mekiciepcas/ESC-Ai/inceleme/media/image2.png

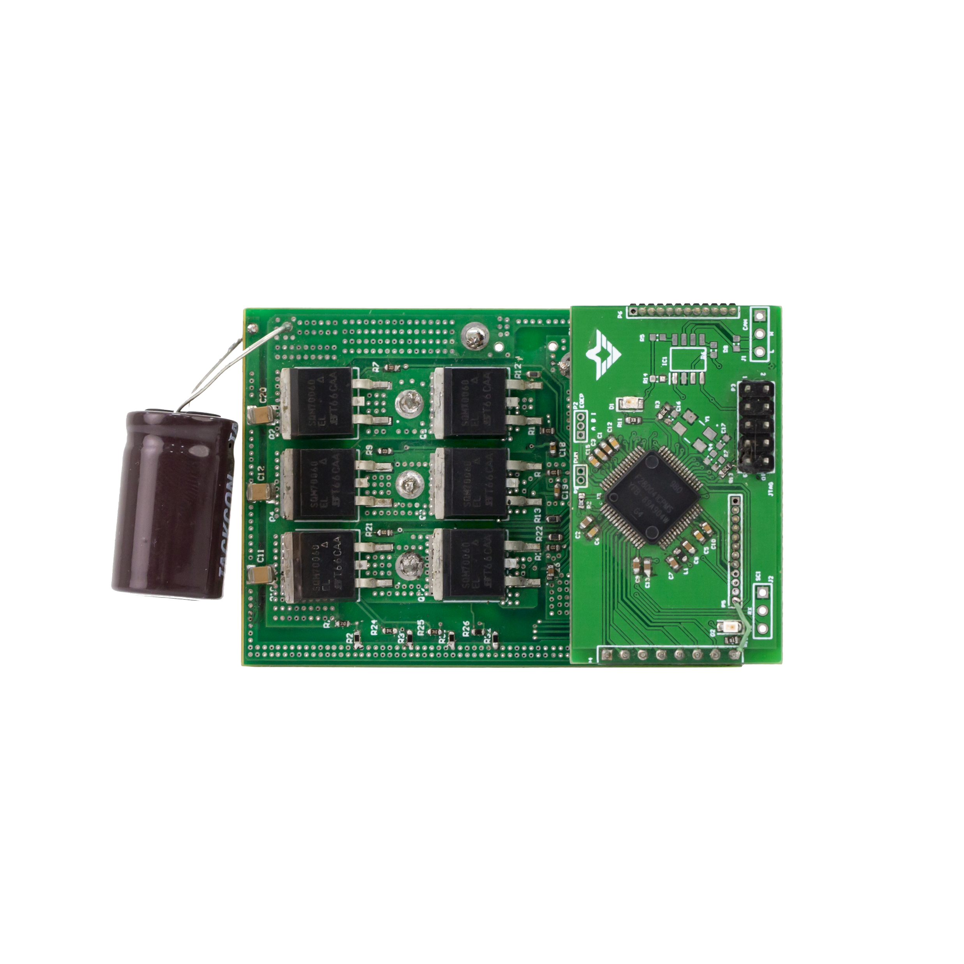
inceleme/media/image2.png
