mekiciepcas/ESC-Ai/inceleme/media/image3.png

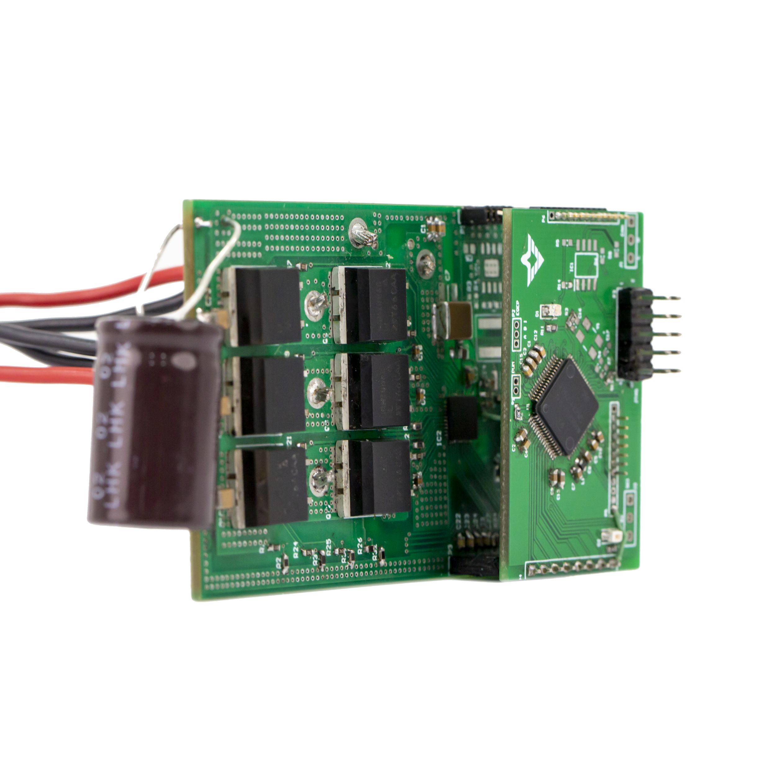
inceleme/media/image3.png
