mekiciepcas/ESC-Ai/ESC_V2/pcb_b1/control/README.md

# Kontrol PCB — kısmi PoC yönlendirmesi

100 × 80 mm, 4 katman; 38 elektriksel bileşen, 192 pad. 22 iz segmenti, 120 açık bağlantı, mevcut kurallarla DRC 0 ihlal. C1801–C1804 dijital bypass çiftleri MCU pinlerine bağlı. VBAT, analog besleme ve ortak güç/GND dağıtımı tamamlanmadı. Üretim veya enerji verme onayı değildir.

Kaynak: ESC_3kW_CONTROL_B1_PLACEMENT.kicad_pcb. Kanıt: supply_routes_20260915.json ve drc_placement.json. Değişiklik öncesi snapshot korunur. route/refine betikleri tarihsel tek seferlik değişikliklerdir; mevcut PCB üzerine yeniden uygulanmaz. Aday kılıflar placement_report.json içinde açıkça işaretlidir.
