mekiciepcas/ESC-Ai/ESC_V2/planning/AUTONOMOUS_HANDOFF.md

# ESC autonomous handoff

Date: 2026-09-21 19:23+03:00  
Branch: `uav-rebaseline`  
Run-start HEAD: `80ab0b874f15defab96d15028aef4c9873473758`  
TR-105 traceability commit: `4975e4d549dd8fd15743f60455499fd0e71f0547`  
AUTO-STATE-99 commit: `6fc20e9e351b12a80c0fb0fed7f9c94713b5cbe0`  
Run status: `TR105_POST_TR104_CI_RUNTIME_EVIDENCE_RETAINED_NO_GATE_ADVANCE`

## Repository continuity verification
Mandatory authorities were read from the actual branch: `UAV_PRODUCT_PLAN.md`, `UAV_TRACEABILITY.md`, `uav_backlog.json`, `mission_requirements.json`, `REQUIREMENTS_MASTER.json`, `REQUIREMENTS_PROGRESS.json`, prior handoff and autonomy state. Run-start HEAD was dashboard bot commit `80ab0b874f15defab96d15028aef4c9873473758`, whose parent was the previous autonomous reconciliation commit. S1R.2 blockers and controlled counters were re-verified before acting.

## Controlling metrics
Requirements structure **12/12 = 100%**; G1 SYSTEM FREEZE/value closure **15/48 = 31.3%**; backlog DONE **1/25 = 4.0%**; major gates **0/8 = 0%**. No counter advanced.

## Tasks attempted / completed
Verified mandatory planning state; confirmed S1R.2 remains blocked by controlled installed-axis/structural mass plus degraded-mode evidence; inspected the pending post-TR-104 CI evidence; verified GitHub Actions check `fail-closed-regression` id `106394597582` on TR-104 code commit `ba5dbad0b71a5669453cd548d5cf304659db66a4` completed `success` in workflow run `35618291811` at 2026-09-21 15:20 UTC; recorded that bounded runtime evidence as TR-105; advanced autonomy state to AUTO-STATE-99. No engineering value, physical claim, safety decision, G1 row, backlog state, architecture selection or release state was promoted.

## Files changed
`ESC_V2/planning/UAV_TRACEABILITY.md`, `ESC_V2/planning/autonomy_state.json`, and this handoff. No A2/B1 electrical source, KiCad schematic, PCB, Gerber, manufacturing or release package was modified. `U1-SCH-R001` remains unallocated.

## Engineering decision / calculations / evidence added
TR-105 closes only the pending runtime-evidence item from TR-104: the hardened blank-template fail-closed regression guard demonstrably executed successfully in GitHub Actions. No product calculation, requirement value or architecture decision changed.

## Assumptions and evidence level
No engineering assumption introduced. Evidence level: **REPOSITORY CI RUNTIME EVIDENCE ONLY; NO PHYSICAL MEASUREMENT; NO SAFETY DECISION; NO GATE ADVANCE**.

## Unresolved blockers
Controlled installed-axis mass; controlled Quad/Hexa structural delta; explicit degraded-mode/single-axis-loss decision; exact installed pack overhead mass/geometry; condition-matched P50B OCV/Rdc; installed pack current-path resistance; usable-energy/cutoff; traction-pack auxiliary hardware/demand/conversion efficiencies/simultaneity; exact gate-drive configuration; exact motor/prop/winding; phase-current/eRPM/PWM/loss/transient proof; G1/G2.

## Regression / risk discovered
No new engineering regression discovered. The branch remains subject to dashboard-refresh bot interposition after planning writes; final HEAD must therefore be re-read before run close. TR-105 must not be interpreted as populated-evidence validation or physical qualification.

## Exact next tasks
1. Populate TR-084 only from controlled installed-axis and configuration-controlled Quad/Hexa structure weighing, then run TR-085.
2. Populate TR-092 only from an explicit controlled user/system-safety decision or approved requirement, then run TR-093.
3. Populate TR-088/TR-089, TR-081/TR-082 and TR-079/TR-080 only from required real evidence.
4. If those inputs remain unavailable, audit independent S1R.3B verification/evidence contracts for a concrete fail-open, provenance or schema-drift defect; no filler edits.

Dependency chain: `PB-08 -> TR-084/TR-085 physical mass + TR-091..TR-093 controlled degraded-mode decision -> Quad/Hexa/MTOW -> exact propulsion + pack -> total simultaneous pack current -> phase current/eRPM/PWM -> gate-drive/power-stage requalification -> G1 -> G2 -> U1-SCH-R001`.

## Next-run briefing
Start from AUTO-STATE-99 and re-read actual branch HEAD because dashboard automation may advance it. TR-105 records successful post-TR-104 fail-closed runtime evidence only. Do not populate TR-084/TR-092 from guesses. Keep 83.33 A propulsion-only, P50B 12S4P reference-only, A2/B1 electrical sources immutable, and all physical qualification claims false. Snapshot: **Requirements 100% / G1 31.3% / backlog DONE 4.0% / major gates 0% / component-bearing U1 0%**.
