mekiciepcas/ESC-Ai/ESC_V2/planning/UAV_TRACEABILITY.md

# UAV ESC tasarım izlenebilirlik matrisi

Tarih: 21.09.2026

> TR-001..TR-046 canonical content is preserved byte-for-byte in commit history through blob `558a79e824d957844766031e357996bc8e0cee01`. TR-047..TR-070 remain preserved in canonical blob `2456bb4b0915ffd5104f99a594e94f594a4bb4a4`; TR-071..TR-090 remain preserved in canonical blob `fae32f3ba0832c550ce9469e41703dc15e68a6ea`; TR-091..TR-103 remain preserved in canonical blob `f3841aaa5de84b9d82ef5d6629993cffa5c44658`. This compact continuation does not supersede or delete that engineering history.

## Additive continuation

| ID | Fonksiyon / karar | UAV rebaseline kararı | Sonraki kanıt |
|---|---|---|---|
| TR-104 | PB-08 rejection-error payload integrity closure | **REPOSITORY VERIFICATION OUTPUT-INTEGRITY REPAIR / NO GATE ADVANCE.** The TR-100 harness required a non-empty JSON `errors` list but did not require its members to contain usable diagnostic text; `[null]` or `[""]` could therefore satisfy the structural check. The harness now requires every rejection error to be a non-empty string after whitespace trimming. This strengthens fail-closed diagnostic evidence only and does not validate populated evidence, physical hardware, safety acceptance, G1 closure or release readiness. | `test_pb08_fail_closed_templates.py`; retain a subsequent successful `PB-08 Fail-Closed Regression Guard` Actions execution as bounded runtime evidence. |
| TR-105 | Post-TR-104 fail-closed runtime evidence | **REPOSITORY CI RUNTIME EVIDENCE / NO GATE ADVANCE.** GitHub Actions check `fail-closed-regression` on TR-104 code commit `ba5dbad0b71a5669453cd548d5cf304659db66a4` completed successfully on 2026-09-21 15:20 UTC (check id `106394597582`, workflow run `35618291811`). This closes only the pending runtime-evidence item for TR-104. It does not validate populated PB-08 evidence, physical hardware, degraded-mode safety, G1 closure, flight qualification or production readiness. | Preserve the successful check-run reference; continue with controlled TR-084 physical mass and TR-092 degraded-mode evidence when available, otherwise audit independent verification contracts only for concrete defects. |

## Canonical PB-08 current state

PB-08 remains active authority. Requirements structure is 12/12 = 100%; G1 value closure remains 15/48 = 31.3%; backlog DONE remains 1/25 = 4.0%; major gates remain 0/8. S1R.2 remains blocked by controlled custom-axis/structural mass and degraded-mode evidence. `P_aux,pack`, total continuous/peak traction-pack current, exact pack, exact motor/prop, phase current and PWM remain OPEN. The 83.33 A value remains propulsion-only continuous pack-current lower bound. P50B 12S4P remains reference-only. B1 remains a requalification candidate only; A2/B1 electrical source is immutable. No component-bearing U1 schematic is allocated and `U1-SCH-R001` remains unused.

## History-preservation note

Historical PB-01..PB-07 calculations and TR-001..TR-103 are not deleted or reinterpreted by this compact continuation. The canonical blobs above remain continuity anchors; commit history remains authoritative for earlier rows.
