mekiciepcas/ESC-Ai/ESC_V2/planning/RUN_2026-09-21_0922_TRACEABILITY.md

# Autonomous run trace — 2026-09-21 09:22+03:00

Run-start HEAD: `58a0e367f8fdd500e0f1c428946a825cb248bae9`.

## TR-094 — Canonical traceability synchronization after TR-093
**REPOSITORY CONSISTENCY REPAIR / NO GATE ADVANCE.** Verified the mandatory PB-08 planning authorities and prior handoff against the actual branch. Canonical `UAV_TRACEABILITY.md` ended at TR-090 while the controlled 08:23 run trace and AUTO-STATE-87 contained TR-091..TR-093. Folded TR-091..TR-093 into canonical continuity and anchored the prior TR-071..TR-090 canonical blob `fae32f3ba0832c550ce9469e41703dc15e68a6ea` so history remains recoverable and authoritative.

## Impact
No product value, safety decision, physical result, G1 row, gate, backlog state, A2/B1 electrical source, KiCad/PCB/Gerber/release artifact or U1 allocation changed. S1R.2 remains blocked by real installed-axis/structure mass evidence and an explicit controlled degraded-mode/system-safety decision. Requirements structure remains 12/12 = 100%; G1 value closure 15/48 = 31.3%; backlog DONE 1/25 = 4.0%; major gates 0/8.
