mekiciepcas/ESC-Ai/ESC_V2/planning/RUN_2026-09-21_0721_TRACEABILITY.md

# Autonomous run trace — 2026-09-21 07:21 +03:00

Branch: `uav-rebaseline`
Run-start HEAD: `b407cc177ba5d1f5e5d0e7437f08b38b8eb908ca`

## TR-090 — canonical traceability synchronization after TR-089

Repository continuity audit confirmed the prior handoff and AUTO-STATE-85 contain TR-088/TR-089, while canonical `UAV_TRACEABILITY.md` stopped at TR-087. This run restores those two already-controlled records into the canonical matrix and records the repair as TR-090.

No engineering value, requirement status, physical-test result, backlog task, G1 row, rotor decision, pack-current value, or qualification state is changed by this repair. The 83.33 A value remains propulsion-only lower-bound arithmetic. S1R.2 remains blocked by controlled installed-axis/structural mass and degraded-mode evidence.

Controlled metrics remain: requirements structure 12/12 = 100%; G1 value closure 15/48 = 31.3%; backlog DONE 1/25 = 4.0%; major gates 0/8 = 0%.

No A2/B1 electrical source, KiCad schematic, PCB, Gerber, manufacturing/release package or main branch was modified. `U1-SCH-R001` remains unallocated.
