mekiciepcas/ESC-Ai/ESC_V2/planning/RUN_2026-09-21_0619_TRACEABILITY.md

# Autonomous run trace — 2026-09-21 06:19+03:00

Branch: `uav-rebaseline`  
Run-start HEAD: `eda6b332b74ca198f03d65357291312558fec6f3`

## TR-088 — PB-08 traction-pack auxiliary-demand result schema
**VERIFICATION ARTIFACT / NO PACK-CURRENT FREEZE.** Added `PB08_TRACTION_PACK_AUXILIARY_DEMAND_RESULT.template.json` to convert the TR-087 closure contract into a machine-readable evidence record. It requires configuration identity, exact load hardware/configuration, traction-pack applicability, load-side demand, conversion path, path efficiency, simultaneity/duty, condition basis, evidence reference and reported pack-referred arithmetic. All evidence/result fields remain null or false until controlled data exists. The frozen 3000 W propulsion term is retained only as the existing propulsion-only lower-bound parent.

Next evidence: populate a copy only from controlled exact U1/vehicle load evidence. Unknown demand/efficiency/simultaneity remains OPEN/null; source current capability is not load demand.

## TR-089 — PB-08 auxiliary-demand fail-closed verifier
**FAIL-CLOSED VERIFICATION TOOL / NO PHYSICAL RESULT / NO G1 ADVANCE.** Added `verify_pb08_auxiliary_demand.py`. The checker rejects missing configuration identity, incomplete load enumeration, missing exact hardware/evidence/path data, OPEN/invalid efficiency or simultaneity/duty, missing load-side demand, inconsistent per-row pack power/current, incomplete review attestations, unknown loads assigned zero, inconsistent totals, or any attempt to set pack-current freeze/physical qualification/G1 advancement true. It independently recomputes each accepted load as `P_pack=(P_load/eta)*simultaneity*duty`, `I_pack=P_pack/V_loaded`, and recomputes auxiliary and propulsion+auxiliary totals.

The unpopulated template is expected to FAIL. A PASS means record completeness/arithmetic only; it cannot prove physical demand, freeze total pack current, or advance G1.

## Gate/counter disposition
No controlled counter advanced. S1R.2 remains blocked by controlled installed-axis/structure mass and degraded-mode evidence. Requirements structure remains 12/12 = 100%; G1 value closure 15/48 = 31.3%; backlog DONE 1/25 = 4.0%; major gates 0/8.
