mekiciepcas/ESC-Ai/ESC_V2/planning/RUN_2026-09-21_0223_TRACEABILITY.md

# RUN 2026-09-21 02:23+03:00 TRACEABILITY

## TR-083 — canonical traceability continuity repair after TR-082

Run-start branch tree: `155ddbf3b70ed24ea4e689d30262a0ca6c5240ae`.

Repository continuity audit found a real documentation inconsistency: `RUN_2026-09-21_0021_TRACEABILITY.md` and `RUN_2026-09-21_0122_TRACEABILITY.md` plus AUTO-STATE-80 documented TR-081 and TR-082, but canonical `UAV_TRACEABILITY.md` stopped at TR-080.

Action: restored TR-081 and TR-082 into canonical additive traceability and added this repair as TR-083. The restored rows preserve their original evidence semantics: TR-081 is an empty physical-evidence schema and TR-082 is fail-closed verification software. Neither is a physical measurement, pack qualification, 36 V loaded-floor proof, flight qualification or product-value freeze.

No G0/G1 row, backlog task or major gate closes from this consistency repair. Controlled counters remain requirements structure 12/12 = 100%; G1 value closure 15/48 = 31.3%; backlog DONE 1/25 = 4.0%; major gates 0/8 = 0%.

S1R.2 remains the highest-priority task and remains blocked by controlled custom-axis/structural mass plus degraded-mode evidence. No engineering value was inferred to bypass that blocker. No A2/B1 electrical source, KiCad schematic, PCB, Gerber, manufacturing or release artifact was modified.
