mekiciepcas/ESC-Ai/ESC_V2/planning/RUN_2026-09-21_0122_TRACEABILITY.md

# RUN 2026-09-21 01:22+03:00 TRACEABILITY

## TR-082 — PB-08 P50B OCV/Rdc evidence verifier

Task: independent S1R.3B evidence hardening while S1R.2 remains blocked.

Artifact added: `verify_pb08_p50b_ocv_rdc.py`.

The verifier is fail-closed. It requires exact cell/sample/lot/SOH identity, instrumentation and calibration references, raw-data reference, SOC preparation/rest/temperature stabilization and pulse timing, reviewer attestations, condition-matched per-point SOC/temperature/SOH/OCV/current/pulse-voltage/Rdc, repeats and uncertainty evidence. It independently recomputes `Rdc = (Vpre - Vpulse)/Ipulse` and rejects inconsistent arithmetic. It does not interpolate missing data and emits `physical_qualification=false` and `pack_loaded_floor_compliance=null`.

No physical measurement, cell-envelope point, pack qualification, flight qualification, G1 closure, component selection or production release is claimed. The empty TR-081 template is expected to fail until controlled evidence is populated.

Repository run-start HEAD verified: `ff77ded82429d8bf70464e4f6d4fae7b303ef62d`.

Controlled counters remain: requirements structure 12/12 = 100%; G1 value closure 15/48 = 31.3%; backlog DONE 1/25 = 4.0%; major gates 0/8 = 0%.
