mekiciepcas/ESC-Ai/ESC_V2/planning/RUN_2026-09-21_0021_TRACEABILITY.md

# Autonomous traceability — 2026-09-21 00:21+03:00

Run-start branch HEAD: `e8746a47c680ed758e219445d6a1797368ece8ae`.

## Continuity
Required PB-08 planning authorities and prior handoff were re-read from `uav-rebaseline`. S1R.2 remains highest-priority but blocked by missing controlled installed-axis/structural mass and degraded-mode evidence. No product value was inferred to bypass that blocker.

## TR-081 — PB-08 P50B condition-matched OCV/Rdc physical evidence schema
**VERIFICATION ARTIFACT / NO PHYSICAL RESULT / NO PACK FREEZE.** Added `PB08_P50B_OCV_RDC_MEASUREMENT_RESULT.template.json` to operationalize TR-077. The empty schema records exact cell article/lot/SOH identity, calibrated instrumentation and raw-data reference, SOC preparation/rest/temperature stabilization, pulse duration and sample time, and per-point condition-matched OCV/current/pulse-voltage/Rdc/recovery/repeat/uncertainty fields. All physical-result fields remain null and `physical_measurement` is false.

For each real populated point, Rdc is to be independently derived from `(V_pre - V_pulse) / I_pulse`; only condition-matched SOC/temperature/SOH data may enter the envelope. The reference-only 12S4P transform remains `R_cell,pack = Rdc_cell * 12/4`. The template deliberately leaves simultaneous pack current, installed non-cell resistance and loaded-voltage compliance null.

## Effect on gates
No G0/G1 row, backlog task or major gate closes from a schema alone. Requirements structure remains 12/12 = 100%; G1 value closure remains 15/48 = 31.3%; backlog DONE remains 1/25 = 4.0%; major gates remain 0/8.

## Next evidence
Populate only from controlled P50B primary evidence or real cell testing satisfying TR-077. Do not combine OCV and Rdc from mismatched conditions and do not promote the reference 12S4P topology into an exact pack selection without the remaining pack hardware/current/mass/sag evidence.
