mekiciepcas/ESC-Ai/ESC_V2/planning/RUN_2026-09-20_1520_TRACEABILITY.md

# Autonomous run trace — 2026-09-20 15:20+03:00

Trace ID: TR-072

Verified branch start HEAD `5d5f631678d12d9fcba0926cbf9478eee51c1799`. Repository audit found AUTO-STATE-69, the prior handoff, and `RUN_2026-09-20_1423_TRACEABILITY.md` all recorded TR-071, while canonical `UAV_TRACEABILITY.md` stopped at TR-070. Restored TR-071 and recorded this repair as TR-072. No engineering value, requirement, component selection, gate, physical-test result, or qualification status was promoted.

Controlled metrics remain: requirements structure 12/12 = 100%; G1 value closure 15/48 = 31.3%; backlog DONE 1/25 = 4.0%; major gates 0/8.

S1R.2 remains blocked by missing controlled custom-axis/structural mass and degraded-mode evidence. A2/B1 electrical sources and PCB/Gerber/manufacturing packages were not modified. `U1-SCH-R001` remains unallocated.
