mekiciepcas/ESC-Ai/ESC_V2/planning/RUN_2026-09-20_1123_TRACEABILITY.md

# Autonomous run traceability — 2026-09-20 11:23+03:00

## TR-068 — canonical traceability continuity repair verification

Status: **COMPLETED / REPOSITORY CONSISTENCY REPAIR**

The run began from branch tree `571fab837608bfe386fa60f7cfae39dfae7399eb` and re-read the mandatory PB-08 planning authorities and prior handoff. A consistency regression was confirmed: `UAV_TRACEABILITY.md` ended at TR-065 even though the prior run history and handoff asserted TR-066/TR-067 continuity.

Actions:
- restored TR-066 as the canonical record of the earlier traceability continuity audit;
- restored TR-067 as the canonical record for `PB08_PACK_CONTINUOUS_CURRENT_CLOSURE_CONTRACT.md`;
- updated the canonical current-state note so the 83.33 A propulsion-only lower bound explicitly points to the TR-067 closure contract;
- did not change any engineering requirement value, gate counter, A2/B1 electrical source, KiCad design, PCB, Gerber, manufacturing package, or U1 allocation.

Engineering consequence: future autonomous runs can deterministically discover the latest committed PB-08 pack-current method from the canonical trace matrix instead of relying on handoff-only history. This is traceability risk reduction, not product-value closure.

Metrics verified unchanged from repository authority: requirements structure 12/12 = 100%; G1 value closure 15/48 = 31.3%; backlog DONE 1/25 = 4.0%; major gates 0/8 = 0%.

Primary blockers remain controlled custom installed-axis/structural mass and degraded-mode evidence for S1R.2; independent pack-current closure remains blocked by evidence-backed `P_aux,pack` and explicit `M_cont`.
