mekiciepcas/ESC-Ai/ESC_V2/planning/RUN_2026-09-20_0919_TRACEABILITY.md

# RUN 2026-09-20 09:19+03:00 — traceability consistency reconciliation

## TR-066 — canonical continuation reconciliation

**Task:** Verify the mandatory PB-08 planning state against the actual `uav-rebaseline` repository before selecting new engineering work.

**Finding:** `RUN_2026-09-20_0522_TRACEABILITY.md` (TR-062), `RUN_2026-09-20_0619_TRACEABILITY.md` (TR-063), and `RUN_2026-09-20_0819_TRACEABILITY.md` (TR-065) existed as committed run evidence, and TR-064 was already present in `UAV_TRACEABILITY.md`, but the canonical additive continuation omitted TR-062, TR-063 and TR-065. This was a traceability-index regression, not an engineering-value regression.

**Correction:** Reconciled `UAV_TRACEABILITY.md` so the canonical continuation is contiguous through TR-065 and the PB-08 current-state summary reflects the already-committed eRPM, P50B cell-level mass/energy, geometry, and 83.33 A propulsion-only current-bound evidence.

**Engineering impact:** None of the reconciled records freezes rotor architecture, exact motor/propeller, exact battery pack, phase current, PWM, protection, thermal performance or physical qualification. G1 counters remain unchanged at 15/48 PASS. No A2/B1 electrical source, KiCad schematic, PCB, Gerber, manufacturing package or component-bearing U1 schematic was modified.

**Preservation:** TR-001..TR-046 history and all PB-01..PB-07/A2/B1 evidence remain unchanged. `U1-SCH-R001` remains unallocated.
