mekiciepcas/ESC-Ai/ESC_V2/planning/RUN_2026-09-19_1724_TRACEABILITY.md

# Run traceability — 2026-09-19 17:24+03:00

This additive record preserves configuration-control work performed while product-specific G0/G1 values remain OPEN.

- **TR-055 / U1 allocation readiness guard:** `U1_SCHEMATIC_ALLOCATION_READINESS.json` defines explicit prerequisites for allocating the first component-bearing U1 revision. Current status is `BLOCKED`: AR-001 (G1 SYSTEM freeze) and AR-002 (page-level G2 architecture) remain OPEN; AR-003..005 are PASS based on existing revision/G3 policy infrastructure.
- **TR-056 / Dry-run revision preparation helper:** `prepare_u1_schematic_revision.py` reads the revision register, reports the next unused revision and defaults to dry-run. `--allocate` refuses unless the readiness record is exactly `READY`, refuses an existing target, and copies from the frozen U1 scaffold into a revision-specific directory rather than modifying B1/R000.

No `U1-SCH-R001` allocation was made, no `.kicad_sch` file was changed, and no product electrical value, component selection, physical-test result or qualification claim was introduced.
