mekiciepcas/ESC-Ai/ESC_V2/planning/RUN_2026-09-19_1619_TRACEABILITY.md

# Run traceability — 2026-09-19 16:19+03

This additive record preserves new evidence without risking destructive overwrite of the large canonical matrix.

- **TR-043 / G0 product-input closure:** `G0_INPUT_CLOSURE_PACKET.json` defines the minimal missing vehicle inputs. Product values remain null; no competitor/B1 values are promoted.
- **TR-044 / CAN physical/timing verification:** `CAN_BUS_VERIFICATION_CONTRACT.json` defines CANV-01..10 and keeps protocol, bitrate, topology, harness, grounding, transient/EMC and acceptance limits null until frozen.
- **TR-045 / KiCad CLI reproducibility:** `.github/workflows/kicad-u1-verify.yml` uses the official `ppa:kicad/kicad-10.0-releases` path. GitHub Actions run `35446125432` at head `6fe8638508df7533eb9cb27ac200e77d0915b00b` completed successfully with KiCad CLI `10.0.6`: repository scaffold checker PASS, non-empty KiCad netlist export PASS, and ERC PASS with 0 violations / 0 errors / 0 warnings. Machine-readable evidence: `KICAD_CI_VERIFICATION.json`.
- **TR-046 / KiCad scaffold evidence scope:** the observed U1-scaffold ERC PASS applies only to the component-free architecture scaffold. It does not close G1/G2, does not qualify a component-bearing schematic, and shall not be interpreted as G3 or production readiness.
- **TR-047 / Legacy B1 KiCad reproducibility baseline:** B1 top-level schematic was parsed by KiCad 10.0.6 and exported to a non-empty netlist. The initial 198 warnings were all footprint-link issues caused by the repository `fp-lib-table` exposing only the custom `ESC_B1` library in headless CI. A CI-only effective table added 155 installed standard KiCad footprint libraries plus `ESC_B1`, without modifying repository B1 source. Re-run `35446577458` then produced **0 enabled ERC violations / 0 errors / 0 warnings**. Exact evidence and caveats are in `B1_KICAD_BASELINE_AUDIT.json`.
- **TR-048 / B1 ERC evidence scope:** B1's zero enabled ERC messages are migration evidence only. KiCad reported ignored checks including single-use global labels, four-way junctions, SPICE model issues and footprint-filter mismatches. The result does not requalify B1 voltage/current ratings, footprints, thermal behavior or physical fault response for U1.
- **TR-049 / Requirement-independent B1 support-part evidence:** `B1_SUPPORT_PART_EVIDENCE_AUDIT.md` source-backs exact identity/lifecycle/package class for legacy `TPS62160DGKR` and `TLV75533PDBVR`. Both remain `REVALIDATE`; published 1 A / 500 mA capability figures are explicitly not used as U1 load requirements.

Canonical `UAV_TRACEABILITY.md` TR-001..TR-042 remains authoritative for prior decisions. This run-local record is additive evidence until the next safe canonical matrix consolidation.
