mekiciepcas/ESC-Ai/ESC_V2/planning/CHECKPOINT.md

SON UYGULAMA 16.09 CHG-11: beş PoC konektörü şema/PCB/local footprint içinde tamamlandı; üretici delikleri 1.10mm. Sistem BOM 38; kontrol 3 (Y1901, D1901, J2702). 742 kontrol/ERC0, 32 arayüz neti, PCB DRC0/120 açık. Konektörler unkeyed PoC içindir; final harness değil. Kaynak apply_headers_20260916.py ve verification/headers_20260916.json. Sonraki paket Y1901/D1901 ve eşleşen J2701/J2702.

SON UYGULAMA CHG-10: 14 ilave BOM seçimi gerçek şemaya işlendi (7 ADC 1nF, 6 referans/sıcaklık 10nF, C1805 4.7uF). C1805 PCB MPN eşitlendi; diğer 13 bileşen güç PCB olmadığı için yalnız şemada. Güncel eksik sistem 43, kontrol 8. 742 kontrol/ERC0, 32 arayüz neti, DRC0/120 açık. Nominal değerler ve bütün netler korundu. Kanıt verification/bom_batch2_20260915.json. Sonraki işler: kontrol konektörleri, osilatör/LED; güç pasifleri/regülatör ve shunt kılıfları. C1805 etkin kapasite, analog yerleşme ve koruma dinamikleri fiziksel doğrulama bekliyor.

SON UYGULAMA: CHG-09; C1807 ve C2101/2/3 MPN bilgileri build_b1.py, üretilmiş şemalar ve PCB içinde tamamlandı. 742 kontrol, ERC 0, PCB DRC 0, netler aynı. Güncel eksik BOM: sistem 57, kontrol 9. Önceki 61/13 sayıları tarihsel. Kullanıcı eşiğe rağmen belge değil fiili uygulama istedi; bu dar paket gerçekleştirildi. Sırada kalan kontrol BOM (C1805, Y1901, D1901, konektörler) var.

# Güncel devam kaydı — 15.09.2026 / PLAN-07

Kullanıcı takvim beklemeden kapasite ve doğrulama kapılarıyla kontrollü ilerlemeyi istedi. POC-01 ve ESC-03 aktif. Kontrol PCB: 38 elektriksel footprint, 192 pad-net korunmuş, 22 iz segmenti, 120 açık bağlantı, DRC 0 ihlal. C1801–C1804 dijital bypass çiftleri bağlı; supply_routes_20260915.json doğrulama ve hash kanıtıdır. Şema bu tur değişmedi.

ÖNCELİKLİ PAKET: Kullanıcının son kararı BOM tamamlamak. control_bom_triage.json: kontrol kartında 13 / sistemde 61 açık kalem, bu tur kapanan 0. Önce kontrol BOM üretici kodu, stok, kılıf/pin ve elektriksel uygunluk; sonra aşağıdaki routing. Haftalık kalan %10 olduğundan kapsamlı yeterlilik ve şema değişikliği başlatılmadı.

SONRAKİ PCB PAKETİ: C1806 VBAT ve C1807/8/9 analog besleme pin yakınlığı/yerel bağlantıları; ardından GND dönüş düzlemi ve besleme dağıtımı. Sonra reset/SWD/saat ve düşük gerilim PoC firmware. Aday MPN, güç kaynağı ve tüm yollar kesinleşmeden üretim/enerji verme yok. Güç PCB ve fiziksel doğrulama açık.

Mevcut KiCad yeterli; yeni kurulum yok. Paket kapanışında haftalık %10 ve beş saatlik %33 kalan okundu. Kullanım eşiğine ulaşıldığı için yeni ağır paket başlatılmadı; sonraki tur taze kontrol et. Tarihler bekleme koşulu değildir; kaynak ve teknik kabul kapıları geçerlidir. HTML statik kontrol edilir; tarayıcı görsel doğrulaması erişim politikası nedeniyle tamamlanmış sayılmaz.

Önceki kayıt (tarihsel sayılar içerir):

# ESC devam kaydı — 14.09.2026

SON KULLANICI YETKİSİ: gerekli geliştirme/test yazılımlarını resmî kaynaklarından indir/kur; ardından devam et. GELISTIRME_ARACLARI.md envanteri eklendi. Kullanım kontrolünde ana beş saatlik %1, haftalık %21 kaldı; mevcut politika gereği ağır işlem başlatılmadı. Yeni araç kurulmuş gibi raporlama. Önceden alınan Freerouting JAR/Java ZIP hazır ama çalıştırma doğrulaması açık. Önce güncel kullanım hakkını kontrol et; sonra araç hazırlığı ve PCB işlerine devam et. Bu limit beklemesi proje teknik engeli değildir.

EN SON PCB İLERLEMESİ / PLAN-05: pcb_b1/control/ESC_3kW_CONTROL_B1_PLACEMENT.kicad_pcb gerçek ilk kontrol kartı yerleşimi. 100×80mm, 4 katman, 38 elektriksel footprint + 4 montaj deliği, 52 net; 192 pad yeniden açılarak eşleştirildi. 0 iz, 128 açık bağlantı, 6 silk_overlap kalıyor. Bakır kenar/courtyard çakışmaları bu tur giderildi. Aday paket listesi için placement_report.json kaynak sayısını oku; BOM eksikleri kapanmadı. İlk yerleşim ESC-13-P0 tamam; ESC-13 nihai kabul hâlâ açık. Güç kartı yok. Dashboard içinde gerçek PCB görseli ve dosya bağlantısı var.

PCB SONRAKİ İŞ: aday konektör/osilatör/LED ve C1805 kılıflarını MPN ile kesinleştir; bypass yerlerini gerçek MCU besleme pinlerine yaklaştır, kalan silk ihlallerini incele, daha sonra MCU fanout ve yerel bypass/GND bağlantılarından başla. Güç kartı routing, termal/giriş tasarımı kapanmadan üretim vaadi verme. build_placement.py mevcut dosyayı korur; refine_placement.py ve ilk seed son manuel yazı düzenlemelerinin tamamını içermez. Mevcut PCB asıl yerleşim kaydıdır.

Yetki: sprint tasarım uygulaması ve bu göreve bağlı otomatik devam. Kullanıcı fiziksel testleri yapar. Satın alma/dış mesaj/üretim siparişi yok. Kullanıcı 14 Eylül'de agent ekiplerini açıkça yetkilendirdi; EKIP_CALISMA_DUZENI.md içindeki dosya sahipliği uygulanır.

GÜNCEL DR-002 ENTEGRASYON: Şema uygulama ve elektriksel inceleme çıktıları birleştirildi. R1301.1 VBUS→GND, TI LM5164 RON bağlantısına göre düzeltildi. 734 bağlı pinde yalnız bu fark; 742 ana kontrol, ERC 0 ve 32 kartlar arası net kontrolü geçti. Bobin, MOSFET gövde diyodu ve C101–103 polaritesi iyileştirildi. Kanıt: verification/team_schematic/comparison.json ve verification/b1_evidence_manifest.json. Önceki 741 sayısı tarihsel.

HTML dashboard/index.html hazır. planning/publish_progress.py şema değiştiyse --verify-schematic ile, değişmediyse tek başına çalıştırılır; roadmap ve HTML güncellenir. dashboard/validation.json: 29 görev ve bağlantı/JSON statik kontrolü. Yerel tarayıcı önizlemesi erişim politikası nedeniyle yapılmadı; görsel browser QA iddia etme. Kodun mevcut dosyasını koru, ilk jeneratör göçlerini yeniden çalıştırma.

team_review.json ve change_log.json güncel; ELEC-01 bağlantı düzeltmesi kapalı dijital kapsam. ELEC-02 ön şarj yük yönetimi ve ELEC-03 diyot fault/reset VOL+VF marjı açık. ESC-07 RON 100k frekans/ripple hesabı ve fiziksel test açık. Şema/ürün profesyonelleştirme tümü tamam değil; ana görevler ESC-03 ve ESC-05 devam ediyor.

Güncel kaynak: hardware_b1; A2 arşiv. backlog.json asıl durum; render_roadmap.py görünümü üretir. Tek seferlik build_backlog.py / update_sprint1.py yeniden çalıştırılmaz. prepare_b1.py mevcut jeneratörleri A2'den tekrar türetir; üzerinde sonraki değişiklik varsa körlemesine çalıştırma.

ESC-01 tasarım zarfı DONE: 9 model kontrolü / 128 nokta. ESC-05 IN_PROGRESS: özel sembollerin geometri/polarite incelemesi açık. ESC-03 IN_PROGRESS: ilk ön şarj modeli eklendi; görev tamam değil.

Bu tur precharge_model.py ve precharge_checks.json: 22 ohm / geçici 1410 uF için 15 yük/gerilim senaryosu, 3 kontrol. 39 V'ta %95'e erişmek için sabit yardımcı yük 88.6 mA altında olmalı. 100 mA varsayımında hedefe erişilemiyor. Gerçek buck yükü sabit akım değildir. Bu sonuç 22 ohm seçimini onaylamaz; yardımcı beslemenin ön şarj sırasındaki davranışı çözülmeli.

SONRAKİ SOMUT İŞ: ESC-03 için LM5164 yardımcı beslemesinin ön şarj sırasında etkinliğini mevcut şemadan incele; yükü kapatma/ayrı besleme veya farklı ön şarj mimarisini gerekçeli seç. Üretici kaynaklarıyla direnç darbe, timeout ve yeniden deneme gereksinimleri; ardından sigorta DC kesme/I²t ve ayırıcı seçimleri. Batarya kısa devre akımı belirsizliğini uydurma. ESC-03 tüm şema/koruma kriterleri kapanmadan DONE olmaz.

Araçlar: KiCad 10 CLI ve pcbnew Python `C:/Program Files/KiCad/10.0/bin/`; normal Python alternatif runtime mevcut. Web manufacturer verileri gerektiğinde güncel kaynaktan okunur. PCB ürün routing henüz yok; rule_test/coupon.kicad_pcb yalnız negatif test kuponu.

Otomasyon aktif: esc-sprintlerini-kald-yerden-s-rd-r; altı saatlik aralık. Her başlangıçta limit oku; %10 ve altında ağır işi ertele. CAL-01 hedefleri TAMAMLAMA_TAKVIMI.md içinde. 21 Eylül hedef/kapasite incelemesi yapılmadıysa sonraki turda yap.

Her tur sonunda bu kaydı gerçek son duruma göre güncelle; değişen dosyaları, test kanıtlarını, takvim etkisini ve sonraki tek işi yaz. Yalnız dış bağımlılıklar kaldığında otomasyonu duraklat.
