mekiciepcas/ESC-Ai/ESC_V2/hardware/inceleme.html

# ESC 3 kW — A1 şema incelemesi

13 Eylül 2026 • KiCad 10 • 18 sayfa • 229 bileşen • 134 net

İnceleme taslağıdır. ERC: 0 ihlal. Üretim, PCB ve fiziksel güç testi tamamlanmadı. Boş MPN/footprint alanları seçilmemiş parçaları belirtir.

## Bağlantılı şema sayfaları

Sayfa başlığına tıklayarak büyütün. Aynı isimli global netler sayfalar arasında elektriksel olarak bağlıdır. Semboller pin numaralarını taşıyan işlevsel gösterimlerdir.

01 DC link

Tam boyutta aç 01_DC_link şeması

02 phase A

Tam boyutta aç 02_phase_A şeması

02 phase B

Tam boyutta aç 02_phase_B şeması

02 phase C

Tam boyutta aç 02_phase_C şeması

03 gate driver

Tam boyutta aç 03_gate_driver şeması

04 voltage sensing

Tam boyutta aç 04_voltage_sensing şeması

04 voltage sensing 2

Tam boyutta aç 04_voltage_sensing_2 şeması

05 current and temperature

Tam boyutta aç 05_current_and_temperature şeması

06 aux 12V

Tam boyutta aç 06_aux_12V şeması

07 aux 5V 3V3

Tam boyutta aç 07_aux_5V_3V3 şeması

08 MCU

Tam boyutta aç 08_MCU şeması

08 MCU 2

Tam boyutta aç 08_MCU_2 şeması

09 comms

Tam boyutta aç 09_comms şeması

10 hardware trip

Tam boyutta aç 10_hardware_trip şeması

10 hardware trip 2

Tam boyutta aç 10_hardware_trip_2 şeması

11 PWM interlock

Tam boyutta aç 11_PWM_interlock şeması

12 board interface

Tam boyutta aç 12_board_interface şeması

## Ön malzeme listesi

Sipariş listesi değildir; pasiflerin tam kodları, bazı kılıflar ve yüksek akım bağlantıları henüz açık.

Adet | Değer | MPN | Referanslar | Durum
1 | DC LINK INPUT | Seçilecek | J1 | İncelenecek
1 | MOTOR U V W | Seçilecek | J2 | İncelenecek
1 | EXTERNAL BRAKE MODULE | Seçilecek | J3 | İncelenecek
3 | 470u 100V bulk | Seçilecek | C1, C2, C3 | İncelenecek
3 | 2.2u 100V X7R | Seçilecek | C4, C5, C6 | İncelenecek
1 | 100k 0.25W | Seçilecek | R1 | İncelenecek
12 | CSD19536KTT | CSD19536KTT | Q1, Q2, Q3, Q4, Q5, Q6, Q7, Q8, Q9, Q10, Q11, Q12 | Kod seçildi / doğrulanacak
12 | 4.7R gate | Seçilecek | R2, R4, R6, R8, R12, R14, R16, R18, R22, R24, R26, R28 | İncelenecek
12 | 47k G-S | Seçilecek | R3, R5, R7, R9, R13, R15, R17, R19, R23, R25, R27, R29 | İncelenecek
3 | 0.5mR Kelvin | Seçilecek | RS1, RS2, RS3 | İncelenecek
6 | 0R NET-TIE ONLY | Seçilecek | R10, R11, R20, R21, R30, R31 | İncelenecek
3 | 100n 100V | Seçilecek | C7, C8, C9 | İncelenecek
1 | DRV8353FSRTAR | DRV8353FSRTAR | U1 | İncelenecek
1 | 47n 100V | Seçilecek | C10 | İncelenecek
2 | 1u 25V | Seçilecek | C11, C12 | İncelenecek
2 | 1u 10V | Seçilecek | C13, C36 | İncelenecek
1 | 100n 25V | Seçilecek | C14 | İncelenecek
2 | 10u 25V | Seçilecek | C15, C34 | İncelenecek
1 | 100n 10V | Seçilecek | C16 | İncelenecek
2 | 4.7k pull-up | Seçilecek | R32, R33 | İncelenecek
1 | 10k pull-up | Seçilecek | R34 | İncelenecek
1 | 10k pull-down | Seçilecek | R35 | İncelenecek
6 | 47k pull-down | Seçilecek | R36, R37, R38, R39, R40, R41 | İncelenecek
8 | 49.9k 0.1% | Seçilecek | R42, R43, R46, R47, R50, R51, R54, R55 | İncelenecek
4 | 3.32k 0.1% | Seçilecek | R44, R48, R52, R56 | İncelenecek
4 | 1k ADC series | Seçilecek | R45, R49, R53, R57 | İncelenecek
7 | 1n C0G | Seçilecek | C17, C18, C19, C20, C21, C22, C23 | İncelenecek
4 | BAT54H upper | BAT54H | D1, D3, D5, D7 | İncelenecek
4 | BAT54H lower | BAT54H | D2, D4, D6, D8 | İncelenecek
3 | 100R ADC | Seçilecek | R58, R59, R60 | İncelenecek
5 | 10k 0.1% | Seçilecek | R61, R63, R92, R93, R96 | İncelenecek
2 | NTC 10k B3435 | Seçilecek | R62, R64 | İncelenecek
3 | 10n | Seçilecek | C24, C25, C26 | İncelenecek
1 | MOTOR TEMP | Seçilecek | J4 | İncelenecek
1 | 10k provision | Seçilecek | R65 | İncelenecek
4 | 1k | Seçilecek | R66, R86, R88, R90 | İncelenecek
1 | LM5164DDAT | LM5164DDAT | U2 | Kod seçildi / doğrulanacak
1 | 68uH >=1.5A | Seçilecek | L1 | İncelenecek
1 | 2.2u 160V | Seçilecek | C27 | İncelenecek
1 | 100n 160V | Seçilecek | C28 | İncelenecek
2 | 22u 25V | Seçilecek | C29, C30 | İncelenecek
1 | 2.2n C0G | Seçilecek | C31 | İncelenecek
2 | 100k | Seçilecek | R67, R75 | İncelenecek
1 | 453k | Seçilecek | R68 | İncelenecek
1 | 49.9k | Seçilecek | R69 | İncelenecek
1 | 453k ripple | Seçilecek | R70 | İncelenecek
1 | 3.3n | Seçilecek | C32 | İncelenecek
1 | 56p C0G | Seçilecek | C33 | İncelenecek
1 | 1M UVLO | Seçilecek | R71 | İncelenecek
1 | 100k UVLO | Seçilecek | R72 | İncelenecek
5 | 10k | Seçilecek | R73, R76, R78, R80, R81 | İncelenecek
1 | FAN 12V | Seçilecek | J5 | İncelenecek
1 | TPS62160DGKR | TPS62160DGKR | U3 | Kod seçildi / doğrulanacak
1 | 2.2uH >=1.5A | Seçilecek | L2 | İncelenecek
1 | 22u 10V | Seçilecek | C35 | İncelenecek
1 | 523k | Seçilecek | R74 | İncelenecek
1 | TLV75533PDBVR | TLV75533PDBVR | U4 | Kod seçildi / doğrulanacak
2 | 4.7u 10V | Seçilecek | C37, C38 | İncelenecek
1 | 0R analog link | Seçilecek | R77 | İncelenecek
1 | 100n | Seçilecek | C39 | İncelenecek
1 | STM32G474RET3 | STM32G474RET3 | U5 | Kod seçildi / doğrulanacak
4 | 100n at VDD | Seçilecek | C40, C41, C42, C43 | İncelenecek
1 | 4.7u | Seçilecek | C44 | İncelenecek
1 | 100n at VBAT | Seçilecek | C45 | İncelenecek
1 | 1u VDDA | Seçilecek | C46 | İncelenecek
1 | 100n VDDA | Seçilecek | C47 | İncelenecek
1 | 100n VREF | Seçilecek | C48 | İncelenecek
1 | 100n reset | Seçilecek | C49 | İncelenecek
1 | 10k BOOT0 | Seçilecek | R79 | İncelenecek
1 | SWD | Seçilecek | J6 | İncelenecek
1 | 8MHz 3V3 CMOS oscillator | Seçilecek | Y1 | İncelenecek
1 | 100n oscillator | Seçilecek | C50 | İncelenecek
1 | 1k LED | Seçilecek | R82 | İncelenecek
1 | LED GREEN | Seçilecek | D9 | İncelenecek
1 | SN65HVD230DR | SN65HVD230DR | U6 | Kod seçildi / doğrulanacak
1 | 10k slope | Seçilecek | R83 | İncelenecek
1 | 100n CAN | Seçilecek | C51 | İncelenecek
1 | 120R DNP | Seçilecek | R84 | İncelenecek
1 | CAN | Seçilecek | J7 | İncelenecek
1 | UART 3V3 | Seçilecek | J8 | İncelenecek
1 | RC PWM 3V3 | Seçilecek | J9 | İncelenecek
1 | HALL 5V | Seçilecek | J10 | İncelenecek
3 | 4.7k 3V3 pull-up | Seçilecek | R85, R87, R89 | İncelenecek
3 | 1n | Seçilecek | C52, C53, C54 | İncelenecek
2 | TLV1704PWR | TLV1704PWR | U7, U8 | Kod seçildi / doğrulanacak
2 | 100n comparator | Seçilecek | C55, C56 | İncelenecek
2 | 26.1k 0.1% | Seçilecek | R91, R94 | İncelenecek
3 | 10n reference | Seçilecek | C57, C58, C59 | İncelenecek
1 | 7.50k 0.1% | Seçilecek | R95 | İncelenecek
1 | 2.2k fault pull-up | Seçilecek | R97 | İncelenecek
1 | BAT54H fault OR | BAT54H | D10 | İncelenecek
1 | BAT54H reset OR | BAT54H | D11 | İncelenecek
2 | BAT54H PG OR | BAT54H | D12, D13 | İncelenecek
1 | SN74LVC1G74DCUR | SN74LVC1G74DCUR | U9 | Kod seçildi / doğrulanacak
1 | 0R driver wake | Seçilecek | R98 | İncelenecek
1 | 100n latch | Seçilecek | C60 | İncelenecek
1 | EMERGENCY STOP | Seçilecek | J11 | İncelenecek
6 | SN74LVC1G08DBVR | SN74LVC1G08DBVR | U10, U11, U12, U13, U14, U15 | Kod seçildi / doğrulanacak
6 | 47k reset default | Seçilecek | R99, R100, R101, R102, R103, R104 | İncelenecek
6 | 100n logic | Seçilecek | C61, C62, C63, C64, C65, C66 | İncelenecek
1 | POWER CARD 2x20 | Seçilecek | J12 | İncelenecek
1 | CONTROL CARD 2x20 | Seçilecek | J13 | İncelenecek

## Üretim öncesi açık işler

1. Şönt, MOSFET sürücü ve güç bağlantısı kılıflarını kesinleştirme; eksiksiz üretici kodları.
2. Giriş sigortası, ön şarj, ters kutup ve fren enerjisi için dış modülün tasarımı.
3. MCU pin-mux / ADC zamanlaması ve donanım koruma gecikmesi hesabı.
4. Kapı sürme, termal, EMI/ESD, batarya ve motor numune testleri.
5. İki fiziksel PCB için net ayrımı, yerleşim, DRC ve üretim dosyaları.

Tasarım notları ve dosya listesi
