mekiciepcas/ESC-Ai/ESC_V2/hardware_a2/inceleme.html

ESC V2 / 13 Eylül 2026 / A2

# 3 kW ESC — mühendislik inceleme paketi

13S batarya • 46.8 V nominal • 54.6 V tam dolu • Hall destekli motor kontrolü

29şema sayfası

235bileşen

739başarılı kontrol

0ERC ihlali

İnceleme revizyonu. PCB, tam üretim BOM’u, çalışan firmware ve 3 kW fiziksel doğrulama tamamlanmadı. ERC geçişi güç performansı veya güvenlik onayı değildir.

## A2 ile değişenler

- İşlevsel sayfalar, Türkçe hesap/yerleşim/test notları ve sayfa bazında bileşen numaralandırması.
- Kablolu faz güç yolları ve dört ADC bölücüsü; on iki test noktası.
- Kartlar arası eksik +5 V bağlantısının pin39 üzerinden tamamlanması.
- Gerçek dört uçlu şönt seçimi, yapay Kelvin 0R parçalarının kaldırılması.
- TI mekanik çiziminden yerel DRV8353F RTA0040B footprint’i.

## Şema sayfaları

Başlıklara tıklayın; çizimleri tam boyutta açabilirsiniz. Sayfa başlıkları KiCad hiyerarşisiyle aynıdır.

01_DC_LINK — DC bara / enerji deposu

Tam boyut SVG · KiCad sayfası

DC bara / enerji deposu

- HEDEF: 39–54.6 V çalışma; 3 kW mil gücü. 44 V altında güç azaltılır.
- Giriş, sigorta + ön şarj + kutup doğrulama düzeneğinden gelir. Doğrudan batarya bağlantısı için yayımlanmadı.
- 3 x 470 uF = 1410 uF. 54.6 V üzerinde depolanan enerji yaklaşık 2.10 J.
- 100 kohm boşaltma: tau=141 s; 54.6 V → 5 V yaklaşık 337 s. Gerilim ölçülmeden servis yapılmaz.
- Her yarım köprüye 2.2 uF yerel seramik; DC bias ve RMS ripple kontrol edilecek.
- AÇIK R01: giriş modülü. AÇIK R02: geri sürülme / fren enerjisi. PWM kapatmak DC barayı kelepçelemez.

02_PHASE_A — Faz A / paralel MOSFET yarım köprüsü

Tam boyut SVG · KiCad sayfası

Faz A / paralel MOSFET yarım köprüsü

- 100 V CSD19536KTT; her anahtarda iki paralel MOSFET. Üç faz toplam 12 MOSFET.
- Kalın hatlar güç yolunu gösterir. Her MOSFET kendi 4.7 ohm kapı direncine sahiptir.
- 4.7 ohm başlangıç değeridir. VGS, VDS taşması ve açma/kapama kaybıyla ayarlanır.
- Kelvin sense uçları sadece sürücü ölçüm girişlerine gider. Güç akımı sense izi üzerinden geçirilmez.
- 0.5 mohm: 80 A sürekli varsayımında I²R=3.2 W üst sınır hesabı. Gerçek şönt RMS akımı PWM ile değişir.
- PCB: paralel kollar simetrik; ortak kaynak endüktansı azaltılır. Tab pin2=Drain. Soğutucu izolasyonu ayrıca tasarlanır.
- AÇIK R03: şönt pad yönü/termal. AÇIK R04: double-pulse ve kısa devre koruma süresi.

02_PHASE_B — Faz B / paralel MOSFET yarım köprüsü

Tam boyut SVG · KiCad sayfası

Faz B / paralel MOSFET yarım köprüsü

- 100 V CSD19536KTT; her anahtarda iki paralel MOSFET. Üç faz toplam 12 MOSFET.
- Kalın hatlar güç yolunu gösterir. Her MOSFET kendi 4.7 ohm kapı direncine sahiptir.
- 4.7 ohm başlangıç değeridir. VGS, VDS taşması ve açma/kapama kaybıyla ayarlanır.
- Kelvin sense uçları sadece sürücü ölçüm girişlerine gider. Güç akımı sense izi üzerinden geçirilmez.
- 0.5 mohm: 80 A sürekli varsayımında I²R=3.2 W üst sınır hesabı. Gerçek şönt RMS akımı PWM ile değişir.
- PCB: paralel kollar simetrik; ortak kaynak endüktansı azaltılır. Tab pin2=Drain. Soğutucu izolasyonu ayrıca tasarlanır.
- AÇIK R03: şönt pad yönü/termal. AÇIK R04: double-pulse ve kısa devre koruma süresi.

02_PHASE_C — Faz C / paralel MOSFET yarım köprüsü

Tam boyut SVG · KiCad sayfası

Faz C / paralel MOSFET yarım köprüsü

- 100 V CSD19536KTT; her anahtarda iki paralel MOSFET. Üç faz toplam 12 MOSFET.
- Kalın hatlar güç yolunu gösterir. Her MOSFET kendi 4.7 ohm kapı direncine sahiptir.
- 4.7 ohm başlangıç değeridir. VGS, VDS taşması ve açma/kapama kaybıyla ayarlanır.
- Kelvin sense uçları sadece sürücü ölçüm girişlerine gider. Güç akımı sense izi üzerinden geçirilmez.
- 0.5 mohm: 80 A sürekli varsayımında I²R=3.2 W üst sınır hesabı. Gerçek şönt RMS akımı PWM ile değişir.
- PCB: paralel kollar simetrik; ortak kaynak endüktansı azaltılır. Tab pin2=Drain. Soğutucu izolasyonu ayrıca tasarlanır.
- AÇIK R03: şönt pad yönü/termal. AÇIK R04: double-pulse ve kısa devre koruma süresi.

03_DRIVER — Üç faz kapı sürücü / SPI / besleme

Tam boyut SVG · KiCad sayfası

Üç faz kapı sürücü / SPI / besleme

- TI DRV8353FSRTAR; F-SPI varyantı. H donanım varyantı aynı firmware ile kullanılmaz.
- VM=12 V yardımcı besleme. VDRAIN=VBUS. VREF=3V3A; CSA sıfırı nominal VREF/2.
- CPH–CPL: 47 nF. VCP kondansatörü toprağa değil VBUS hattına döner.
- GHA/GLA, GHB/GLB, GHC/GLC faz sayfalarına; SPA/SNA uçları Kelvin sense hatlarına.
- SPI: önce kimlik/durum ve yapılandırma geri okuması. 6-PWM, gain10, OCP ve deglitch değerleri kayıt altına alınır.
- Yerel RTA0040B footprint: 6x6 mm, 0.5 mm pitch, EP=4.15 mm. TI çiziminden oluşturuldu; stencil/via süreci montajcıyla doğrulanacak.

04_DRIVER_DEFAULTS — Sürücü / reset anı lojik seviyeleri

Tam boyut SVG · KiCad sayfası

Sürücü / reset anı lojik seviyeleri

- ENABLE ve altı PWM girişi donanım pull-down ile varsayılan kapalıdır.
- nFAULT ve SDO open-drain/open-collector çıkışları 3.3 V seviyesine çekilir.
- CS yüksek: SPI pasif. Boşta kalan MCU pinine güvenilmez.
- RUN_REQUEST sürücüyü uyandırır. Anahtarlama izni ayrı LATCH_STATE sinyalidir.

05_SENSE_BUS — Gerilim ölçümü / DC bara

Tam boyut SVG · KiCad sayfası

Gerilim ölçümü / DC bara

- Rüst=2 x 49.9 kohm; Ralt=3.32 kohm; oran=0.032196.
- 54.6 V → 1.758 V. 80 V kontrol noktası → 2.576 V. ADC referansı 3.3 V.
- 1 kohm + 1 nF ADC filtresi. Kaynak empedansı yaklaşık 4.21 kohm; fc yaklaşık 37.8 kHz.
- BAT54H: pin1 katot, pin2 anot. Kelepçe kaçağı ve 3V3A geri beslemesi hata bütçesine dahildir.
- ADC acquisition süresi ve PWM ile örnekleme anı firmware sözleşmesinde belirlenir.
- Bu bölücü 80 V sürekli sistem izni vermez; güç katının geçici rejim marjı ayrıca doğrulanır.

05_SENSE_A — Gerilim ölçümü / faz A

Tam boyut SVG · KiCad sayfası

Gerilim ölçümü / faz A

- Rüst=2 x 49.9 kohm; Ralt=3.32 kohm; oran=0.032196.
- 54.6 V → 1.758 V. 80 V kontrol noktası → 2.576 V. ADC referansı 3.3 V.
- 1 kohm + 1 nF ADC filtresi. Kaynak empedansı yaklaşık 4.21 kohm; fc yaklaşık 37.8 kHz.
- BAT54H: pin1 katot, pin2 anot. Kelepçe kaçağı ve 3V3A geri beslemesi hata bütçesine dahildir.
- ADC acquisition süresi ve PWM ile örnekleme anı firmware sözleşmesinde belirlenir.
- Bu bölücü 80 V sürekli sistem izni vermez; güç katının geçici rejim marjı ayrıca doğrulanır.

05_SENSE_B — Gerilim ölçümü / faz B

Tam boyut SVG · KiCad sayfası

Gerilim ölçümü / faz B

- Rüst=2 x 49.9 kohm; Ralt=3.32 kohm; oran=0.032196.
- 54.6 V → 1.758 V. 80 V kontrol noktası → 2.576 V. ADC referansı 3.3 V.
- 1 kohm + 1 nF ADC filtresi. Kaynak empedansı yaklaşık 4.21 kohm; fc yaklaşık 37.8 kHz.
- BAT54H: pin1 katot, pin2 anot. Kelepçe kaçağı ve 3V3A geri beslemesi hata bütçesine dahildir.
- ADC acquisition süresi ve PWM ile örnekleme anı firmware sözleşmesinde belirlenir.
- Bu bölücü 80 V sürekli sistem izni vermez; güç katının geçici rejim marjı ayrıca doğrulanır.

05_SENSE_C — Gerilim ölçümü / faz C

Tam boyut SVG · KiCad sayfası

Gerilim ölçümü / faz C

- Rüst=2 x 49.9 kohm; Ralt=3.32 kohm; oran=0.032196.
- 54.6 V → 1.758 V. 80 V kontrol noktası → 2.576 V. ADC referansı 3.3 V.
- 1 kohm + 1 nF ADC filtresi. Kaynak empedansı yaklaşık 4.21 kohm; fc yaklaşık 37.8 kHz.
- BAT54H: pin1 katot, pin2 anot. Kelepçe kaçağı ve 3V3A geri beslemesi hata bütçesine dahildir.
- ADC acquisition süresi ve PWM ile örnekleme anı firmware sözleşmesinde belirlenir.
- Bu bölücü 80 V sürekli sistem izni vermez; güç katının geçici rejim marjı ayrıca doğrulanır.

06_CURRENT — Faz akımı / ADC filtreleri

Tam boyut SVG · KiCad sayfası

Faz akımı / ADC filtreleri

- SOA/SOB/SOC → 100 ohm / 1 nF → ADC. Filtre köşe frekansı yaklaşık 1.59 MHz.
- 0.5 mohm ve CSA gain10: nominal 5 mV/A. Sıfır nominal 1.65 V.
- Yazılım ilk aşama limiti düşük akımdan yükseltilir; hedef anlık faz limiti 120 A.
- ADC: üç şönt düşük taraf ölçümü. Geçerli pencere, minimum darbe ve yeniden kurma algoritması gerektirir.
- Üç ADC kanalının eş zamanlı ölçüldüğü varsayılmaz. ADC1/ADC2 planı ayrıca derlenerek doğrulanacak.

07_TEMPERATURE — Sıcaklık / motor sensörü

Tam boyut SVG · KiCad sayfası

Sıcaklık / motor sensörü

- FET/PCB: TDK NTCG203NH103JT1, 10k %5; B25/85=3650K %3. Eski B3435 varsayımı kaldırıldı; üretici R-T tablosu kullanılır.
- FET sensörü sıcak noktaya yakın fakat elektriksel izolasyon korunarak yerleştirilir.
- Motor girişi direnç tipi sensör varsayar. Hall kablosu ile karıştırılmaz.
- Açık ve kısa sensör arızası algılanır. Motorun gerçek termistör tipi henüz ölçülmedi.

08_AUX_12V — DC bara → 12 V yardımcı güç

Tam boyut SVG · KiCad sayfası

DC bara → 12 V yardımcı güç

- LM5164DDAT: 100 V giriş sınıfı; A1 DDAR paketleme alternatifi yerine DDAT seçildi.
- 68 uH ve Type-3 ripple ağı TI referans topolojisini izler. FB=453k/49.9k; hedef yaklaşık 12.09 V.
- RON=100k. 453k / 3.3n / 56p ripple ağı sıradan RC filtre ile değiştirilmez.
- Fan için 0.2 A başlangıç bütçesi. Kontrol beslemeleri dahil worst-case yük/doyma doğrulanacak.
- EN bölücüsü yardımcı kaynağı başlatır; motor düşük gerilim korumasının yerine geçmez.
- VIN kapasitörü–IC GND sıcak döngüsü kısa. SW bakırı analog ölçüm altında bulunmaz.

08_AUX_12V_2 — DC bara → 12 V yardımcı güç / devam 2

Tam boyut SVG · KiCad sayfası

DC bara → 12 V yardımcı güç / devam 2

- LM5164DDAT: 100 V giriş sınıfı; A1 DDAR paketleme alternatifi yerine DDAT seçildi.
- 68 uH ve Type-3 ripple ağı TI referans topolojisini izler. FB=453k/49.9k; hedef yaklaşık 12.09 V.
- RON=100k. 453k / 3.3n / 56p ripple ağı sıradan RC filtre ile değiştirilmez.
- Fan için 0.2 A başlangıç bütçesi. Kontrol beslemeleri dahil worst-case yük/doyma doğrulanacak.
- EN bölücüsü yardımcı kaynağı başlatır; motor düşük gerilim korumasının yerine geçmez.
- VIN kapasitörü–IC GND sıcak döngüsü kısa. SW bakırı analog ölçüm altında bulunmaz.

09_AUX_LOGIC — 12 V → 5 V → 3.3 V / analog besleme

Tam boyut SVG · KiCad sayfası

12 V → 5 V → 3.3 V / analog besleme

- TPS62160: 5 V Hall ve lojik ara besleme. FB=523k/100k; nominal 4.984 V.
- TLV75533: 5 V → 3.3 V. 200 mA yükte yaklaşık 0.34 W kayıp; SOT23 termal kontrol gerekli.
- 3V3A, 3V3 üzerinden kontrollü tek noktadan beslenir; analog ve güç dönüş yolları yerleşimde ayrılır.
- 5 V hattı A2 kart arayüzünde pin39 üzerinden kontrol kartına taşınır. A1 arayüz eksiği kapatıldı.

09_AUX_LOGIC_2 — 12 V → 5 V → 3.3 V / analog besleme / devam 2

Tam boyut SVG · KiCad sayfası

12 V → 5 V → 3.3 V / analog besleme / devam 2

- TPS62160: 5 V Hall ve lojik ara besleme. FB=523k/100k; nominal 4.984 V.
- TLV75533: 5 V → 3.3 V. 200 mA yükte yaklaşık 0.34 W kayıp; SOT23 termal kontrol gerekli.
- 3V3A, 3V3 üzerinden kontrollü tek noktadan beslenir; analog ve güç dönüş yolları yerleşimde ayrılır.
- 5 V hattı A2 kart arayüzünde pin39 üzerinden kontrol kartına taşınır. A1 arayüz eksiği kapatıldı.

10_MCU — STM32G474 / kontrol çekirdeği

Tam boyut SVG · KiCad sayfası

STM32G474 / kontrol çekirdeği

- TIM1: PA8/9/10 high; PB13/14/15 complementary low. PB12 donanım break girişi.
- Hall: PC6/7/8 (TIM3). RC: PA15 (TIM2). Bir zamanlayıcının periyodu diğer girişle paylaşılmaz.
- SPI1: PB3/4/5. CAN: PA11/12. UART: PC10/11. SWD: PA13/14.
- PG10 pin7 NRST olarak kalır. Option-byte değiştirilmeden reset davranışı korunur.
- PB8 BOOT0 pull-down. HSE bypass 8 MHz başlangıç seçimi. Saat ağacı CubeMX/derleme ile doğrulanacak.
- RET3 stok kaydı yalnız 4 adet gösterdi; seri üretim tedarik kapısı açık.

11_MCU_SUPPORT — MCU / bypass / reset / programlama

Tam boyut SVG · KiCad sayfası

MCU / bypass / reset / programlama

- Her VDD için 100 nF fiziksel olarak pine yakın; bulk ve analog referans ayrı yerleşir.
- SWD VTref ölçüm referansıdır. İki farklı kaynaktan 3.3 V basılmaz.
- NRST: 10k / 100n. Brown-out ve bağımsız watchdog firmware başlangıcında etkinleştirilir.
- RUN_REQUEST ve ARM_CLK reset boyunca düşük tutulur. İlk açılışta otomatik motor çalıştırma yok.

11_MCU_SUPPORT_2 — MCU / bypass / reset / programlama / devam 2

Tam boyut SVG · KiCad sayfası

MCU / bypass / reset / programlama / devam 2

- Her VDD için 100 nF fiziksel olarak pine yakın; bulk ve analog referans ayrı yerleşir.
- SWD VTref ölçüm referansıdır. İki farklı kaynaktan 3.3 V basılmaz.
- NRST: 10k / 100n. Brown-out ve bağımsız watchdog firmware başlangıcında etkinleştirilir.
- RUN_REQUEST ve ARM_CLK reset boyunca düşük tutulur. İlk açılışta otomatik motor çalıştırma yok.

12_CAN_UART — CAN / servis / RC arayüzleri

Tam boyut SVG · KiCad sayfası

CAN / servis / RC arayüzleri

- SN65HVD230 ile Classic CAN. CAN-FD haberleşmesi bu transceiver seçimiyle yayımlanmıyor.
- 120 ohm terminasyon DNP; yalnız hat sonunda takılır.
- UART ve RC seviyesi 3.3 V. 5 V push-pull girişi doğrudan uygulanmaz.
- AÇIK R05: konektör tarafı ESD/TVS ve kablo testleri; haberleşme kaybı tork sıfırlar.

13_HALL — Motor / Hall sensör arayüzü

Tam boyut SVG · KiCad sayfası

Motor / Hall sensör arayüzü

- Motor Hall beslemesi 5 V; çıkışlar open-collector kabul edildi.
- Pull-up 3.3 V üzerindedir. Push-pull 5 V Hall için seviye dönüştürücü gerekir.
- 1k / 1n EMI filtresi ilk değerdir; maksimum elektriksel hızda kenar gecikmesi ölçülür.
- Hall 000/111 ve geçersiz sıra: hata. Gerçek faz/Hall sırası düşük enerjili ölçümle bulunur.

14_TRIP_COMPARATORS — Donanım / akım penceresi ve bara aşırı gerilim

Tam boyut SVG · KiCad sayfası

Donanım / akım penceresi ve bara aşırı gerilim

- 6 karşılaştırıcı: üç faz için alt/üst akım penceresi. Ortak çıkış HARD_FAULT_N.
- OC_LOW≈0.914 V; OC_HIGH≈2.386 V. 5mV/A için yaklaşık ±147 A nominal eşik.
- Yedinci karşılaştırıcı VBUS aşırı gerilimi algılar: yaklaşık 58.57 V nominal.
- TLV1704 ve CSA gecikmesi kısa devreyi tek başına garanti etmez. DRV VDS koruması birlikte ayarlanır.
- Kullanılmayan komparatör girişleri tanımlı; çıkışı NC. Eşik toleransları hesap dosyasında.

15_TRIP_REFERENCES — Donanım / rasyometrik eşik referansları

Tam boyut SVG · KiCad sayfası

Donanım / rasyometrik eşik referansları

- Akım referansları 26.1k / 10k ve ters bölücüdür. VREF ile aynı 3V3A kaynağını kullanır.
- Bara OV referansı 7.5k / 10k. Dirençler %0.1 başlangıç şartı.
- 10 nF referans filtreleri açılışta yerleşme süresi oluşturur; ölçüm stabil olmadan ARM gönderilmez.
- Komparatör offset, CSA gain/offset ve şönt toleransı nihai eşiğe eklenir.

16_FAULT_LATCH — Donanım / arıza hafızası ve yeniden kurma

Tam boyut SVG · KiCad sayfası

Donanım / arıza hafızası ve yeniden kurma

- nFAULT, reset ve güç-good hatları diyot OR ile HARD_FAULT_N hattını aşağı çeker.
- HARD_FAULT_N hem TIM1 BKIN hem asenkron CLR girişine gider.
- Arıza LATCH_STATE değerini sıfırlar. Arıza kalkınca kendiliğinden yeniden başlamaz.
- Başlatma: PWM düşük → RUN_REQUEST → SPI/CSA kontrol → fault sağlıklı → ARM yükselen kenar.
- DRV_ENABLE, latch ile kesilmez: CSA sıfır çıkışından kaynaklanan açılış kilidi önlenir.
- Acil durdurma kontağı kısa devre ederek keser; kablo kopması algılanmaz. Sertifikalı güvenlik fonksiyonu değildir.

17_PWM_INHIBIT — Altı PWM / donanımsal izin kapıları

Tam boyut SVG · KiCad sayfası

Altı PWM / donanımsal izin kapıları

- Her AND kapısının A girişi LATCH_STATE; B girişi MCU PWM; çıkış DRV PWM.
- İzin düşükken altı sürücü girişi düşük. DRV 6-PWM modu zorunludur.
- Dead-time TIM1 ve sürücü yapılandırmasında hesaplanır; başlangıç değeri ölçülmeden kesinleşmez.
- Arıza → kapı kesme toplam gecikmesi osiloskopla ölçülür; yazılım kesmesi beklenmez.

17_PWM_INHIBIT_2 — Altı PWM / donanımsal izin kapıları / devam 2

Tam boyut SVG · KiCad sayfası

Altı PWM / donanımsal izin kapıları / devam 2

- Her AND kapısının A girişi LATCH_STATE; B girişi MCU PWM; çıkış DRV PWM.
- İzin düşükken altı sürücü girişi düşük. DRV 6-PWM modu zorunludur.
- Dead-time TIM1 ve sürücü yapılandırmasında hesaplanır; başlangıç değeri ölçülmeden kesinleşmez.
- Arıza → kapı kesme toplam gecikmesi osiloskopla ölçülür; yazılım kesmesi beklenmez.

18_BOARD_INTERFACE — Güç / kontrol kartı arayüzü

Tam boyut SVG · KiCad sayfası

Güç / kontrol kartı arayüzü

- İki konnektör eşleşmiş kablonun sistem modelidir; aynı net isimleri elektriksel olarak ortaktır.
- A2 düzeltme: pin39 +5V; pin40 GND. Pin1 ve bakış yönü fiziksel montaj çiziminde sabitlenecek.
- Güç kartı: köprü, driver, şönt, fault latch, AND kapıları. Kontrol kartı: MCU ve iletişim.
- Yerleşim öncesi iki PCB için netlist ayrılır. Bu birleşik sistem dosyası doğrudan iki PCB üretmez.

19_TEST_POINTS — Devreye alma / test erişimi

Tam boyut SVG · KiCad sayfası

Devreye alma / test erişimi

- Önce yardımcı kaynaklar, ardından fault zinciri, sonra düşük gerilim motor deneyi.
- TP VBUS ölçümünde prob gerilim sınıfı ve referansı kontrol edilir.
- İlk motor deneyi batarya yerine akım sınırlı kaynakla; akım limiti kademeli artırılır.
- Ölçüm kaydı: kart revizyonu, firmware hash, motor seri no, batarya/PSU, sıcaklık, dalga şekilleri.

## Üretime geçiş işleri

Kapandı bilgisi yalnız belirtilen kapsam için geçerlidir. Açık konular bitmiş gibi gösterilmez.

R01 · Batarya giriş modülü: sigorta, ön şarj, ayırma, ters kutup OPEN_DESIGN

Sorumlu rol: Güç elektroniği · Öncelik: P0

Batarya kısa devre akımına uygun DC kesme kapasitesi, kablo/sigorta I²t koordinasyonu ve gerçek yardımcı yükle ön şarj süresi hesaplanmış; şema ve numune testi tamamlanmış olmalı.

R02 · Geri sürülme, BMS açılması ve fren enerjisi OPEN_REQUIREMENT_AND_TEST

Sorumlu rol: Sistem / güç elektroniği · Öncelik: P0

Motor ve yük ataleti ölçülmüş; dump yükü veya enerji kabul yolu boyutlandırılmış; dolu batarya ve BMS açılması senaryosunda VBUS sınırı korunmuş olmalı. Sadece OV trip yeterli değildir.

R03 · Eksiksiz BOM ve footprint PARTIALLY_CLOSED

Sorumlu rol: Donanım / tedarik · Öncelik: P0

bom_open_items.json boşalmış; güç pasiflerinde DC bias, ESR/ripple, sıcaklık ve pulse sınırları incelenmiş; tüm kılıflar pad numarası ve mekanik çizimle karşılaştırılmış olmalı.

R04 · MOSFET anahtarlama ve kısa devre dayanımı OPEN_LAB

Sorumlu rol: Güç elektroniği / test · Öncelik: P0

DRV VDS eşiği/deglitch, dead-time, kapı direnci ve toplam fault gecikmesi ölçülmüş; en kötü akım/gerilim/sıcaklıkta SOA ve VDS/VGS marjı belgelenmiş olmalı.

R05 · CAN, Hall, RC ve servis arayüz korumaları OPEN_DESIGN_AND_TEST

Sorumlu rol: EMC / donanım · Öncelik: P1

TVS clamp gerilimi transceiver absolute maximum ile koordineli seçilmiş; connector ESD, kablo kopması ve ortak-mod testleri tamamlanmış olmalı. 24V TVS, SN65HVD230'u otomatik olarak korumaz.

R06 · FOC, ADC tetikleme ve arıza durum makinesi OPEN_IMPLEMENTATION

Sorumlu rol: Gömülü yazılım · Öncelik: P0

mcu_pin_contract.json ile CubeMX/derleme uyuşmuş; injected ADC pencere hesabı, Hall/FOC ve kilitli hata akışı test edilmiş; başlatma ve haberleşme kaybında istemsiz tork oluşmamış olmalı.

R07 · İki kart, mekanik zarf ve termal tasarım OPEN_LAYOUT

Sorumlu rol: PCB / mekanik · Öncelik: P1

Kart ayrımı, pin1 yönü, güç terminalleri, bakır yığını, soğutucu izolasyonu, creepage/clearance ve DRC tamamlanmış; 1.5kW ardından 3kW termal test raporu oluşmuş olmalı.

R08 · Kritik parçaların seri üretim bulunabilirliği OPEN_SERIES_SUPPLY

Sorumlu rol: Tedarik · Öncelik: P1

MCU, driver, MOSFET, şönt ve kaynak parçaları için gerçek sipariş adedi/ülke üzerinden yetkili kanal teyidi ve alternatif yeterlilik planı mevcut olmalı. Web stok görüntüsü rezervasyon değildir.

R09 · Motor ve batarya numune tanımlama OPEN_SAMPLE

Sorumlu rol: Motor / test · Öncelik: P1

HPM3000B gerçek sargı/hall varyantı; Rs, Ld/Lq, kutup çifti, Ke, Hall sırası ve sıcaklık sensörü ölçülmüş; 13S8P paket/BMS/kablo termal ve akım limiti doğrulanmış olmalı.

C01 · Kartlar arası eksik Hall 5V beslemesi CLOSED_SCHEMATIC

Sorumlu rol: Donanım · Öncelik: P0

Her iki 40 pinli konnektörde pin39=+5V; netlist karşılaştırması.

C02 · A1 yapay Kelvin net-tie parçalarının kaldırılması CLOSED_SCHEMATIC

Sorumlu rol: Donanım · Öncelik: P1

Üç fiziksel dört uçlu şönt; altı yapay 0R kaldırıldı, sense netleri ayrı.

C03 · Revizyon, sayfa numaraları, tasarım açıklamaları, test erişimi CLOSED_DOCUMENTATION

Sorumlu rol: Donanım · Öncelik: P1

A2 29 sayfa, sayfa bazlı refdes, 12 test noktası ve kabul notları.

## Ön BOM / satın alma serbest bırakması değil

61 bileşende MPN veya footprint alanı açık. Aynı parçanın farklı referansları ayrı bileşen sayılır.

Adet | Değer | Üretici kodu | Referanslar | Footprint
1 | DC LINK INPUT | Seçilecek | J101 | Seçilecek
1 | MOTOR U V W | Seçilecek | J102 | Seçilecek
1 | EXTERNAL BRAKE MODULE | Seçilecek | J103 | Seçilecek
3 | 470u 100V bulk | Seçilecek | C101, C102, C103 | Seçilecek
3 | 2.2u 100V X7R | Seçilecek | C104, C105, C106 | Seçilecek
1 | 100k 0.25W | RC1206FR-07100KL | R101 | Resistor_SMD:R_1206_3216Metric
12 | CSD19536KTT | CSD19536KTT | Q201, Q202, Q203, Q204, Q301, Q302, Q303, Q304, Q401, Q402, Q403, Q404 | Package_TO_SOT_SMD:TO-263-3_TabPin2
12 | 4.7R gate | RC0805FR-074R7L | R201, R203, R205, R207, R301, R303, R305, R307, R401, R403, R405, R407 | Resistor_SMD:R_0805_2012Metric
12 | 47k G-S | RC0805FR-0747KL | R202, R204, R206, R208, R302, R304, R306, R308, R402, R404, R406, R408 | Resistor_SMD:R_0805_2012Metric
3 | 0.5mR 1% Kelvin | CSS4J-4026R-L500F | RS201, RS301, RS401 | Seçilecek
3 | 100n 100V | C2012X7R2A104K125AA | C201, C301, C401 | Capacitor_SMD:C_0805_2012Metric
1 | DRV8353FSRTAR | DRV8353FSRTAR | U501 | ESC_A2:TI_RTA0040B_6x6_P0.5_EP4.15
1 | 47n 100V | Seçilecek | C501 | Seçilecek
2 | 1u 25V | Seçilecek | C502, C503 | Capacitor_SMD:C_0805_2012Metric
2 | 1u 10V | Seçilecek | C504, C1503 | Capacitor_SMD:C_0805_2012Metric
1 | 100n 25V | C2012X7R2A104K125AA | C505 | Capacitor_SMD:C_0805_2012Metric
2 | 10u 25V | Seçilecek | C506, C1501 | Seçilecek
1 | 100n 10V | C2012X7R2A104K125AA | C507 | Capacitor_SMD:C_0805_2012Metric
2 | 4.7k pull-up | RC0805FR-074K7L | R601, R602 | Resistor_SMD:R_0805_2012Metric
1 | 10k pull-up | RC0805FR-0710KL | R603 | Resistor_SMD:R_0805_2012Metric
1 | 10k pull-down | RC0805FR-0710KL | R604 | Resistor_SMD:R_0805_2012Metric
6 | 47k pull-down | RC0805FR-0747KL | R605, R606, R607, R608, R609, R610 | Resistor_SMD:R_0805_2012Metric
8 | 49.9k 0.1% | RT0805BRD0749K9L | R701, R702, R801, R802, R901, R902, R1001, R1002 | Resistor_SMD:R_0805_2012Metric
4 | 3.32k 0.1% | RT0805BRD073K32L | R703, R803, R903, R1003 | Resistor_SMD:R_0805_2012Metric
4 | 1k ADC series | RC0805FR-071KL | R704, R804, R904, R1004 | Resistor_SMD:R_0805_2012Metric
7 | 1n C0G | Seçilecek | C701, C801, C901, C1001, C1101, C1102, C1103 | Capacitor_SMD:C_0805_2012Metric
4 | BAT54H upper | BAT54H,115 | D701, D801, D901, D1001 | Diode_SMD:D_SOD-123F
4 | BAT54H lower | BAT54H,115 | D702, D802, D902, D1002 | Diode_SMD:D_SOD-123F
3 | 100R ADC | RC0805FR-07100RL | R1101, R1102, R1103 | Resistor_SMD:R_0805_2012Metric
5 | 10k 0.1% | RT0805BRD0710KL | R1201, R1203, R2302, R2303, R2306 | Resistor_SMD:R_0805_2012Metric
2 | NTC 10k B25/85=3650K | NTCG203NH103JT1 | R1202, R1204 | Resistor_SMD:R_0805_2012Metric
3 | 10n | Seçilecek | C1201, C1202, C1203 | Capacitor_SMD:C_0805_2012Metric
1 | MOTOR TEMP | Seçilecek | J1201 | Seçilecek
1 | 10k provision | RC0805FR-0710KL | R1205 | Resistor_SMD:R_0805_2012Metric
4 | 1k | RC0805FR-071KL | R1206, R2102, R2104, R2106 | Resistor_SMD:R_0805_2012Metric
1 | LM5164DDAT | LM5164DDAT | U1301 | Package_SO:HSOP-8-1EP_3.9x4.9mm_P1.27mm_EP2.41x3.1mm_ThermalVias
1 | 68uH >=1.5A | Seçilecek | L1301 | Seçilecek
1 | 2.2u 160V | Seçilecek | C1301 | Seçilecek
1 | 100n 160V | Seçilecek | C1302 | Seçilecek
2 | 22u 25V | Seçilecek | C1303, C1304 | Seçilecek
1 | 2.2n C0G | Seçilecek | C1305 | Capacitor_SMD:C_0805_2012Metric
2 | 100k | RC0805FR-07100KL | R1301, R1502 | Resistor_SMD:R_0805_2012Metric
1 | 453k | RC0805FR-07453KL | R1302 | Resistor_SMD:R_0805_2012Metric
1 | 49.9k | RC0805FR-0749K9L | R1303 | Resistor_SMD:R_0805_2012Metric
1 | 453k ripple | RC0805FR-07453KL | R1304 | Resistor_SMD:R_0805_2012Metric
1 | 3.3n | Seçilecek | C1306 | Capacitor_SMD:C_0805_2012Metric
1 | 56p C0G | Seçilecek | C1401 | Capacitor_SMD:C_0805_2012Metric
1 | 1M UVLO | RC0805FR-071ML | R1401 | Resistor_SMD:R_0805_2012Metric
1 | 100k UVLO | RC0805FR-07100KL | R1402 | Resistor_SMD:R_0805_2012Metric
5 | 10k | RC0805FR-0710KL | R1403, R1503, R1801, R1901, R1902 | Resistor_SMD:R_0805_2012Metric
1 | FAN 12V | Seçilecek | J1401 | Seçilecek
1 | TPS62160DGKR | TPS62160DGKR | U1501 | Package_SO:VSSOP-8_3x3mm_P0.65mm
1 | 2.2uH >=1.5A | Seçilecek | L1501 | Seçilecek
1 | 22u 10V | Seçilecek | C1502 | Seçilecek
1 | 523k | RC0805FR-07523KL | R1501 | Resistor_SMD:R_0805_2012Metric
1 | TLV75533PDBVR | TLV75533PDBVR | U1502 | Package_TO_SOT_SMD:SOT-23-5
2 | 4.7u 10V | Seçilecek | C1504, C1505 | Seçilecek
1 | 0R analog link | RC0805JR-070RL | R1504 | Resistor_SMD:R_0805_2012Metric
1 | 100n | C2012X7R2A104K125AA | C1601 | Capacitor_SMD:C_0805_2012Metric
1 | STM32G474RET3 | STM32G474RET3 | U1701 | Package_QFP:LQFP-64_10x10mm_P0.5mm
4 | 100n at VDD | C2012X7R2A104K125AA | C1801, C1802, C1803, C1804 | Capacitor_SMD:C_0805_2012Metric
1 | 4.7u | Seçilecek | C1805 | Seçilecek
1 | 100n at VBAT | C2012X7R2A104K125AA | C1806 | Capacitor_SMD:C_0805_2012Metric
1 | 1u VDDA | Seçilecek | C1807 | Capacitor_SMD:C_0805_2012Metric
1 | 100n VDDA | C2012X7R2A104K125AA | C1808 | Capacitor_SMD:C_0805_2012Metric
1 | 100n VREF | C2012X7R2A104K125AA | C1809 | Capacitor_SMD:C_0805_2012Metric
1 | 100n reset | C2012X7R2A104K125AA | C1810 | Capacitor_SMD:C_0805_2012Metric
1 | 10k BOOT0 | RC0805FR-0710KL | R1802 | Resistor_SMD:R_0805_2012Metric
1 | SWD | Seçilecek | J1901 | Seçilecek
1 | 8MHz 3V3 CMOS oscillator | Seçilecek | Y1901 | Seçilecek
1 | 100n oscillator | C2012X7R2A104K125AA | C1901 | Capacitor_SMD:C_0805_2012Metric
1 | 1k LED | RC0805FR-071KL | R1903 | Resistor_SMD:R_0805_2012Metric
1 | LED GREEN | Seçilecek | D1901 | Seçilecek
1 | SN65HVD230DR | SN65HVD230DR | U2001 | Package_SO:SOIC-8_3.9x4.9mm_P1.27mm
1 | 10k slope | RC0805FR-0710KL | R2001 | Resistor_SMD:R_0805_2012Metric
1 | 100n CAN | C2012X7R2A104K125AA | C2001 | Capacitor_SMD:C_0805_2012Metric
1 | 120R DNP | RC0805FR-07120RL | R2002 | Resistor_SMD:R_0805_2012Metric
1 | CAN | Seçilecek | J2001 | Seçilecek
1 | UART 3V3 | Seçilecek | J2002 | Seçilecek
1 | RC PWM 3V3 | Seçilecek | J2003 | Seçilecek
1 | HALL 5V | Seçilecek | J2101 | Seçilecek
3 | 4.7k 3V3 pull-up | RC0805FR-074K7L | R2101, R2103, R2105 | Resistor_SMD:R_0805_2012Metric
3 | 1n | Seçilecek | C2101, C2102, C2103 | Capacitor_SMD:C_0805_2012Metric
2 | TLV1704PWR | TLV1704PWR | U2201, U2202 | Package_SO:TSSOP-14_4.4x5mm_P0.65mm
2 | 100n comparator | C2012X7R2A104K125AA | C2201, C2202 | Capacitor_SMD:C_0805_2012Metric
2 | 26.1k 0.1% | RT0805BRD0726K1L | R2301, R2304 | Resistor_SMD:R_0805_2012Metric
3 | 10n reference | Seçilecek | C2301, C2302, C2303 | Capacitor_SMD:C_0805_2012Metric
1 | 7.50k 0.1% | RT0805BRD077K50L | R2305 | Resistor_SMD:R_0805_2012Metric
1 | 2.2k fault pull-up | RC0805FR-072K2L | R2401 | Resistor_SMD:R_0805_2012Metric
1 | BAT54H fault OR | BAT54H,115 | D2401 | Diode_SMD:D_SOD-123F
1 | BAT54H reset OR | BAT54H,115 | D2402 | Diode_SMD:D_SOD-123F
2 | BAT54H PG OR | BAT54H,115 | D2403, D2404 | Diode_SMD:D_SOD-123F
1 | SN74LVC1G74DCUR | SN74LVC1G74DCUR | U2401 | Package_SO:VSSOP-8_2.3x2mm_P0.5mm
1 | 0R driver wake | RC0805JR-070RL | R2402 | Resistor_SMD:R_0805_2012Metric
1 | 100n latch | C2012X7R2A104K125AA | C2401 | Capacitor_SMD:C_0805_2012Metric
1 | EMERGENCY STOP | Seçilecek | J2401 | Seçilecek
6 | SN74LVC1G08DBVR | SN74LVC1G08DBVR | U2501, U2502, U2503, U2601, U2602, U2603 | Package_TO_SOT_SMD:SOT-23-5
6 | 47k reset default | RC0805FR-0747KL | R2501, R2502, R2503, R2601, R2602, R2603 | Resistor_SMD:R_0805_2012Metric
6 | 100n logic | C2012X7R2A104K125AA | C2501, C2502, C2503, C2601, C2602, C2603 | Capacitor_SMD:C_0805_2012Metric
1 | POWER CARD 2x20 | Seçilecek | J2701 | Seçilecek
1 | CONTROL CARD 2x20 | Seçilecek | J2702 | Seçilecek
1 | VBUS | PCB TEST PAD | TP2801 | TestPoint:TestPoint_Pad_D1.5mm
1 | GND | PCB TEST PAD | TP2802 | TestPoint:TestPoint_Pad_D1.5mm
1 | +12V | PCB TEST PAD | TP2803 | TestPoint:TestPoint_Pad_D1.5mm
1 | +5V | PCB TEST PAD | TP2804 | TestPoint:TestPoint_Pad_D1.5mm
1 | +3V3 | PCB TEST PAD | TP2805 | TestPoint:TestPoint_Pad_D1.5mm
1 | +3V3A | PCB TEST PAD | TP2806 | TestPoint:TestPoint_Pad_D1.5mm
1 | HARD_FAULT_N | PCB TEST PAD | TP2807 | TestPoint:TestPoint_Pad_D1.5mm
1 | LATCH_STATE | PCB TEST PAD | TP2808 | TestPoint:TestPoint_Pad_D1.5mm
1 | DRV_FAULT_N | PCB TEST PAD | TP2809 | TestPoint:TestPoint_Pad_D1.5mm
1 | I_A_RAW | PCB TEST PAD | TP2810 | TestPoint:TestPoint_Pad_D1.5mm
1 | I_B_RAW | PCB TEST PAD | TP2811 | TestPoint:TestPoint_Pad_D1.5mm
1 | I_C_RAW | PCB TEST PAD | TP2812 | TestPoint:TestPoint_Pad_D1.5mm

Tarihli stok kanıtları · Hesaplar · Bağlantı kontrolleri
