mekiciepcas/ESC-Ai/ESC_V2/planning/RUN_2026-09-21_0823_TRACEABILITY.md

# Autonomous run trace — 2026-09-21 08:23+03:00

Run-start HEAD: `a5a0e3d7550b19413f5be134e624dfd0bd9e222f`.

## TR-091 — PB-08 degraded-mode decision evidence contract
**EVIDENCE CONTRACT / NO SAFETY DECISION / NO ARCHITECTURE FREEZE.** Added `PB08_DEGRADED_MODE_DECISION_CONTRACT.md`. It defines four explicit decision classes and requires controlled authority, normative requirement, failure boundary, response, unsafe-response exclusions, acceptance criteria, evidence and architecture-independence. No class is selected and no requirement is inferred from Quad/Hexa.

## TR-092 — PB-08 degraded-mode decision result schema
**VERIFICATION ARTIFACT / UNPOPULATED.** Added `PB08_DEGRADED_MODE_DECISION_RESULT.template.json`. All decision/authority/acceptance evidence remains null/open; gate and architecture advancement fields are false.

## TR-093 — PB-08 degraded-mode decision fail-closed verifier
**FAIL-CLOSED VERIFICATION TOOL / NO PHYSICAL OR SAFETY QUALIFICATION.** Added `verify_pb08_degraded_mode_decision.py`. It rejects absent authority, decision class, normative requirement, one-axis-loss boundary, required/prohibited responses, evidence, architecture-independence, review, and class-specific acceptance criteria. PASS means record completeness only and explicitly leaves architecture/G0/G1 advancement false.

## Impact
This reduces the process ambiguity around the non-mass S1R.2 blocker but does not close it. TR-084/TR-085 physical mass evidence and an externally controlled degraded-mode/system-safety decision are still required. No A2/B1 electrical source, KiCad/PCB/Gerber/release artifact, product value, G1 row or backlog status changed.
