mekiciepcas/ESC-Ai/ESC_V2/pcb_b1/control/placement.png

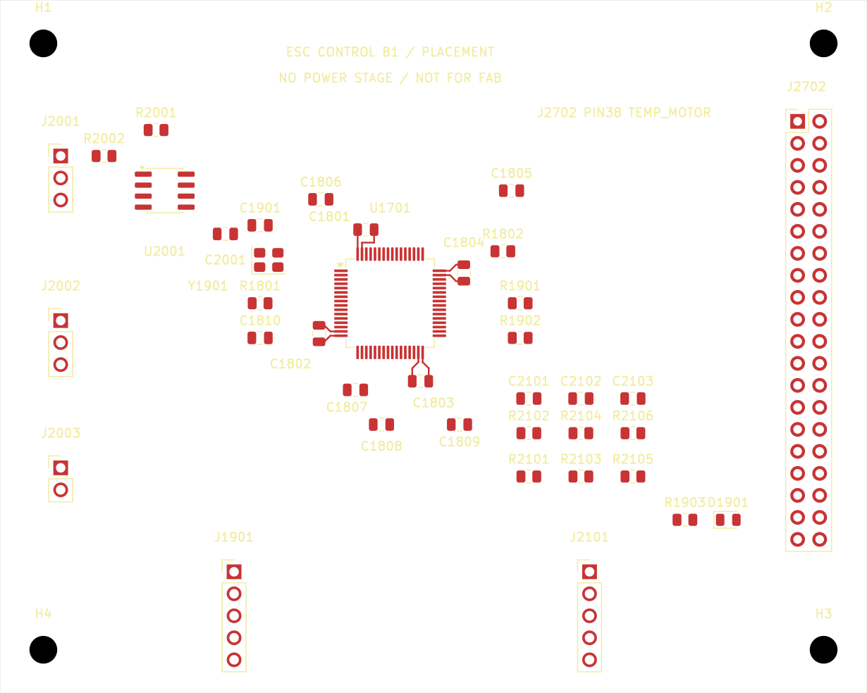
ESC_V2/pcb_b1/control/placement.png
