mekiciepcas/ESC-Ai/ESC_V2/verification/team_schematic/bulk.png

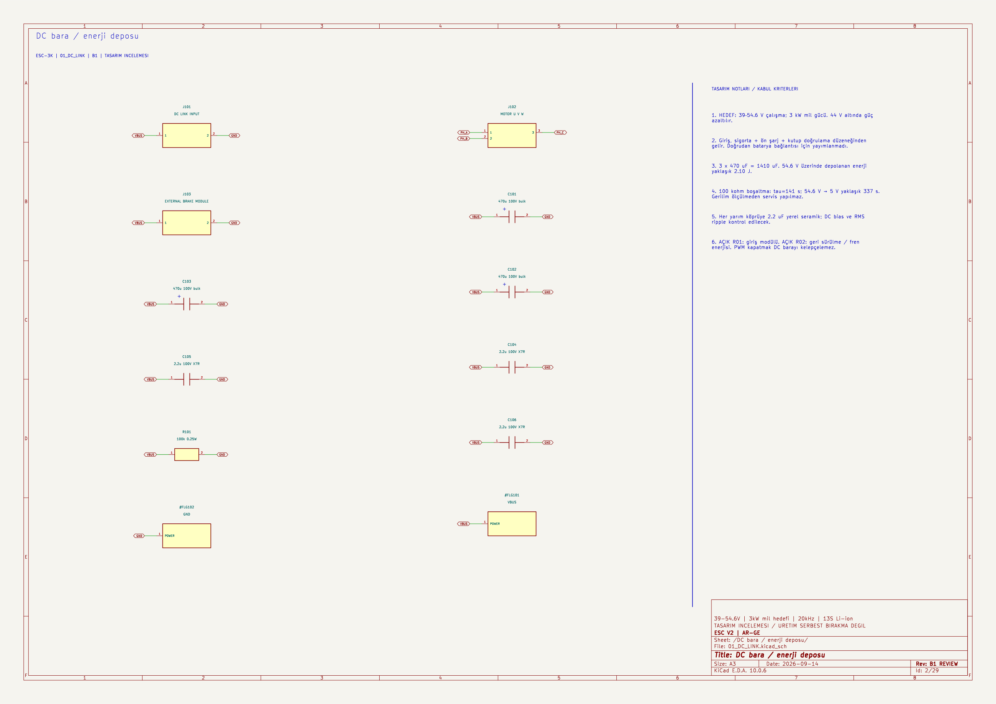
ESC_V2/verification/team_schematic/bulk.png
