mekiciepcas/ESC-Ai/ESC_V2/verification/team_schematic/inductor.png

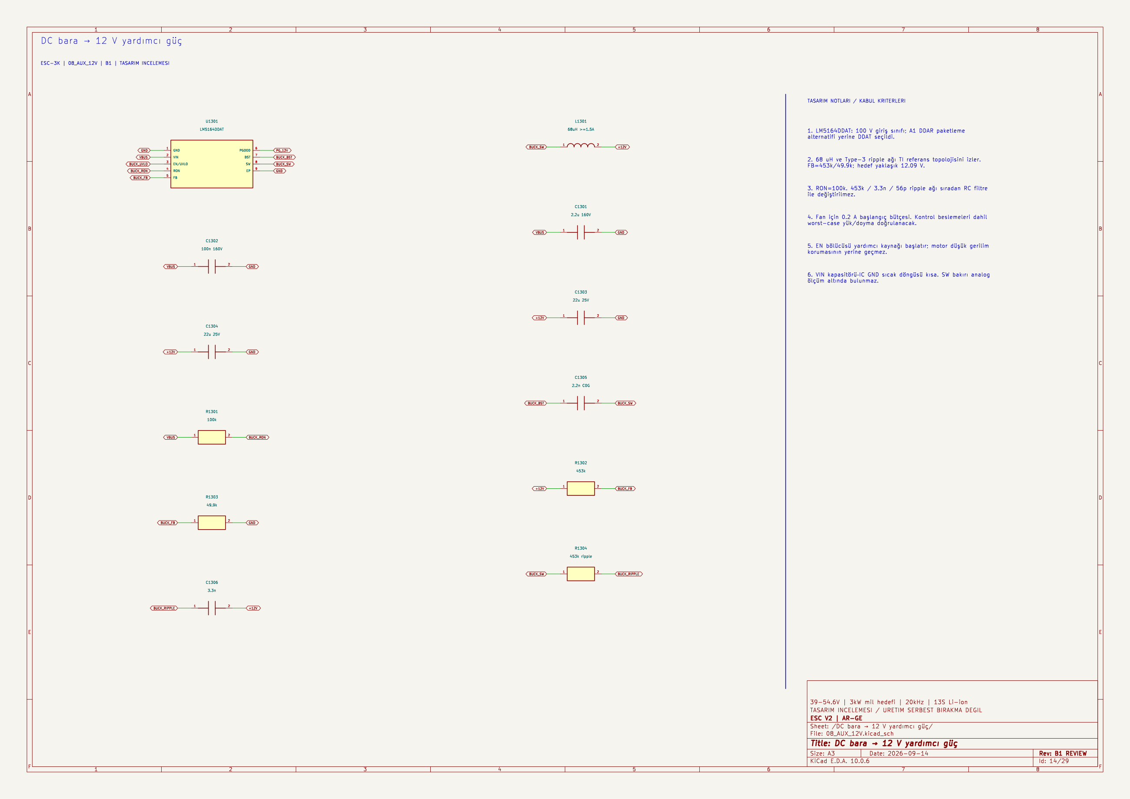
ESC_V2/verification/team_schematic/inductor.png
