mekiciepcas/ESC-Ai/ESC_V2/verification/team_schematic/phase.png

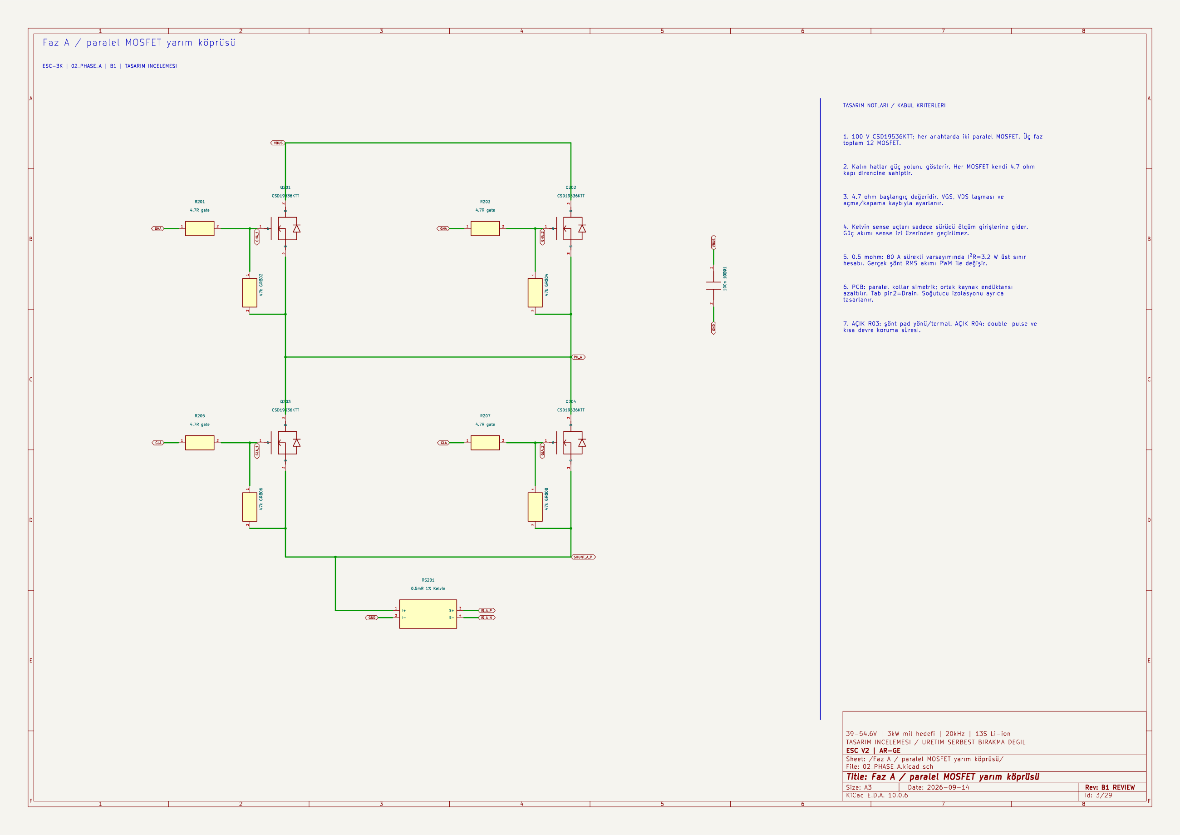
ESC_V2/verification/team_schematic/phase.png
