mekiciepcas/ESC-Ai/inceleme/contact-0.jpg

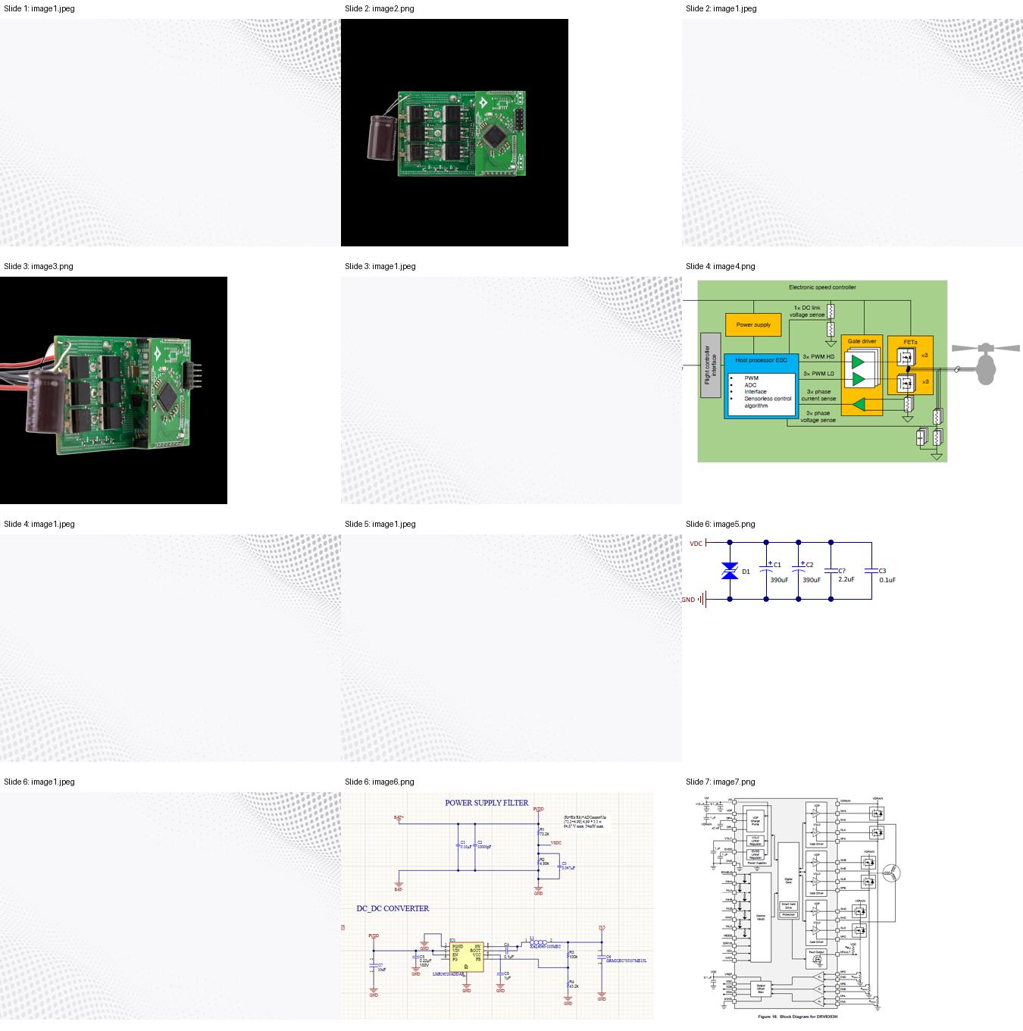
inceleme/contact-0.jpg
