mekiciepcas/ESC-Ai/inceleme/contact-1.jpg

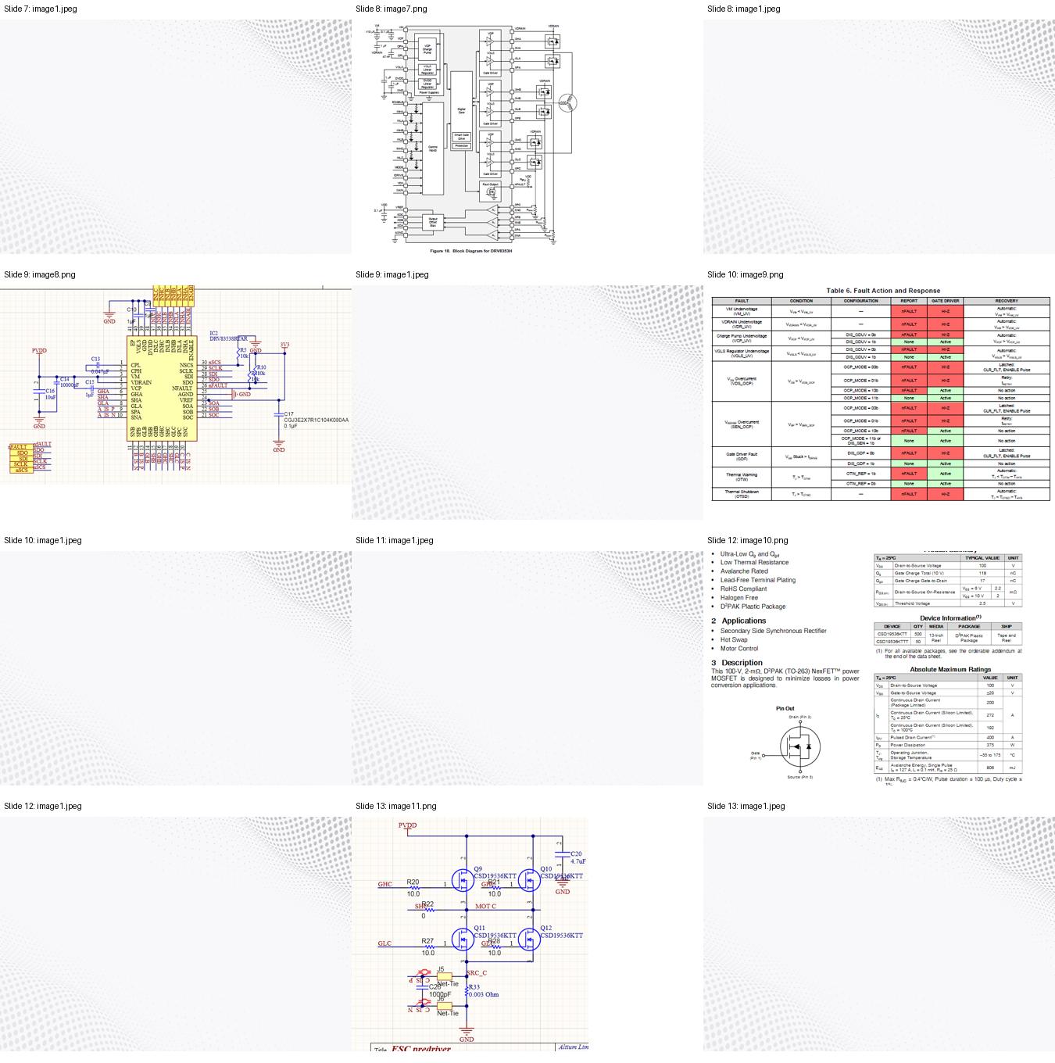
inceleme/contact-1.jpg
