mekiciepcas/ESC-Ai/inceleme/contact-2.jpg

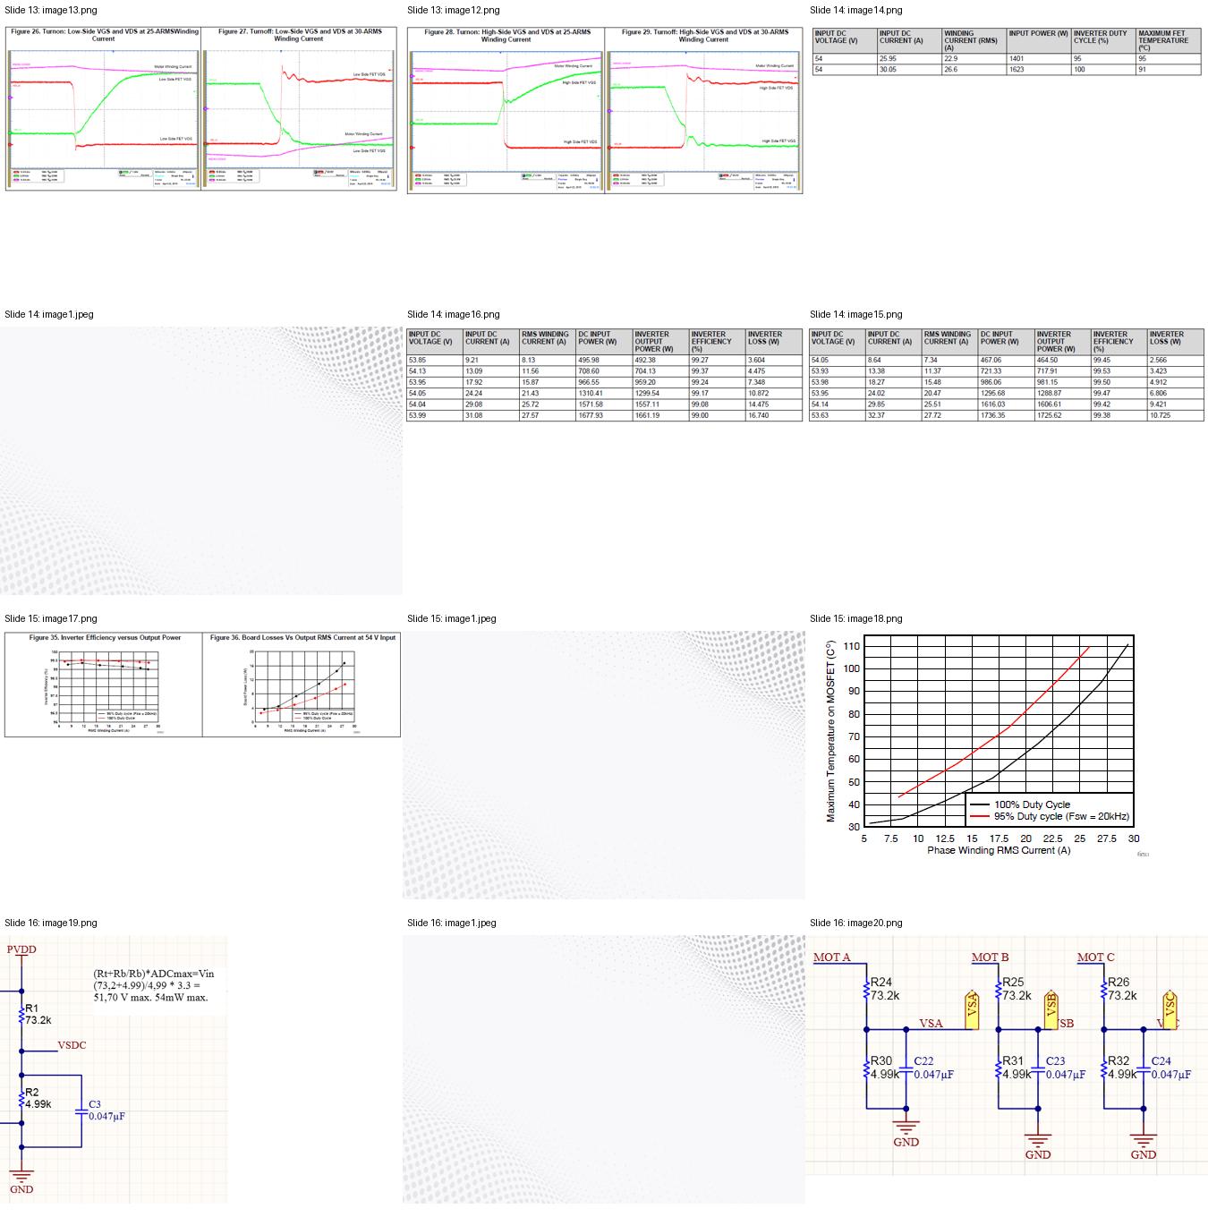
inceleme/contact-2.jpg
