mekiciepcas/ESC-Ai/inceleme/contact-3.jpg

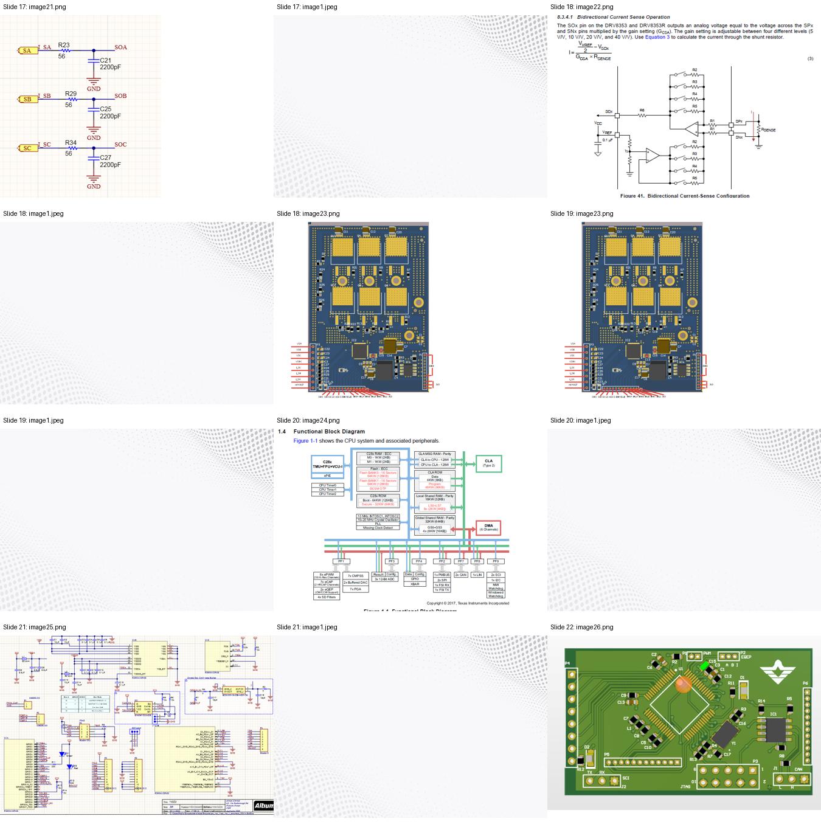
inceleme/contact-3.jpg
