mekiciepcas/ESC-Ai/inceleme/contact-4.jpg

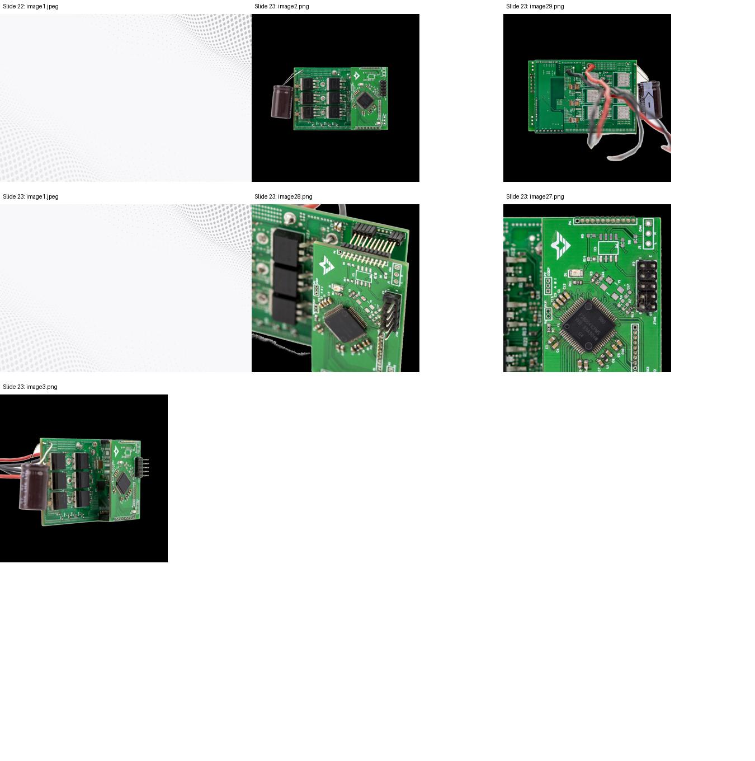
inceleme/contact-4.jpg
