mekiciepcas/ESC-Ai/inceleme/mcu2022.png

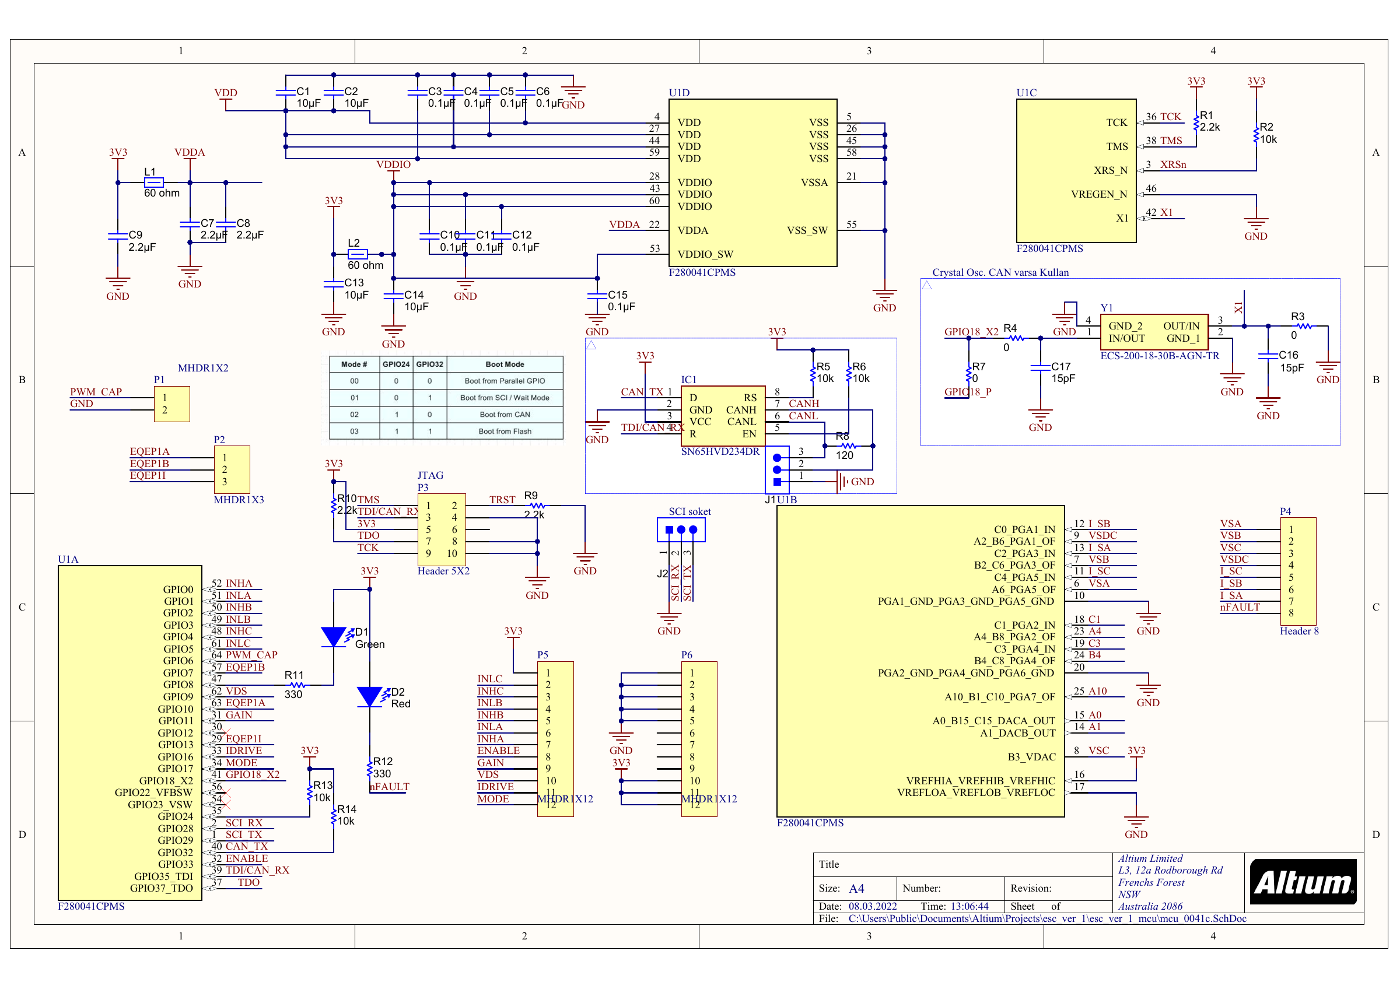
inceleme/mcu2022.png
