mekiciepcas/ESC-Ai/inceleme/mcu2026.png

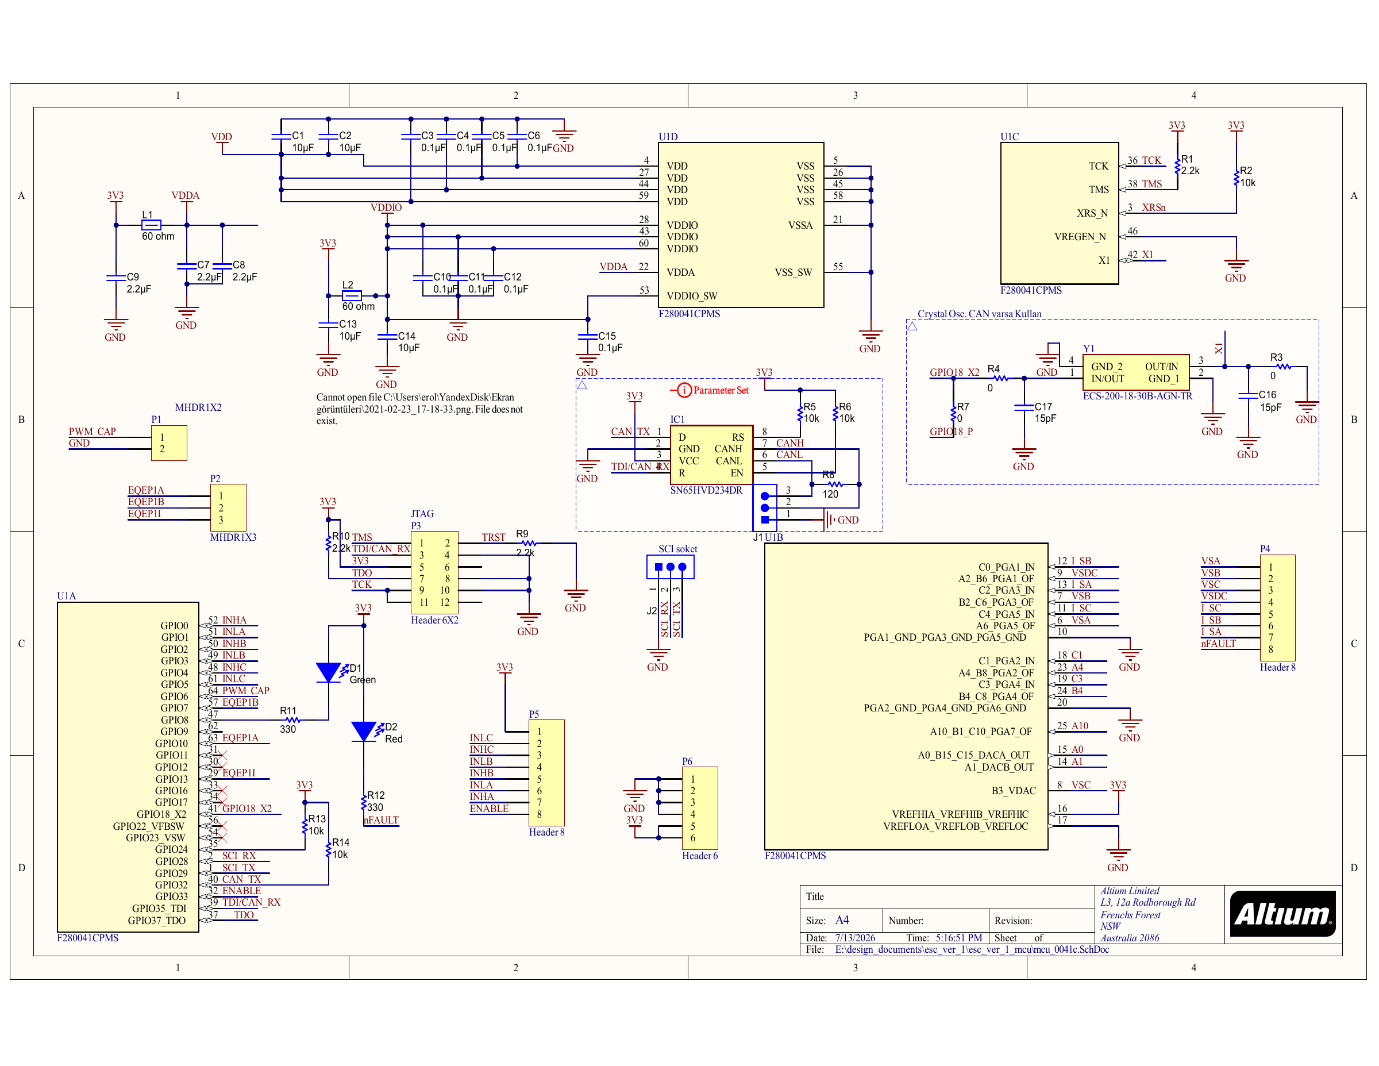
inceleme/mcu2026.png
