mekiciepcas/ESC-Ai/inceleme/media/image1.jpeg

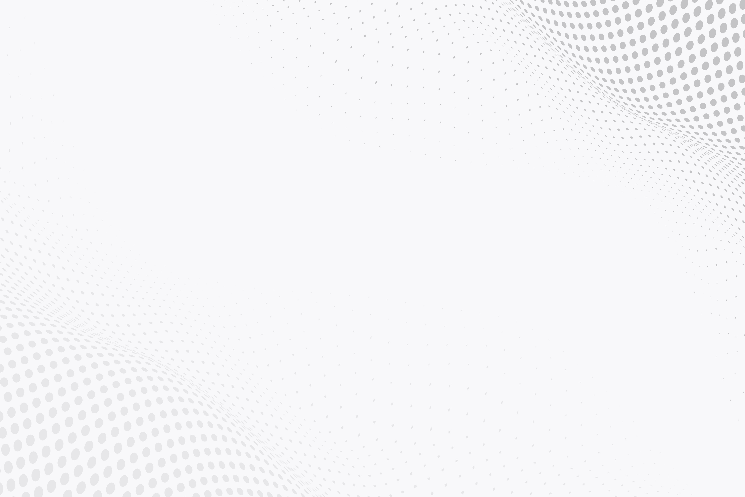
inceleme/media/image1.jpeg
