mekiciepcas/ESC-Ai/inceleme/media/image4.png

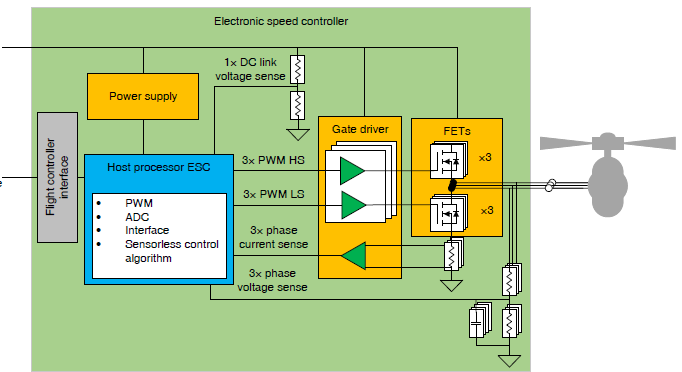
inceleme/media/image4.png
