mekiciepcas/ESC-Ai/inceleme/media/image6.png

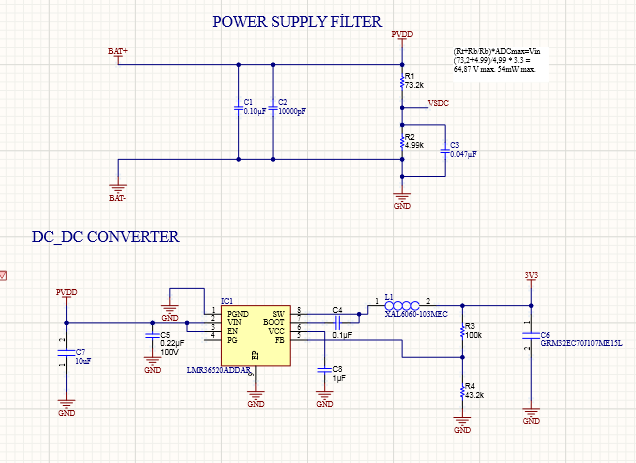
inceleme/media/image6.png
