mekiciepcas/ESC-Ai/inceleme/media/image7.png

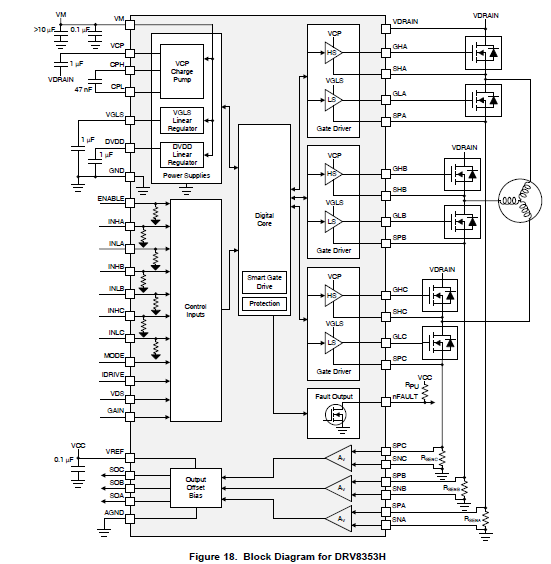
inceleme/media/image7.png
