mekiciepcas/ESC-Ai/inceleme/media/image8.png

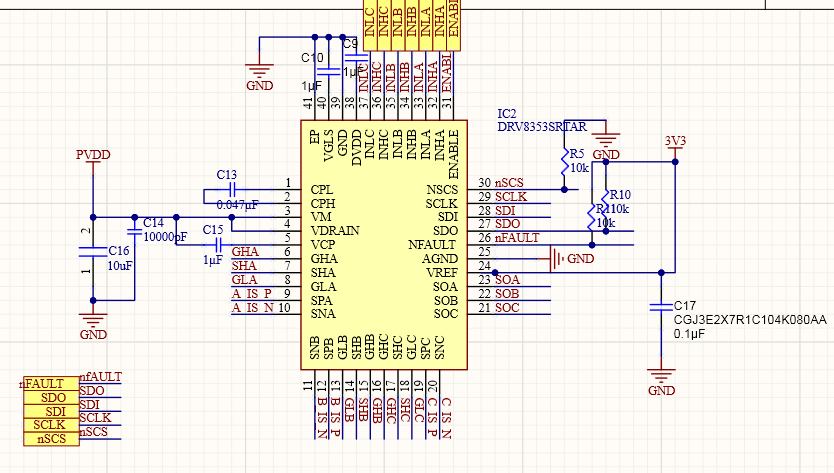
inceleme/media/image8.png
