mekiciepcas/ESC-Ai/inceleme/media/image9.png

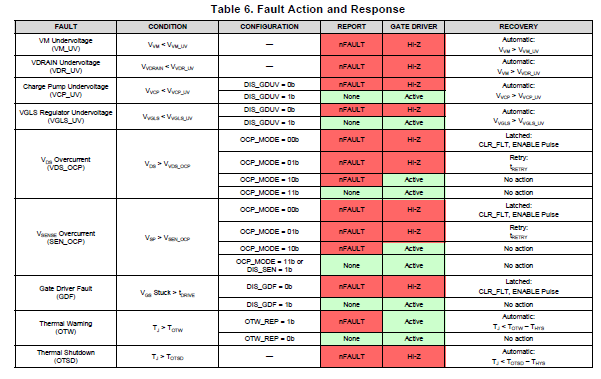
inceleme/media/image9.png
