mekiciepcas/ESC-Ai/inceleme/media/image10.png

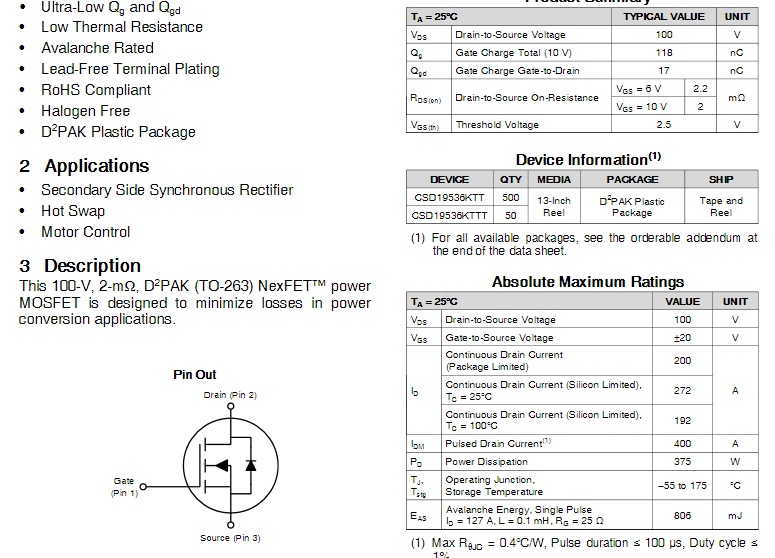
inceleme/media/image10.png
