mekiciepcas/ESC-Ai/inceleme/media/image11.png

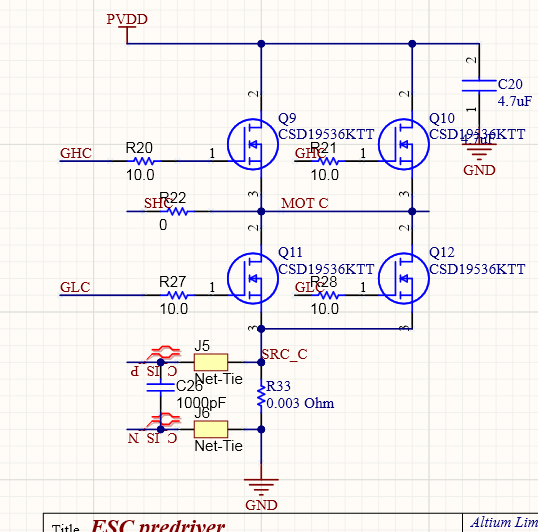
inceleme/media/image11.png
