mekiciepcas/ESC-Ai/inceleme/media/image12.png

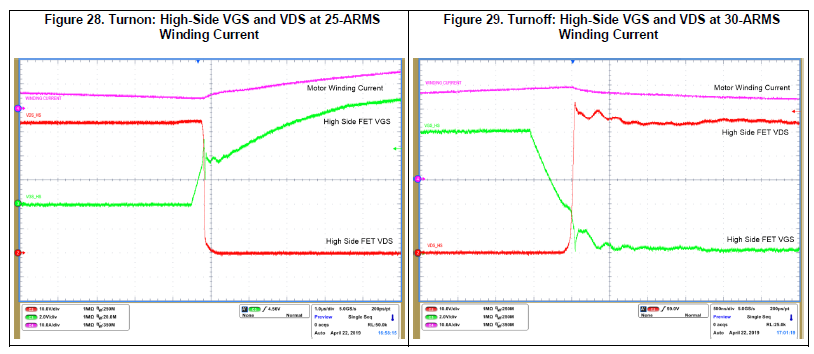
inceleme/media/image12.png
