mekiciepcas/ESC-Ai/inceleme/media/image13.png

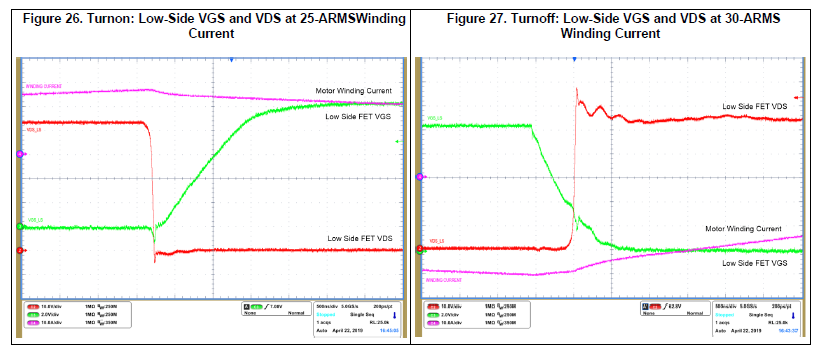
inceleme/media/image13.png
