mekiciepcas/ESC-Ai/inceleme/media/image15.png

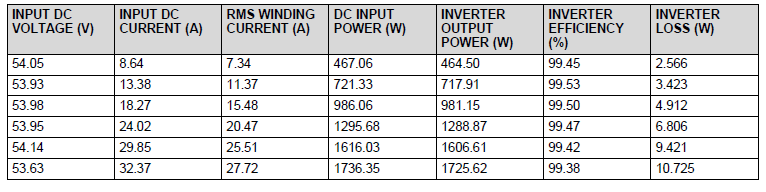
inceleme/media/image15.png
