mekiciepcas/ESC-Ai/inceleme/media/image17.png

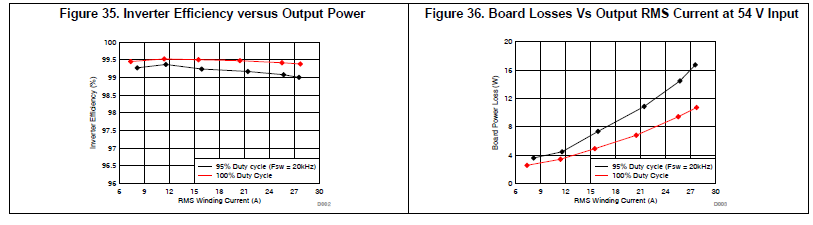
inceleme/media/image17.png
