mekiciepcas/ESC-Ai/inceleme/media/image18.png

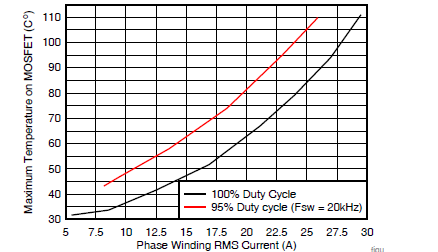
inceleme/media/image18.png
