mekiciepcas/ESC-Ai/inceleme/media/image19.png

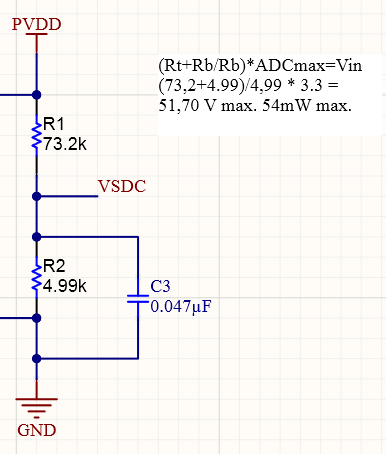
inceleme/media/image19.png
