mekiciepcas/ESC-Ai/inceleme/media/image20.png

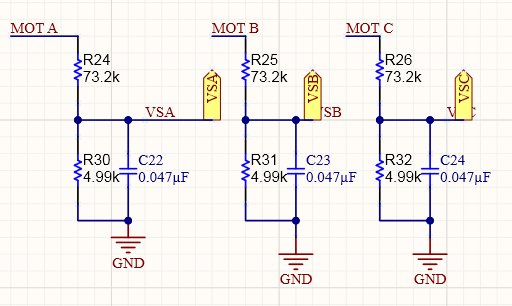
inceleme/media/image20.png
