mekiciepcas/ESC-Ai/inceleme/media/image21.png

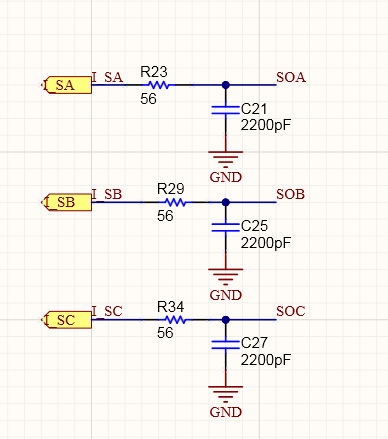
inceleme/media/image21.png
