mekiciepcas/ESC-Ai/inceleme/media/image22.png

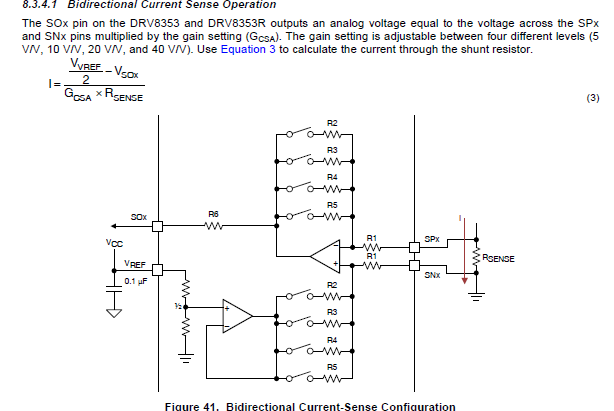
inceleme/media/image22.png
