mekiciepcas/ESC-Ai/inceleme/media/image23.png

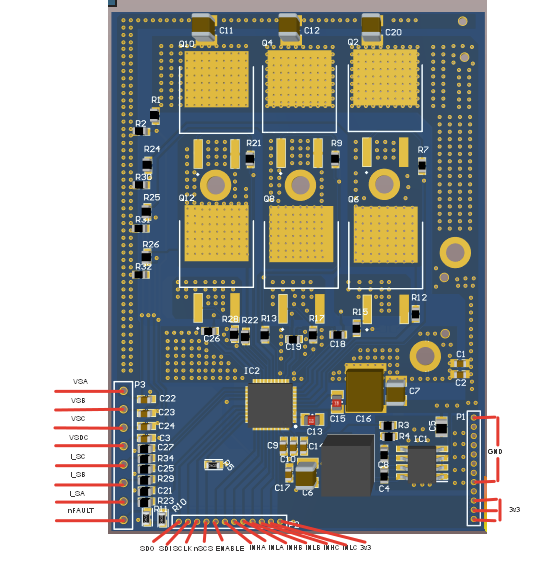
inceleme/media/image23.png
