mekiciepcas/ESC-Ai/inceleme/media/image24.png

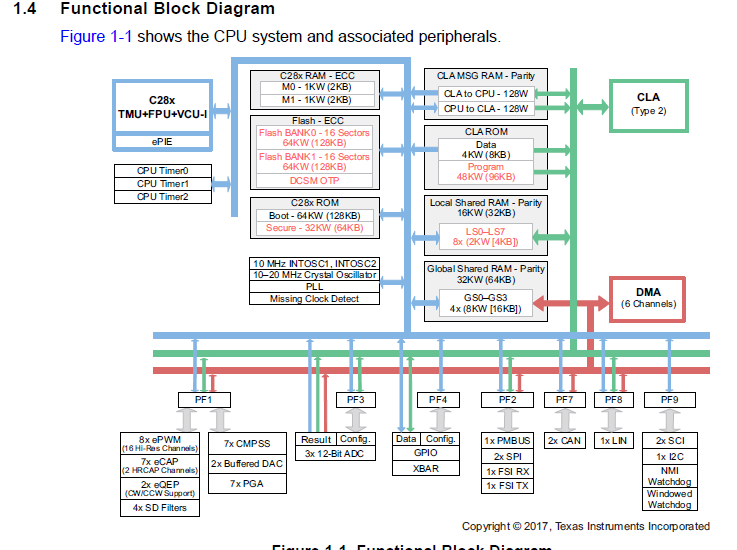
inceleme/media/image24.png
