mekiciepcas/ESC-Ai/inceleme/media/image25.png

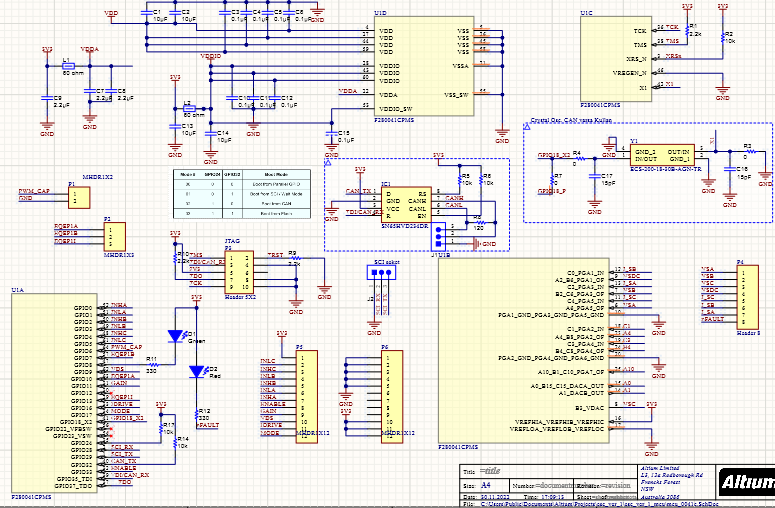
inceleme/media/image25.png
