mekiciepcas/ESC-Ai/inceleme/media/image26.png

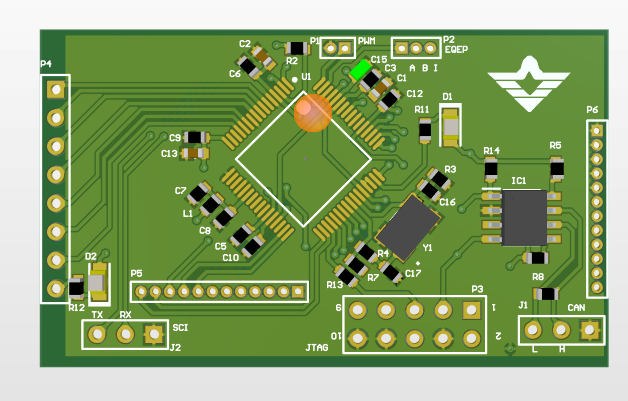
inceleme/media/image26.png
