mekiciepcas/ESC-Ai/inceleme/media/image29.png

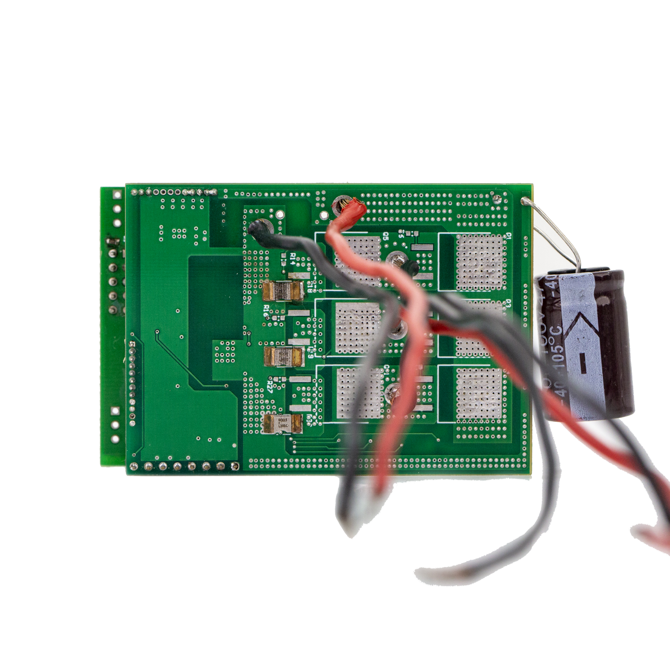
inceleme/media/image29.png
