mekiciepcas/ESC-Ai/ESC_V2/verification/a2_contact_sheet.png

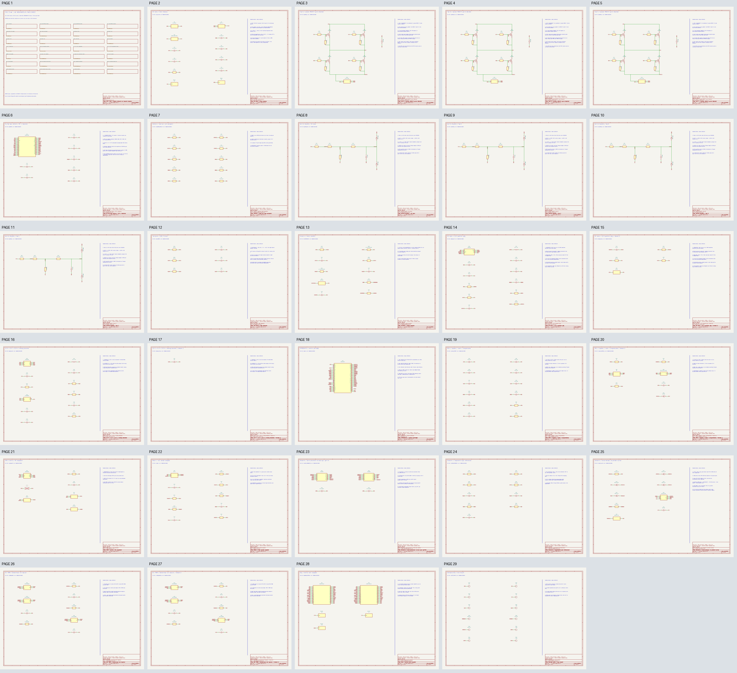
ESC_V2/verification/a2_contact_sheet.png
