mekiciepcas/ESC-Ai/ESC_V2/verification/a2_pdf-01.png

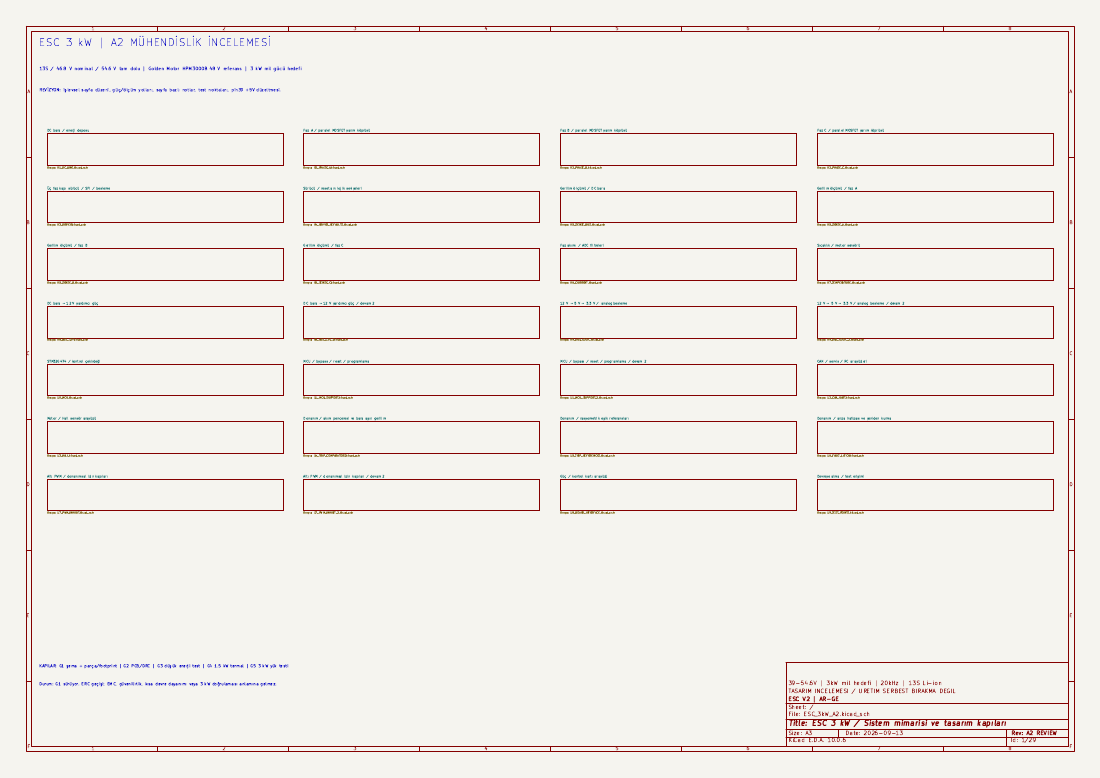
ESC_V2/verification/a2_pdf-01.png
