mekiciepcas/ESC-Ai/ESC_V2/verification/a2_pdf-03.png

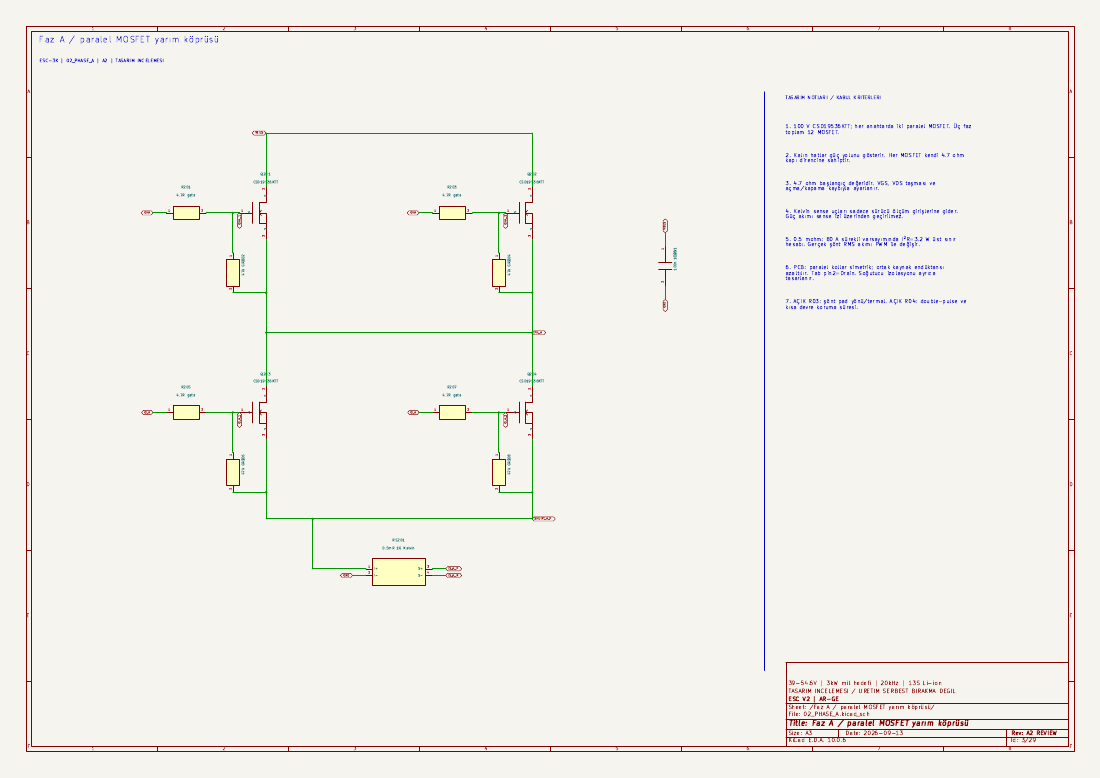
ESC_V2/verification/a2_pdf-03.png
