mekiciepcas/ESC-Ai/ESC_V2/verification/a2_preview_0.png

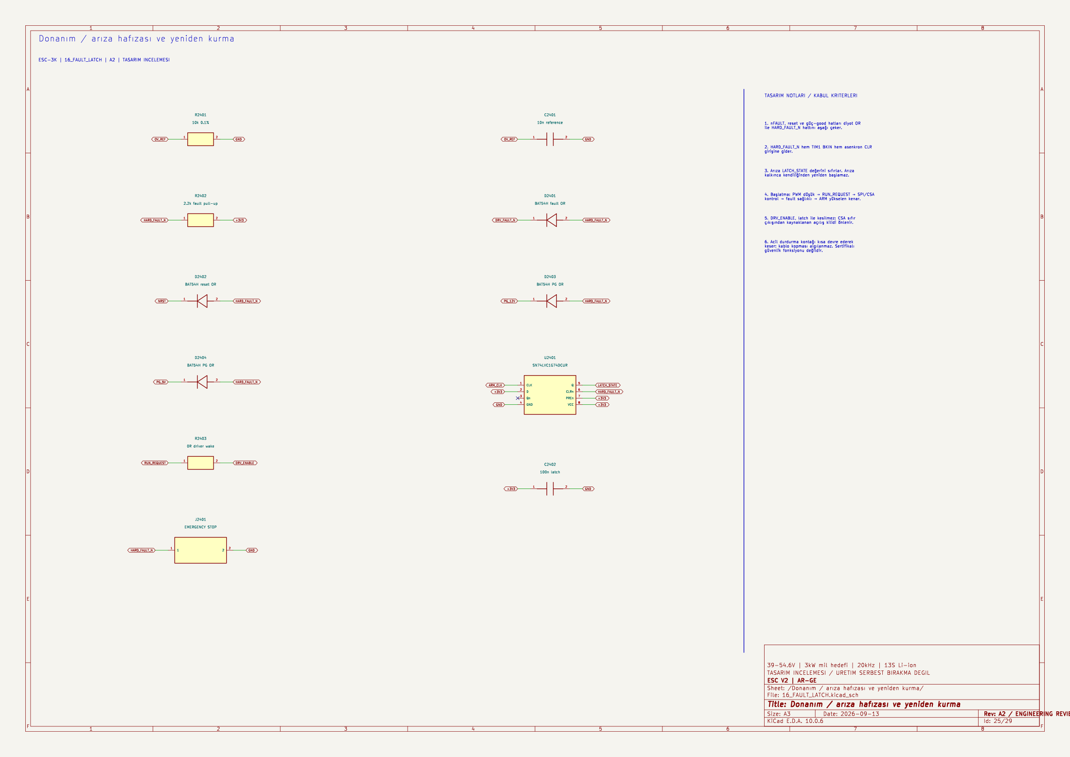
ESC_V2/verification/a2_preview_0.png
