mekiciepcas/ESC-Ai/ESC_V2/verification/a2_preview_1.png

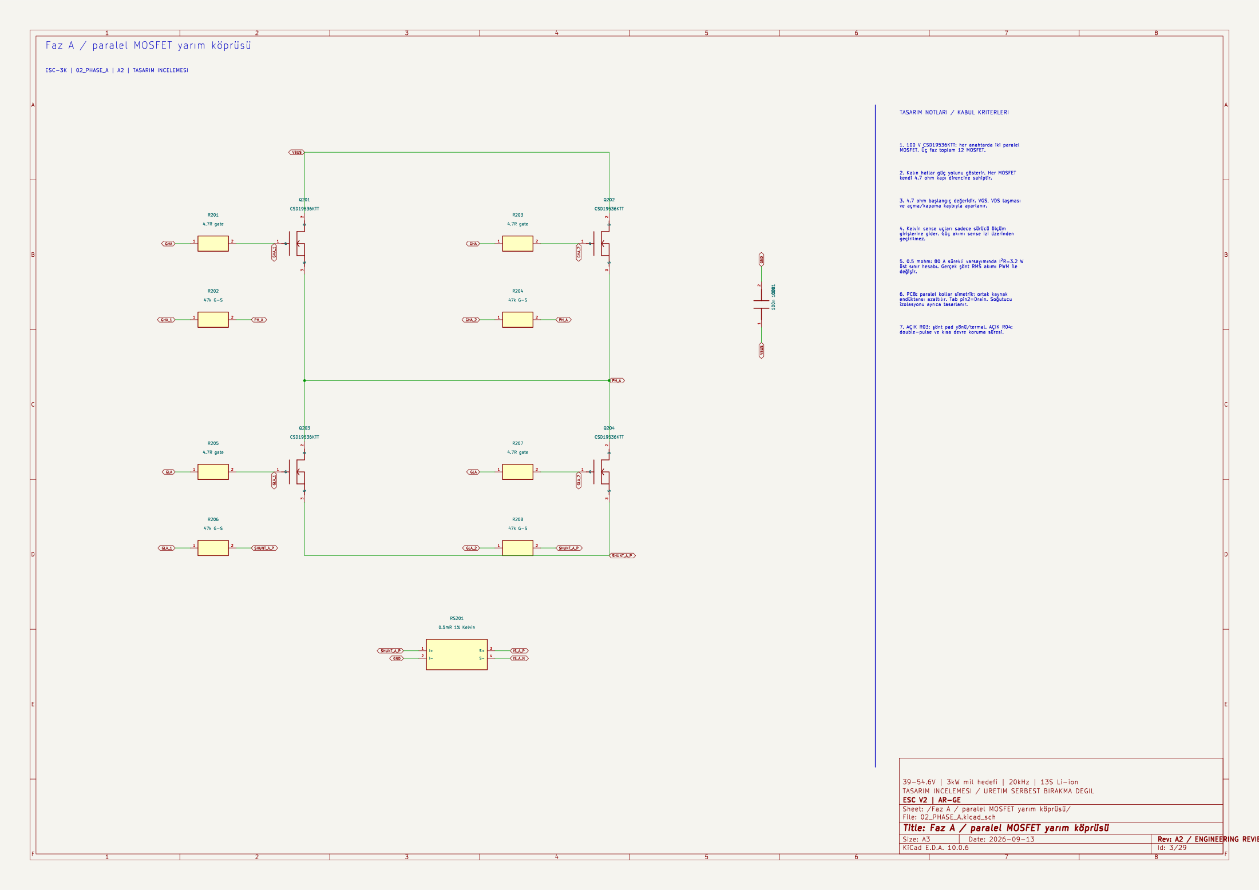
ESC_V2/verification/a2_preview_1.png
