mekiciepcas/ESC-Ai/ESC_V2/verification/a2_preview_4.png

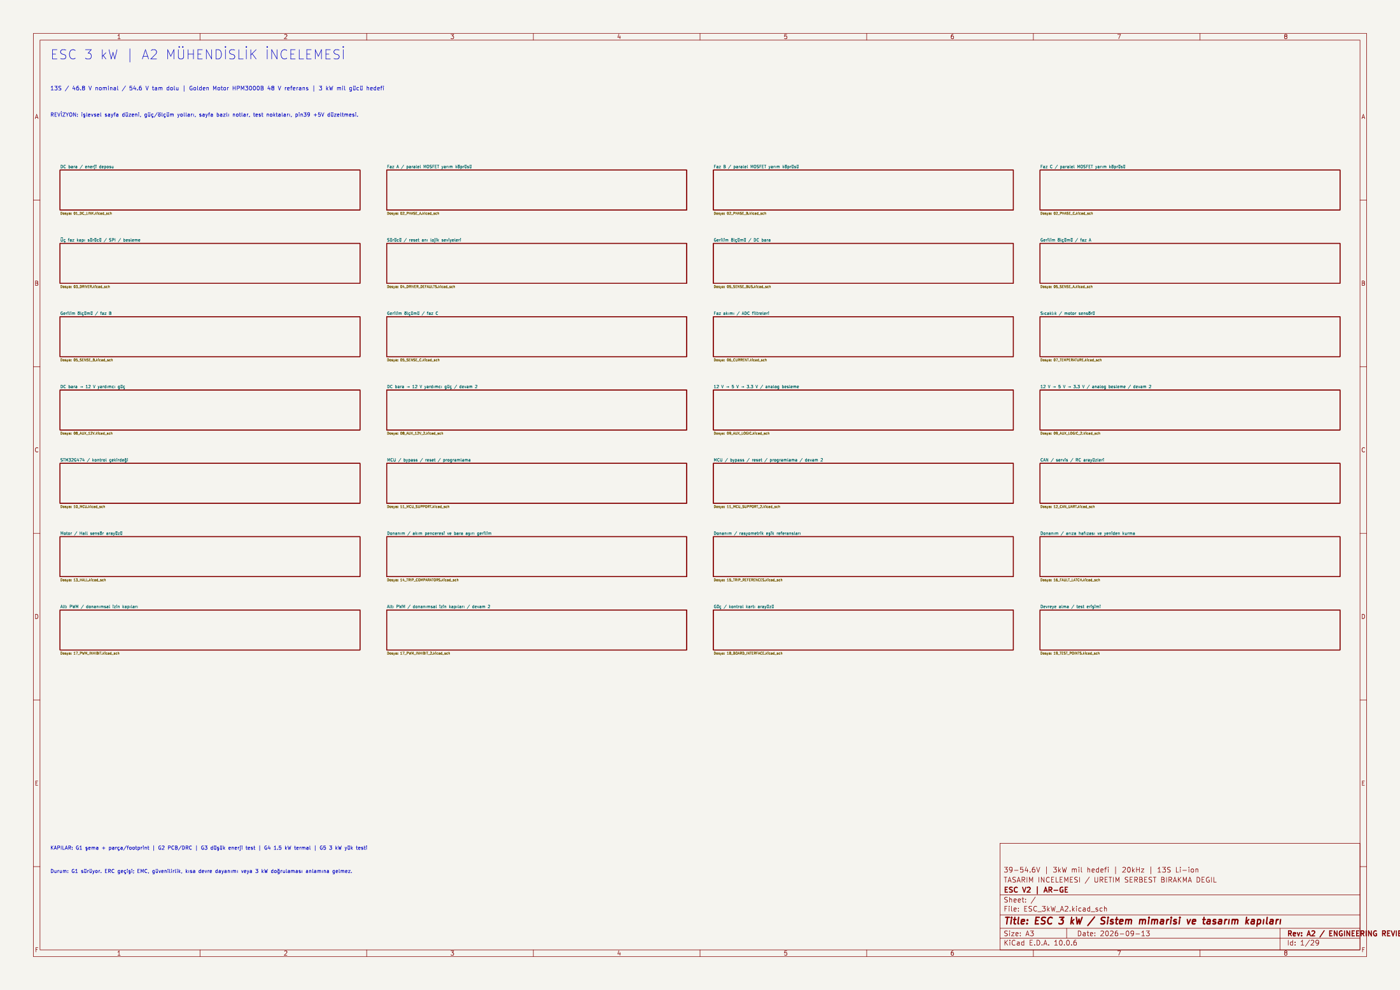
ESC_V2/verification/a2_preview_4.png
