mekiciepcas/ESC-Ai/ESC_V2/verification/mcu_preview.png

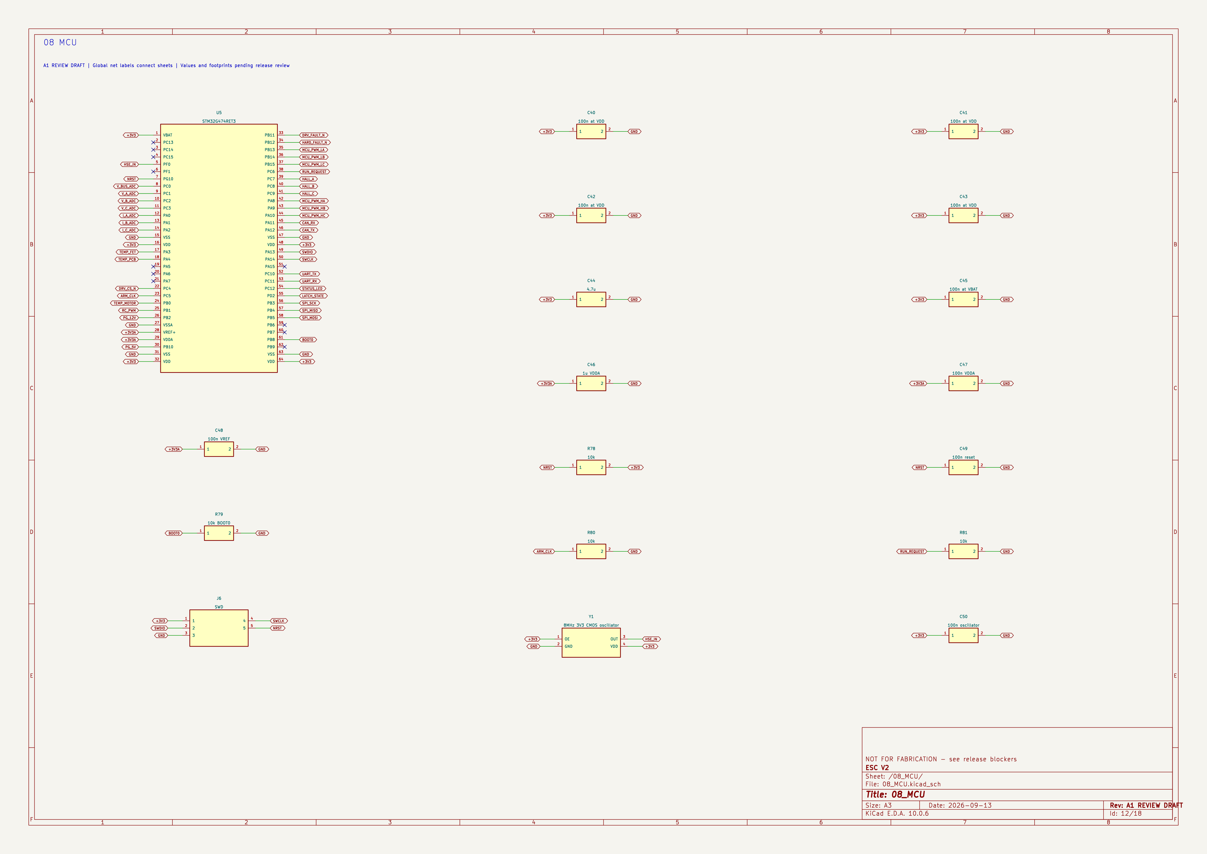
ESC_V2/verification/mcu_preview.png
