mekiciepcas/ESC-Ai/ESC_V2/verification/shunt_drawing-2.png

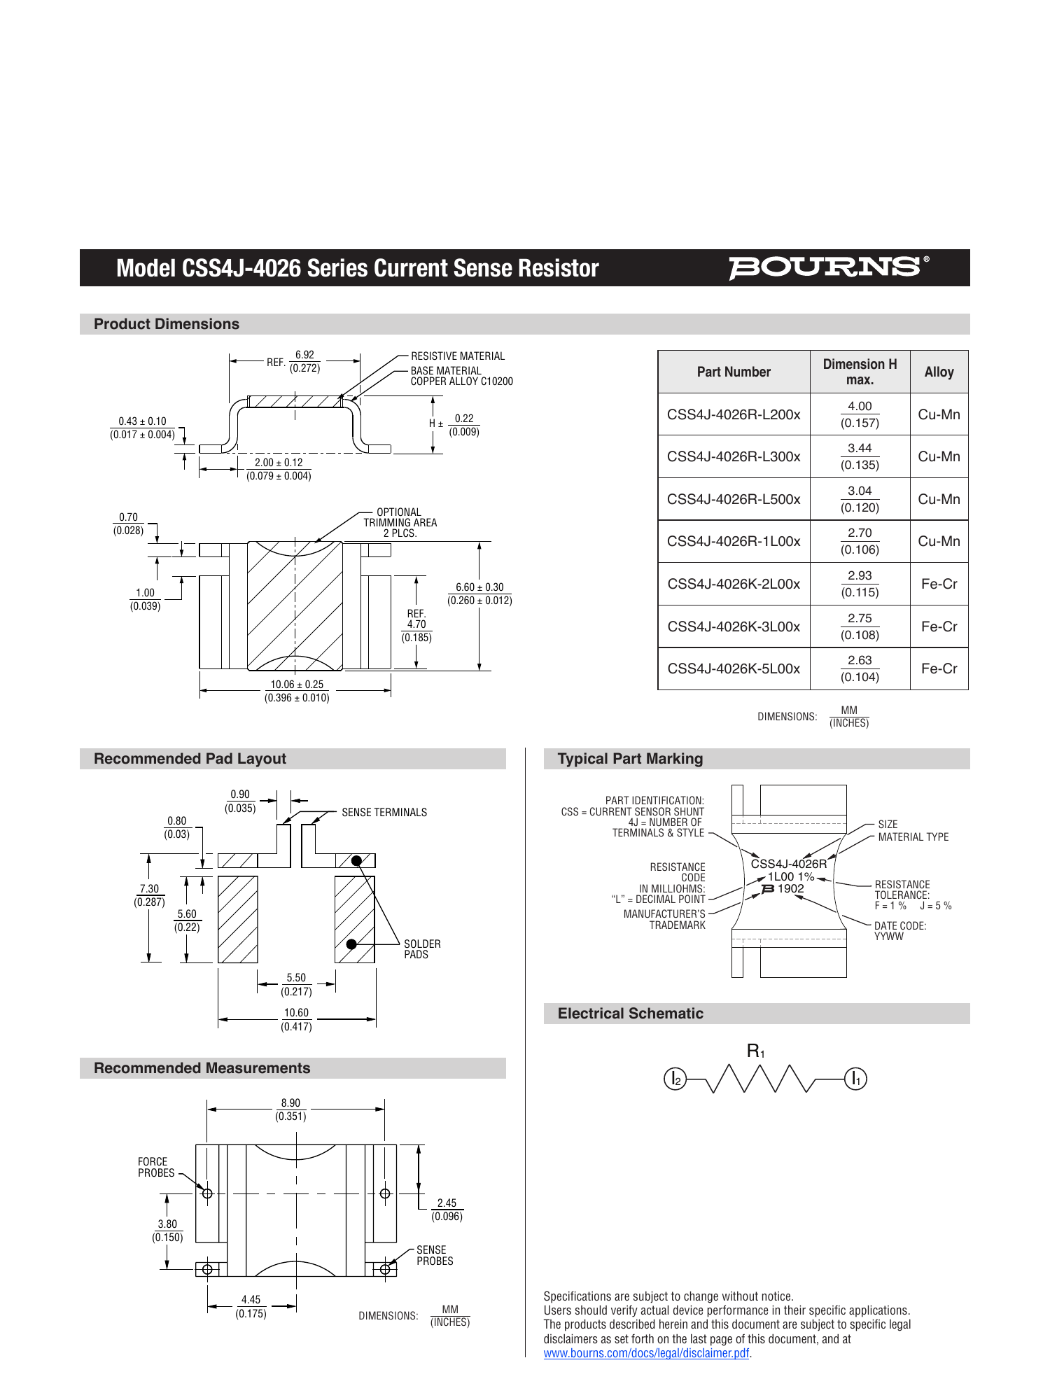
ESC_V2/verification/shunt_drawing-2.png
