mekiciepcas/ESC-Ai/ESC_V2/ESC_3kW_A2_semalar.pdf

1 | 2 | 3 | 4 | 5 | 6 | 7 | 8

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
Size: A3 | Rev: A2 REVIEW | F Date: 2026-09-13
KiCad E.D.A. 10.0.6 | Id: 1/29

# Title: ESC 3 kW / Sistem mimarisi ve tasarım kapıları

## File: ESC_3kW_A2.kicad_sch

## Sheet: /

## ESC V2 | AR-GE

## TASARIM INCELEMESI / URETIM SERBEST BIRAKMA DEGIL

## 39-54.6V | 3kW mil hedefi | 20kHz | 13S Li-ion

STM32G474 / kontrol çekirdeği Dosya: 10_MCU.kicad_sch | CAN / servis / RC arayüzleri Dosya: 12_CAN_UART.kicad_sch Donanım / arıza hafızası ve yeniden kurma

Dosya: 16_FAULT_LATCH.kicad_sch

DC bara / enerji deposu

Dosya: 01_DC_LINK.kicad_sch Üç faz kapı sürücü / SPI / besleme

Dosya: 03_DRIVER.kicad_sch | Faz B / paralel MOSFET yarım köprüsü
Dosya: 02_PHASE_B.kicad_sch | Faz C / paralel MOSFET yarım köprüsü

Dosya: 02_PHASE_C.kicad_sch Gerilim ölçümü / DC bara

Dosya: 05_SENSE_BUS.kicad_sch | Gerilim ölçümü / faz A

Dosya: 05_SENSE_A.kicad_sch Faz A / paralel MOSFET yarım köprüsü

Dosya: 02_PHASE_A.kicad_sch Sürücü / reset anı lojik seviyeleri Dosya: 04_DRIVER_DEFAULTS.kicad_sch Gerilim ölçümü / faz C

Dosya: 05_SENSE_C.kicad_sch DC bara → 12 V yardımcı güç / devam 2

Dosya: 08_AUX_12V_2.kicad_sch MCU / bypass / reset / programlama

Dosya: 11_MCU_SUPPORT.kicad_sch Gerilim ölçümü / faz B

Dosya: 05_SENSE_B.kicad_sch DC bara → 12 V yardımcı güç

Dosya: 08_AUX_12V.kicad_sch | Devreye alma / test erişimi Dosya: 19_TEST_POINTS.kicad_sch Motor / Hall sensör arayüzü

Dosya: 13_HALL.kicad_sch Altı PWM / donanımsal izin kapıları Dosya: 17_PWM_INHIBIT.kicad_sch

Faz akımı / ADC filtreleri Dosya: 06_CURRENT.kicad_sch 12 V → 5 V → 3.3 V / analog besleme

Dosya: 09_AUX_LOGIC.kicad_sch MCU / bypass / reset / programlama / devam 2

Dosya: 11_MCU_SUPPORT_2.kicad_sch Donanım / akım penceresi ve bara aşırı gerilim

Dosya: 14_TRIP_COMPARATORS.kicad_sch | Donanım / rasyometrik eşik referansları Dosya: 15_TRIP_REFERENCES.kicad_sch Altı PWM / donanımsal izin kapıları / devam 2
Dosya: 17_PWM_INHIBIT_2.kicad_sch | Güç / kontrol kartı arayüzü

Dosya: 18_BOARD_INTERFACE.kicad_sch

Sıcaklık / motor sensörü

Dosya: 07_TEMPERATURE.kicad_sch 12 V → 5 V → 3.3 V / analog besleme / devam 2

Dosya: 09_AUX_LOGIC_2.kicad_sch

13S / 46.8 V nominal / 54.6 V tam dolu | Golden Motor HPM3000B 48 V referans | 3 kW mil gücü hedefi REVİZYON: işlevsel sayfa düzeni, güç/ölçüm yolları, sayfa bazlı notlar, test noktaları, pin39 +5V düzeltmesi.
Durum: G1 sürüyor. ERC geçişi; EMC, güvenilirlik, kısa devre dayanımı veya 3 kW doğrulaması anlamına gelmez. KAPILAR: G1 şema + parça/footprint | G2 PCB/DRC | G3 düşük enerji test | G4 1.5 kW termal | G5 3 kW yük testi

# ESC 3 kW | A2 MÜHENDİSLİK İNCELEMESİ

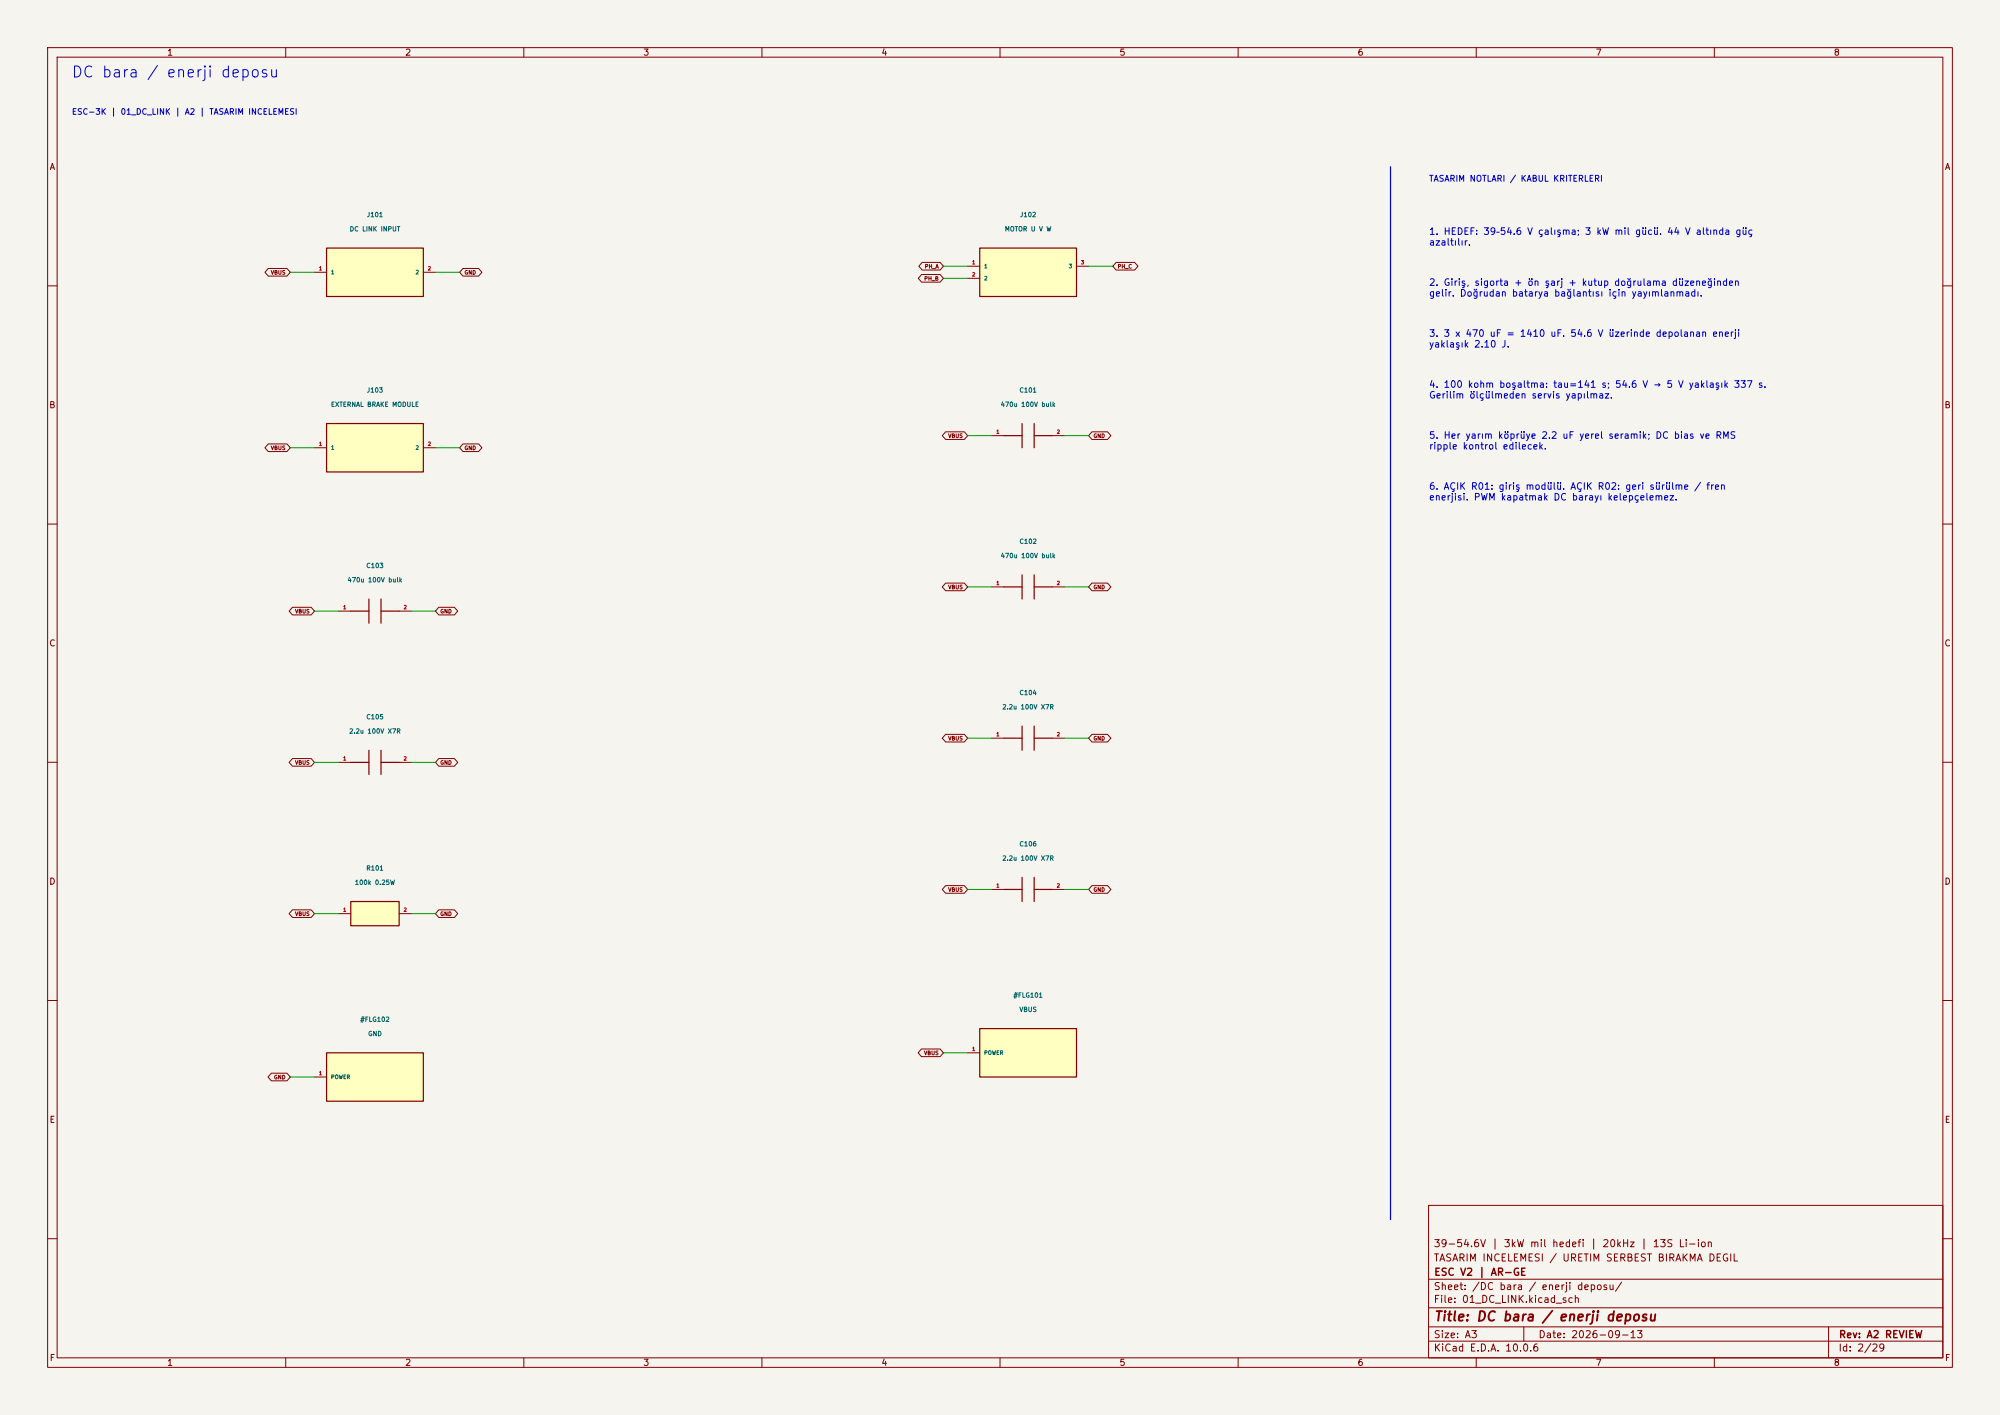
[picture p53: page 2]

ripple kontrol edilecek. DC bara / enerji deposu
2 J101 DC LINK INPUT 1

yaklaşık 2.10 J. 1. HEDEF: 39–54.6 V çalışma; 3 kW mil gücü. 44 V altında güç azaltılır. 4. 100 kohm boşaltma: tau=141 s; 54.6 V → 5 V yaklaşık 337 s. Gerilim ölçülmeden servis yapılmaz. 5. Her yarım köprüye 2.2 uF yerel seramik; DC bias ve RMS

gelir. Doğrudan batarya bağlantısı için yayımlanmadı. 6. AÇIK R01: giriş modülü. AÇIK R02: geri sürülme / fren

enerjisi. PWM kapatmak DC barayı kelepçelemez. 3. 3 x 470 uF = 1410 uF. 54.6 V üzerinde depolanan enerji

39-54.6V | 3kW mil hedefi | 20kHz | 13S Li-ion
TASARIM INCELEMESI / URETIM SERBEST BIRAKMA DEGIL
ESC V2 | AR-GE
Sheet: /DC bara / enerji deposu/
File: 01_DC_LINK.kicad_sch
Title: DC bara / enerji deposu

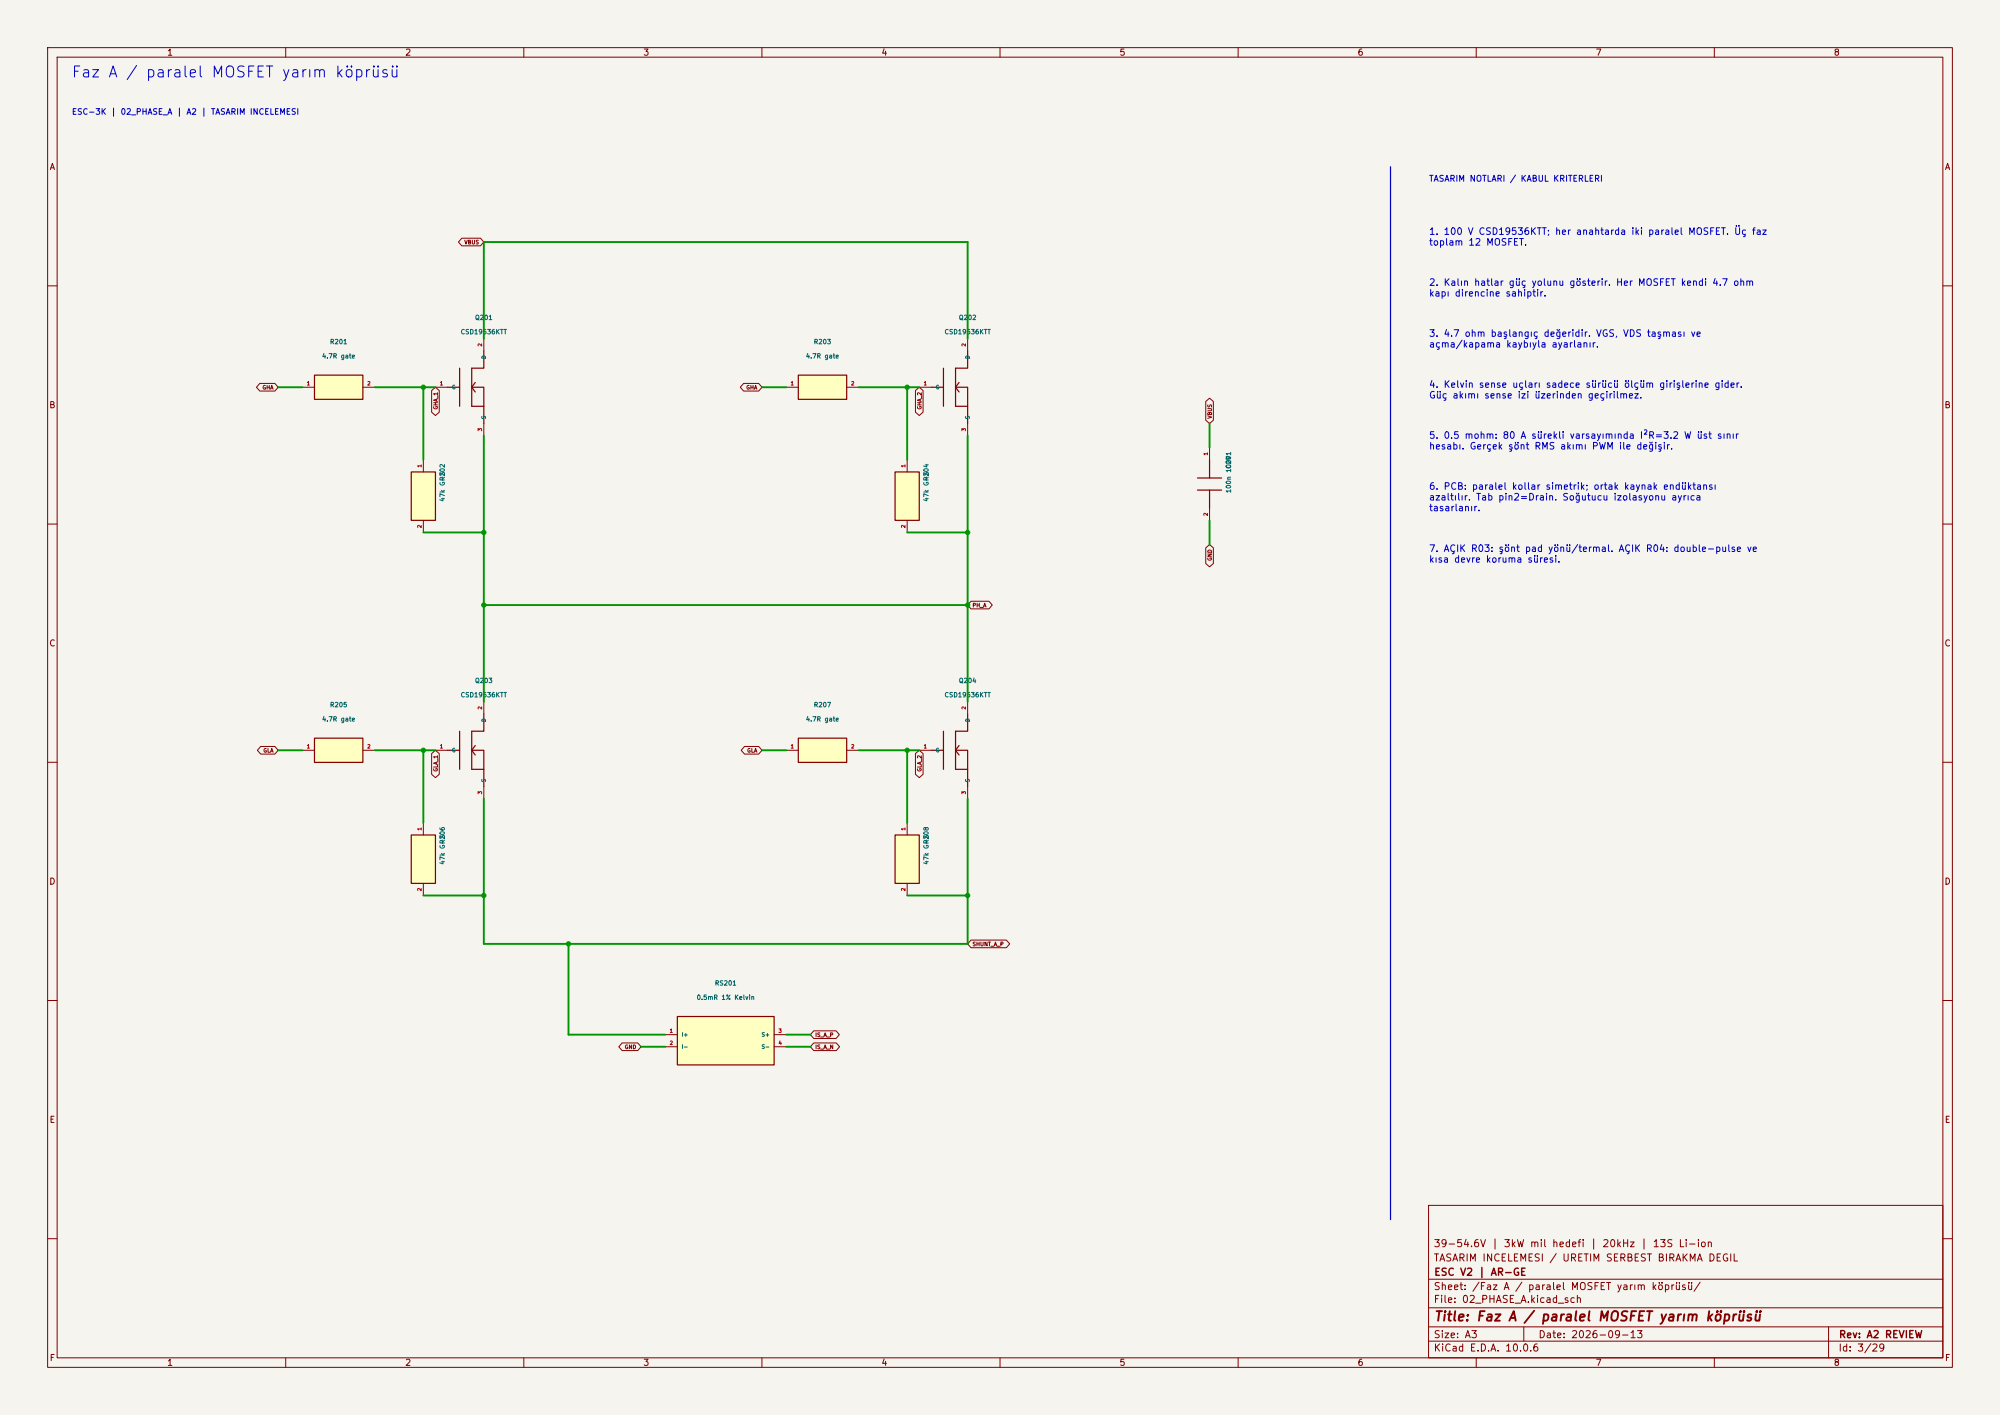
[picture p54: page 3]

toplam 12 MOSFET. Faz A / paralel MOSFET yarım köprüsü

TASARIM NOTLARI / KABUL KRITERLERI 1. 100 V CSD19536KTT; her anahtarda iki paralel MOSFET. Üç faz

kapı direncine sahiptir. 6. PCB: paralel kollar simetrik; ortak kaynak endüktansı azaltılır. Tab pin2=Drain. Soğutucu izolasyonu ayrıca

kısa devre koruma süresi. 4. Kelvin sense uçları sadece sürücü ölçüm girişlerine gider.
Güç akımı sense izi üzerinden geçirilmez.

39-54.6V | 3kW mil hedefi | 20kHz | 13S Li-ion
TASARIM INCELEMESI / URETIM SERBEST BIRAKMA DEGIL
ESC V2 | AR-GE
Sheet: /Faz A / paralel MOSFET yarım köprüsü/
File: 02_PHASE_A.kicad_sch
Title: Faz A / paralel MOSFET yarım köprüsü

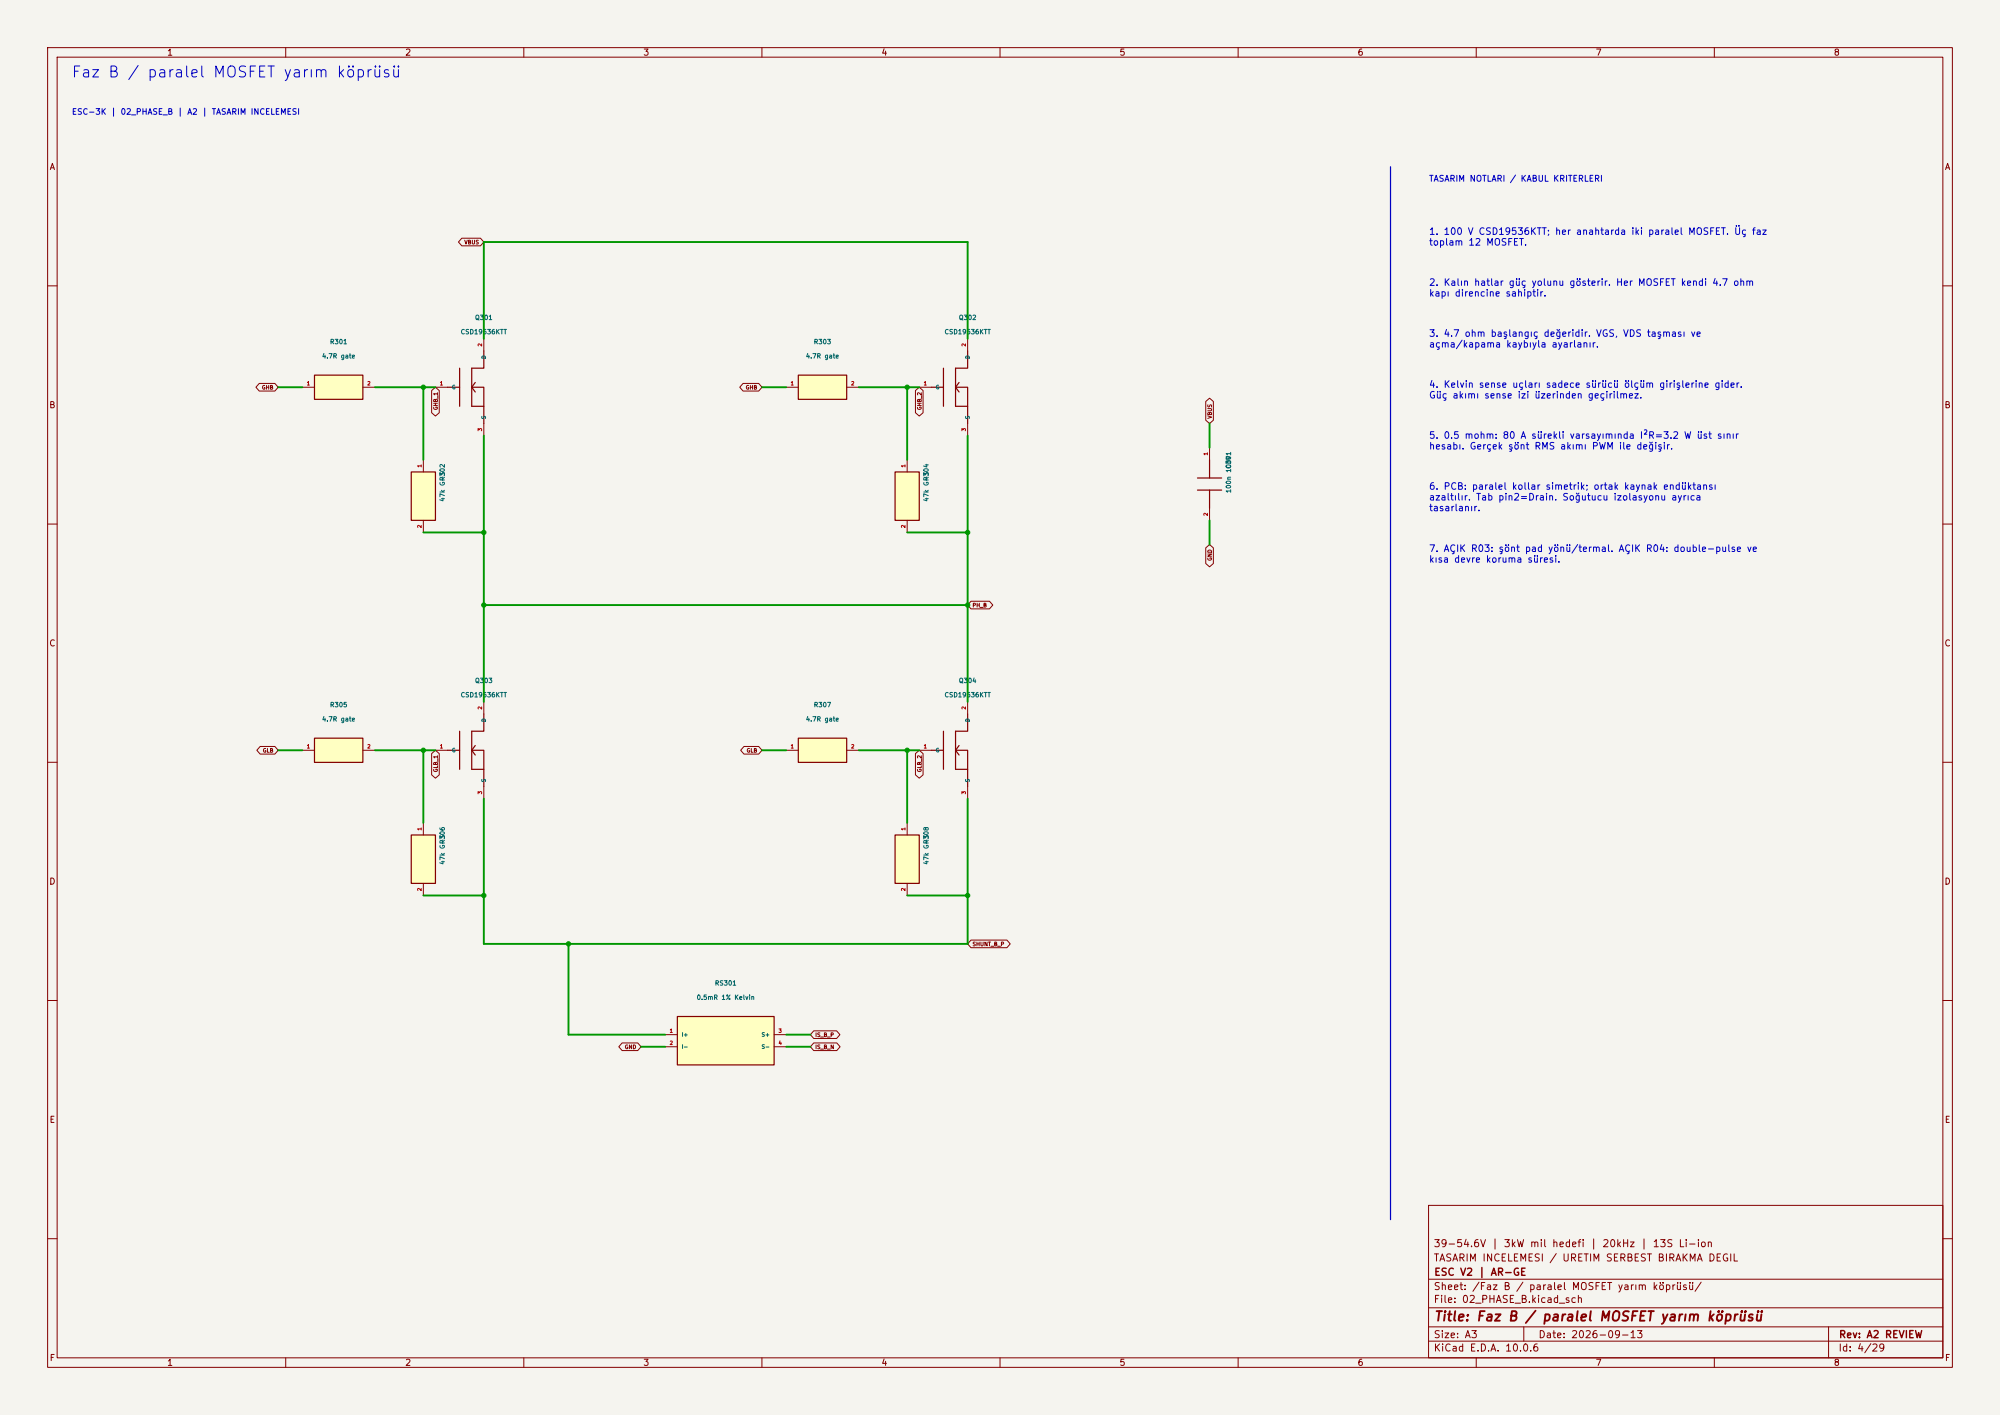
[picture p55: page 4]

toplam 12 MOSFET. Faz B / paralel MOSFET yarım köprüsü

TASARIM NOTLARI / KABUL KRITERLERI 1. 100 V CSD19536KTT; her anahtarda iki paralel MOSFET. Üç faz

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

39-54.6V | 3kW mil hedefi | 20kHz | 13S Li-ion
TASARIM INCELEMESI / URETIM SERBEST BIRAKMA DEGIL
ESC V2 | AR-GE
Sheet: /Faz B / paralel MOSFET yarım köprüsü/
File: 02_PHASE_B.kicad_sch
Title: Faz B / paralel MOSFET yarım köprüsü

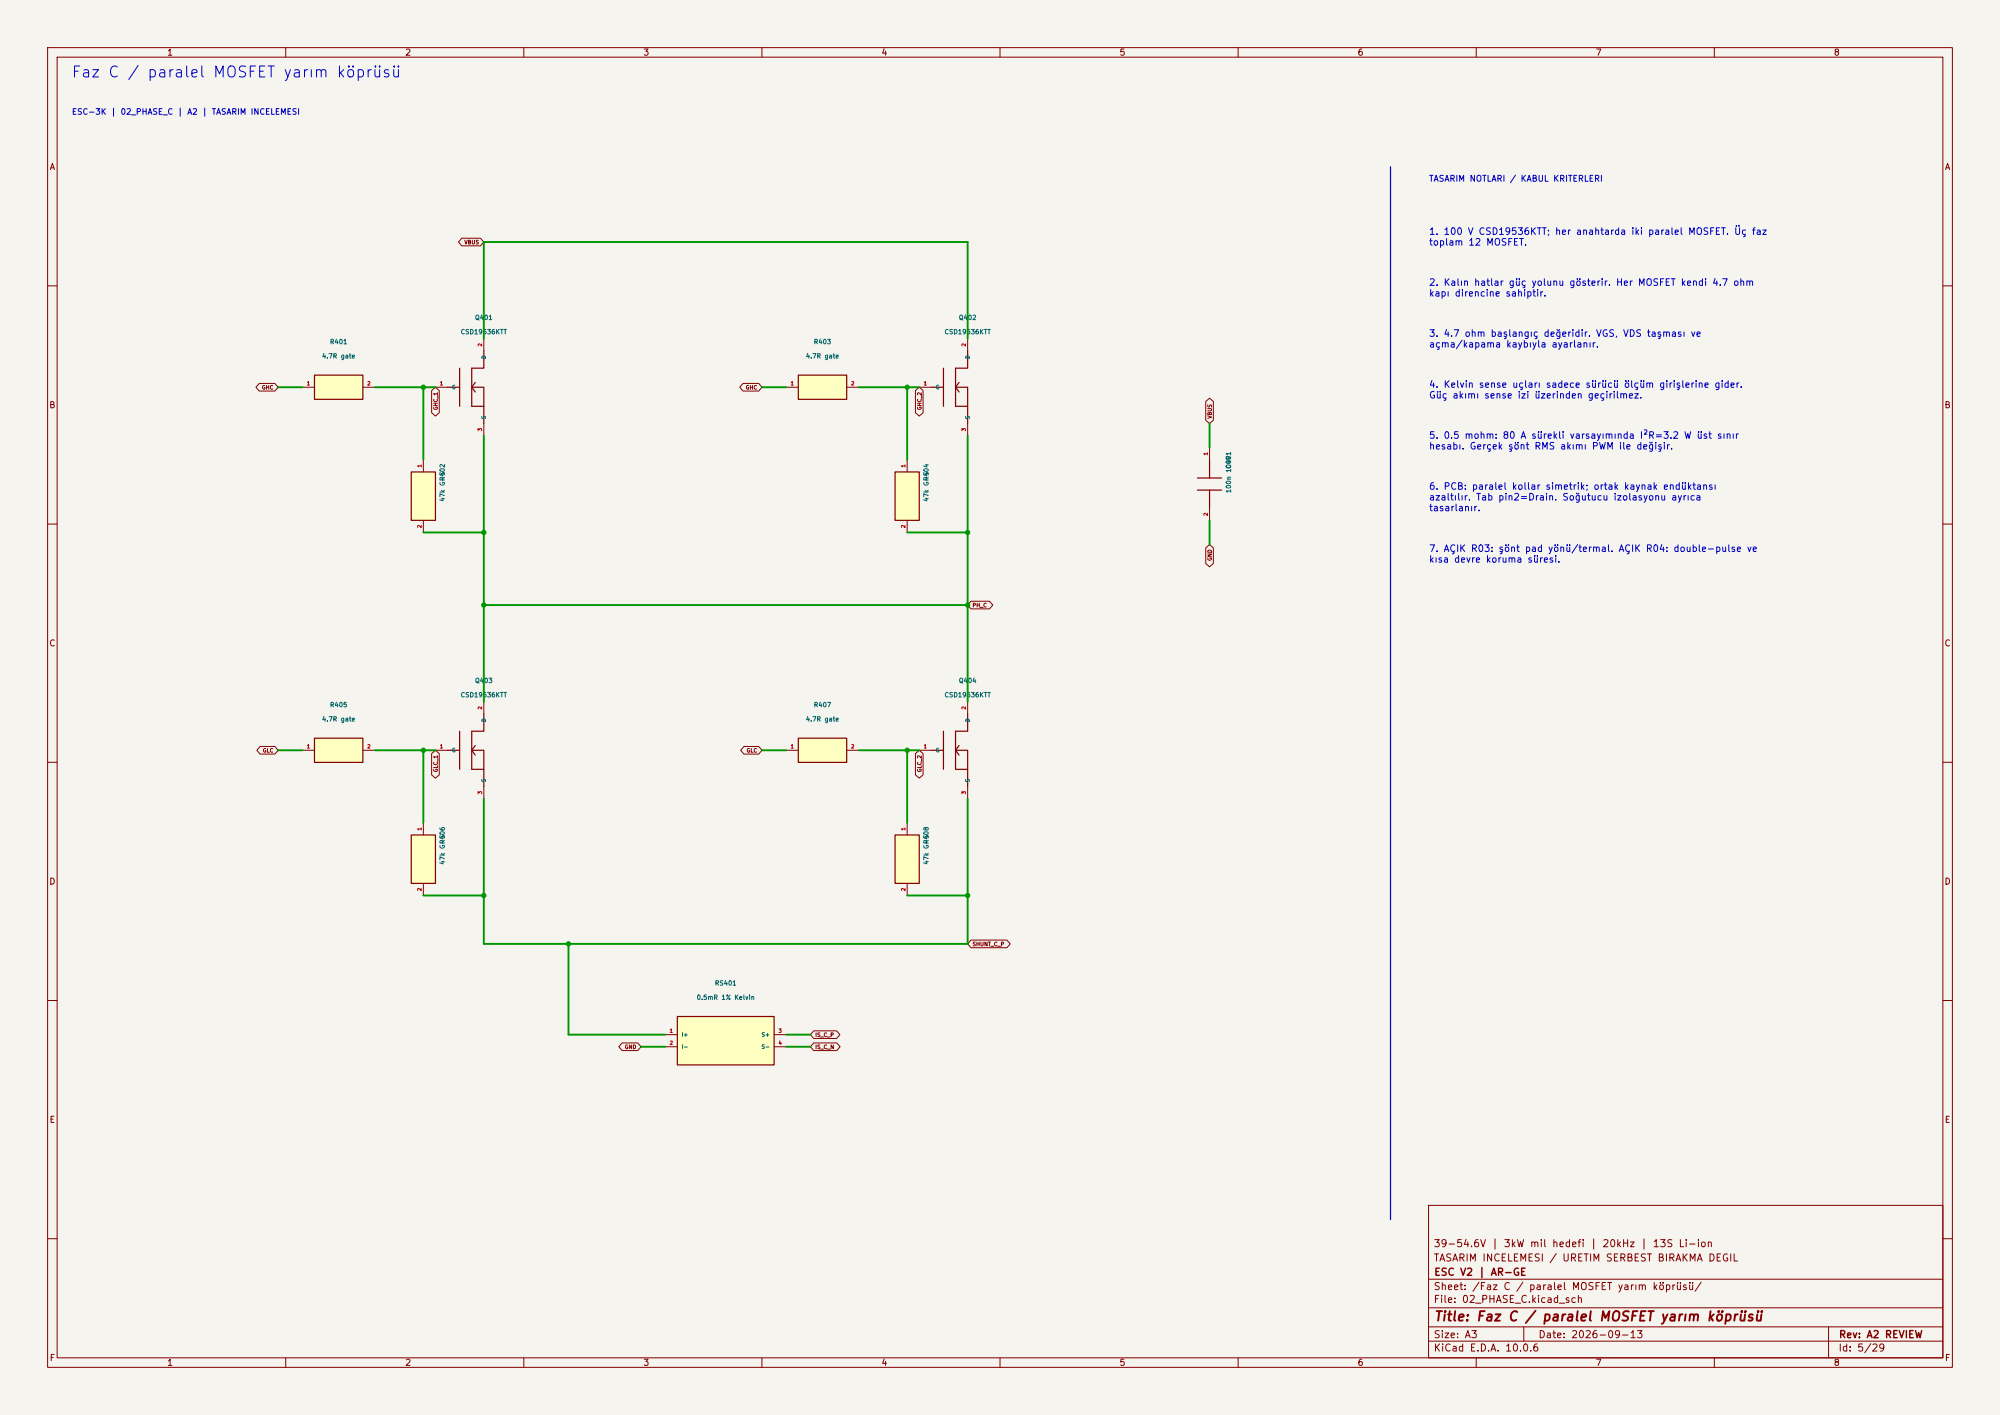
[picture p56: page 5]

toplam 12 MOSFET. Faz C / paralel MOSFET yarım köprüsü

TASARIM NOTLARI / KABUL KRITERLERI 1. 100 V CSD19536KTT; her anahtarda iki paralel MOSFET. Üç faz

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

39-54.6V | 3kW mil hedefi | 20kHz | 13S Li-ion
TASARIM INCELEMESI / URETIM SERBEST BIRAKMA DEGIL
ESC V2 | AR-GE
Sheet: /Faz C / paralel MOSFET yarım köprüsü/
File: 02_PHASE_C.kicad_sch
Title: Faz C / paralel MOSFET yarım köprüsü

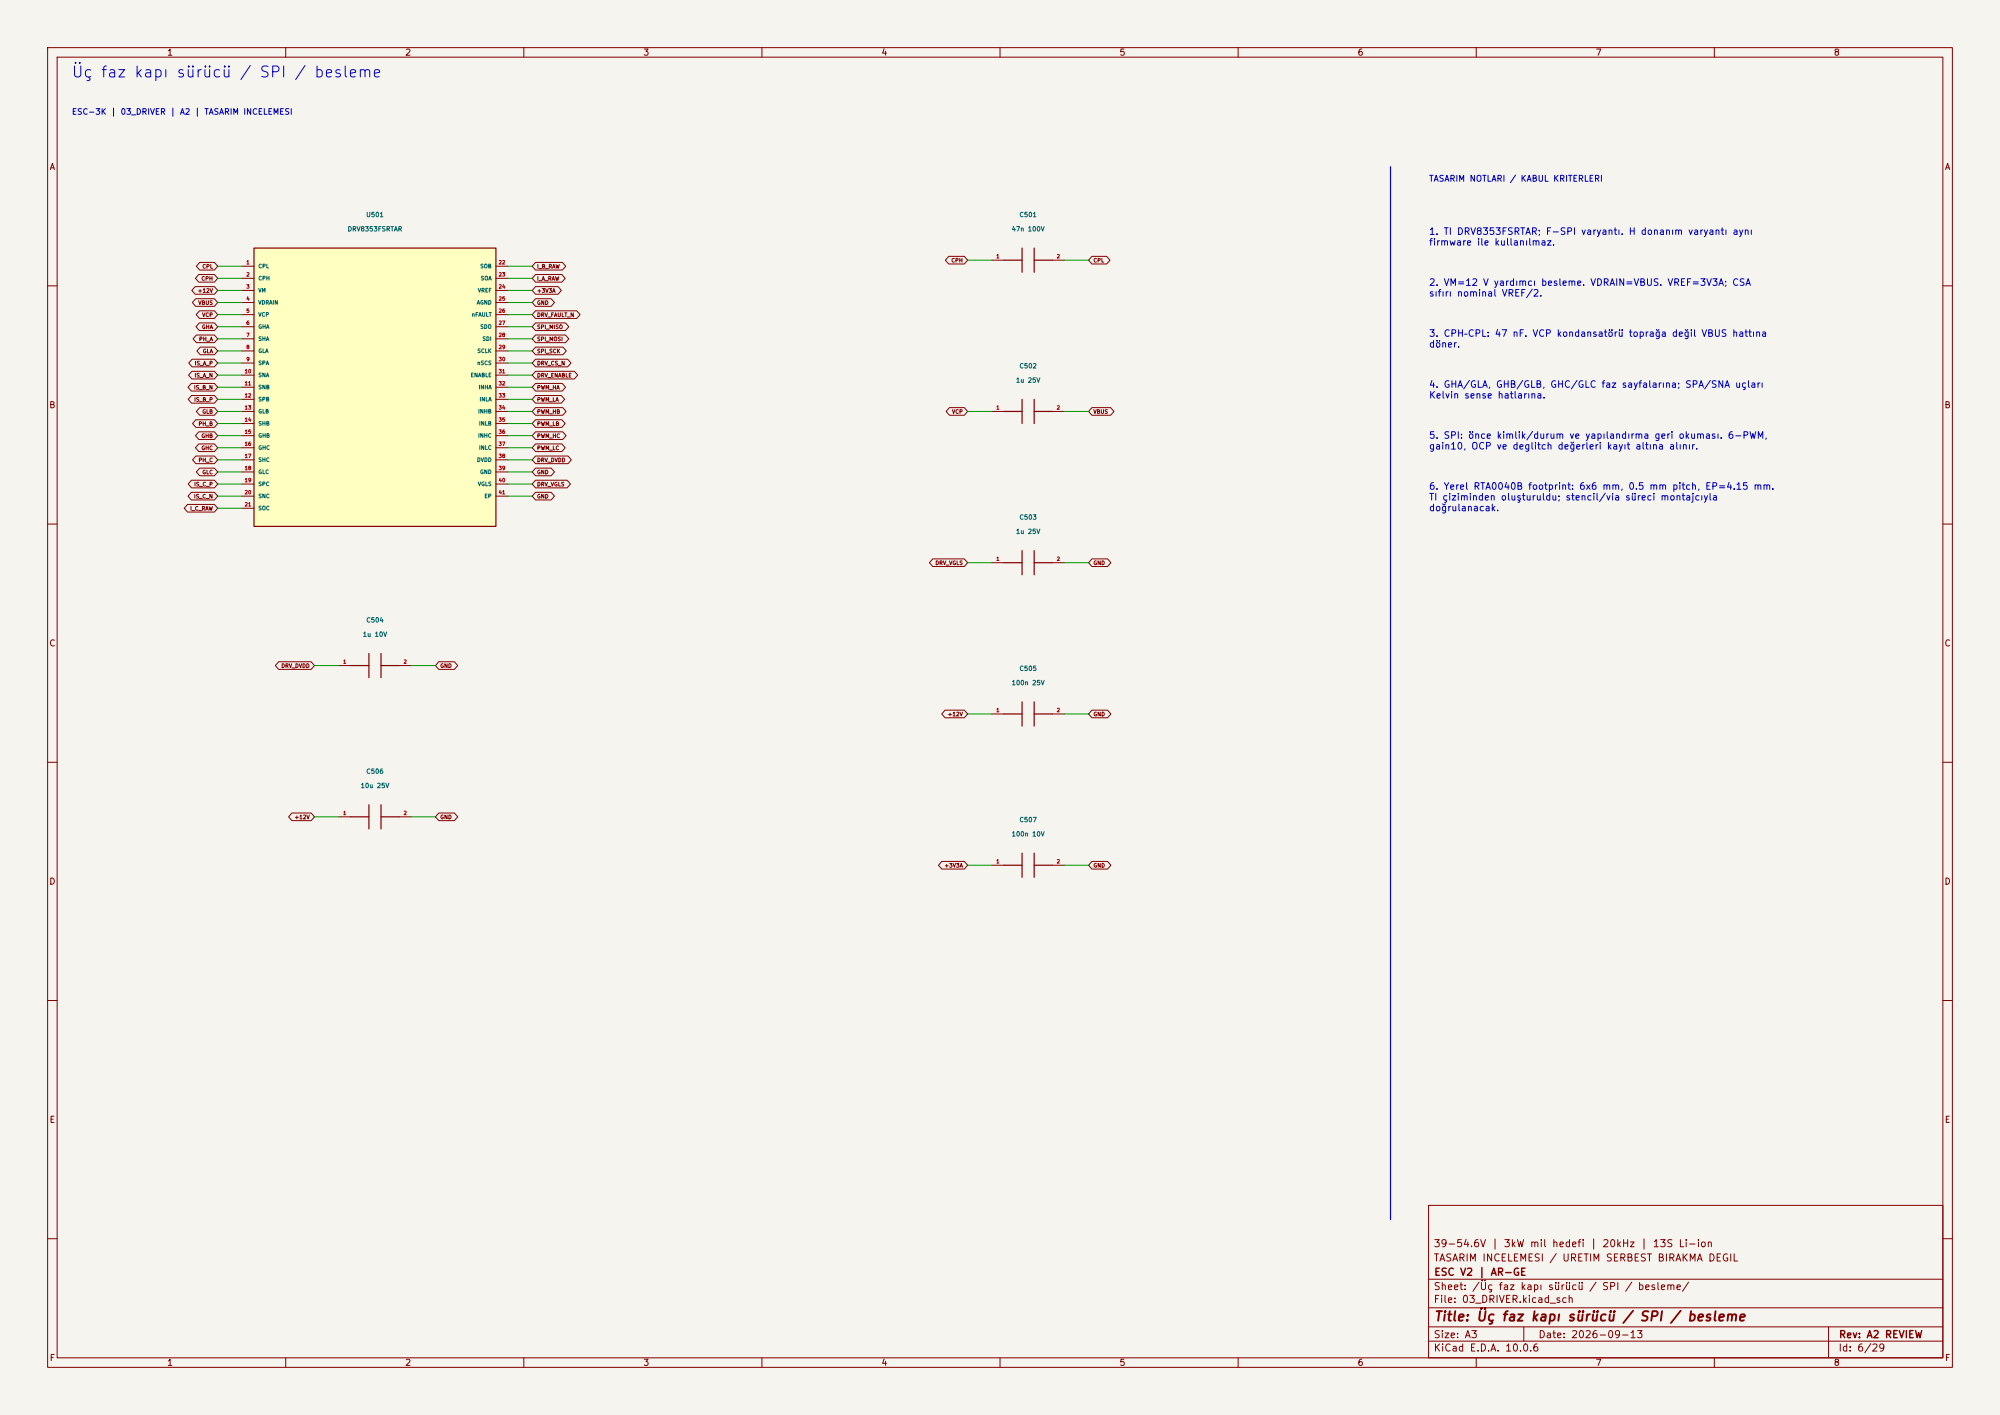
[picture p57: page 6]

TASARIM NOTLARI / KABUL KRITERLERI 1. TI DRV8353FSRTAR; F-SPI varyantı. H donanım varyantı aynı firmware ile kullanılmaz. Üç faz kapı sürücü / SPI / besleme

sıfırı nominal VREF/2. 3. CPH–CPL: 47 nF. VCP kondansatörü toprağa değil VBUS hattına

döner. 4. GHA/GLA, GHB/GLB, GHC/GLC faz sayfalarına; SPA/SNA uçları Kelvin sense hatlarına. 5. SPI: önce kimlik/durum ve yapılandırma geri okuması. 6-PWM,

gain10, OCP ve deglitch değerleri kayıt altına alınır. 6. Yerel RTA0040B footprint: 6x6 mm, 0.5 mm pitch, EP=4.15 mm. TI çiziminden oluşturuldu; stencil/via süreci montajcıyla

39-54.6V | 3kW mil hedefi | 20kHz | 13S Li-ion
TASARIM INCELEMESI / URETIM SERBEST BIRAKMA DEGIL
ESC V2 | AR-GE
Sheet: /Üç faz kapı sürücü / SPI / besleme/
File: 03_DRIVER.kicad_sch
Title: Üç faz kapı sürücü / SPI / besleme

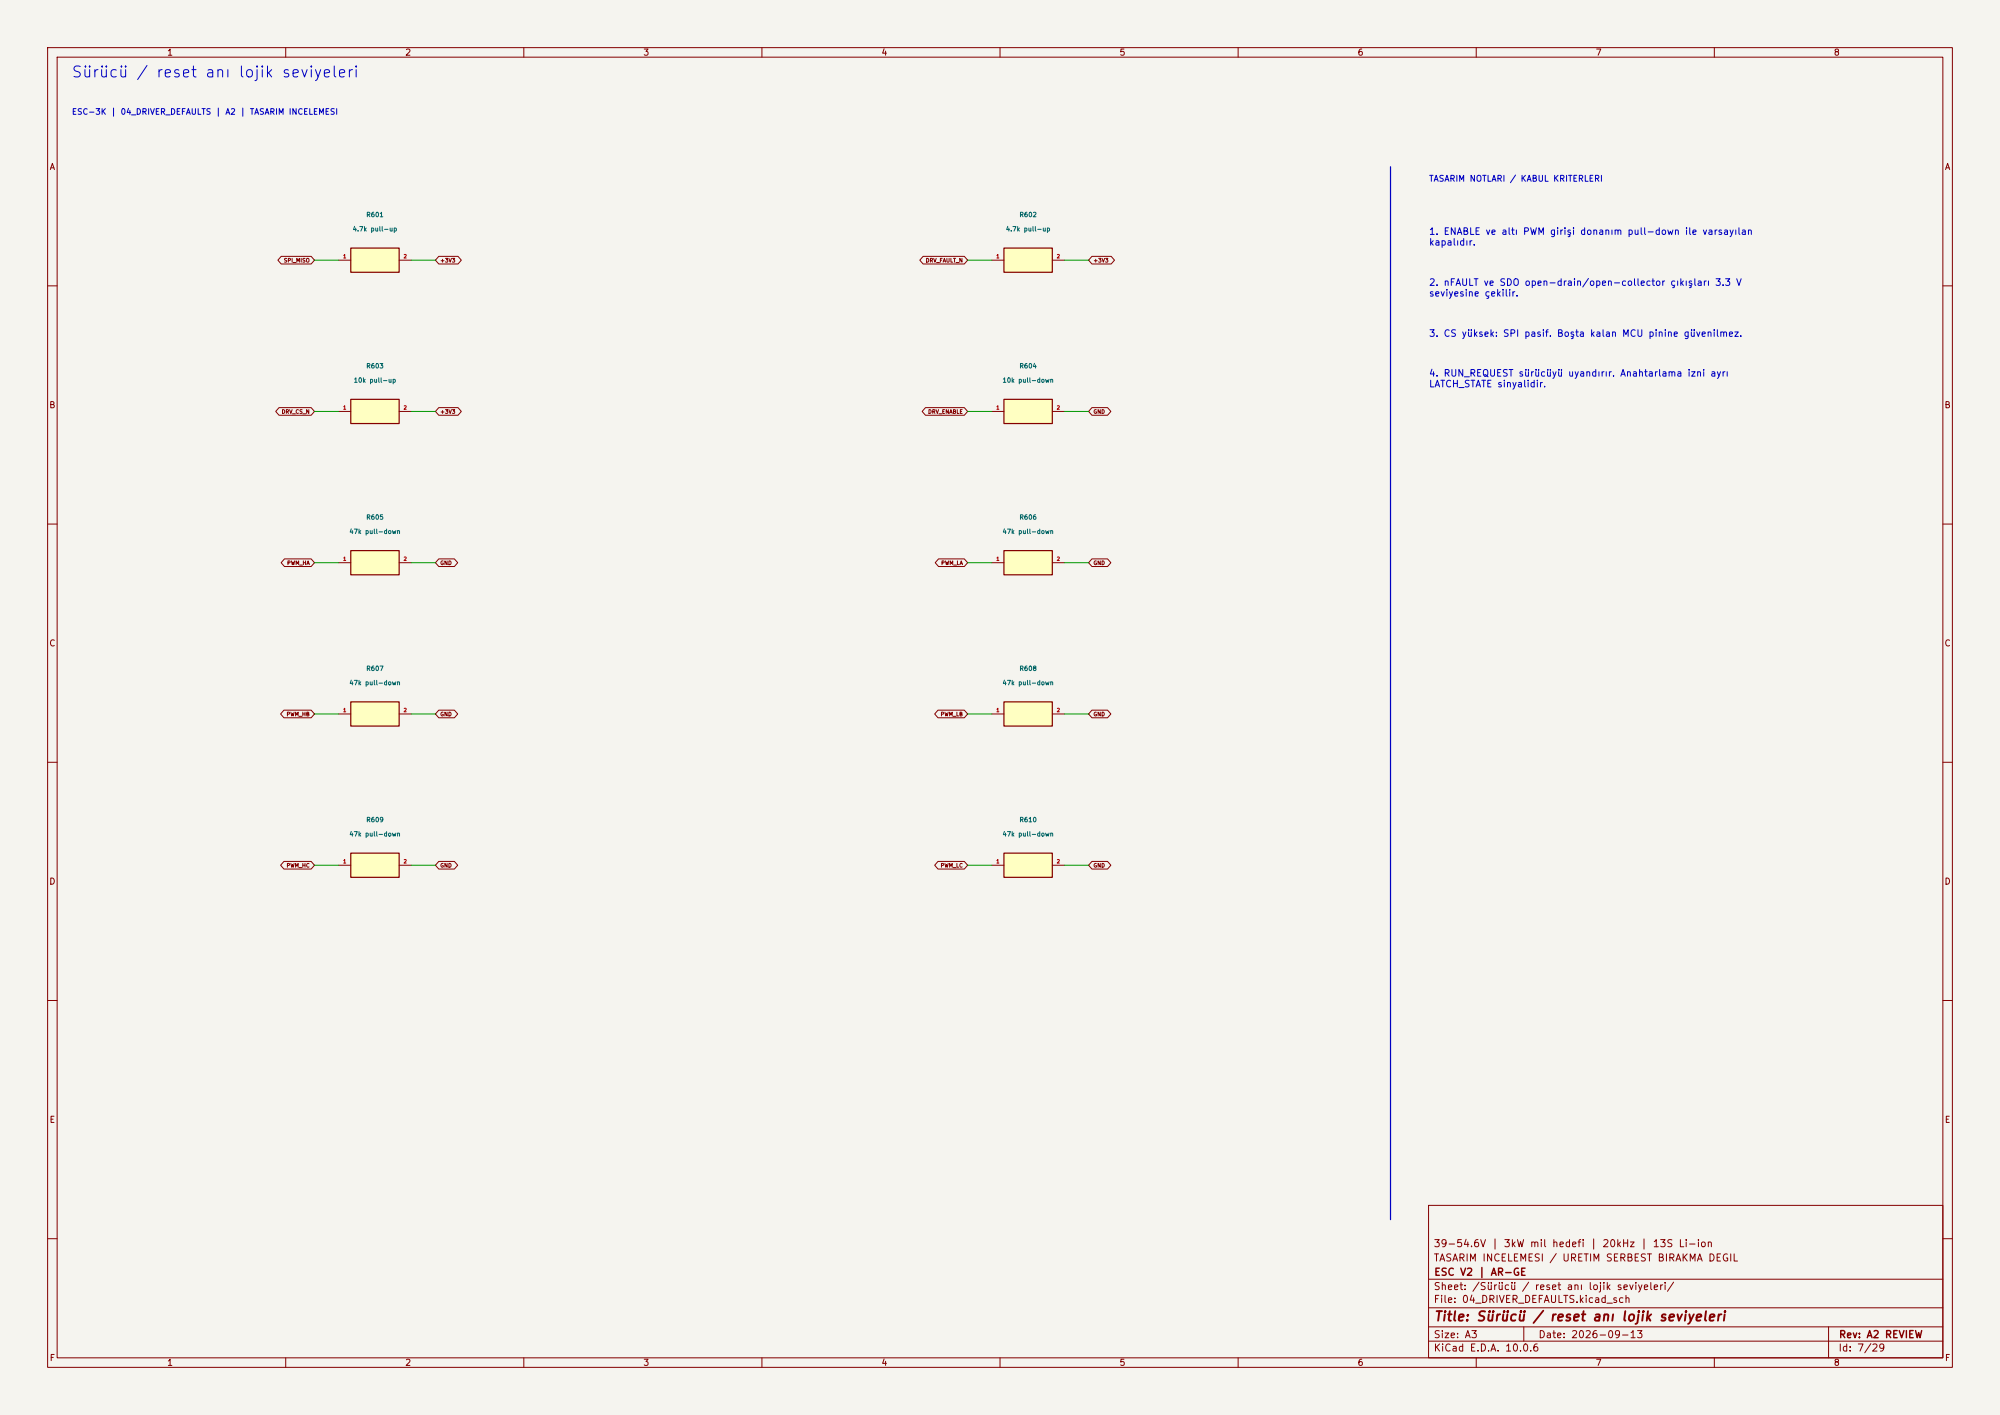
[picture p58: page 7]

DRV_FAULT_N ESC-3K | 04_DRIVER_DEFAULTS | A2 | TASARIM INCELEMESI Sürücü / reset anı lojik seviyeleri

TASARIM NOTLARI / KABUL KRITERLERI 2. nFAULT ve SDO open-drain/open-collector çıkışları 3.3 V

4. RUN_REQUEST sürücüyü uyandırır. Anahtarlama izni ayrı LATCH_STATE sinyalidir. 1. ENABLE ve altı PWM girişi donanım pull-down ile varsayılan
kapalıdır. 3. CS yüksek: SPI pasif. Boşta kalan MCU pinine güvenilmez.

39-54.6V | 3kW mil hedefi | 20kHz | 13S Li-ion
TASARIM INCELEMESI / URETIM SERBEST BIRAKMA DEGIL
ESC V2 | AR-GE
Sheet: /Sürücü / reset anı lojik seviyeleri/
File: 04_DRIVER_DEFAULTS.kicad_sch
Title: Sürücü / reset anı lojik seviyeleri

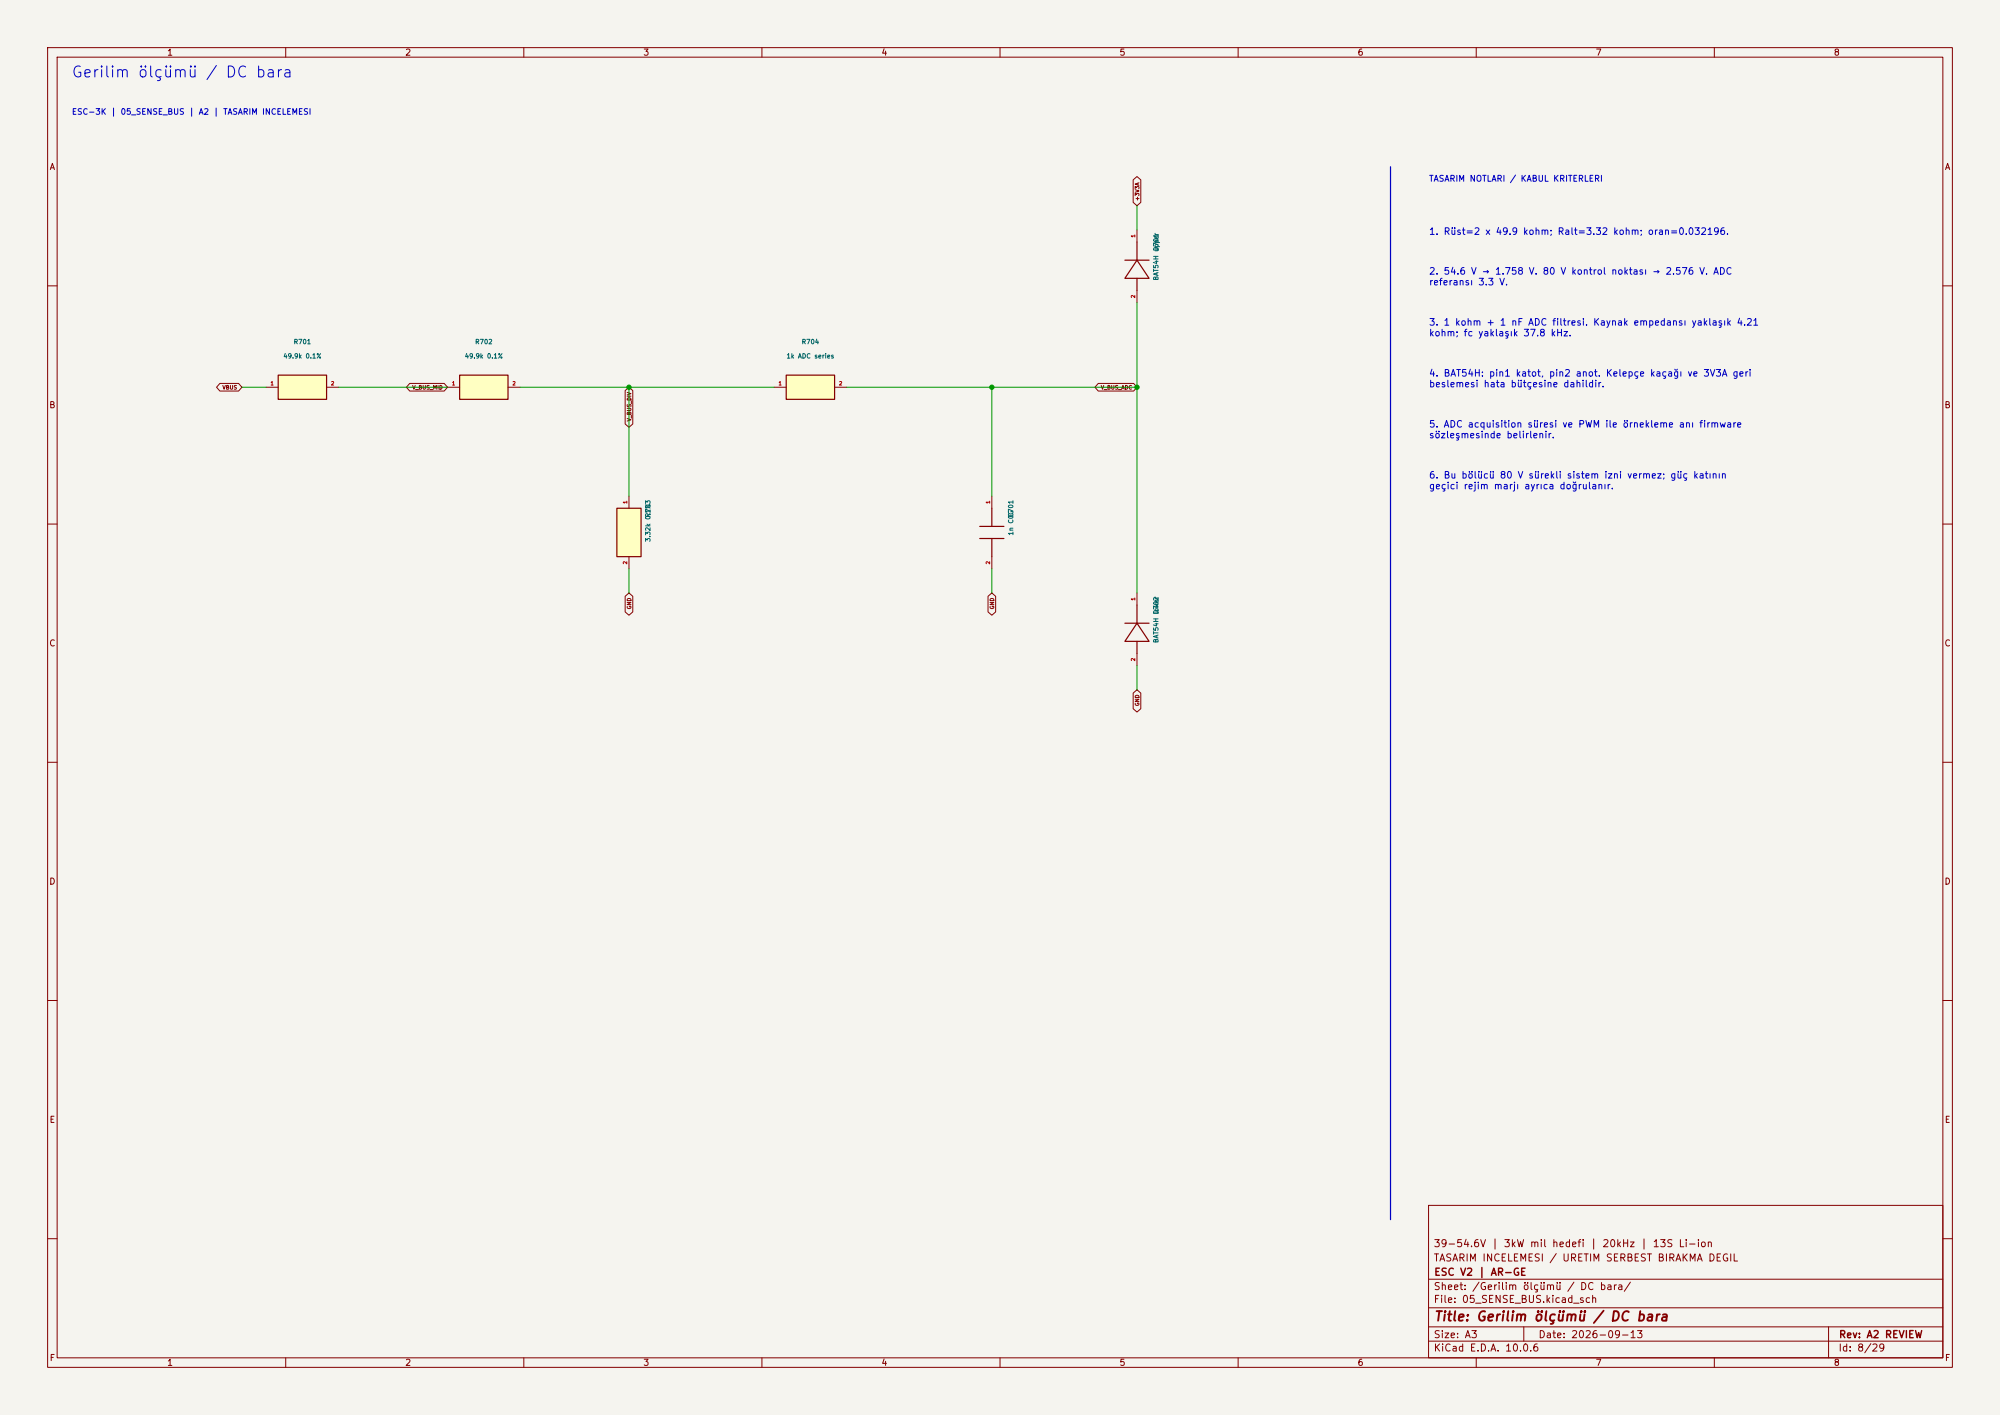
[picture p59: page 8]

sözleşmesinde belirlenir. 4. BAT54H: pin1 katot, pin2 anot. Kelepçe kaçağı ve 3V3A geri beslemesi hata bütçesine dahildir. Gerilim ölçümü / DC bara

geçici rejim marjı ayrıca doğrulanır. 1. Rüst=2 x 49.9 kohm; Ralt=3.32 kohm; oran=0.032196. 3. 1 kohm + 1 nF ADC filtresi. Kaynak empedansı yaklaşık 4.21

kohm; fc yaklaşık 37.8 kHz. 2. 54.6 V → 1.758 V. 80 V kontrol noktası → 2.576 V. ADC

39-54.6V | 3kW mil hedefi | 20kHz | 13S Li-ion
TASARIM INCELEMESI / URETIM SERBEST BIRAKMA DEGIL
ESC V2 | AR-GE
Sheet: /Gerilim ölçümü / DC bara/
File: 05_SENSE_BUS.kicad_sch
Title: Gerilim ölçümü / DC bara

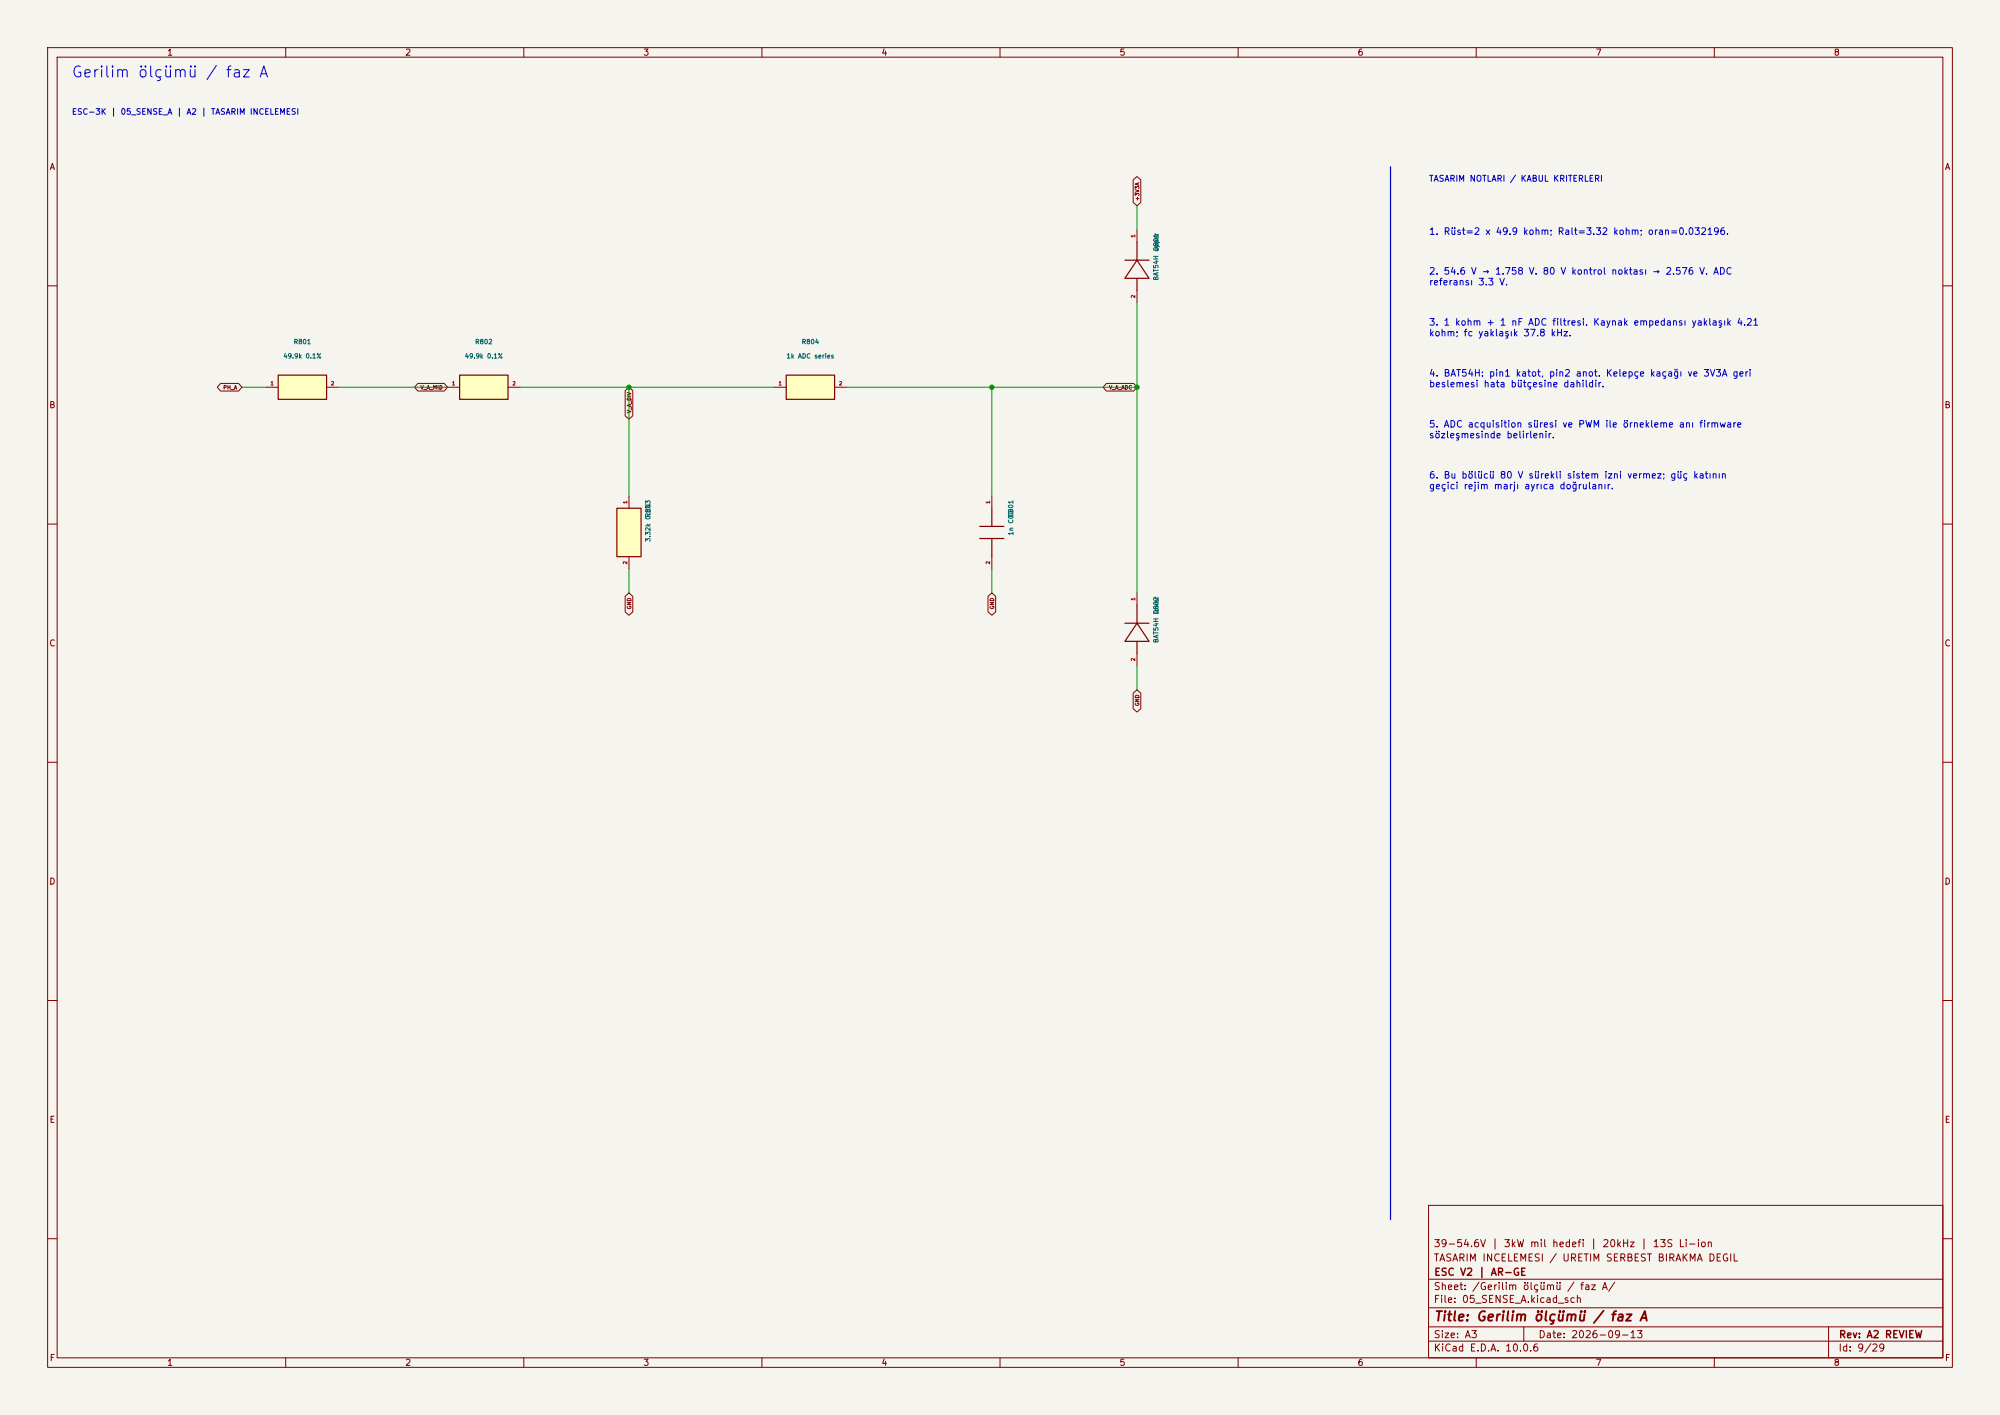
[picture p60: page 9]

sözleşmesinde belirlenir. 4. BAT54H: pin1 katot, pin2 anot. Kelepçe kaçağı ve 3V3A geri beslemesi hata bütçesine dahildir. Gerilim ölçümü / faz A

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

39-54.6V | 3kW mil hedefi | 20kHz | 13S Li-ion
TASARIM INCELEMESI / URETIM SERBEST BIRAKMA DEGIL
ESC V2 | AR-GE
Sheet: /Gerilim ölçümü / faz A/
File: 05_SENSE_A.kicad_sch
Title: Gerilim ölçümü / faz A

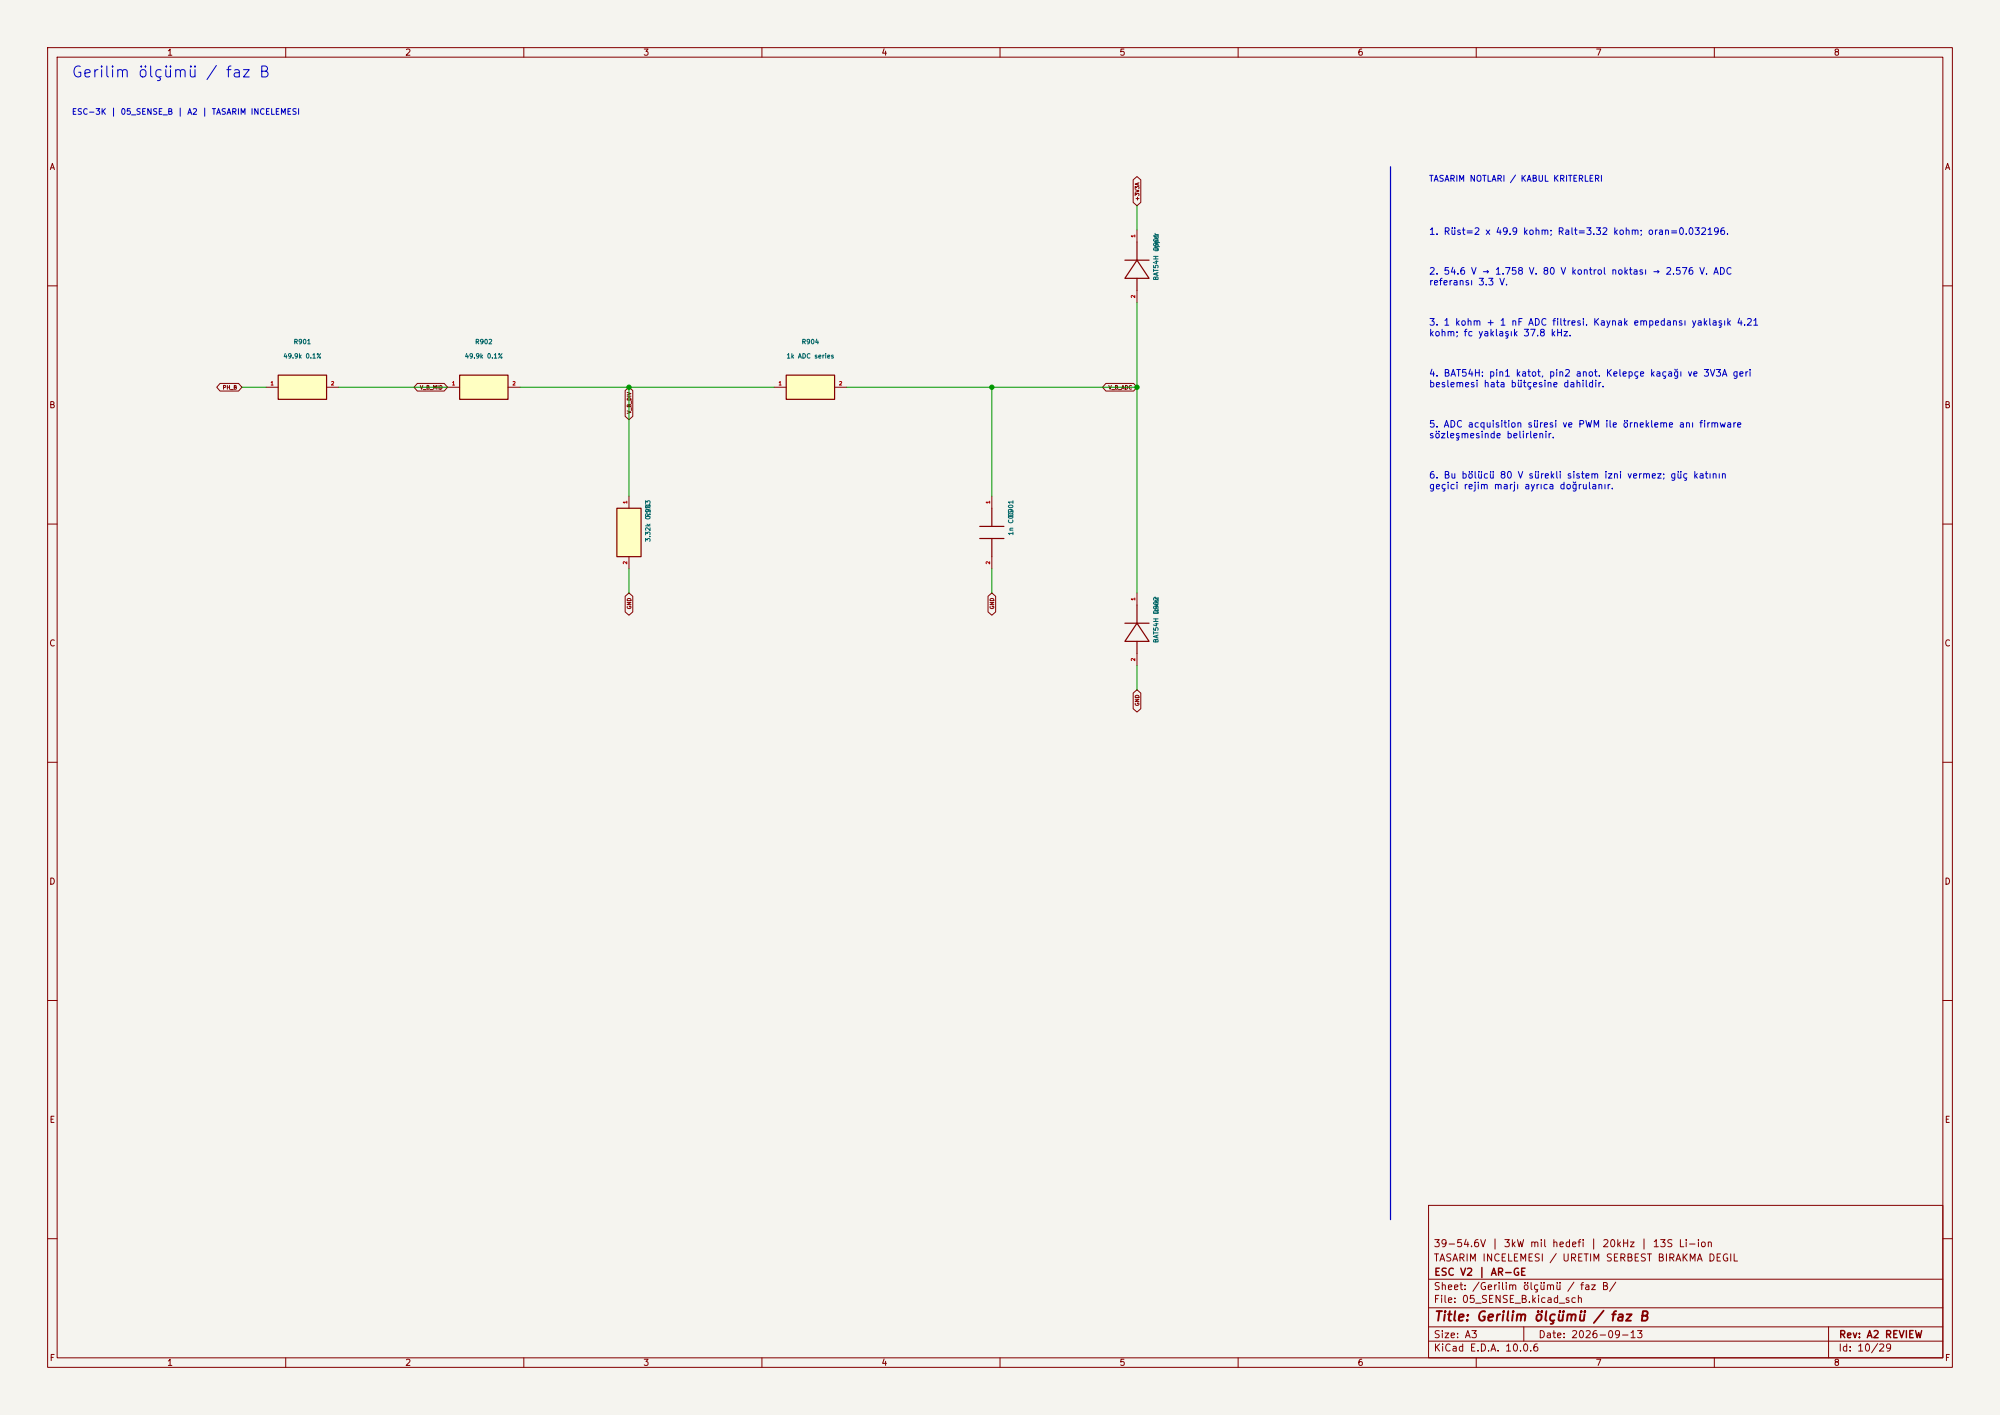
[picture p61: page 10]

sözleşmesinde belirlenir. 4. BAT54H: pin1 katot, pin2 anot. Kelepçe kaçağı ve 3V3A geri beslemesi hata bütçesine dahildir. Gerilim ölçümü / faz B

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

39-54.6V | 3kW mil hedefi | 20kHz | 13S Li-ion
TASARIM INCELEMESI / URETIM SERBEST BIRAKMA DEGIL
ESC V2 | AR-GE
Sheet: /Gerilim ölçümü / faz B/
File: 05_SENSE_B.kicad_sch
Title: Gerilim ölçümü / faz B

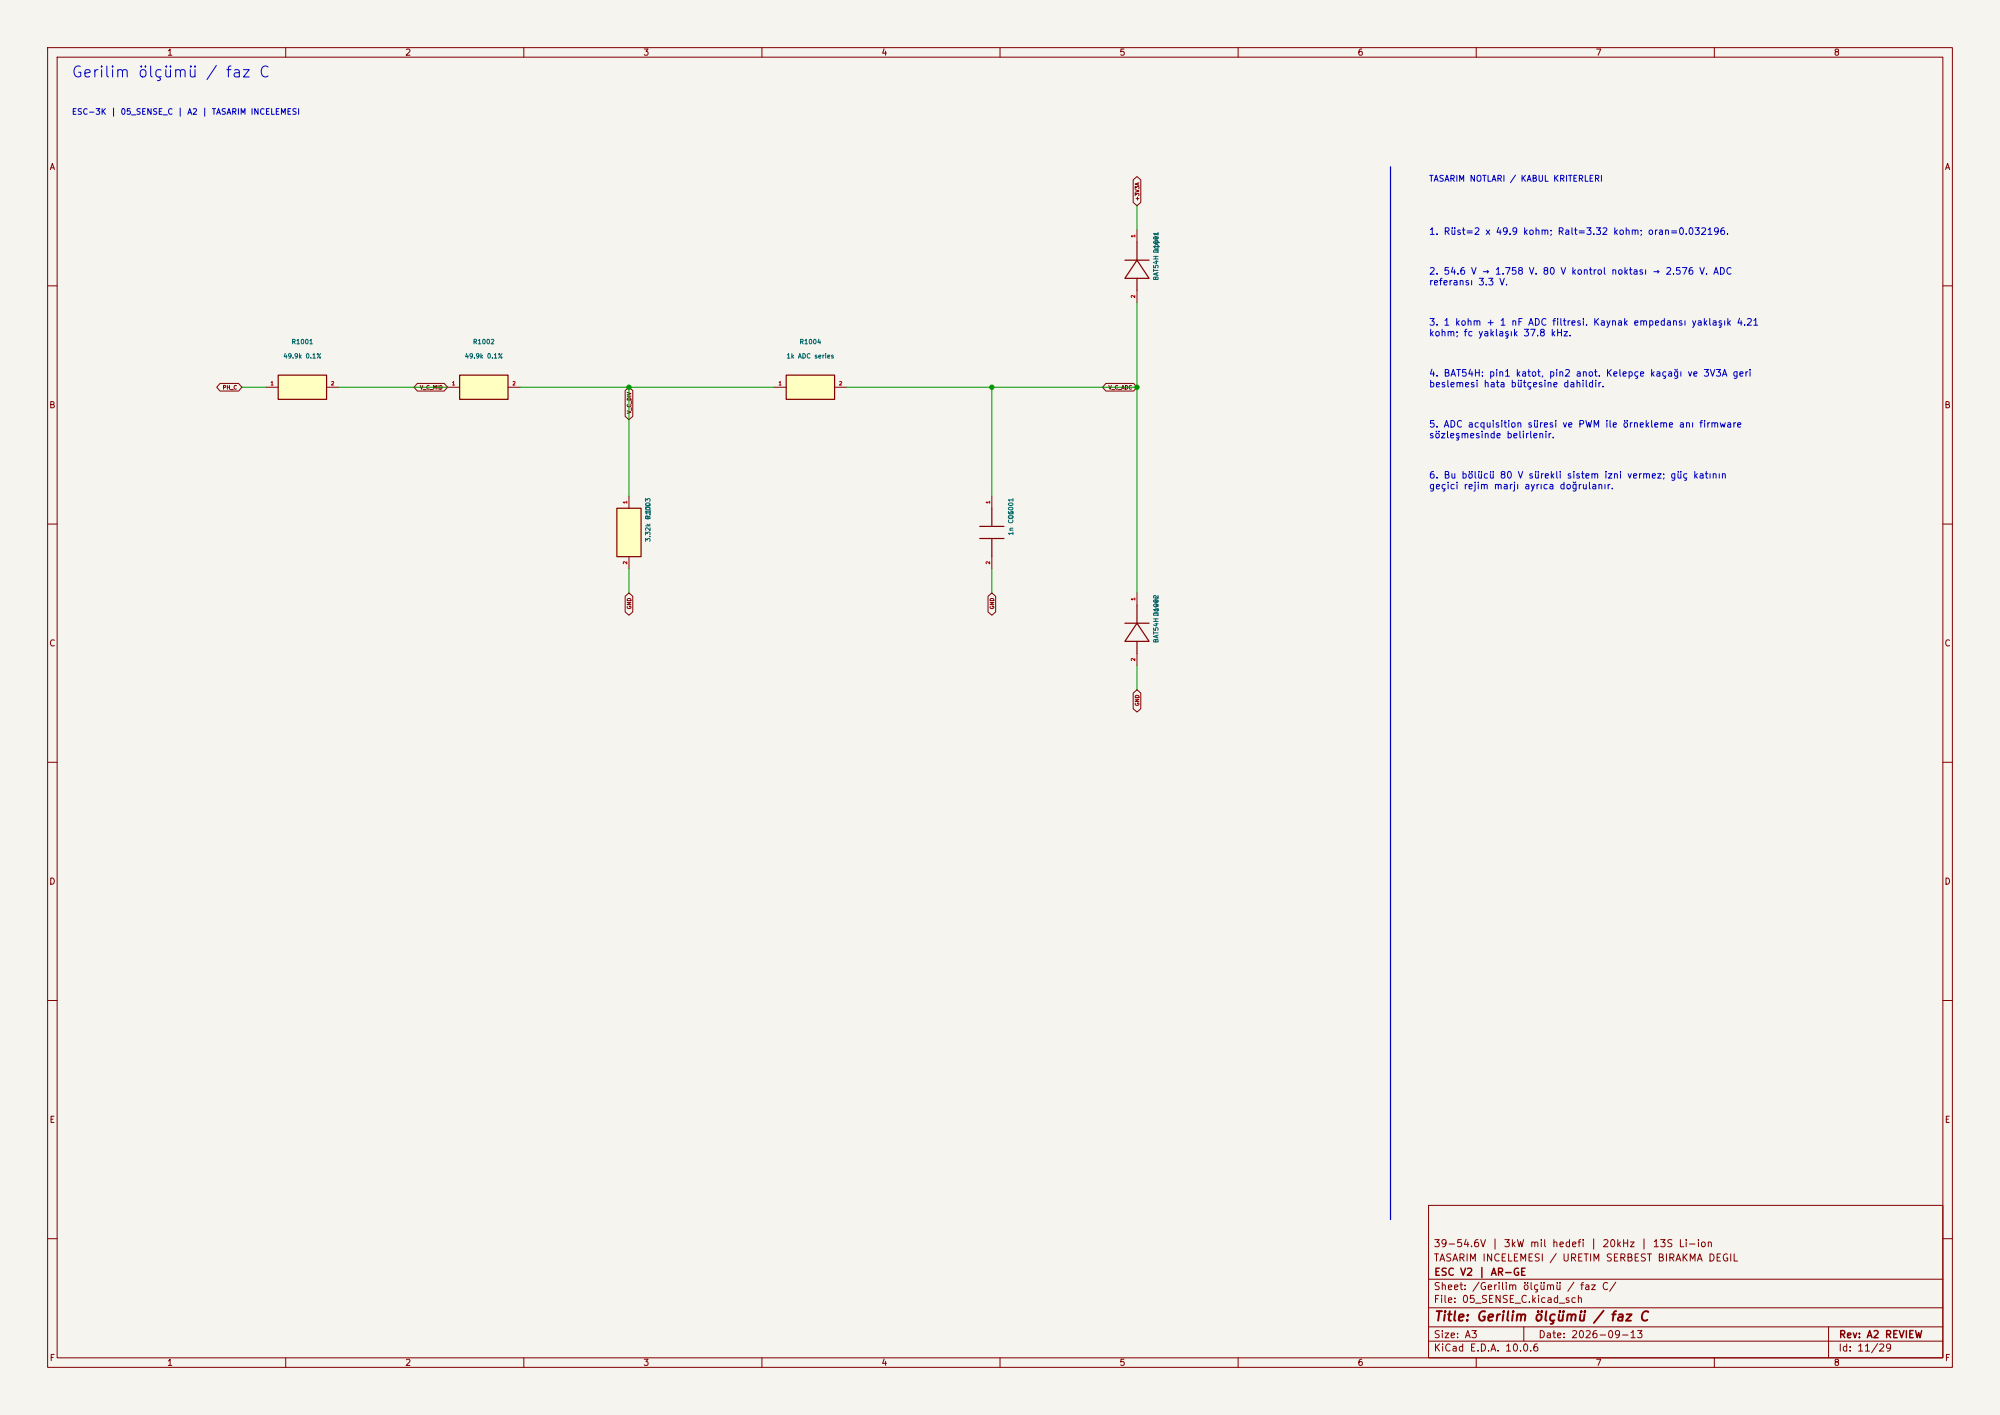
[picture p62: page 11]

sözleşmesinde belirlenir. 4. BAT54H: pin1 katot, pin2 anot. Kelepçe kaçağı ve 3V3A geri beslemesi hata bütçesine dahildir. Gerilim ölçümü / faz C

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

39-54.6V | 3kW mil hedefi | 20kHz | 13S Li-ion
TASARIM INCELEMESI / URETIM SERBEST BIRAKMA DEGIL
ESC V2 | AR-GE
Sheet: /Gerilim ölçümü / faz C/
File: 05_SENSE_C.kicad_sch
Title: Gerilim ölçümü / faz C

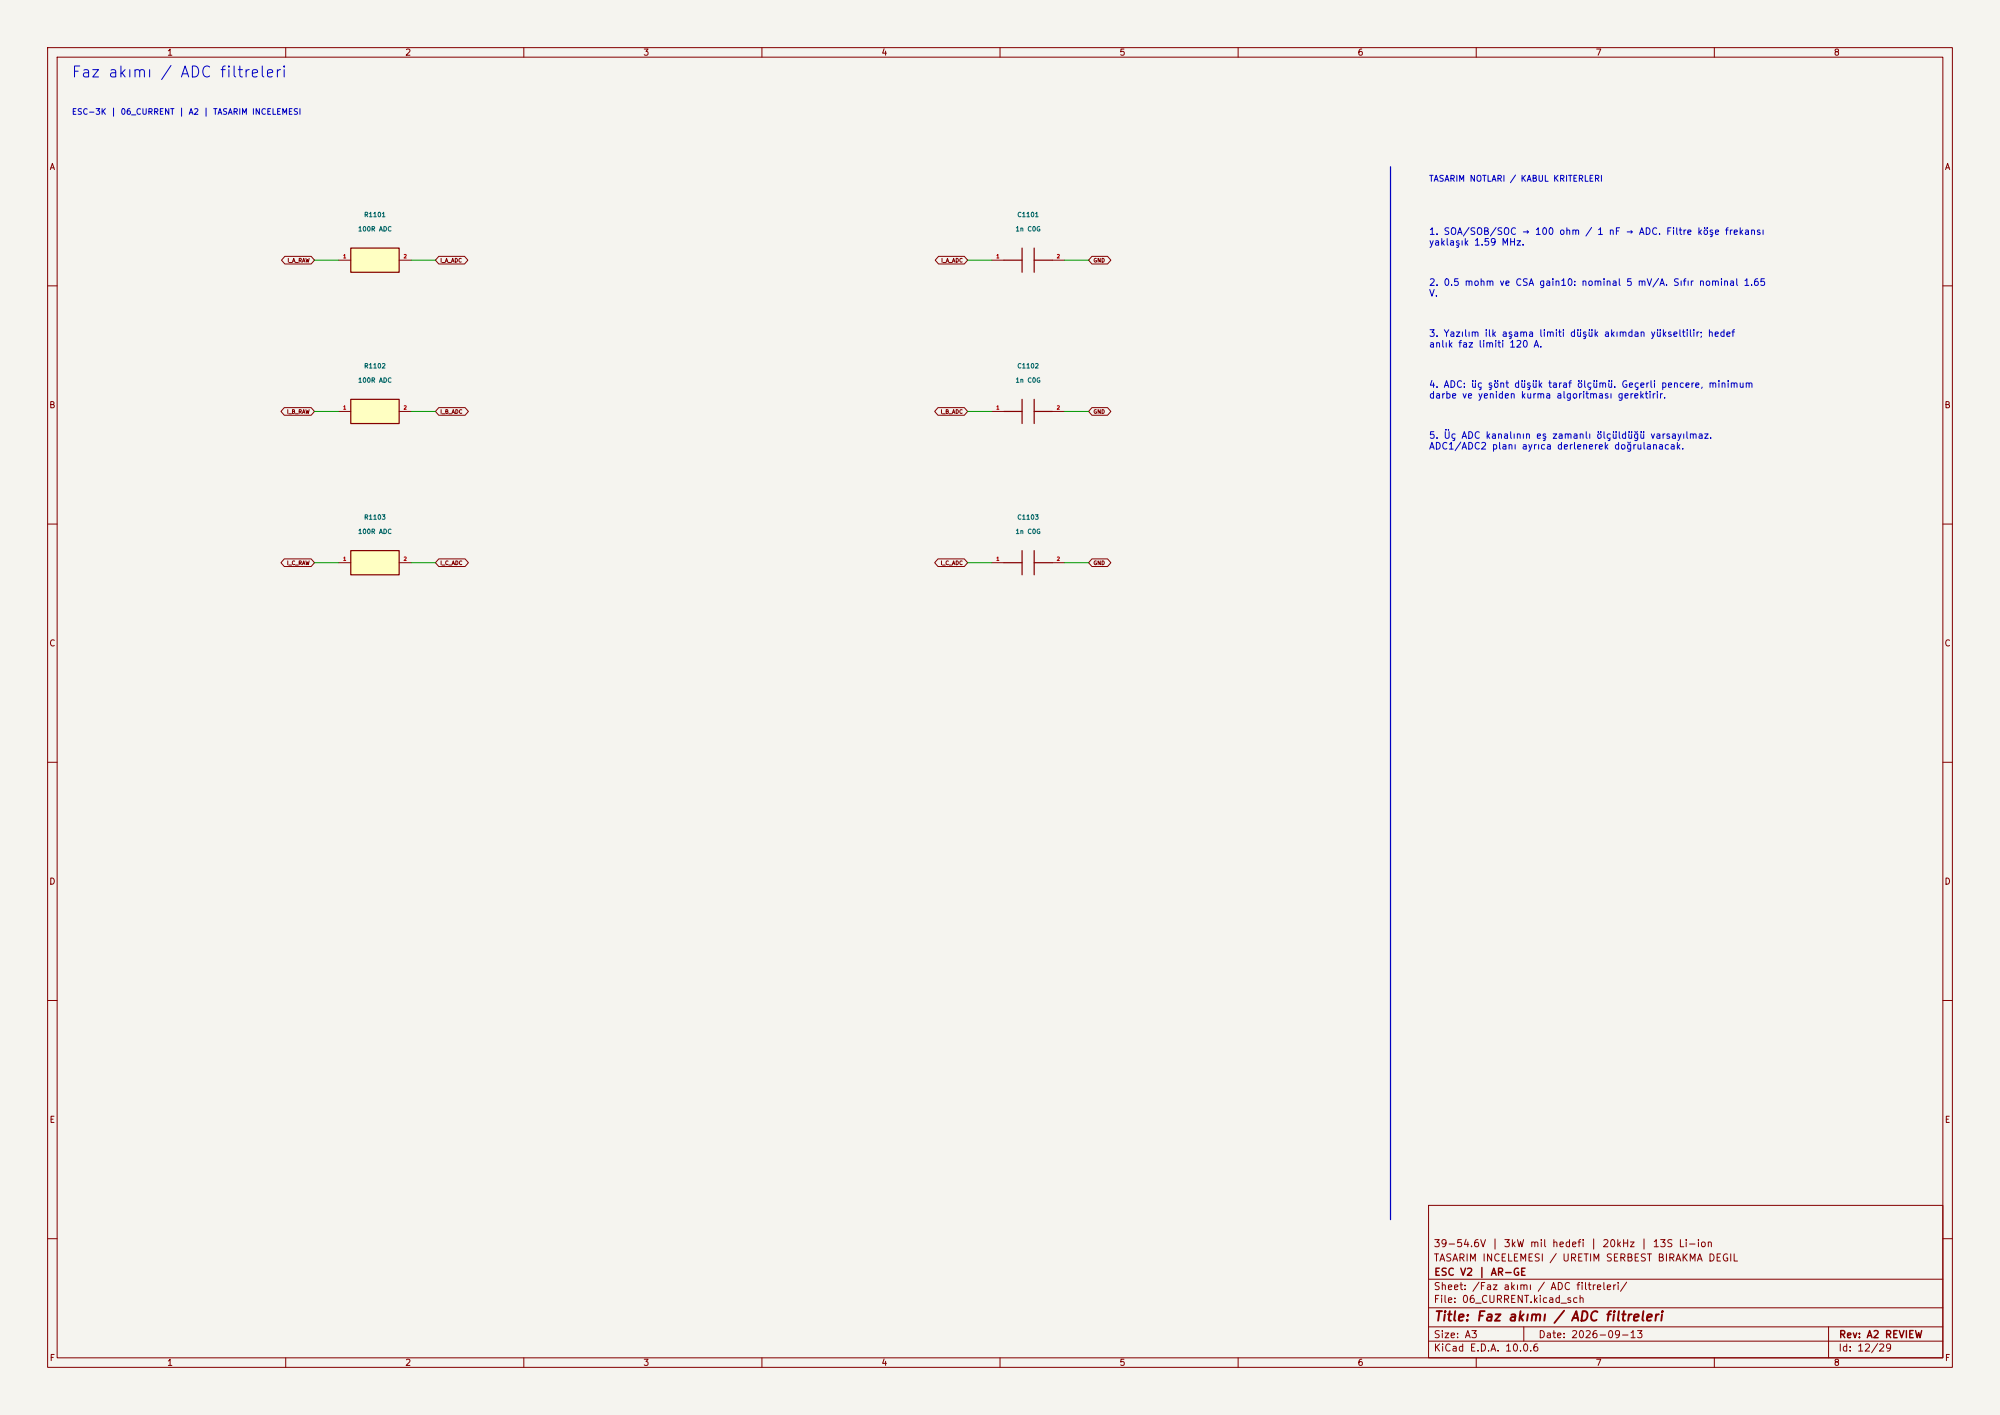
[picture p63: page 12]

Faz akımı / ADC filtreleri

ADC1/ADC2 planı ayrıca derlenerek doğrulanacak. 2. 0.5 mohm ve CSA gain10: nominal 5 mV/A. Sıfır nominal 1.65

darbe ve yeniden kurma algoritması gerektirir.

39-54.6V | 3kW mil hedefi | 20kHz | 13S Li-ion
TASARIM INCELEMESI / URETIM SERBEST BIRAKMA DEGIL
ESC V2 | AR-GE
Sheet: /Faz akımı / ADC filtreleri/
File: 06_CURRENT.kicad_sch
Title: Faz akımı / ADC filtreleri

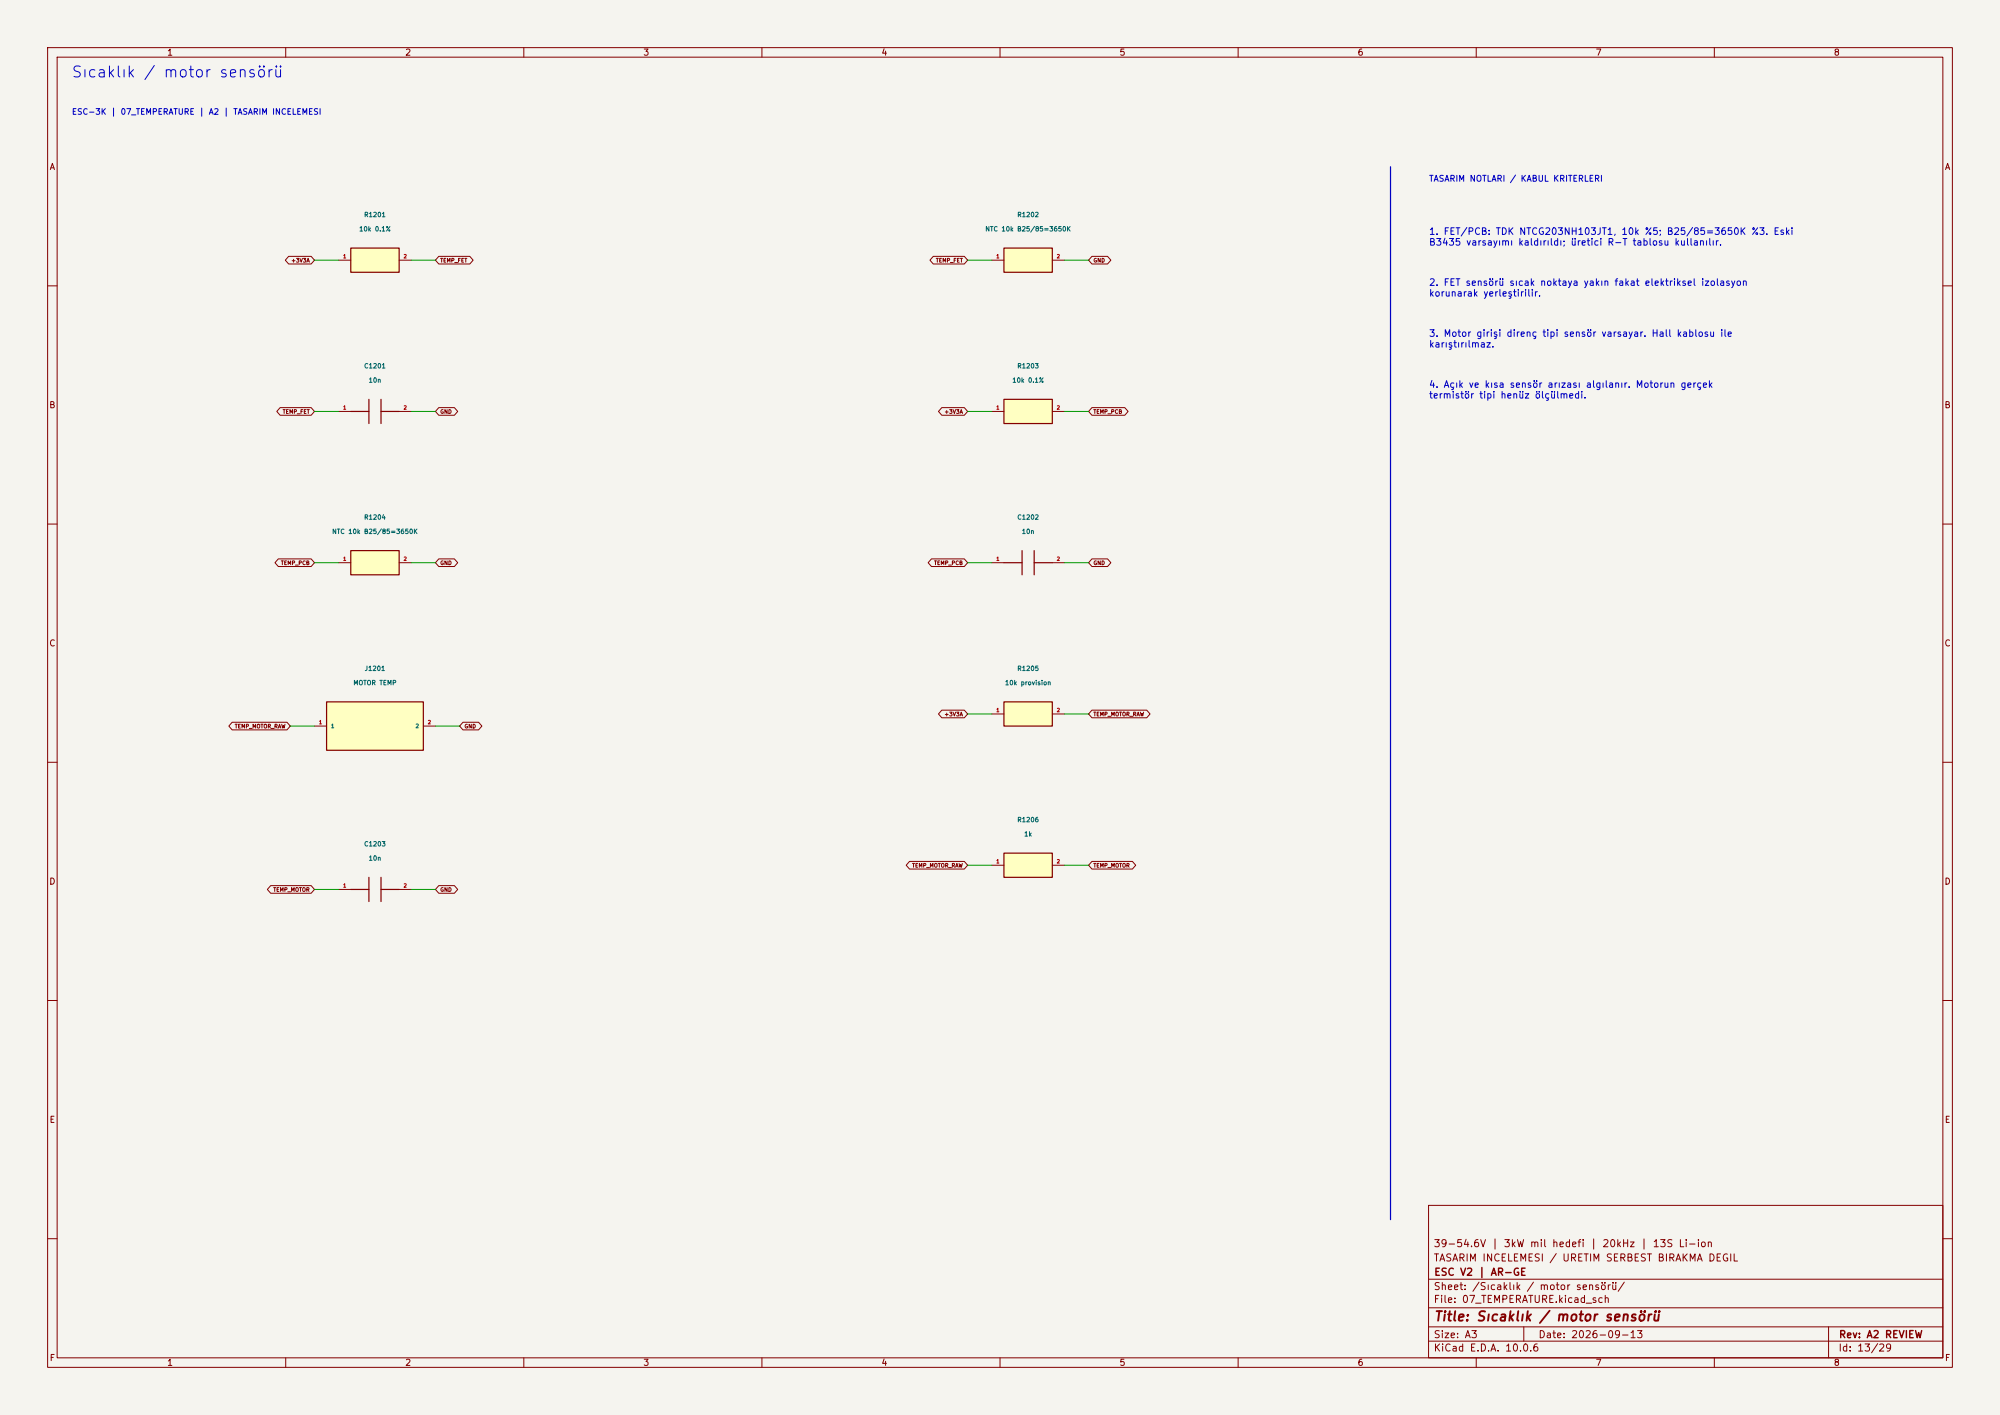
[picture p64: page 13]

TEMP_FET ESC-3K | 07_TEMPERATURE | A2 | TASARIM INCELEMESI Sıcaklık / motor sensörü

TASARIM NOTLARI / KABUL KRITERLERI 2. FET sensörü sıcak noktaya yakın fakat elektriksel izolasyon

termistör tipi henüz ölçülmedi. 1. FET/PCB: TDK NTCG203NH103JT1, 10k %5; B25/85=3650K %3. Eski B3435 varsayımı kaldırıldı; üretici R-T tablosu kullanılır. 3. Motor girişi direnç tipi sensör varsayar. Hall kablosu ile

4. Açık ve kısa sensör arızası algılanır. Motorun gerçek

39-54.6V | 3kW mil hedefi | 20kHz | 13S Li-ion
TASARIM INCELEMESI / URETIM SERBEST BIRAKMA DEGIL
ESC V2 | AR-GE
Sheet: /Sıcaklık / motor sensörü/
File: 07_TEMPERATURE.kicad_sch
Title: Sıcaklık / motor sensörü

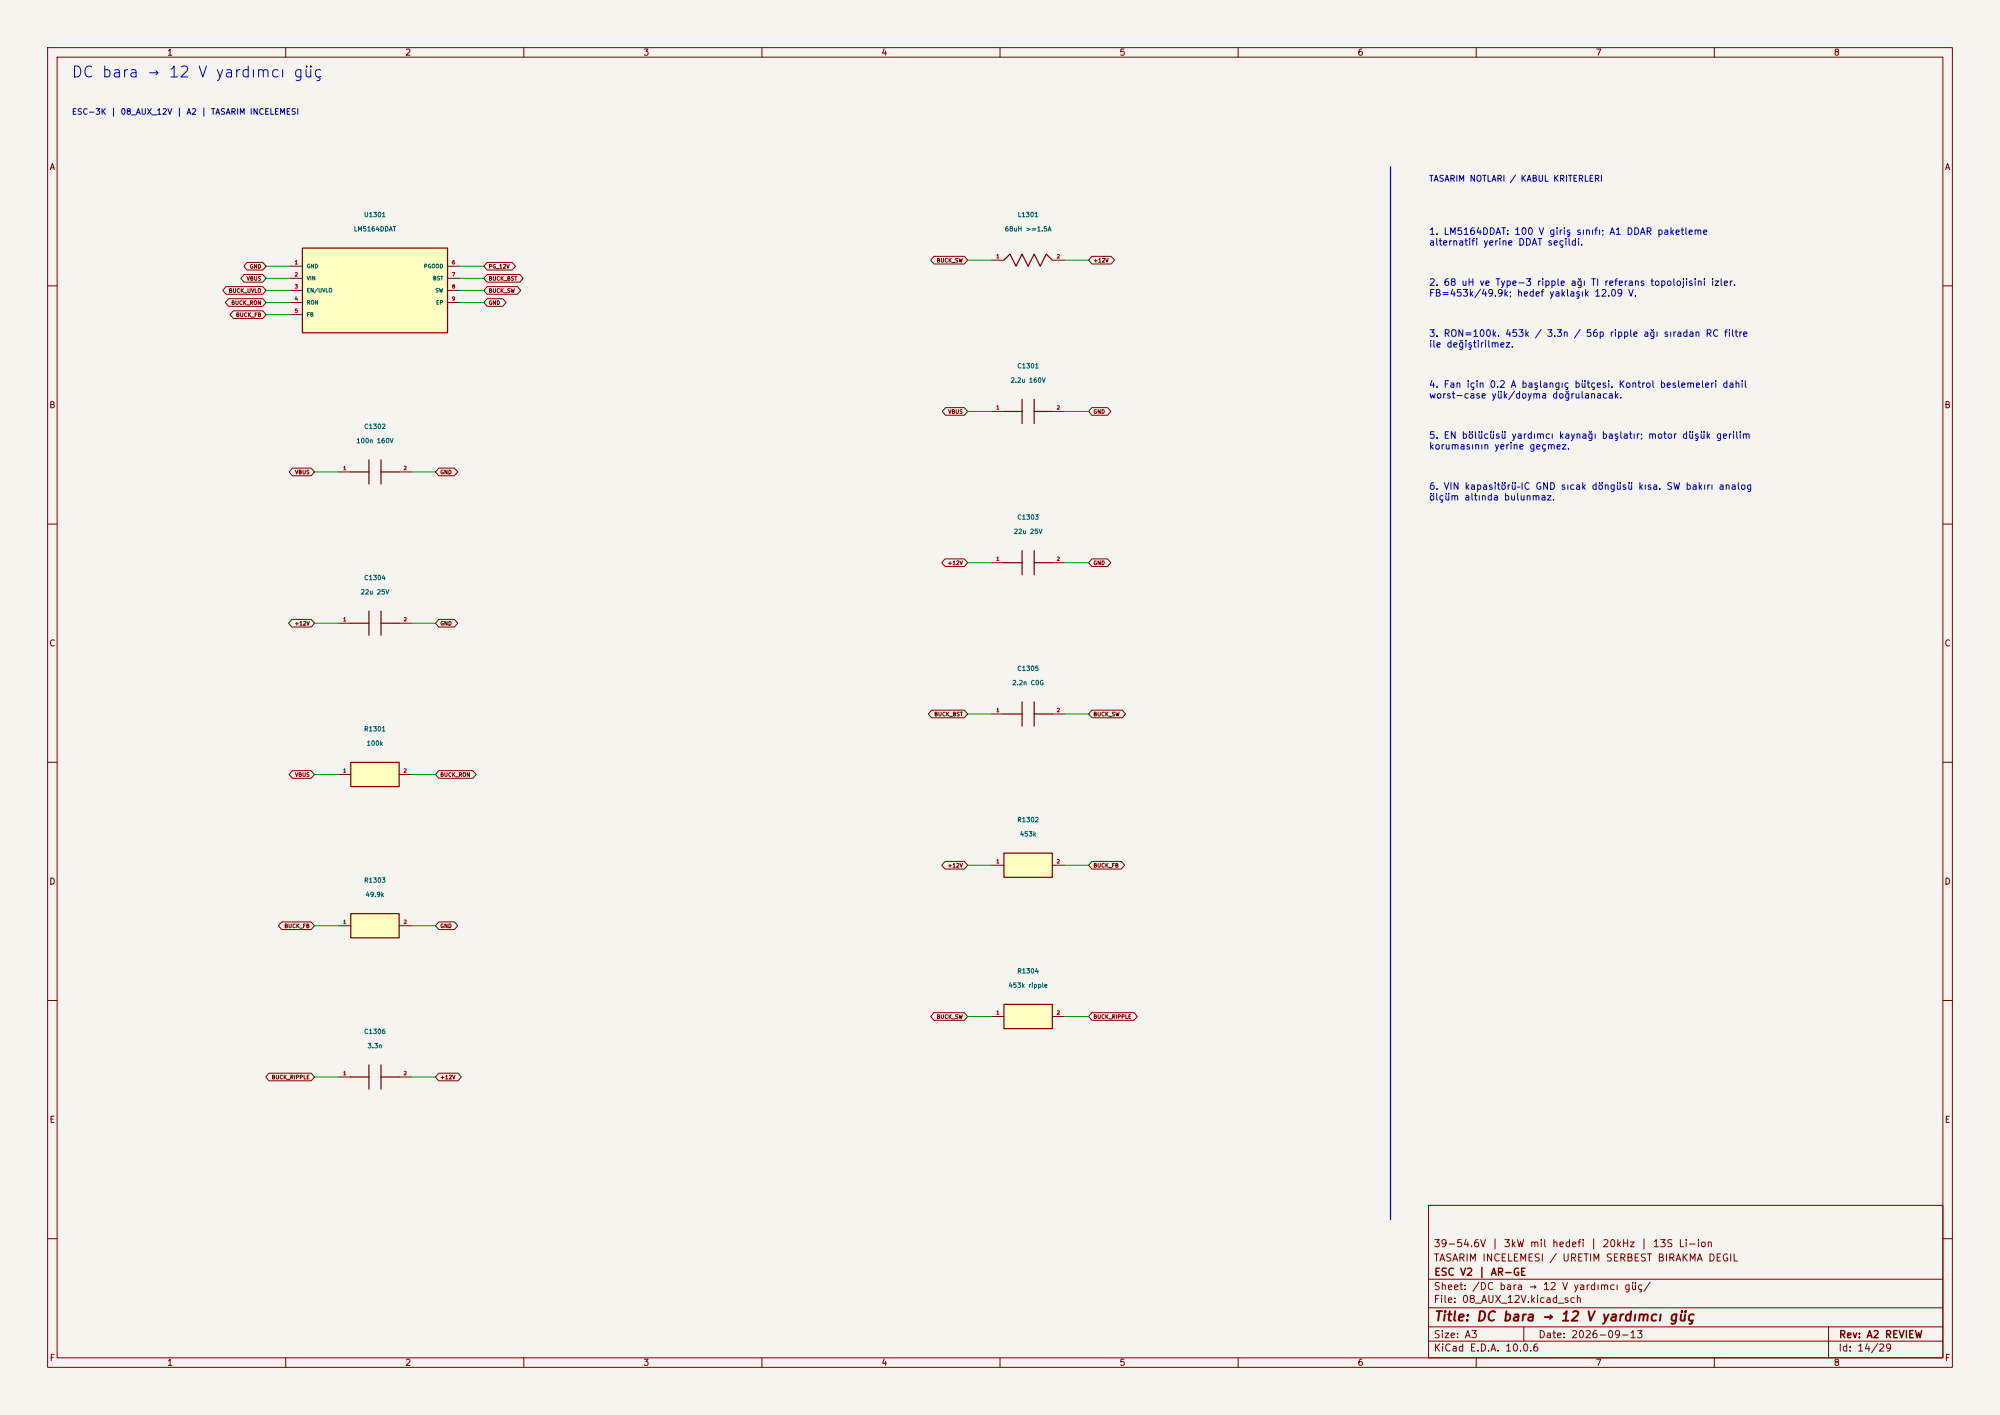
[picture p65: page 14]

DC bara → 12 V yardımcı güç

ölçüm altında bulunmaz. 1. LM5164DDAT: 100 V giriş sınıfı; A1 DDAR paketleme alternatifi yerine DDAT seçildi. TASARIM NOTLARI / KABUL KRITERLERI 3. RON=100k. 453k / 3.3n / 56p ripple ağı sıradan RC filtre

ile değiştirilmez. 2. 68 uH ve Type-3 ripple ağı TI referans topolojisini izler. FB=453k/49.9k; hedef yaklaşık 12.09 V. 5. EN bölücüsü yardımcı kaynağı başlatır; motor düşük gerilim

korumasının yerine geçmez. 4. Fan için 0.2 A başlangıç bütçesi. Kontrol beslemeleri dahil worst-case yük/doyma doğrulanacak.

6. VIN kapasitörü–IC GND sıcak döngüsü kısa. SW bakırı analog

39-54.6V | 3kW mil hedefi | 20kHz | 13S Li-ion
TASARIM INCELEMESI / URETIM SERBEST BIRAKMA DEGIL
ESC V2 | AR-GE
Sheet: /DC bara → 12 V yardımcı güç/
File: 08_AUX_12V.kicad_sch
Title: DC bara → 12 V yardımcı güç

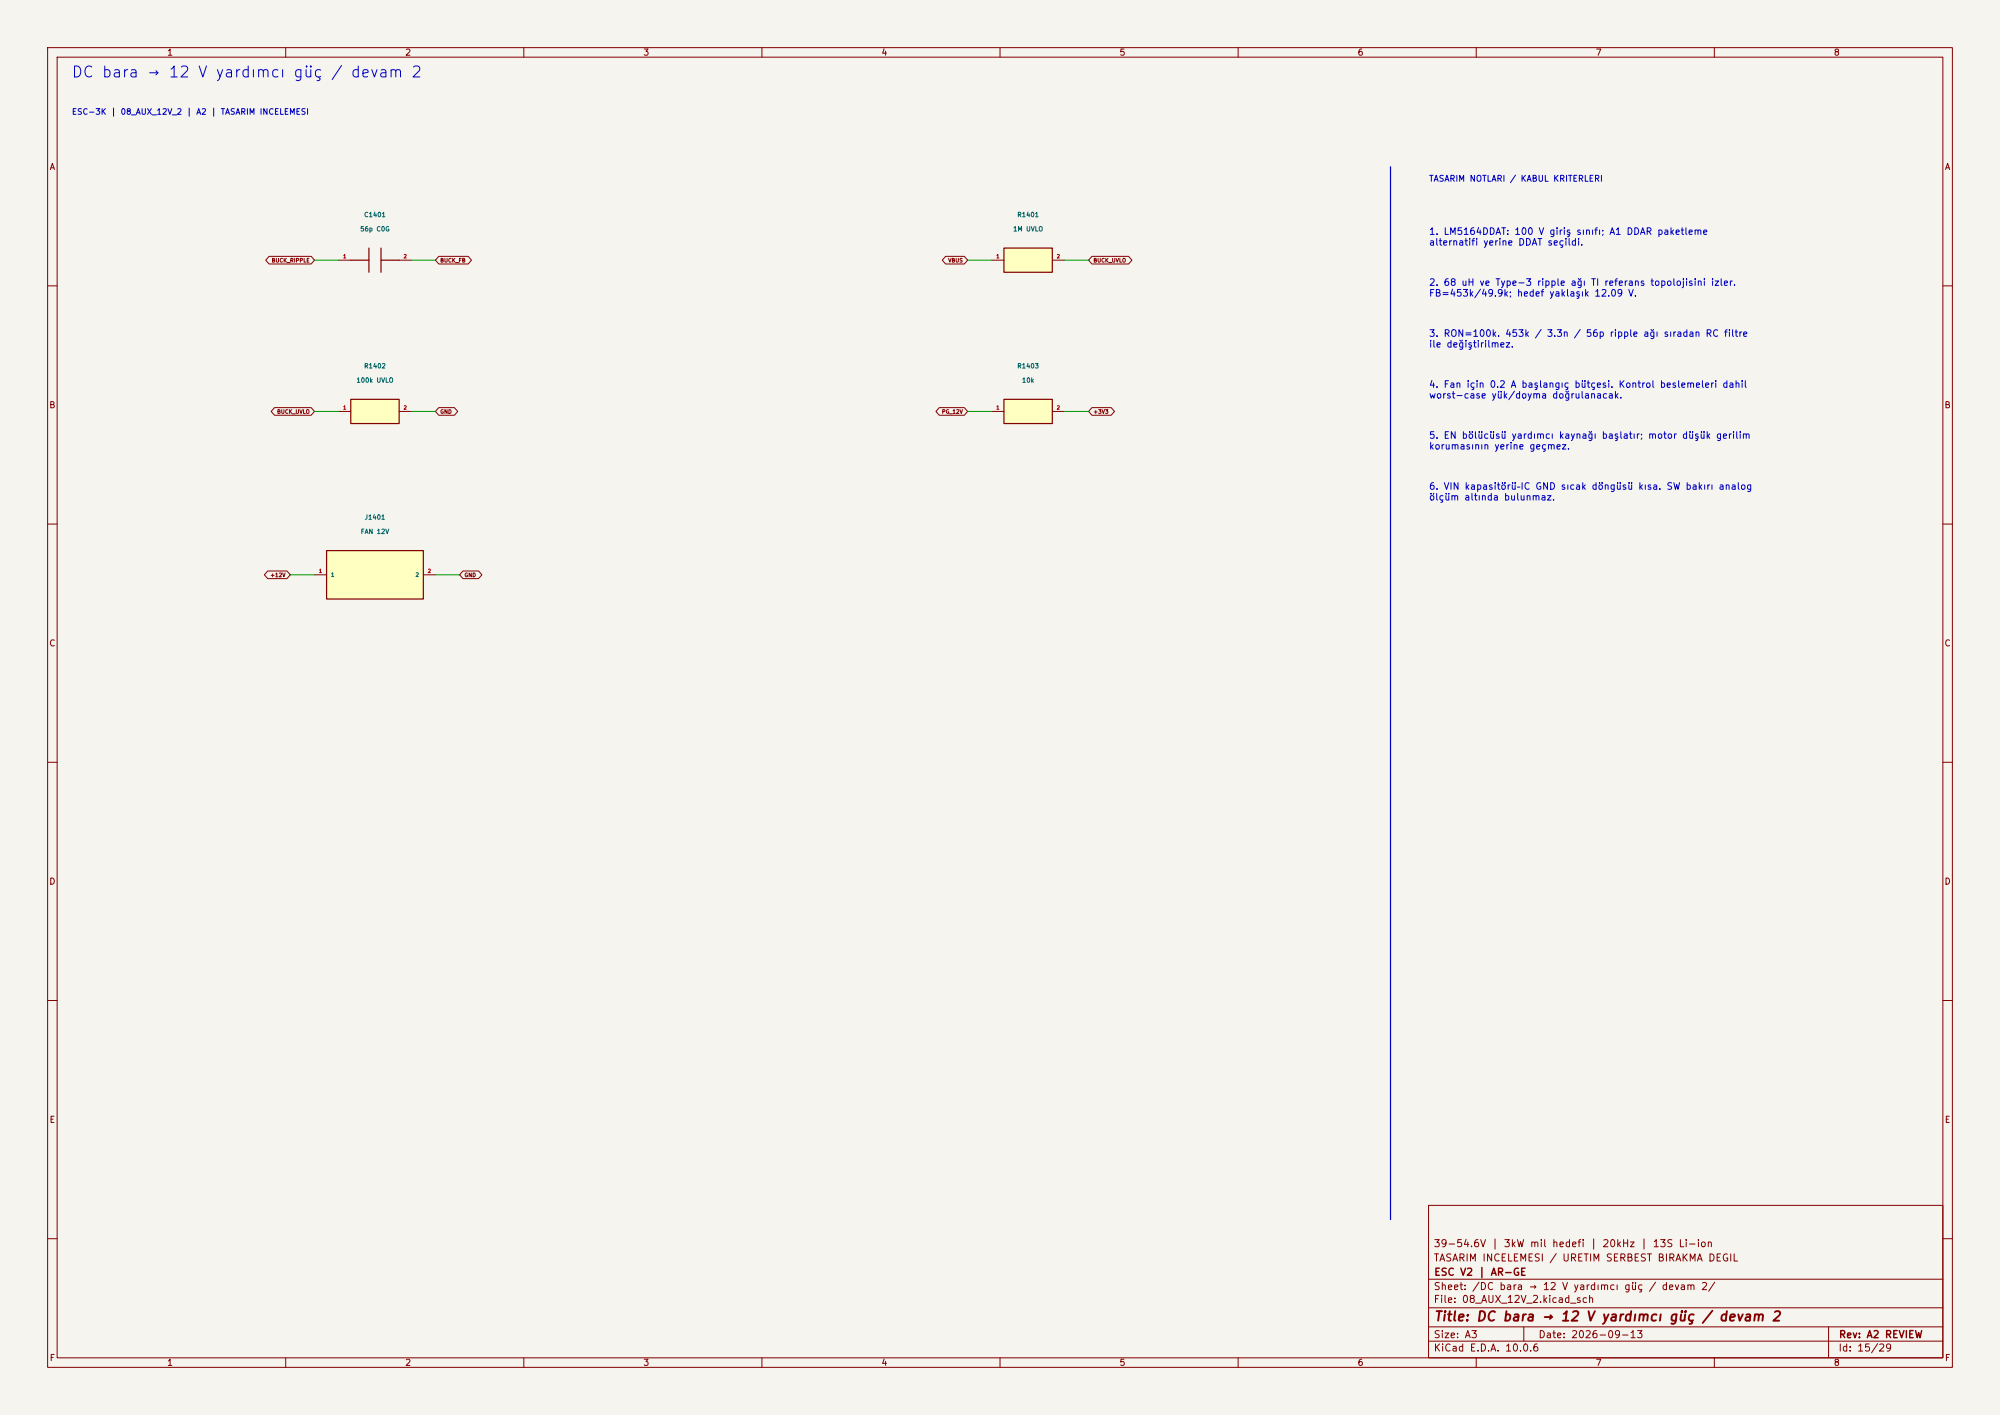
[picture p66: page 15]

DC bara → 12 V yardımcı güç / devam 2

TASARIM NOTLARI / KABUL KRITERLERI 1. LM5164DDAT: 100 V giriş sınıfı; A1 DDAR paketleme alternatifi yerine DDAT seçildi.

4. Fan için 0.2 A başlangıç bütçesi. Kontrol beslemeleri dahil worst-case yük/doyma doğrulanacak. 5. EN bölücüsü yardımcı kaynağı başlatır; motor düşük gerilim

korumasının yerine geçmez. 6. VIN kapasitörü–IC GND sıcak döngüsü kısa. SW bakırı analog

39-54.6V | 3kW mil hedefi | 20kHz | 13S Li-ion
TASARIM INCELEMESI / URETIM SERBEST BIRAKMA DEGIL
ESC V2 | AR-GE
Sheet: /DC bara → 12 V yardımcı güç / devam 2/
File: 08_AUX_12V_2.kicad_sch
Title: DC bara → 12 V yardımcı güç / devam 2

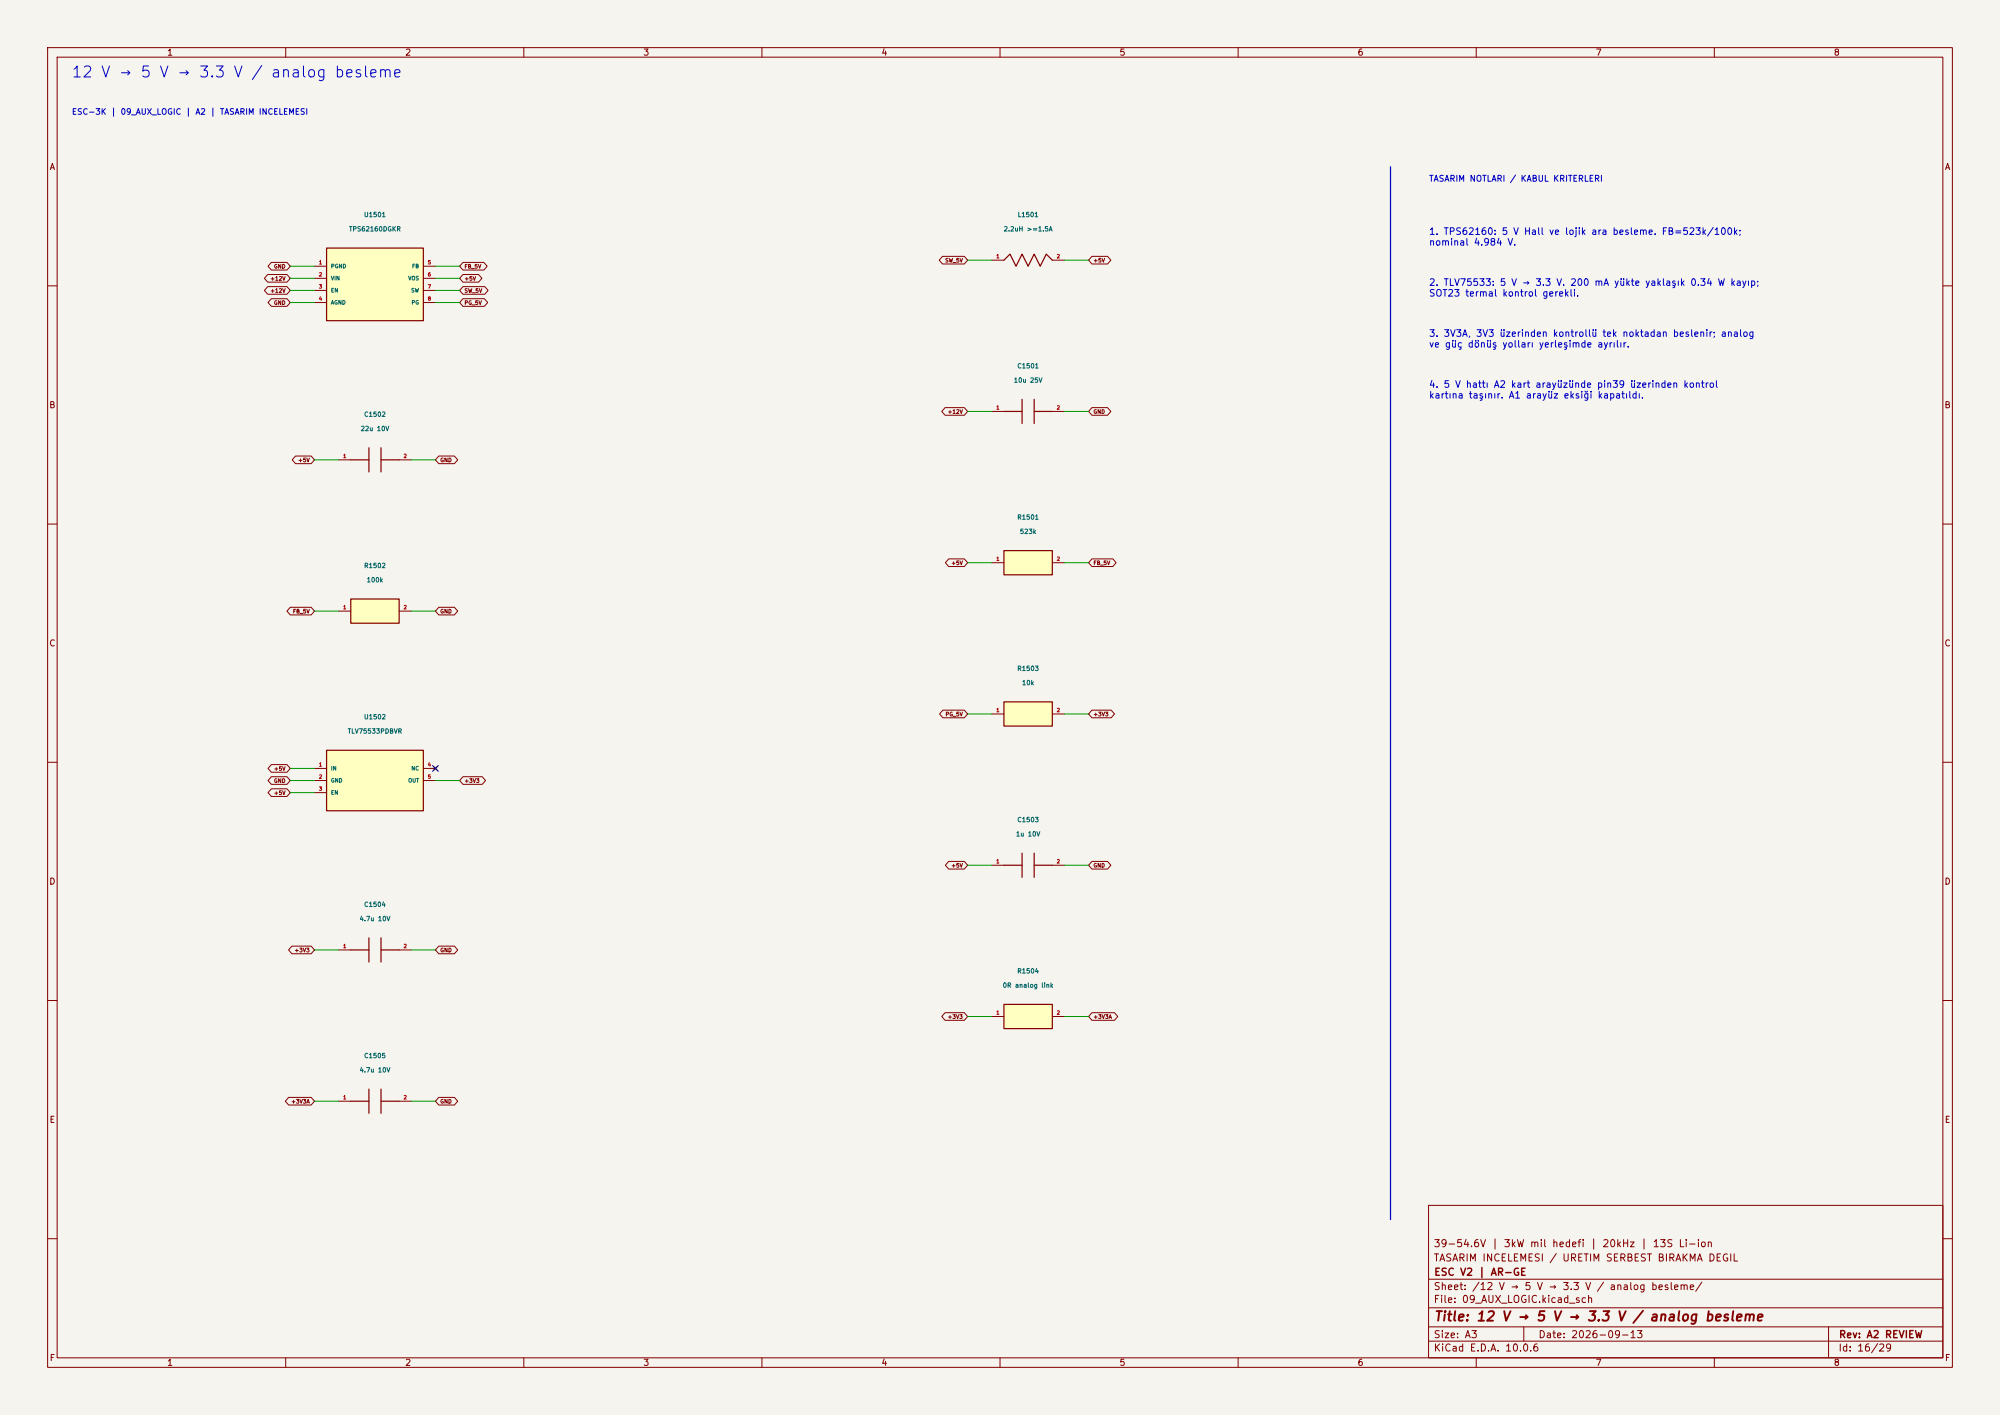
[picture p67: page 16]

4. 5 V hattı A2 kart arayüzünde pin39 üzerinden kontrol kartına taşınır. A1 arayüz eksiği kapatıldı. TASARIM NOTLARI / KABUL KRITERLERI ESC-3K | 09_AUX_LOGIC | A2 | TASARIM INCELEMESI

1. TPS62160: 5 V Hall ve lojik ara besleme. FB=523k/100k; nominal 4.984 V. 2. TLV75533: 5 V → 3.3 V. 200 mA yükte yaklaşık 0.34 W kayıp; SOT23 termal kontrol gerekli. 3. 3V3A, 3V3 üzerinden kontrollü tek noktadan beslenir; analog

ve güç dönüş yolları yerleşimde ayrılır.

39-54.6V | 3kW mil hedefi | 20kHz | 13S Li-ion
TASARIM INCELEMESI / URETIM SERBEST BIRAKMA DEGIL
ESC V2 | AR-GE
Sheet: /12 V → 5 V → 3.3 V / analog besleme/
File: 09_AUX_LOGIC.kicad_sch
Title: 12 V → 5 V → 3.3 V / analog besleme

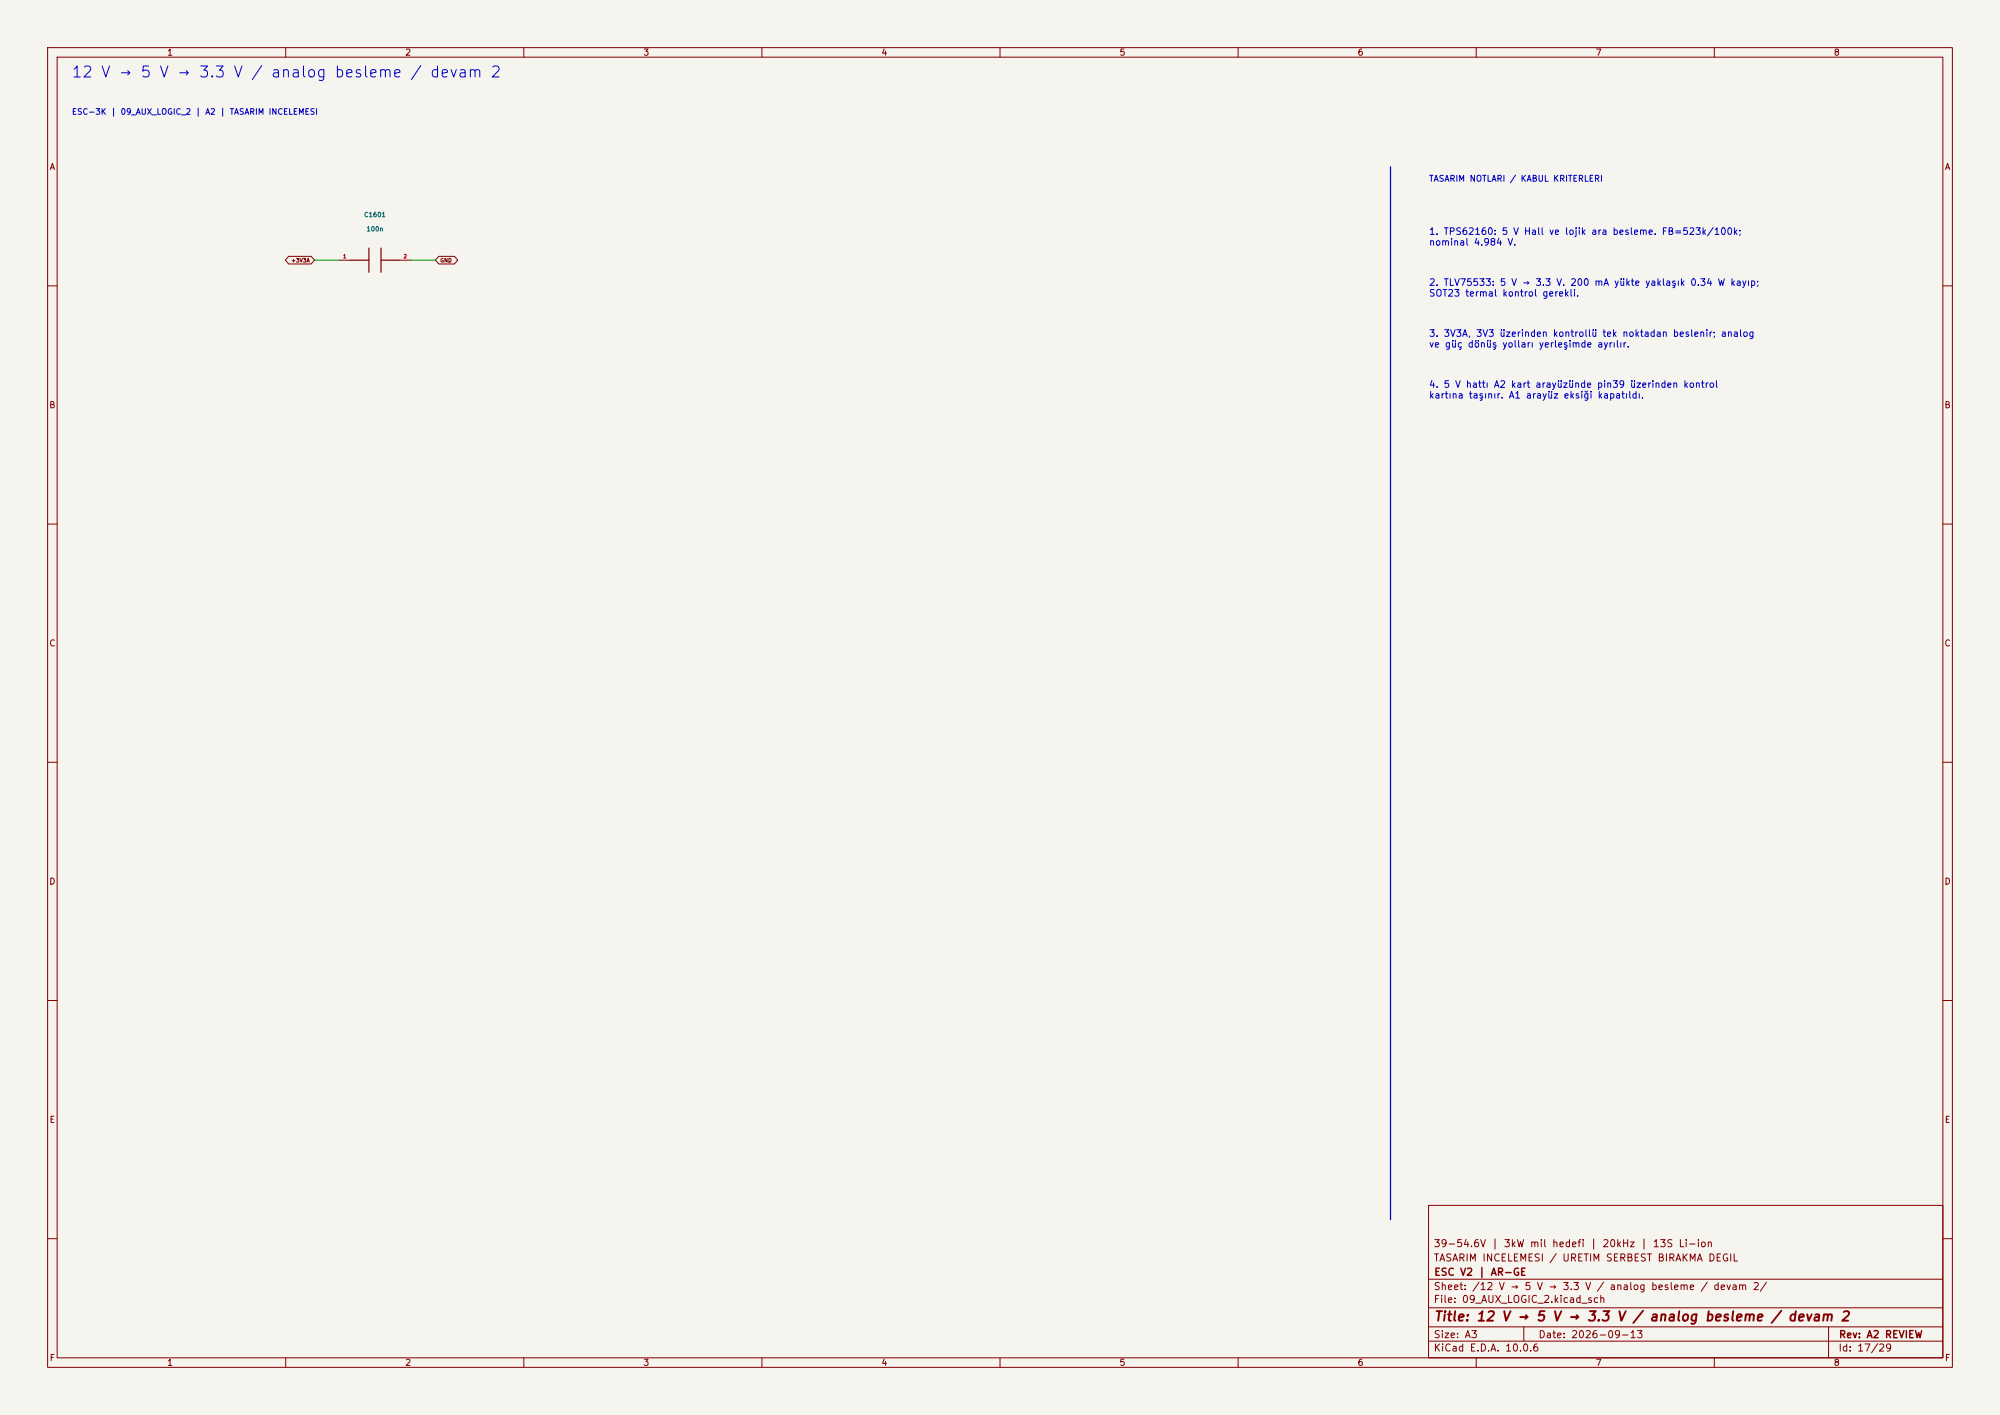
[picture p68: page 17]

ve güç dönüş yolları yerleşimde ayrılır.

4. 5 V hattı A2 kart arayüzünde pin39 üzerinden kontrol kartına taşınır. A1 arayüz eksiği kapatıldı.

39-54.6V | 3kW mil hedefi | 20kHz | 13S Li-ion
TASARIM INCELEMESI / URETIM SERBEST BIRAKMA DEGIL
ESC V2 | AR-GE
Sheet: /12 V → 5 V → 3.3 V / analog besleme / devam 2/
File: 09_AUX_LOGIC_2.kicad_sch
Title: 12 V → 5 V → 3.3 V / analog besleme / devam 2

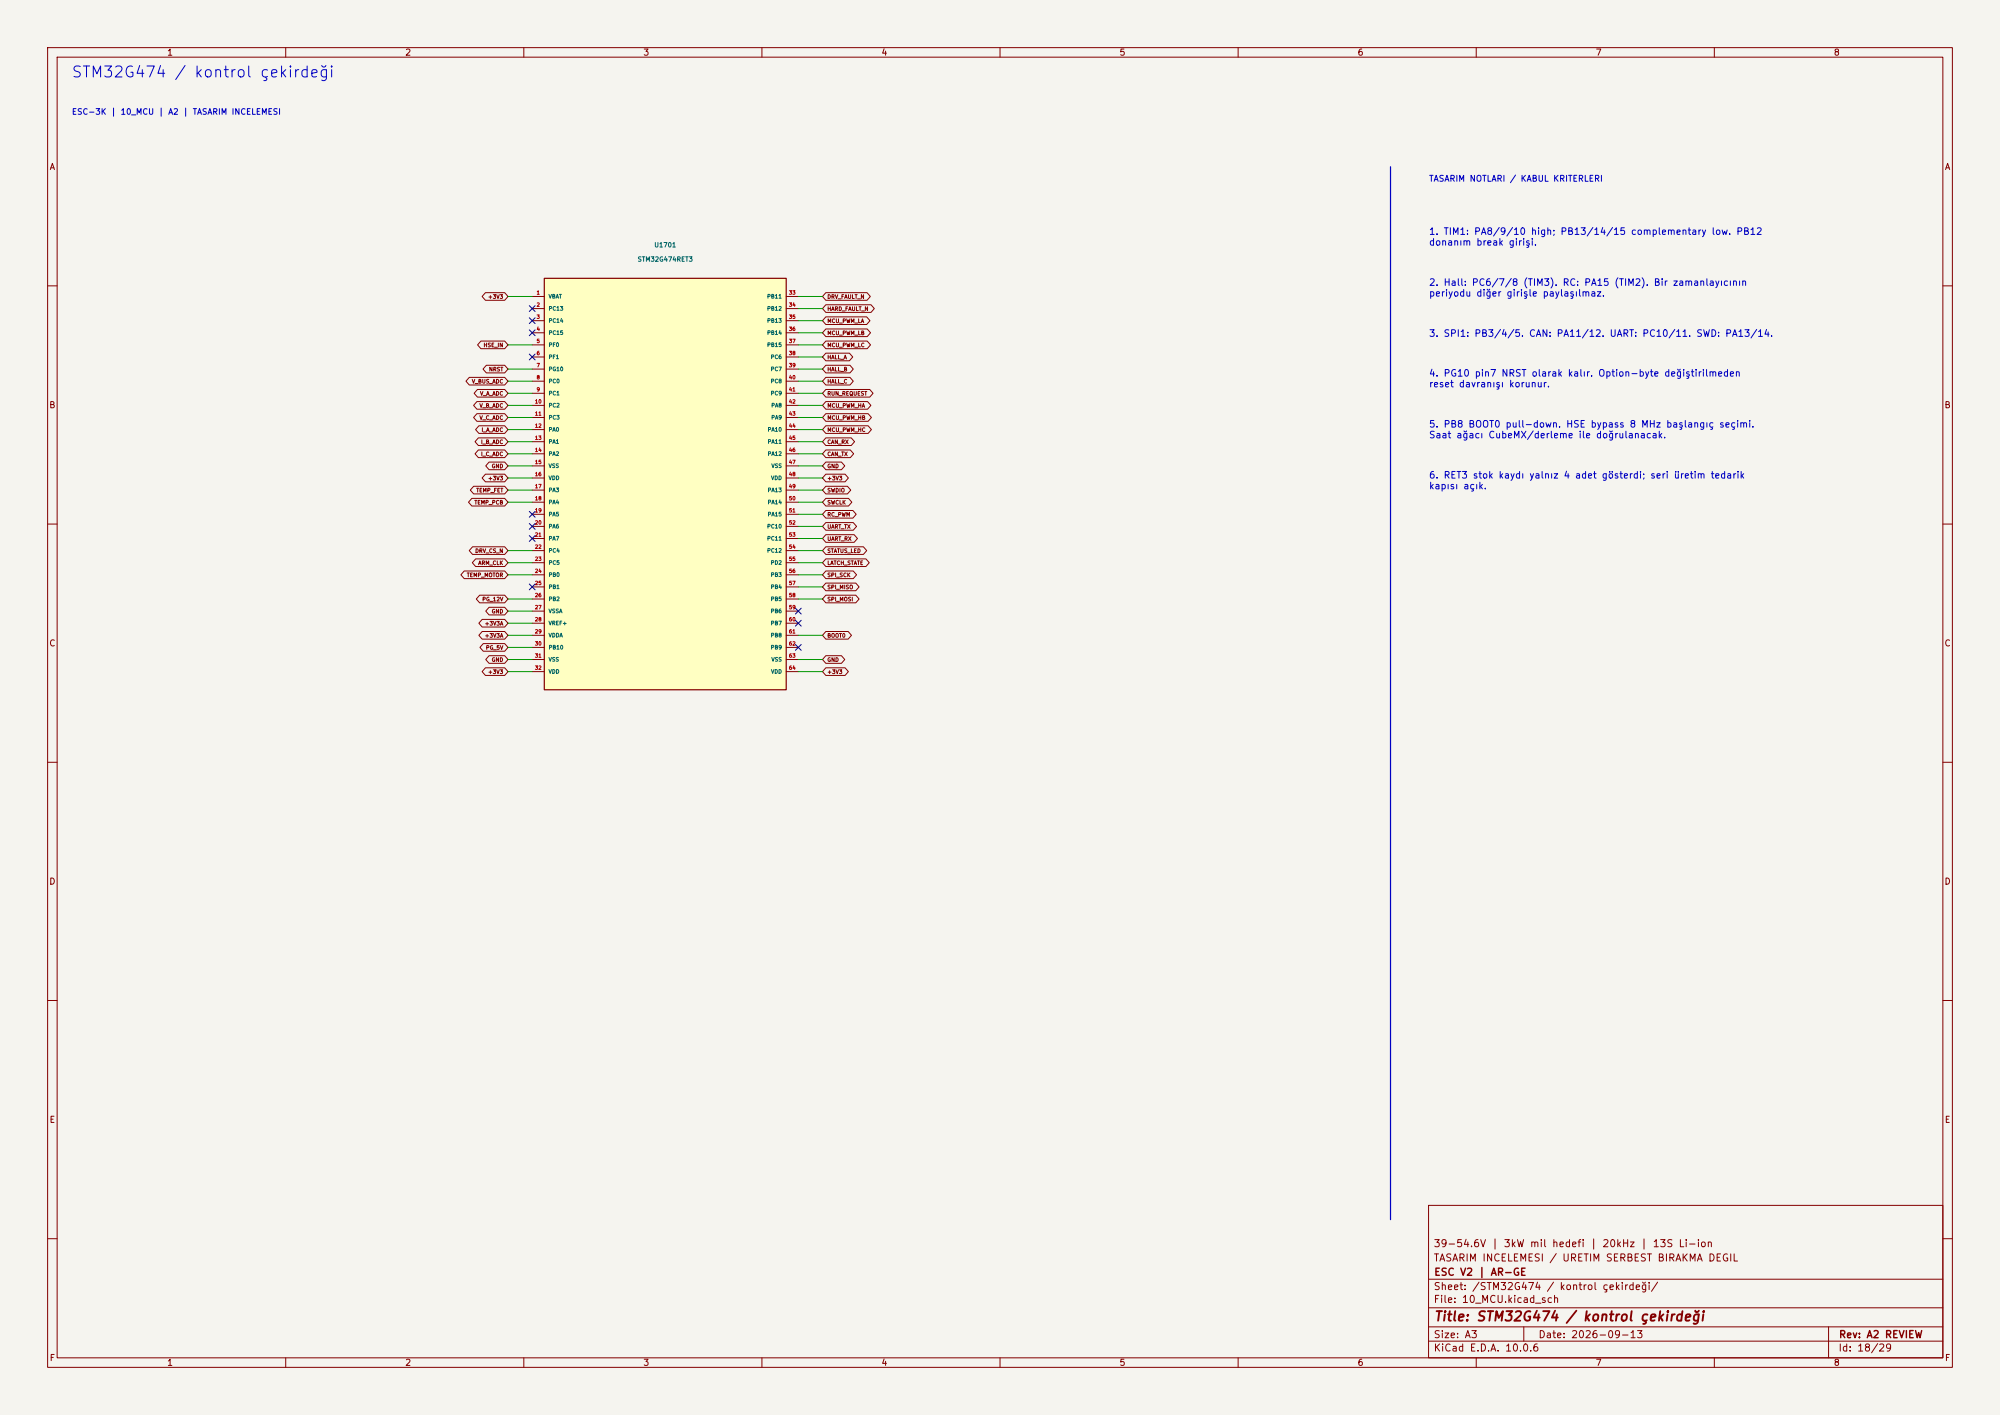
[picture p69: page 18]

reset davranışı korunur. TASARIM NOTLARI / KABUL KRITERLERI 6. RET3 stok kaydı yalnız 4 adet gösterdi; seri üretim tedarik

kapısı açık. 5. PB8 BOOT0 pull-down. HSE bypass 8 MHz başlangıç seçimi. Saat ağacı CubeMX/derleme ile doğrulanacak. 2. Hall: PC6/7/8 (TIM3). RC: PA15 (TIM2). Bir zamanlayıcının
periyodu diğer girişle paylaşılmaz.

39-54.6V | 3kW mil hedefi | 20kHz | 13S Li-ion
TASARIM INCELEMESI / URETIM SERBEST BIRAKMA DEGIL
ESC V2 | AR-GE
Sheet: /STM32G474 / kontrol çekirdeği/
File: 10_MCU.kicad_sch
Title: STM32G474 / kontrol çekirdeği

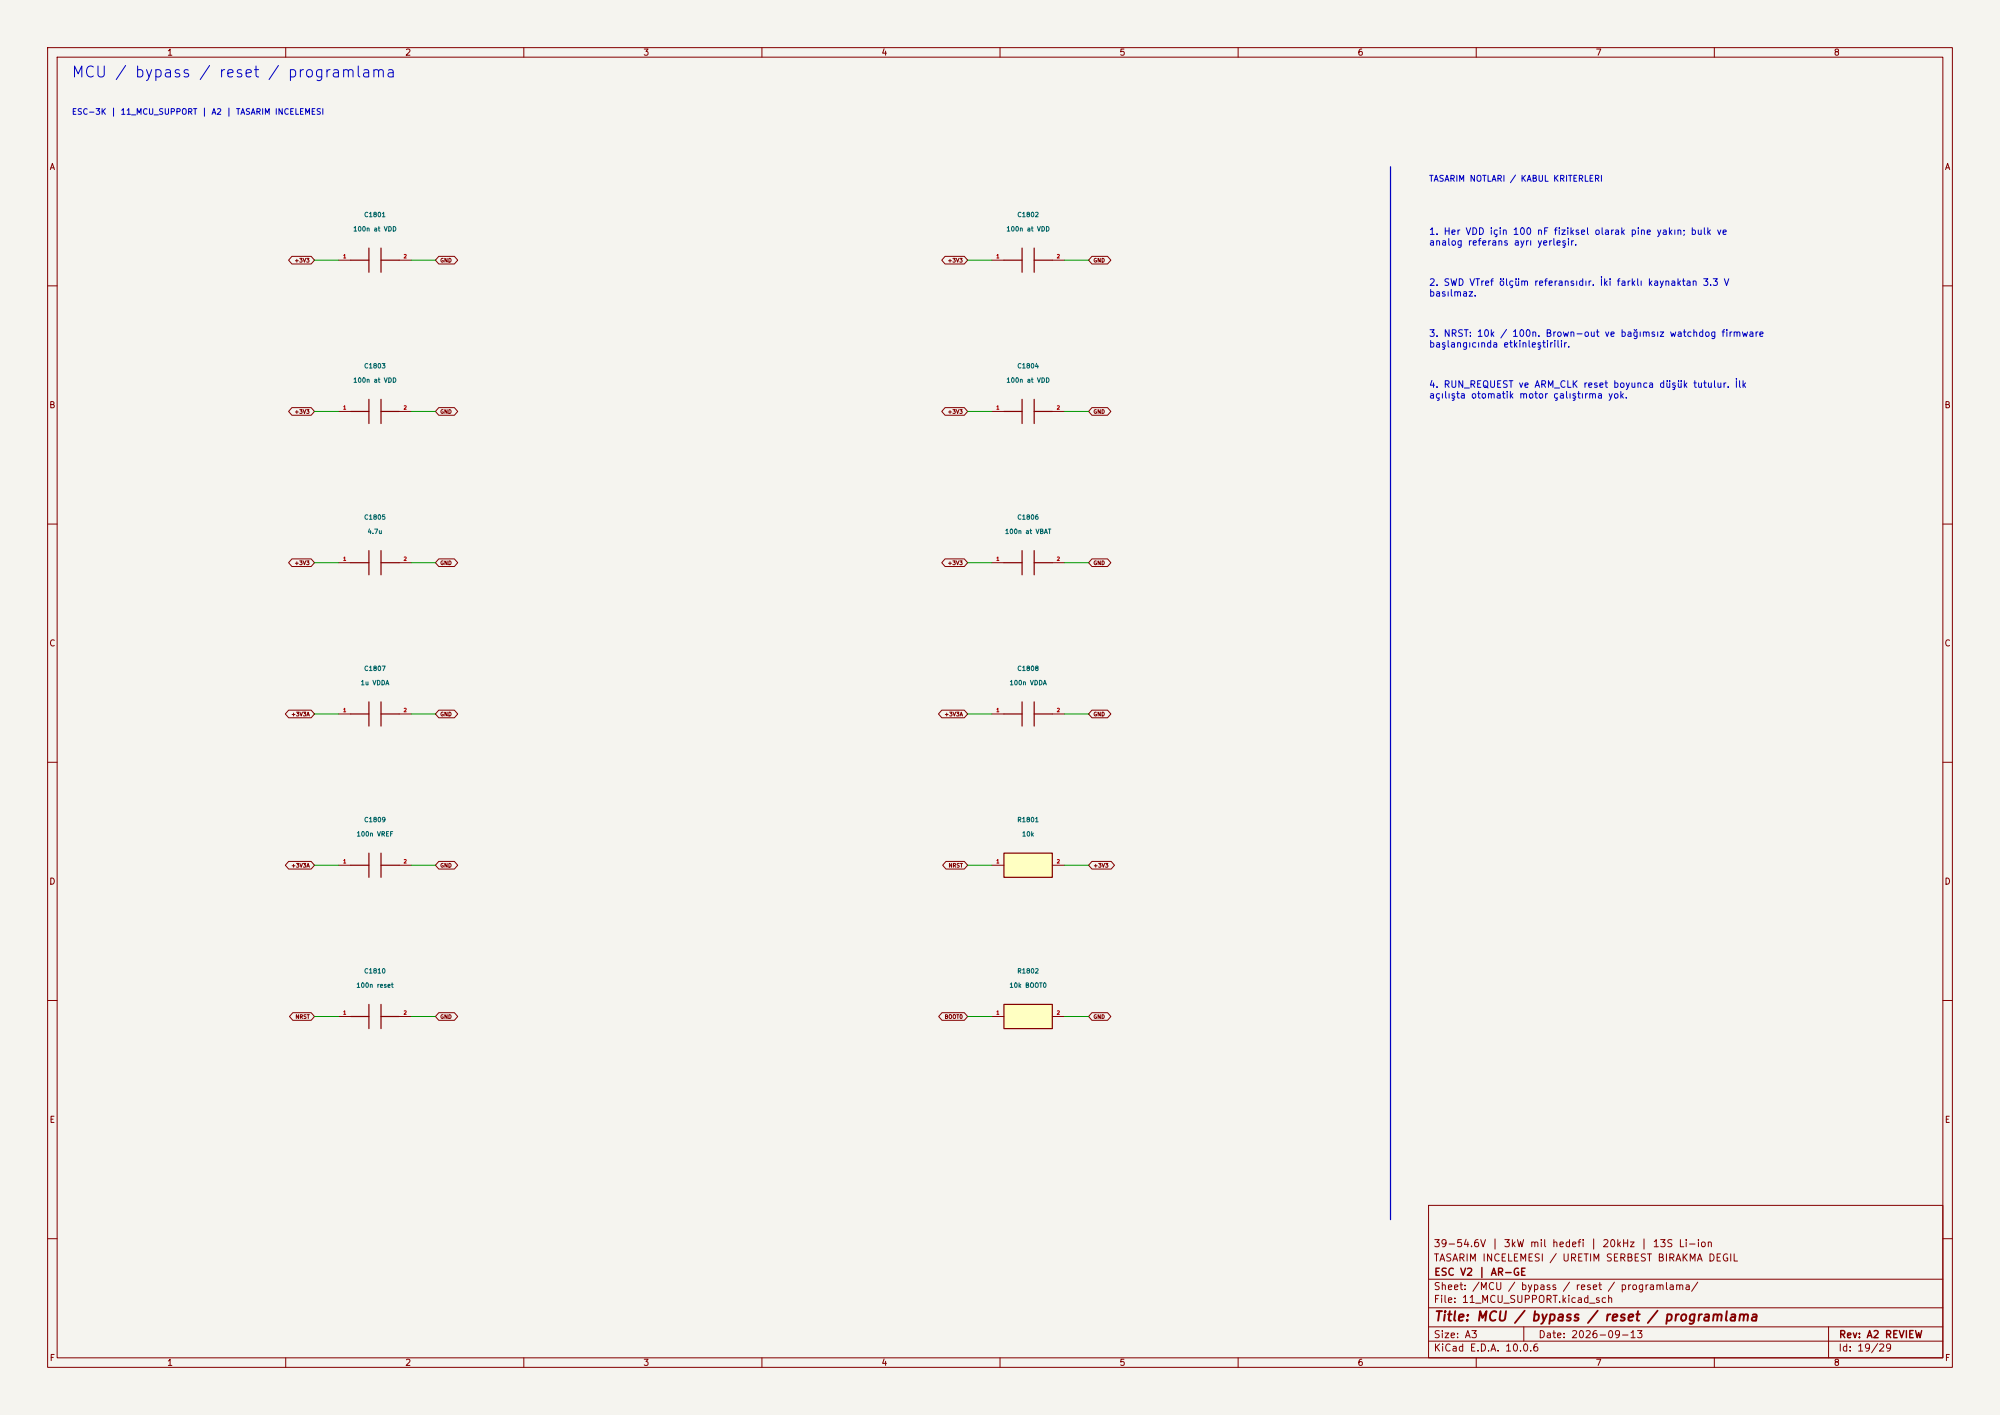
[picture p70: page 19]

GND MCU / bypass / reset / programlama

2. SWD VTref ölçüm referansıdır. İki farklı kaynaktan 3.3 V basılmaz. 1. Her VDD için 100 nF fiziksel olarak pine yakın; bulk ve analog referans ayrı yerleşir.

4. RUN_REQUEST ve ARM_CLK reset boyunca düşük tutulur. İlk

39-54.6V | 3kW mil hedefi | 20kHz | 13S Li-ion
TASARIM INCELEMESI / URETIM SERBEST BIRAKMA DEGIL
ESC V2 | AR-GE
Sheet: /MCU / bypass / reset / programlama/
File: 11_MCU_SUPPORT.kicad_sch
Title: MCU / bypass / reset / programlama

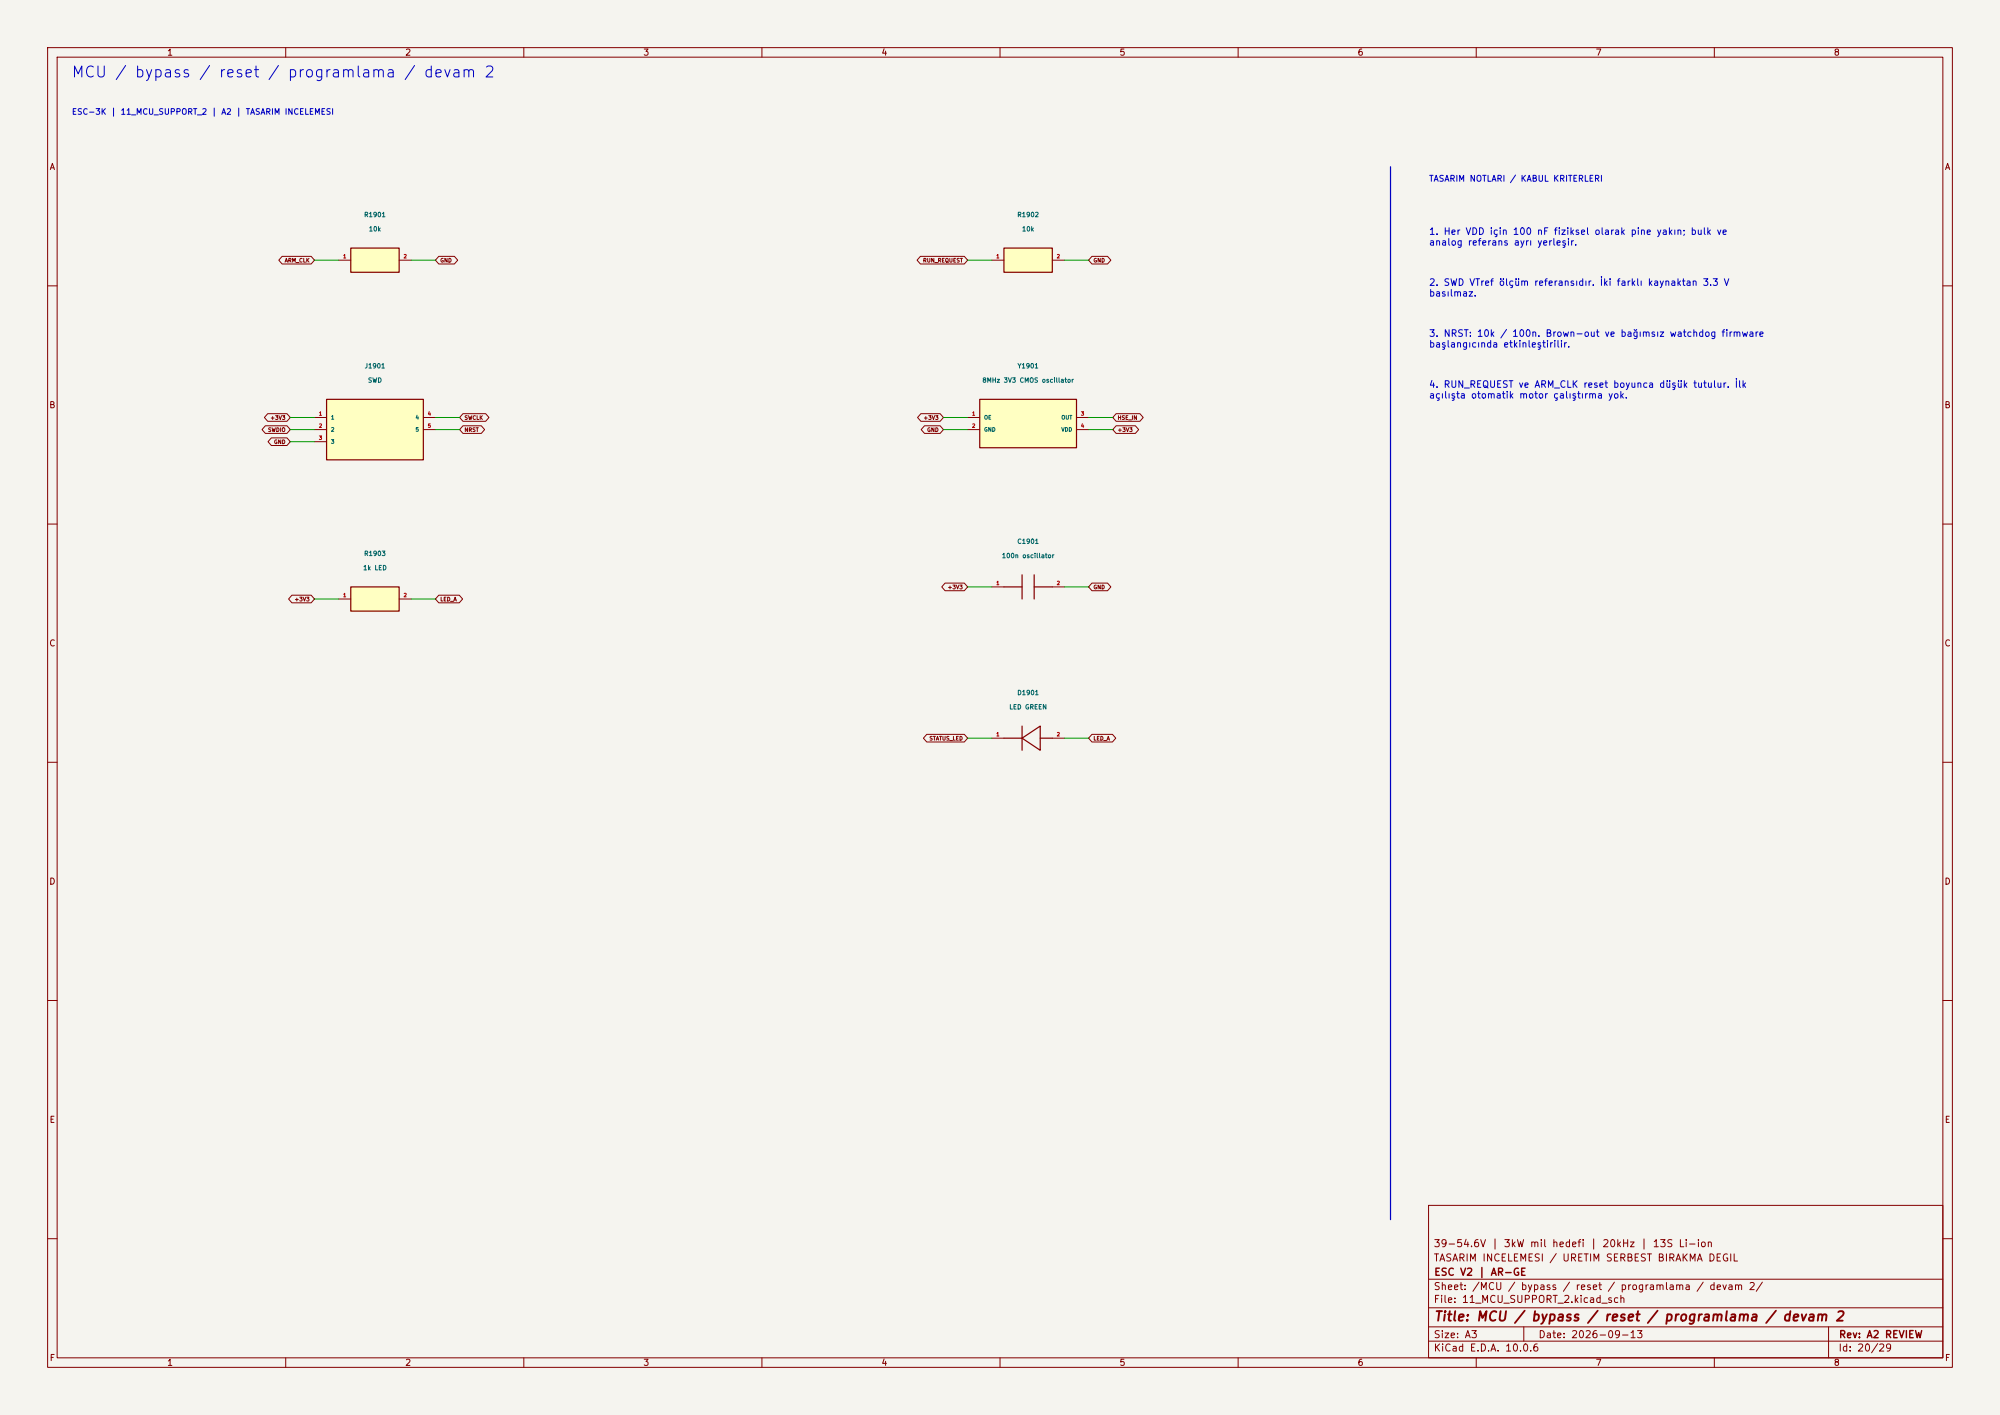
[picture p71: page 20]

SWCLK ESC-3K | 11_MCU_SUPPORT_2 | A2 | TASARIM INCELEMESI MCU / bypass / reset / programlama / devam 2

açılışta otomatik motor çalıştırma yok. 3. NRST: 10k / 100n. Brown-out ve bağımsız watchdog firmware başlangıcında etkinleştirilir. TASARIM NOTLARI / KABUL KRITERLERI

2. SWD VTref ölçüm referansıdır. İki farklı kaynaktan 3.3 V basılmaz. 1. Her VDD için 100 nF fiziksel olarak pine yakın; bulk ve analog referans ayrı yerleşir.

4. RUN_REQUEST ve ARM_CLK reset boyunca düşük tutulur. İlk

39-54.6V | 3kW mil hedefi | 20kHz | 13S Li-ion
TASARIM INCELEMESI / URETIM SERBEST BIRAKMA DEGIL
ESC V2 | AR-GE
Sheet: /MCU / bypass / reset / programlama / devam 2/
File: 11_MCU_SUPPORT_2.kicad_sch
Title: MCU / bypass / reset / programlama / devam 2

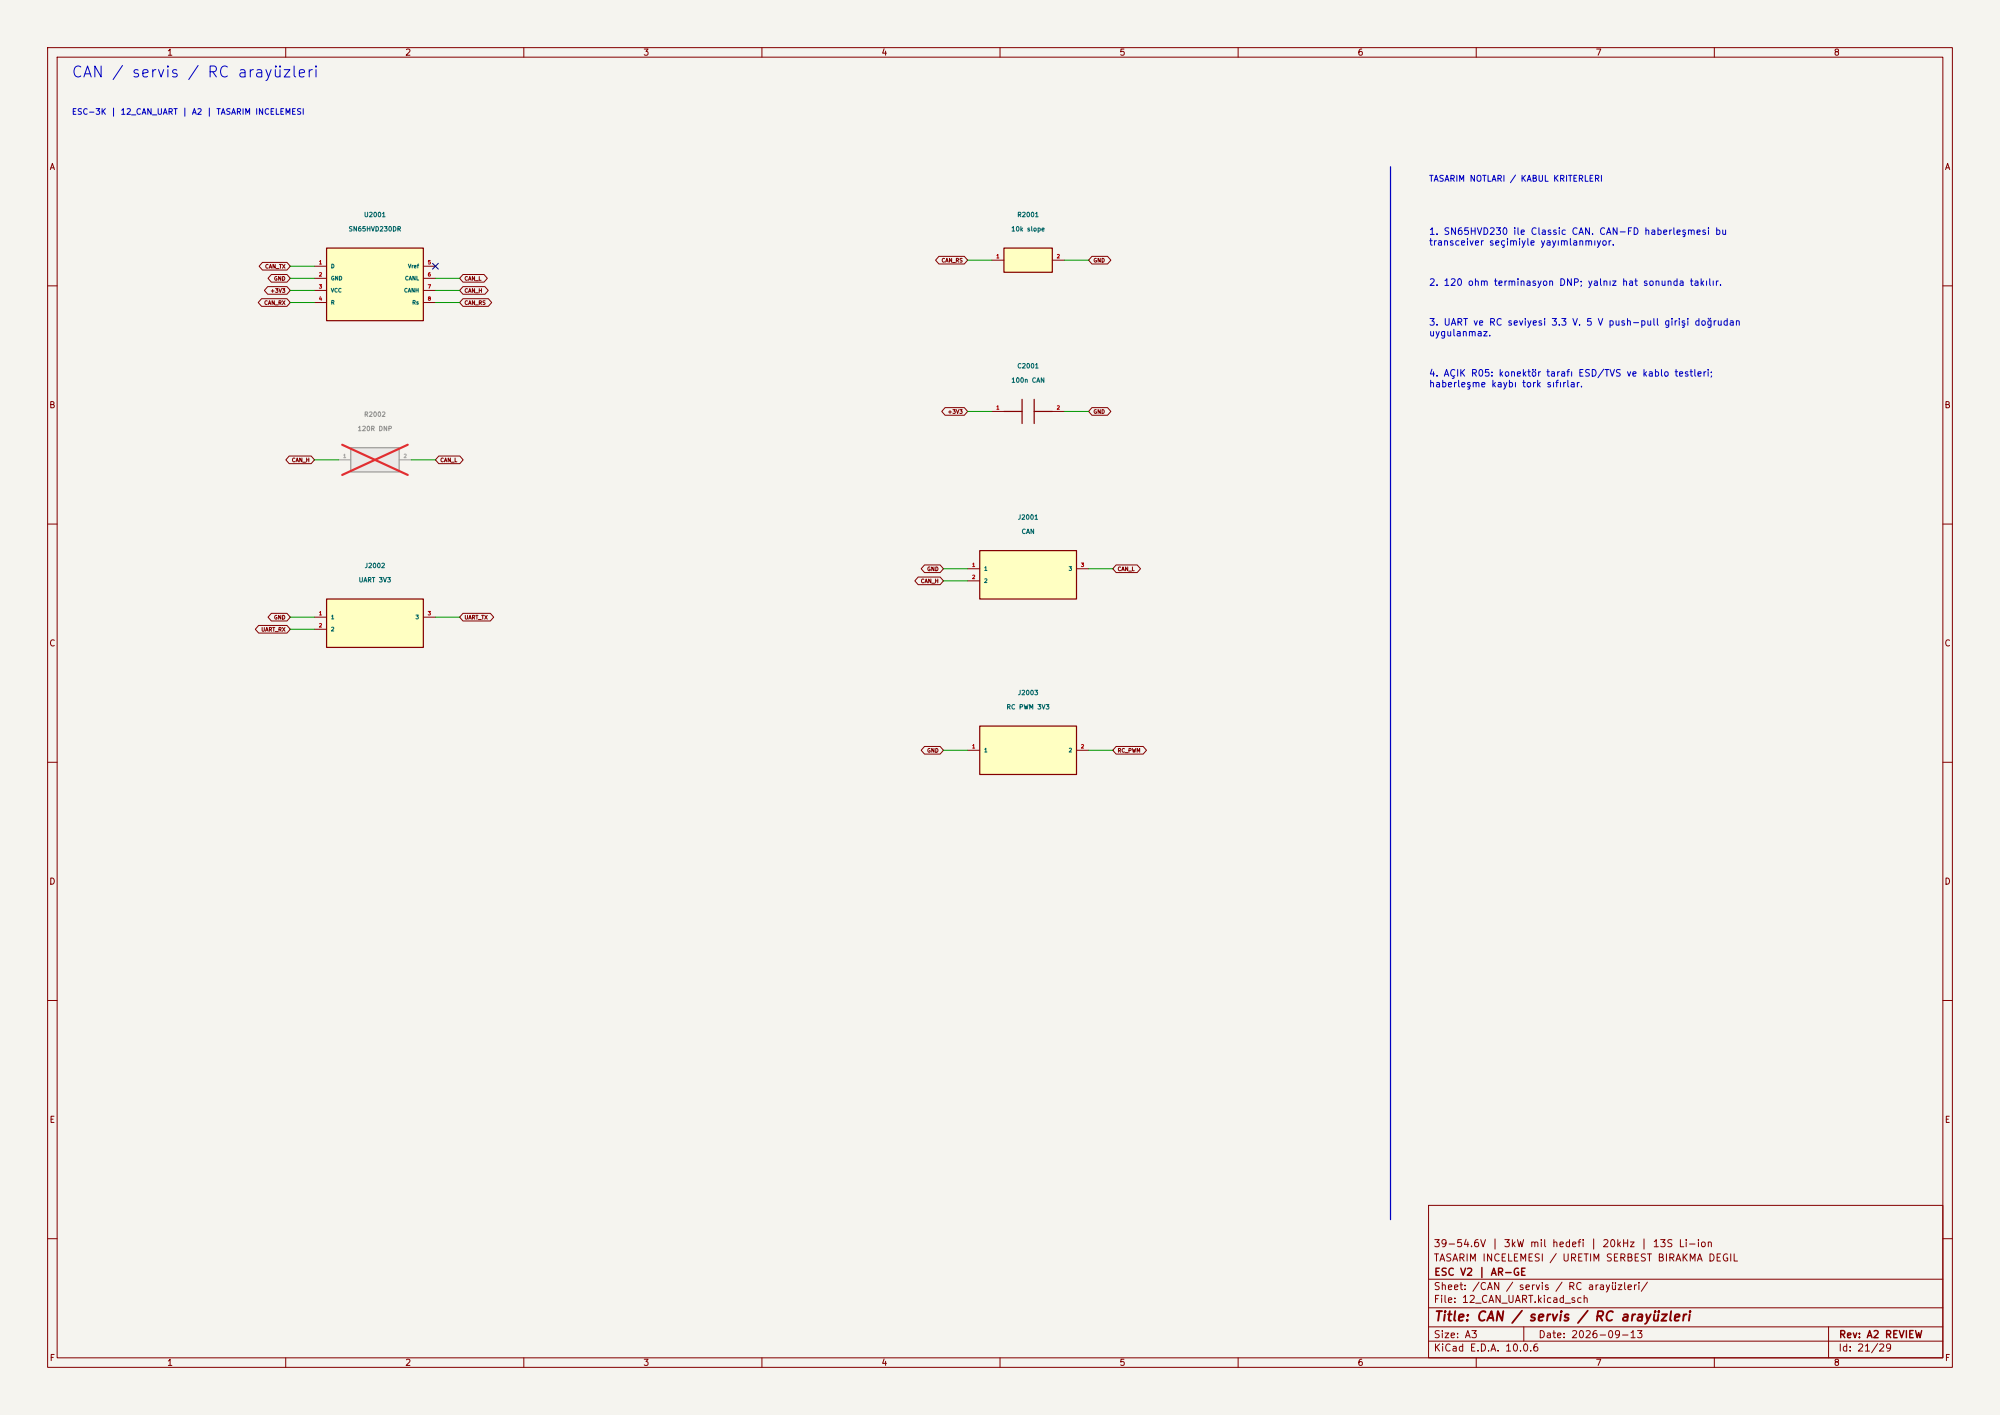
[picture p72: page 21]

haberleşme kaybı tork sıfırlar. TASARIM NOTLARI / KABUL KRITERLERI 1. SN65HVD230 ile Classic CAN. CAN-FD haberleşmesi bu

4. AÇIK R05: konektör tarafı ESD/TVS ve kablo testleri;

39-54.6V | 3kW mil hedefi | 20kHz | 13S Li-ion
TASARIM INCELEMESI / URETIM SERBEST BIRAKMA DEGIL
ESC V2 | AR-GE
Sheet: /CAN / servis / RC arayüzleri/
File: 12_CAN_UART.kicad_sch
Title: CAN / servis / RC arayüzleri

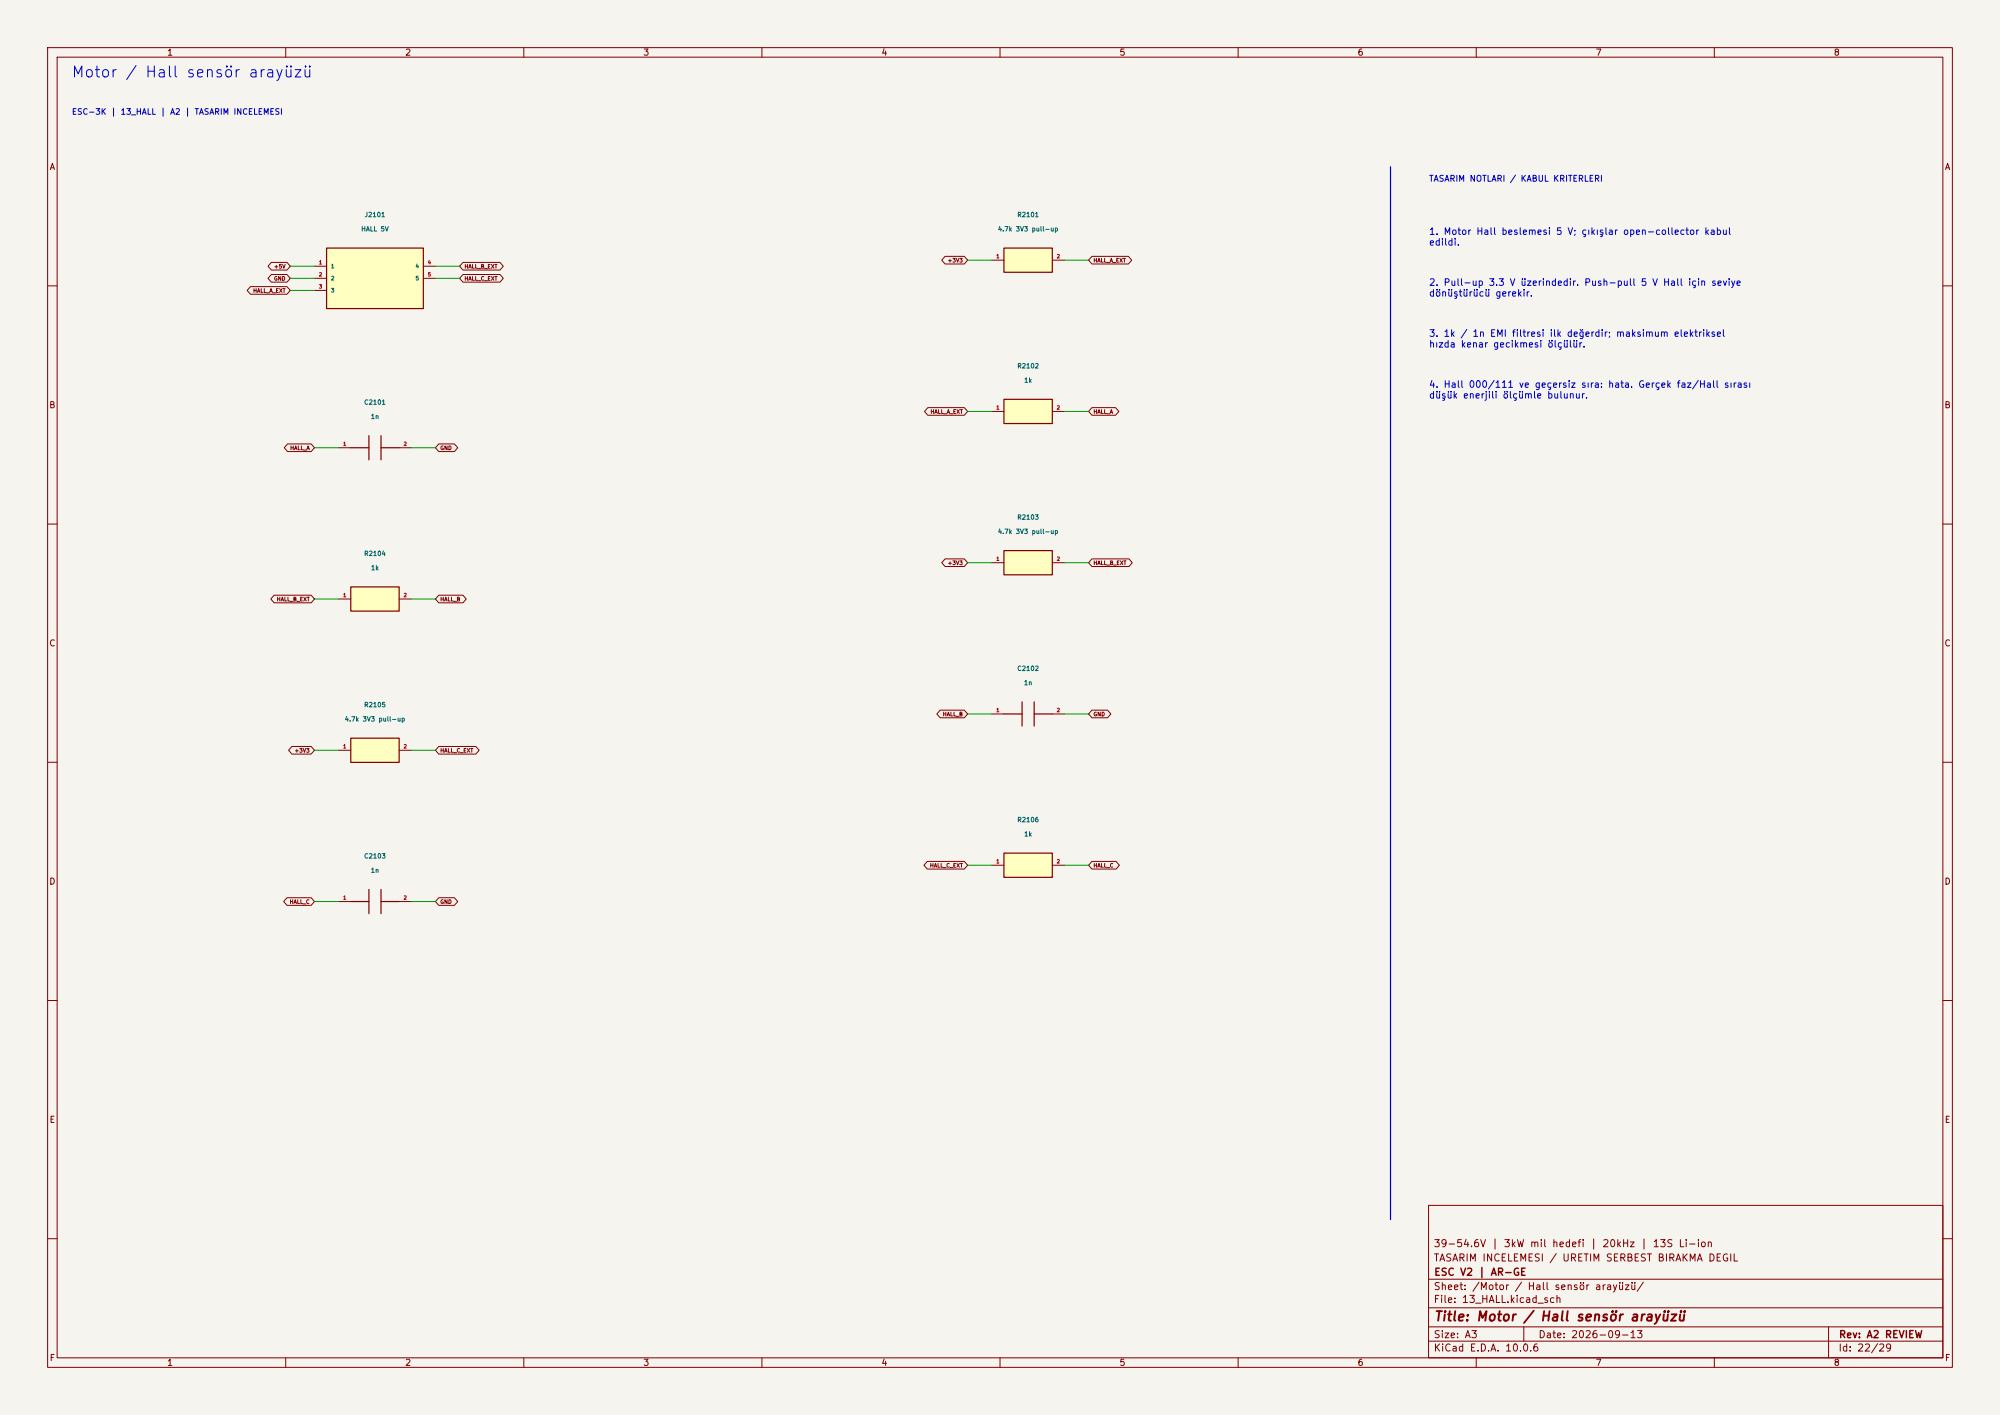
[picture p73: page 22]

ESC-3K | 13_HALL | A2 | TASARIM INCELEMESI Motor / Hall sensör arayüzü

4. Hall 000/111 ve geçersiz sıra: hata. Gerçek faz/Hall sırası düşük enerjili ölçümle bulunur. TASARIM NOTLARI / KABUL KRITERLERI 1. Motor Hall beslemesi 5 V; çıkışlar open-collector kabul edildi.

2. Pull-up 3.3 V üzerindedir. Push-pull 5 V Hall için seviye
dönüştürücü gerekir. 3. 1k / 1n EMI filtresi ilk değerdir; maksimum elektriksel hızda kenar gecikmesi ölçülür.

39-54.6V | 3kW mil hedefi | 20kHz | 13S Li-ion
TASARIM INCELEMESI / URETIM SERBEST BIRAKMA DEGIL
ESC V2 | AR-GE
Sheet: /Motor / Hall sensör arayüzü/
File: 13_HALL.kicad_sch
Title: Motor / Hall sensör arayüzü

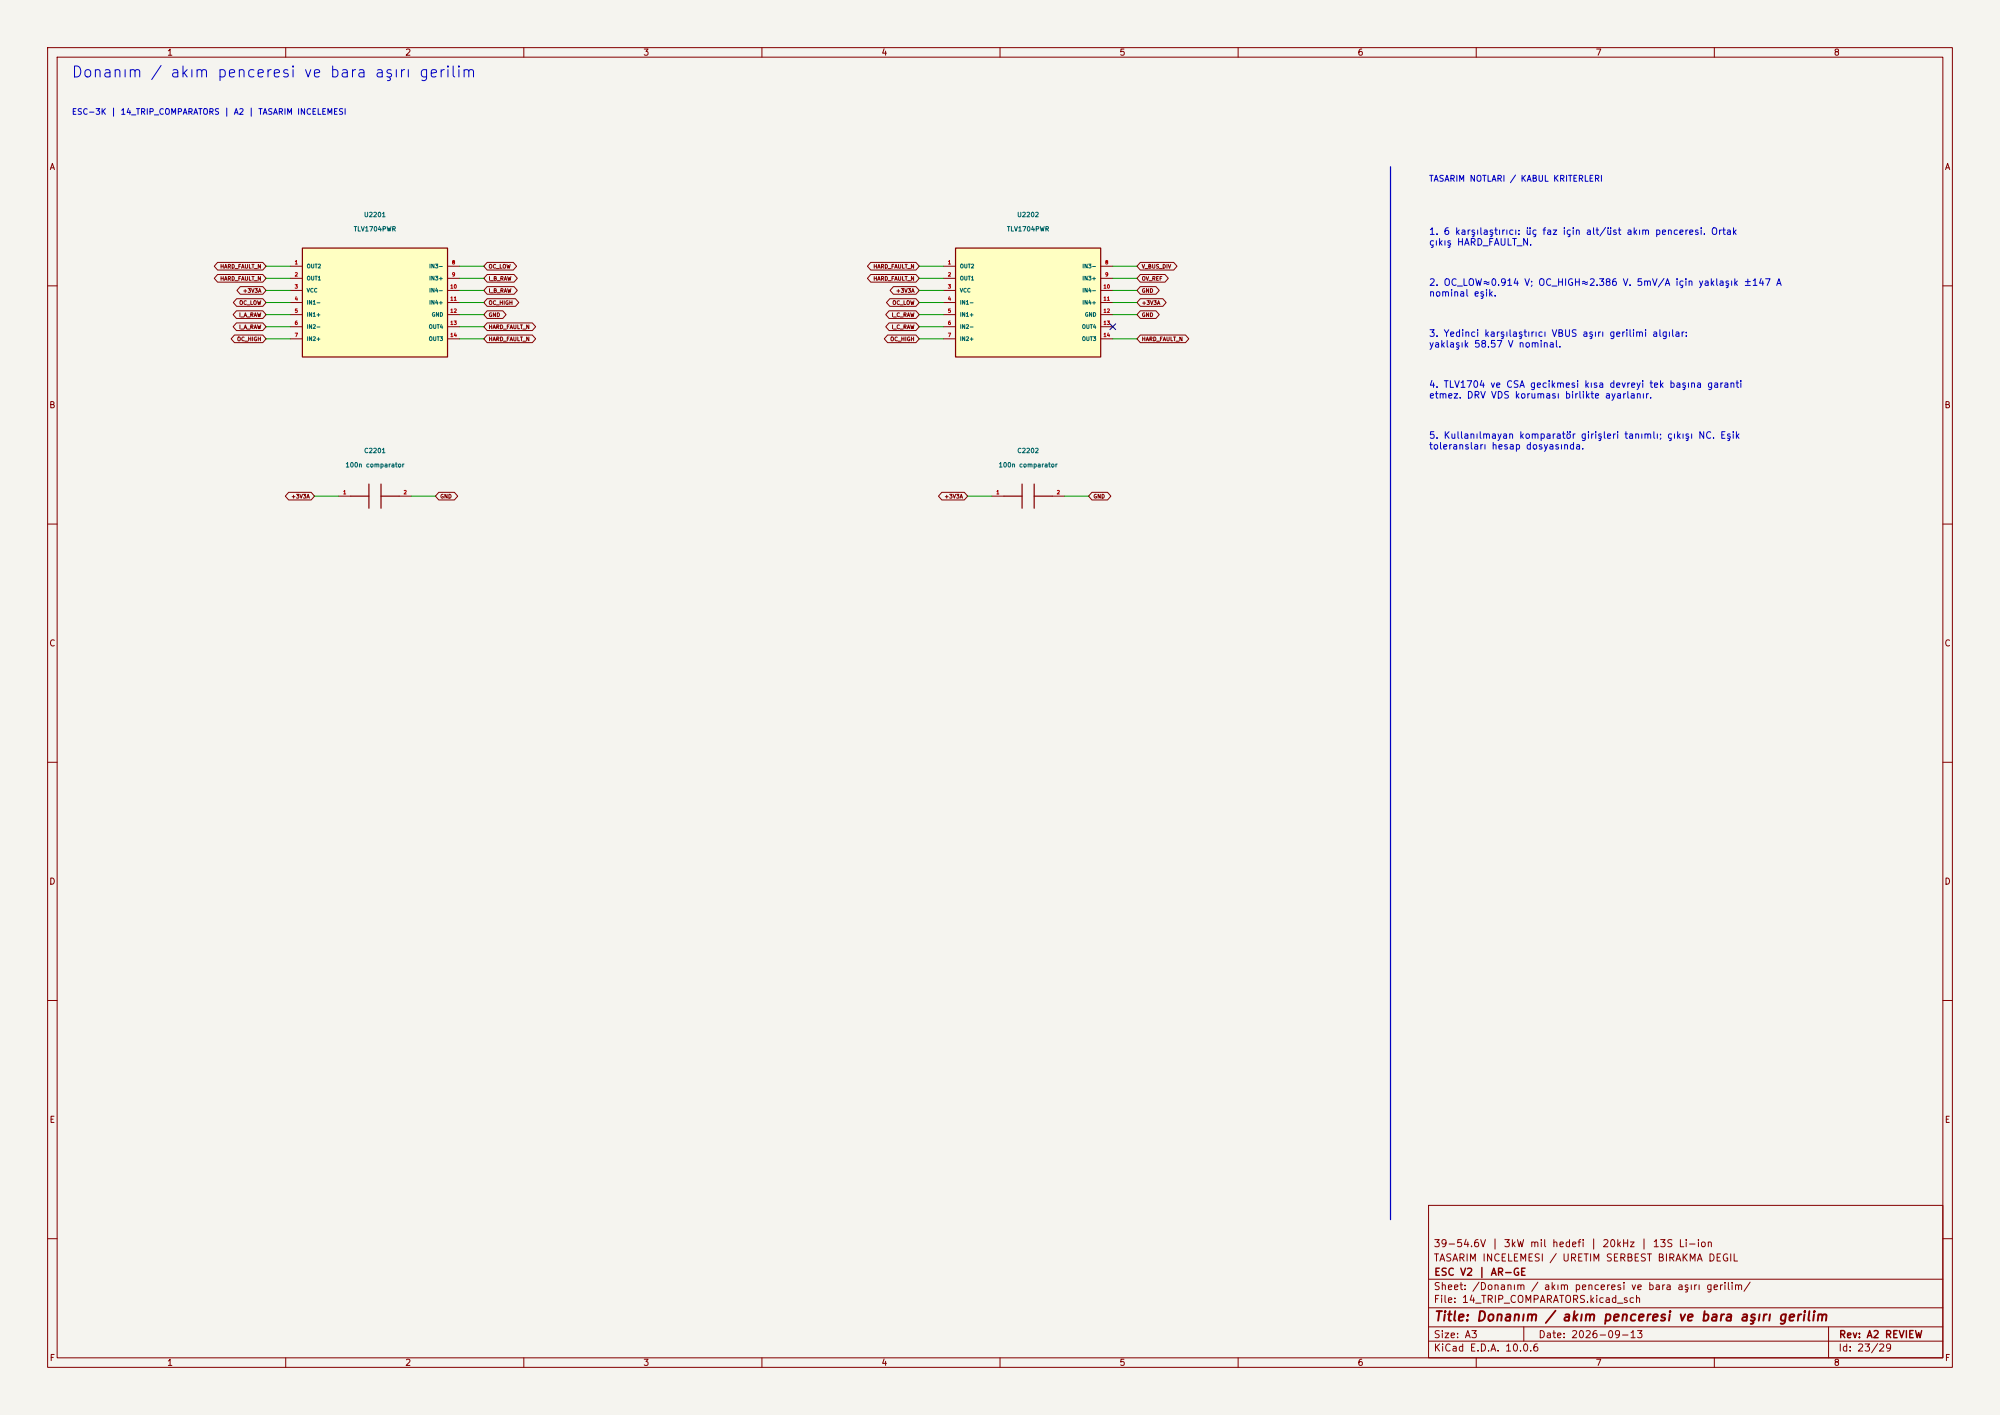
[picture p74: page 23]

Donanım / akım penceresi ve bara aşırı gerilim

yaklaşık 58.57 V nominal. 5. Kullanılmayan komparatör girişleri tanımlı; çıkışı NC. Eşik

39-54.6V | 3kW mil hedefi | 20kHz | 13S Li-ion
TASARIM INCELEMESI / URETIM SERBEST BIRAKMA DEGIL
ESC V2 | AR-GE
Sheet: /Donanım / akım penceresi ve bara aşırı gerilim/
File: 14_TRIP_COMPARATORS.kicad_sch
Title: Donanım / akım penceresi ve bara aşırı gerilim

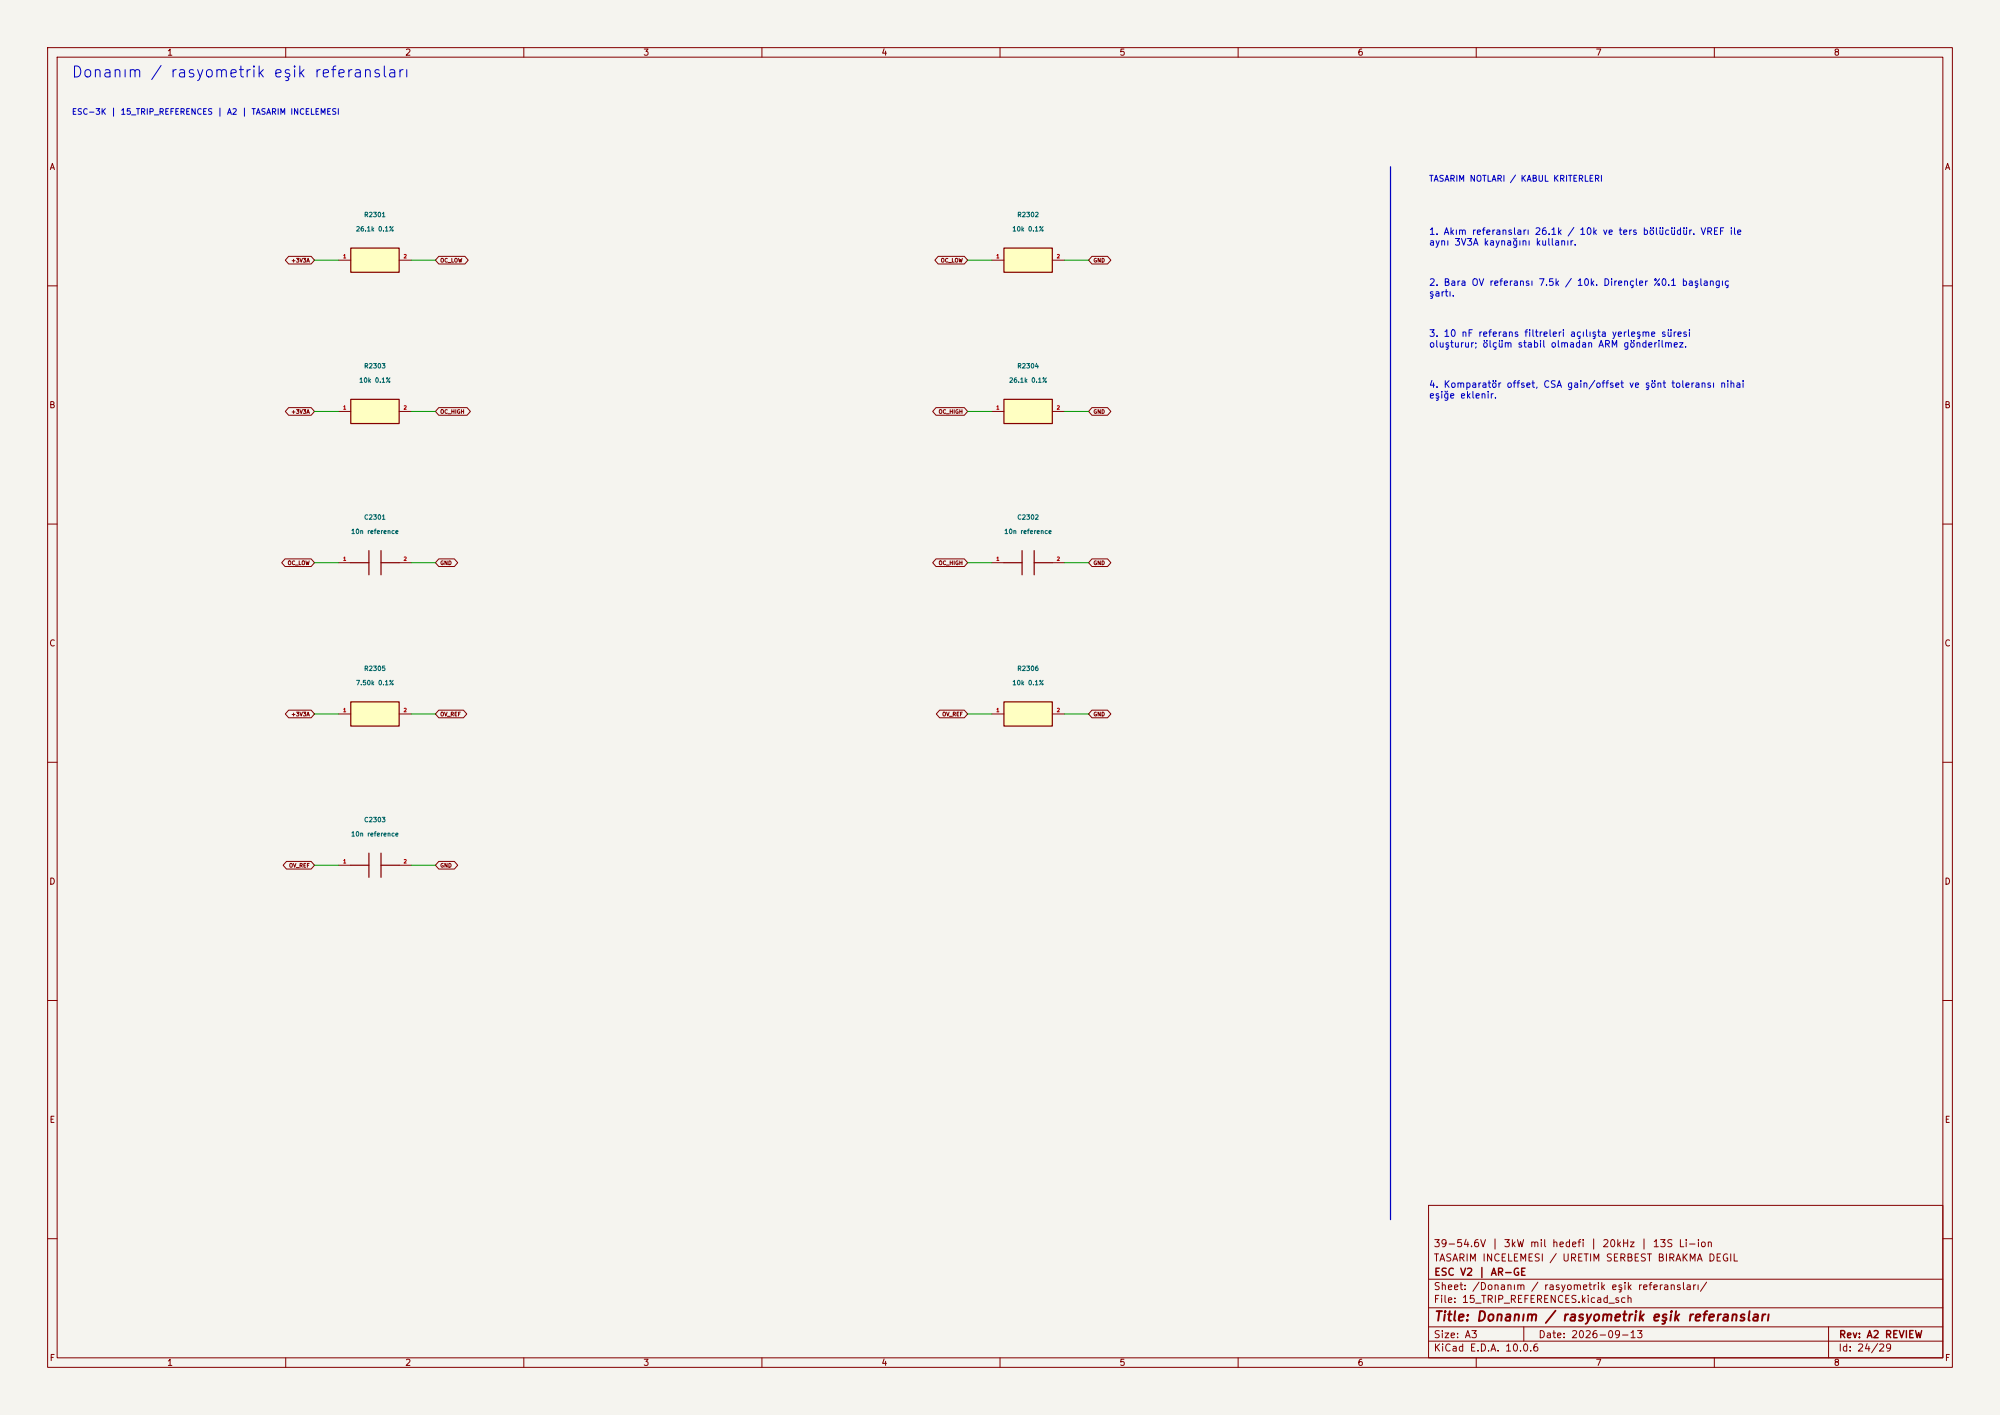
[picture p75: page 24]

4. Komparatör offset, CSA gain/offset ve şönt toleransı nihai eşiğe eklenir. TASARIM NOTLARI / KABUL KRITERLERI 1. Akım referansları 26.1k / 10k ve ters bölücüdür. VREF ile aynı 3V3A kaynağını kullanır.

şartı. 3. 10 nF referans filtreleri açılışta yerleşme süresi oluşturur; ölçüm stabil olmadan ARM gönderilmez.

39-54.6V | 3kW mil hedefi | 20kHz | 13S Li-ion
TASARIM INCELEMESI / URETIM SERBEST BIRAKMA DEGIL
ESC V2 | AR-GE
Sheet: /Donanım / rasyometrik eşik referansları/
File: 15_TRIP_REFERENCES.kicad_sch
Title: Donanım / rasyometrik eşik referansları

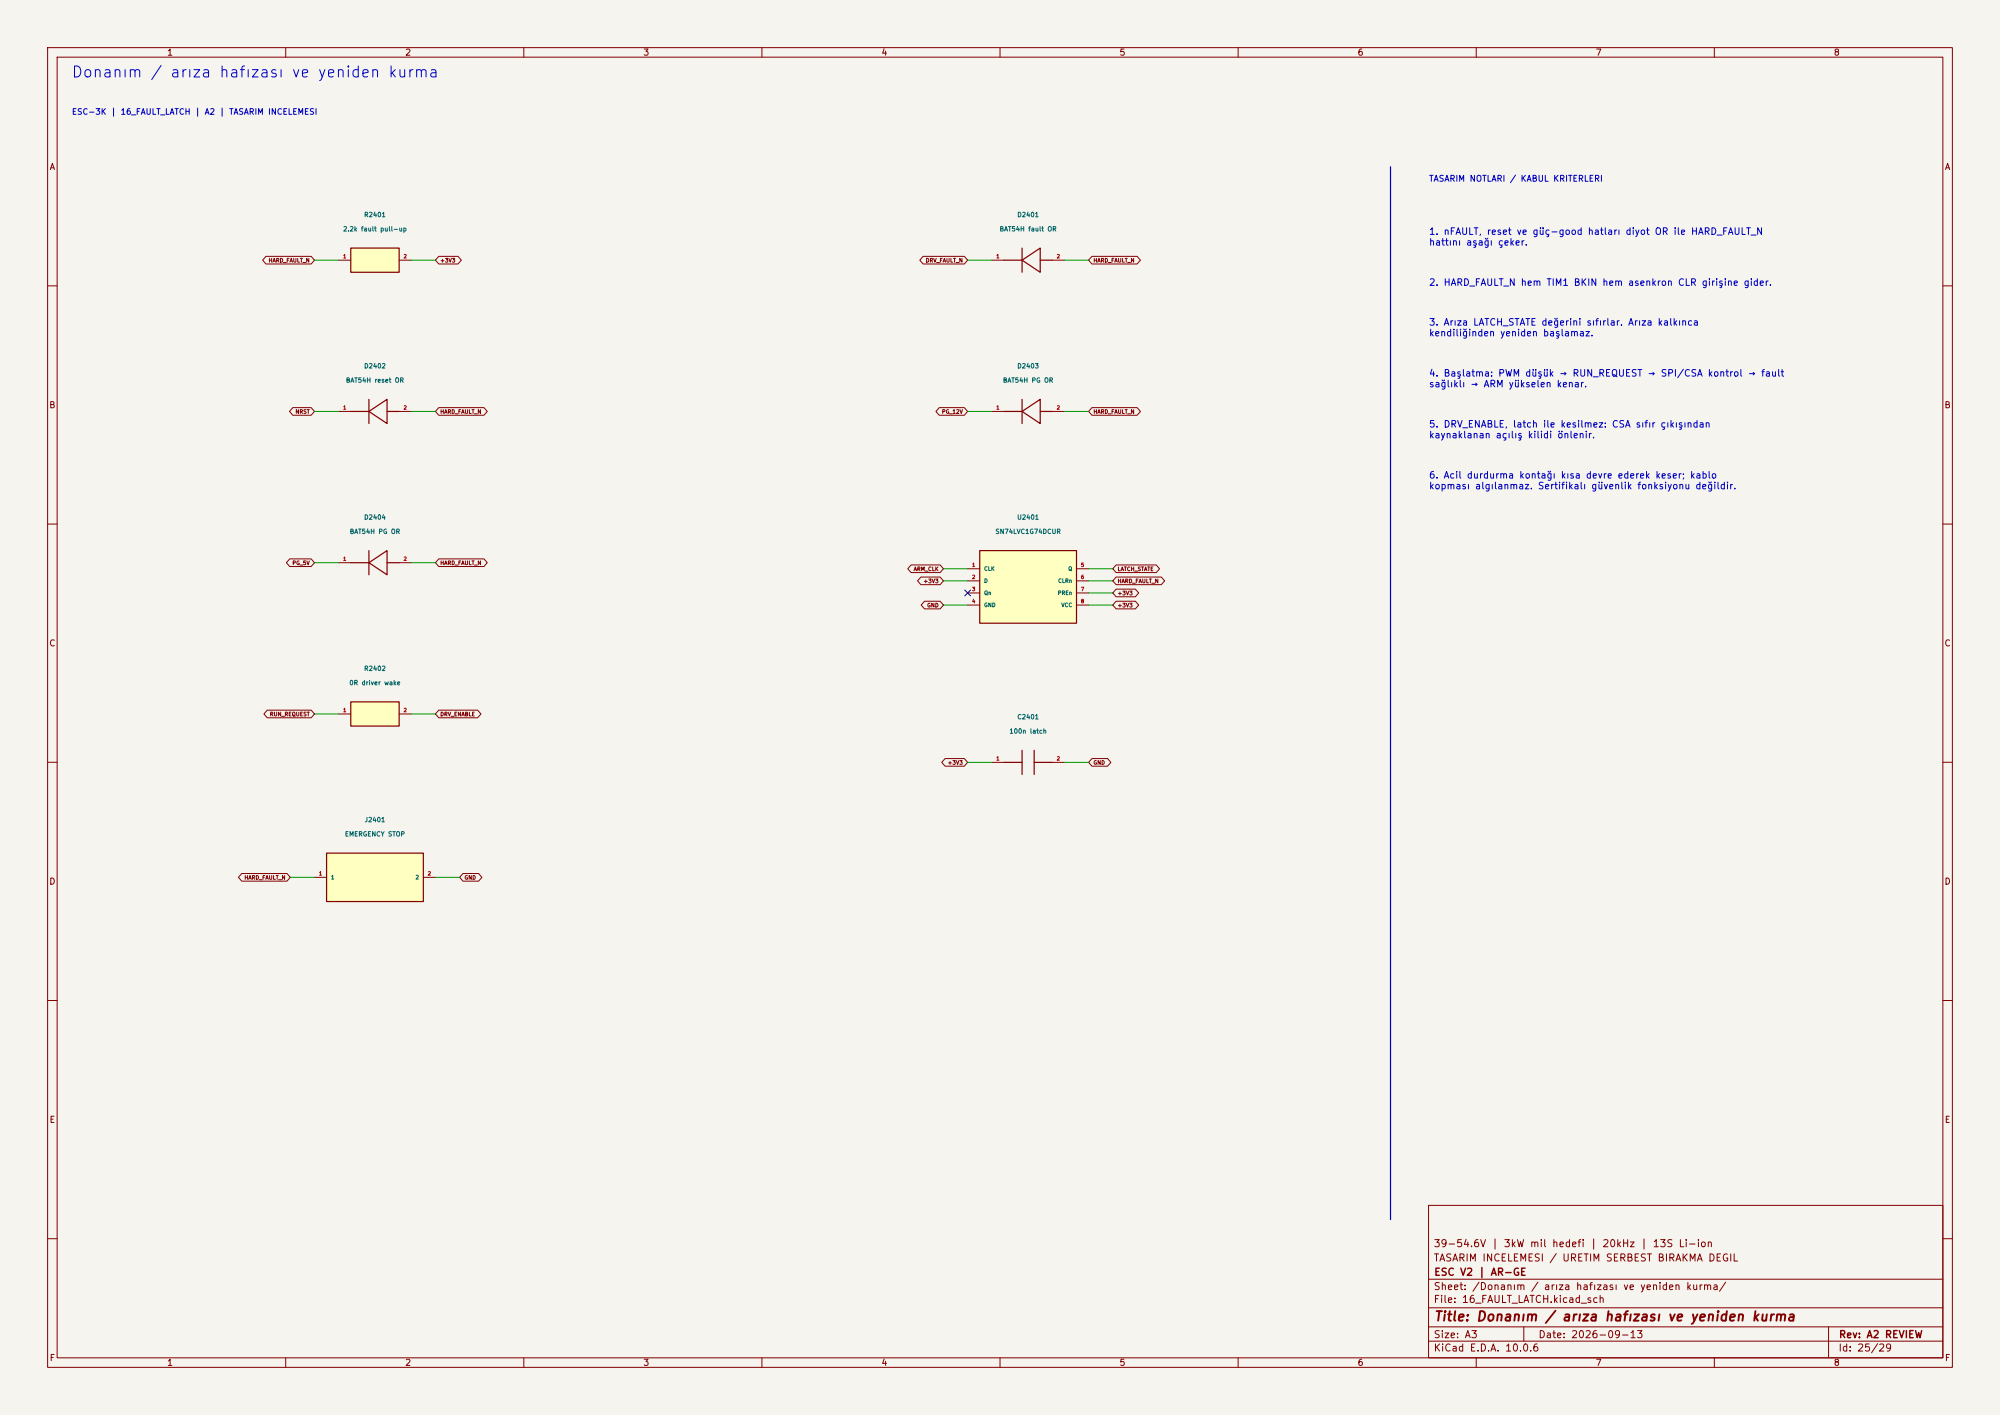
[picture p76: page 25]

kaynaklanan açılış kilidi önlenir. 1. nFAULT, reset ve güç-good hatları diyot OR ile HARD_FAULT_N
hattını aşağı çeker.

kendiliğinden yeniden başlamaz. 6. Acil durdurma kontağı kısa devre ederek keser; kablo

kopması algılanmaz. Sertifikalı güvenlik fonksiyonu değildir. 5. DRV_ENABLE, latch ile kesilmez: CSA sıfır çıkışından

39-54.6V | 3kW mil hedefi | 20kHz | 13S Li-ion
TASARIM INCELEMESI / URETIM SERBEST BIRAKMA DEGIL
ESC V2 | AR-GE
Sheet: /Donanım / arıza hafızası ve yeniden kurma/
File: 16_FAULT_LATCH.kicad_sch
Title: Donanım / arıza hafızası ve yeniden kurma

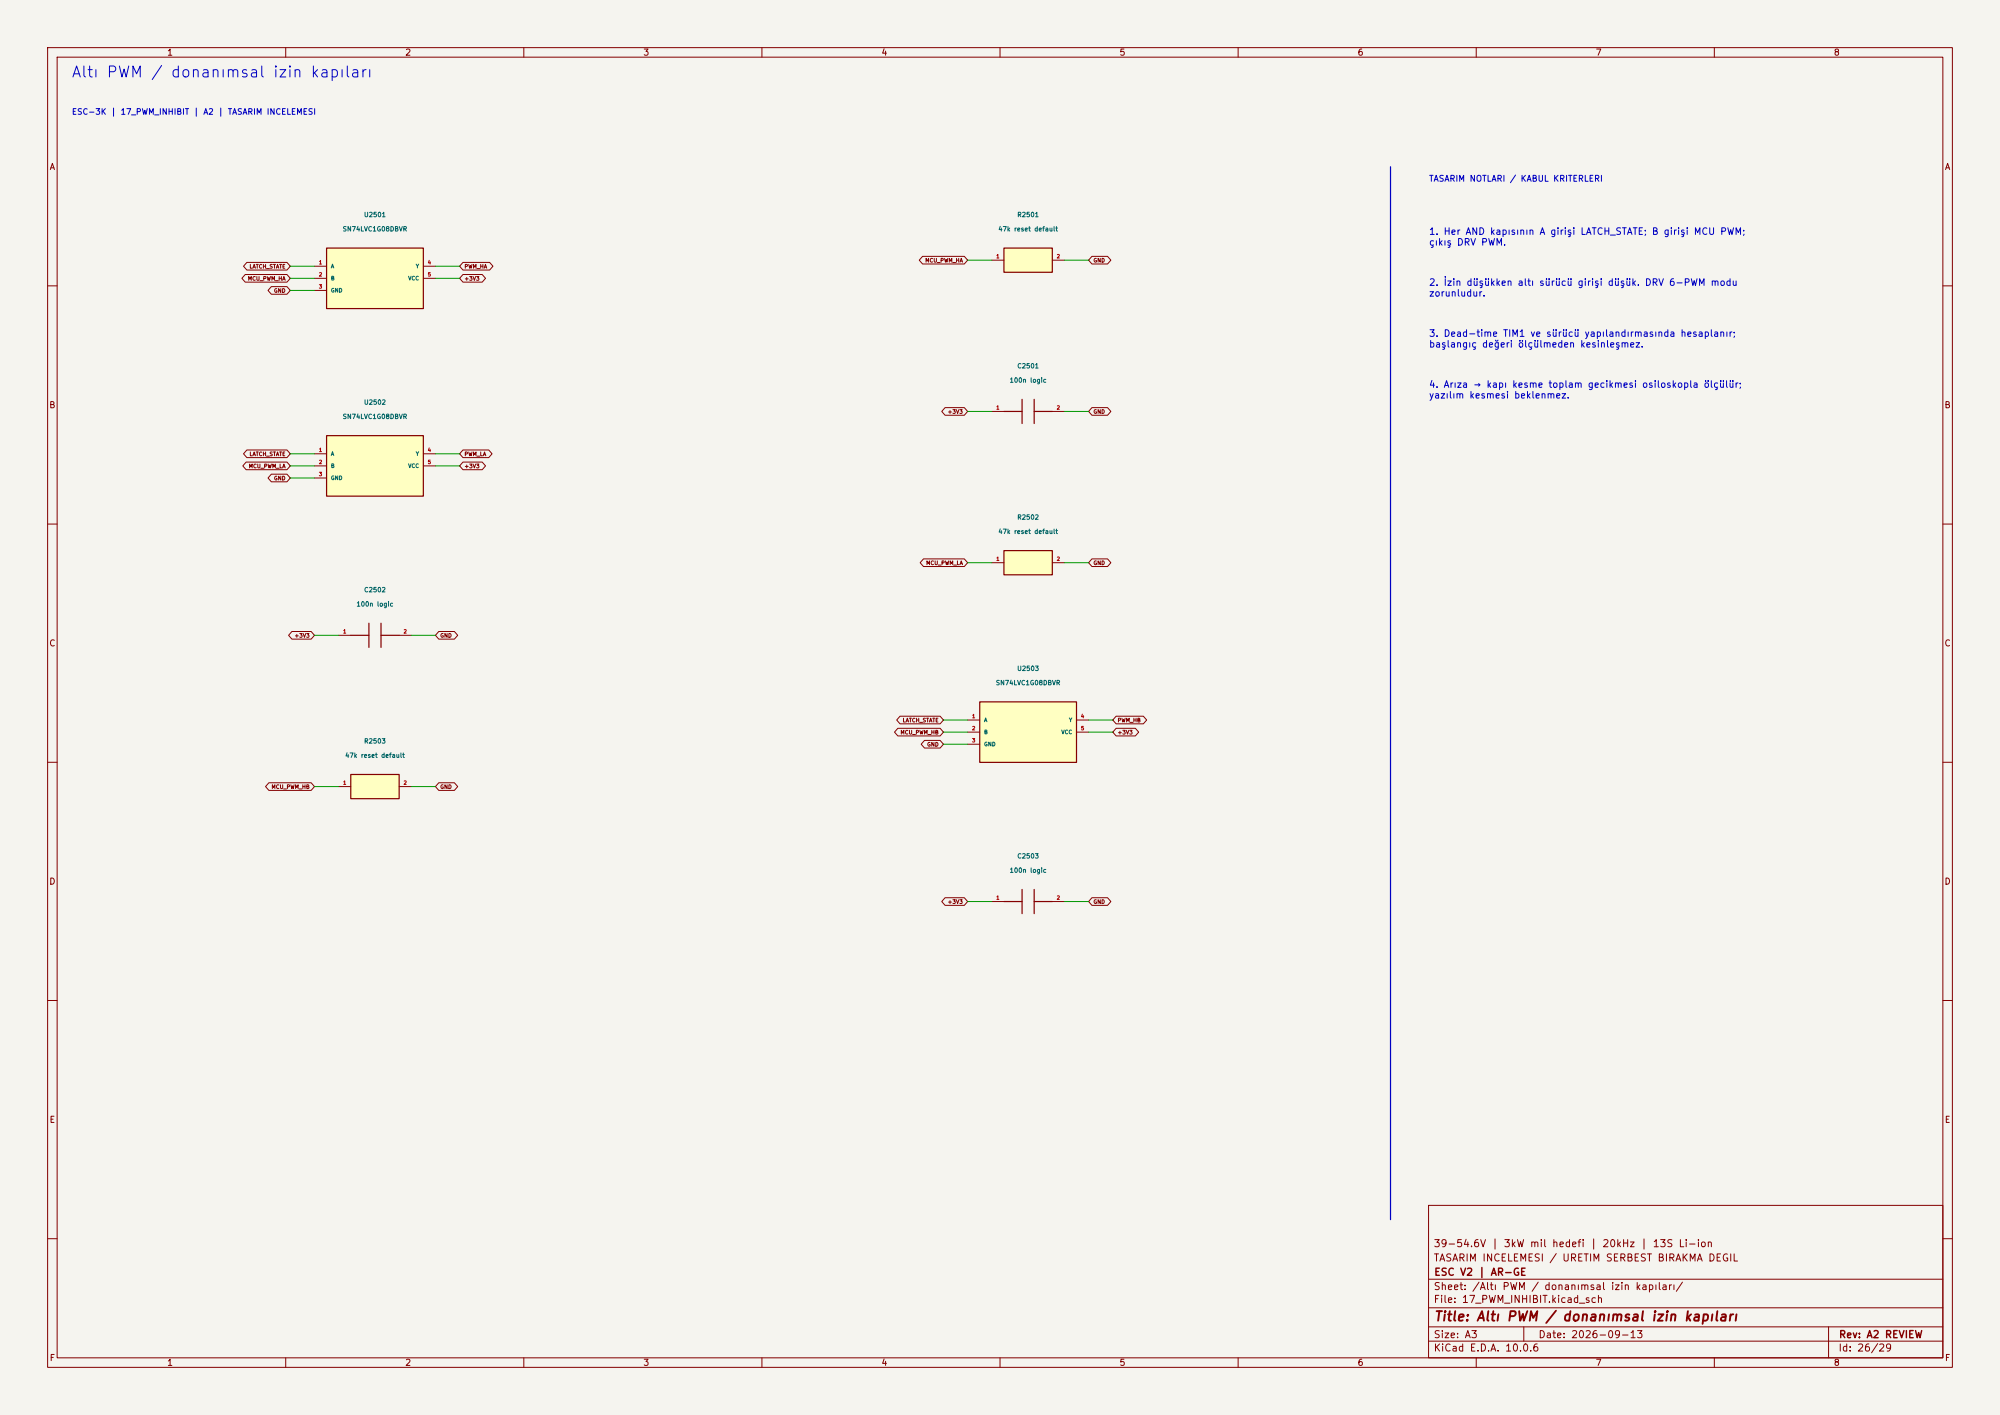
[picture p77: page 26]

başlangıç değeri ölçülmeden kesinleşmez. TASARIM NOTLARI / KABUL KRITERLERI ESC-3K | 17_PWM_INHIBIT | A2 | TASARIM INCELEMESI

zorunludur. 1. Her AND kapısının A girişi LATCH_STATE; B girişi MCU PWM;
çıkış DRV PWM. 4. Arıza → kapı kesme toplam gecikmesi osiloskopla ölçülür;

yazılım kesmesi beklenmez. 3. Dead-time TIM1 ve sürücü yapılandırmasında hesaplanır;

39-54.6V | 3kW mil hedefi | 20kHz | 13S Li-ion
TASARIM INCELEMESI / URETIM SERBEST BIRAKMA DEGIL
ESC V2 | AR-GE
Sheet: /Altı PWM / donanımsal izin kapıları/
File: 17_PWM_INHIBIT.kicad_sch
Title: Altı PWM / donanımsal izin kapıları

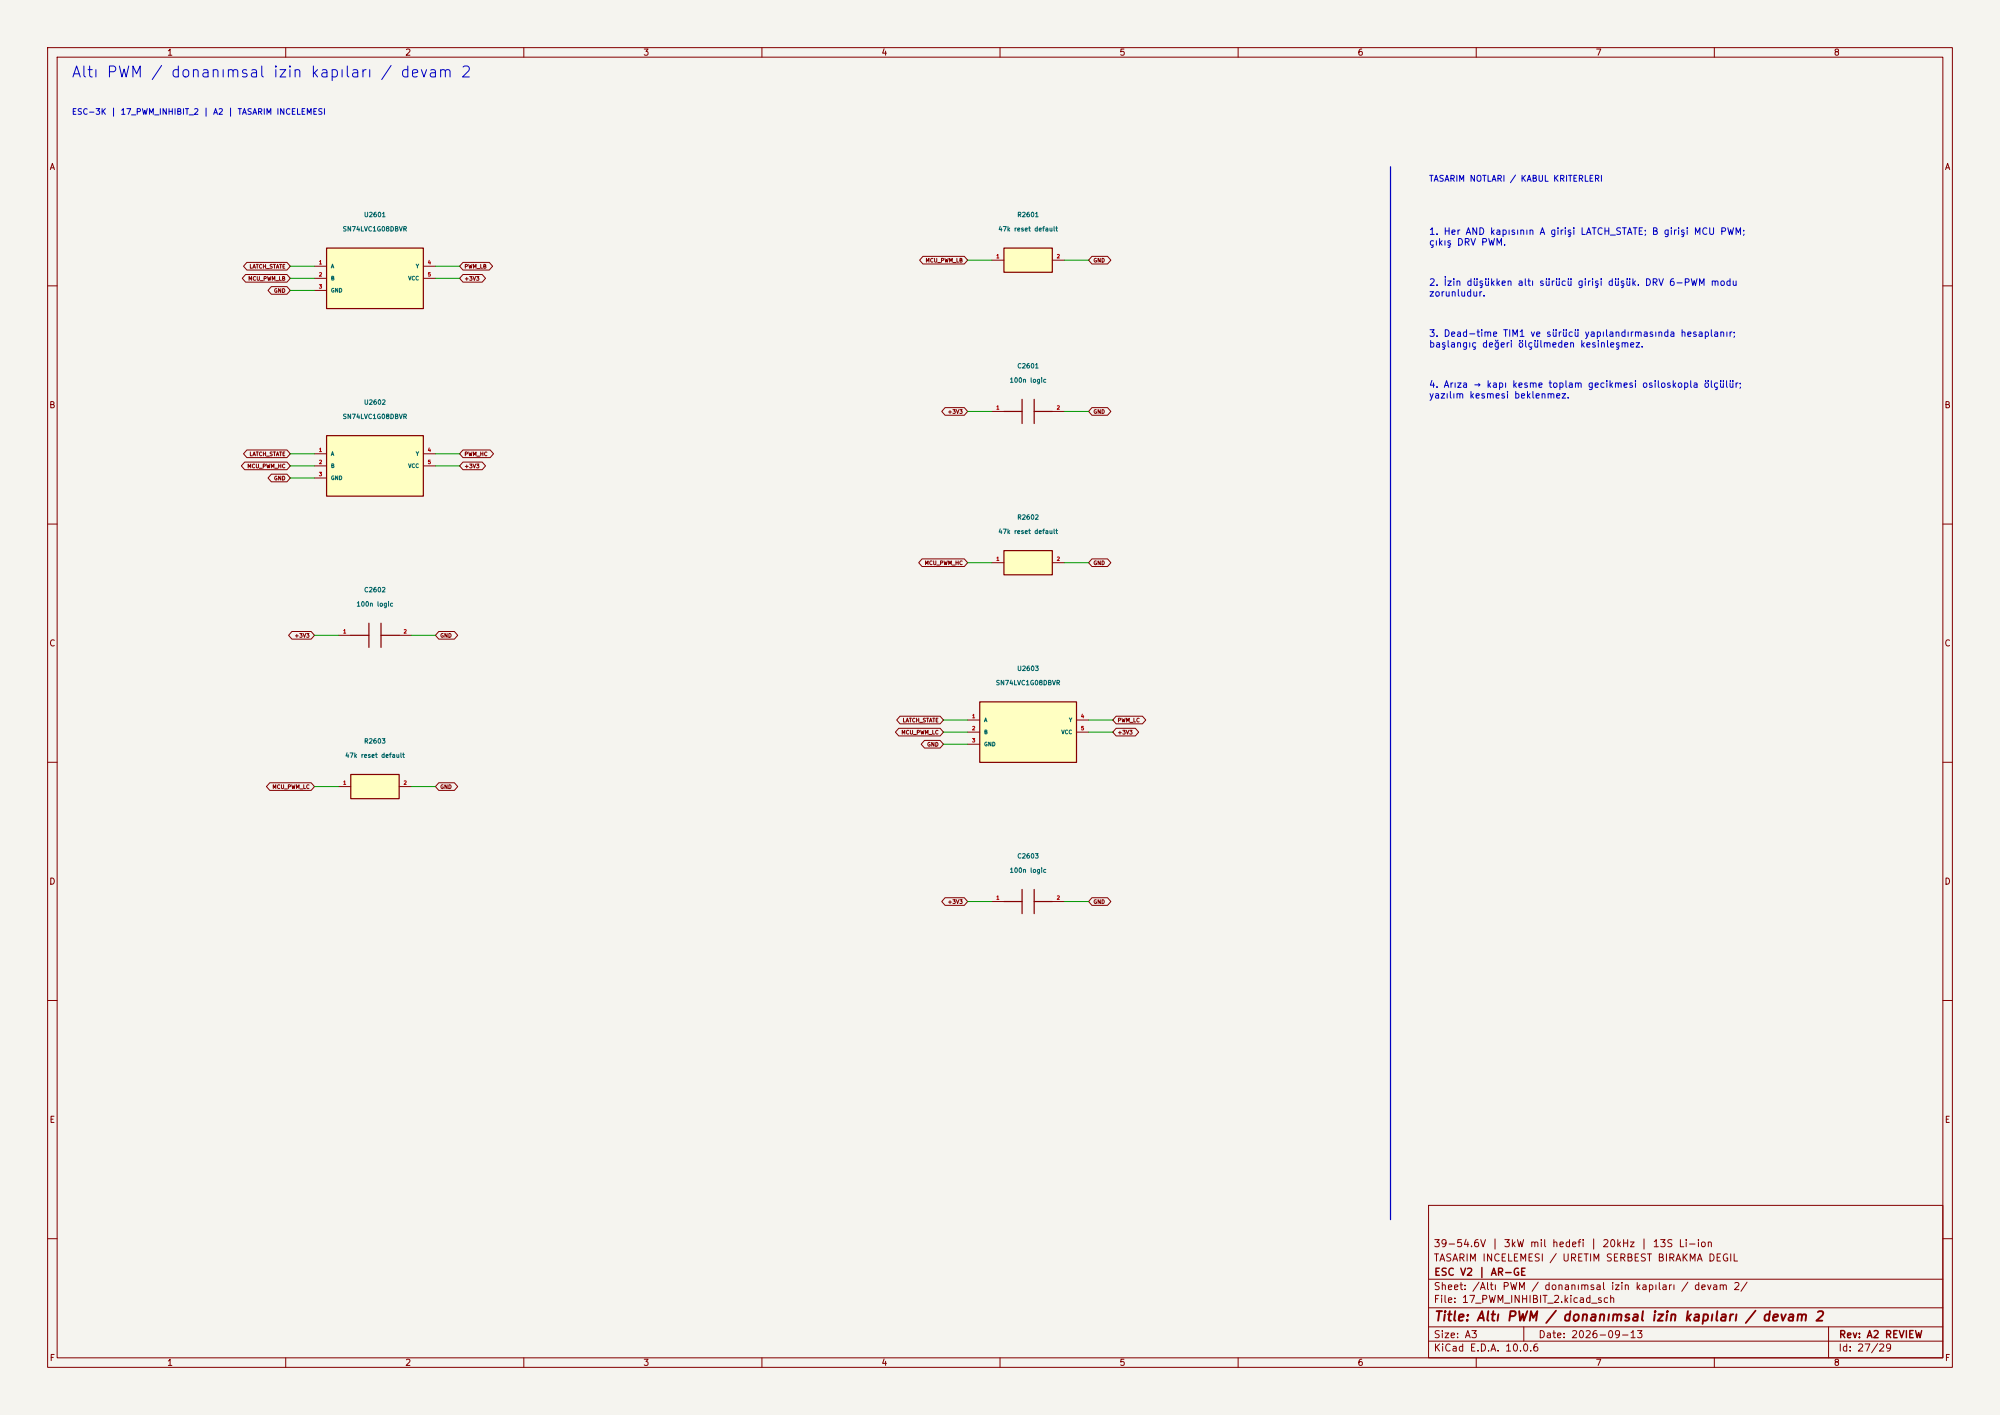
[picture p78: page 27]

GND Altı PWM / donanımsal izin kapıları / devam 2

başlangıç değeri ölçülmeden kesinleşmez. TASARIM NOTLARI / KABUL KRITERLERI ESC-3K | 17_PWM_INHIBIT_2 | A2 | TASARIM INCELEMESI

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

2. İzin düşükken altı sürücü girişi düşük. DRV 6-PWM modu

yazılım kesmesi beklenmez. 3. Dead-time TIM1 ve sürücü yapılandırmasında hesaplanır;

39-54.6V | 3kW mil hedefi | 20kHz | 13S Li-ion
TASARIM INCELEMESI / URETIM SERBEST BIRAKMA DEGIL
ESC V2 | AR-GE
Sheet: /Altı PWM / donanımsal izin kapıları / devam 2/
File: 17_PWM_INHIBIT_2.kicad_sch
Title: Altı PWM / donanımsal izin kapıları / devam 2

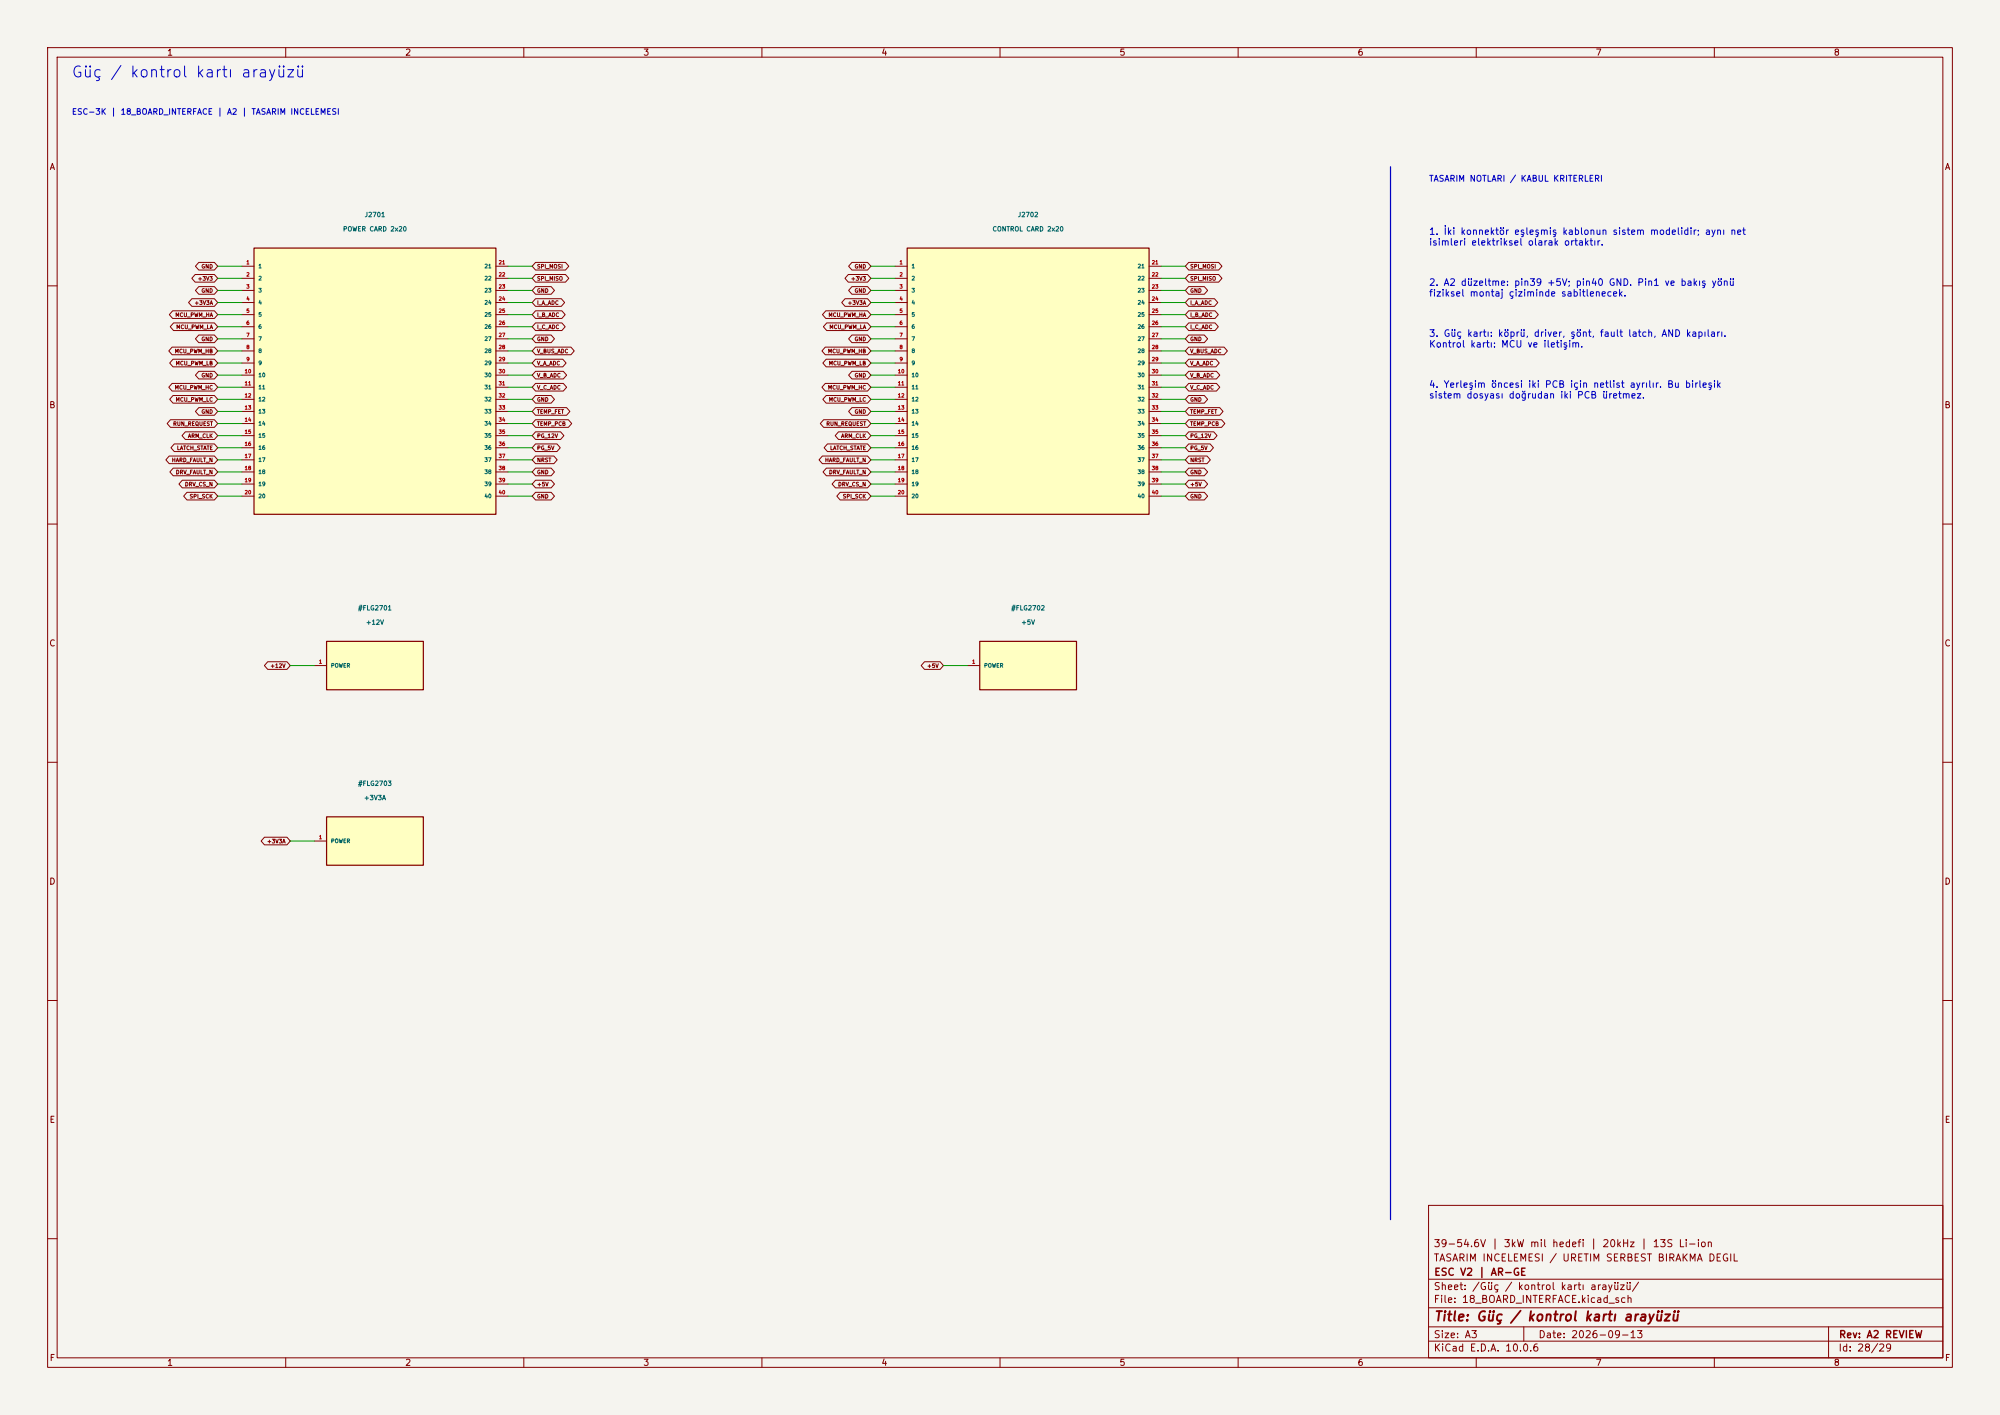
[picture p79: page 28]

fiziksel montaj çiziminde sabitlenecek. 1. İki konnektör eşleşmiş kablonun sistem modelidir; aynı net
isimleri elektriksel olarak ortaktır.

sistem dosyası doğrudan iki PCB üretmez. 3. Güç kartı: köprü, driver, şönt, fault latch, AND kapıları. Kontrol kartı: MCU ve iletişim. 2. A2 düzeltme: pin39 +5V; pin40 GND. Pin1 ve bakış yönü

39-54.6V | 3kW mil hedefi | 20kHz | 13S Li-ion
TASARIM INCELEMESI / URETIM SERBEST BIRAKMA DEGIL
ESC V2 | AR-GE
Sheet: /Güç / kontrol kartı arayüzü/
File: 18_BOARD_INTERFACE.kicad_sch
Title: Güç / kontrol kartı arayüzü

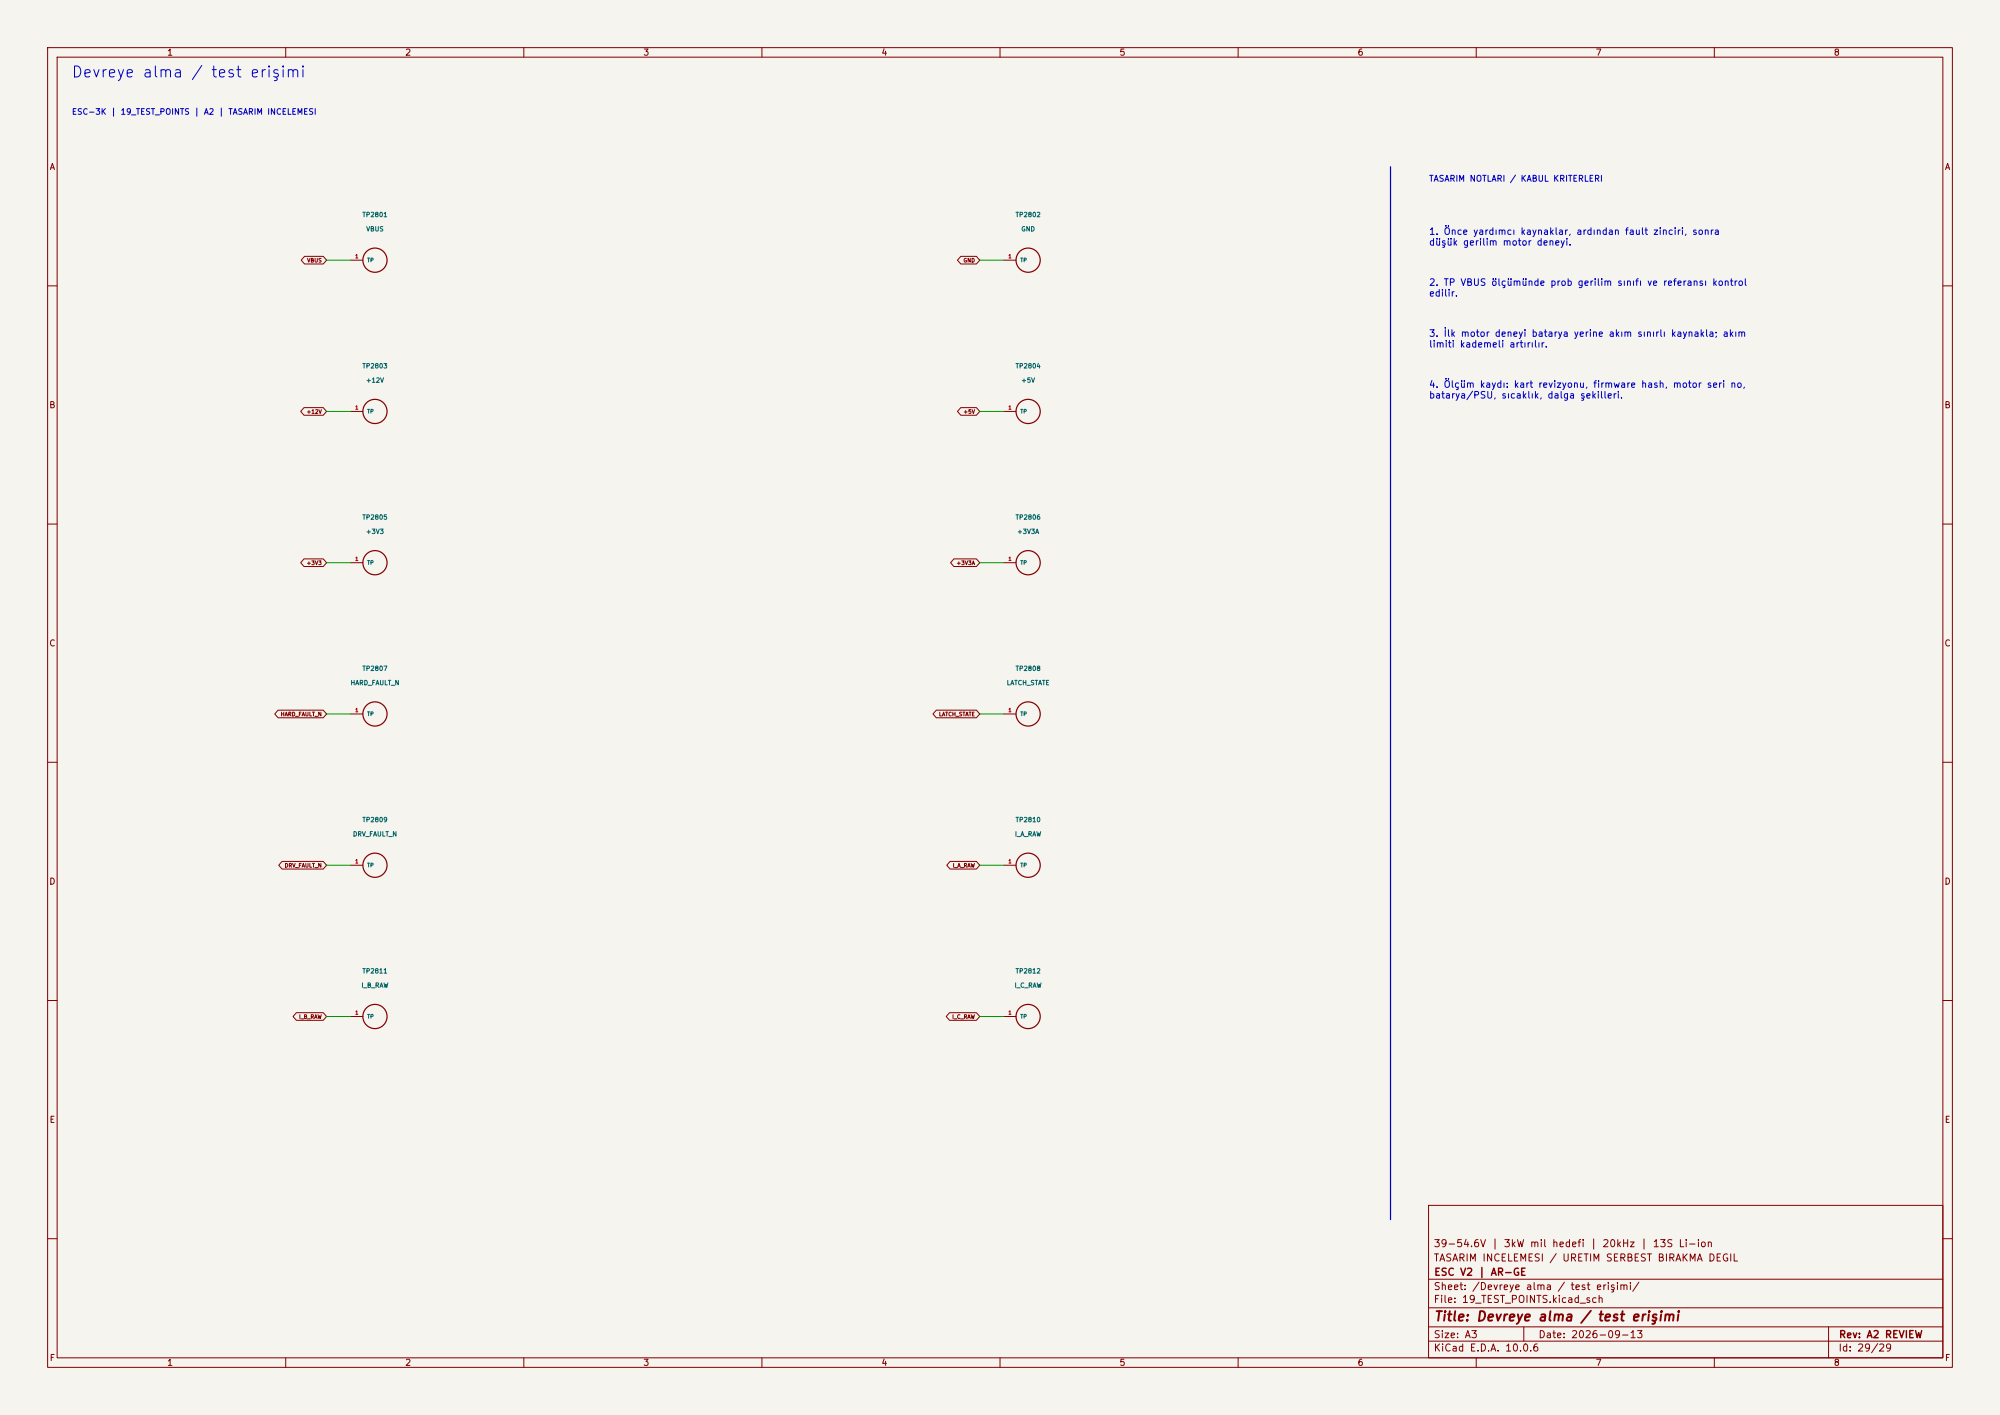
[picture p80: page 29]

Devreye alma / test erişimi

1. Önce yardımcı kaynaklar, ardından fault zinciri, sonra
düşük gerilim motor deneyi.

limiti kademeli artırılır. 2. TP VBUS ölçümünde prob gerilim sınıfı ve referansı kontrol edilir.

39-54.6V | 3kW mil hedefi | 20kHz | 13S Li-ion
TASARIM INCELEMESI / URETIM SERBEST BIRAKMA DEGIL
ESC V2 | AR-GE
Sheet: /Devreye alma / test erişimi/
File: 19_TEST_POINTS.kicad_sch
Title: Devreye alma / test erişimi
