mekiciepcas/ESC-Ai/(list of files, drawings)

Other design files:
ESC_V2/planning/SCHEMATIC_REVISION_MANIFEST.template.json
ESC_V2/planning/SCHEMATIC_REVISION_REGISTER.json
