mekiciepcas/ESC-Ai/ESC_V2/pcb_b1/control/ESC_3kW_CONTROL_B1_PLACEMENT.kicad_pcb

## KiCad design ESC_V2/pcb_b1/control/ESC_3kW_CONTROL_B1_PLACEMENT.kicad_pcb (2026-09-18)

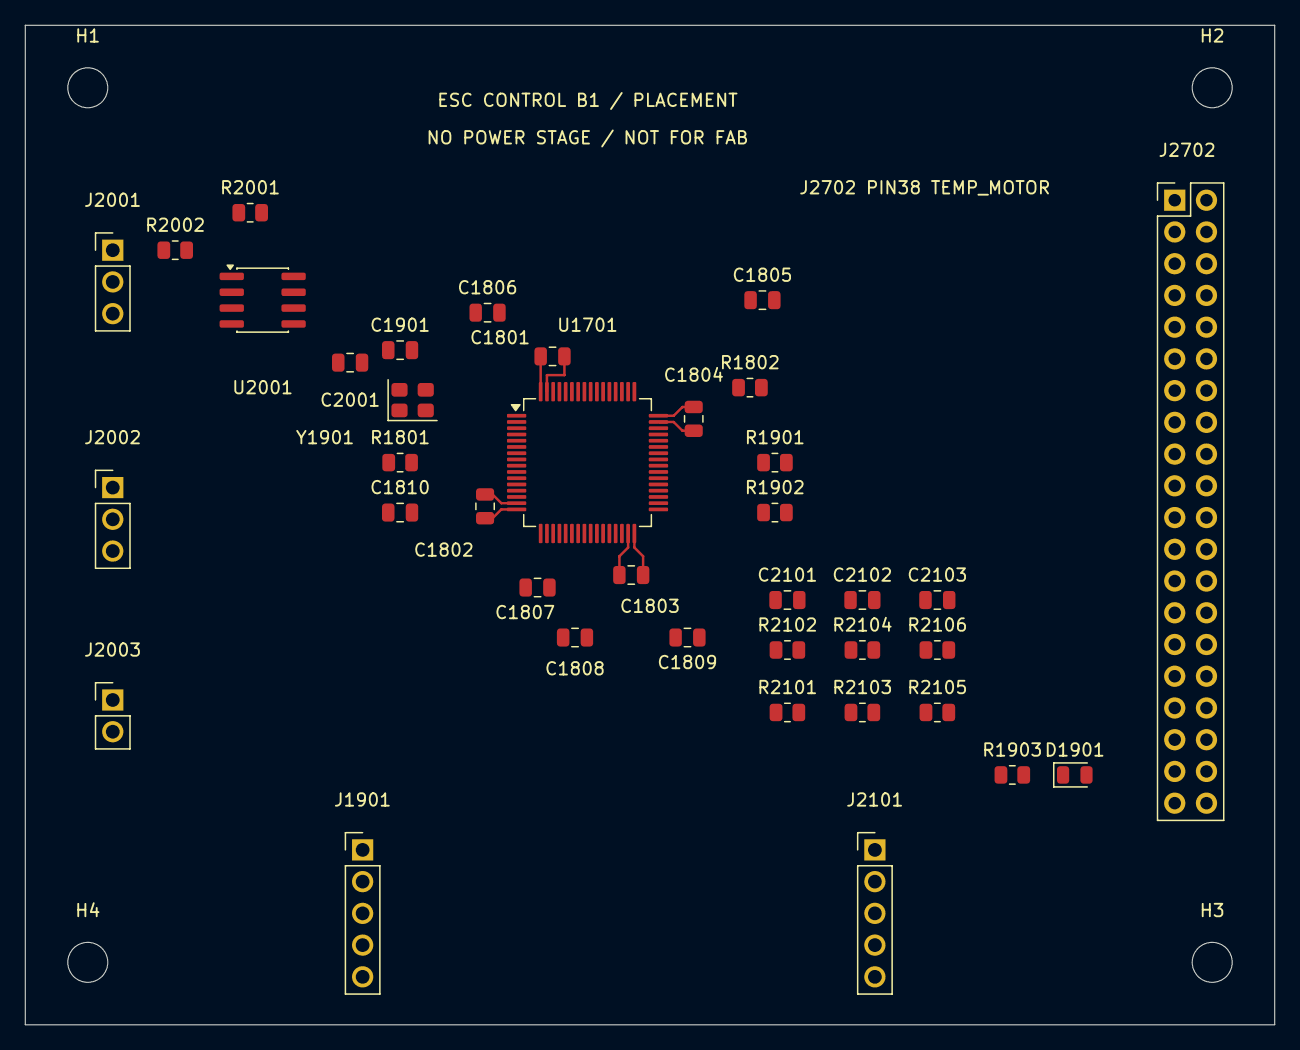
[picture p81: board ESC_3kW_CONTROL_B1_PLACEMENT.kicad_pcb from above]

Board: 4 copper layers, 100.0 x 80.0 mm, 42 parts (0 on the bottom side), 52 nets.

Parts:
C1801, C1802, C1803, C1804: 100n at VDD; C_0805_2012Metric
C1805: 4.7u; C_0805_2012Metric
C1806: 100n at VBAT; C_0805_2012Metric
C1807: 1u VDDA; C_0805_2012Metric
C1808: 100n VDDA; C_0805_2012Metric
C1809: 100n VREF; C_0805_2012Metric
C1810: 100n reset; C_0805_2012Metric
C1901: 100n oscillator; C_0805_2012Metric
C2001: 100n CAN; C_0805_2012Metric
C2101, C2102, C2103: 1n; C_0805_2012Metric
D1901: LED GREEN; LED_0805_2012Metric
H1, H2, H3, H4: MountingHole_3.2mm_M3
J1901: SWD; WE_61300511121_1x05_P2.54_Drill1.10
J2001: CAN; WE_61300311121_1x03_P2.54_Drill1.10
J2002: UART 3V3; WE_61300311121_1x03_P2.54_Drill1.10
J2003: RC PWM 3V3; WE_61300211121_1x02_P2.54_Drill1.10
J2101: HALL 5V; WE_61300511121_1x05_P2.54_Drill1.10
J2702: CONTROL CARD 2x20; PinHeader_2x20_P2.54mm_Vertical
R1801, R1901, R1902: 10k; R_0805_2012Metric
R1802: 10k BOOT0; R_0805_2012Metric
R1903: 1k LED; R_0805_2012Metric
R2001: 10k slope; R_0805_2012Metric
R2002: 120R DNP; R_0805_2012Metric
R2101, R2103, R2105: 4.7k 3V3 pull-up; R_0805_2012Metric
R2102, R2104, R2106: 1k; R_0805_2012Metric
U1701: STM32G474RET3; LQFP-64_10x10mm_P0.5mm
U2001: SN65HVD230DR; SOIC-8_3.9x4.9mm_P1.27mm
Y1901: 8MHz 3V3 CMOS oscillator; Oscillator_SMD_Abracon_ASE-4Pin_3.2x2.5mm

Connections:
+3V3: C1801.1, C1802.1, C1803.1, C1804.1, C1805.1, C1806.1, C1901.1, C2001.1, J1901.1, J2702.2, R1801.2, R1903.1, R2101.1, R2103.1, R2105.1, U1701.1, U1701.16, U1701.32, U1701.48, U1701.64, U2001.3, Y1901.1, Y1901.4
+3V3A: C1807.1, C1808.1, C1809.1, J2702.4, U1701.28, U1701.29
+5V: J2101.1, J2702.39
ARM_CLK: J2702.15, R1901.1, U1701.23
BOOT0: R1802.1, U1701.61
CAN_H: J2001.2, R2002.1, U2001.7
CAN_L: J2001.3, R2002.2, U2001.6
CAN_RS: R2001.1, U2001.8
CAN_RX: U1701.45, U2001.4
CAN_TX: U1701.46, U2001.1
DRV_CS_N: J2702.19, U1701.22
DRV_FAULT_N: J2702.18, U1701.33
GND: C1801.2, C1802.2, C1803.2, C1804.2, C1805.2, C1806.2, C1807.2, C1808.2, C1809.2, C1810.2, C1901.2, C2001.2, C2101.2, C2102.2, C2103.2, J1901.3, J2001.1, J2002.1, J2003.1, J2101.2, J2702.1, J2702.3, J2702.7, J2702.10, J2702.13, J2702.23, J2702.27, J2702.32, J2702.40, R1802.2, R1901.2, R1902.2, R2001.2, U1701.15, U1701.27, U1701.31, U1701.47, U1701.63, U2001.2, Y1901.2
HALL_A: C2101.1, R2102.2, U1701.38
HALL_A_EXT: J2101.3, R2101.2, R2102.1
HALL_B: C2102.1, R2104.2, U1701.39
HALL_B_EXT: J2101.4, R2103.2, R2104.1
HALL_C: C2103.1, R2106.2, U1701.40
HALL_C_EXT: J2101.5, R2105.2, R2106.1
HARD_FAULT_N: J2702.17, U1701.34
HSE_IN: U1701.5, Y1901.3
I_A_ADC: J2702.24, U1701.12
I_B_ADC: J2702.25, U1701.13
I_C_ADC: J2702.26, U1701.14
LATCH_STATE: J2702.16, U1701.55
LED_A: D1901.2, R1903.2
MCU_PWM_HA: J2702.5, U1701.42
MCU_PWM_HB: J2702.8, U1701.43
MCU_PWM_HC: J2702.11, U1701.44
MCU_PWM_LA: J2702.6, U1701.35
MCU_PWM_LB: J2702.9, U1701.36
MCU_PWM_LC: J2702.12, U1701.37
NRST: C1810.1, J1901.5, J2702.37, R1801.1, U1701.7
PG_5V: J2702.36, U1701.30
PG_12V: J2702.35, U1701.26
RC_PWM: J2003.2, U1701.51
RUN_REQUEST: J2702.14, R1902.1, U1701.41
SPI_MISO: J2702.22, U1701.57
SPI_MOSI: J2702.21, U1701.58
SPI_SCK: J2702.20, U1701.56
STATUS_LED: D1901.1, U1701.54
SWCLK: J1901.4, U1701.50
SWDIO: J1901.2, U1701.49
TEMP_FET: J2702.33, U1701.17
TEMP_MOTOR: J2702.38, U1701.24
TEMP_PCB: J2702.34, U1701.18
UART_RX: J2002.2, U1701.53
UART_TX: J2002.3, U1701.52
V_A_ADC: J2702.29, U1701.9
V_BUS_ADC: J2702.28, U1701.8
V_B_ADC: J2702.30, U1701.10
V_C_ADC: J2702.31, U1701.11
