mekiciepcas/ESC-Ai/ESC_V2/hardware/01_DC_link.kicad_sch

## KiCad design ESC_V2/hardware/01_DC_link.kicad_sch (2026-09-18)

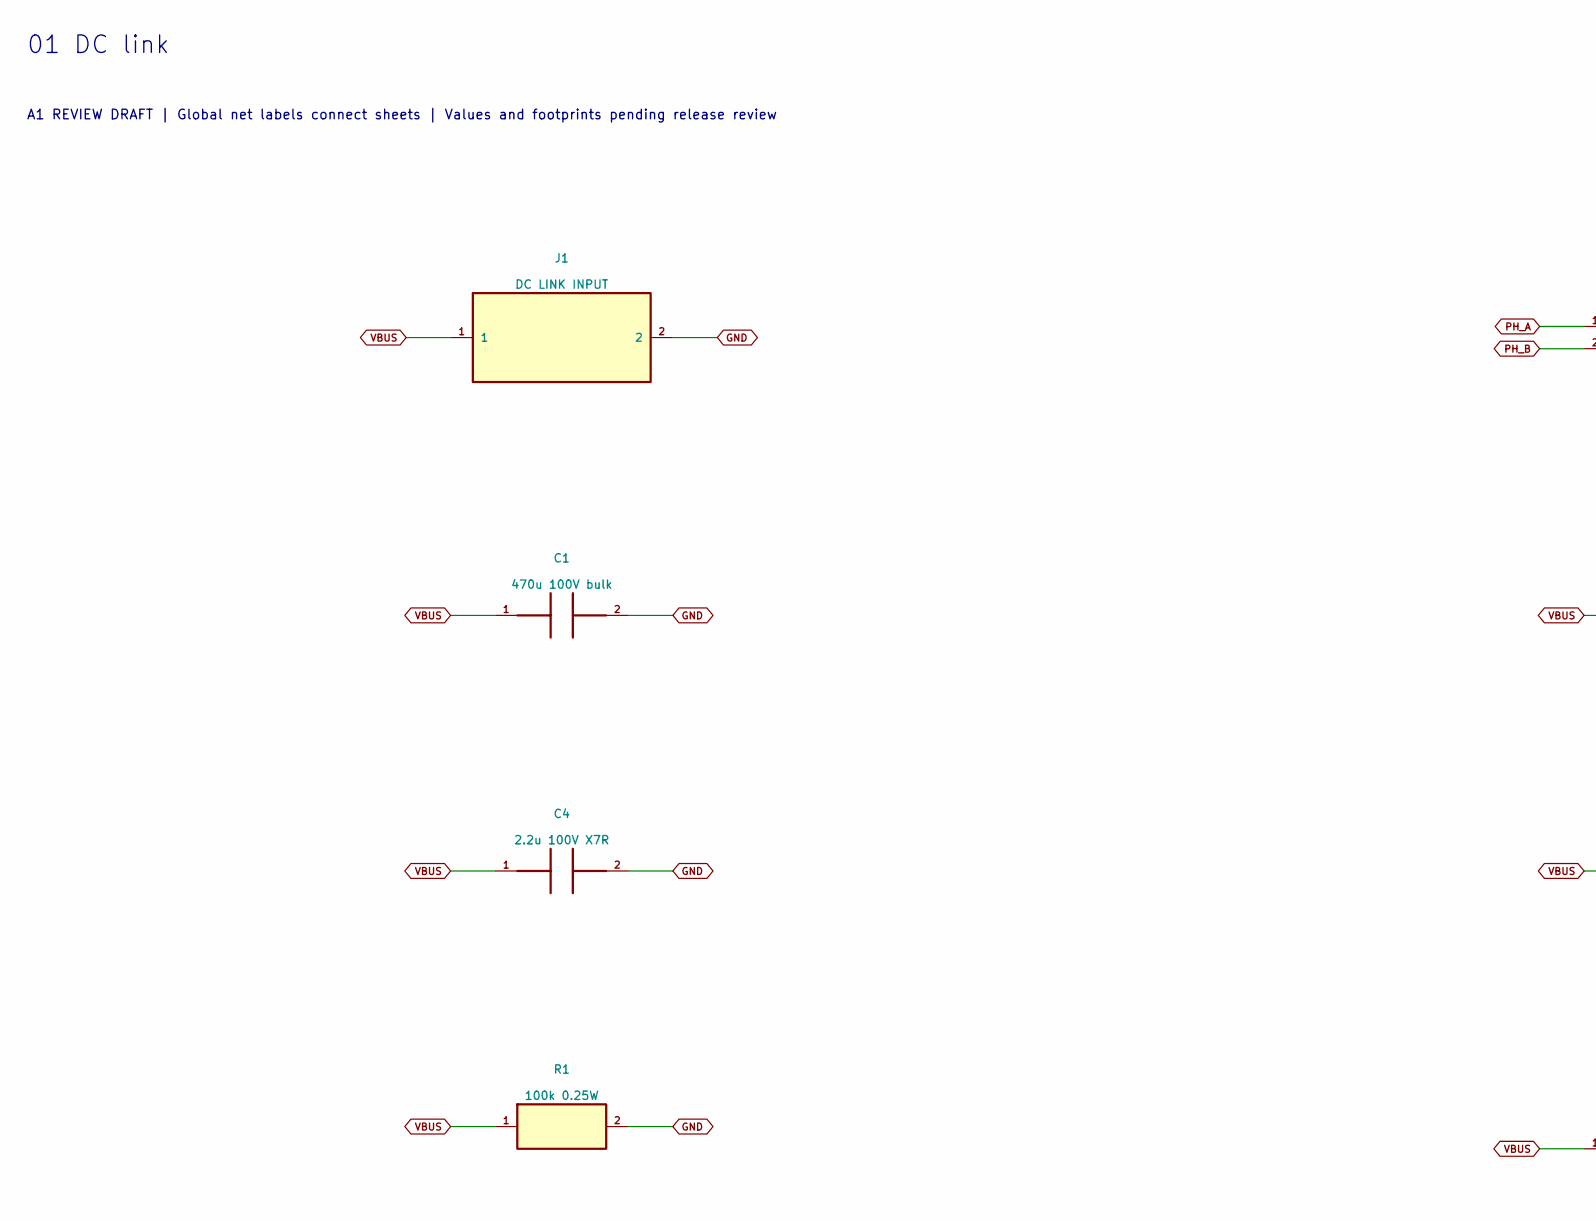
[picture p82: schematic 01_DC_link.kicad_sch, part in row 1, column 1]

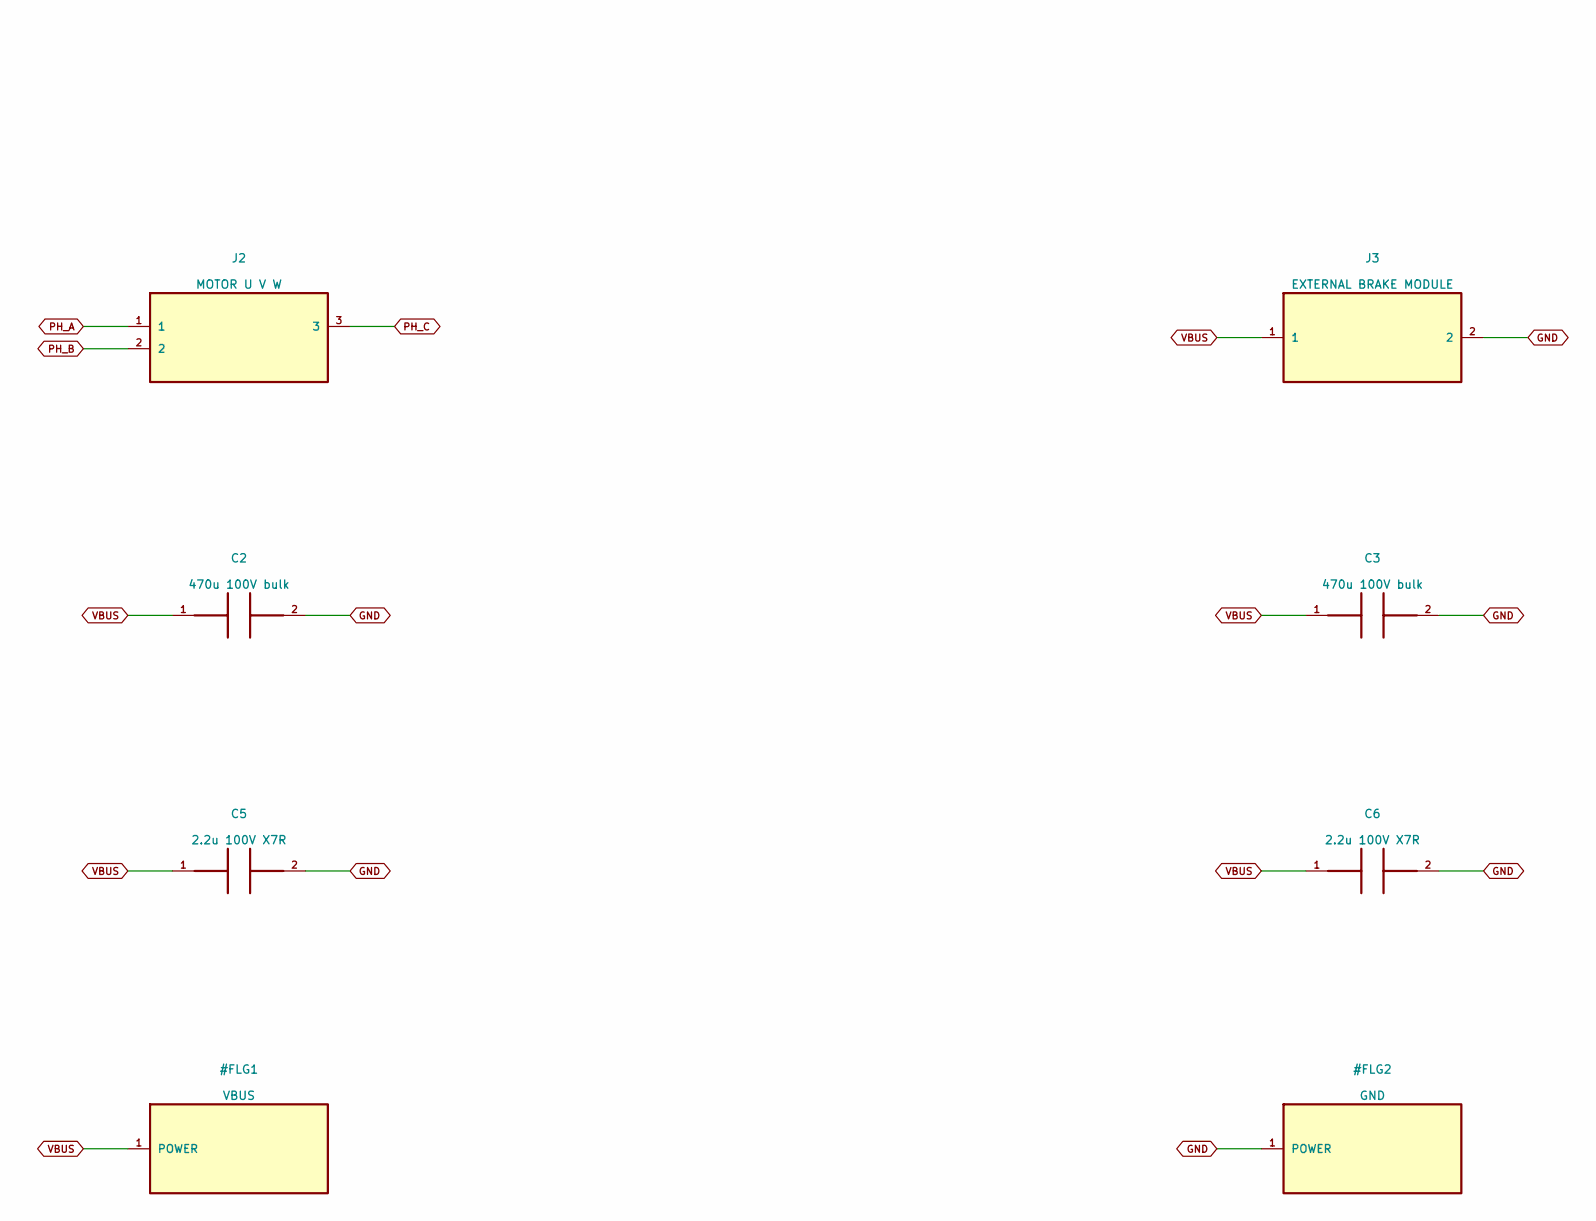
[picture p83: schematic 01_DC_link.kicad_sch, part in row 1, column 2]

Parts:
C1, C2, C3: 470u 100V bulk
C4, C5, C6: 2.2u 100V X7R
J1: DC LINK INPUT
J2: MOTOR U V W
J3: EXTERNAL BRAKE MODULE
R1: 100k 0.25W; R_0805_2012Metric

Connections:
GND: C1.2, C2.2, C3.2, C4.2, C5.2, C6.2, J1.2, J3.2, R1.2
PH_A: J2.1
PH_B: J2.2
PH_C: J2.3
VBUS: C1.1, C2.1, C3.1, C4.1, C5.1, C6.1, J1.1, J3.1, R1.1

Notes on the sheet:
01 DC link
A1 REVIEW DRAFT | Global net labels connect sheets | Values and footprints pending release review
