mekiciepcas/ESC-Ai/ESC_V2/hardware/02_phase_A.kicad_sch

## KiCad design ESC_V2/hardware/02_phase_A.kicad_sch (2026-09-18)

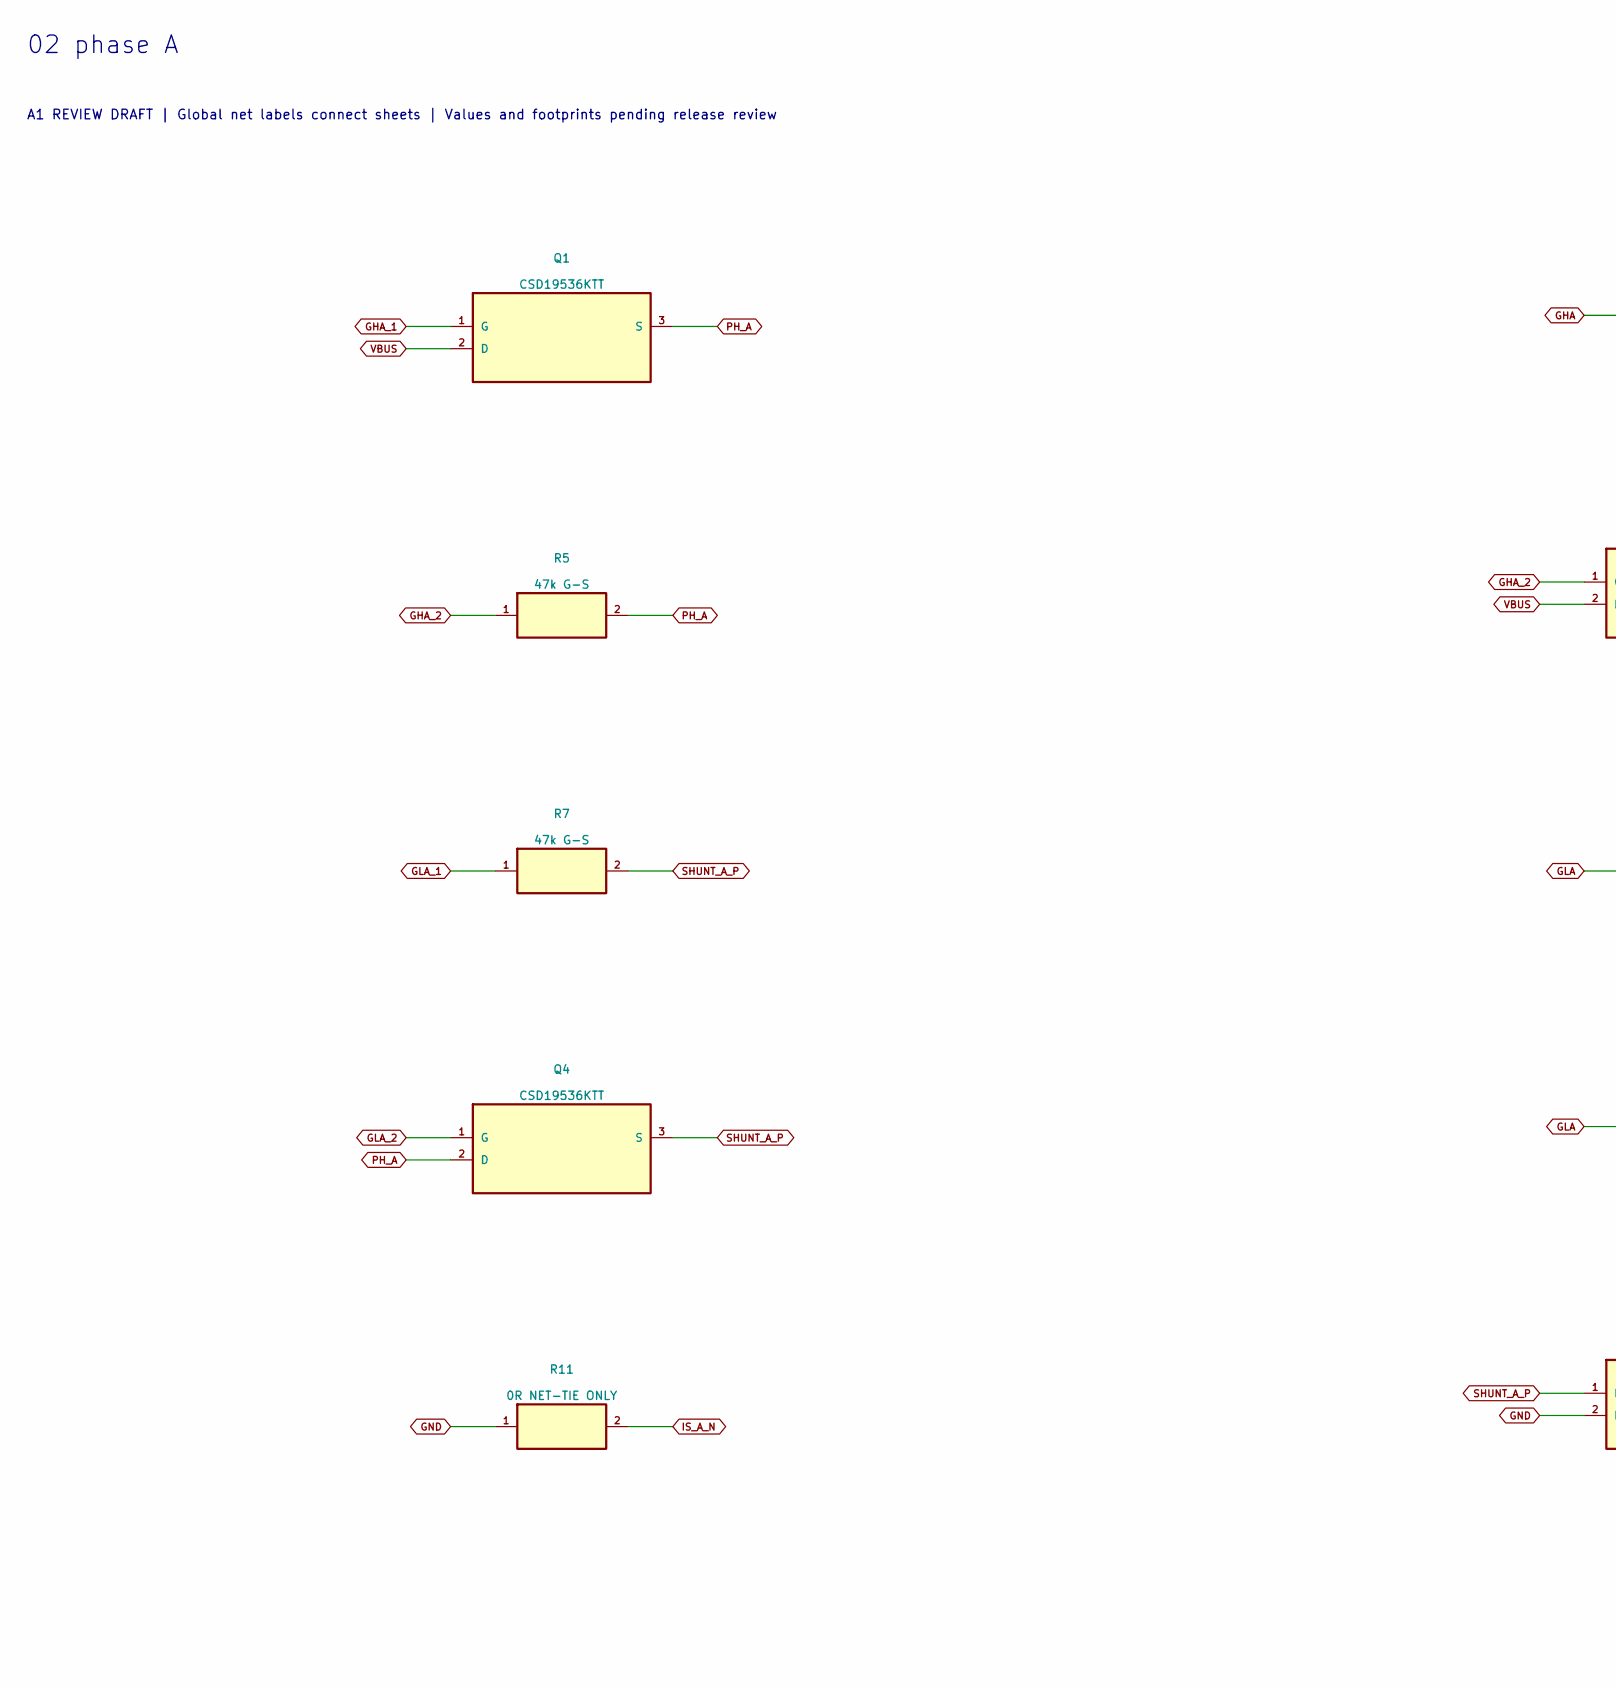
[picture p84: schematic 02_phase_A.kicad_sch, part in row 1, column 1]

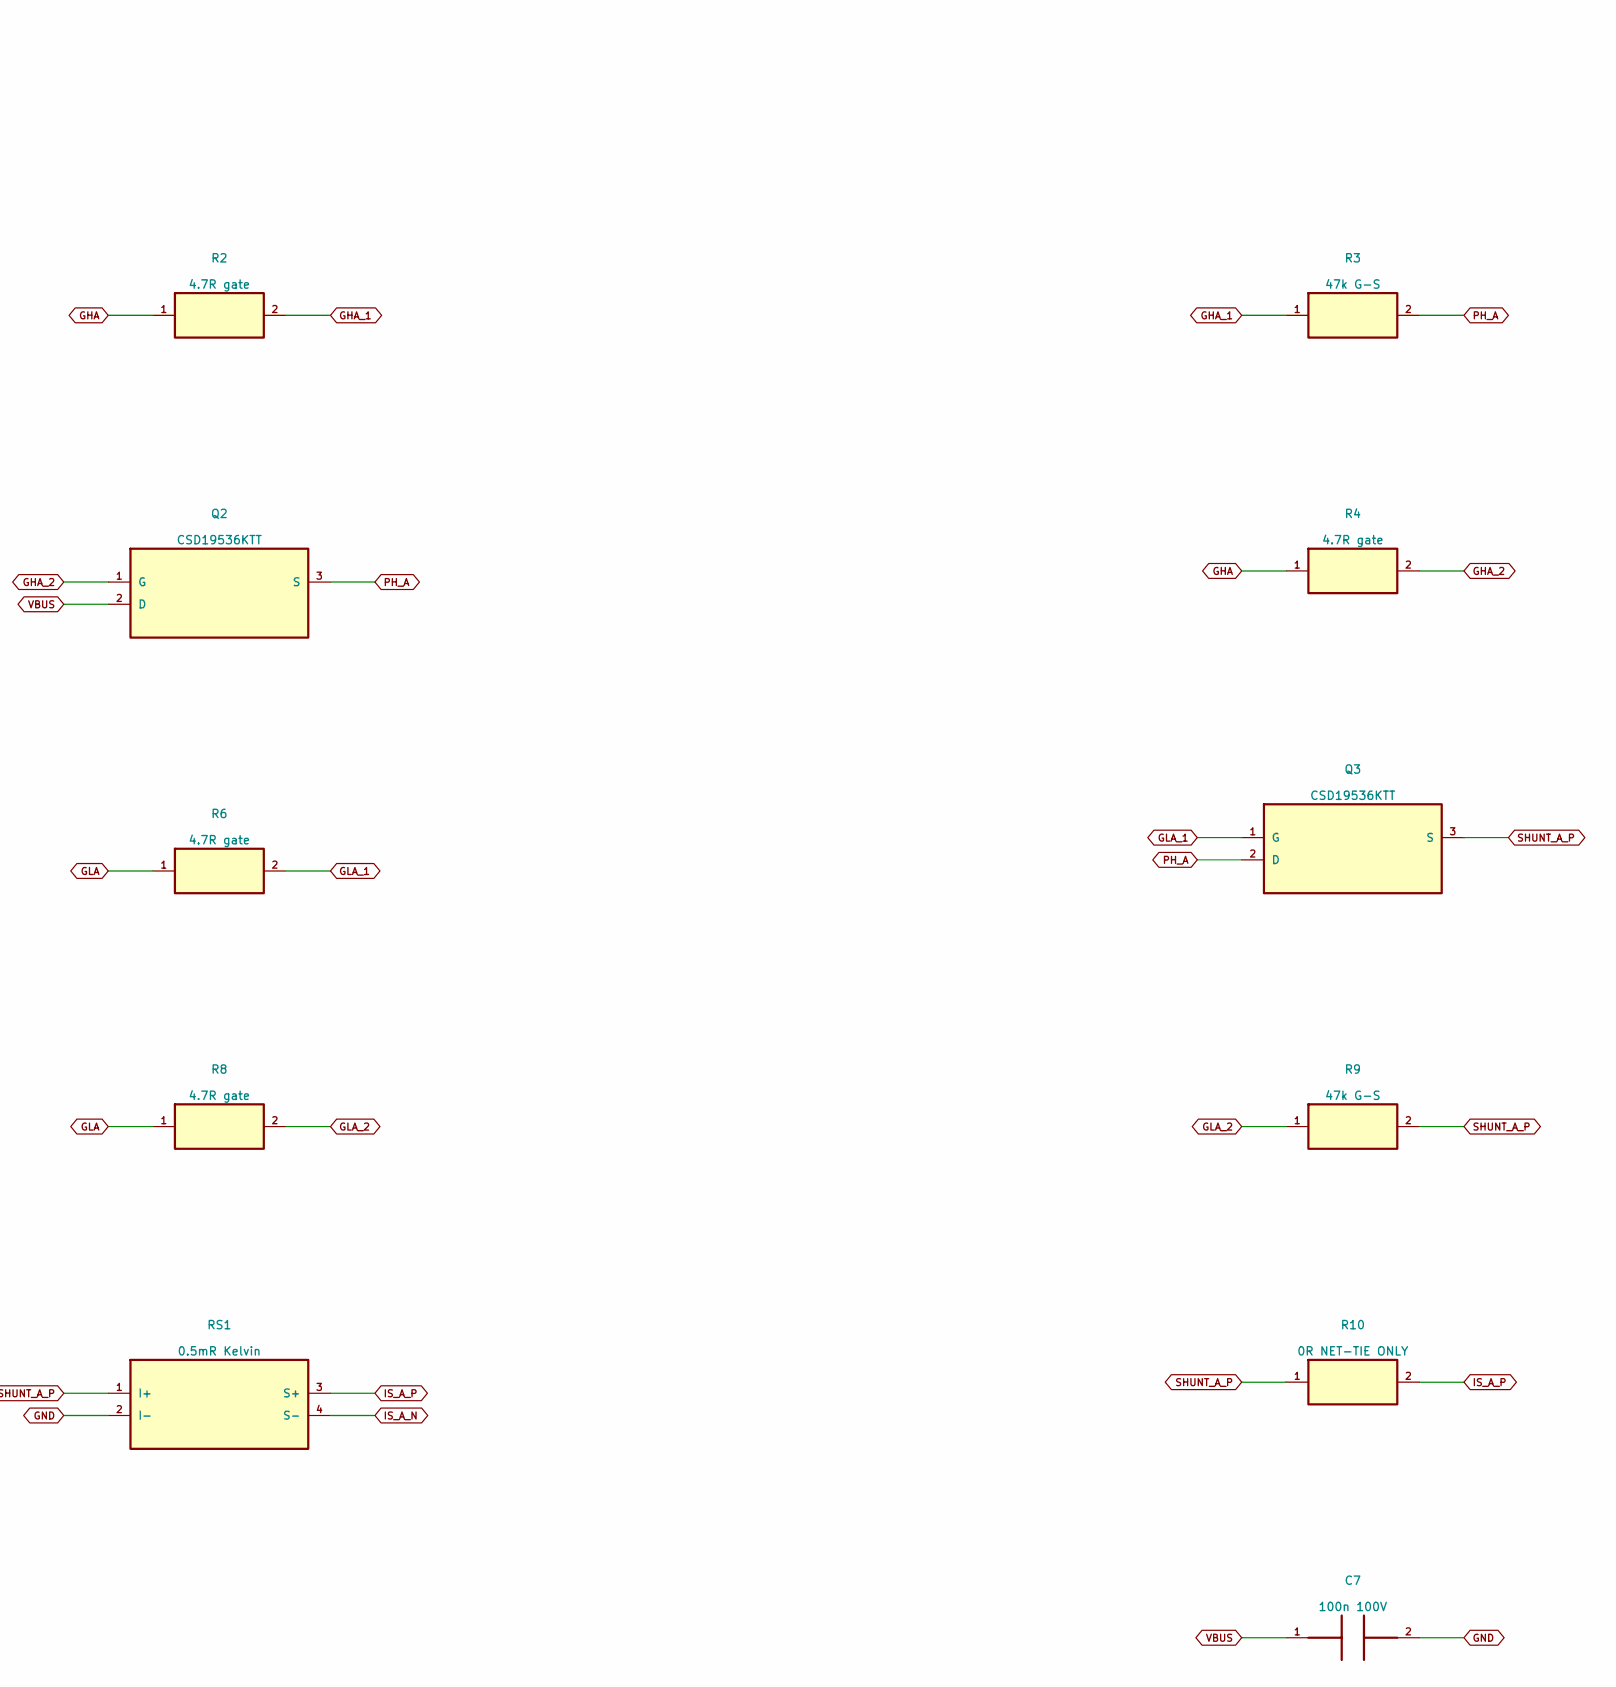
[picture p85: schematic 02_phase_A.kicad_sch, part in row 1, column 2]

Parts:
C7: 100n 100V
Q1, Q2, Q3, Q4: CSD19536KTT; TO-263-3_TabPin2; MPN CSD19536KTT
R2, R4, R6, R8: 4.7R gate; R_0805_2012Metric
R3, R5, R7, R9: 47k G-S; R_0805_2012Metric
R10, R11: 0R NET-TIE ONLY
RS1: 0.5mR Kelvin

Connections:
GHA: R2.1, R4.1
GHA_1: Q1.1 (G), R2.2, R3.1
GHA_2: Q2.1 (G), R4.2, R5.1
GLA: R6.1, R8.1
GLA_1: Q3.1 (G), R6.2, R7.1
GLA_2: Q4.1 (G), R8.2, R9.1
GND: C7.2, R11.1, RS1.2 (I-)
IS_A_N: R11.2, RS1.4 (S-)
IS_A_P: R10.2, RS1.3 (S+)
PH_A: Q1.3 (S), Q2.3 (S), Q3.2 (D), Q4.2 (D), R3.2, R5.2
SHUNT_A_P: Q3.3 (S), Q4.3 (S), R7.2, R9.2, R10.1, RS1.1 (I+)
VBUS: C7.1, Q1.2 (D), Q2.2 (D)

Notes on the sheet:
02 phase A
A1 REVIEW DRAFT | Global net labels connect sheets | Values and footprints pending release review
