mekiciepcas/ESC-Ai/ESC_V2/hardware/02_phase_B.kicad_sch

## KiCad design ESC_V2/hardware/02_phase_B.kicad_sch (2026-09-18)

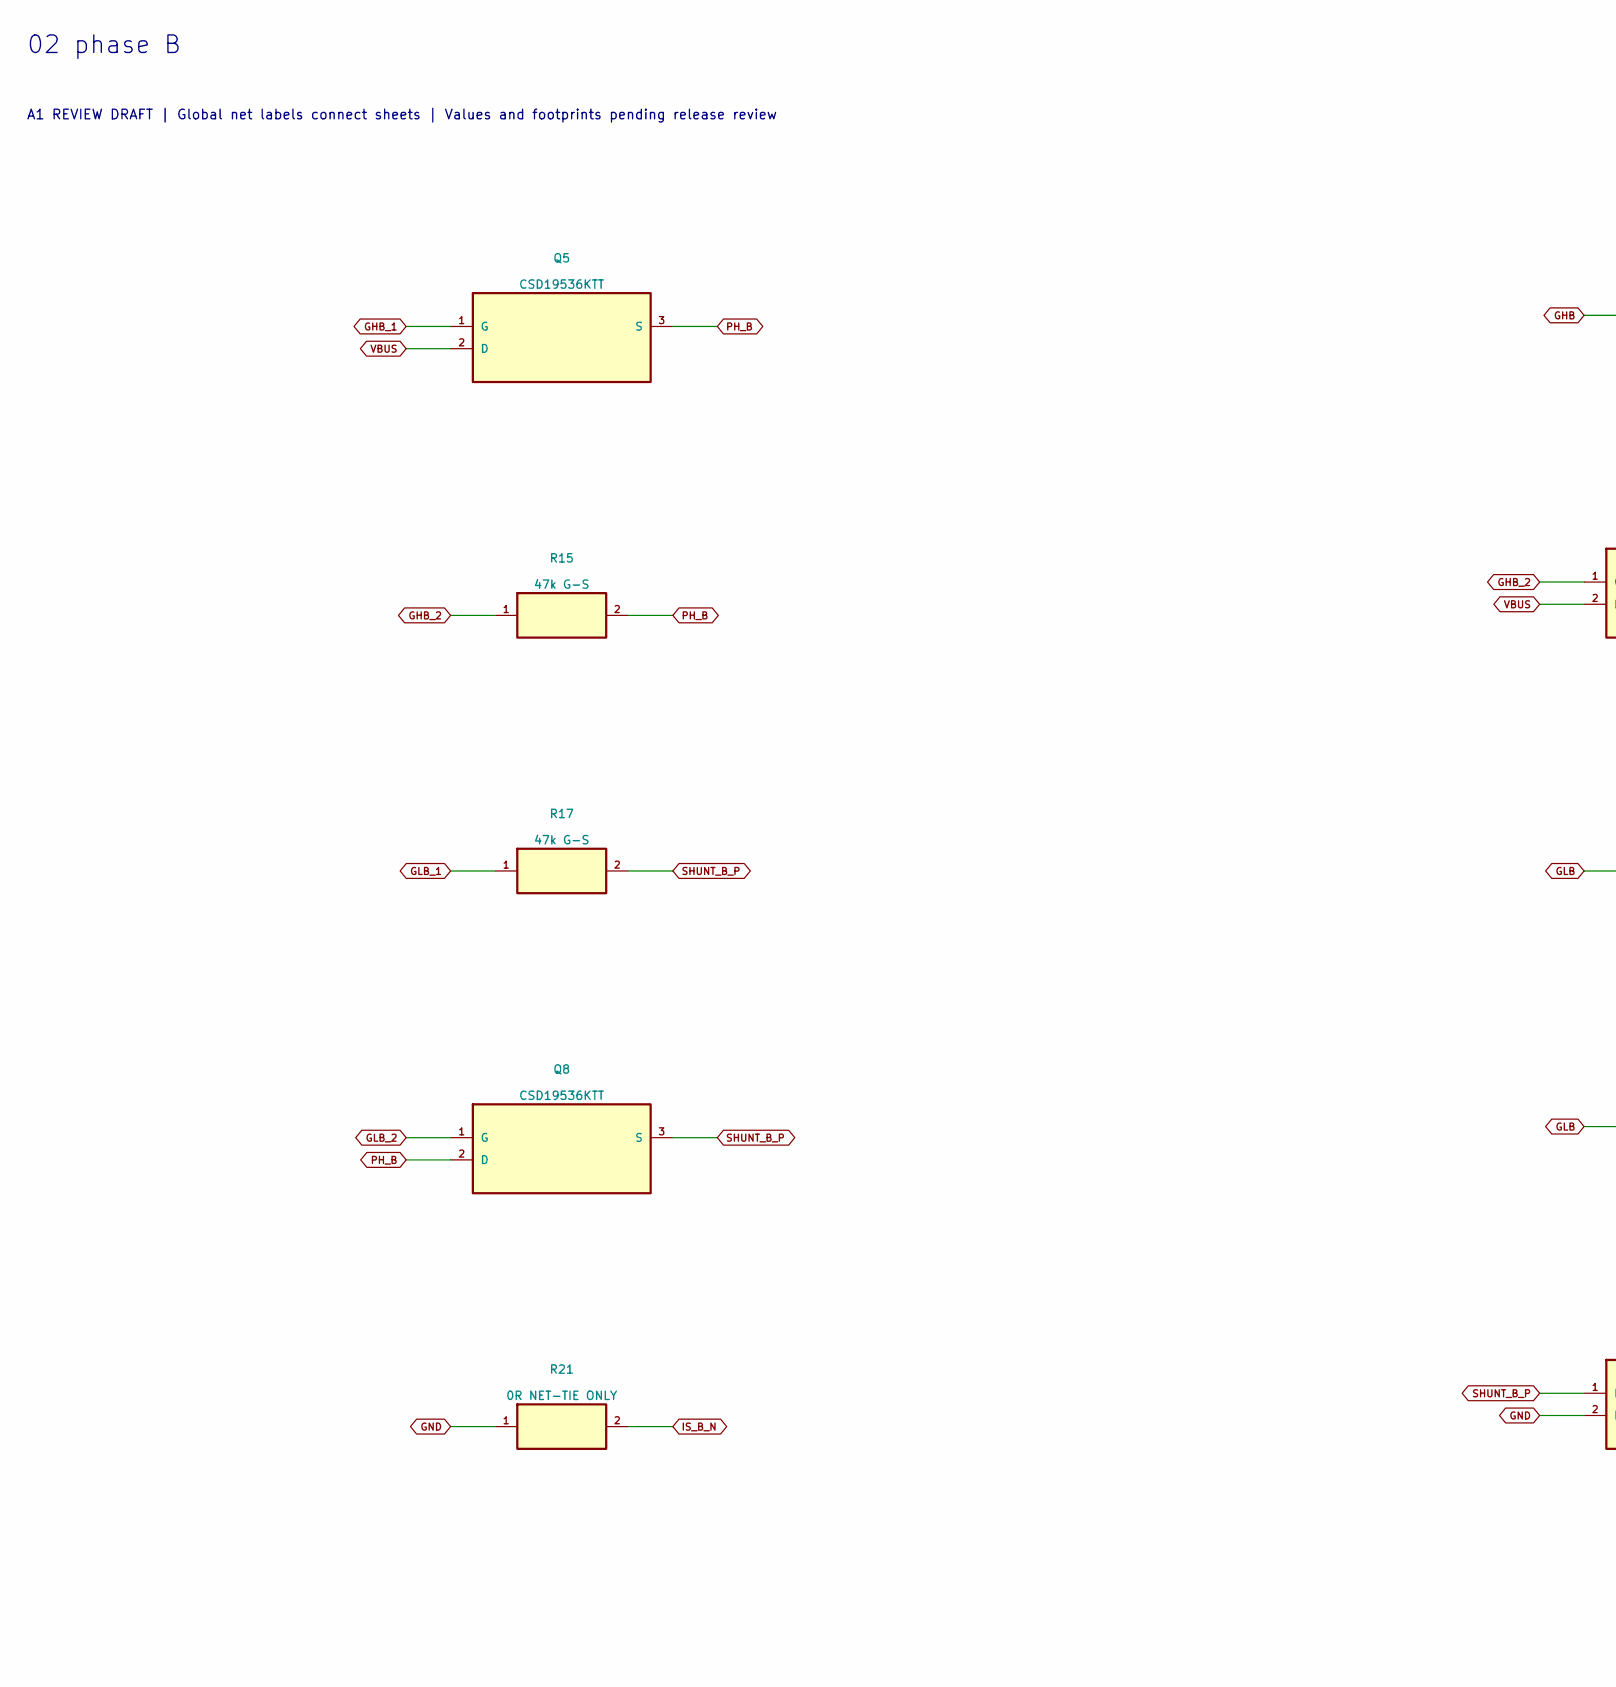
[picture p86: schematic 02_phase_B.kicad_sch, part in row 1, column 1]

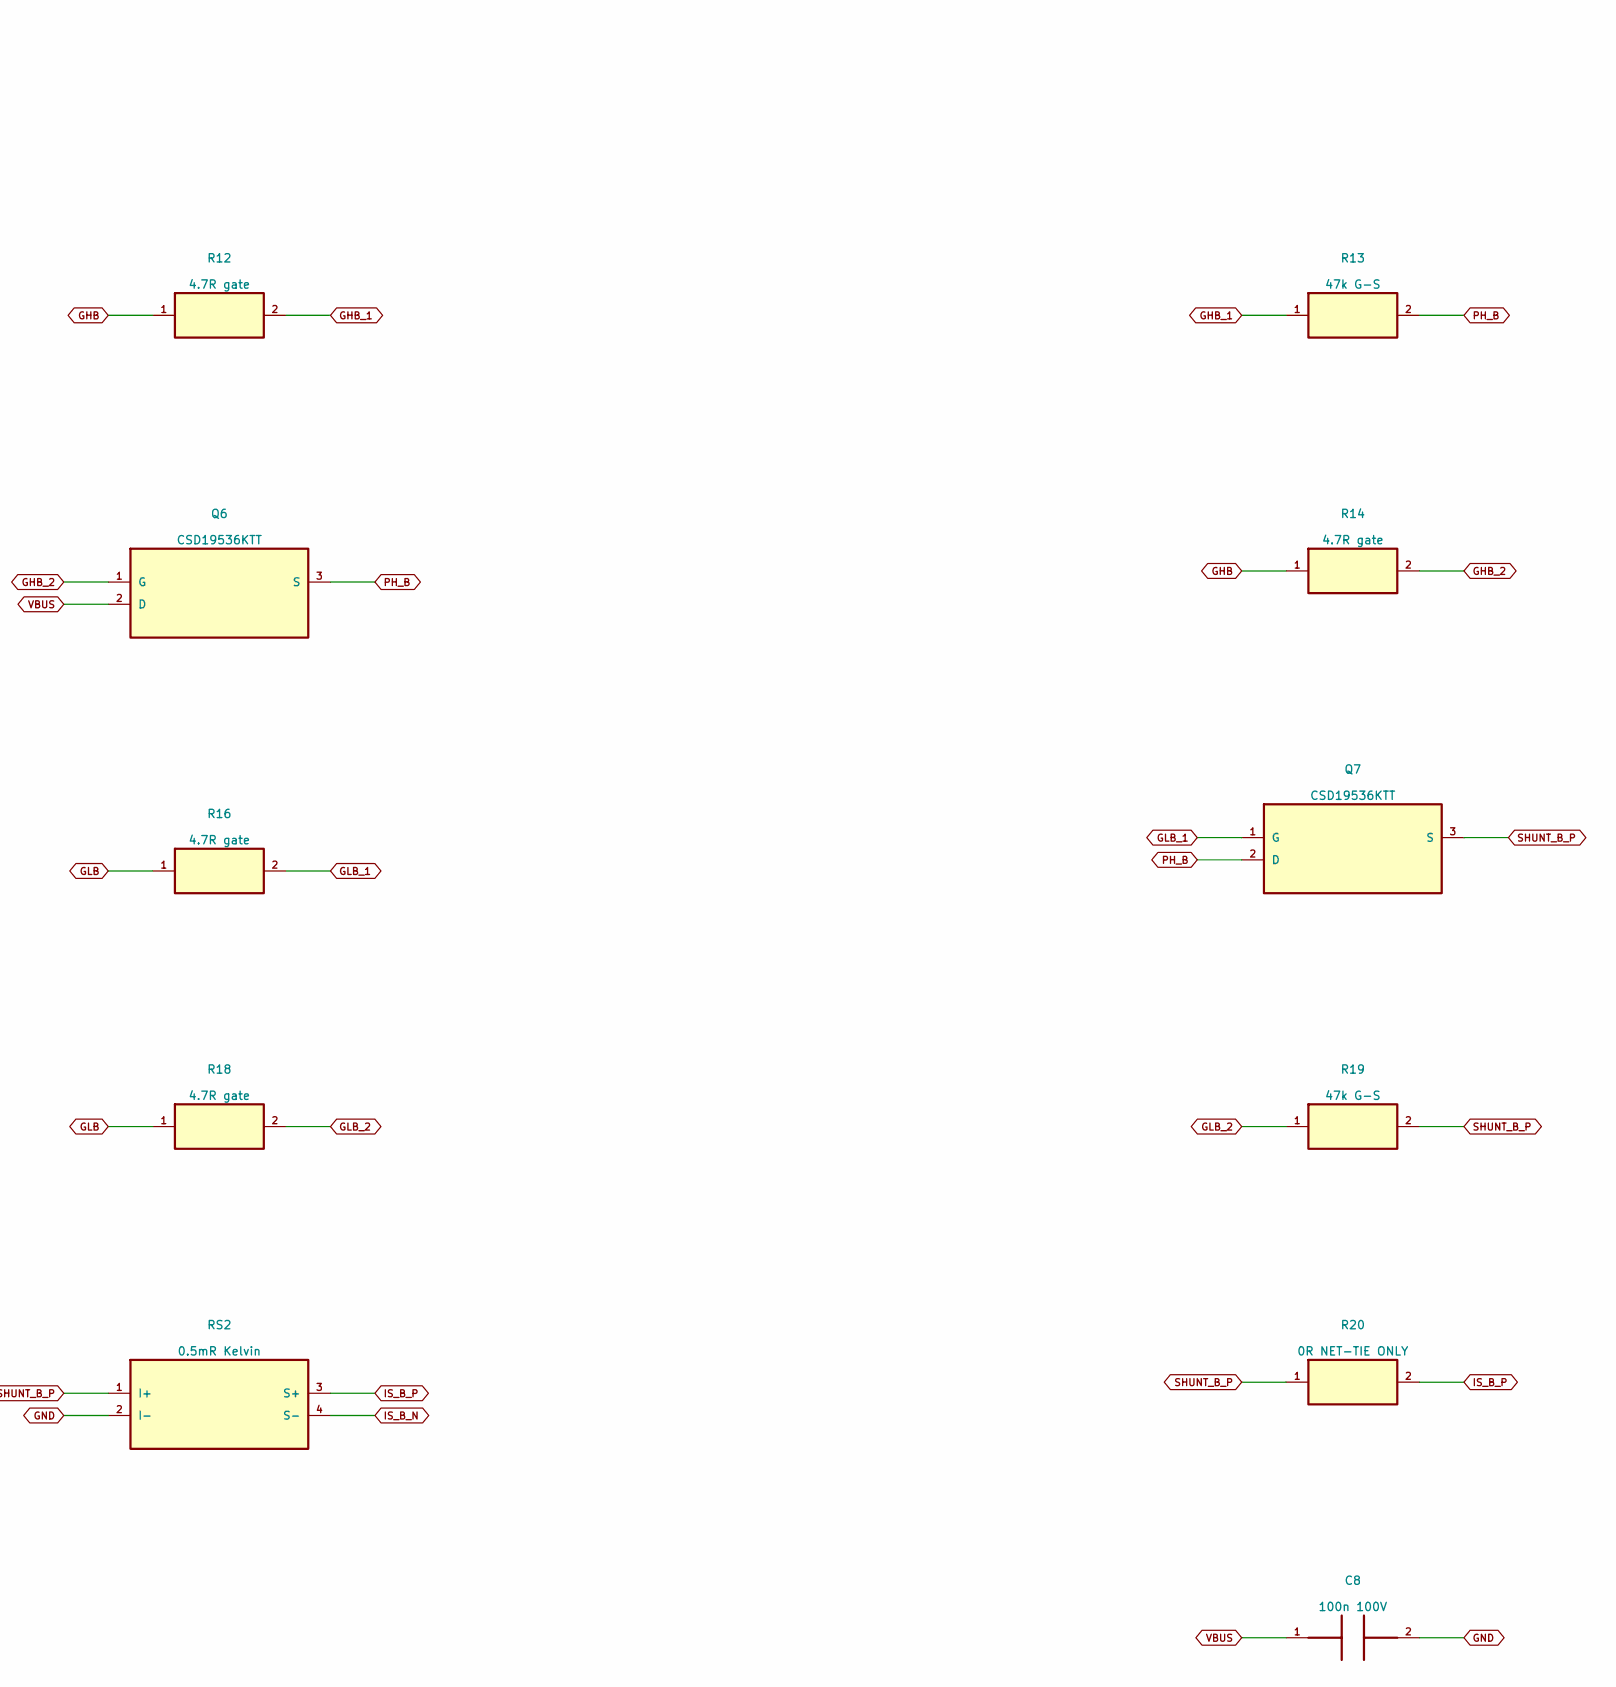
[picture p87: schematic 02_phase_B.kicad_sch, part in row 1, column 2]

Parts:
C8: 100n 100V
Q5, Q6, Q7, Q8: CSD19536KTT; TO-263-3_TabPin2; MPN CSD19536KTT
R12, R14, R16, R18: 4.7R gate; R_0805_2012Metric
R13, R15, R17, R19: 47k G-S; R_0805_2012Metric
R20, R21: 0R NET-TIE ONLY
RS2: 0.5mR Kelvin

Connections:
GHB: R12.1, R14.1
GHB_1: Q5.1 (G), R12.2, R13.1
GHB_2: Q6.1 (G), R14.2, R15.1
GLB: R16.1, R18.1
GLB_1: Q7.1 (G), R16.2, R17.1
GLB_2: Q8.1 (G), R18.2, R19.1
GND: C8.2, R21.1, RS2.2 (I-)
IS_B_N: R21.2, RS2.4 (S-)
IS_B_P: R20.2, RS2.3 (S+)
PH_B: Q5.3 (S), Q6.3 (S), Q7.2 (D), Q8.2 (D), R13.2, R15.2
SHUNT_B_P: Q7.3 (S), Q8.3 (S), R17.2, R19.2, R20.1, RS2.1 (I+)
VBUS: C8.1, Q5.2 (D), Q6.2 (D)

Notes on the sheet:
02 phase B
A1 REVIEW DRAFT | Global net labels connect sheets | Values and footprints pending release review
