mekiciepcas/ESC-Ai/ESC_V2/hardware/02_phase_C.kicad_sch

## KiCad design ESC_V2/hardware/02_phase_C.kicad_sch (2026-09-18)

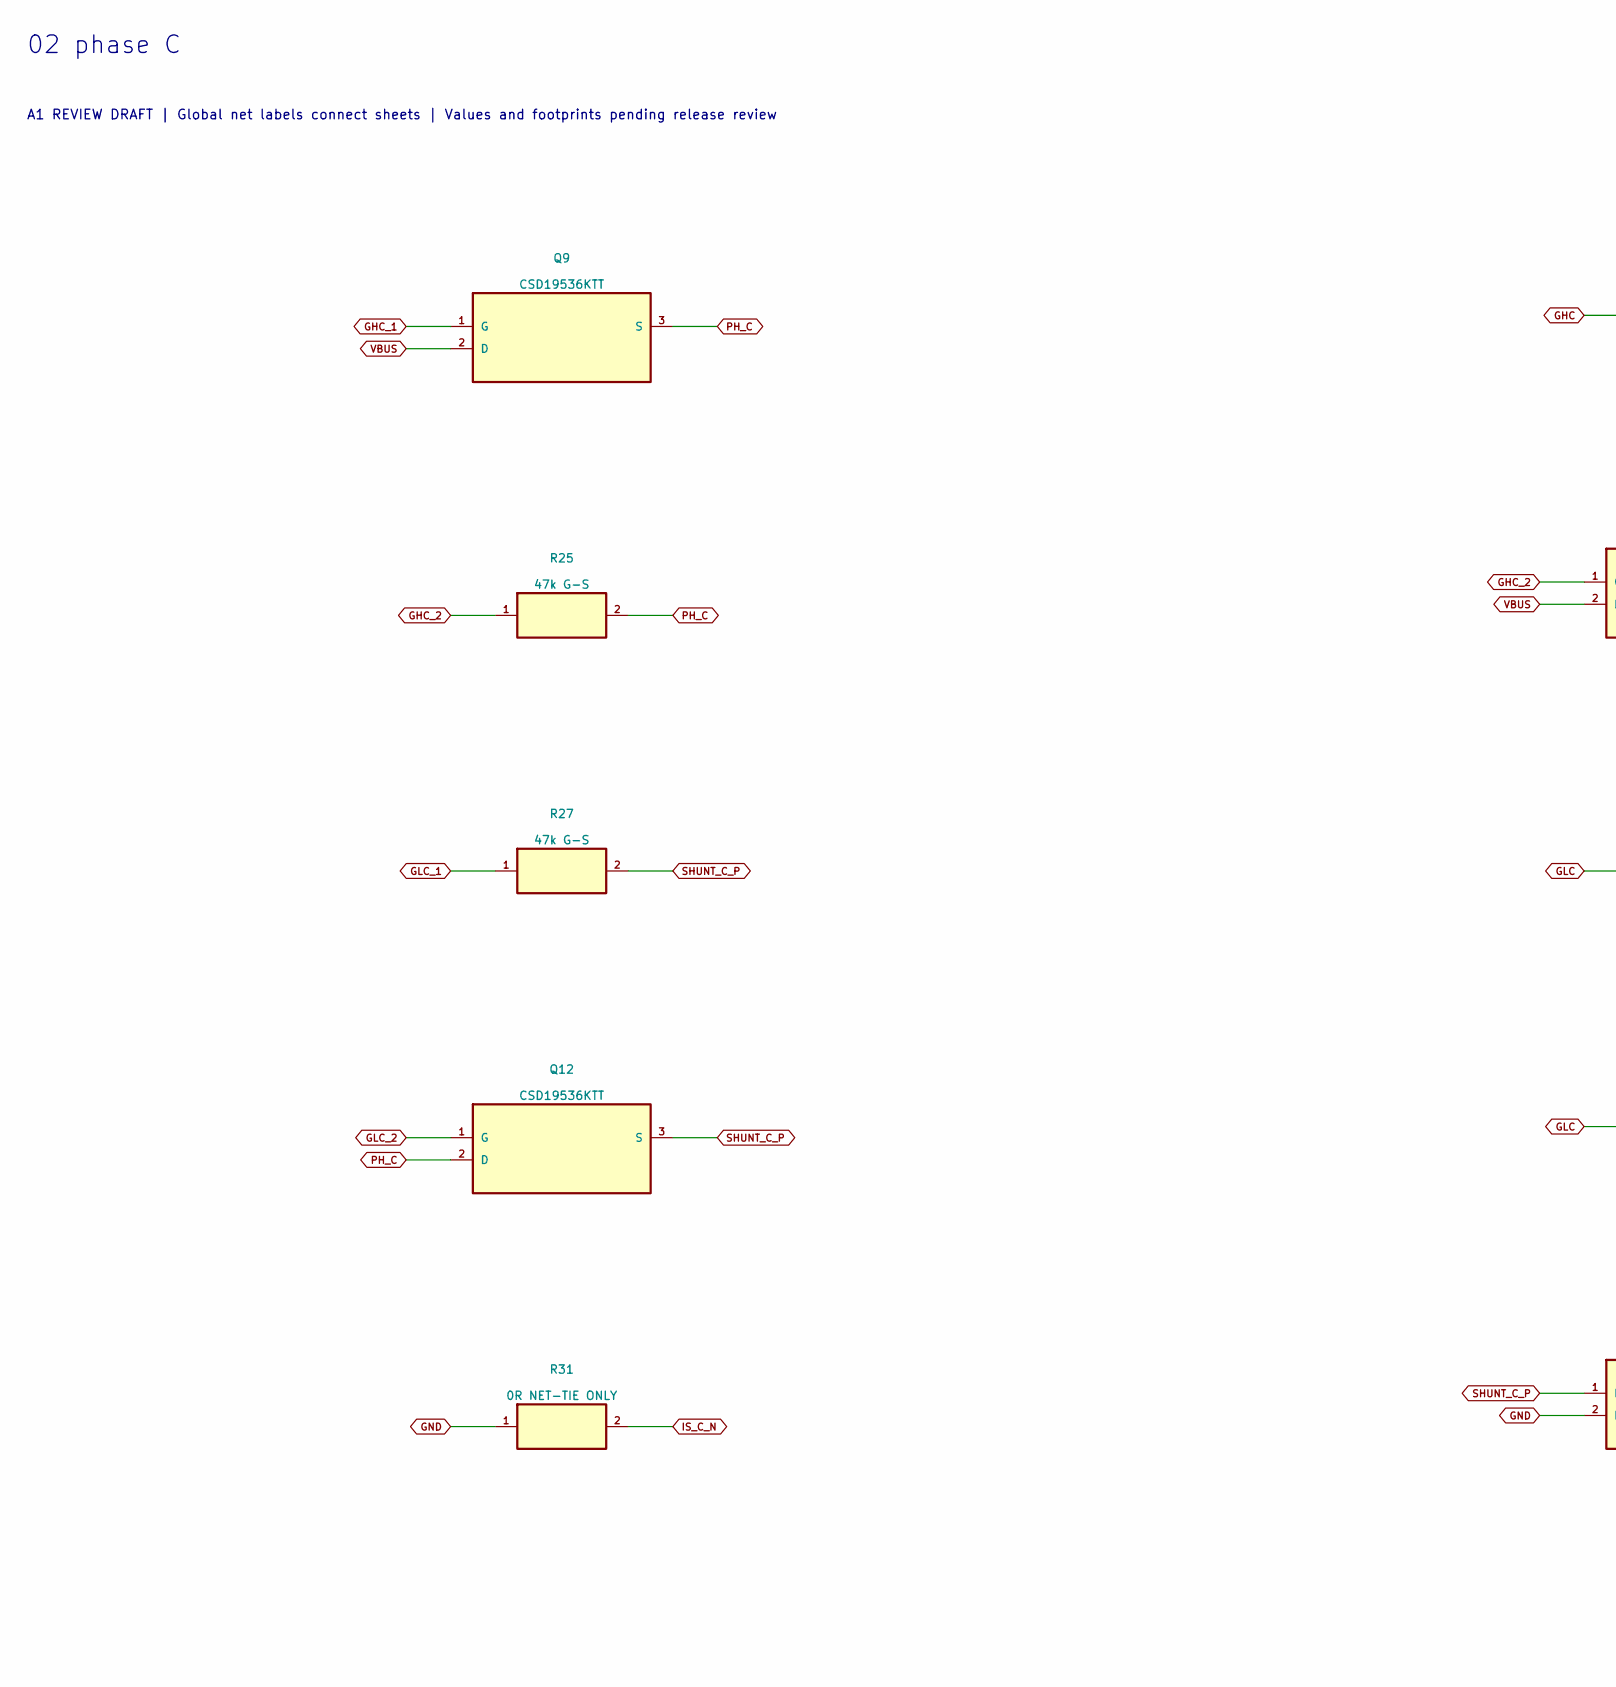
[picture p88: schematic 02_phase_C.kicad_sch, part in row 1, column 1]

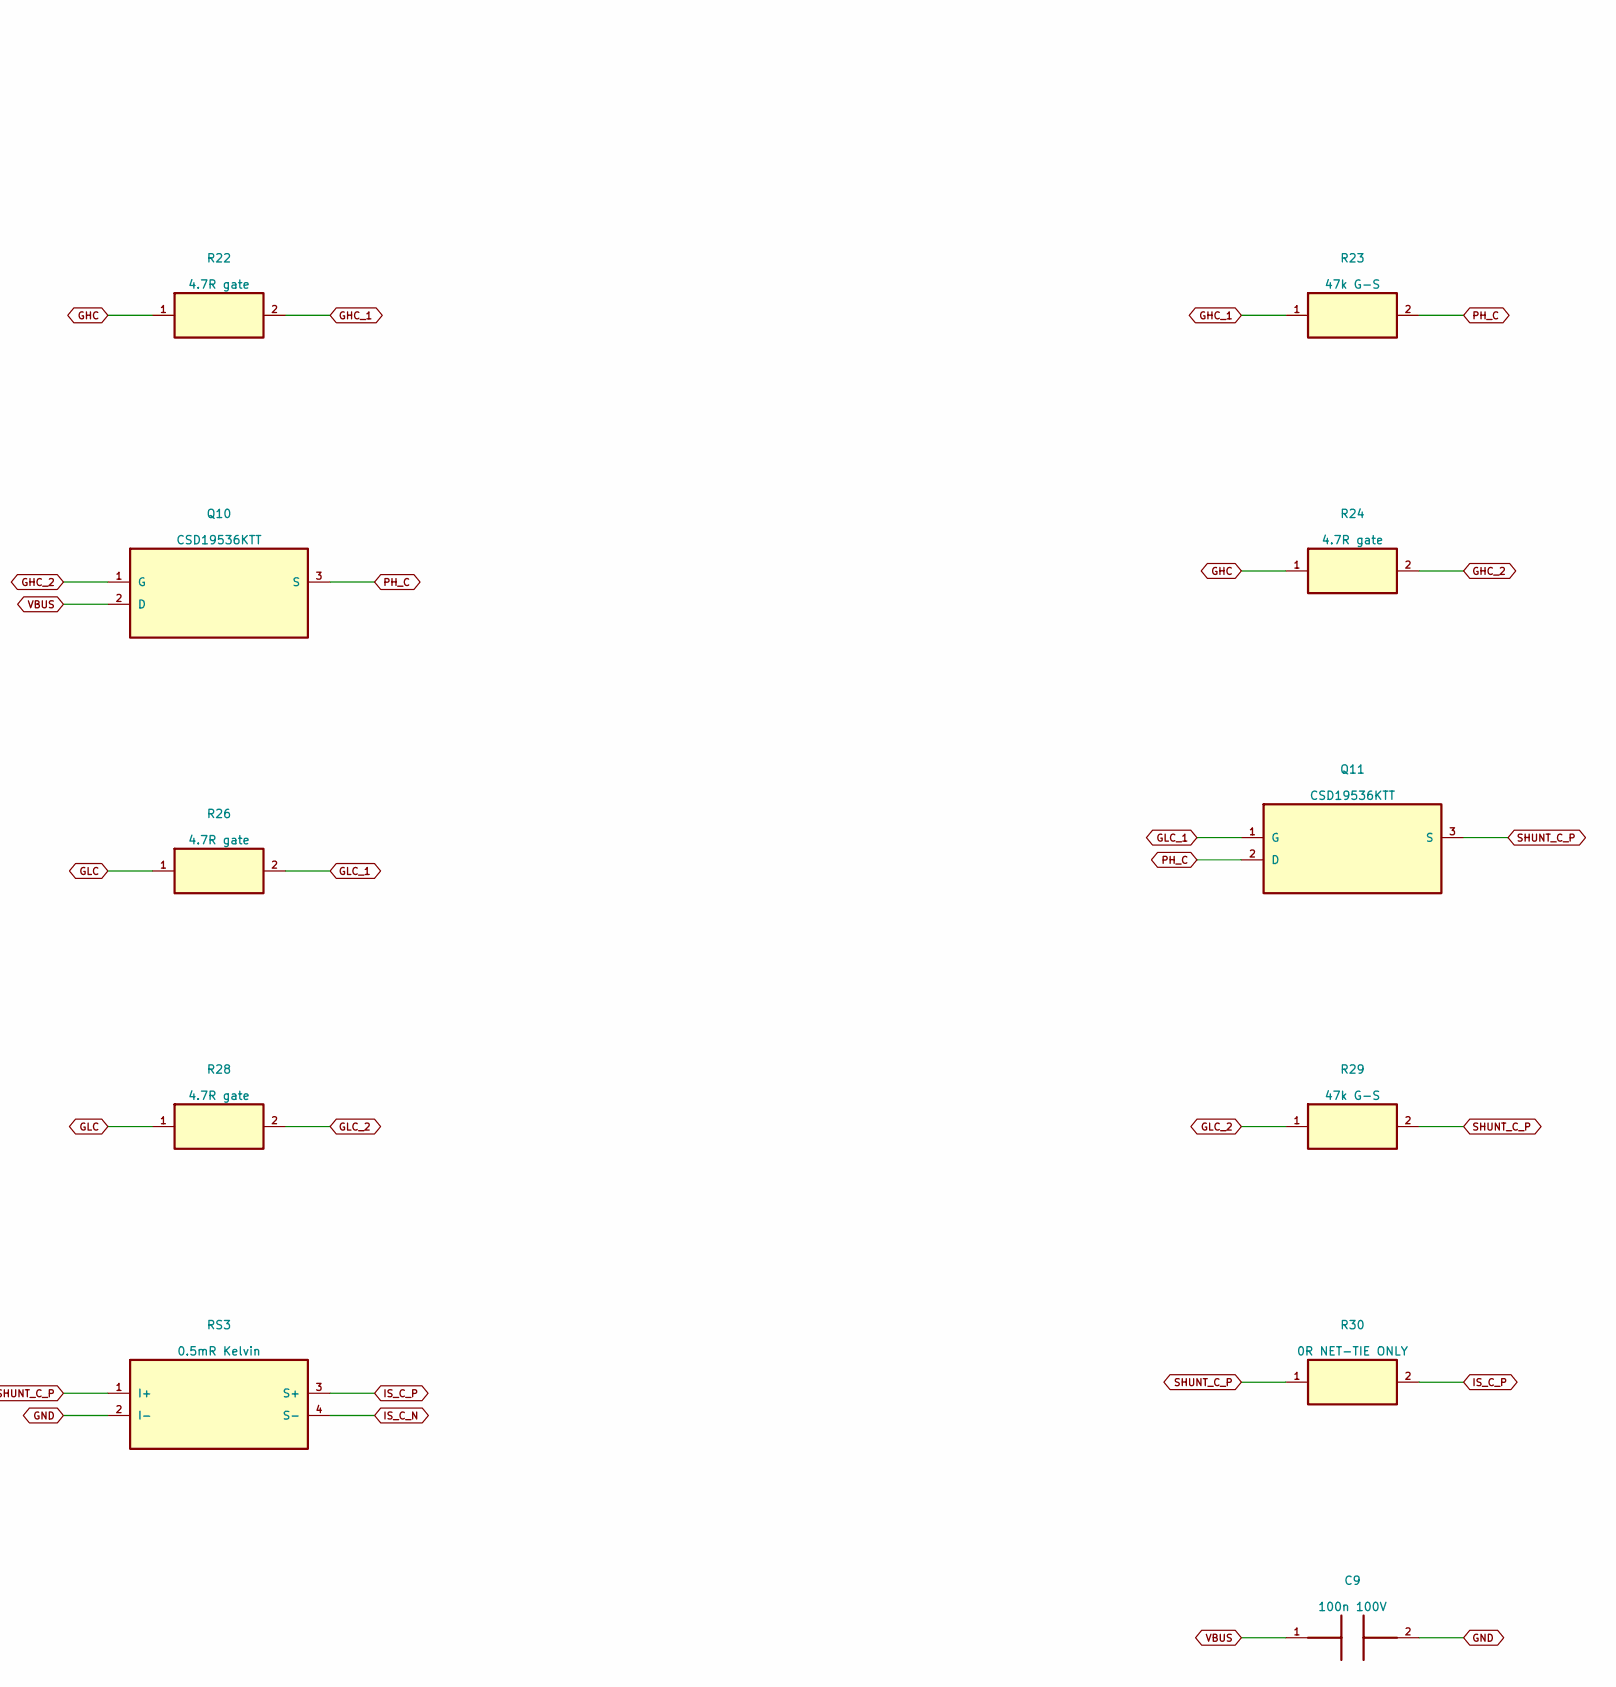
[picture p89: schematic 02_phase_C.kicad_sch, part in row 1, column 2]

Parts:
C9: 100n 100V
Q9, Q10, Q11, Q12: CSD19536KTT; TO-263-3_TabPin2; MPN CSD19536KTT
R22, R24, R26, R28: 4.7R gate; R_0805_2012Metric
R23, R25, R27, R29: 47k G-S; R_0805_2012Metric
R30, R31: 0R NET-TIE ONLY
RS3: 0.5mR Kelvin

Connections:
GHC: R22.1, R24.1
GHC_1: Q9.1 (G), R22.2, R23.1
GHC_2: Q10.1 (G), R24.2, R25.1
GLC: R26.1, R28.1
GLC_1: Q11.1 (G), R26.2, R27.1
GLC_2: Q12.1 (G), R28.2, R29.1
GND: C9.2, R31.1, RS3.2 (I-)
IS_C_N: R31.2, RS3.4 (S-)
IS_C_P: R30.2, RS3.3 (S+)
PH_C: Q9.3 (S), Q10.3 (S), Q11.2 (D), Q12.2 (D), R23.2, R25.2
SHUNT_C_P: Q11.3 (S), Q12.3 (S), R27.2, R29.2, R30.1, RS3.1 (I+)
VBUS: C9.1, Q9.2 (D), Q10.2 (D)

Notes on the sheet:
02 phase C
A1 REVIEW DRAFT | Global net labels connect sheets | Values and footprints pending release review
