mekiciepcas/ESC-Ai/ESC_V2/hardware/03_gate_driver.kicad_sch

## KiCad design ESC_V2/hardware/03_gate_driver.kicad_sch (2026-09-18)

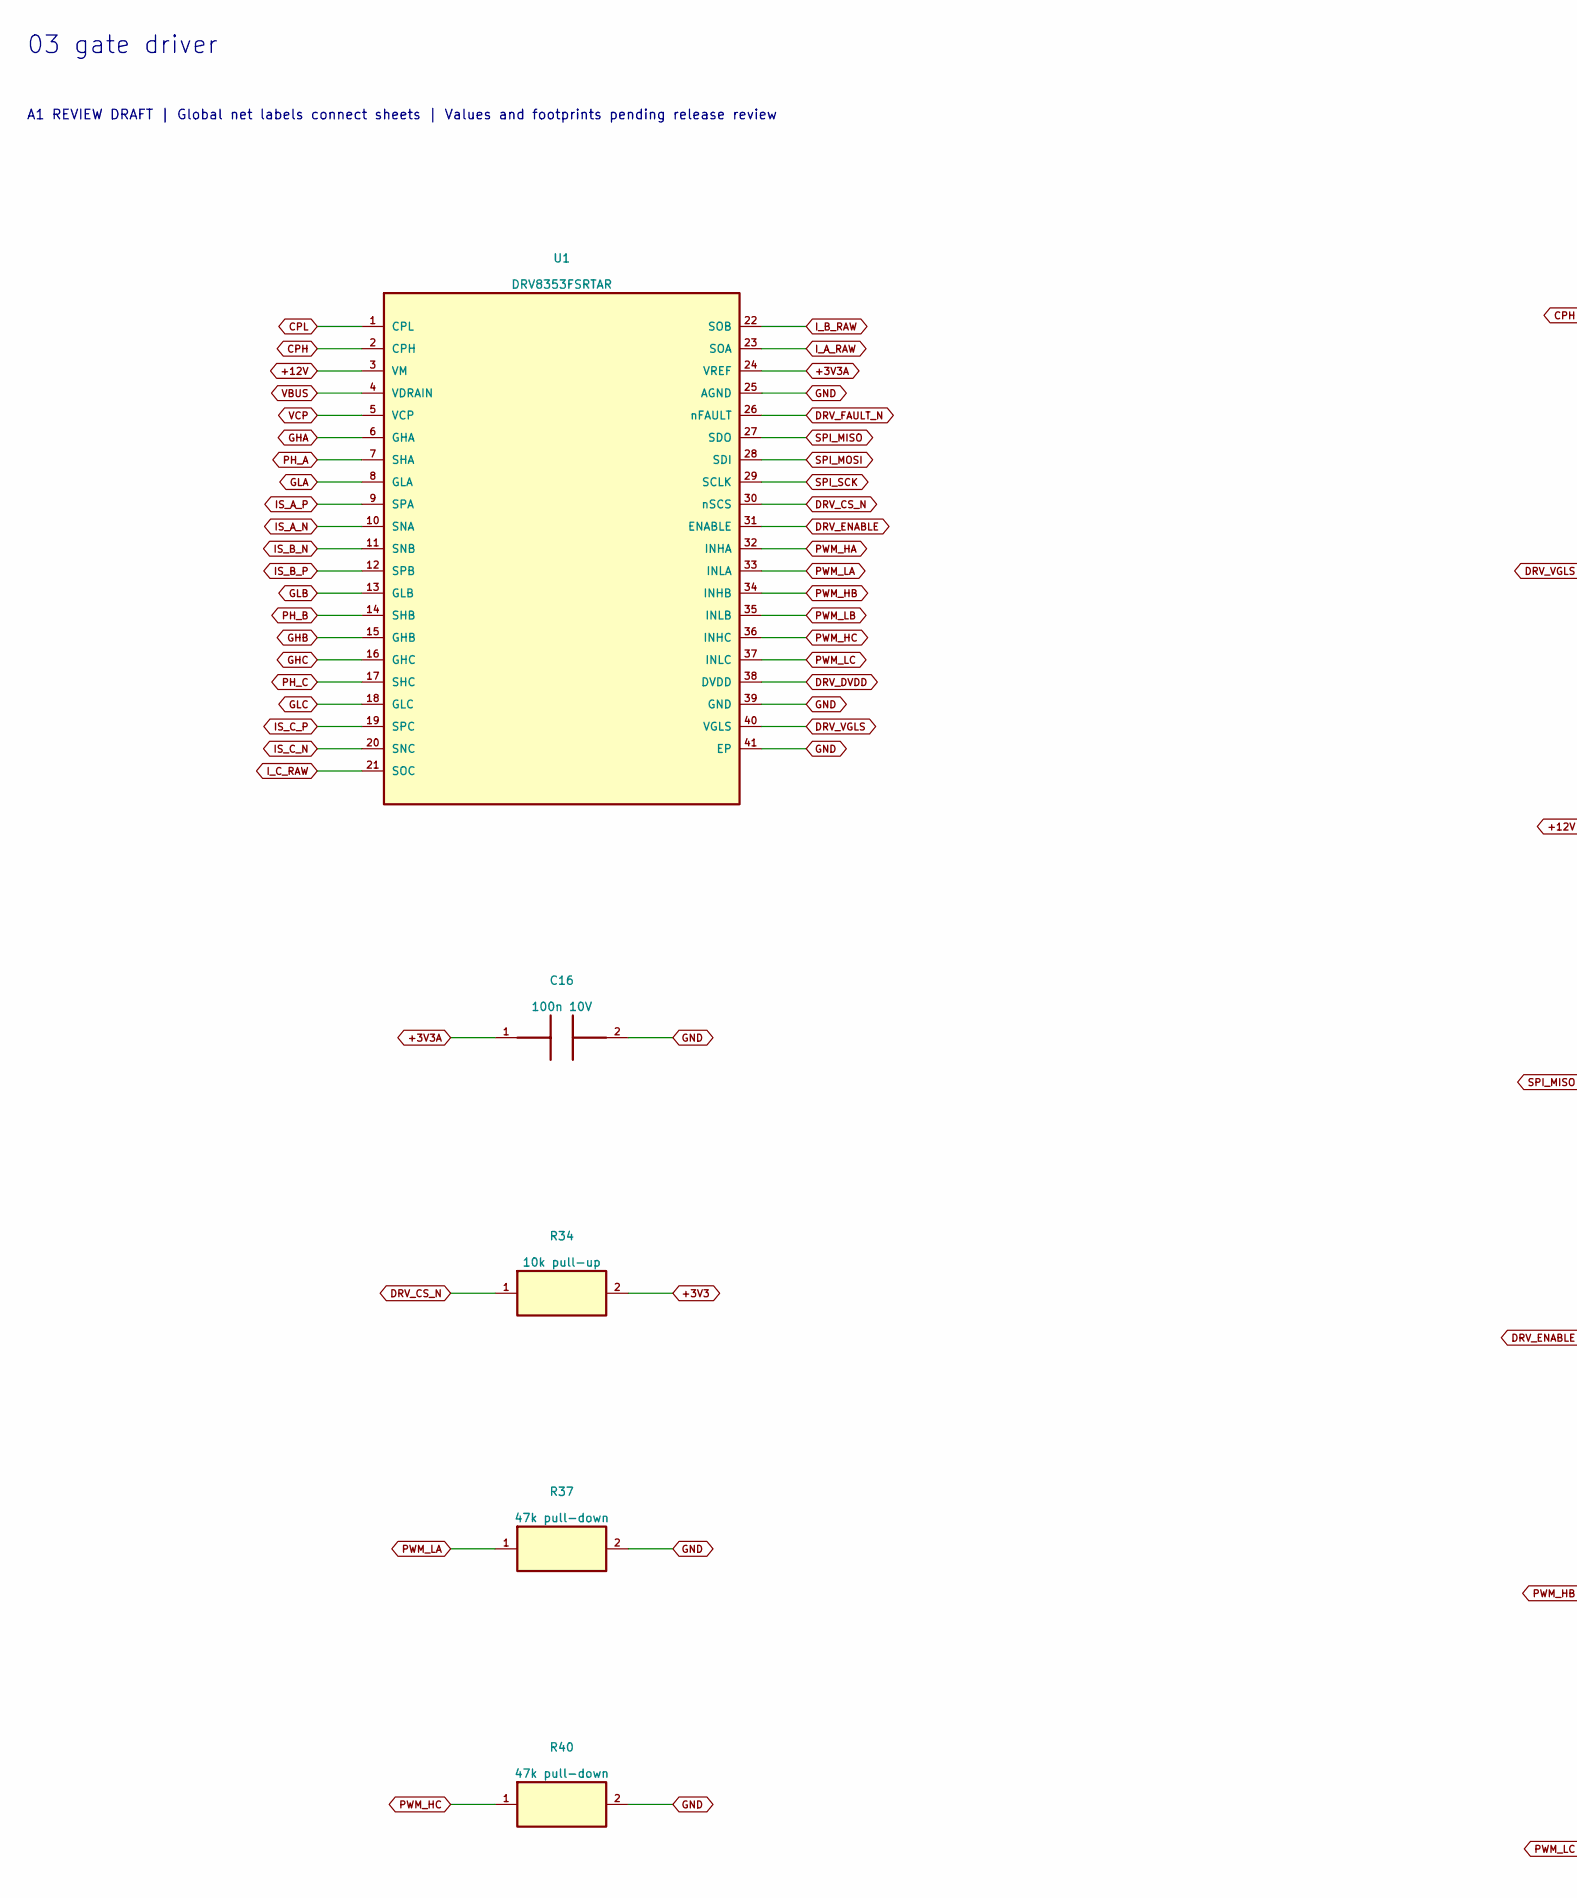
[picture p90: schematic 03_gate_driver.kicad_sch, part in row 1, column 1]

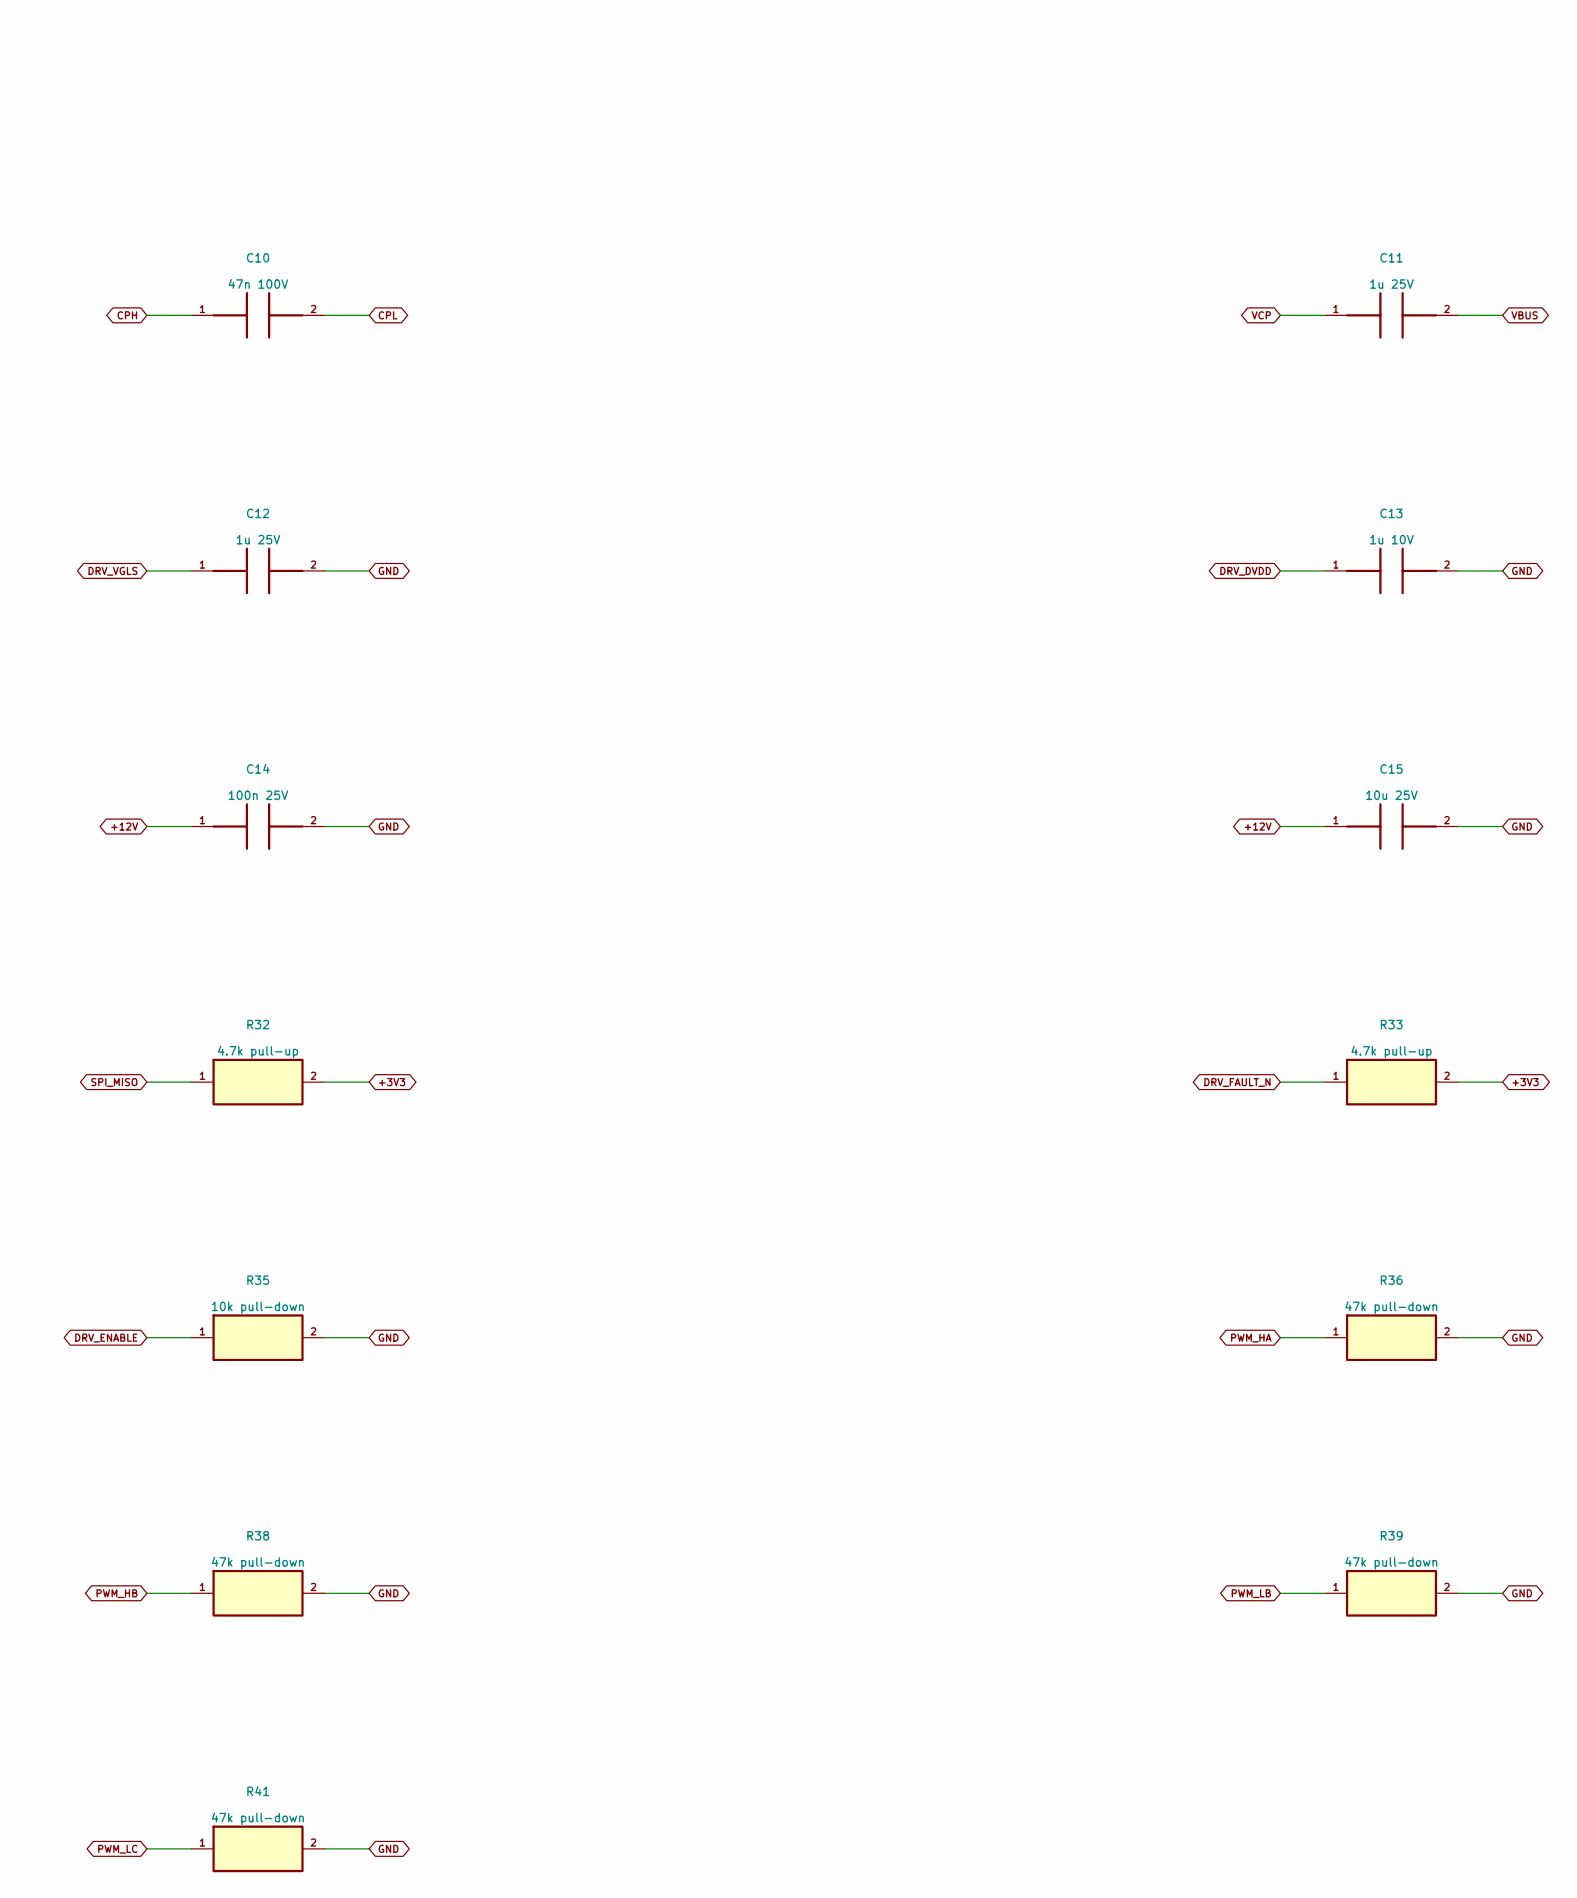
[picture p91: schematic 03_gate_driver.kicad_sch, part in row 1, column 2]

Parts:
C10: 47n 100V
C11, C12: 1u 25V; C_0805_2012Metric
C13: 1u 10V; C_0805_2012Metric
C14: 100n 25V; C_0805_2012Metric
C15: 10u 25V
C16: 100n 10V; C_0805_2012Metric
R32, R33: 4.7k pull-up; R_0805_2012Metric
R34: 10k pull-up; R_0805_2012Metric
R35: 10k pull-down; R_0805_2012Metric
R36, R37, R38, R39, R40, R41: 47k pull-down; R_0805_2012Metric
U1: DRV8353FSRTAR; MPN DRV8353FSRTAR

Connections:
+3V3: R32.2, R33.2, R34.2
+3V3A: C16.1, U1.24 (VREF)
+12V: C14.1, C15.1, U1.3 (VM)
CPH: C10.1, U1.2 (CPH)
CPL: C10.2, U1.1 (CPL)
DRV_CS_N: R34.1, U1.30 (nSCS)
DRV_DVDD: C13.1, U1.38 (DVDD)
DRV_ENABLE: R35.1, U1.31 (ENABLE)
DRV_FAULT_N: R33.1, U1.26 (nFAULT)
DRV_VGLS: C12.1, U1.40 (VGLS)
GHA: U1.6 (GHA)
GHB: U1.15 (GHB)
GHC: U1.16 (GHC)
GLA: U1.8 (GLA)
GLB: U1.13 (GLB)
GLC: U1.18 (GLC)
GND: C12.2, C13.2, C14.2, C15.2, C16.2, R35.2, R36.2, R37.2, R38.2, R39.2, R40.2, R41.2, U1.25 (AGND), U1.39 (GND), U1.41 (EP)
IS_A_N: U1.10 (SNA)
IS_A_P: U1.9 (SPA)
IS_B_N: U1.11 (SNB)
IS_B_P: U1.12 (SPB)
IS_C_N: U1.20 (SNC)
IS_C_P: U1.19 (SPC)
I_A_RAW: U1.23 (SOA)
I_B_RAW: U1.22 (SOB)
I_C_RAW: U1.21 (SOC)
PH_A: U1.7 (SHA)
PH_B: U1.14 (SHB)
PH_C: U1.17 (SHC)
PWM_HA: R36.1, U1.32 (INHA)
PWM_HB: R38.1, U1.34 (INHB)
PWM_HC: R40.1, U1.36 (INHC)
PWM_LA: R37.1, U1.33 (INLA)
PWM_LB: R39.1, U1.35 (INLB)
PWM_LC: R41.1, U1.37 (INLC)
SPI_MISO: R32.1, U1.27 (SDO)
SPI_MOSI: U1.28 (SDI)
SPI_SCK: U1.29 (SCLK)
VBUS: C11.2, U1.4 (VDRAIN)
VCP: C11.1, U1.5 (VCP)

Notes on the sheet:
03 gate driver
A1 REVIEW DRAFT | Global net labels connect sheets | Values and footprints pending release review
