mekiciepcas/ESC-Ai/ESC_V2/hardware/04_voltage_sensing.kicad_sch

## KiCad design ESC_V2/hardware/04_voltage_sensing.kicad_sch (2026-09-18)

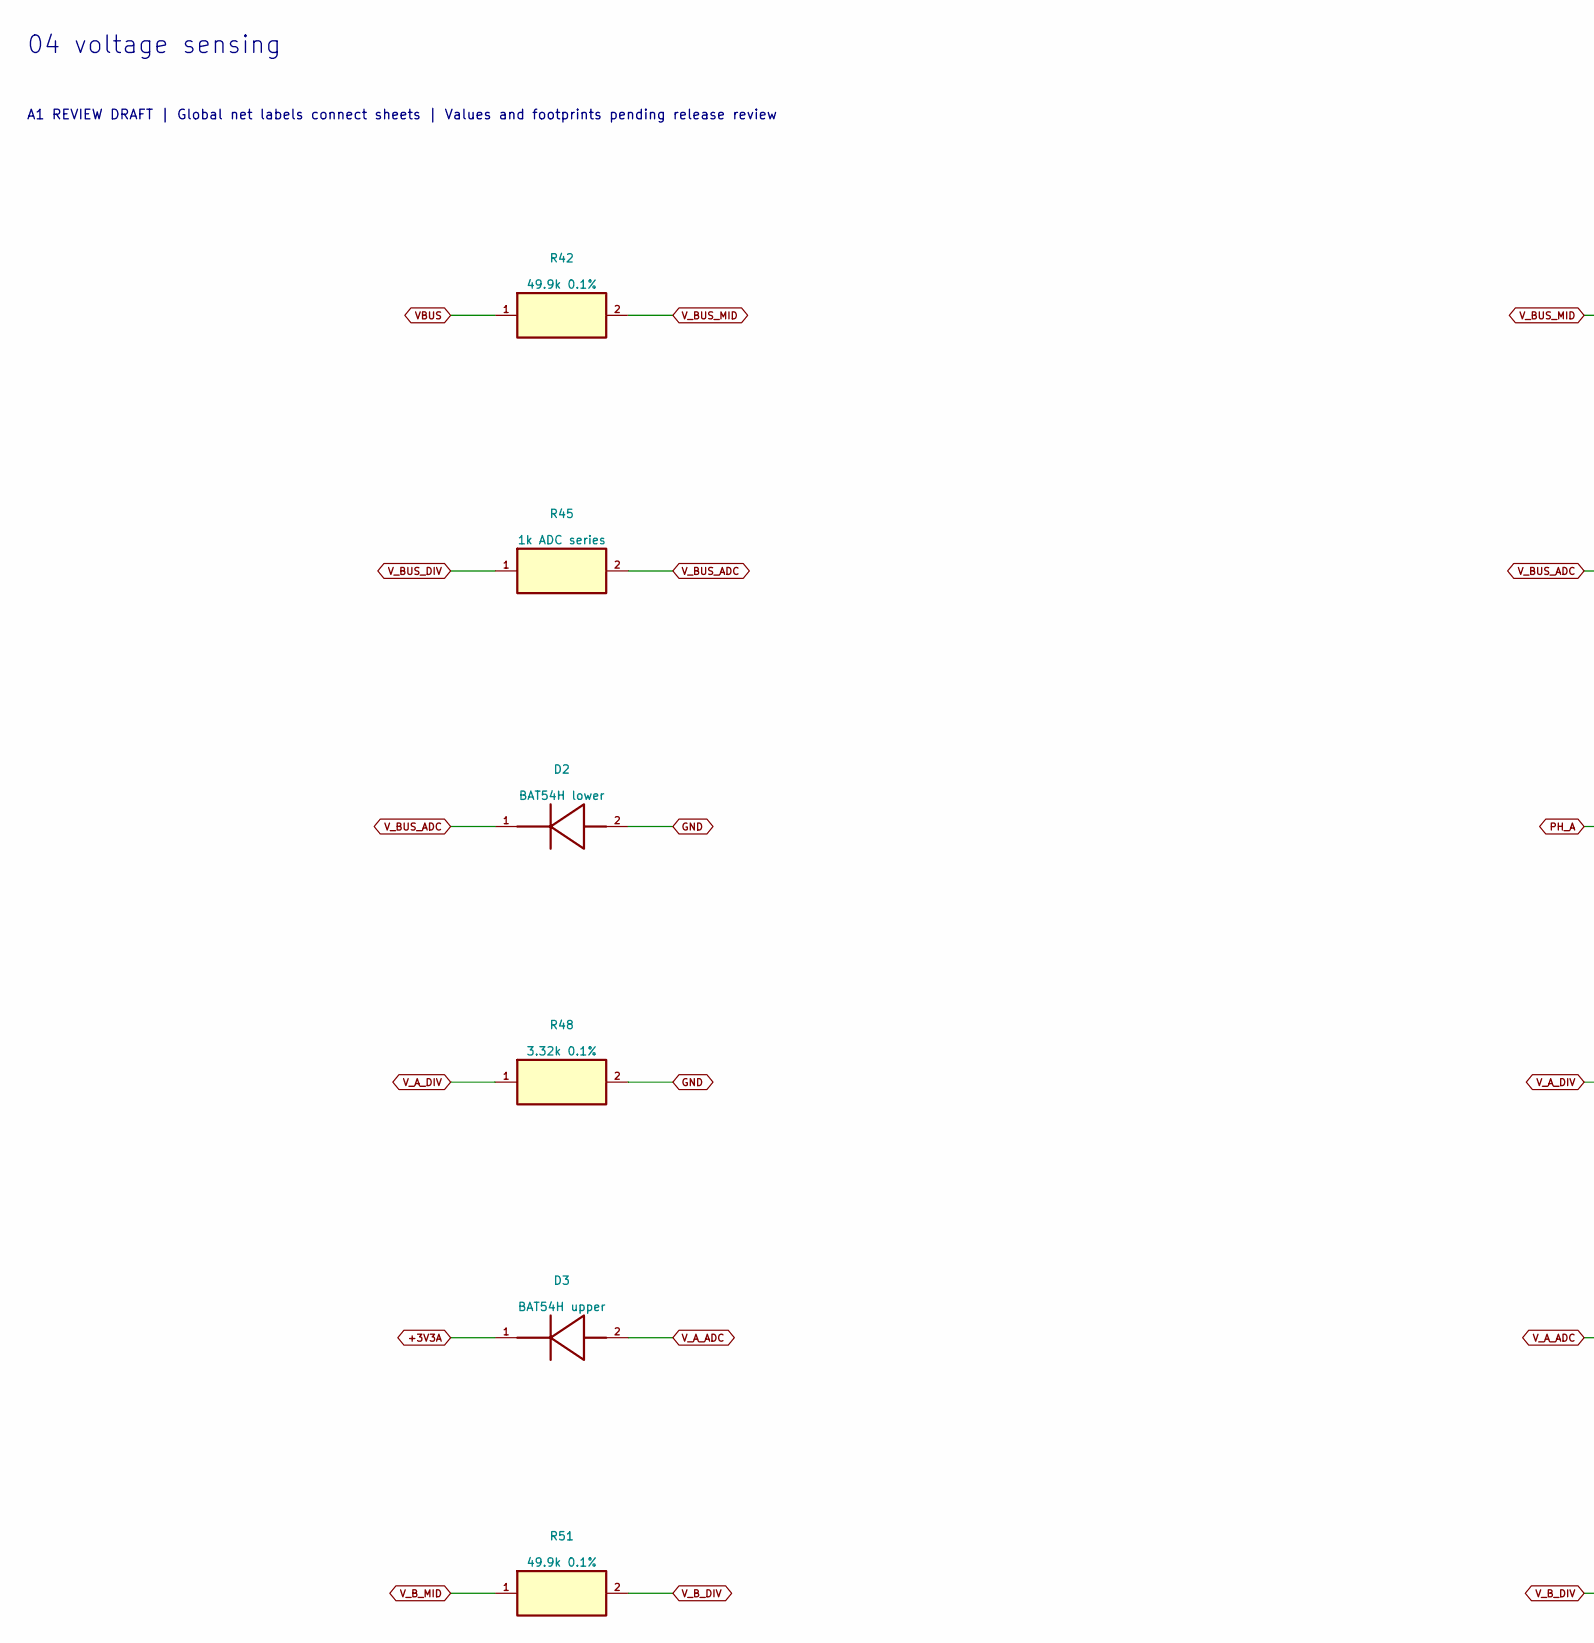
[picture p92: schematic 04_voltage_sensing.kicad_sch, part in row 1, column 1]

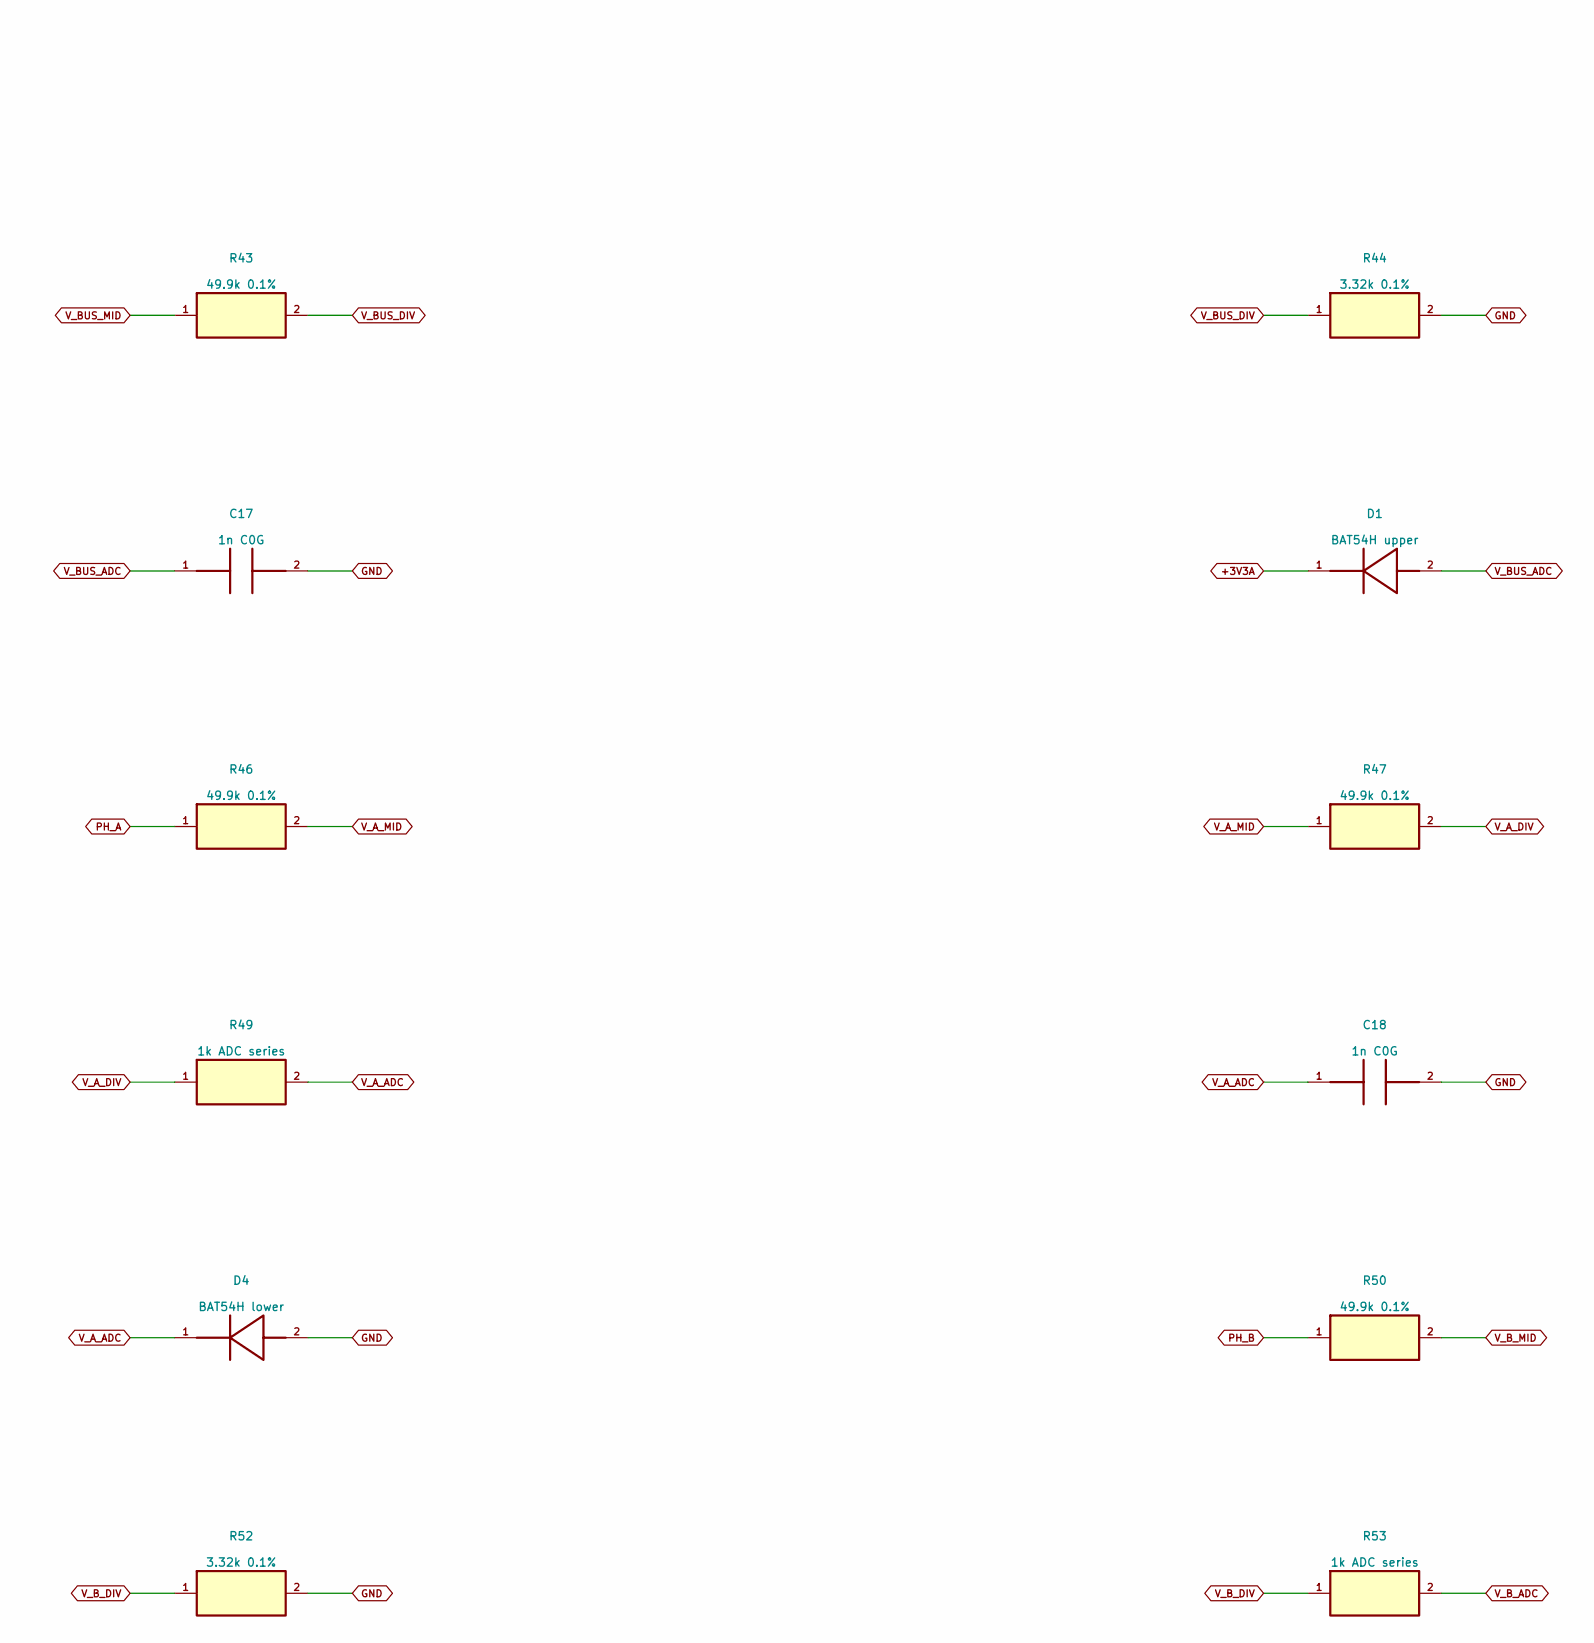
[picture p93: schematic 04_voltage_sensing.kicad_sch, part in row 1, column 2]

Parts:
C17, C18: 1n C0G; C_0805_2012Metric
D1, D3: BAT54H upper; MPN BAT54H
D2, D4: BAT54H lower; MPN BAT54H
R42, R43, R46, R47, R50, R51: 49.9k 0.1%; R_0805_2012Metric
R44, R48, R52: 3.32k 0.1%; R_0805_2012Metric
R45, R49, R53: 1k ADC series; R_0805_2012Metric

Connections:
+3V3A: D1.1 (K), D3.1 (K)
GND: C17.2, C18.2, D2.2 (A), D4.2 (A), R44.2, R48.2, R52.2
PH_A: R46.1
PH_B: R50.1
VBUS: R42.1
V_A_ADC: C18.1, D3.2 (A), D4.1 (K), R49.2
V_A_DIV: R47.2, R48.1, R49.1
V_A_MID: R46.2, R47.1
V_BUS_ADC: C17.1, D1.2 (A), D2.1 (K), R45.2
V_BUS_DIV: R43.2, R44.1, R45.1
V_BUS_MID: R42.2, R43.1
V_B_ADC: R53.2
V_B_DIV: R51.2, R52.1, R53.1
V_B_MID: R50.2, R51.1

Notes on the sheet:
04 voltage sensing
A1 REVIEW DRAFT | Global net labels connect sheets | Values and footprints pending release review
