mekiciepcas/ESC-Ai/ESC_V2/hardware/04_voltage_sensing_2.kicad_sch

## KiCad design ESC_V2/hardware/04_voltage_sensing_2.kicad_sch (2026-09-18)

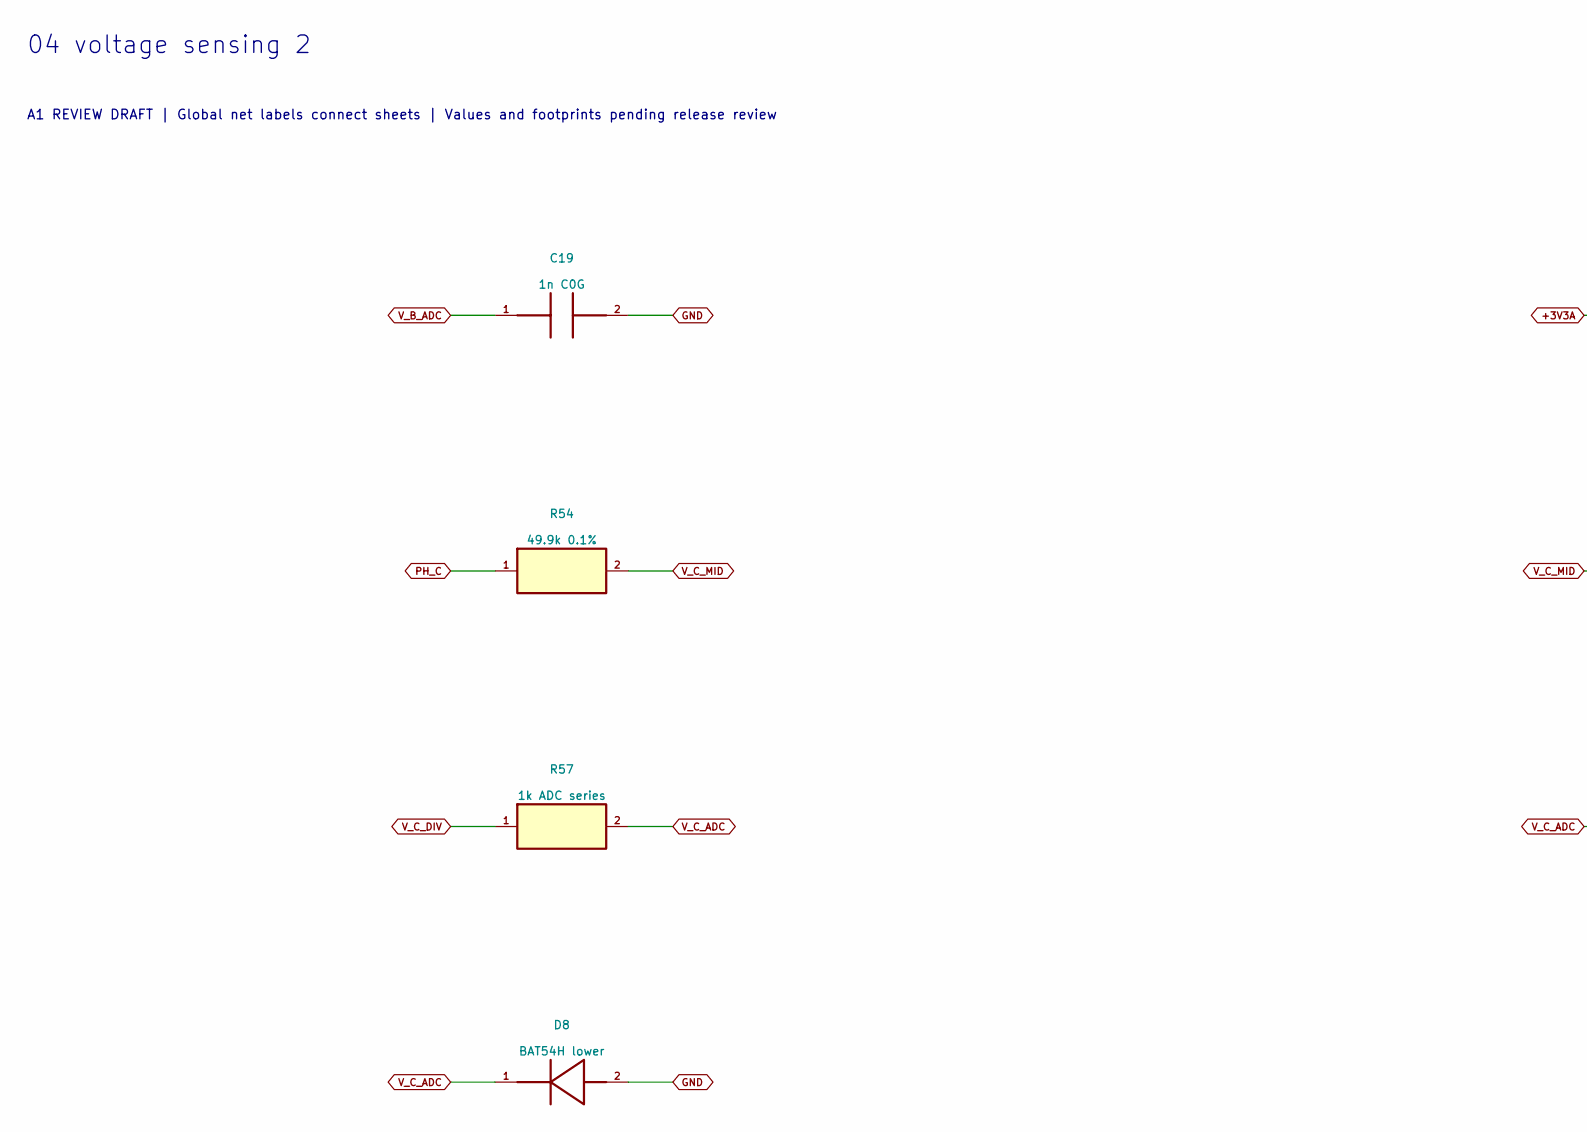
[picture p94: schematic 04_voltage_sensing_2.kicad_sch, part in row 1, column 1]

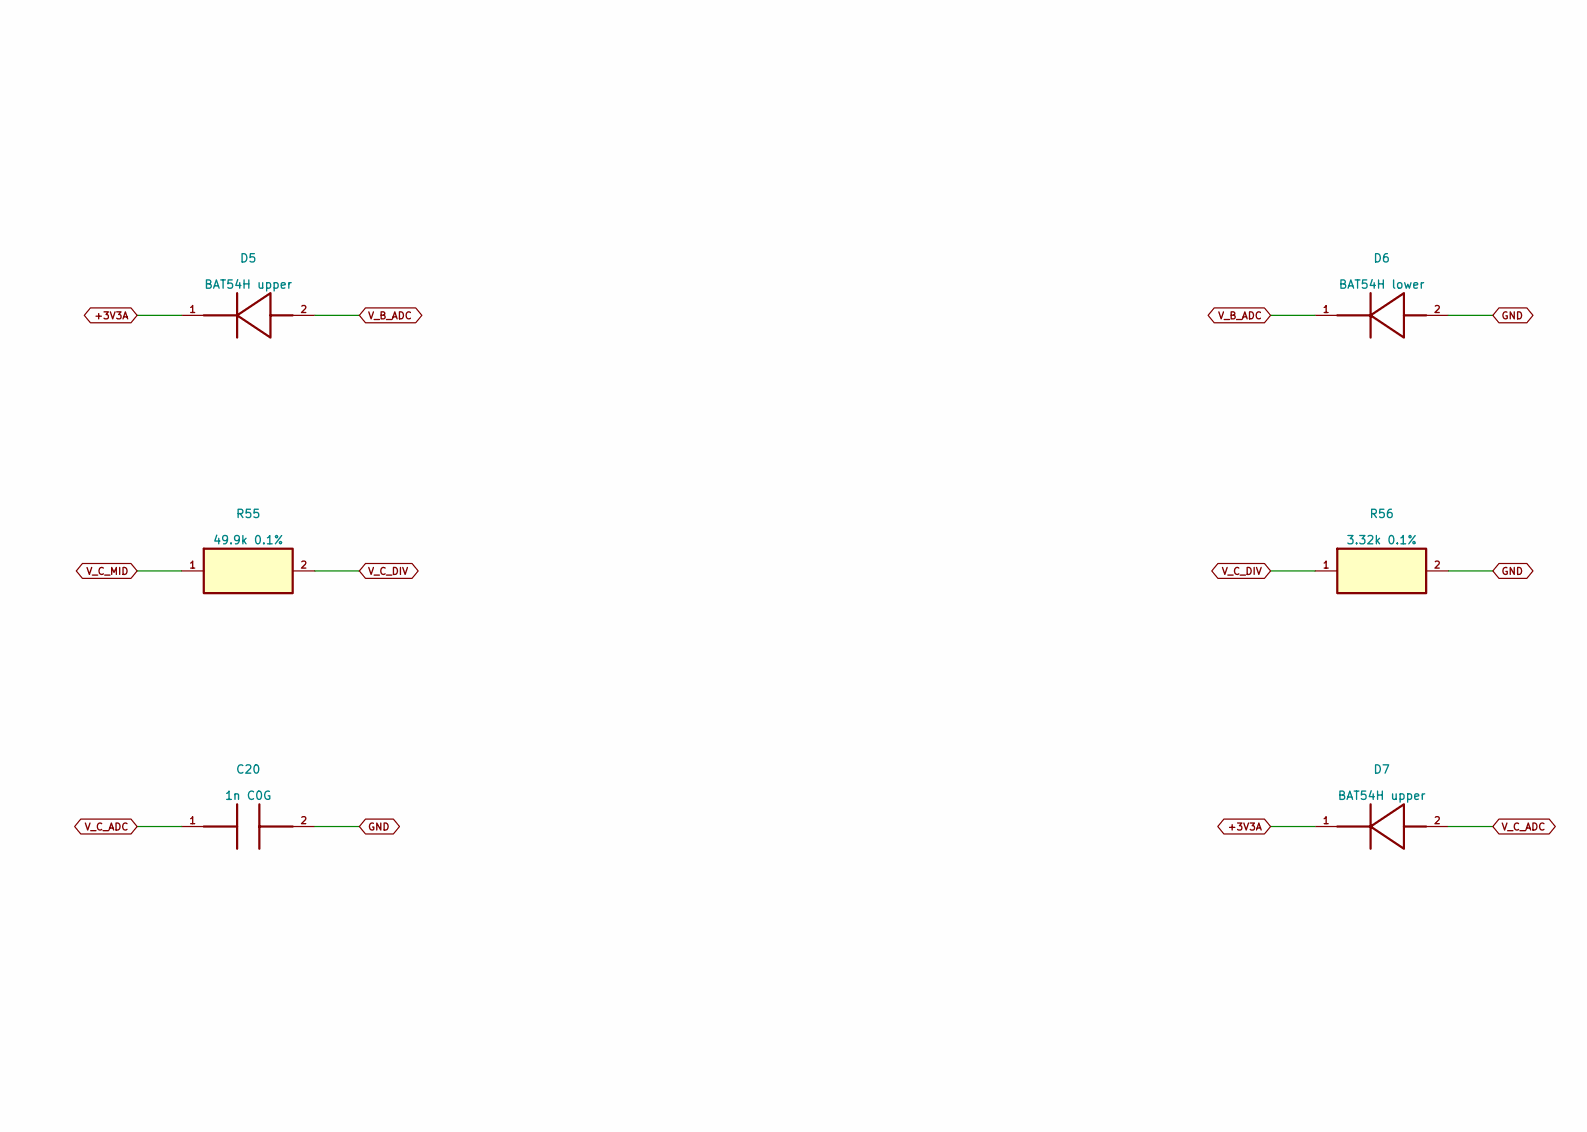
[picture p95: schematic 04_voltage_sensing_2.kicad_sch, part in row 1, column 2]

Parts:
C19, C20: 1n C0G; C_0805_2012Metric
D5, D7: BAT54H upper; MPN BAT54H
D6, D8: BAT54H lower; MPN BAT54H
R54, R55: 49.9k 0.1%; R_0805_2012Metric
R56: 3.32k 0.1%; R_0805_2012Metric
R57: 1k ADC series; R_0805_2012Metric

Connections:
+3V3A: D5.1 (K), D7.1 (K)
GND: C19.2, C20.2, D6.2 (A), D8.2 (A), R56.2
PH_C: R54.1
V_B_ADC: C19.1, D5.2 (A), D6.1 (K)
V_C_ADC: C20.1, D7.2 (A), D8.1 (K), R57.2
V_C_DIV: R55.2, R56.1, R57.1
V_C_MID: R54.2, R55.1

Notes on the sheet:
04 voltage sensing 2
A1 REVIEW DRAFT | Global net labels connect sheets | Values and footprints pending release review
