mekiciepcas/ESC-Ai/ESC_V2/hardware/05_current_and_temperature.kicad_sch

## KiCad design ESC_V2/hardware/05_current_and_temperature.kicad_sch (2026-09-18)

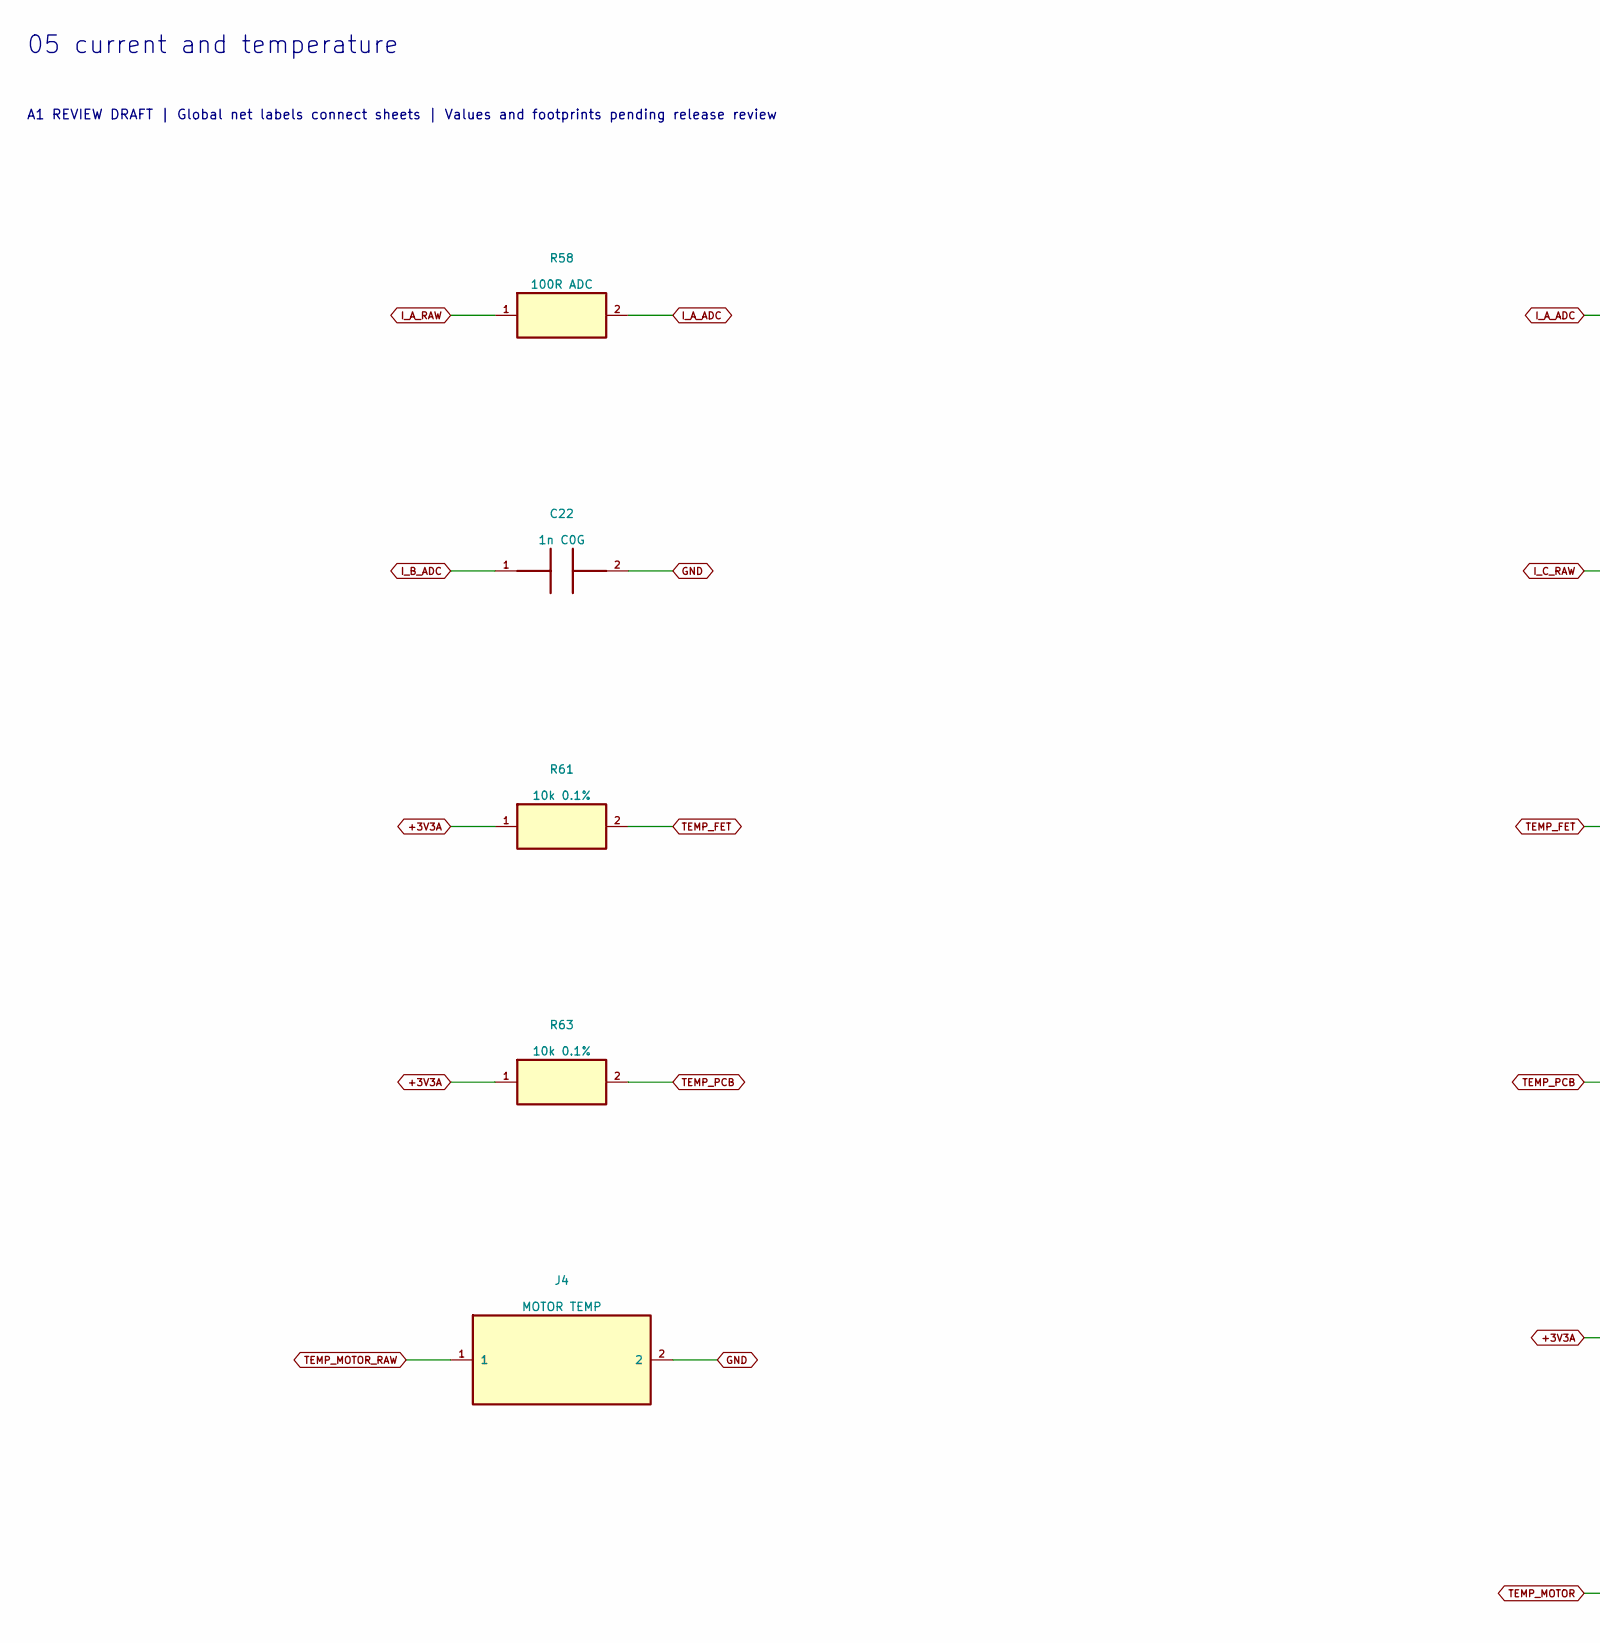
[picture p96: schematic 05_current_and_temperature.kicad_sch, part in row 1, column 1]

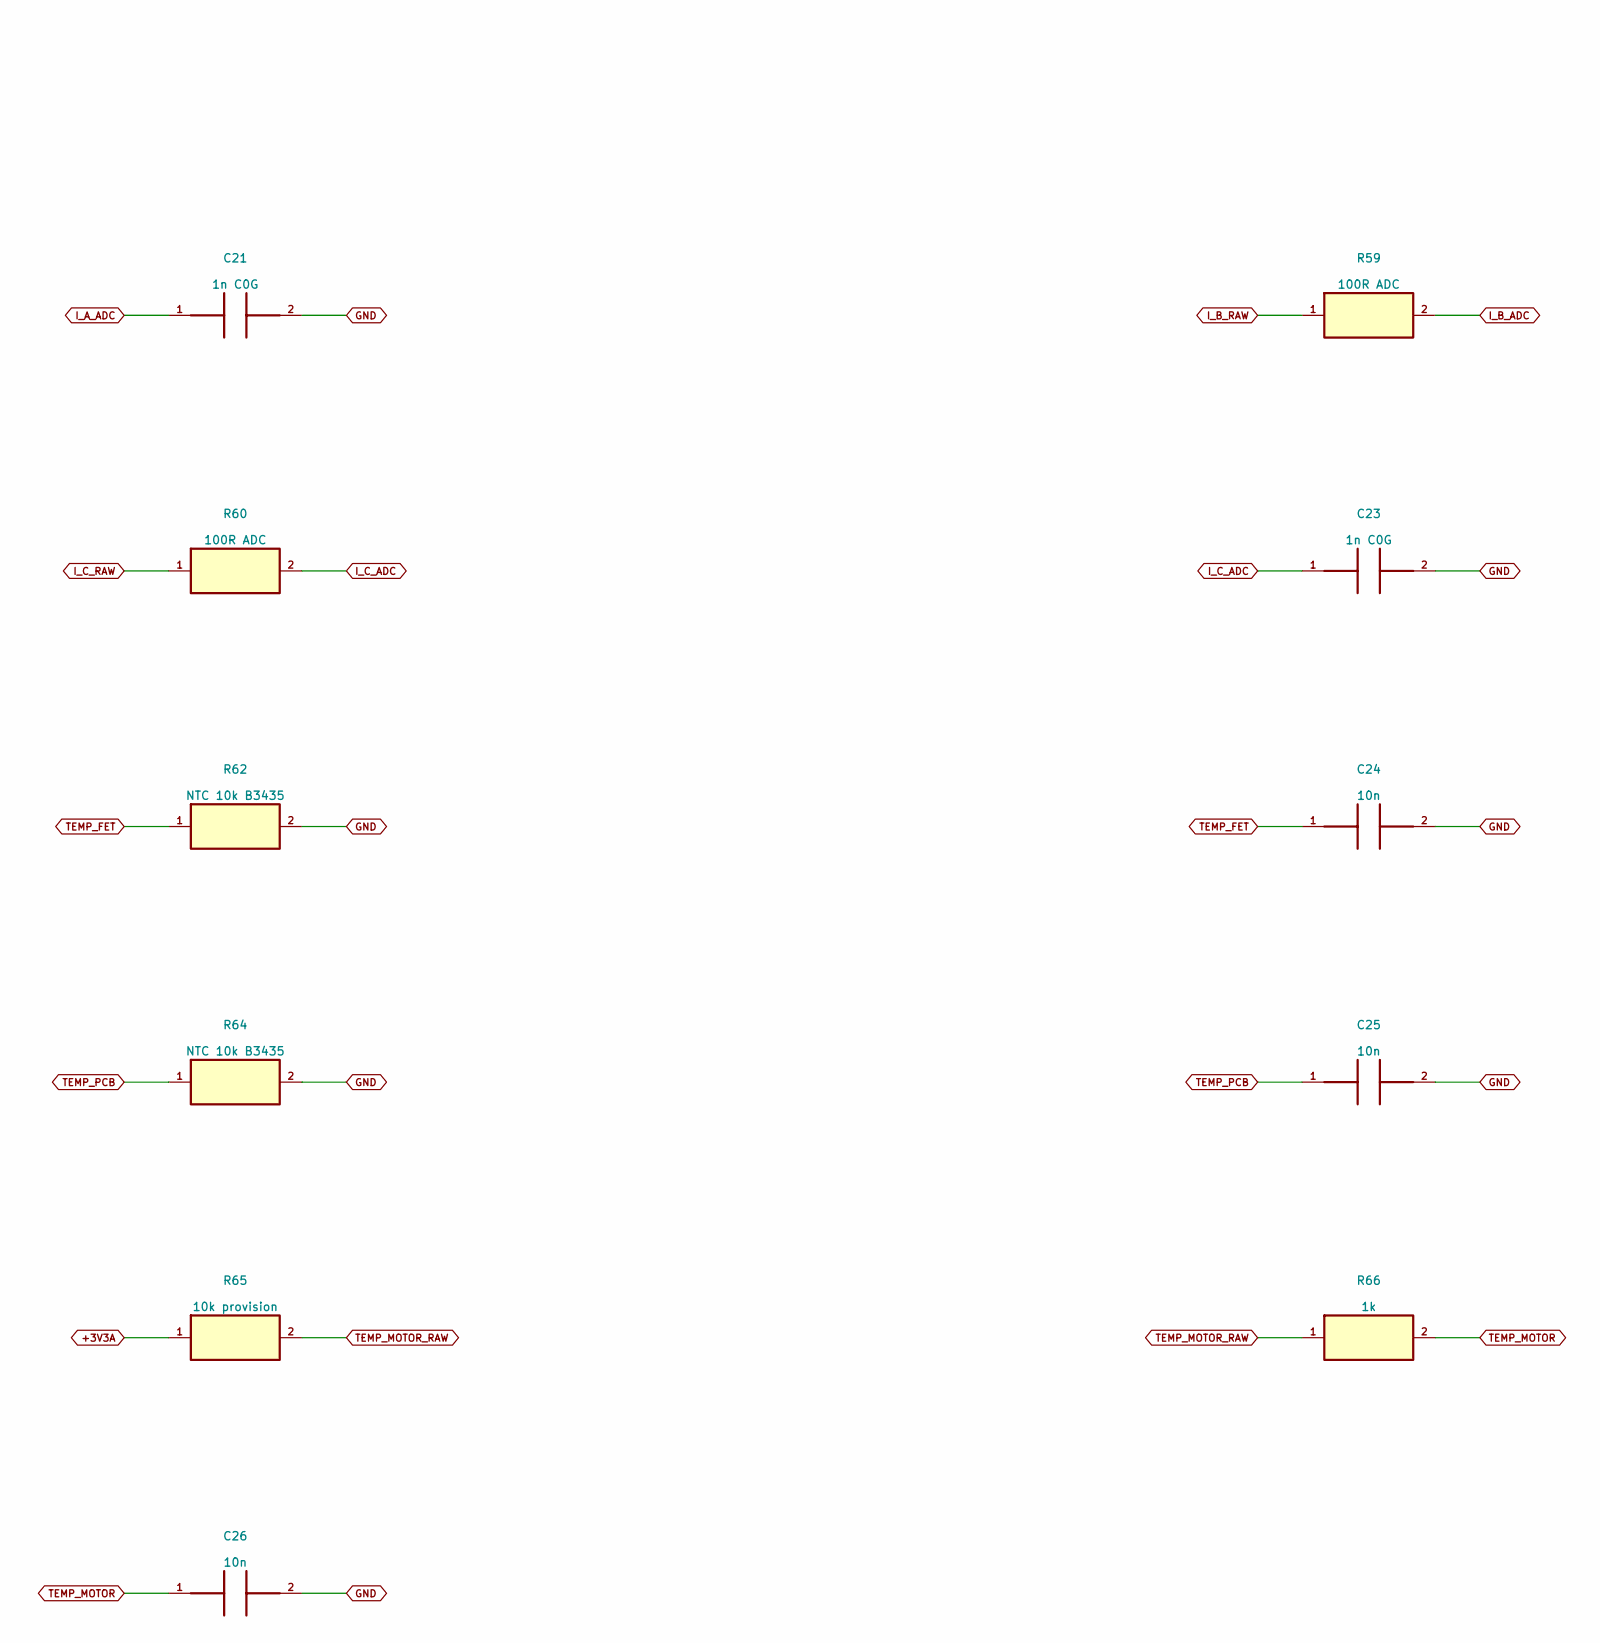
[picture p97: schematic 05_current_and_temperature.kicad_sch, part in row 1, column 2]

Parts:
C21, C22, C23: 1n C0G; C_0805_2012Metric
C24, C25, C26: 10n; C_0805_2012Metric
J4: MOTOR TEMP
R58, R59, R60: 100R ADC; R_0805_2012Metric
R61, R63: 10k 0.1%; R_0805_2012Metric
R62, R64: NTC 10k B3435
R65: 10k provision; R_0805_2012Metric
R66: 1k; R_0805_2012Metric

Connections:
+3V3A: R61.1, R63.1, R65.1
GND: C21.2, C22.2, C23.2, C24.2, C25.2, C26.2, J4.2, R62.2, R64.2
I_A_ADC: C21.1, R58.2
I_A_RAW: R58.1
I_B_ADC: C22.1, R59.2
I_B_RAW: R59.1
I_C_ADC: C23.1, R60.2
I_C_RAW: R60.1
TEMP_FET: C24.1, R61.2, R62.1
TEMP_MOTOR: C26.1, R66.2
TEMP_MOTOR_RAW: J4.1, R65.2, R66.1
TEMP_PCB: C25.1, R63.2, R64.1

Notes on the sheet:
05 current and temperature
A1 REVIEW DRAFT | Global net labels connect sheets | Values and footprints pending release review
