mekiciepcas/ESC-Ai/ESC_V2/hardware/06_aux_12V.kicad_sch

## KiCad design ESC_V2/hardware/06_aux_12V.kicad_sch (2026-09-18)

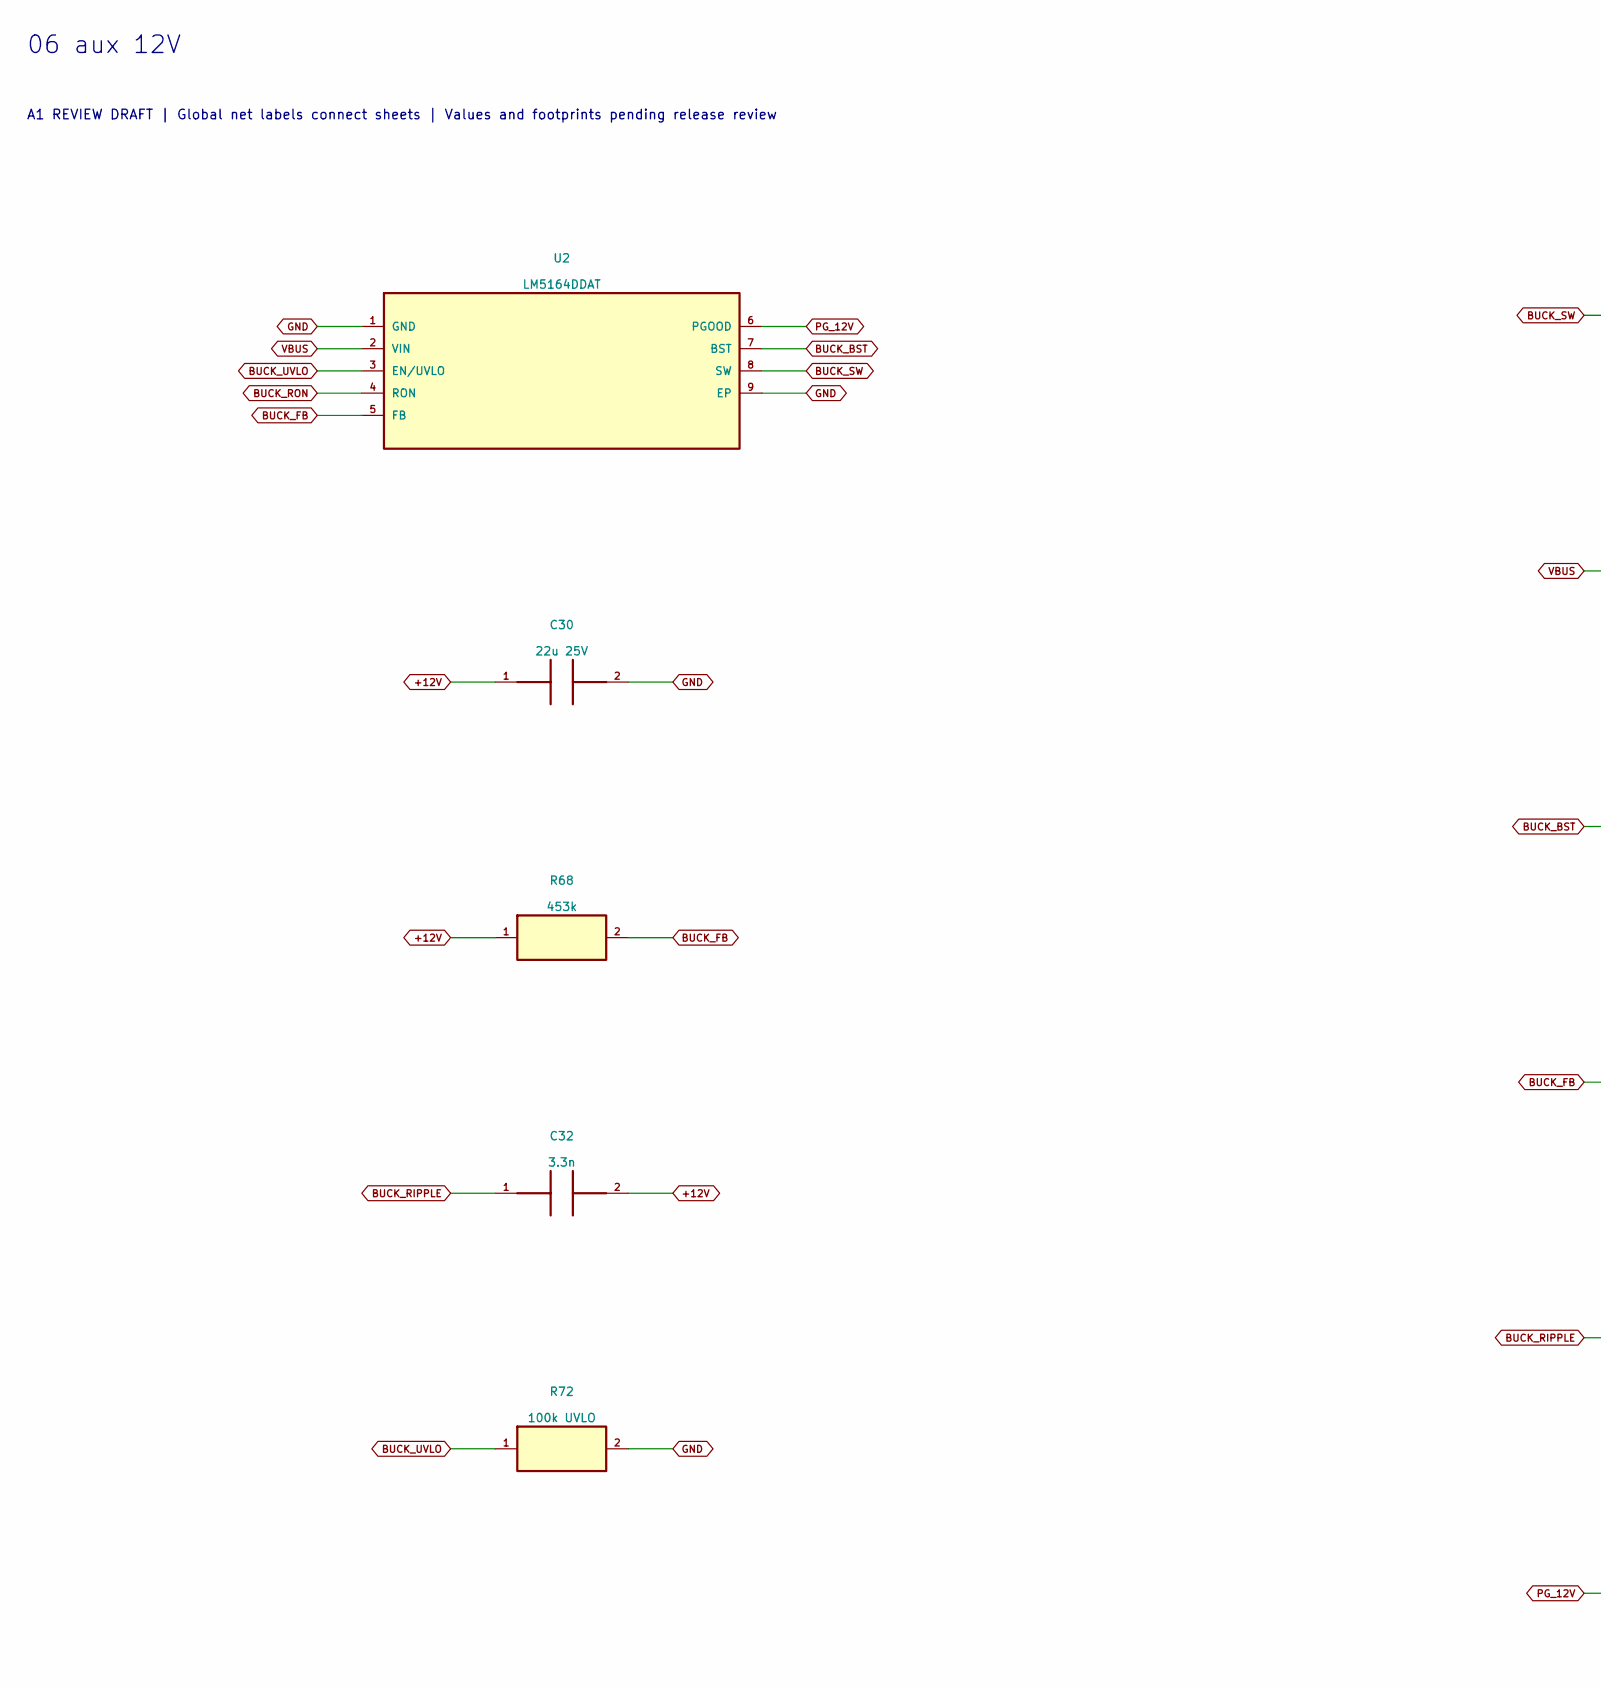
[picture p98: schematic 06_aux_12V.kicad_sch, part in row 1, column 1]

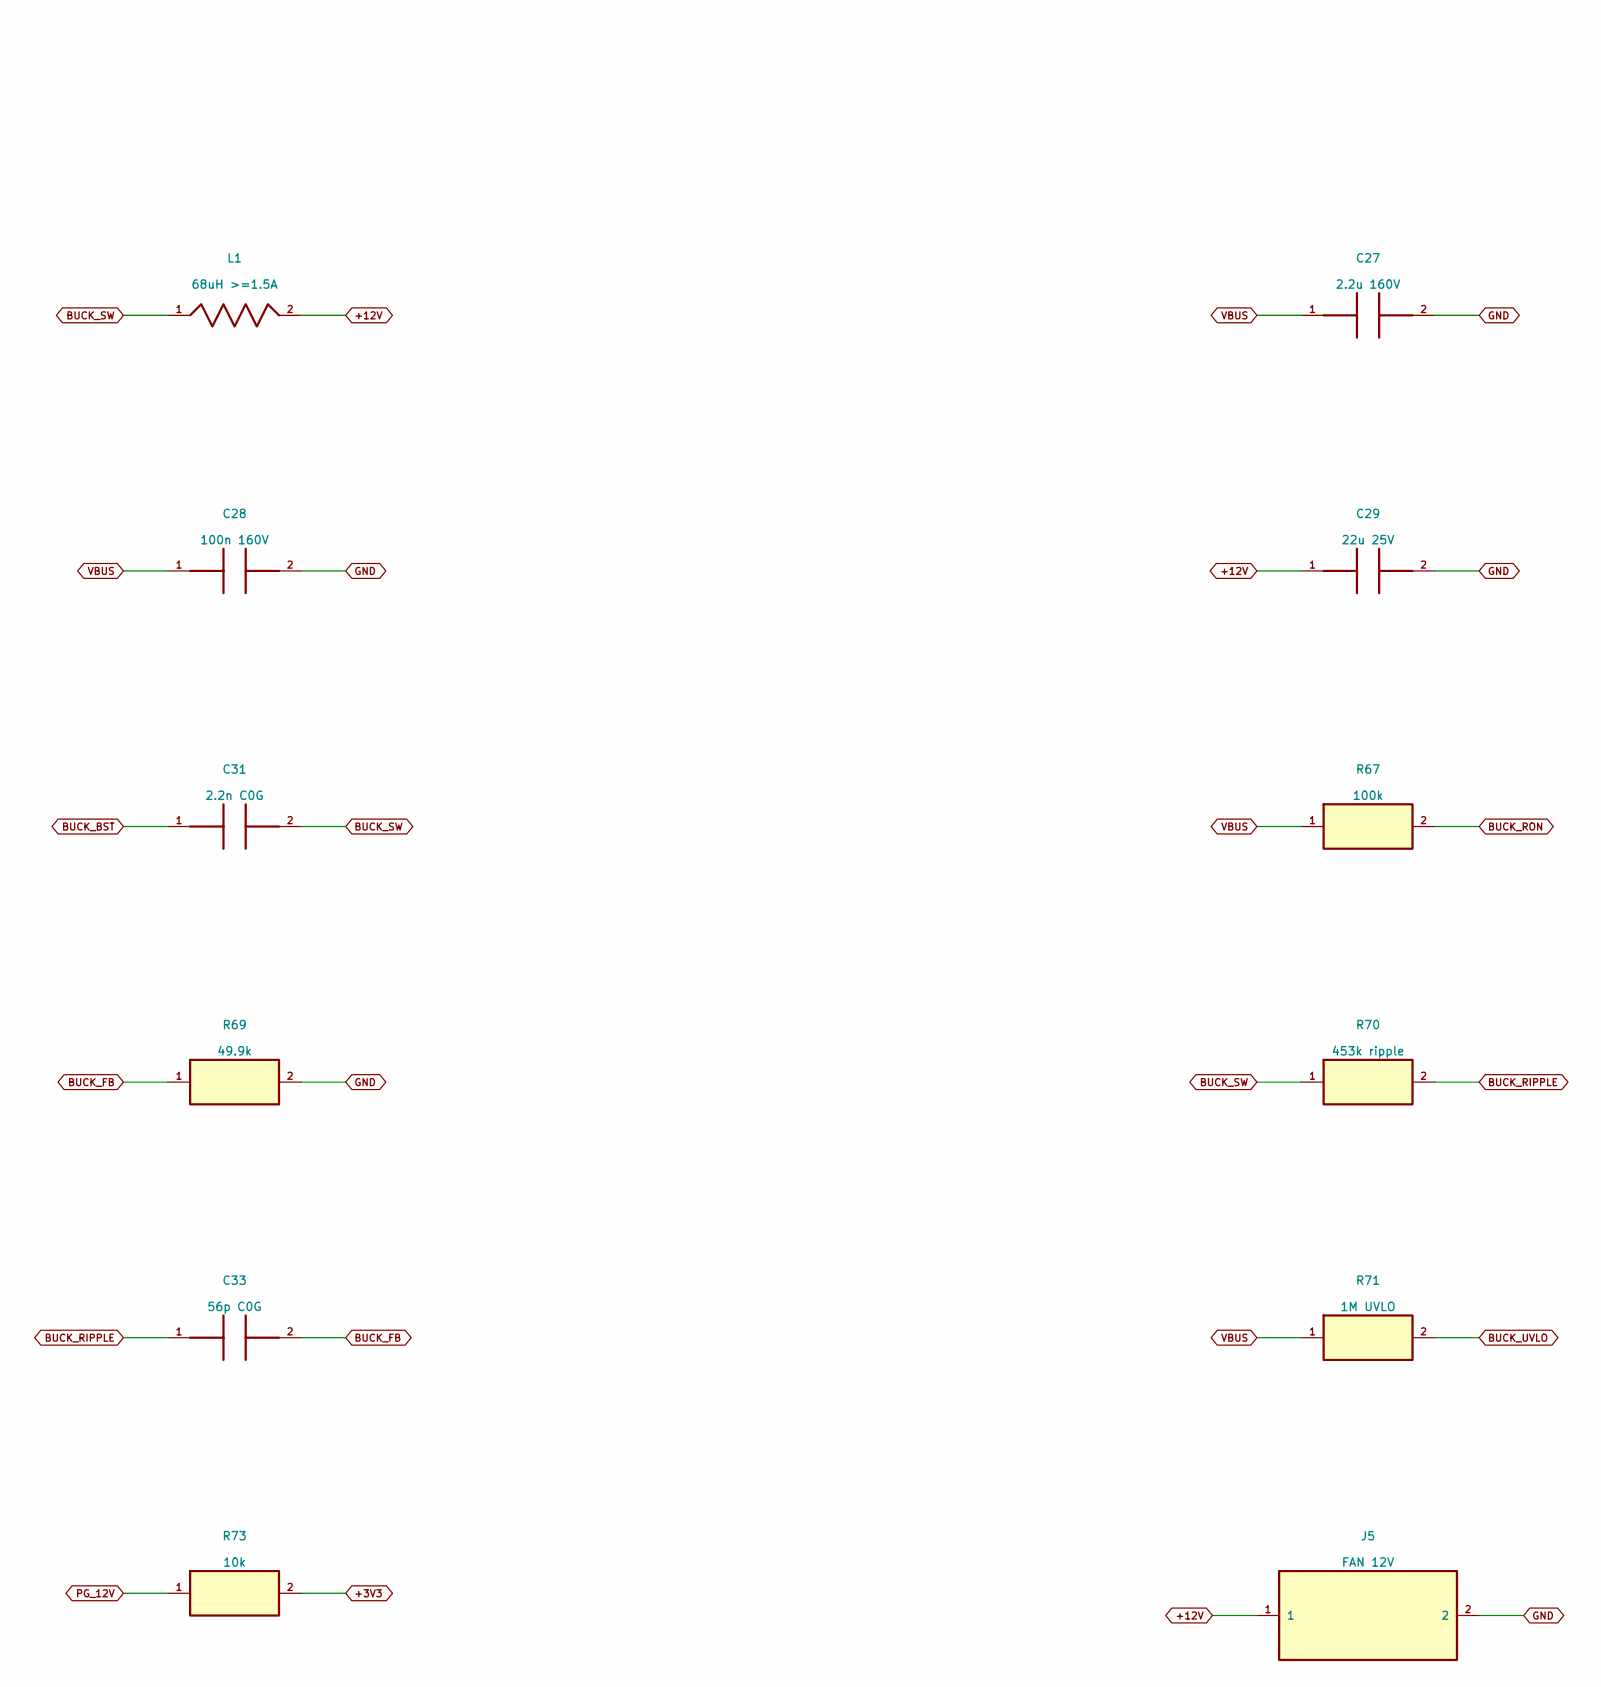
[picture p99: schematic 06_aux_12V.kicad_sch, part in row 1, column 2]

Parts:
C27: 2.2u 160V
C28: 100n 160V
C29, C30: 22u 25V
C31: 2.2n C0G; C_0805_2012Metric
C32: 3.3n; C_0805_2012Metric
C33: 56p C0G; C_0805_2012Metric
J5: FAN 12V
L1: 68uH >=1.5A
R67: 100k; R_0805_2012Metric
R68: 453k; R_0805_2012Metric
R69: 49.9k; R_0805_2012Metric
R70: 453k ripple; R_0805_2012Metric
R71: 1M UVLO; R_0805_2012Metric
R72: 100k UVLO; R_0805_2012Metric
R73: 10k; R_0805_2012Metric
U2: LM5164DDAT; HSOP-8-1EP_3.9x4.9mm_P1.27mm_EP2.41x3.1mm_ThermalVias; MPN LM5164DDAT

Connections:
+3V3: R73.2
+12V: C29.1, C30.1, C32.2, J5.1, L1.2, R68.1
BUCK_BST: C31.1, U2.7 (BST)
BUCK_FB: C33.2, R68.2, R69.1, U2.5 (FB)
BUCK_RIPPLE: C32.1, C33.1, R70.2
BUCK_RON: R67.2, U2.4 (RON)
BUCK_SW: C31.2, L1.1, R70.1, U2.8 (SW)
BUCK_UVLO: R71.2, R72.1, U2.3 (EN/UVLO)
GND: C27.2, C28.2, C29.2, C30.2, J5.2, R69.2, R72.2, U2.1 (GND), U2.9 (EP)
PG_12V: R73.1, U2.6 (PGOOD)
VBUS: C27.1, C28.1, R67.1, R71.1, U2.2 (VIN)

Notes on the sheet:
06 aux 12V
A1 REVIEW DRAFT | Global net labels connect sheets | Values and footprints pending release review
