mekiciepcas/ESC-Ai/ESC_V2/hardware/07_aux_5V_3V3.kicad_sch

## KiCad design ESC_V2/hardware/07_aux_5V_3V3.kicad_sch (2026-09-18)

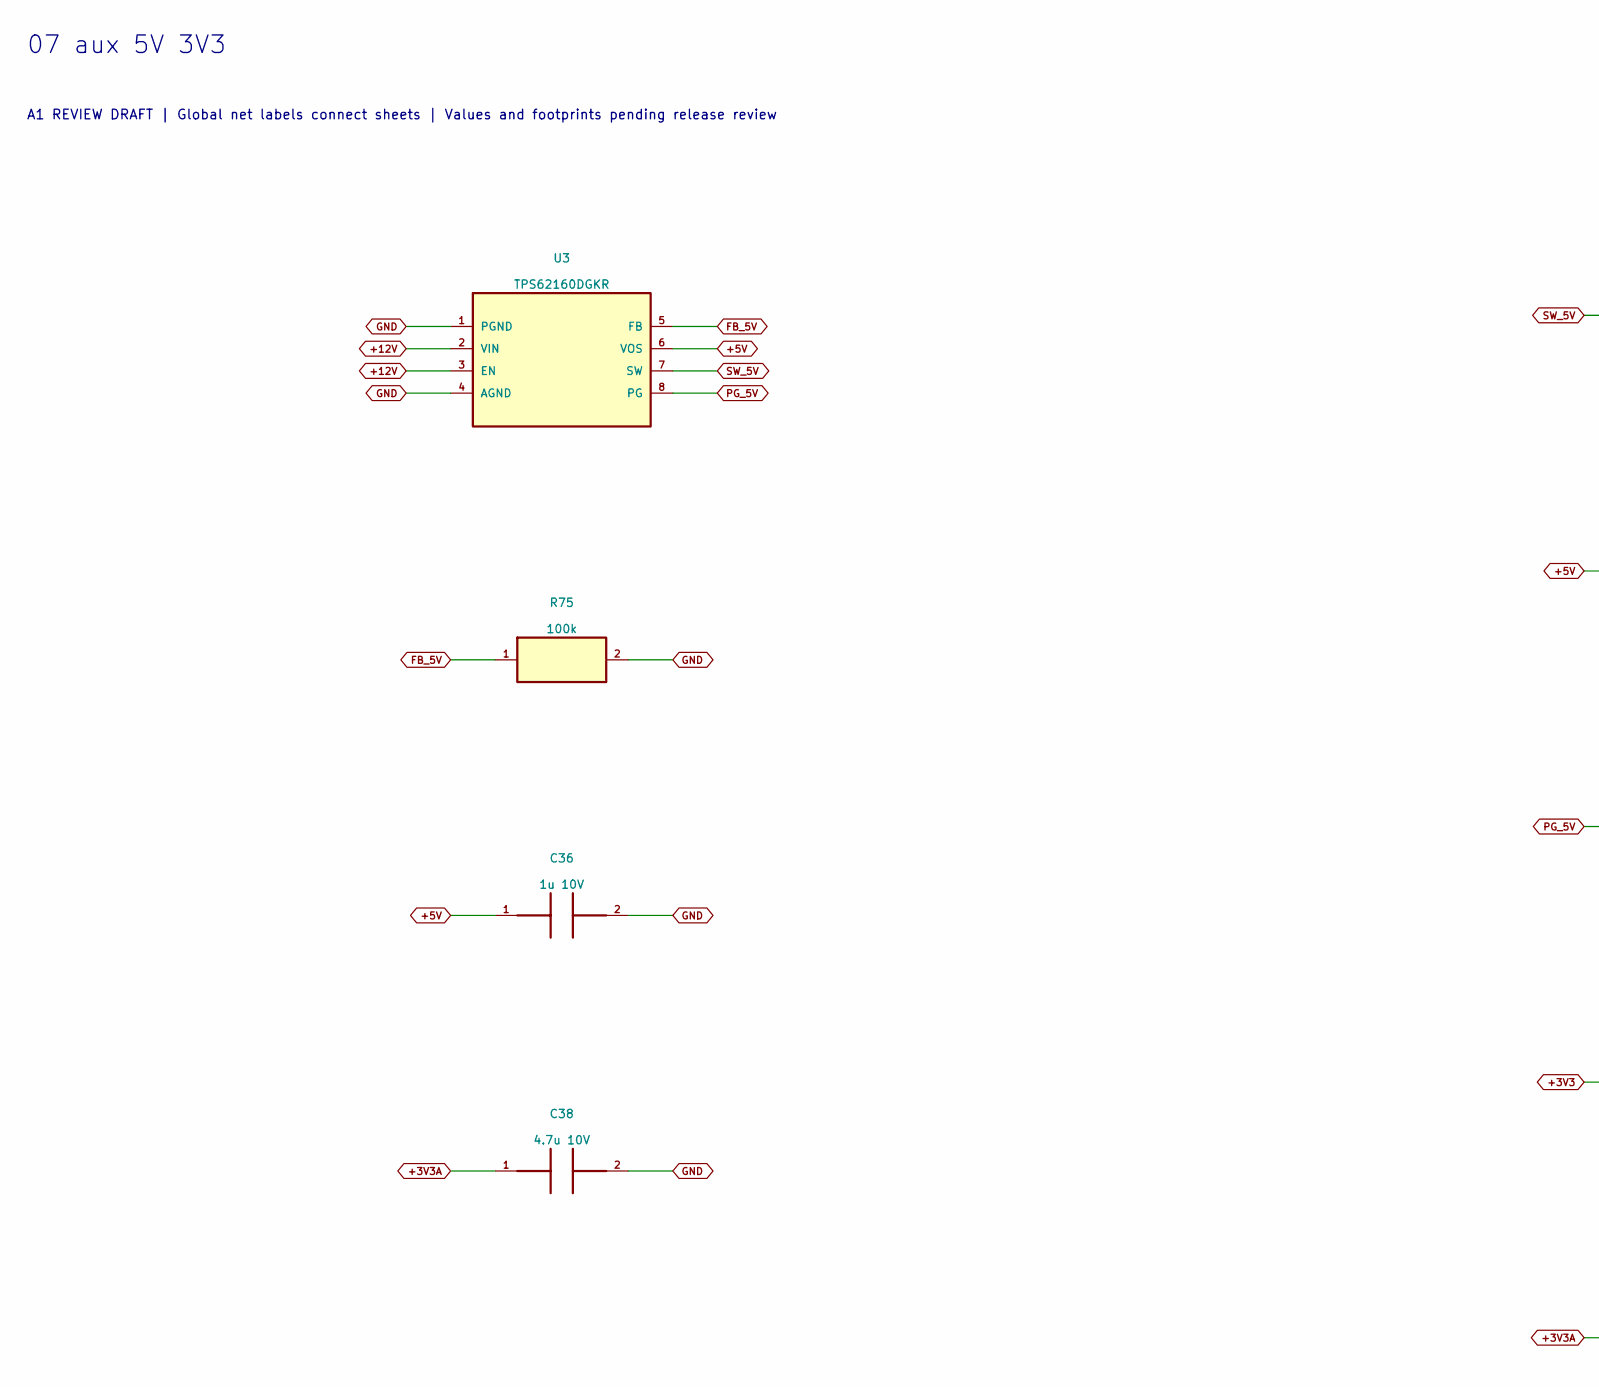
[picture p100: schematic 07_aux_5V_3V3.kicad_sch, part in row 1, column 1]

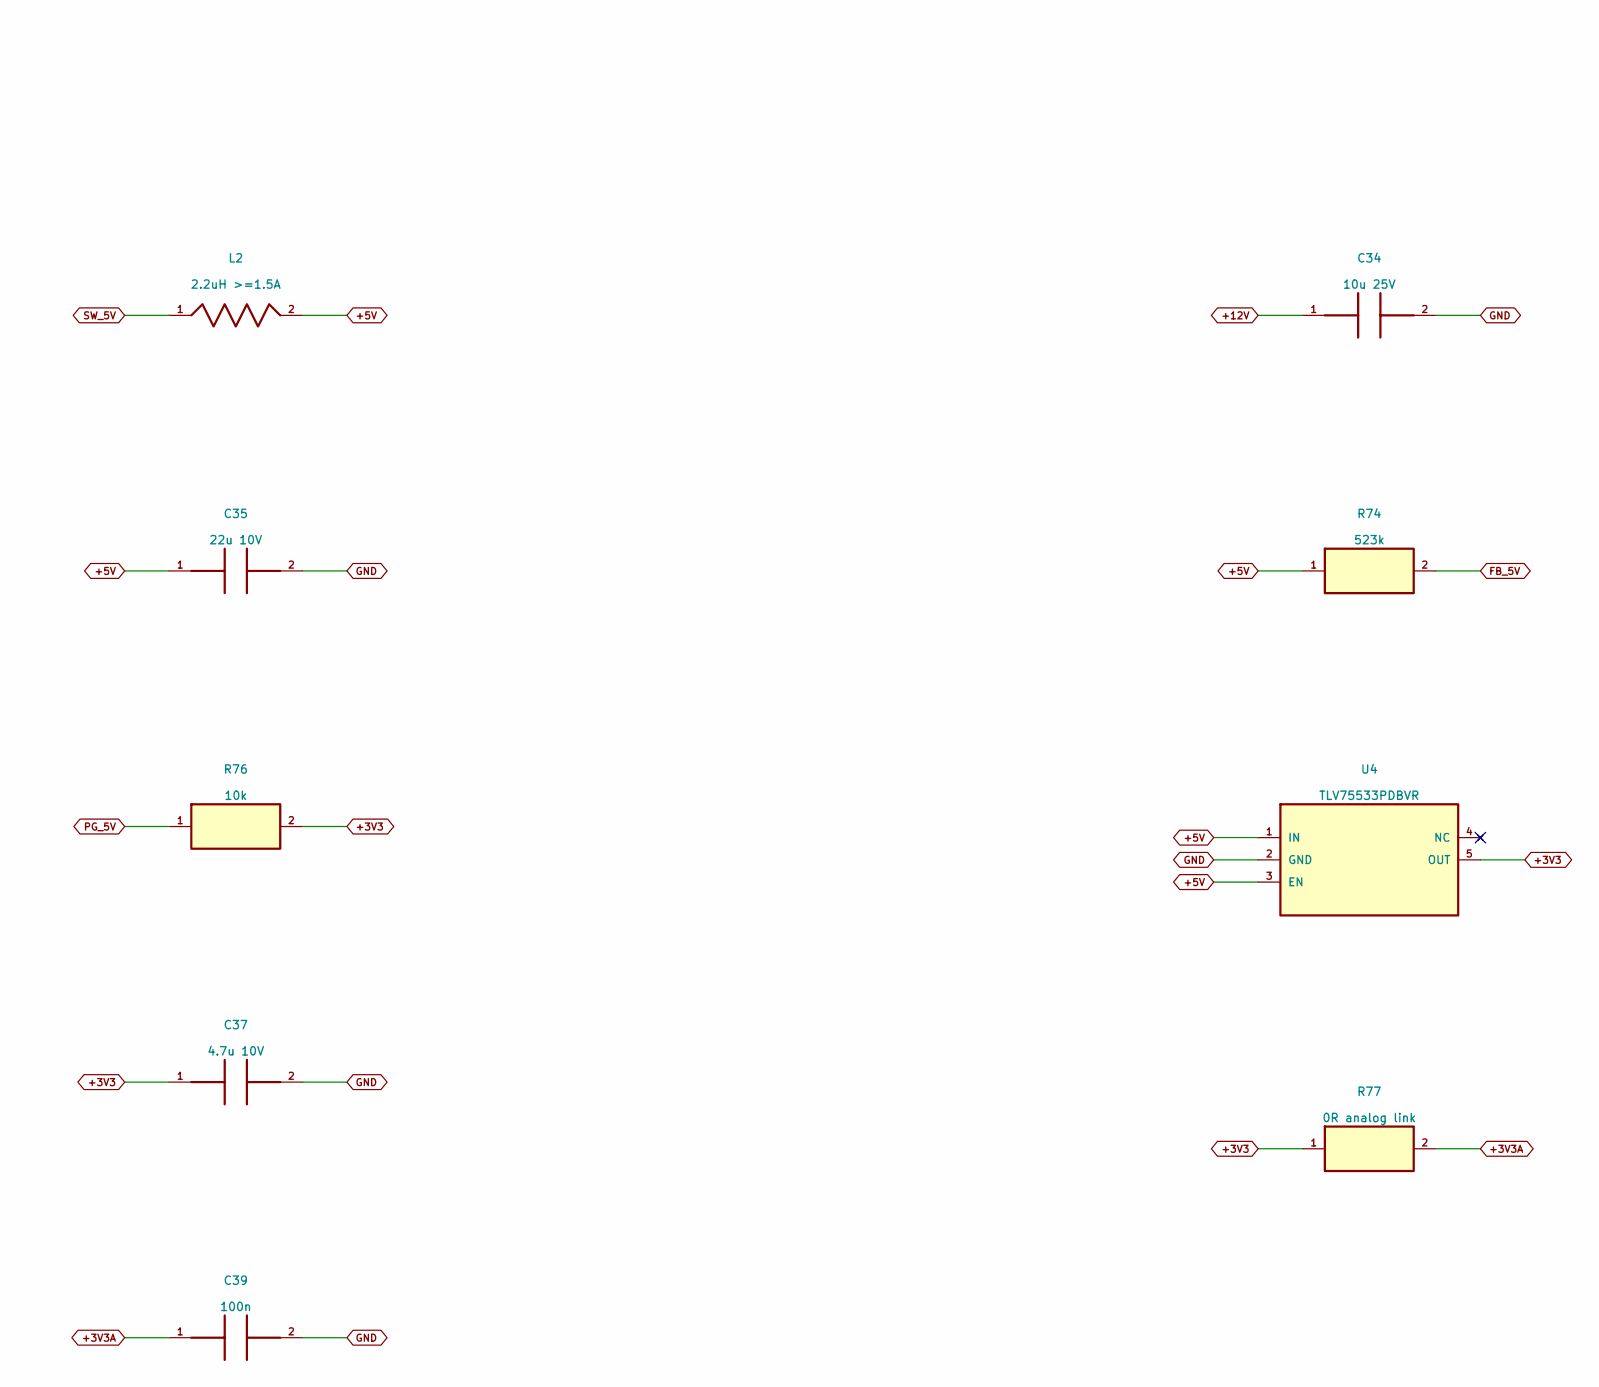
[picture p101: schematic 07_aux_5V_3V3.kicad_sch, part in row 1, column 2]

Parts:
C34: 10u 25V
C35: 22u 10V
C36: 1u 10V; C_0805_2012Metric
C37, C38: 4.7u 10V
C39: 100n; C_0805_2012Metric
L2: 2.2uH >=1.5A
R74: 523k; R_0805_2012Metric
R75: 100k; R_0805_2012Metric
R76: 10k; R_0805_2012Metric
R77: 0R analog link; R_0805_2012Metric
U3: TPS62160DGKR; VSSOP-8_3x3mm_P0.65mm; MPN TPS62160DGKR
U4: TLV75533PDBVR; SOT-23-5; MPN TLV75533PDBVR

Connections:
+3V3: C37.1, R76.2, R77.1, U4.5 (OUT)
+3V3A: C38.1, C39.1, R77.2
+5V: C35.1, C36.1, L2.2, R74.1, U3.6 (VOS), U4.1 (IN), U4.3 (EN)
+12V: C34.1, U3.2 (VIN), U3.3 (EN)
FB_5V: R74.2, R75.1, U3.5 (FB)
GND: C34.2, C35.2, C36.2, C37.2, C38.2, C39.2, R75.2, U3.1 (PGND), U3.4 (AGND), U4.2 (GND)
PG_5V: R76.1, U3.8 (PG)
SW_5V: L2.1, U3.7 (SW)

Notes on the sheet:
07 aux 5V 3V3
A1 REVIEW DRAFT | Global net labels connect sheets | Values and footprints pending release review
