mekiciepcas/ESC-Ai/ESC_V2/hardware/08_MCU.kicad_sch

## KiCad design ESC_V2/hardware/08_MCU.kicad_sch (2026-09-18)

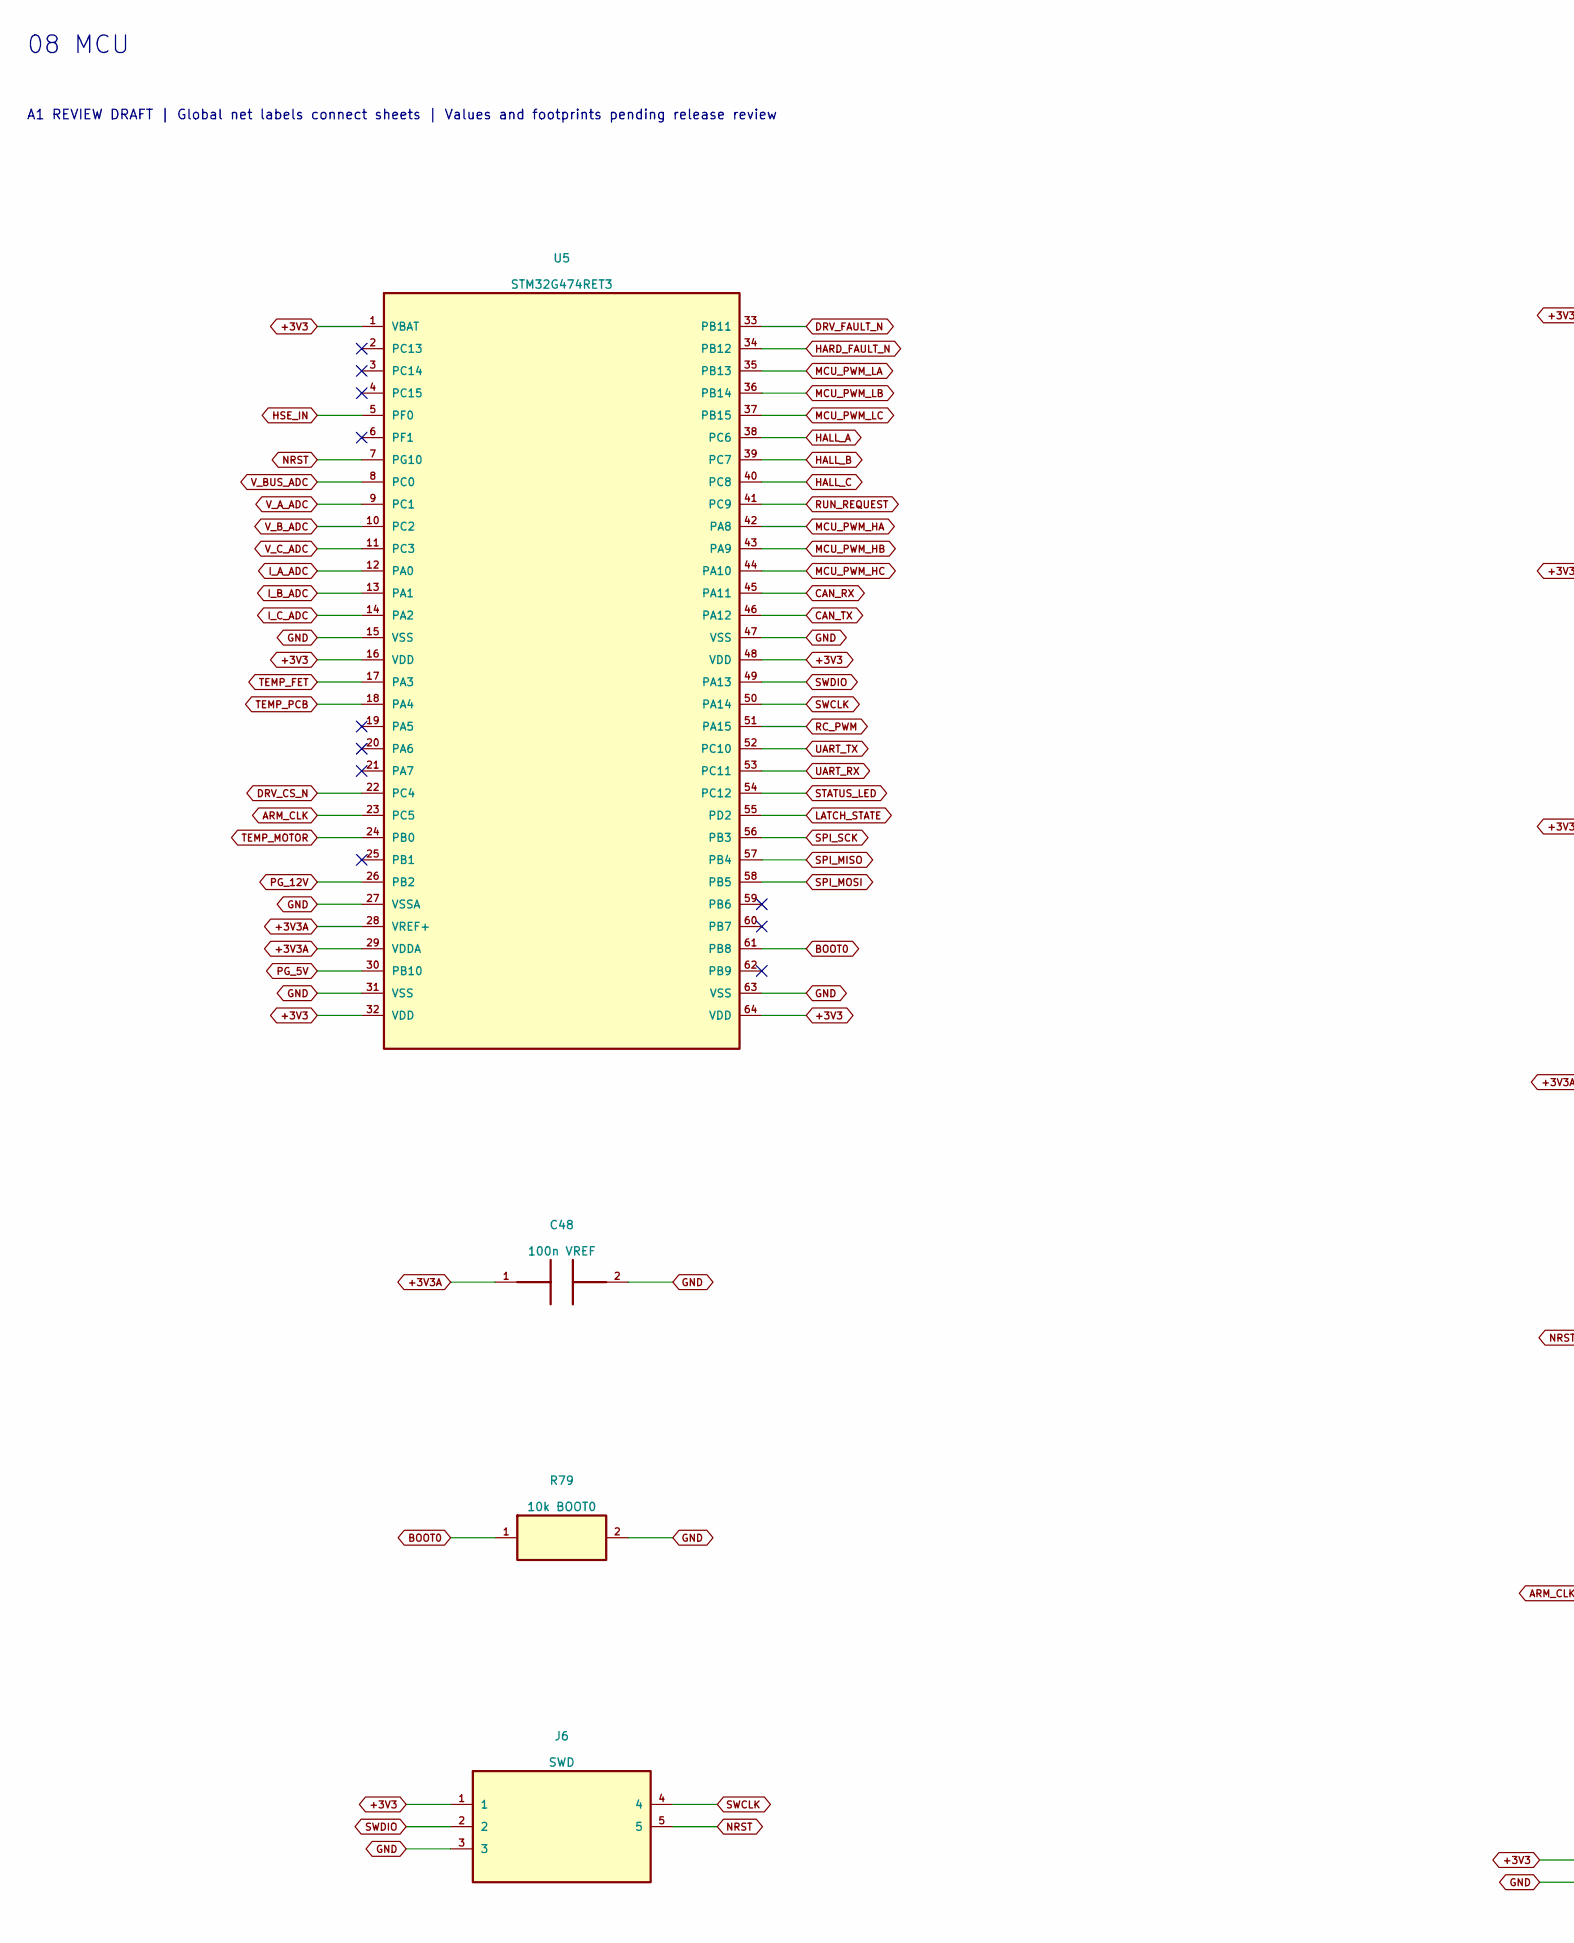
[picture p102: schematic 08_MCU.kicad_sch, part in row 1, column 1]

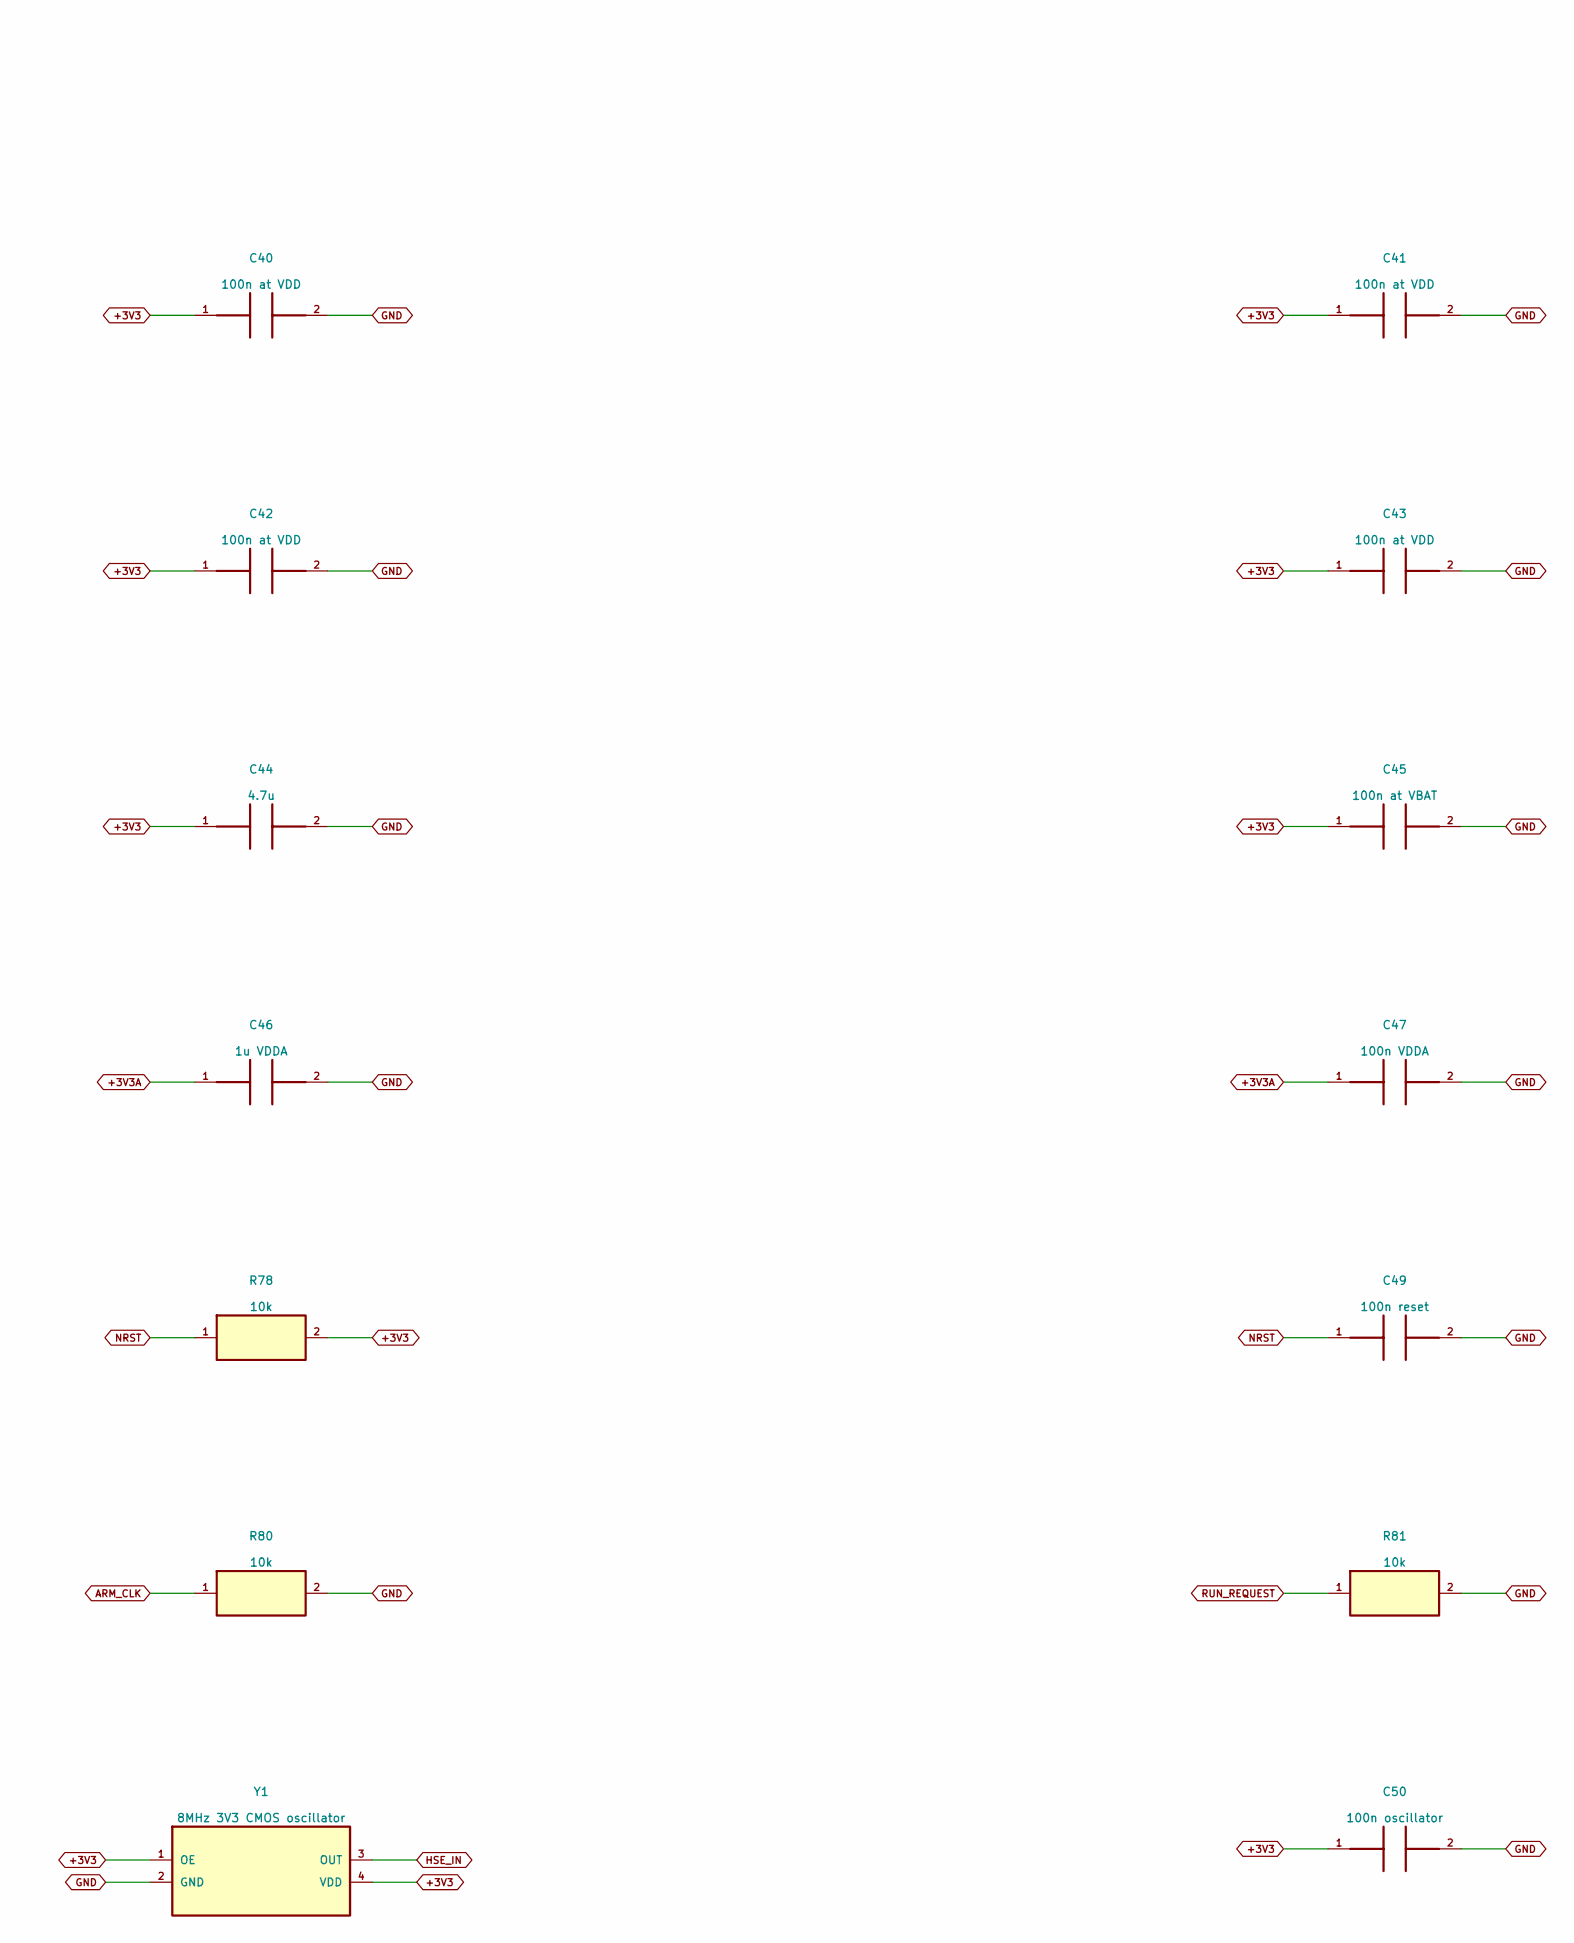
[picture p103: schematic 08_MCU.kicad_sch, part in row 1, column 2]

Parts:
C40, C41, C42, C43: 100n at VDD; C_0805_2012Metric
C44: 4.7u
C45: 100n at VBAT; C_0805_2012Metric
C46: 1u VDDA; C_0805_2012Metric
C47: 100n VDDA; C_0805_2012Metric
C48: 100n VREF; C_0805_2012Metric
C49: 100n reset; C_0805_2012Metric
C50: 100n oscillator; C_0805_2012Metric
J6: SWD
R78, R80, R81: 10k; R_0805_2012Metric
R79: 10k BOOT0; R_0805_2012Metric
U5: STM32G474RET3; LQFP-64_10x10mm_P0.5mm; MPN STM32G474RET3
Y1: 8MHz 3V3 CMOS oscillator

Connections:
+3V3: C40.1, C41.1, C42.1, C43.1, C44.1, C45.1, C50.1, J6.1, R78.2, U5.1 (VBAT), U5.16 (VDD), U5.32 (VDD), U5.48 (VDD), U5.64 (VDD), Y1.1 (OE), Y1.4 (VDD)
+3V3A: C46.1, C47.1, C48.1, U5.28 (VREF+), U5.29 (VDDA)
ARM_CLK: R80.1, U5.23 (PC5)
BOOT0: R79.1, U5.61 (PB8)
CAN_RX: U5.45 (PA11)
CAN_TX: U5.46 (PA12)
DRV_CS_N: U5.22 (PC4)
DRV_FAULT_N: U5.33 (PB11)
GND: C40.2, C41.2, C42.2, C43.2, C44.2, C45.2, C46.2, C47.2, C48.2, C49.2, C50.2, J6.3, R79.2, R80.2, R81.2, U5.15 (VSS), U5.27 (VSSA), U5.31 (VSS), U5.47 (VSS), U5.63 (VSS), Y1.2 (GND)
HALL_A: U5.38 (PC6)
HALL_B: U5.39 (PC7)
HALL_C: U5.40 (PC8)
HARD_FAULT_N: U5.34 (PB12)
HSE_IN: U5.5 (PF0), Y1.3 (OUT)
I_A_ADC: U5.12 (PA0)
I_B_ADC: U5.13 (PA1)
I_C_ADC: U5.14 (PA2)
LATCH_STATE: U5.55 (PD2)
MCU_PWM_HA: U5.42 (PA8)
MCU_PWM_HB: U5.43 (PA9)
MCU_PWM_HC: U5.44 (PA10)
MCU_PWM_LA: U5.35 (PB13)
MCU_PWM_LB: U5.36 (PB14)
MCU_PWM_LC: U5.37 (PB15)
NRST: C49.1, J6.5, R78.1, U5.7 (PG10)
PG_5V: U5.30 (PB10)
PG_12V: U5.26 (PB2)
RC_PWM: U5.51 (PA15)
RUN_REQUEST: R81.1, U5.41 (PC9)
SPI_MISO: U5.57 (PB4)
SPI_MOSI: U5.58 (PB5)
SPI_SCK: U5.56 (PB3)
STATUS_LED: U5.54 (PC12)
SWCLK: J6.4, U5.50 (PA14)
SWDIO: J6.2, U5.49 (PA13)
TEMP_FET: U5.17 (PA3)
TEMP_MOTOR: U5.24 (PB0)
TEMP_PCB: U5.18 (PA4)
UART_RX: U5.53 (PC11)
UART_TX: U5.52 (PC10)
V_A_ADC: U5.9 (PC1)
V_BUS_ADC: U5.8 (PC0)
V_B_ADC: U5.10 (PC2)
V_C_ADC: U5.11 (PC3)

Notes on the sheet:
08 MCU
A1 REVIEW DRAFT | Global net labels connect sheets | Values and footprints pending release review
