mekiciepcas/ESC-Ai/ESC_V2/hardware/08_MCU_2.kicad_sch

## KiCad design ESC_V2/hardware/08_MCU_2.kicad_sch (2026-09-18)

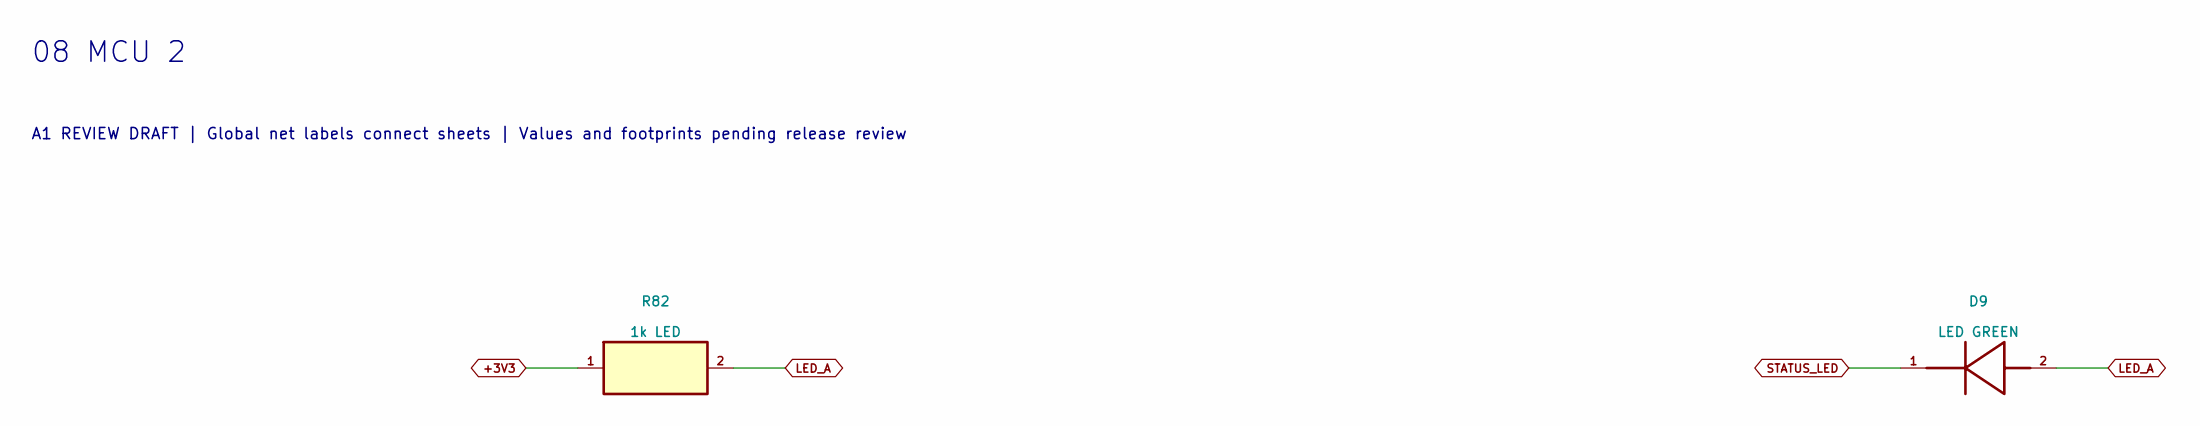
[picture p104: schematic 08_MCU_2.kicad_sch]

Parts:
D9: LED GREEN
R82: 1k LED; R_0805_2012Metric

Connections:
+3V3: R82.1
LED_A: D9.2 (A), R82.2
STATUS_LED: D9.1 (K)

Notes on the sheet:
08 MCU 2
A1 REVIEW DRAFT | Global net labels connect sheets | Values and footprints pending release review
