mekiciepcas/ESC-Ai/ESC_V2/hardware/09_comms.kicad_sch

## KiCad design ESC_V2/hardware/09_comms.kicad_sch (2026-09-18)

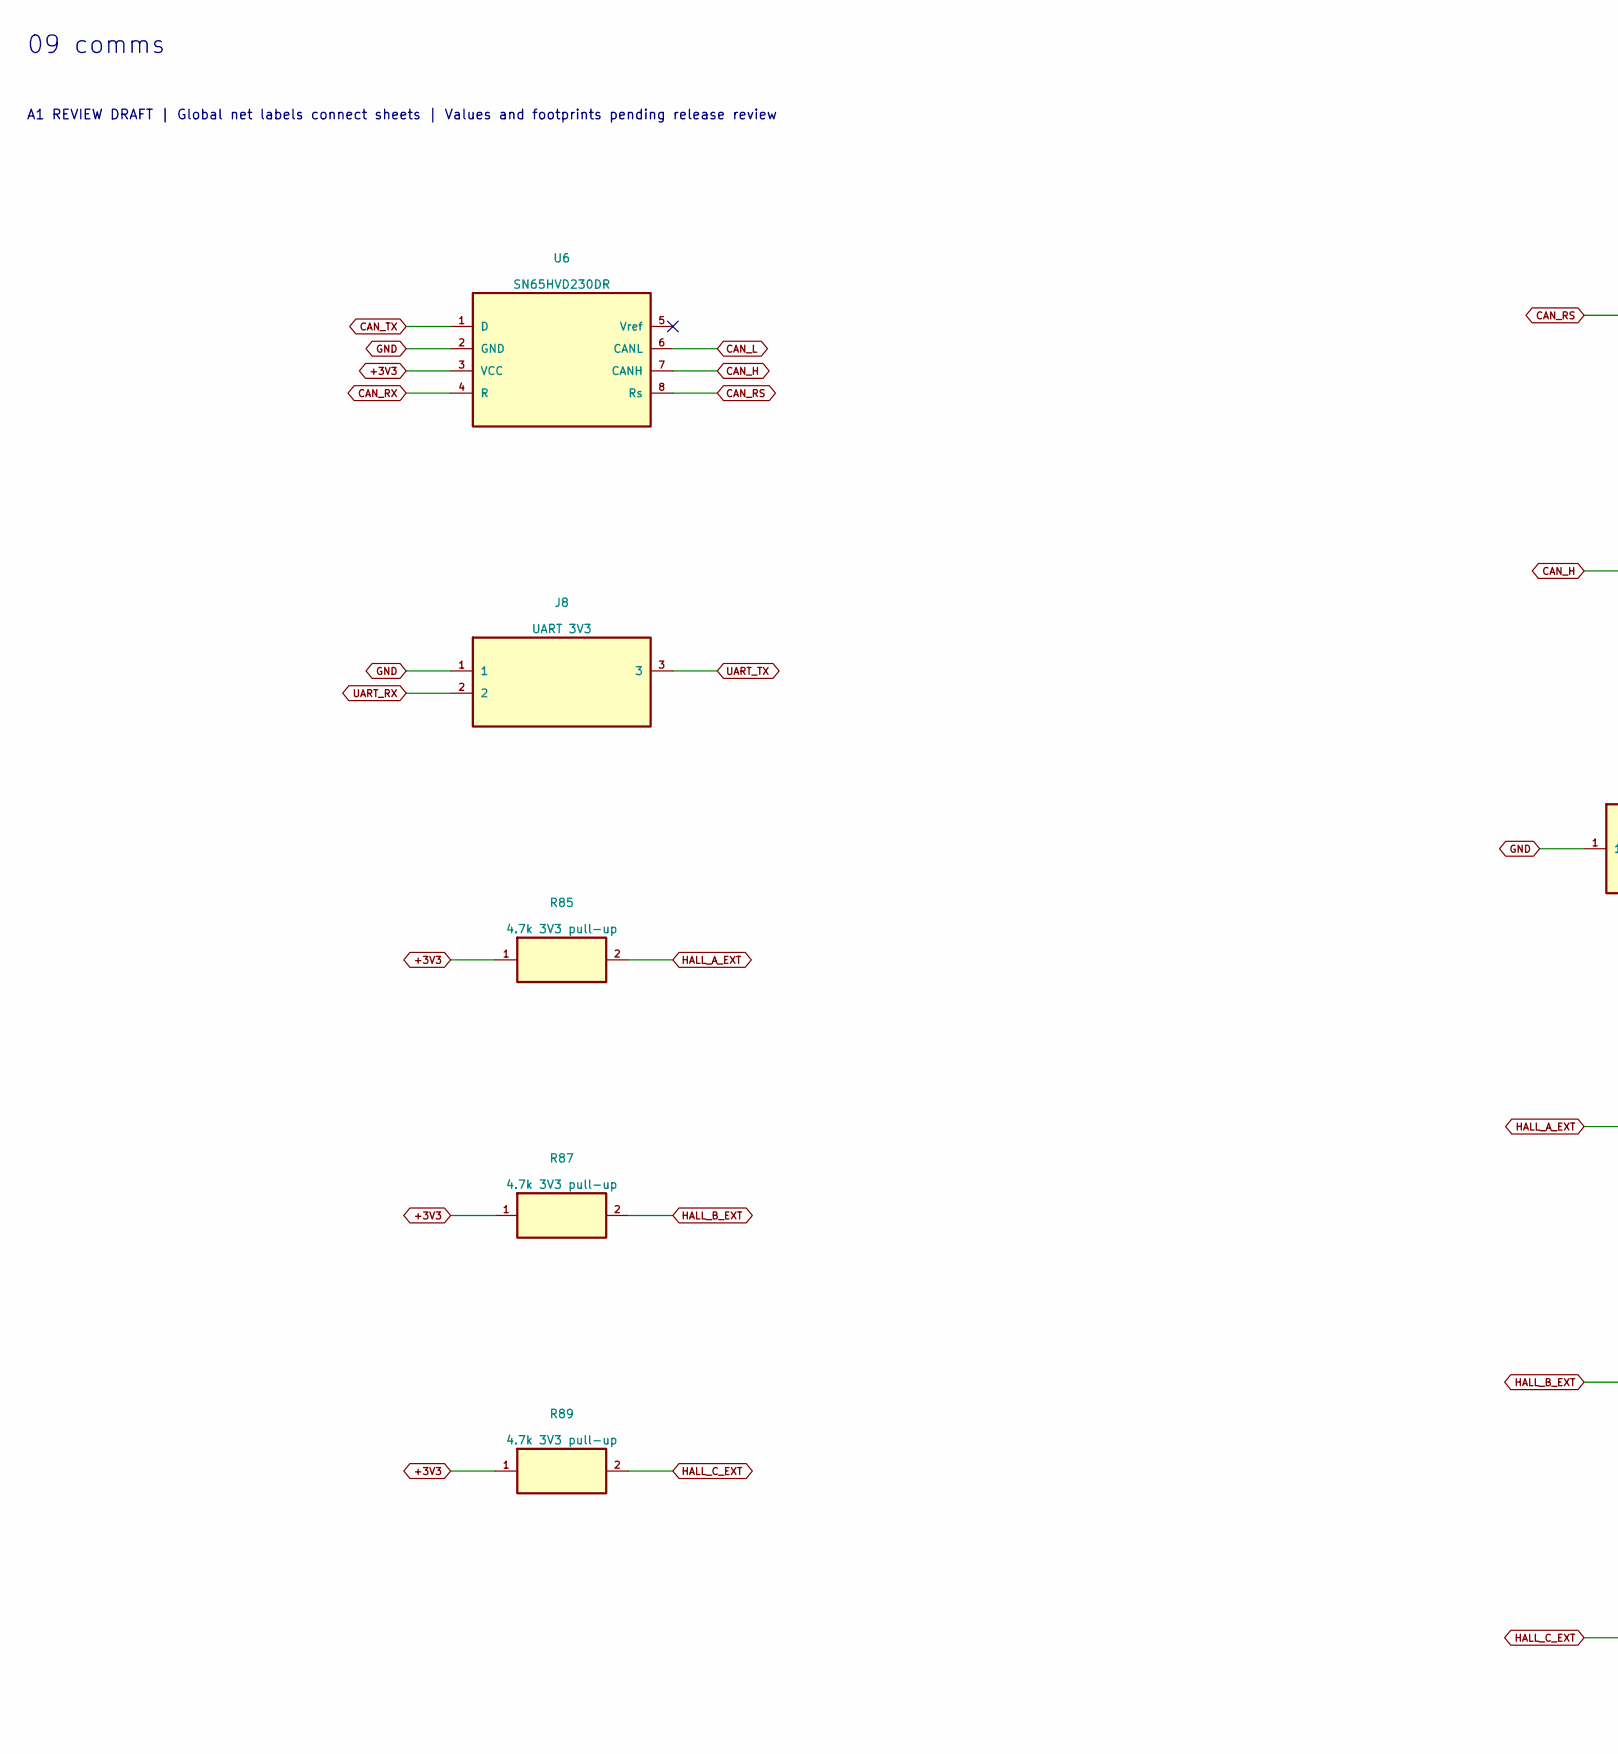
[picture p105: schematic 09_comms.kicad_sch, part in row 1, column 1]

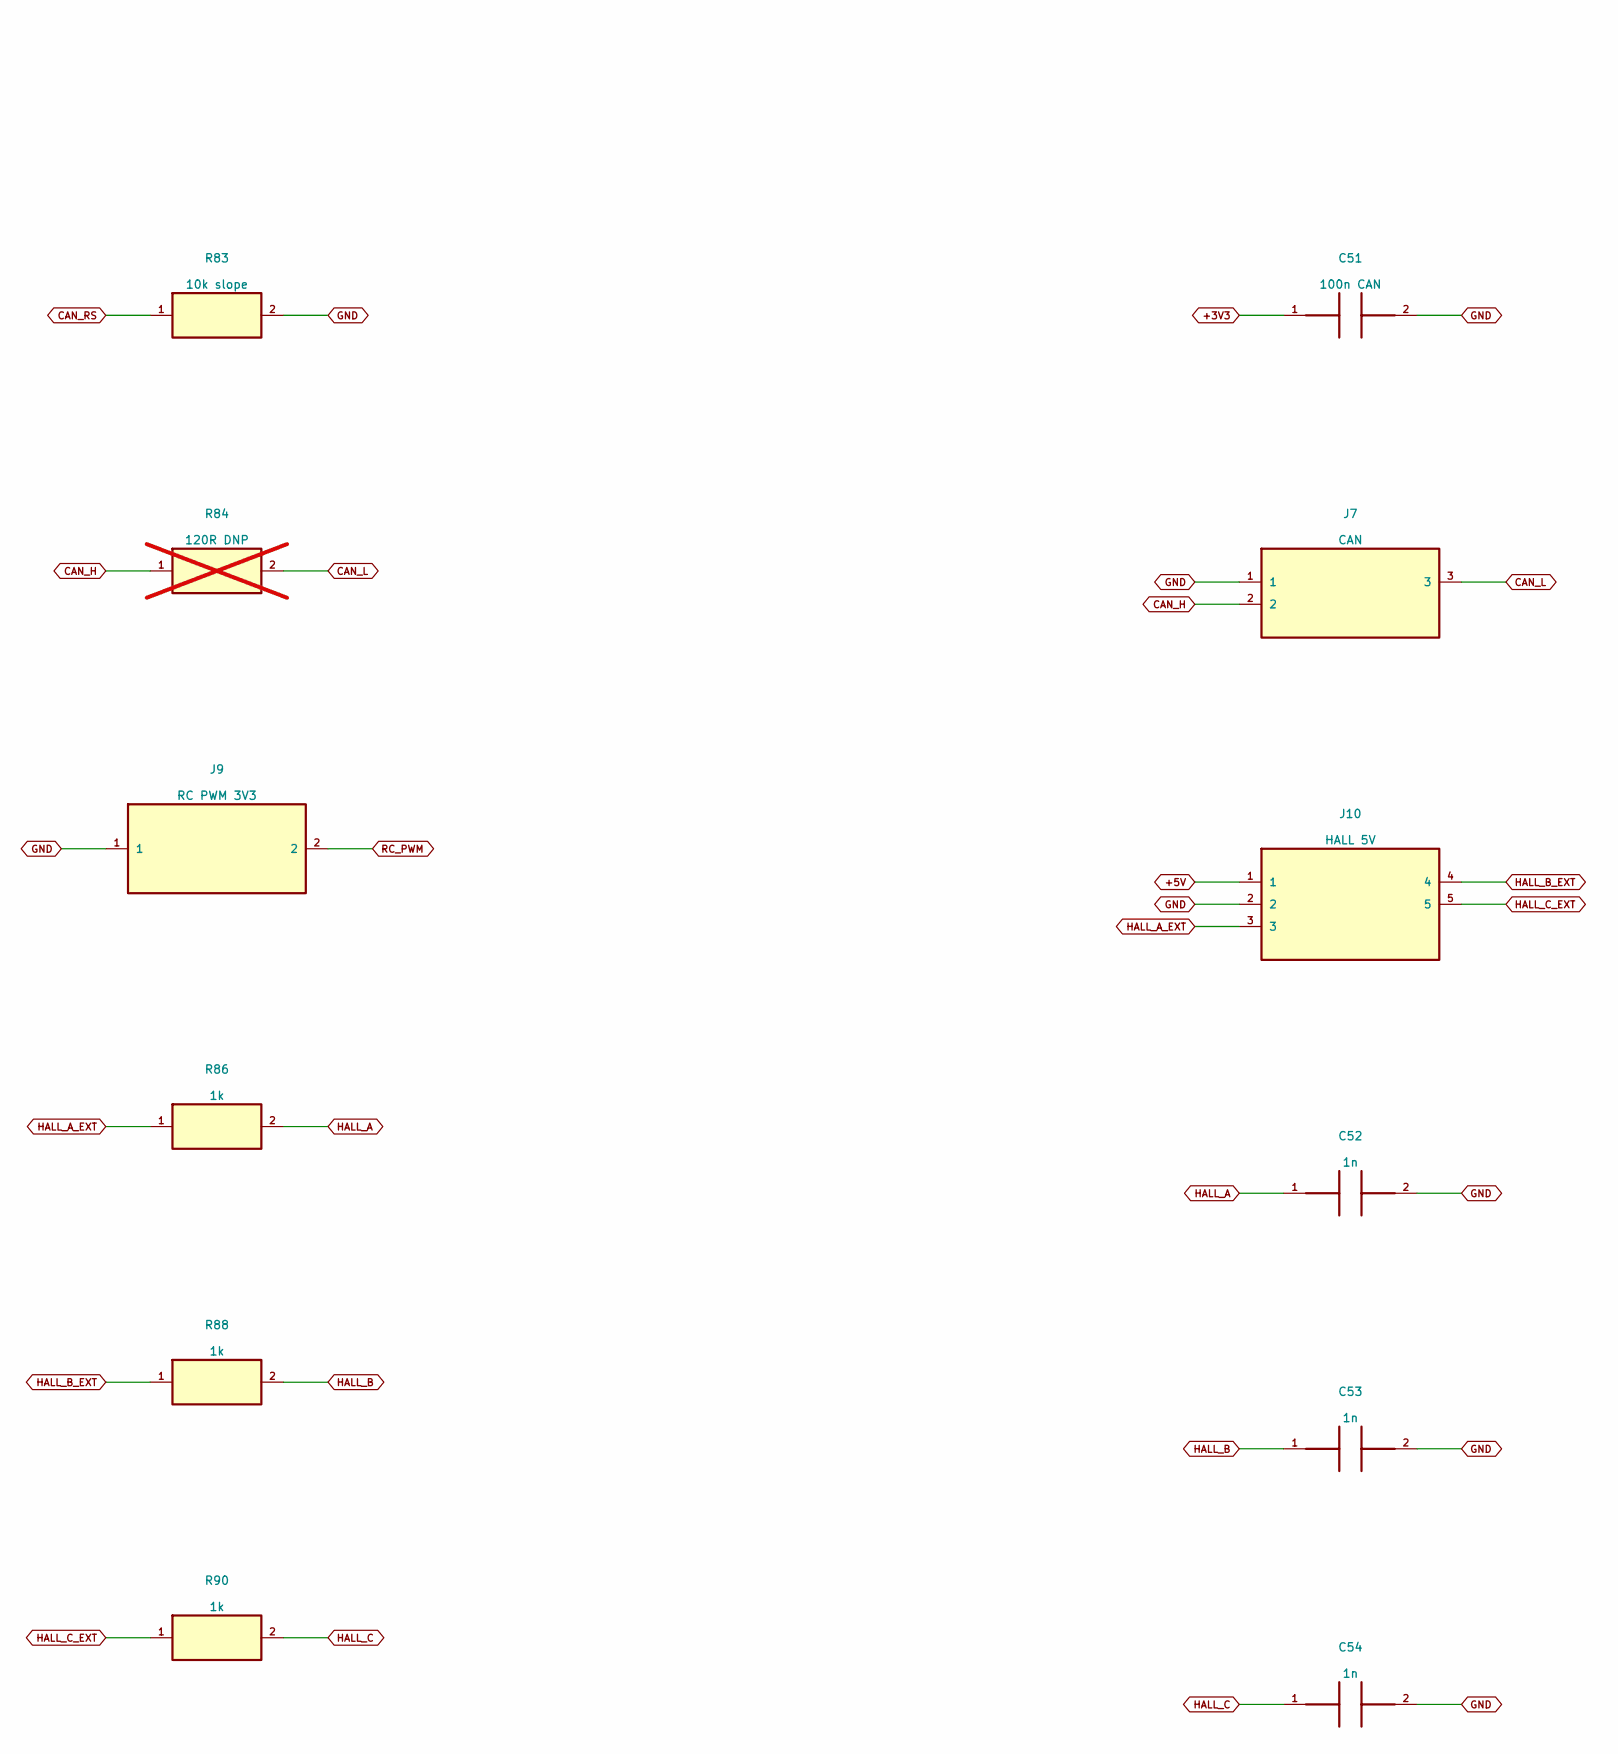
[picture p106: schematic 09_comms.kicad_sch, part in row 1, column 2]

Parts:
C51: 100n CAN; C_0805_2012Metric
C52, C53, C54: 1n; C_0805_2012Metric
J7: CAN
J8: UART 3V3
J9: RC PWM 3V3
J10: HALL 5V
R83: 10k slope; R_0805_2012Metric
R84: 120R DNP; R_0805_2012Metric; not fitted
R85, R87, R89: 4.7k 3V3 pull-up; R_0805_2012Metric
R86, R88, R90: 1k; R_0805_2012Metric
U6: SN65HVD230DR; SOIC-8_3.9x4.9mm_P1.27mm; MPN SN65HVD230DR

Connections:
+3V3: C51.1, R85.1, R87.1, R89.1, U6.3 (VCC)
+5V: J10.1
CAN_H: J7.2, R84.1, U6.7 (CANH)
CAN_L: J7.3, R84.2, U6.6 (CANL)
CAN_RS: R83.1, U6.8 (Rs)
CAN_RX: U6.4 (R)
CAN_TX: U6.1 (D)
GND: C51.2, C52.2, C53.2, C54.2, J7.1, J8.1, J9.1, J10.2, R83.2, U6.2 (GND)
HALL_A: C52.1, R86.2
HALL_A_EXT: J10.3, R85.2, R86.1
HALL_B: C53.1, R88.2
HALL_B_EXT: J10.4, R87.2, R88.1
HALL_C: C54.1, R90.2
HALL_C_EXT: J10.5, R89.2, R90.1
RC_PWM: J9.2
UART_RX: J8.2
UART_TX: J8.3

Notes on the sheet:
09 comms
A1 REVIEW DRAFT | Global net labels connect sheets | Values and footprints pending release review
