mekiciepcas/ESC-Ai/ESC_V2/hardware/10_hardware_trip.kicad_sch

## KiCad design ESC_V2/hardware/10_hardware_trip.kicad_sch (2026-09-18)

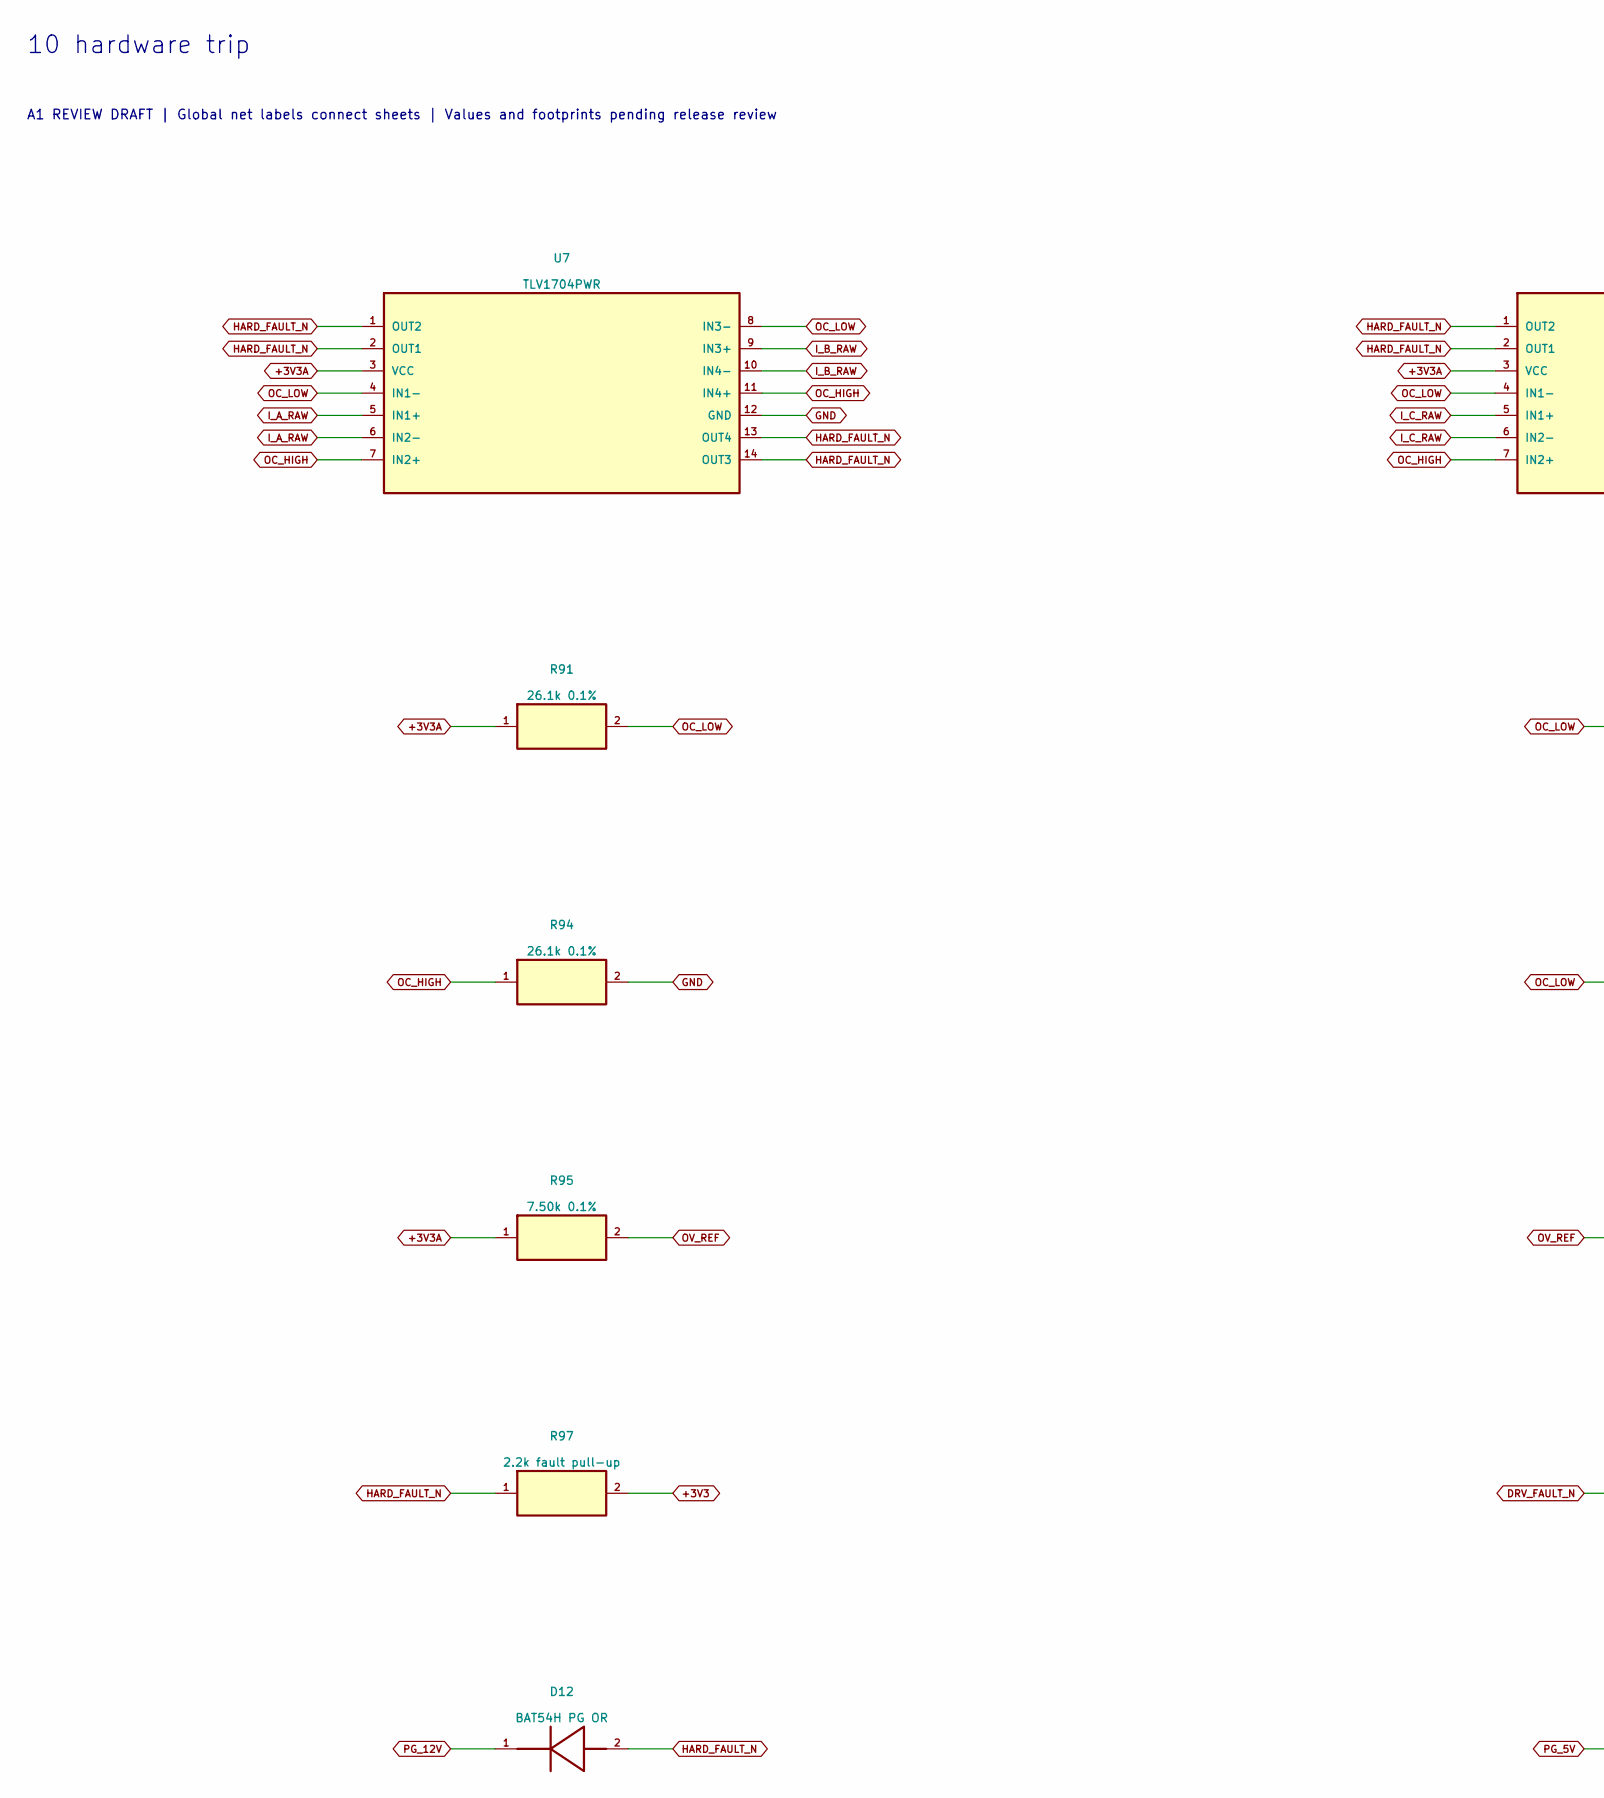
[picture p107: schematic 10_hardware_trip.kicad_sch, part in row 1, column 1]

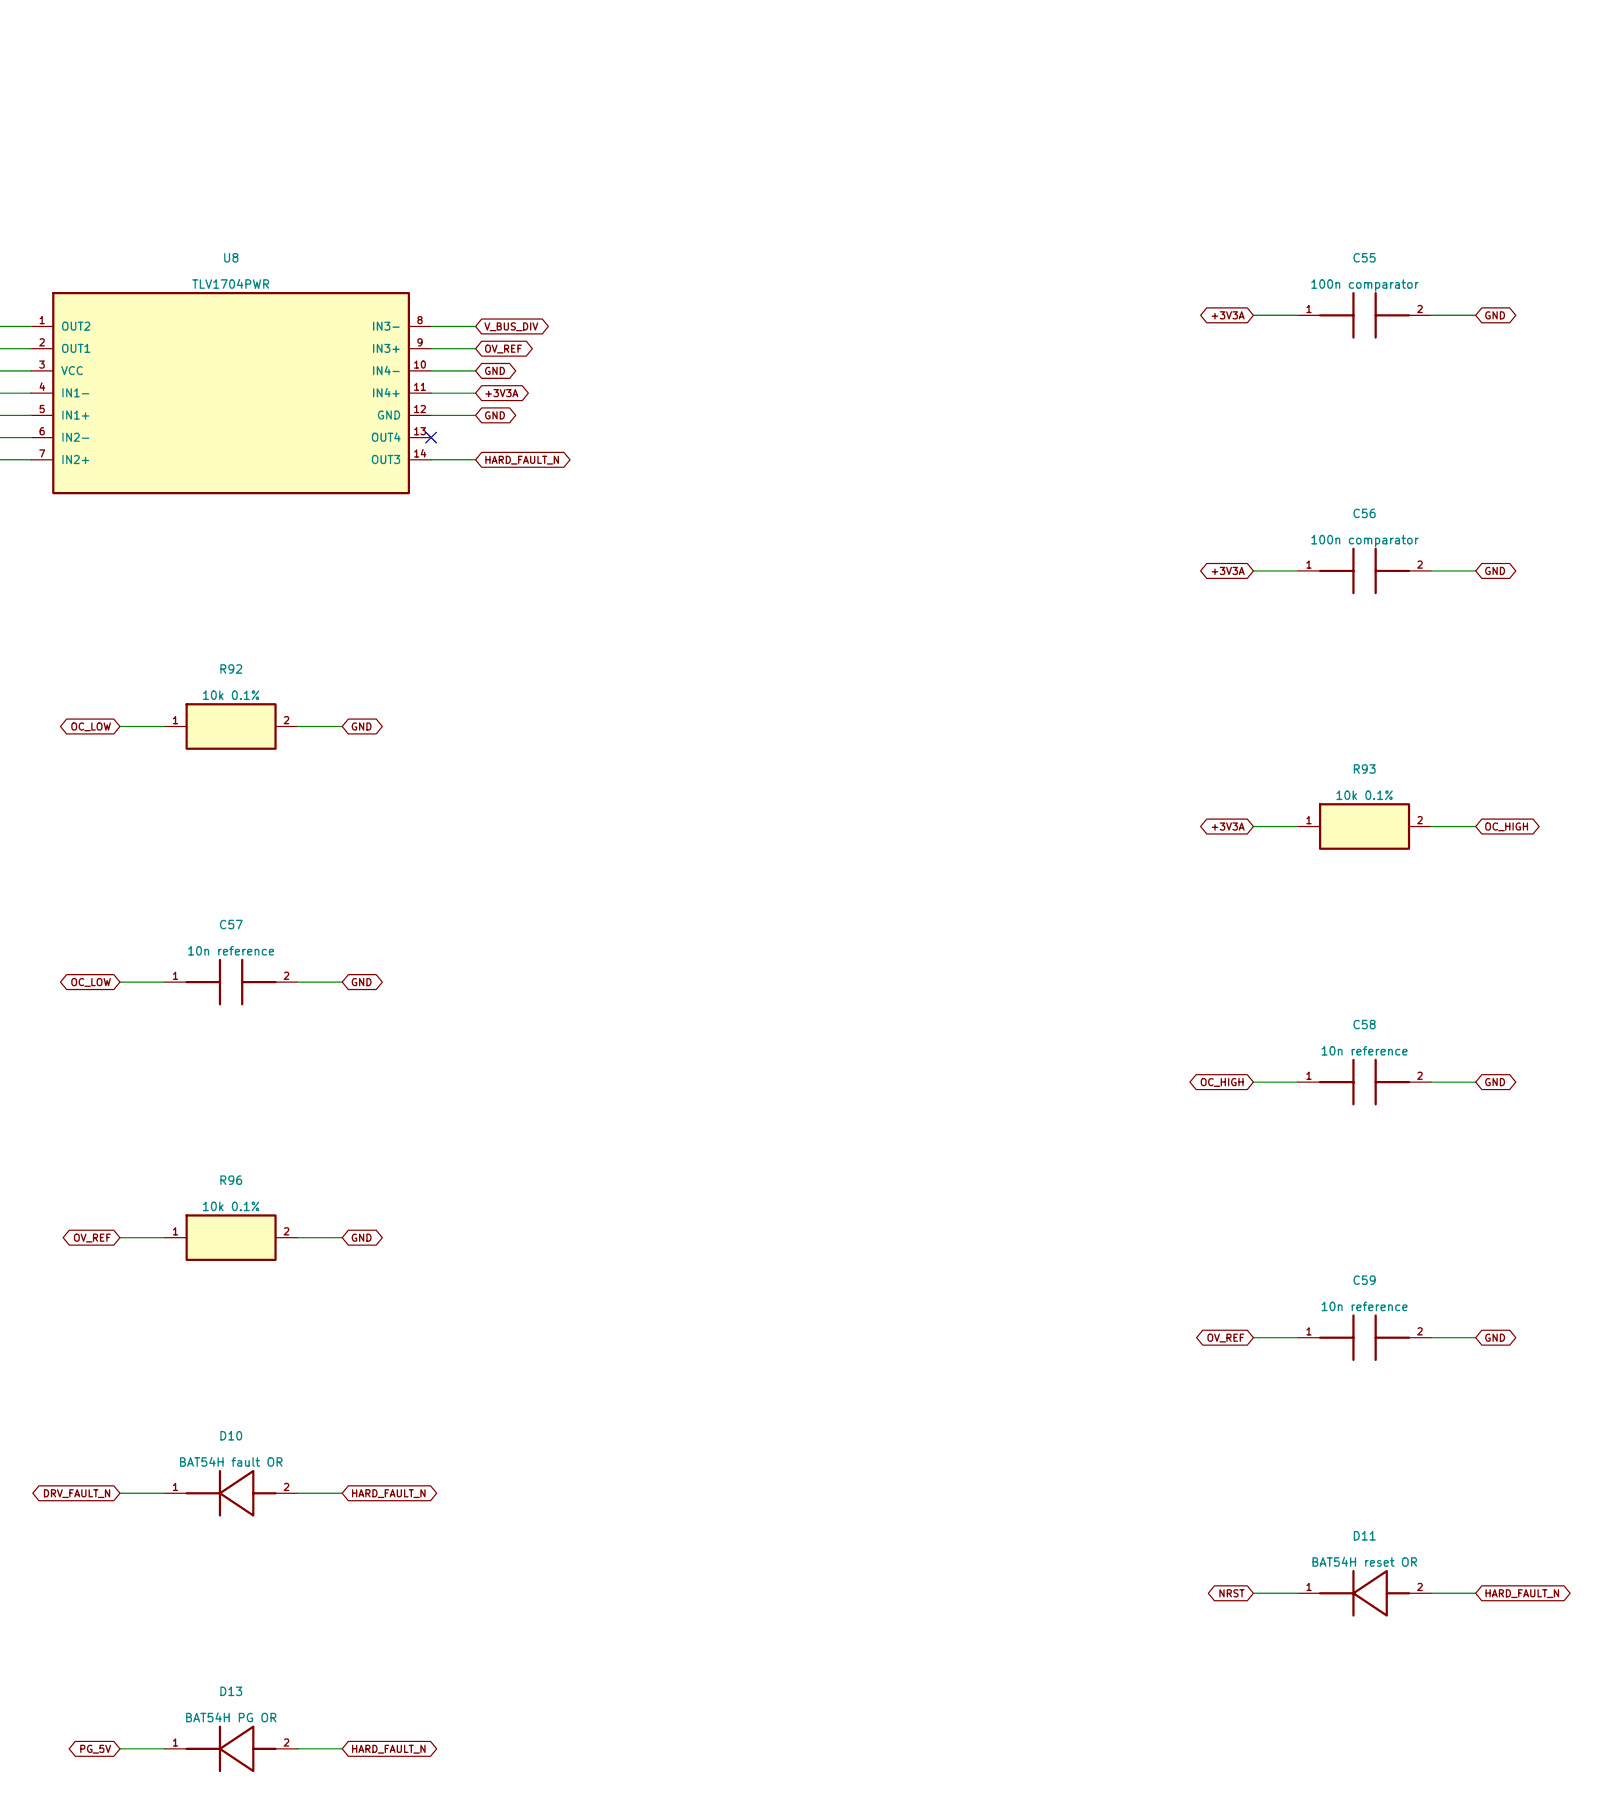
[picture p108: schematic 10_hardware_trip.kicad_sch, part in row 1, column 2]

Parts:
C55, C56: 100n comparator; C_0805_2012Metric
C57, C58, C59: 10n reference; C_0805_2012Metric
D10: BAT54H fault OR; MPN BAT54H
D11: BAT54H reset OR; MPN BAT54H
D12, D13: BAT54H PG OR; MPN BAT54H
R91, R94: 26.1k 0.1%; R_0805_2012Metric
R92, R93, R96: 10k 0.1%; R_0805_2012Metric
R95: 7.50k 0.1%; R_0805_2012Metric
R97: 2.2k fault pull-up; R_0805_2012Metric
U7, U8: TLV1704PWR; TSSOP-14_4.4x5mm_P0.65mm; MPN TLV1704PWR

Connections:
+3V3: R97.2
+3V3A: C55.1, C56.1, R91.1, R93.1, R95.1, U7.3 (VCC), U8.3 (VCC), U8.11 (IN4+)
DRV_FAULT_N: D10.1 (K)
GND: C55.2, C56.2, C57.2, C58.2, C59.2, R92.2, R94.2, R96.2, U7.12 (GND), U8.10 (IN4-), U8.12 (GND)
HARD_FAULT_N: D10.2 (A), D11.2 (A), D12.2 (A), D13.2 (A), R97.1, U7.1 (OUT2), U7.2 (OUT1), U7.13 (OUT4), U7.14 (OUT3), U8.1 (OUT2), U8.2 (OUT1), U8.14 (OUT3)
I_A_RAW: U7.5 (IN1+), U7.6 (IN2-)
I_B_RAW: U7.9 (IN3+), U7.10 (IN4-)
I_C_RAW: U8.5 (IN1+), U8.6 (IN2-)
NRST: D11.1 (K)
OC_HIGH: C58.1, R93.2, R94.1, U7.7 (IN2+), U7.11 (IN4+), U8.7 (IN2+)
OC_LOW: C57.1, R91.2, R92.1, U7.4 (IN1-), U7.8 (IN3-), U8.4 (IN1-)
OV_REF: C59.1, R95.2, R96.1, U8.9 (IN3+)
PG_5V: D13.1 (K)
PG_12V: D12.1 (K)
V_BUS_DIV: U8.8 (IN3-)

Notes on the sheet:
10 hardware trip
A1 REVIEW DRAFT | Global net labels connect sheets | Values and footprints pending release review
