mekiciepcas/ESC-Ai/ESC_V2/hardware/10_hardware_trip_2.kicad_sch

## KiCad design ESC_V2/hardware/10_hardware_trip_2.kicad_sch (2026-09-18)

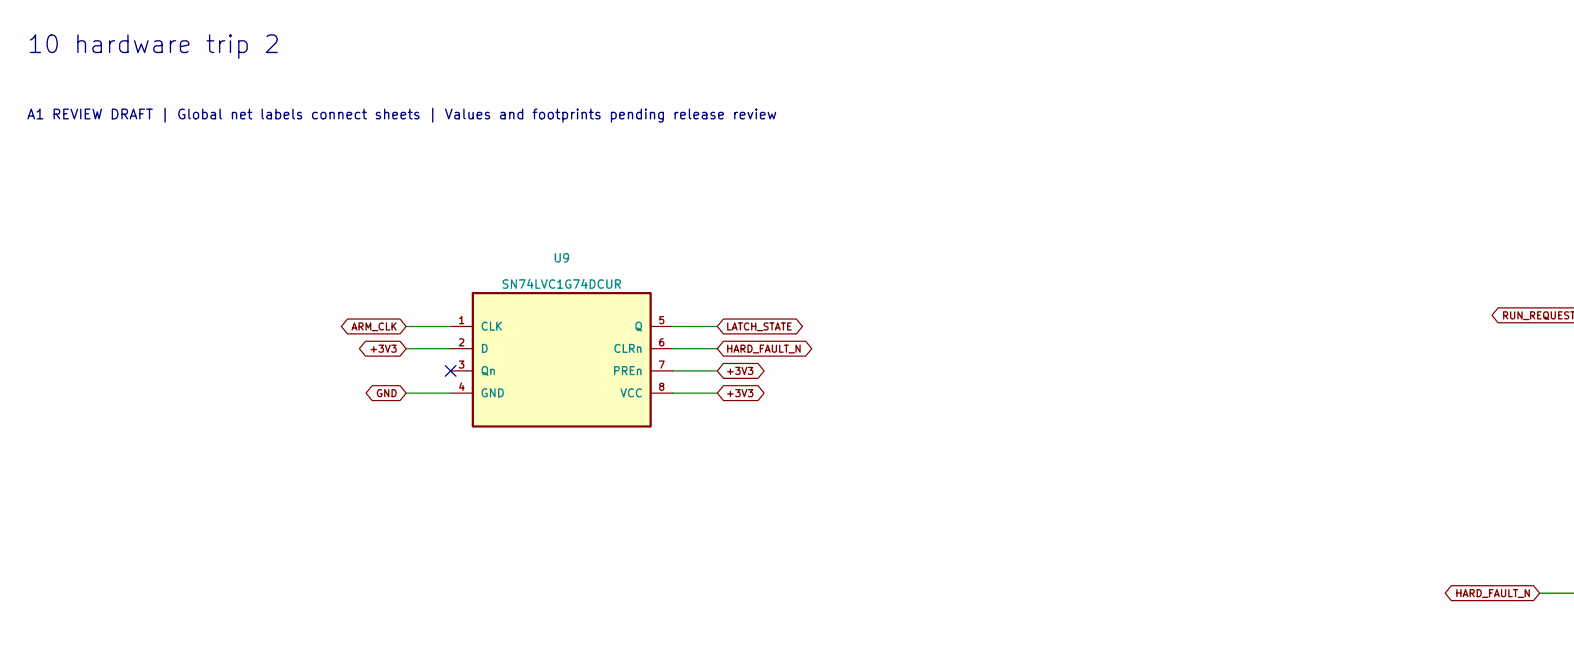
[picture p109: schematic 10_hardware_trip_2.kicad_sch, part in row 1, column 1]

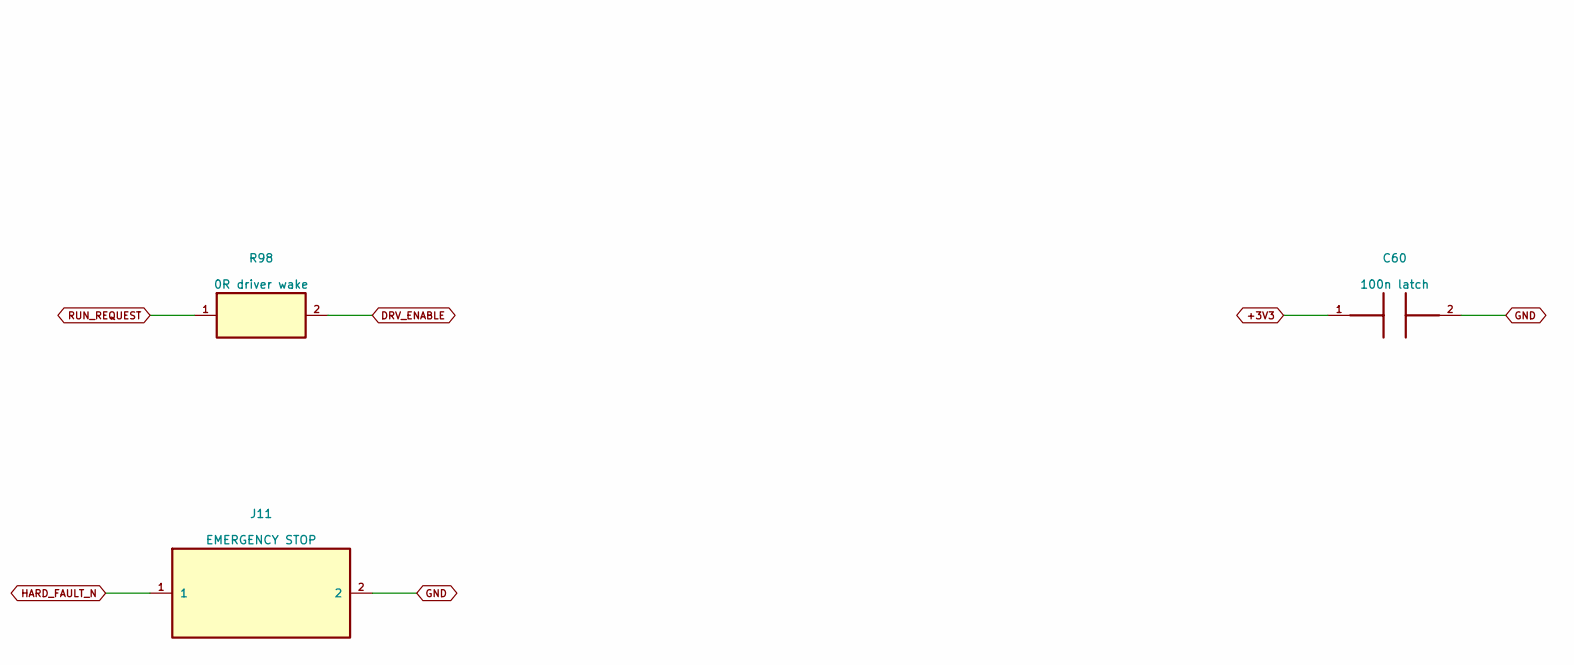
[picture p110: schematic 10_hardware_trip_2.kicad_sch, part in row 1, column 2]

Parts:
C60: 100n latch; C_0805_2012Metric
J11: EMERGENCY STOP
R98: 0R driver wake; R_0805_2012Metric
U9: SN74LVC1G74DCUR; VSSOP-8_2.3x2mm_P0.5mm; MPN SN74LVC1G74DCUR

Connections:
+3V3: C60.1, U9.2 (D), U9.7 (PREn), U9.8 (VCC)
ARM_CLK: U9.1 (CLK)
DRV_ENABLE: R98.2
GND: C60.2, J11.2, U9.4 (GND)
HARD_FAULT_N: J11.1, U9.6 (CLRn)
LATCH_STATE: U9.5 (Q)
RUN_REQUEST: R98.1

Notes on the sheet:
10 hardware trip 2
A1 REVIEW DRAFT | Global net labels connect sheets | Values and footprints pending release review
