mekiciepcas/ESC-Ai/ESC_V2/hardware/11_PWM_interlock.kicad_sch

## KiCad design ESC_V2/hardware/11_PWM_interlock.kicad_sch (2026-09-18)

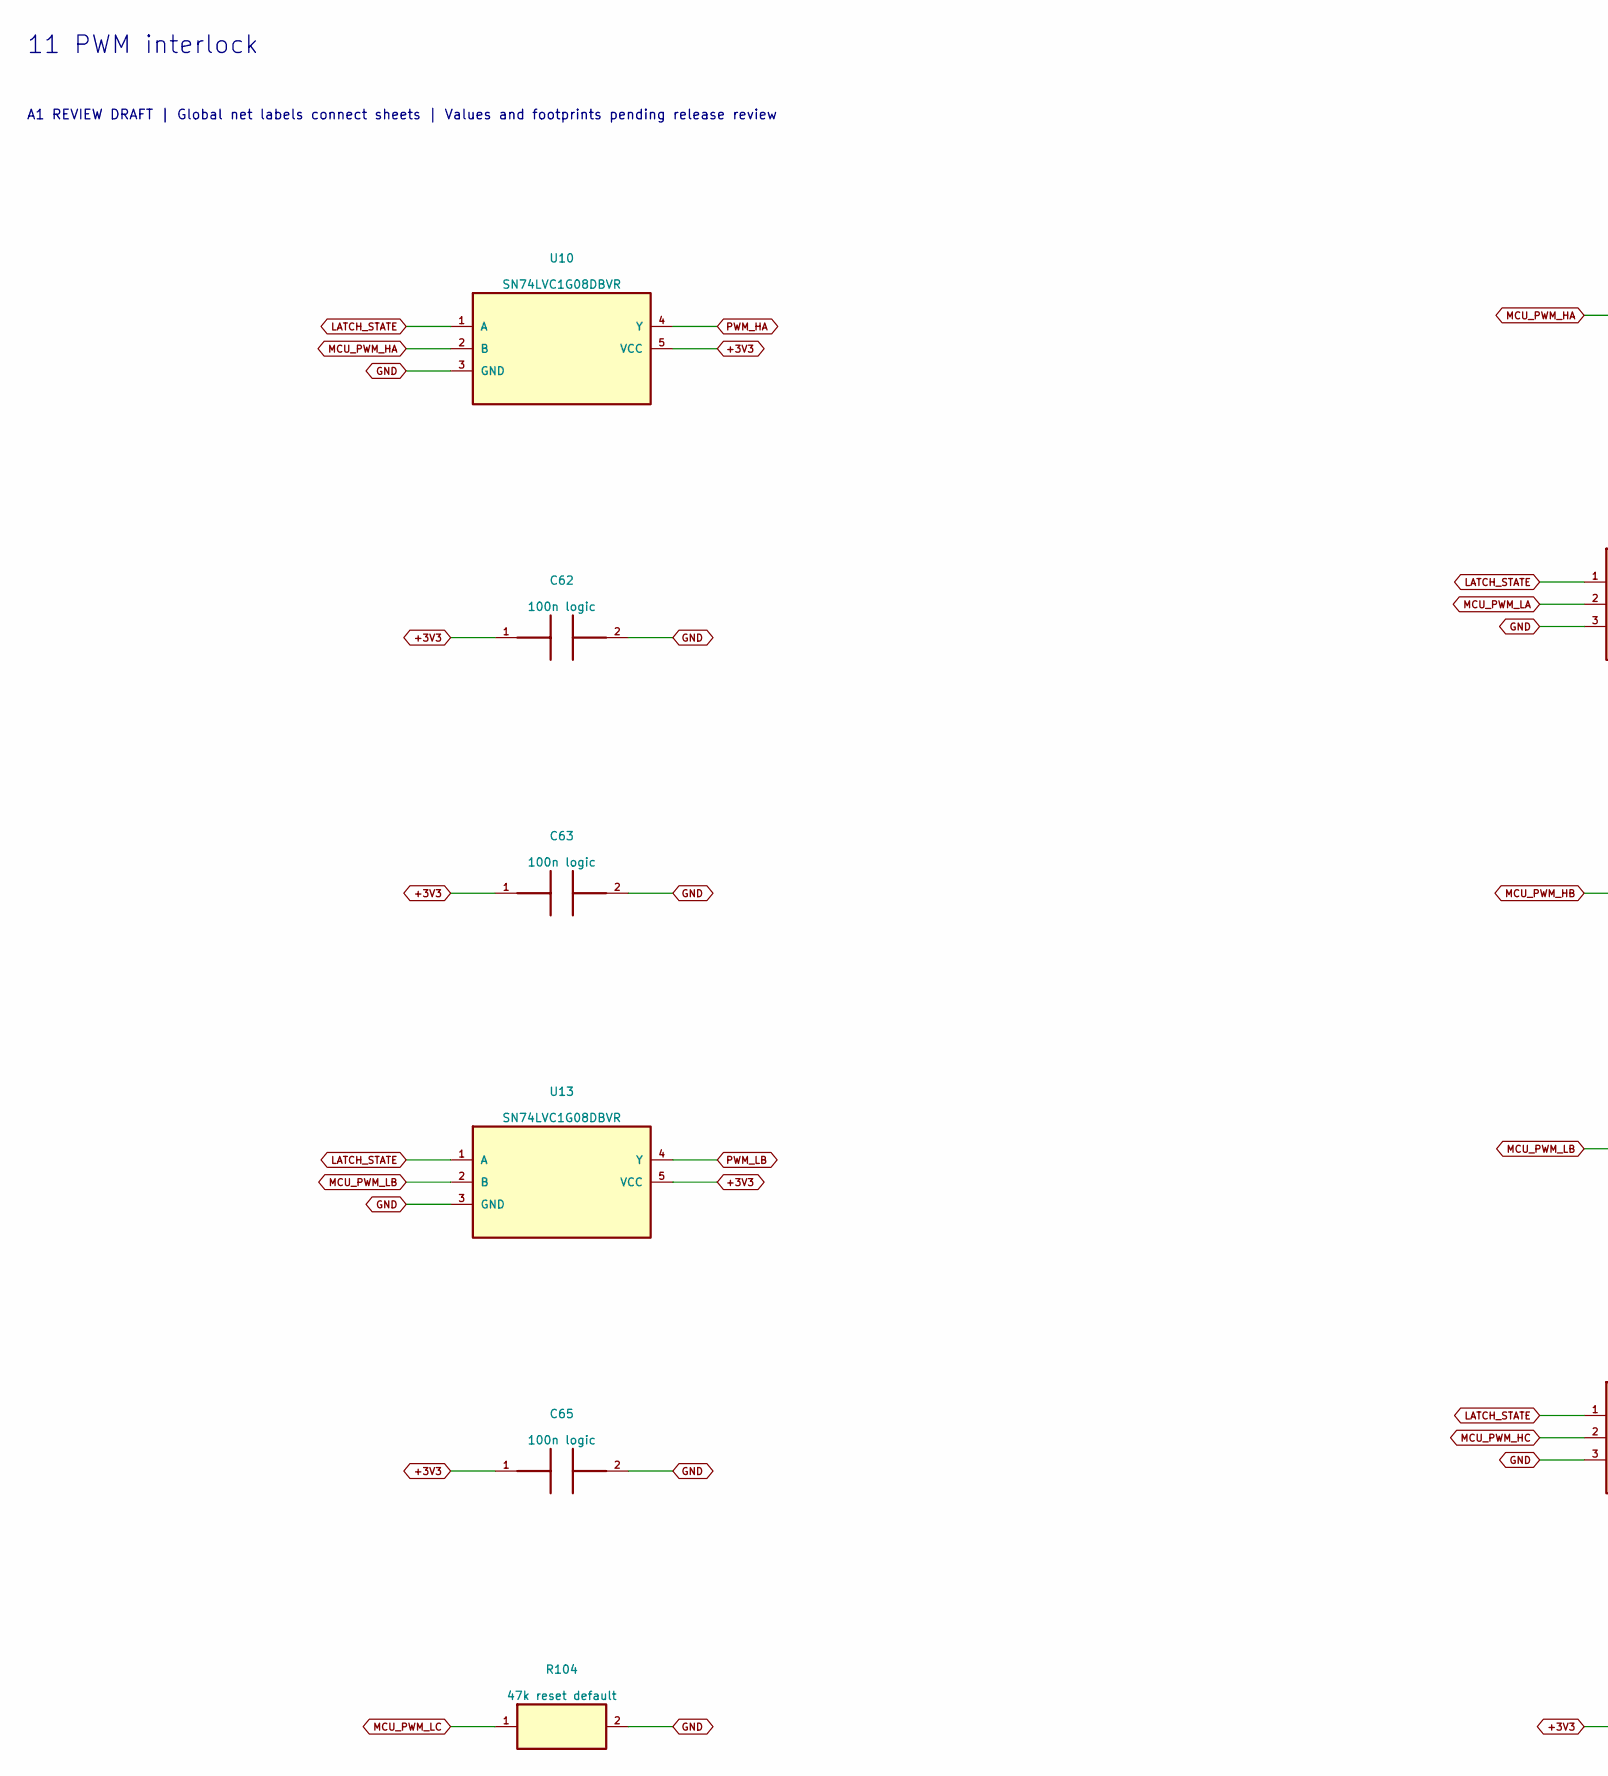
[picture p111: schematic 11_PWM_interlock.kicad_sch, part in row 1, column 1]

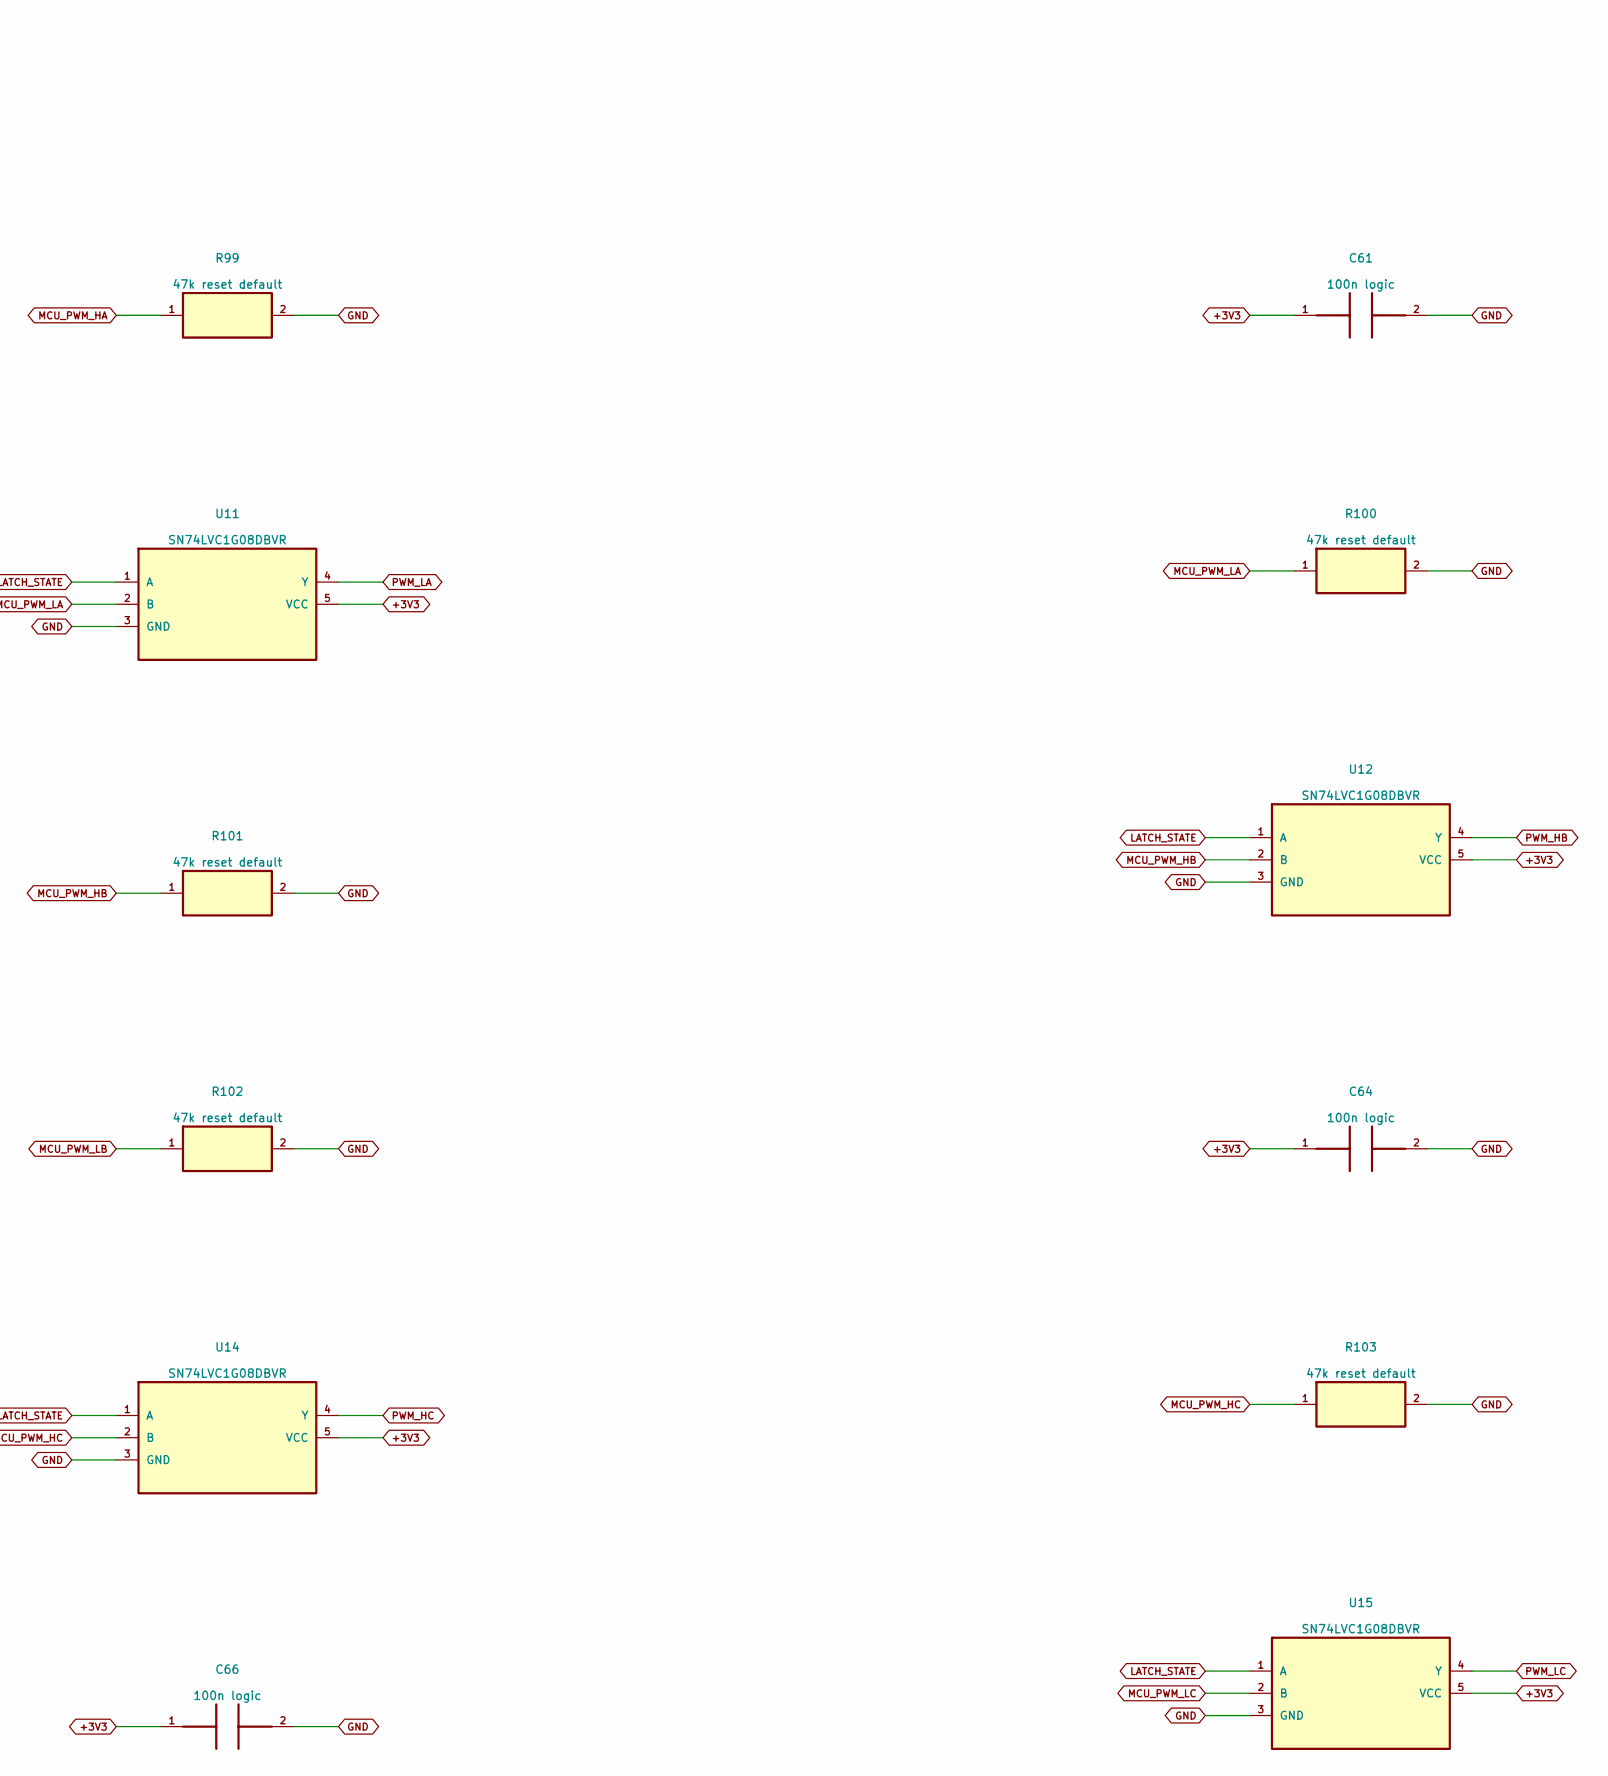
[picture p112: schematic 11_PWM_interlock.kicad_sch, part in row 1, column 2]

Parts:
C61, C62, C63, C64, C65, C66: 100n logic; C_0805_2012Metric
R99, R100, R101, R102, R103, R104: 47k reset default; R_0805_2012Metric
U10, U11, U12, U13, U14, U15: SN74LVC1G08DBVR; SOT-23-5; MPN SN74LVC1G08DBVR

Connections:
+3V3: C61.1, C62.1, C63.1, C64.1, C65.1, C66.1, U10.5 (VCC), U11.5 (VCC), U12.5 (VCC), U13.5 (VCC), U14.5 (VCC), U15.5 (VCC)
GND: C61.2, C62.2, C63.2, C64.2, C65.2, C66.2, R99.2, R100.2, R101.2, R102.2, R103.2, R104.2, U10.3 (GND), U11.3 (GND), U12.3 (GND), U13.3 (GND), U14.3 (GND), U15.3 (GND)
LATCH_STATE: U10.1 (A), U11.1 (A), U12.1 (A), U13.1 (A), U14.1 (A), U15.1 (A)
MCU_PWM_HA: R99.1, U10.2 (B)
MCU_PWM_HB: R101.1, U12.2 (B)
MCU_PWM_HC: R103.1, U14.2 (B)
MCU_PWM_LA: R100.1, U11.2 (B)
MCU_PWM_LB: R102.1, U13.2 (B)
MCU_PWM_LC: R104.1, U15.2 (B)
PWM_HA: U10.4 (Y)
PWM_HB: U12.4 (Y)
PWM_HC: U14.4 (Y)
PWM_LA: U11.4 (Y)
PWM_LB: U13.4 (Y)
PWM_LC: U15.4 (Y)

Notes on the sheet:
11 PWM interlock
A1 REVIEW DRAFT | Global net labels connect sheets | Values and footprints pending release review
