mekiciepcas/ESC-Ai/ESC_V2/hardware/12_board_interface.kicad_sch

## KiCad design ESC_V2/hardware/12_board_interface.kicad_sch (2026-09-18)

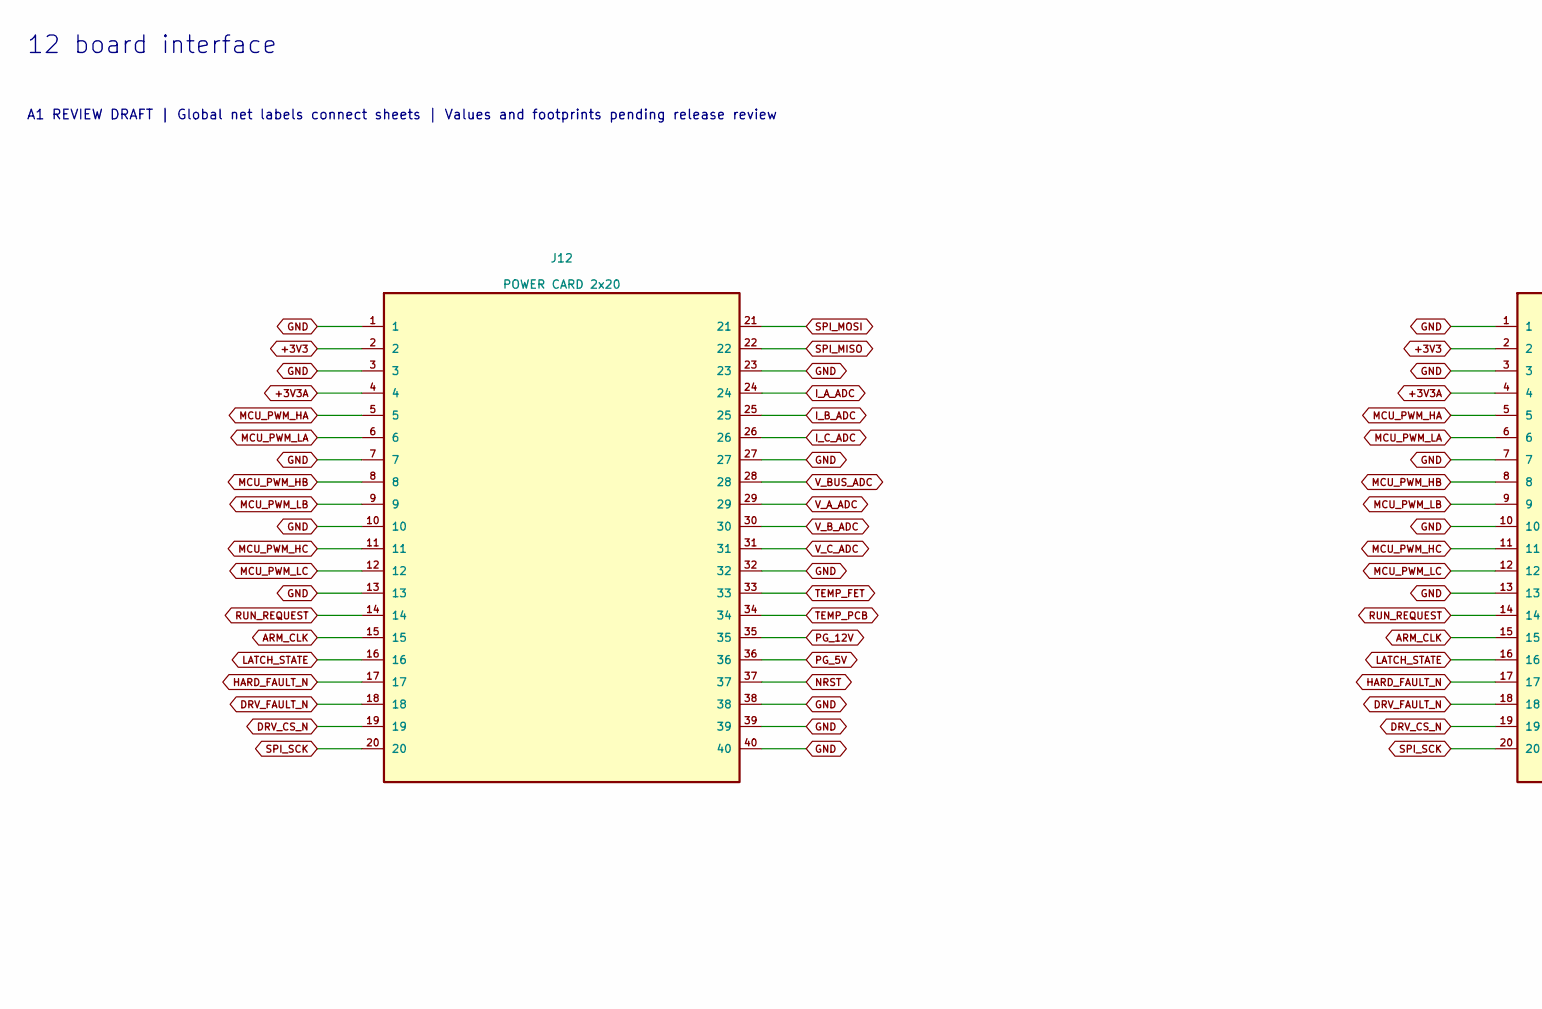
[picture p113: schematic 12_board_interface.kicad_sch, part in row 1, column 1]

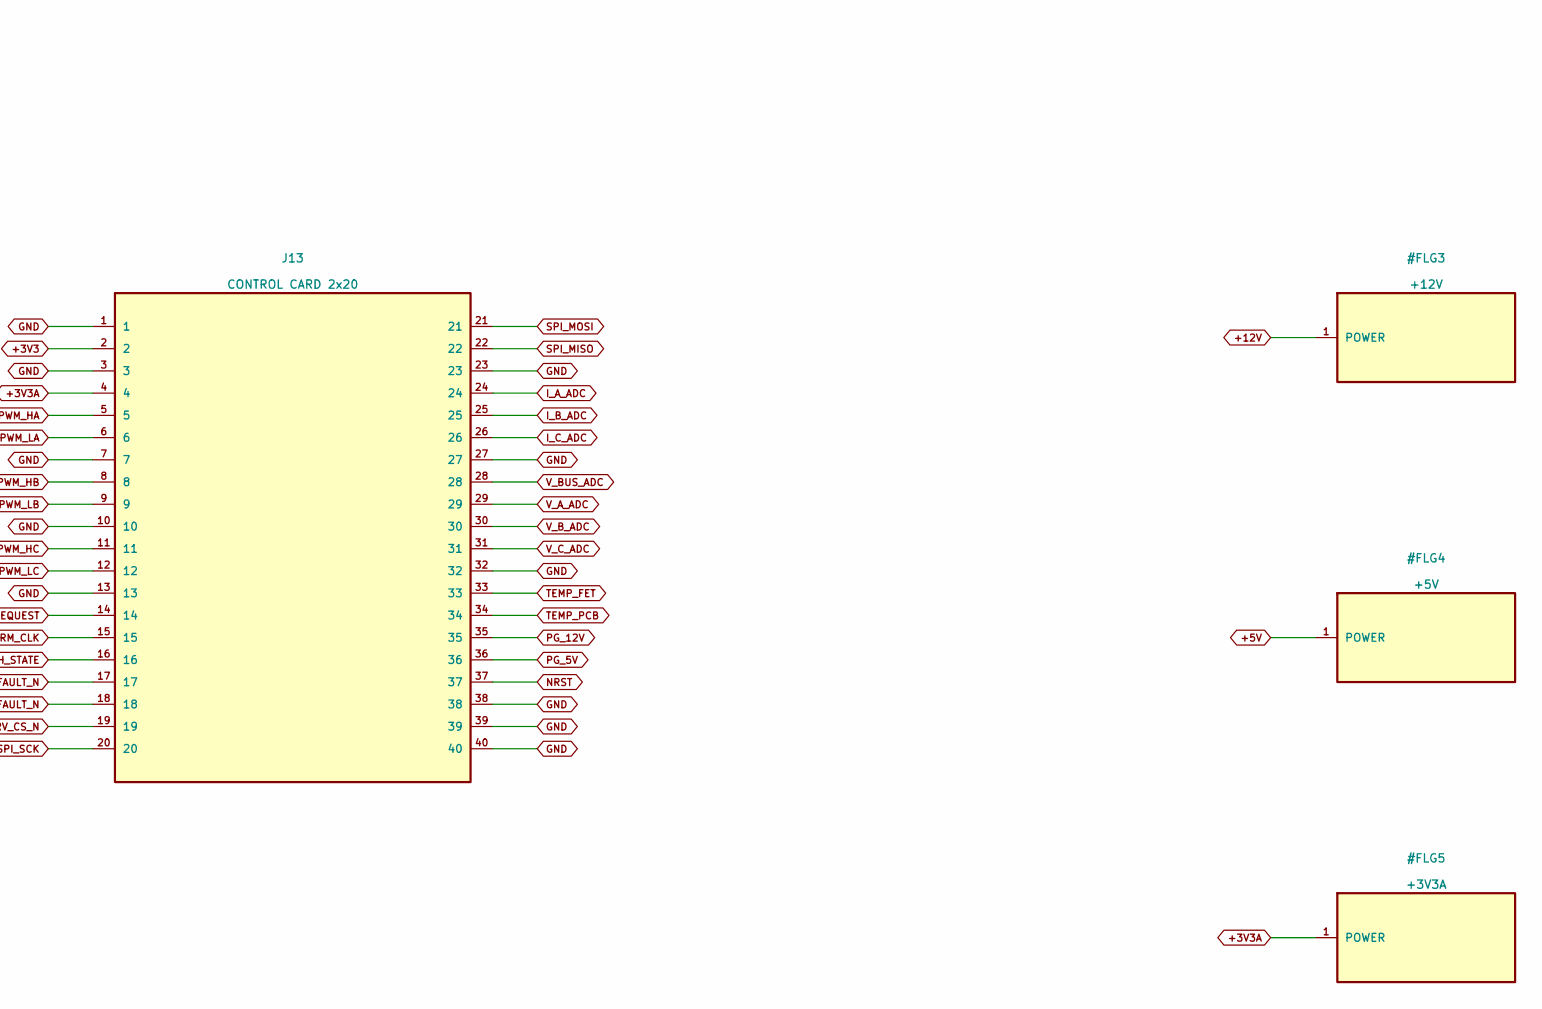
[picture p114: schematic 12_board_interface.kicad_sch, part in row 1, column 2]

Parts:
J12: POWER CARD 2x20
J13: CONTROL CARD 2x20

Connections:
+3V3: J12.2, J13.2
+3V3A: J12.4, J13.4
ARM_CLK: J12.15, J13.15
DRV_CS_N: J12.19, J13.19
DRV_FAULT_N: J12.18, J13.18
GND: J12.1, J12.3, J12.7, J12.10, J12.13, J12.23, J12.27, J12.32, J12.38, J12.39, J12.40, J13.1, J13.3, J13.7, J13.10, J13.13, J13.23, J13.27, J13.32, J13.38, J13.39, J13.40
HARD_FAULT_N: J12.17, J13.17
I_A_ADC: J12.24, J13.24
I_B_ADC: J12.25, J13.25
I_C_ADC: J12.26, J13.26
LATCH_STATE: J12.16, J13.16
MCU_PWM_HA: J12.5, J13.5
MCU_PWM_HB: J12.8, J13.8
MCU_PWM_HC: J12.11, J13.11
MCU_PWM_LA: J12.6, J13.6
MCU_PWM_LB: J12.9, J13.9
MCU_PWM_LC: J12.12, J13.12
NRST: J12.37, J13.37
PG_5V: J12.36, J13.36
PG_12V: J12.35, J13.35
RUN_REQUEST: J12.14, J13.14
SPI_MISO: J12.22, J13.22
SPI_MOSI: J12.21, J13.21
SPI_SCK: J12.20, J13.20
TEMP_FET: J12.33, J13.33
TEMP_PCB: J12.34, J13.34
V_A_ADC: J12.29, J13.29
V_BUS_ADC: J12.28, J13.28
V_B_ADC: J12.30, J13.30
V_C_ADC: J12.31, J13.31

Notes on the sheet:
12 board interface
A1 REVIEW DRAFT | Global net labels connect sheets | Values and footprints pending release review
