mekiciepcas/ESC-Ai/ESC_V2/hardware_a2/01_DC_LINK.kicad_sch

## KiCad design ESC_V2/hardware_a2/01_DC_LINK.kicad_sch (2026-09-18)

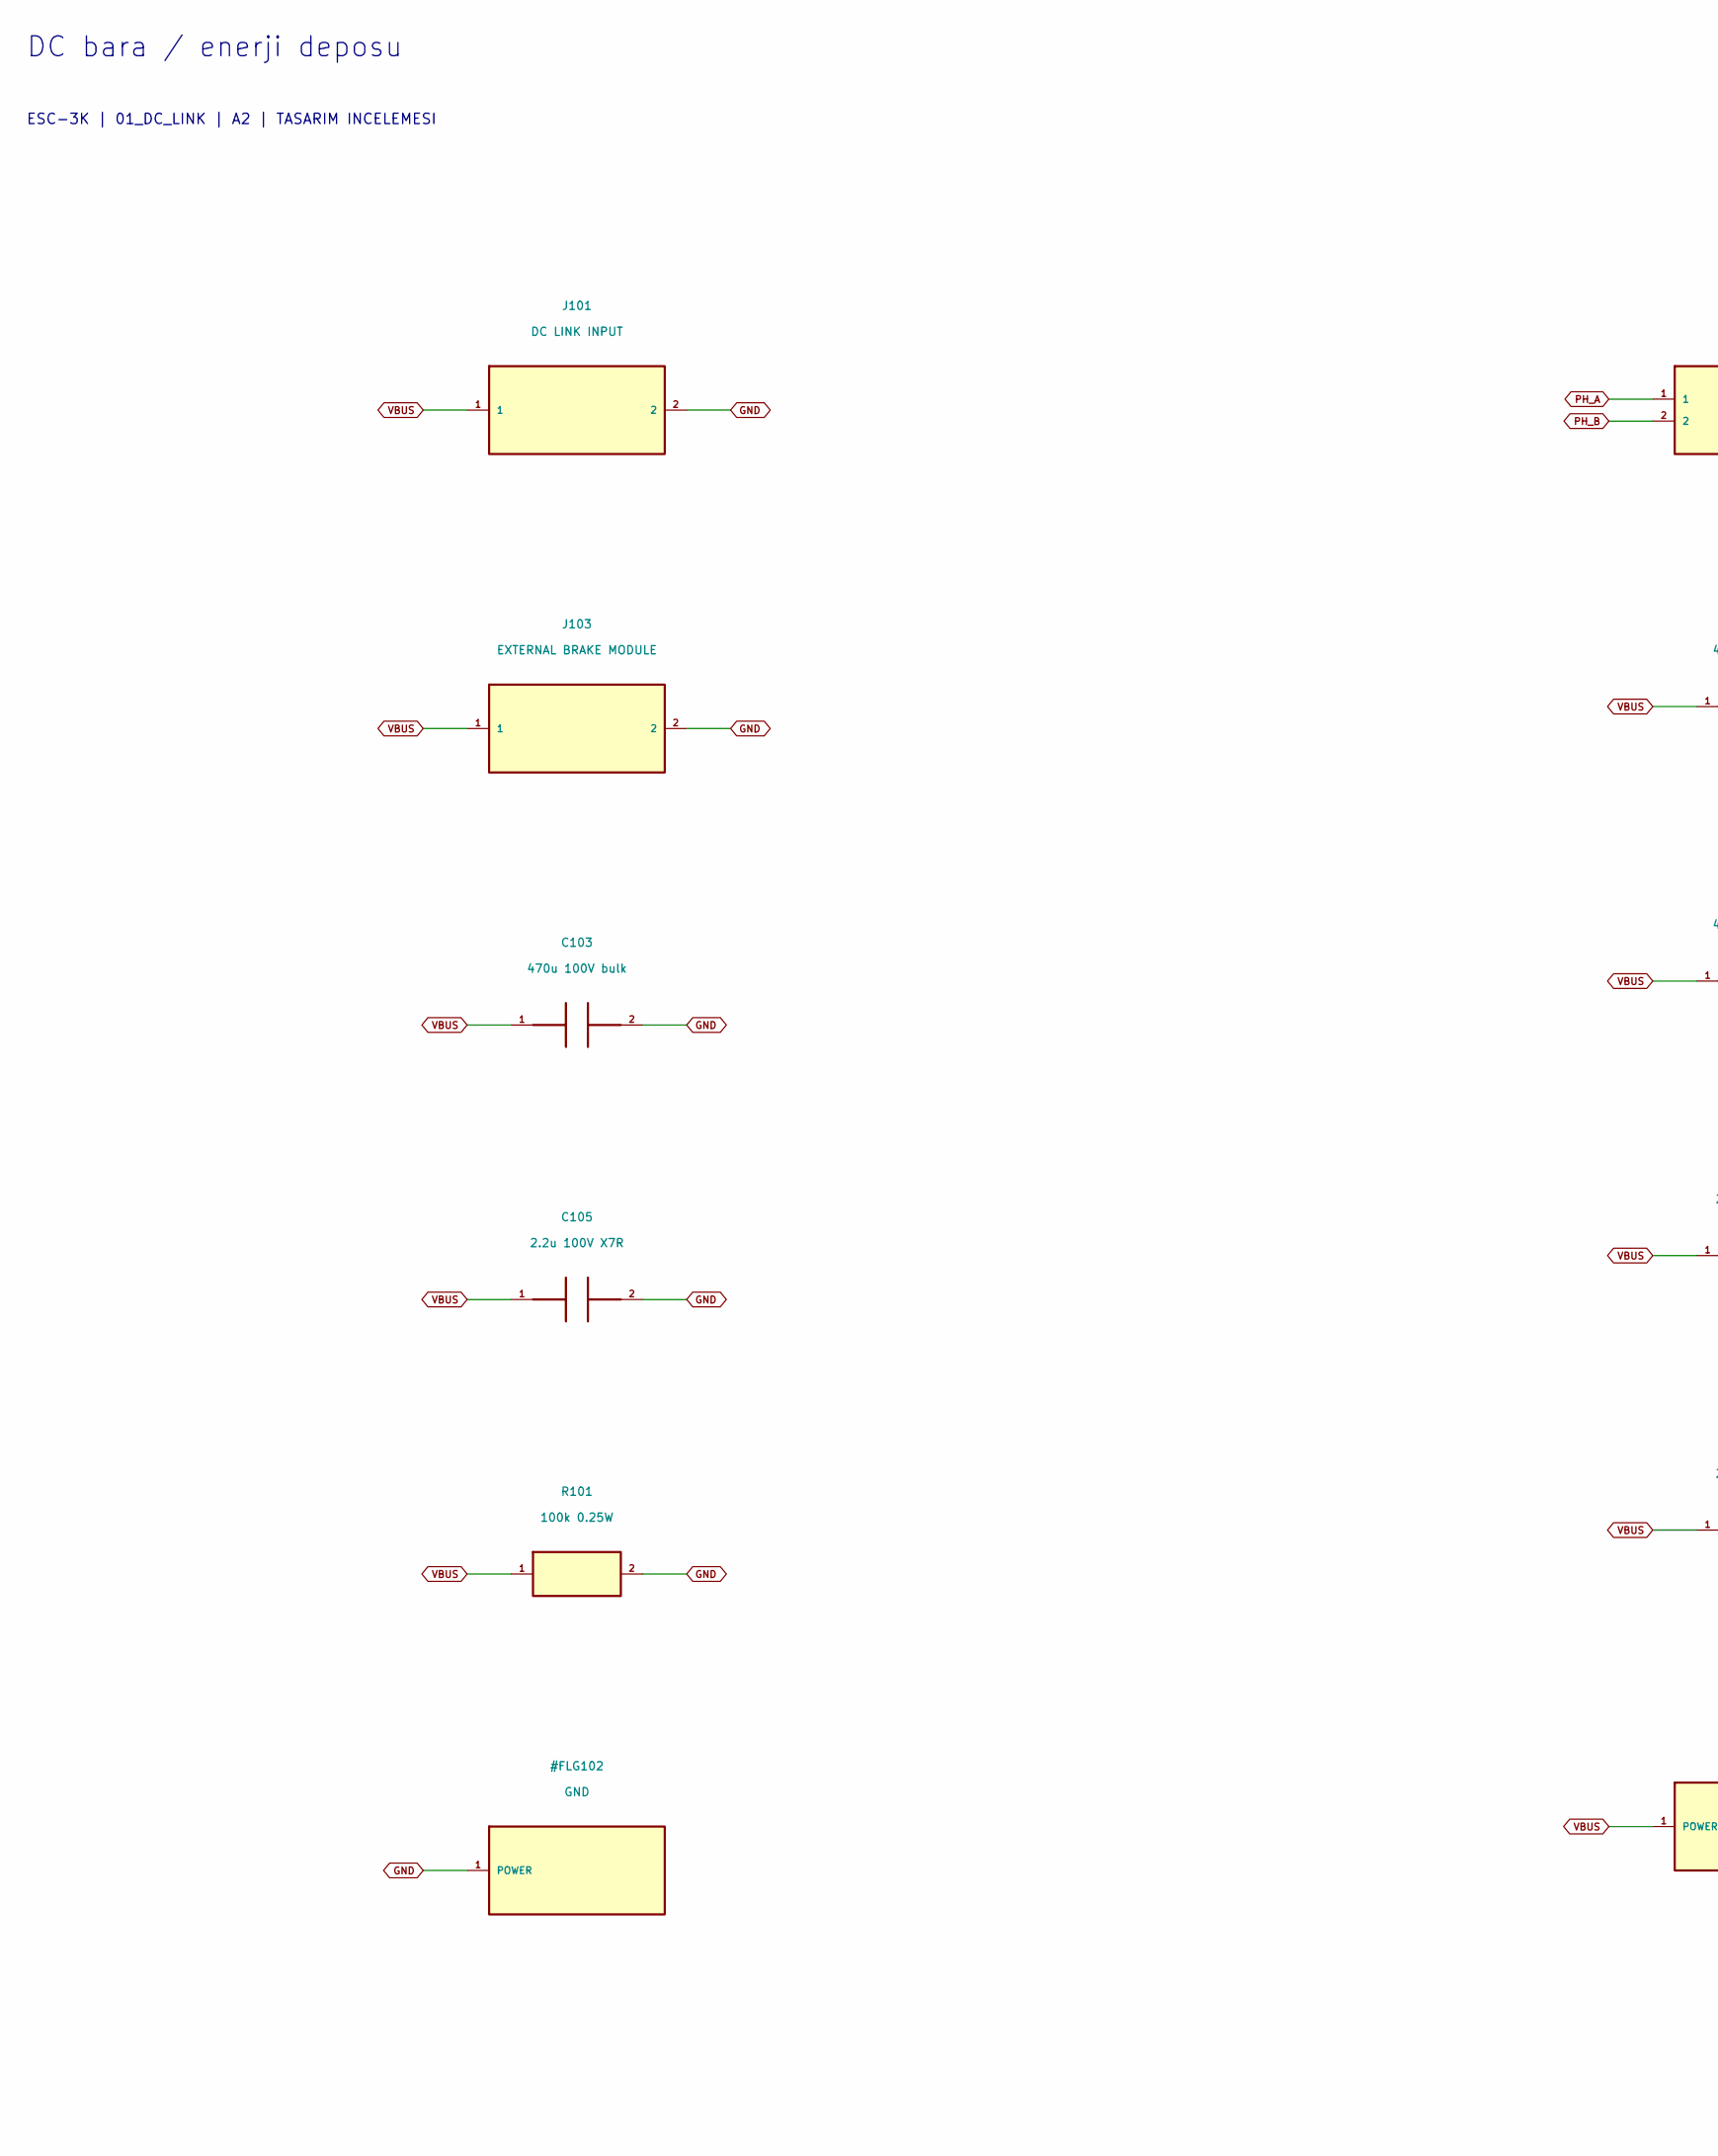
[picture p115: schematic 01_DC_LINK.kicad_sch, part in row 1, column 1]

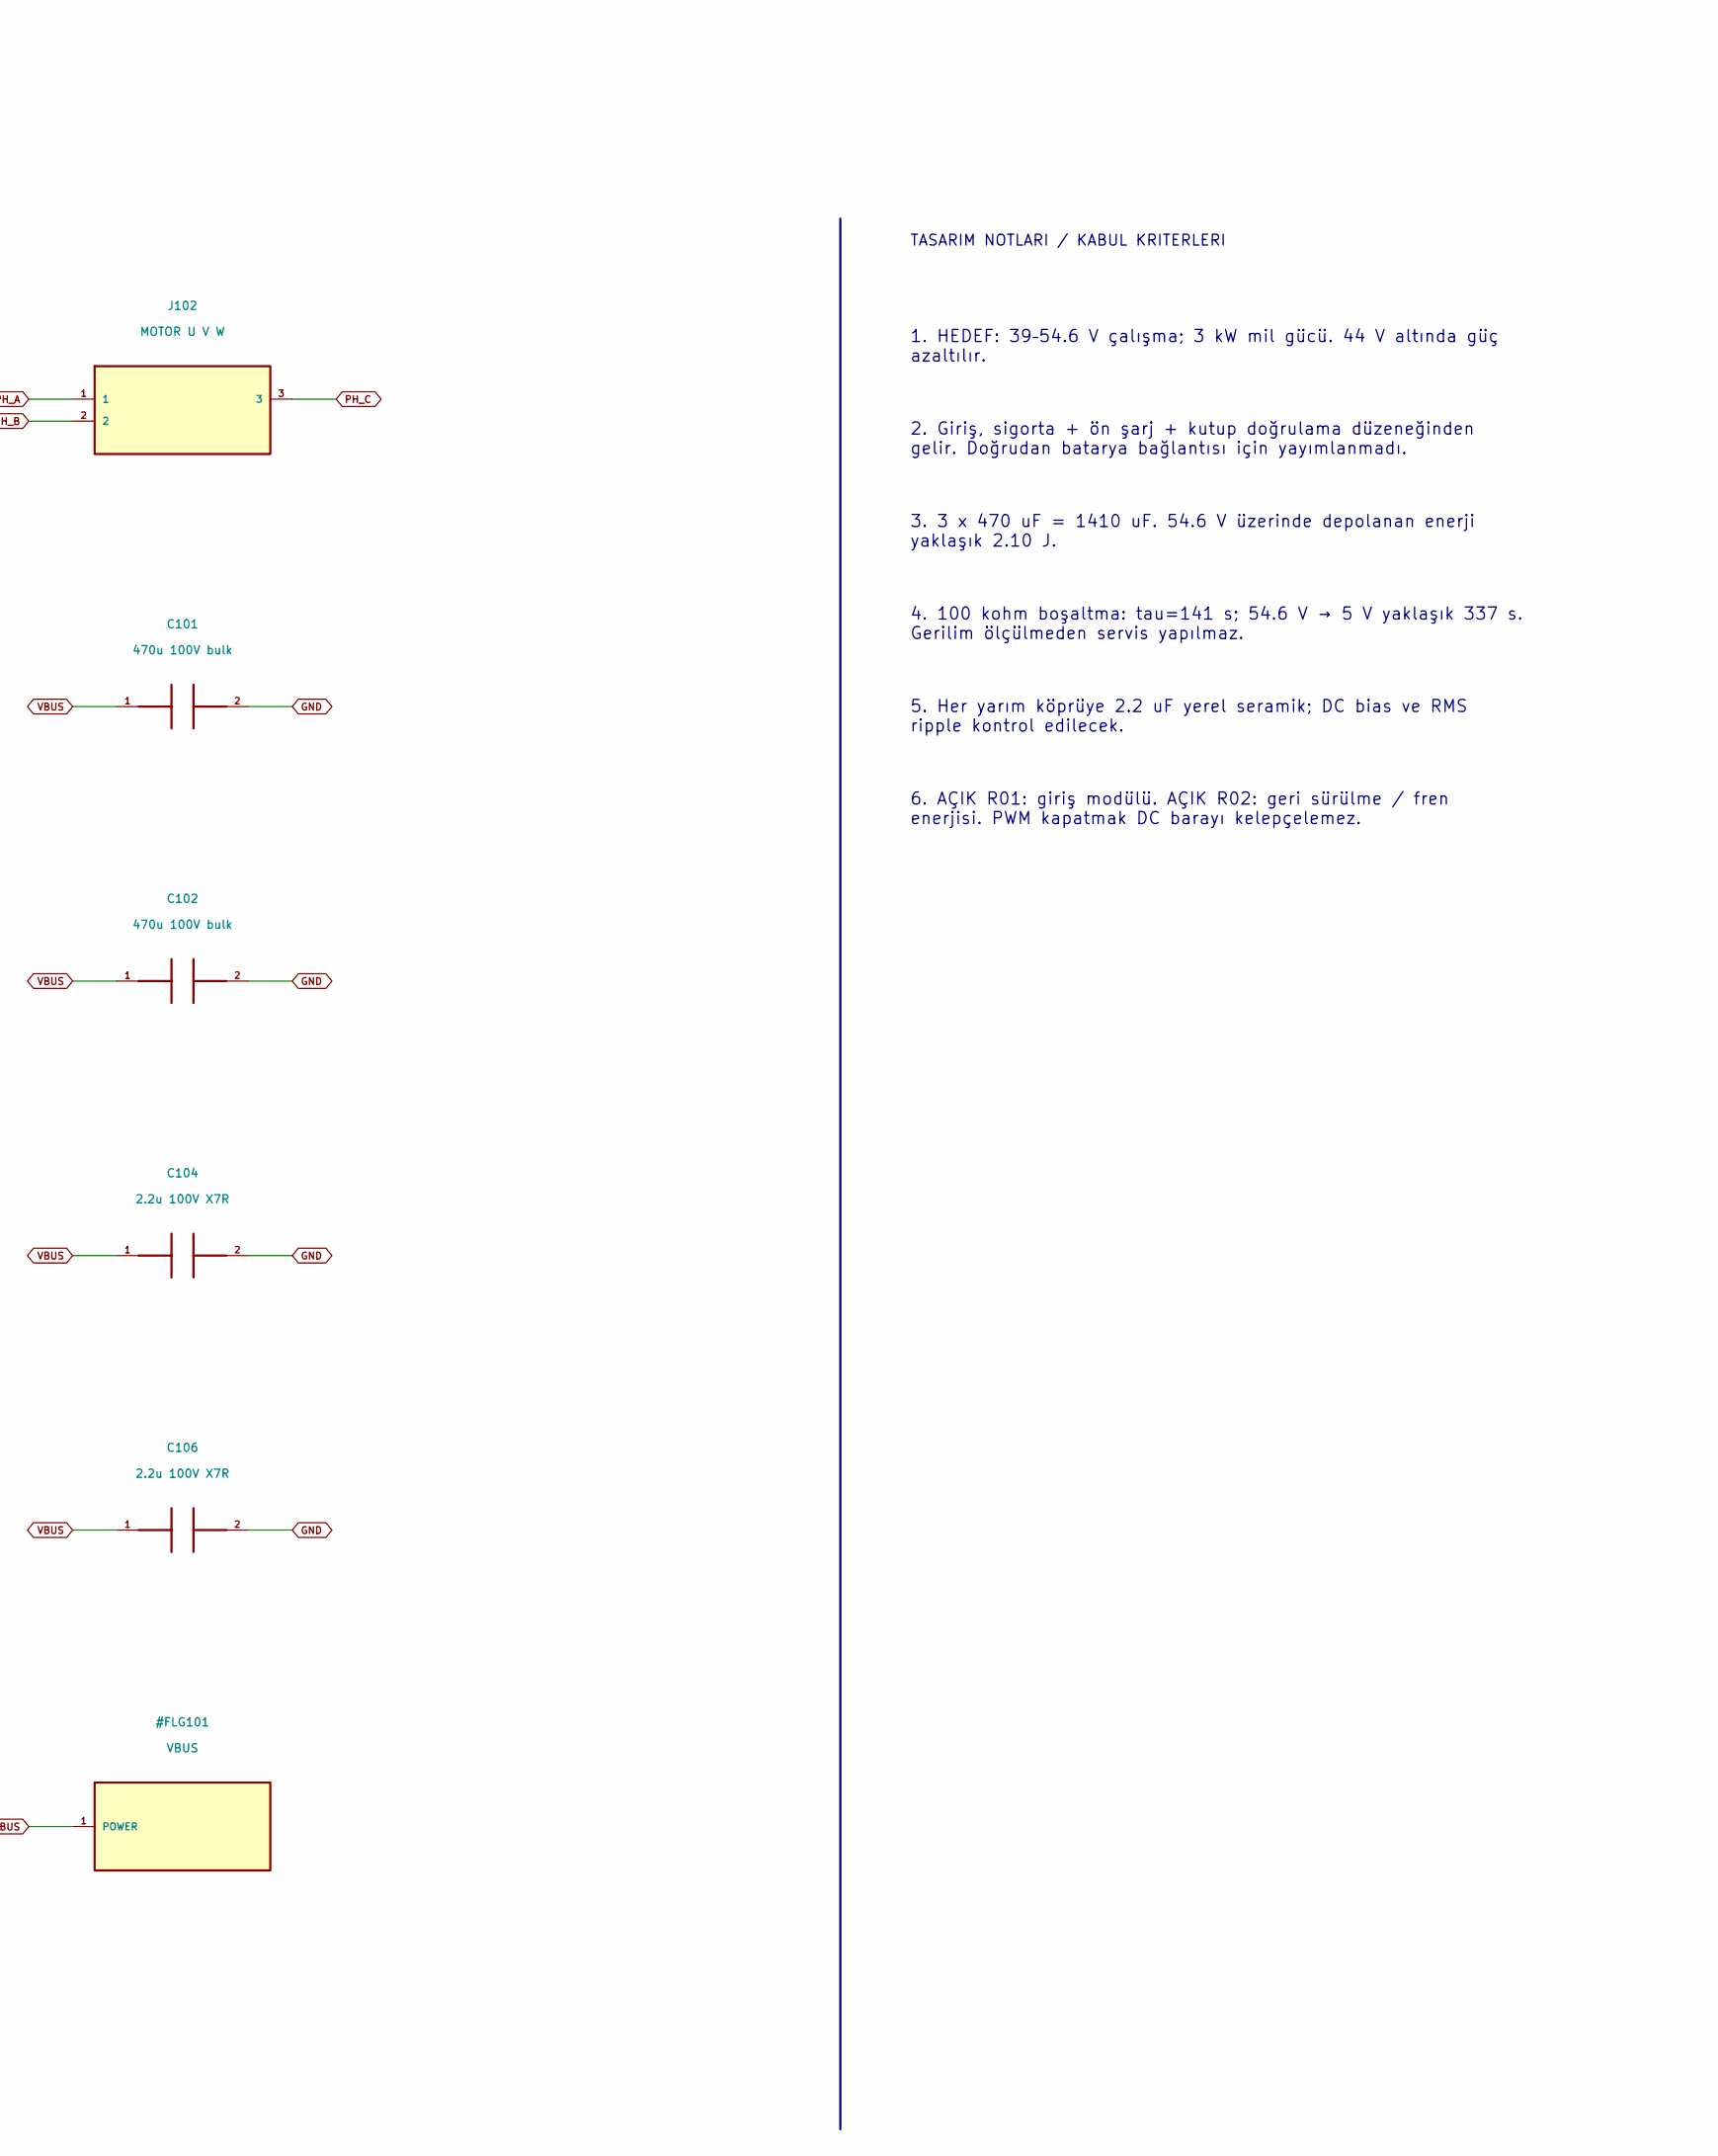
[picture p116: schematic 01_DC_LINK.kicad_sch, part in row 1, column 2]

Parts:
C101, C102, C103: 470u 100V bulk
C104, C105, C106: 2.2u 100V X7R
J101: DC LINK INPUT
J102: MOTOR U V W
J103: EXTERNAL BRAKE MODULE
R101: 100k 0.25W; R_1206_3216Metric; MPN RC1206FR-07100KL

Connections:
GND: C101.2, C102.2, C103.2, C104.2, C105.2, C106.2, J101.2, J103.2, R101.2
PH_A: J102.1
PH_B: J102.2
PH_C: J102.3
VBUS: C101.1, C102.1, C103.1, C104.1, C105.1, C106.1, J101.1, J103.1, R101.1

Notes on the sheet:
DC bara / enerji deposu
ESC-3K | 01_DC_LINK | A2 | TASARIM INCELEMESI
TASARIM NOTLARI / KABUL KRITERLERI
1. HEDEF: 39–54.6 V çalışma; 3 kW mil gücü. 44 V altında güç azaltılır.
2. Giriş, sigorta + ön şarj + kutup doğrulama düzeneğinden gelir. Doğrudan batarya bağlantısı için yayımlanmadı.
3. 3 x 470 uF = 1410 uF. 54.6 V üzerinde depolanan enerji yaklaşık 2.10 J.
4. 100 kohm boşaltma: tau=141 s; 54.6 V → 5 V yaklaşık 337 s. Gerilim ölçülmeden servis yapılmaz.
5. Her yarım köprüye 2.2 uF yerel seramik; DC bias ve RMS ripple kontrol edilecek.
6. AÇIK R01: giriş modülü. AÇIK R02: geri sürülme / fren enerjisi. PWM kapatmak DC barayı kelepçelemez.
