mekiciepcas/ESC-Ai/ESC_V2/hardware_a2/02_PHASE_A.kicad_sch

## KiCad design ESC_V2/hardware_a2/02_PHASE_A.kicad_sch (2026-09-18)

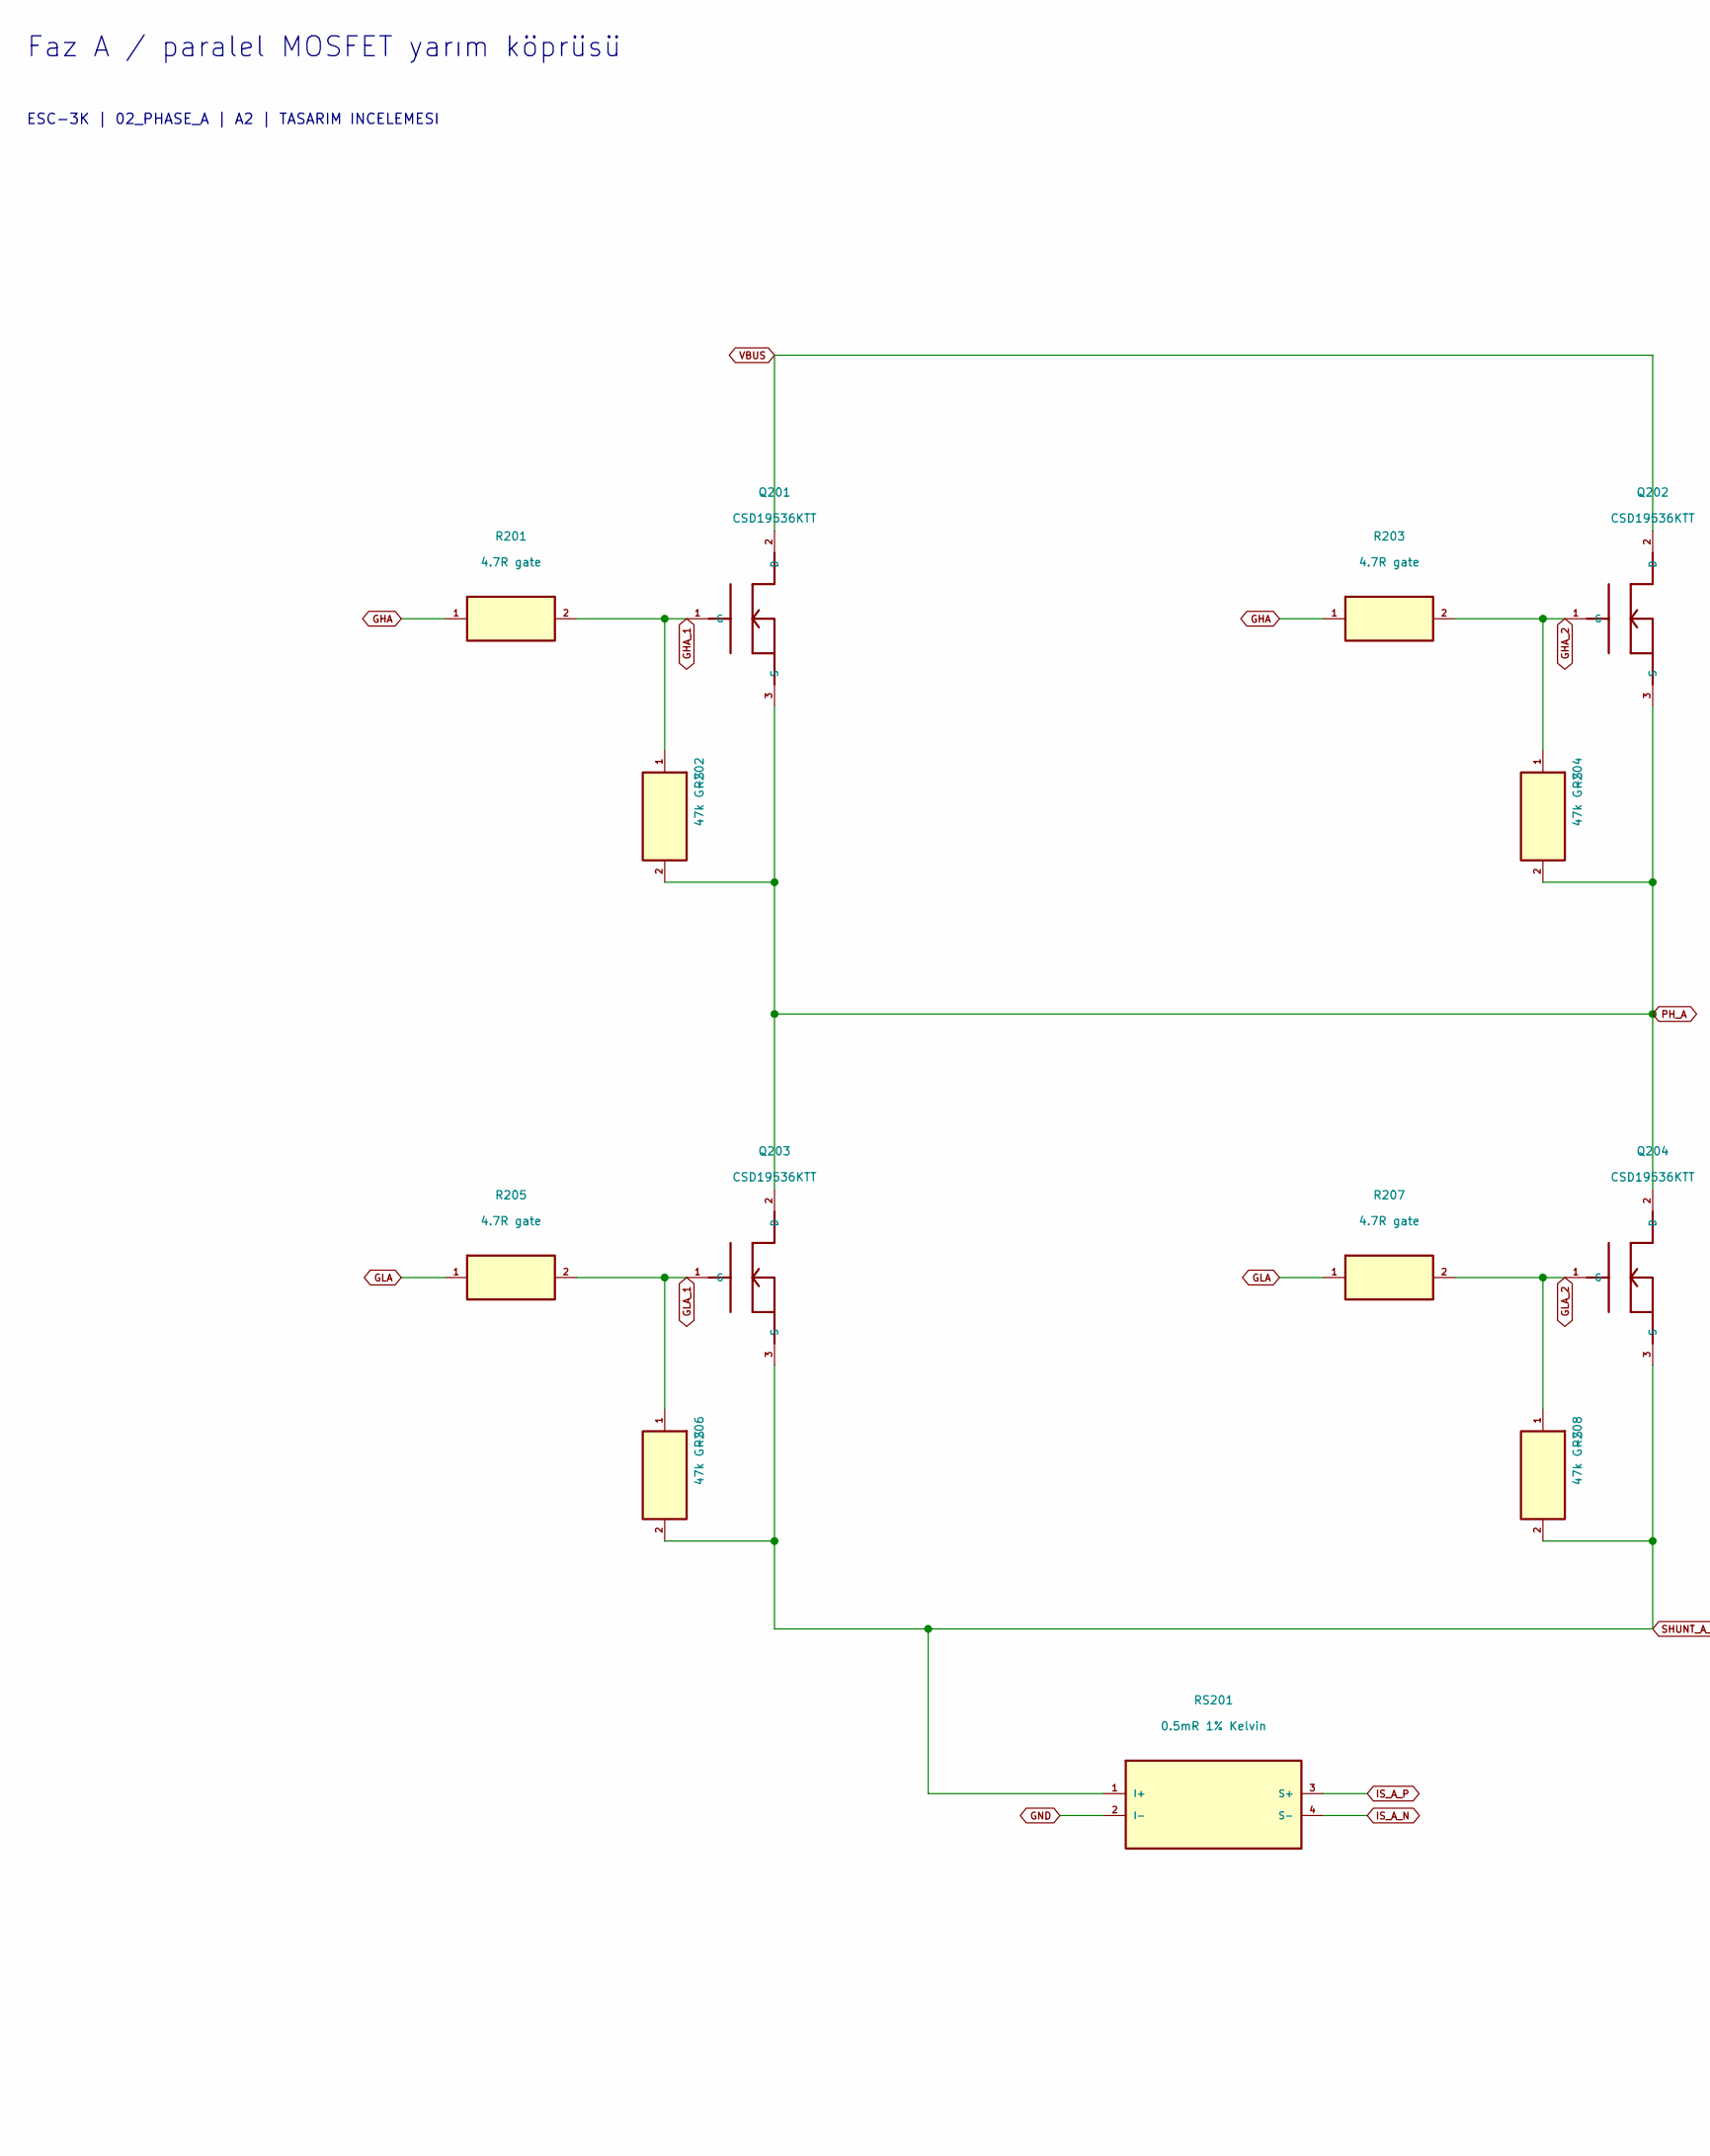
[picture p117: schematic 02_PHASE_A.kicad_sch, part in row 1, column 1]

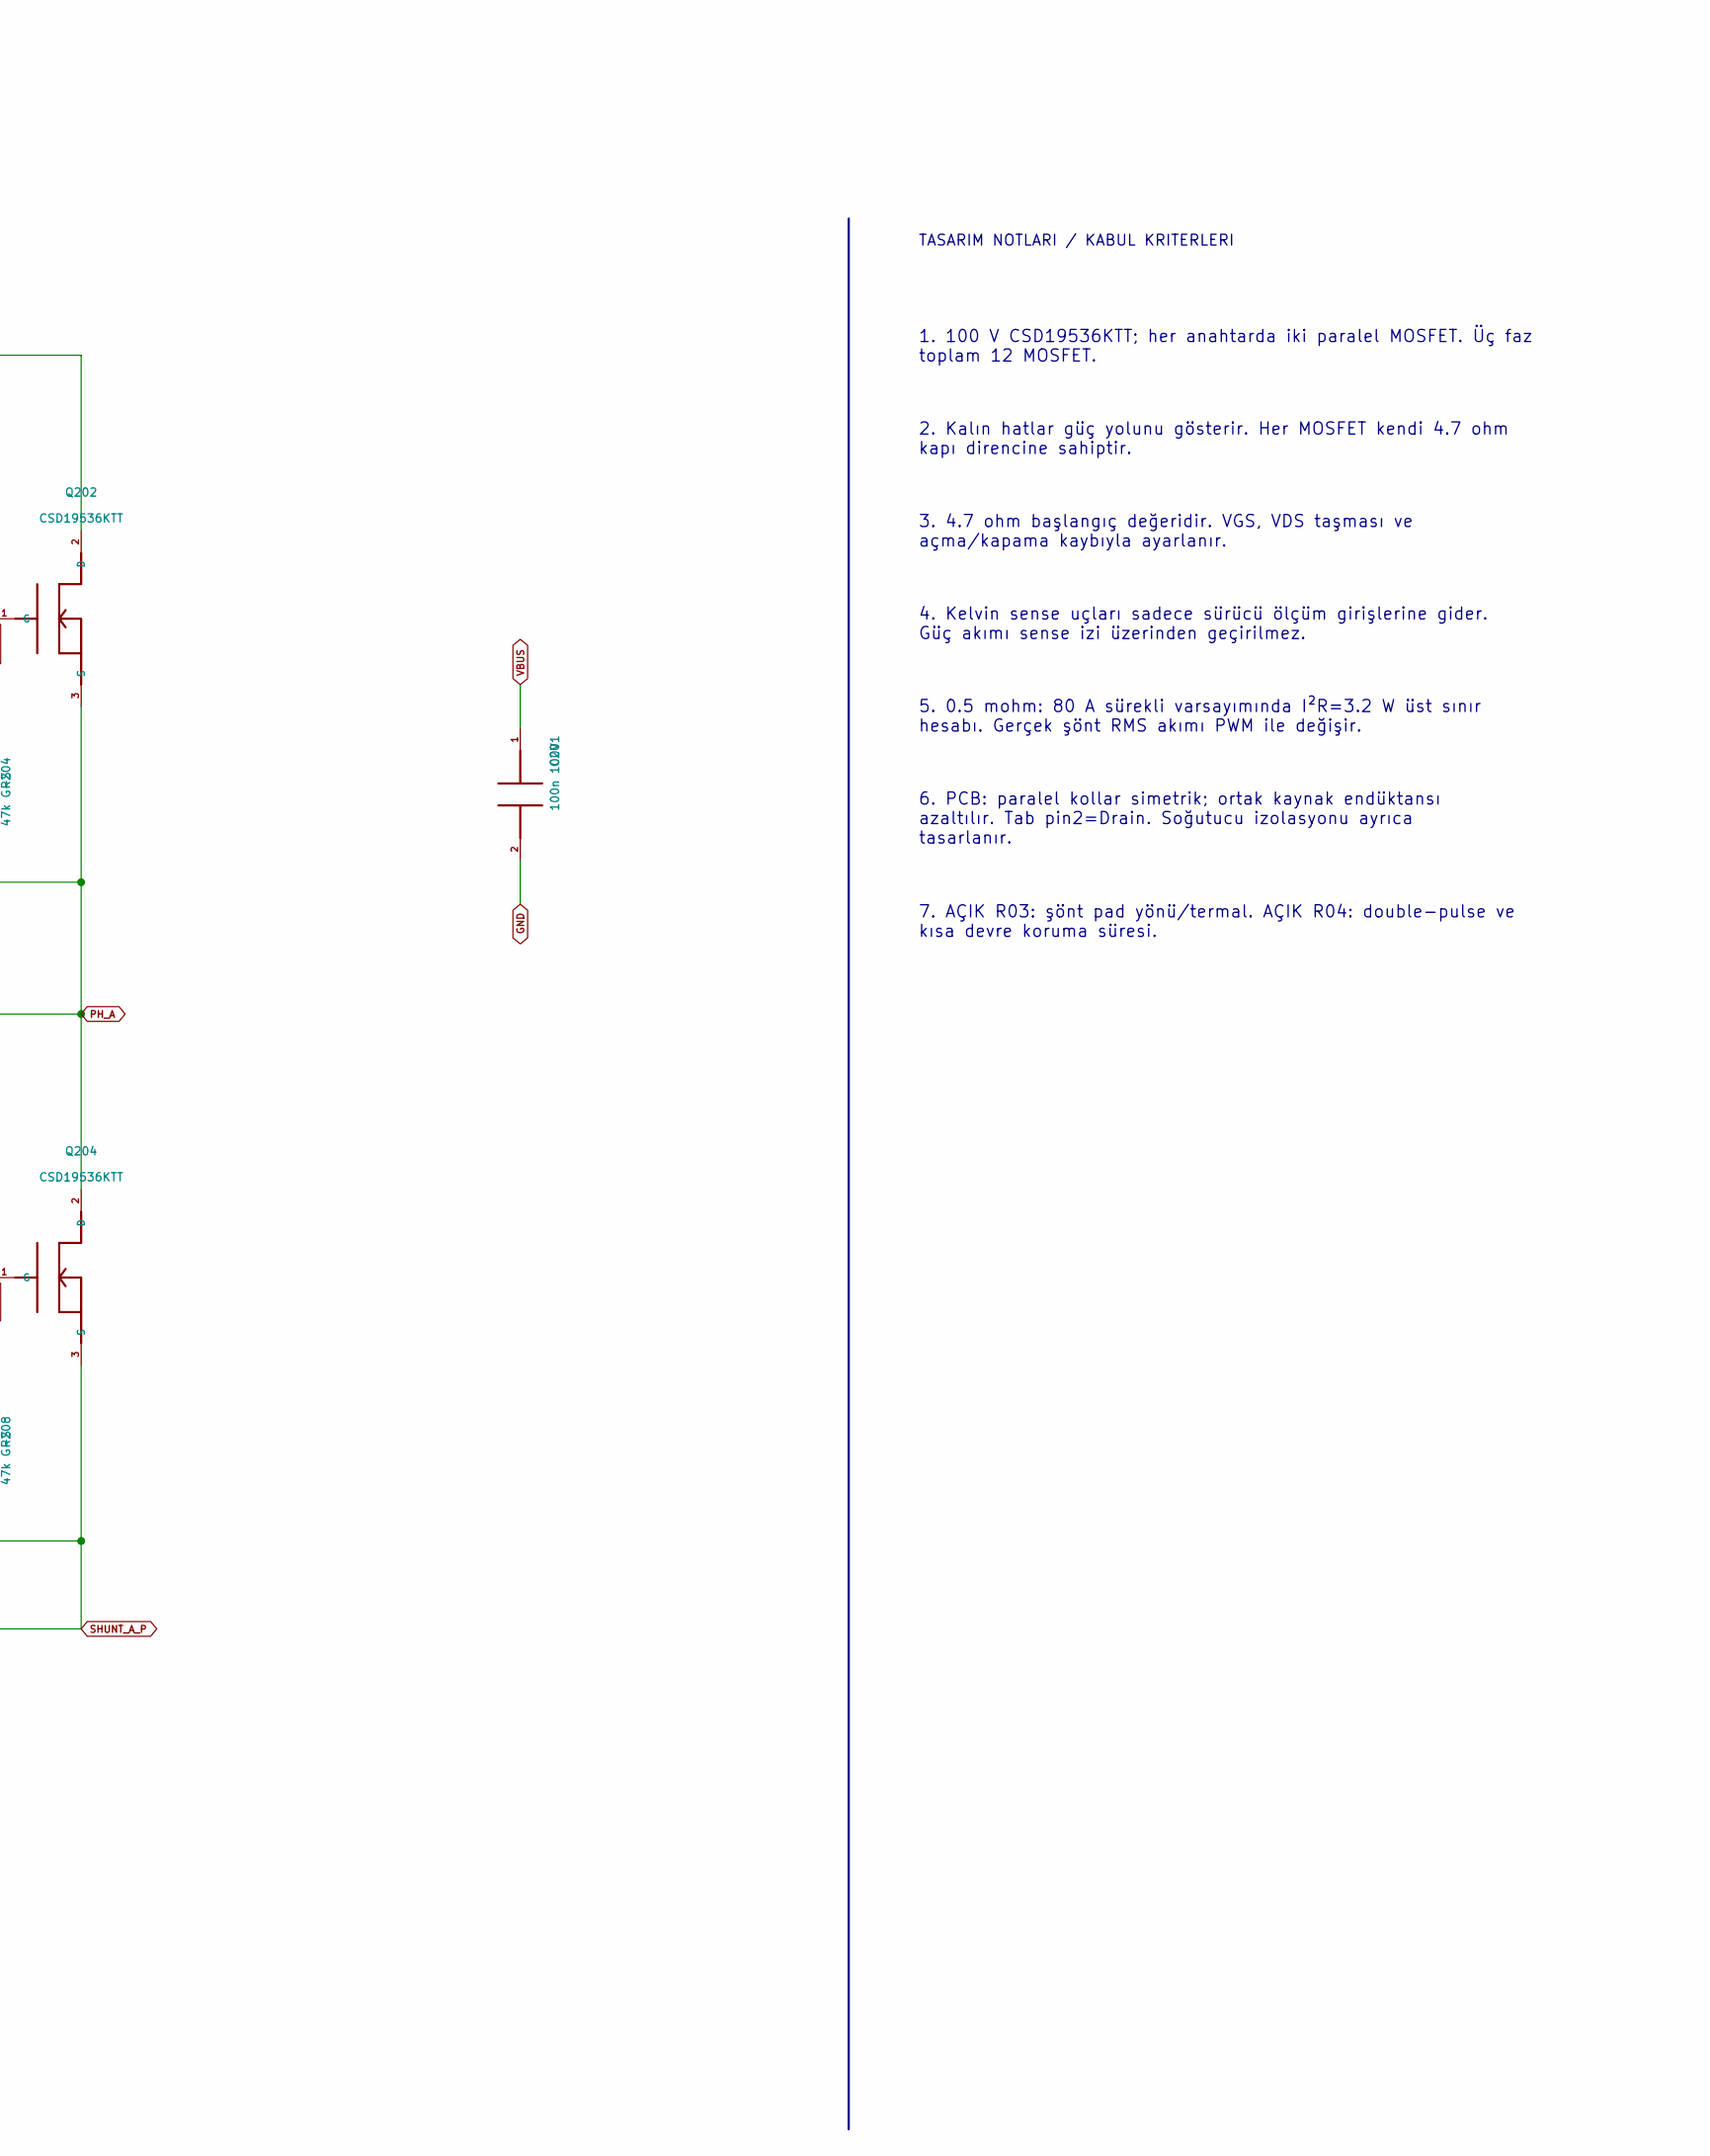
[picture p118: schematic 02_PHASE_A.kicad_sch, part in row 1, column 2]

Parts:
C201: 100n 100V; C_0805_2012Metric; MPN C2012X7R2A104K125AA
Q201, Q202, Q203, Q204: CSD19536KTT; TO-263-3_TabPin2; MPN CSD19536KTT
R201, R203, R205, R207: 4.7R gate; R_0805_2012Metric; MPN RC0805FR-074R7L
R202, R204, R206, R208: 47k G-S; R_0805_2012Metric; MPN RC0805FR-0747KL
RS201: 0.5mR 1% Kelvin; MPN CSS4J-4026R-L500F

Connections:
GHA: R201.1, R203.1
GHA_1: Q201.1 (G), R201.2, R202.1
GHA_2: Q202.1 (G), R203.2, R204.1
GLA: R205.1, R207.1
GLA_1: Q203.1 (G), R205.2, R206.1
GLA_2: Q204.1 (G), R207.2, R208.1
GND: C201.2, RS201.2 (I-)
IS_A_N: RS201.4 (S-)
IS_A_P: RS201.3 (S+)
PH_A: Q201.3 (S), Q202.3 (S), Q203.2 (D), Q204.2 (D), R202.2, R204.2
SHUNT_A_P: Q203.3 (S), Q204.3 (S), R206.2, R208.2, RS201.1 (I+)
VBUS: C201.1, Q201.2 (D), Q202.2 (D)

Notes on the sheet:
Faz A / paralel MOSFET yarım köprüsü
ESC-3K | 02_PHASE_A | A2 | TASARIM INCELEMESI
TASARIM NOTLARI / KABUL KRITERLERI
1. 100 V CSD19536KTT; her anahtarda iki paralel MOSFET. Üç faz toplam 12 MOSFET.
2. Kalın hatlar güç yolunu gösterir. Her MOSFET kendi 4.7 ohm kapı direncine sahiptir.
3. 4.7 ohm başlangıç değeridir. VGS, VDS taşması ve açma/kapama kaybıyla ayarlanır.
4. Kelvin sense uçları sadece sürücü ölçüm girişlerine gider. Güç akımı sense izi üzerinden geçirilmez.
5. 0.5 mohm: 80 A sürekli varsayımında I²R=3.2 W üst sınır hesabı. Gerçek şönt RMS akımı PWM ile değişir.
6. PCB: paralel kollar simetrik; ortak kaynak endüktansı azaltılır. Tab pin2=Drain. Soğutucu izolasyonu ayrıca tasarlanır.
7. AÇIK R03: şönt pad yönü/termal. AÇIK R04: double-pulse ve kısa devre koruma süresi.
