mekiciepcas/ESC-Ai/ESC_V2/hardware_a2/02_PHASE_B.kicad_sch

## KiCad design ESC_V2/hardware_a2/02_PHASE_B.kicad_sch (2026-09-18)

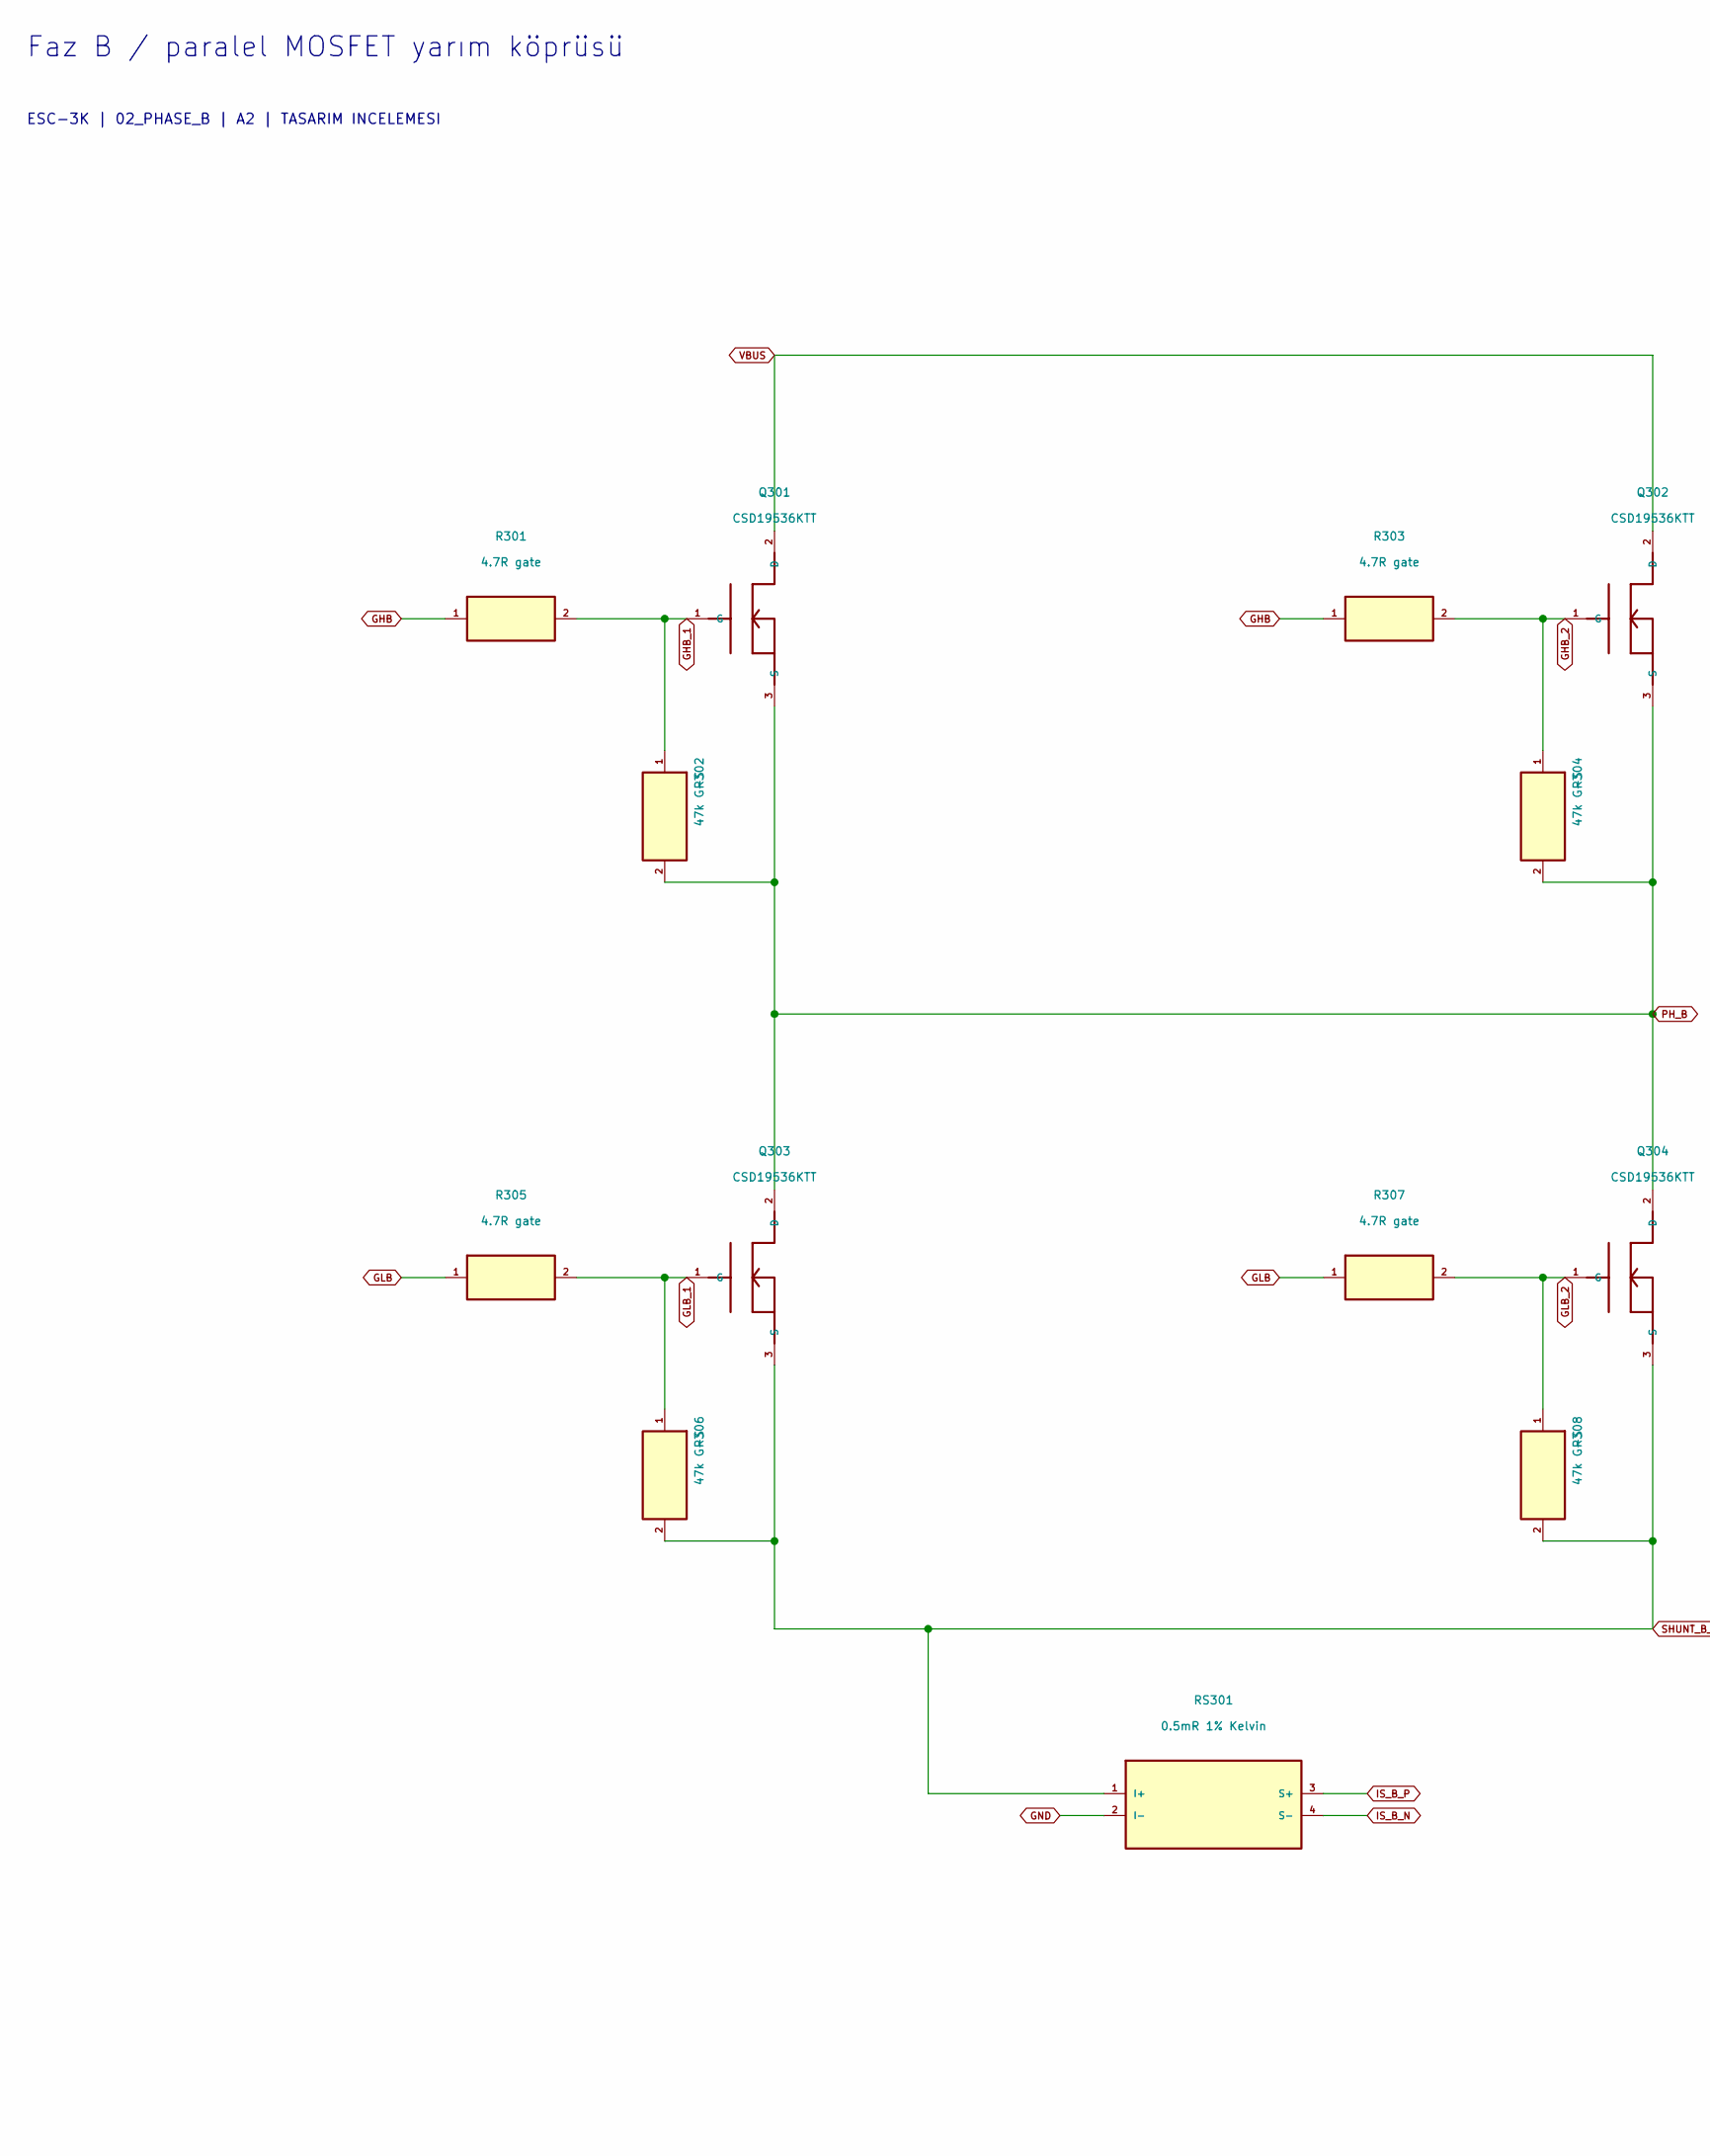
[picture p119: schematic 02_PHASE_B.kicad_sch, part in row 1, column 1]

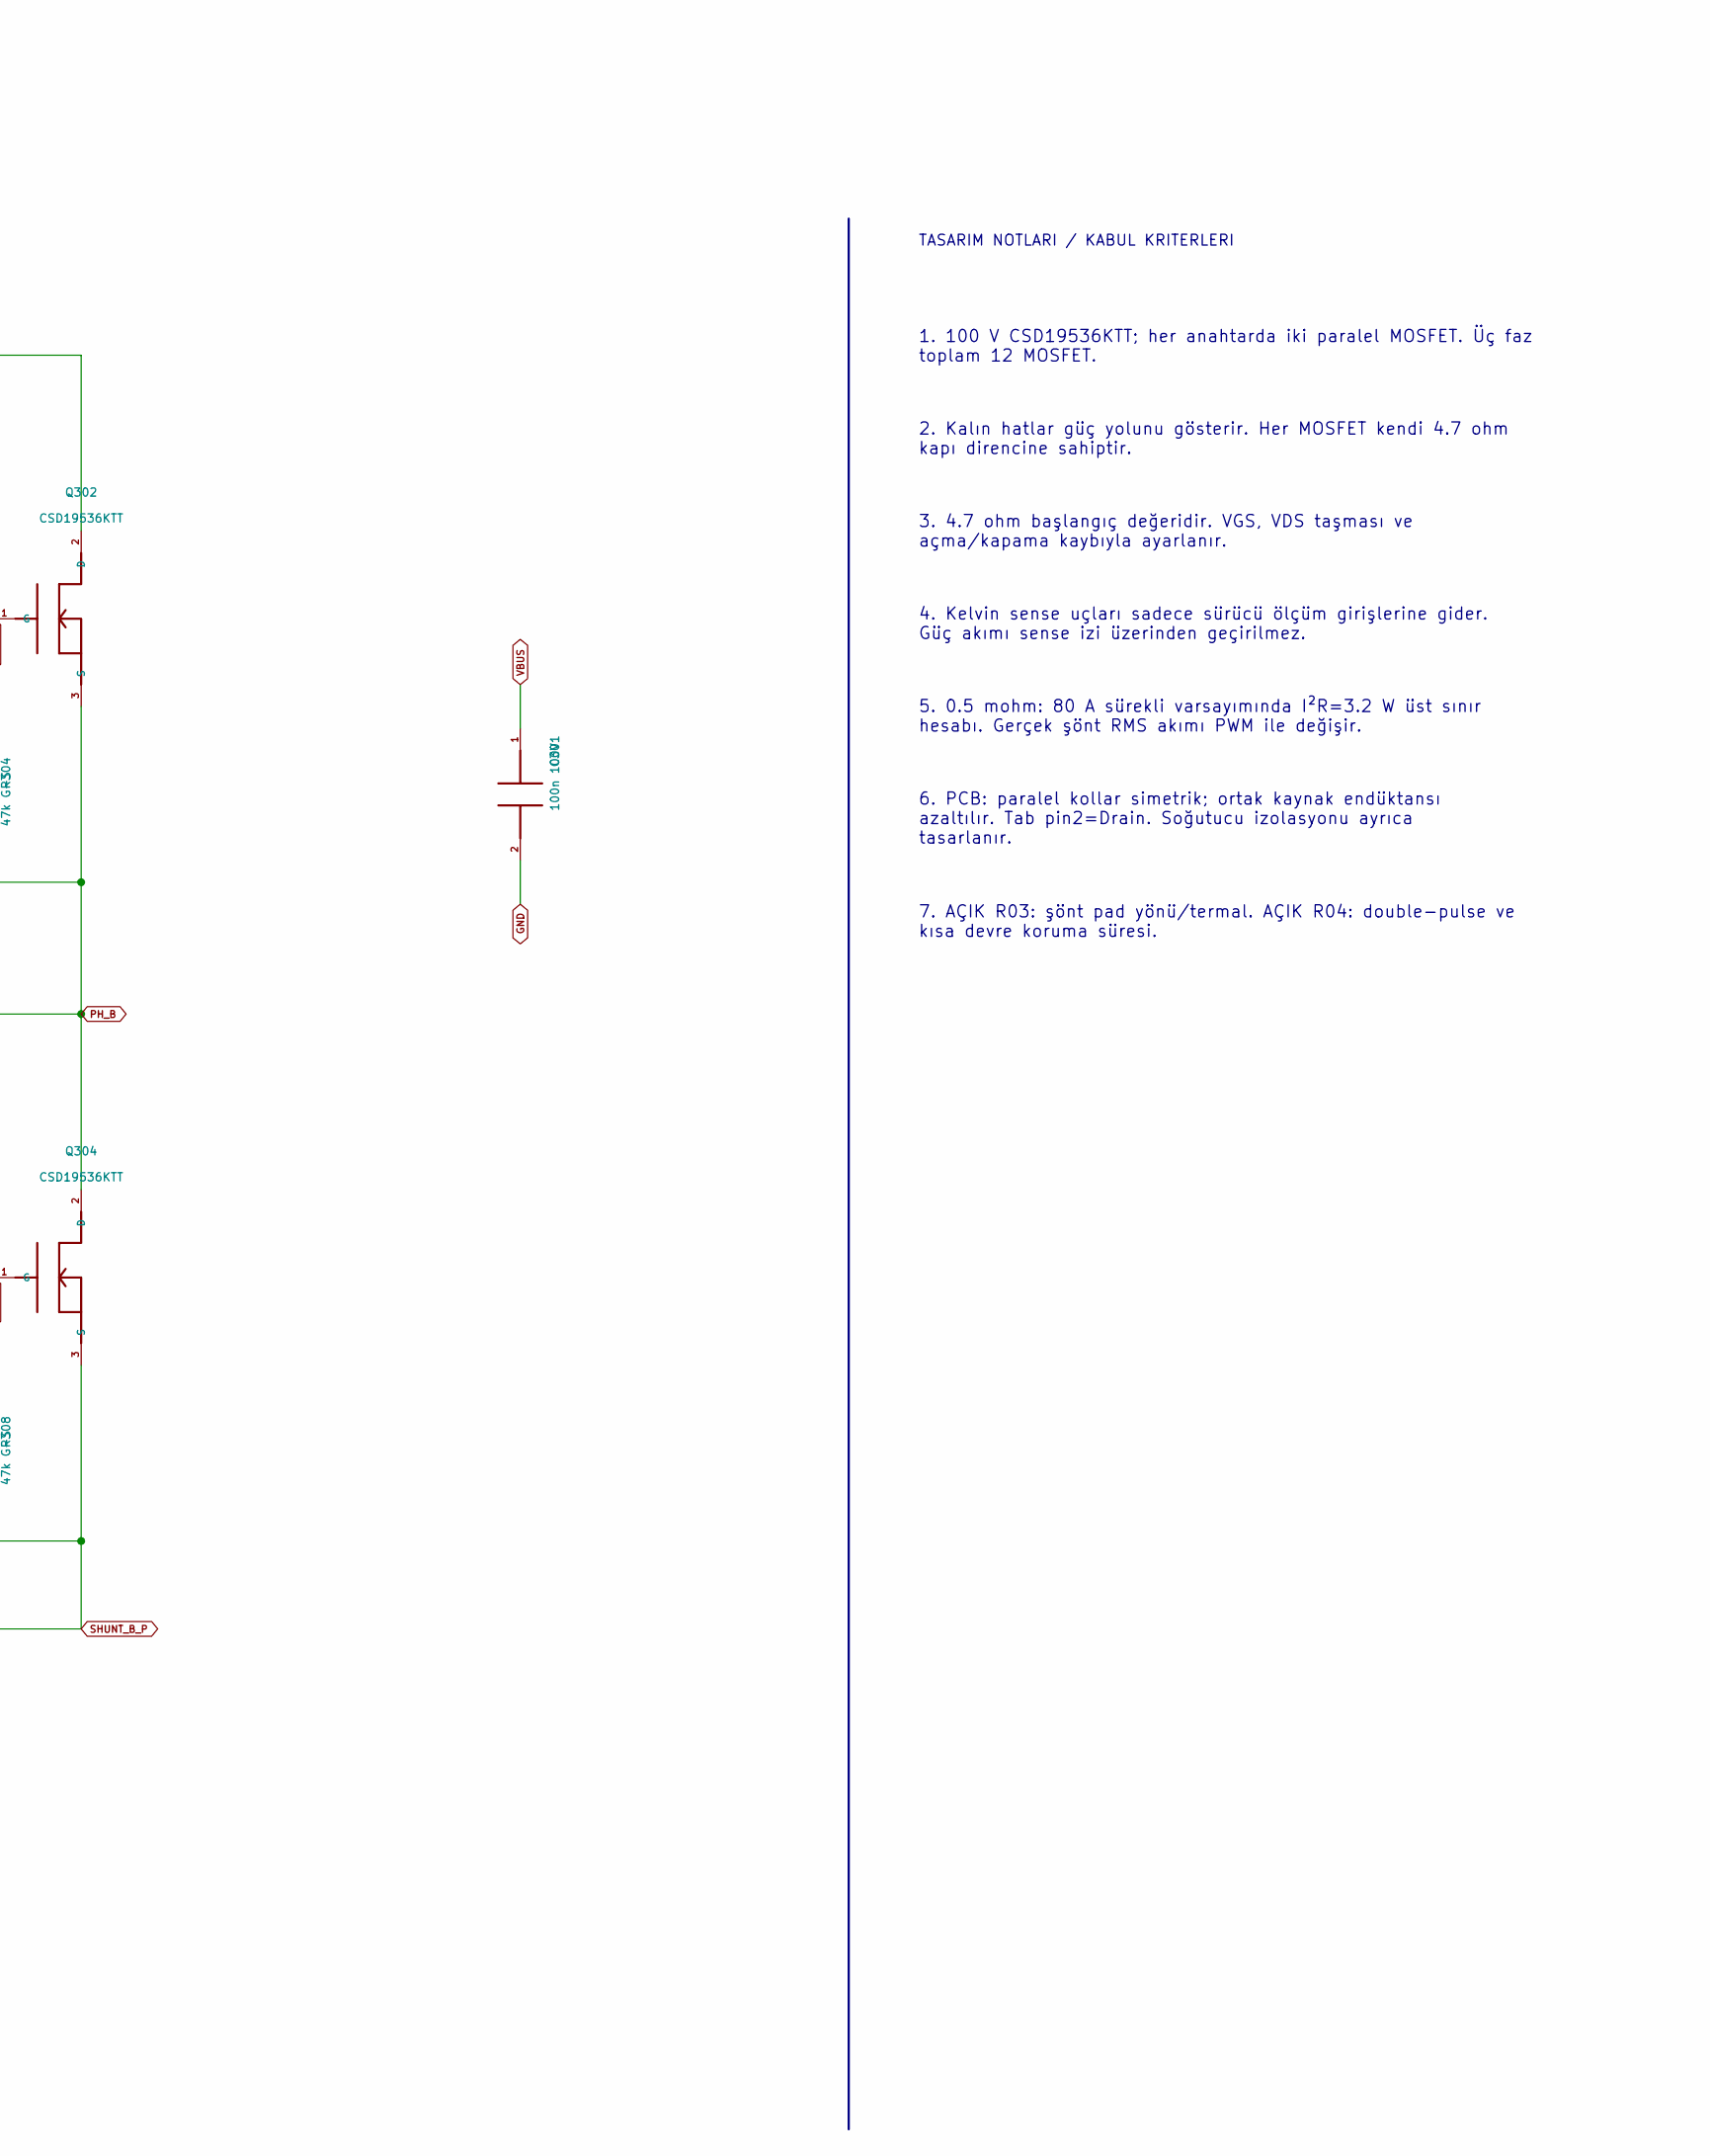
[picture p120: schematic 02_PHASE_B.kicad_sch, part in row 1, column 2]

Parts:
C301: 100n 100V; C_0805_2012Metric; MPN C2012X7R2A104K125AA
Q301, Q302, Q303, Q304: CSD19536KTT; TO-263-3_TabPin2; MPN CSD19536KTT
R301, R303, R305, R307: 4.7R gate; R_0805_2012Metric; MPN RC0805FR-074R7L
R302, R304, R306, R308: 47k G-S; R_0805_2012Metric; MPN RC0805FR-0747KL
RS301: 0.5mR 1% Kelvin; MPN CSS4J-4026R-L500F

Connections:
GHB: R301.1, R303.1
GHB_1: Q301.1 (G), R301.2, R302.1
GHB_2: Q302.1 (G), R303.2, R304.1
GLB: R305.1, R307.1
GLB_1: Q303.1 (G), R305.2, R306.1
GLB_2: Q304.1 (G), R307.2, R308.1
GND: C301.2, RS301.2 (I-)
IS_B_N: RS301.4 (S-)
IS_B_P: RS301.3 (S+)
PH_B: Q301.3 (S), Q302.3 (S), Q303.2 (D), Q304.2 (D), R302.2, R304.2
SHUNT_B_P: Q303.3 (S), Q304.3 (S), R306.2, R308.2, RS301.1 (I+)
VBUS: C301.1, Q301.2 (D), Q302.2 (D)

Notes on the sheet:
Faz B / paralel MOSFET yarım köprüsü
ESC-3K | 02_PHASE_B | A2 | TASARIM INCELEMESI
TASARIM NOTLARI / KABUL KRITERLERI
1. 100 V CSD19536KTT; her anahtarda iki paralel MOSFET. Üç faz toplam 12 MOSFET.
2. Kalın hatlar güç yolunu gösterir. Her MOSFET kendi 4.7 ohm kapı direncine sahiptir.
3. 4.7 ohm başlangıç değeridir. VGS, VDS taşması ve açma/kapama kaybıyla ayarlanır.
4. Kelvin sense uçları sadece sürücü ölçüm girişlerine gider. Güç akımı sense izi üzerinden geçirilmez.
5. 0.5 mohm: 80 A sürekli varsayımında I²R=3.2 W üst sınır hesabı. Gerçek şönt RMS akımı PWM ile değişir.
6. PCB: paralel kollar simetrik; ortak kaynak endüktansı azaltılır. Tab pin2=Drain. Soğutucu izolasyonu ayrıca tasarlanır.
7. AÇIK R03: şönt pad yönü/termal. AÇIK R04: double-pulse ve kısa devre koruma süresi.
