mekiciepcas/ESC-Ai/ESC_V2/hardware_a2/02_PHASE_C.kicad_sch

## KiCad design ESC_V2/hardware_a2/02_PHASE_C.kicad_sch (2026-09-18)

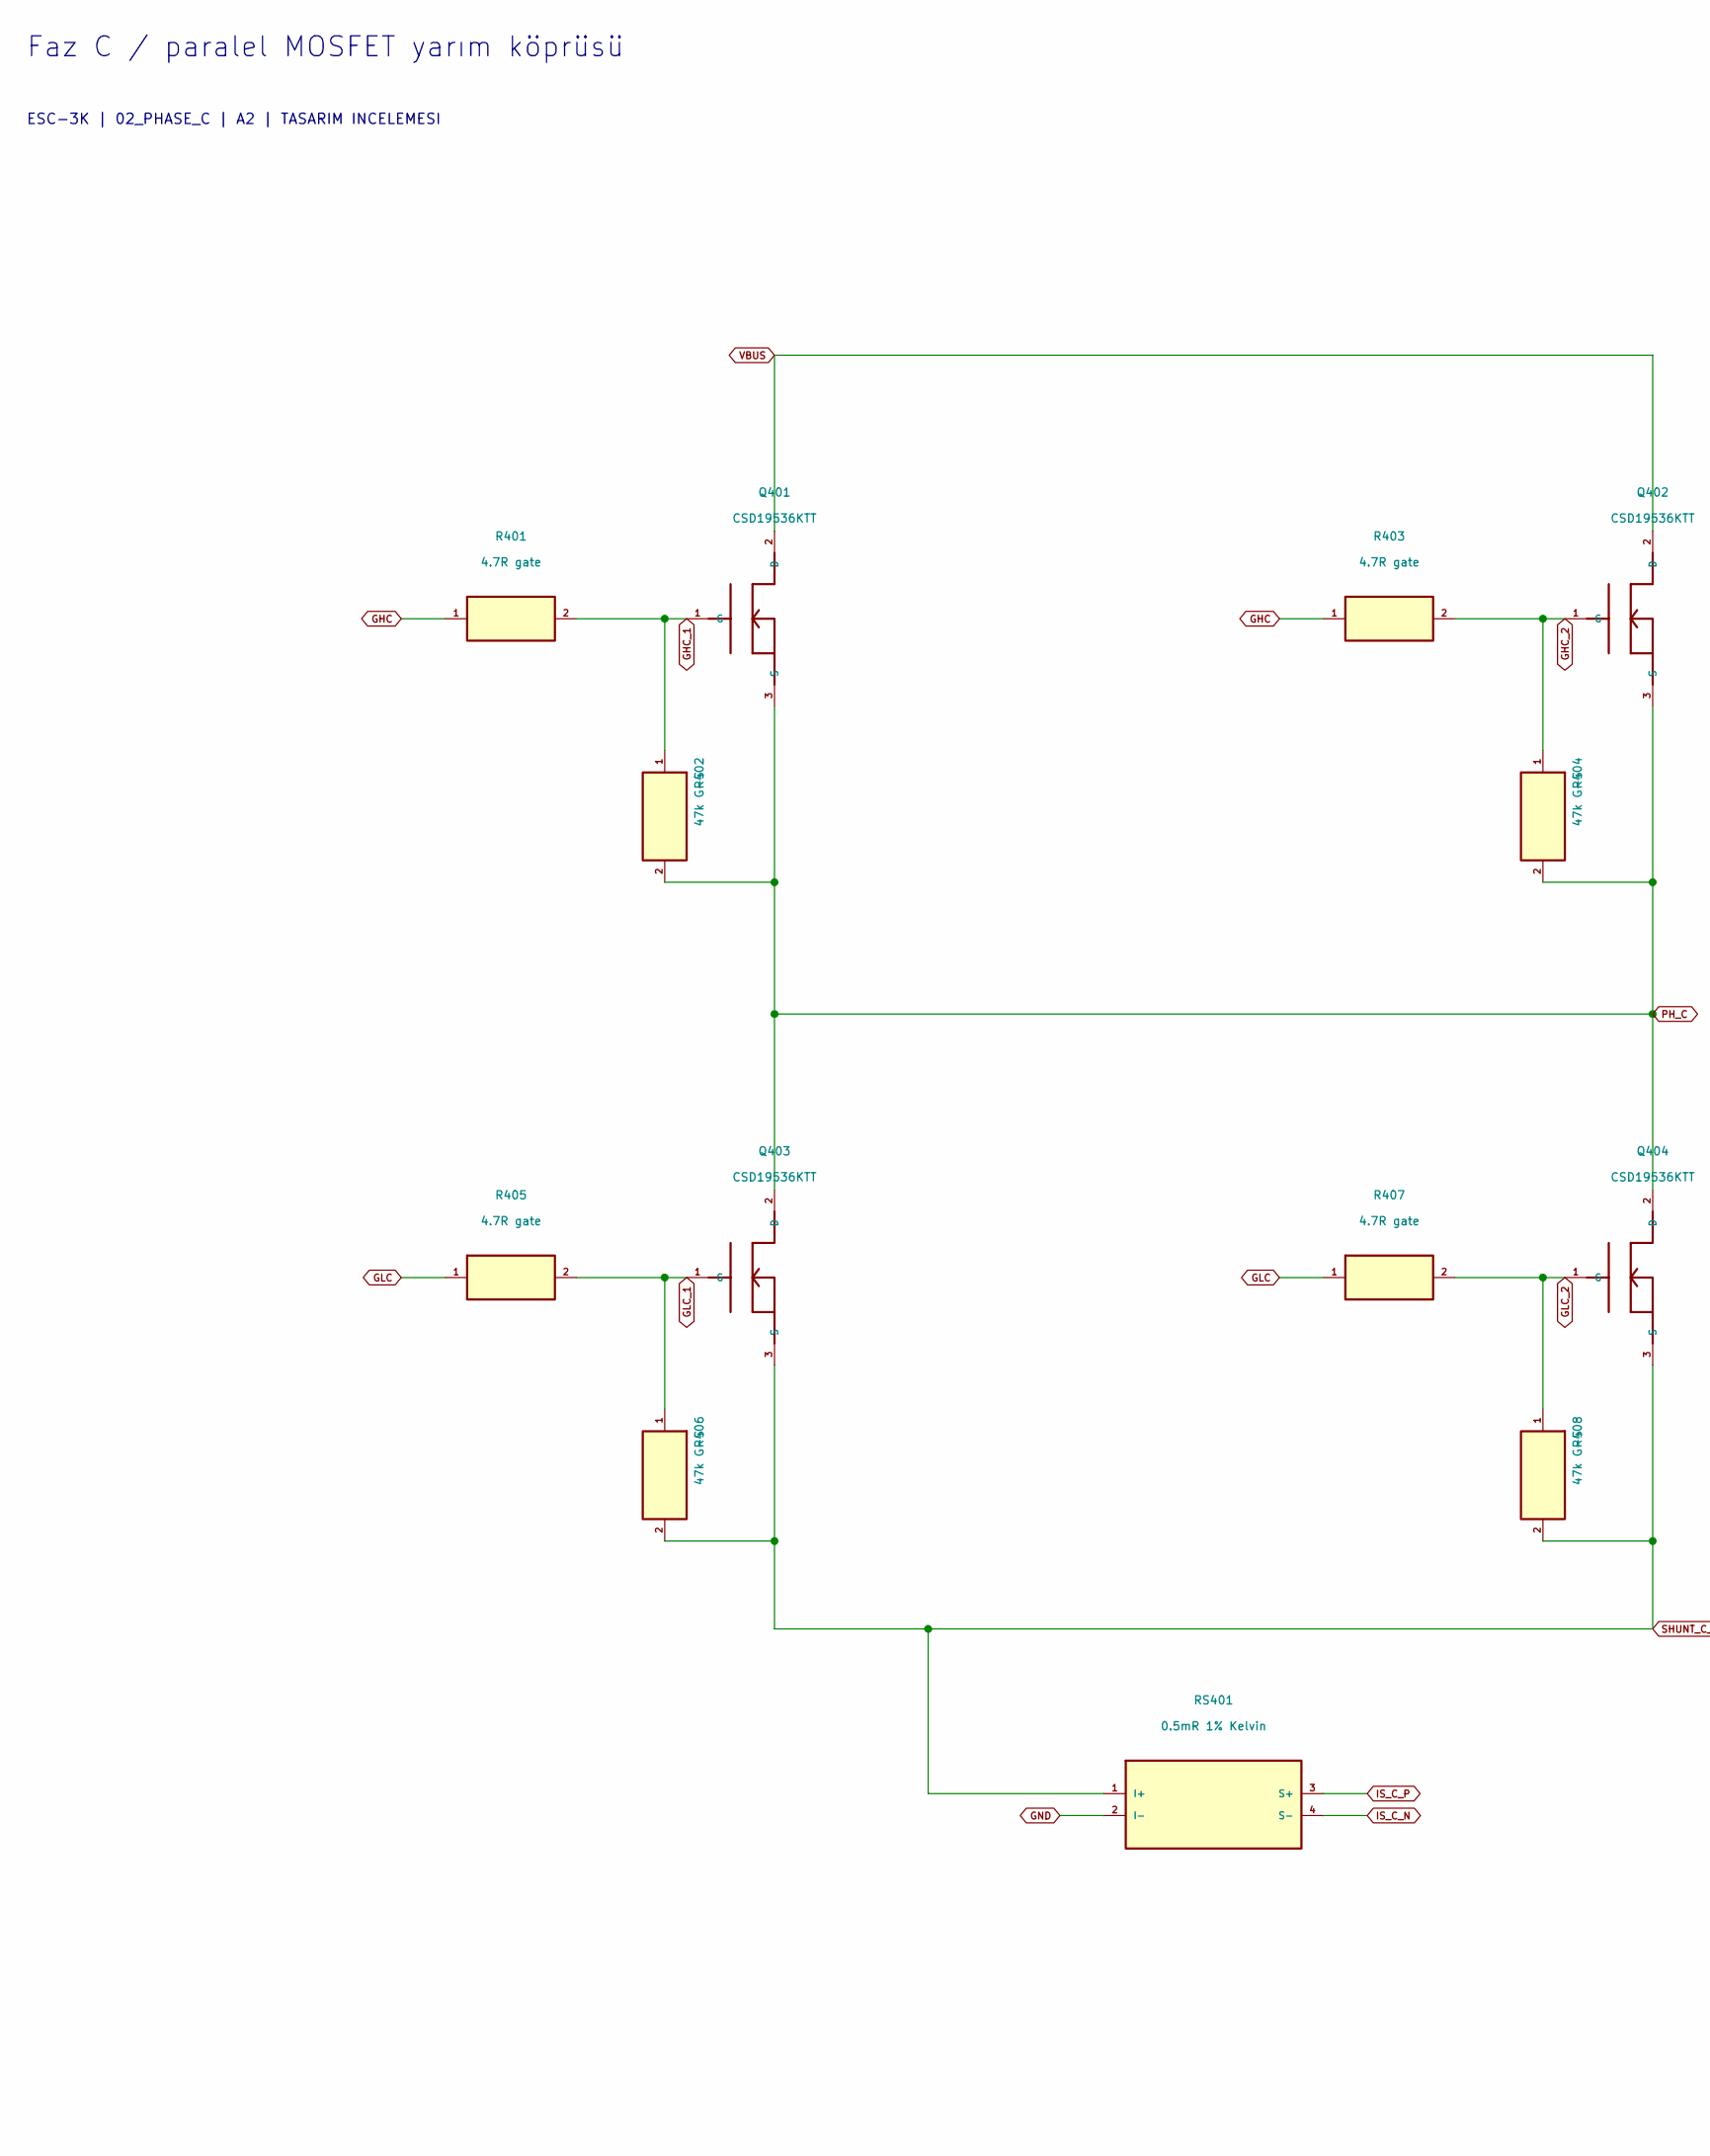
[picture p121: schematic 02_PHASE_C.kicad_sch, part in row 1, column 1]

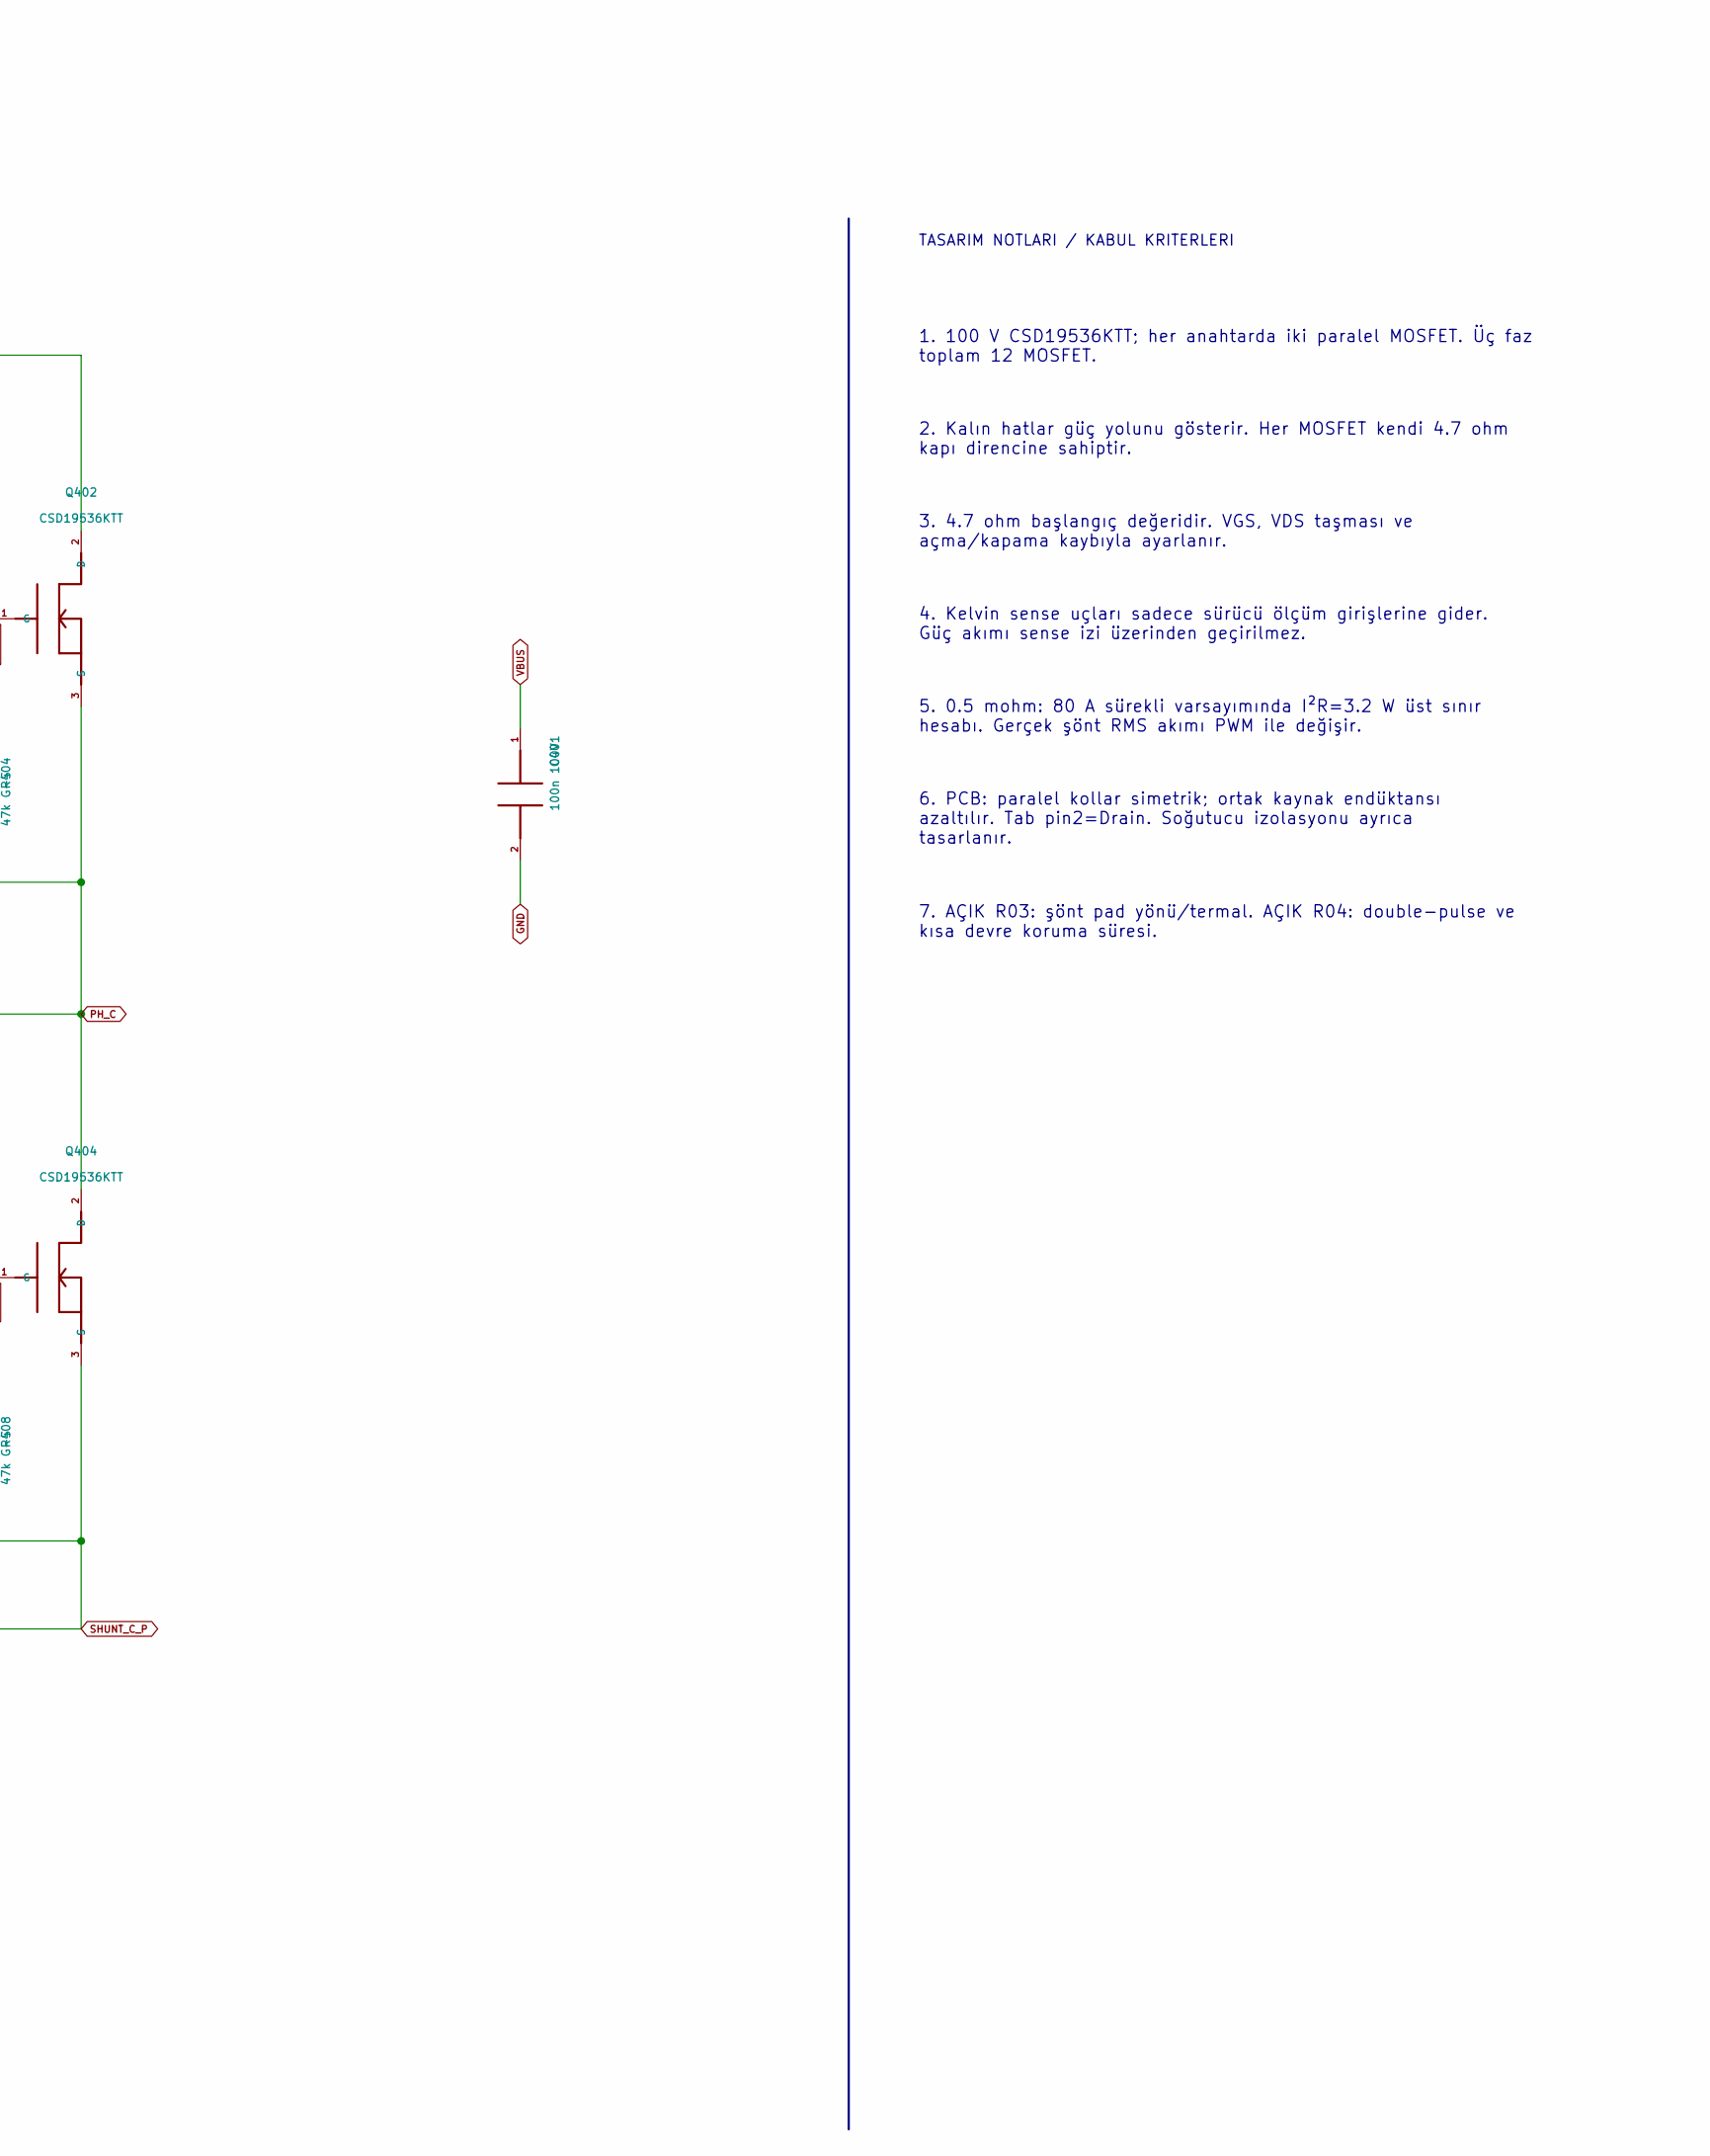
[picture p122: schematic 02_PHASE_C.kicad_sch, part in row 1, column 2]

Parts:
C401: 100n 100V; C_0805_2012Metric; MPN C2012X7R2A104K125AA
Q401, Q402, Q403, Q404: CSD19536KTT; TO-263-3_TabPin2; MPN CSD19536KTT
R401, R403, R405, R407: 4.7R gate; R_0805_2012Metric; MPN RC0805FR-074R7L
R402, R404, R406, R408: 47k G-S; R_0805_2012Metric; MPN RC0805FR-0747KL
RS401: 0.5mR 1% Kelvin; MPN CSS4J-4026R-L500F

Connections:
GHC: R401.1, R403.1
GHC_1: Q401.1 (G), R401.2, R402.1
GHC_2: Q402.1 (G), R403.2, R404.1
GLC: R405.1, R407.1
GLC_1: Q403.1 (G), R405.2, R406.1
GLC_2: Q404.1 (G), R407.2, R408.1
GND: C401.2, RS401.2 (I-)
IS_C_N: RS401.4 (S-)
IS_C_P: RS401.3 (S+)
PH_C: Q401.3 (S), Q402.3 (S), Q403.2 (D), Q404.2 (D), R402.2, R404.2
SHUNT_C_P: Q403.3 (S), Q404.3 (S), R406.2, R408.2, RS401.1 (I+)
VBUS: C401.1, Q401.2 (D), Q402.2 (D)

Notes on the sheet:
Faz C / paralel MOSFET yarım köprüsü
ESC-3K | 02_PHASE_C | A2 | TASARIM INCELEMESI
TASARIM NOTLARI / KABUL KRITERLERI
1. 100 V CSD19536KTT; her anahtarda iki paralel MOSFET. Üç faz toplam 12 MOSFET.
2. Kalın hatlar güç yolunu gösterir. Her MOSFET kendi 4.7 ohm kapı direncine sahiptir.
3. 4.7 ohm başlangıç değeridir. VGS, VDS taşması ve açma/kapama kaybıyla ayarlanır.
4. Kelvin sense uçları sadece sürücü ölçüm girişlerine gider. Güç akımı sense izi üzerinden geçirilmez.
5. 0.5 mohm: 80 A sürekli varsayımında I²R=3.2 W üst sınır hesabı. Gerçek şönt RMS akımı PWM ile değişir.
6. PCB: paralel kollar simetrik; ortak kaynak endüktansı azaltılır. Tab pin2=Drain. Soğutucu izolasyonu ayrıca tasarlanır.
7. AÇIK R03: şönt pad yönü/termal. AÇIK R04: double-pulse ve kısa devre koruma süresi.
