mekiciepcas/ESC-Ai/ESC_V2/hardware_a2/03_DRIVER.kicad_sch

## KiCad design ESC_V2/hardware_a2/03_DRIVER.kicad_sch (2026-09-18)

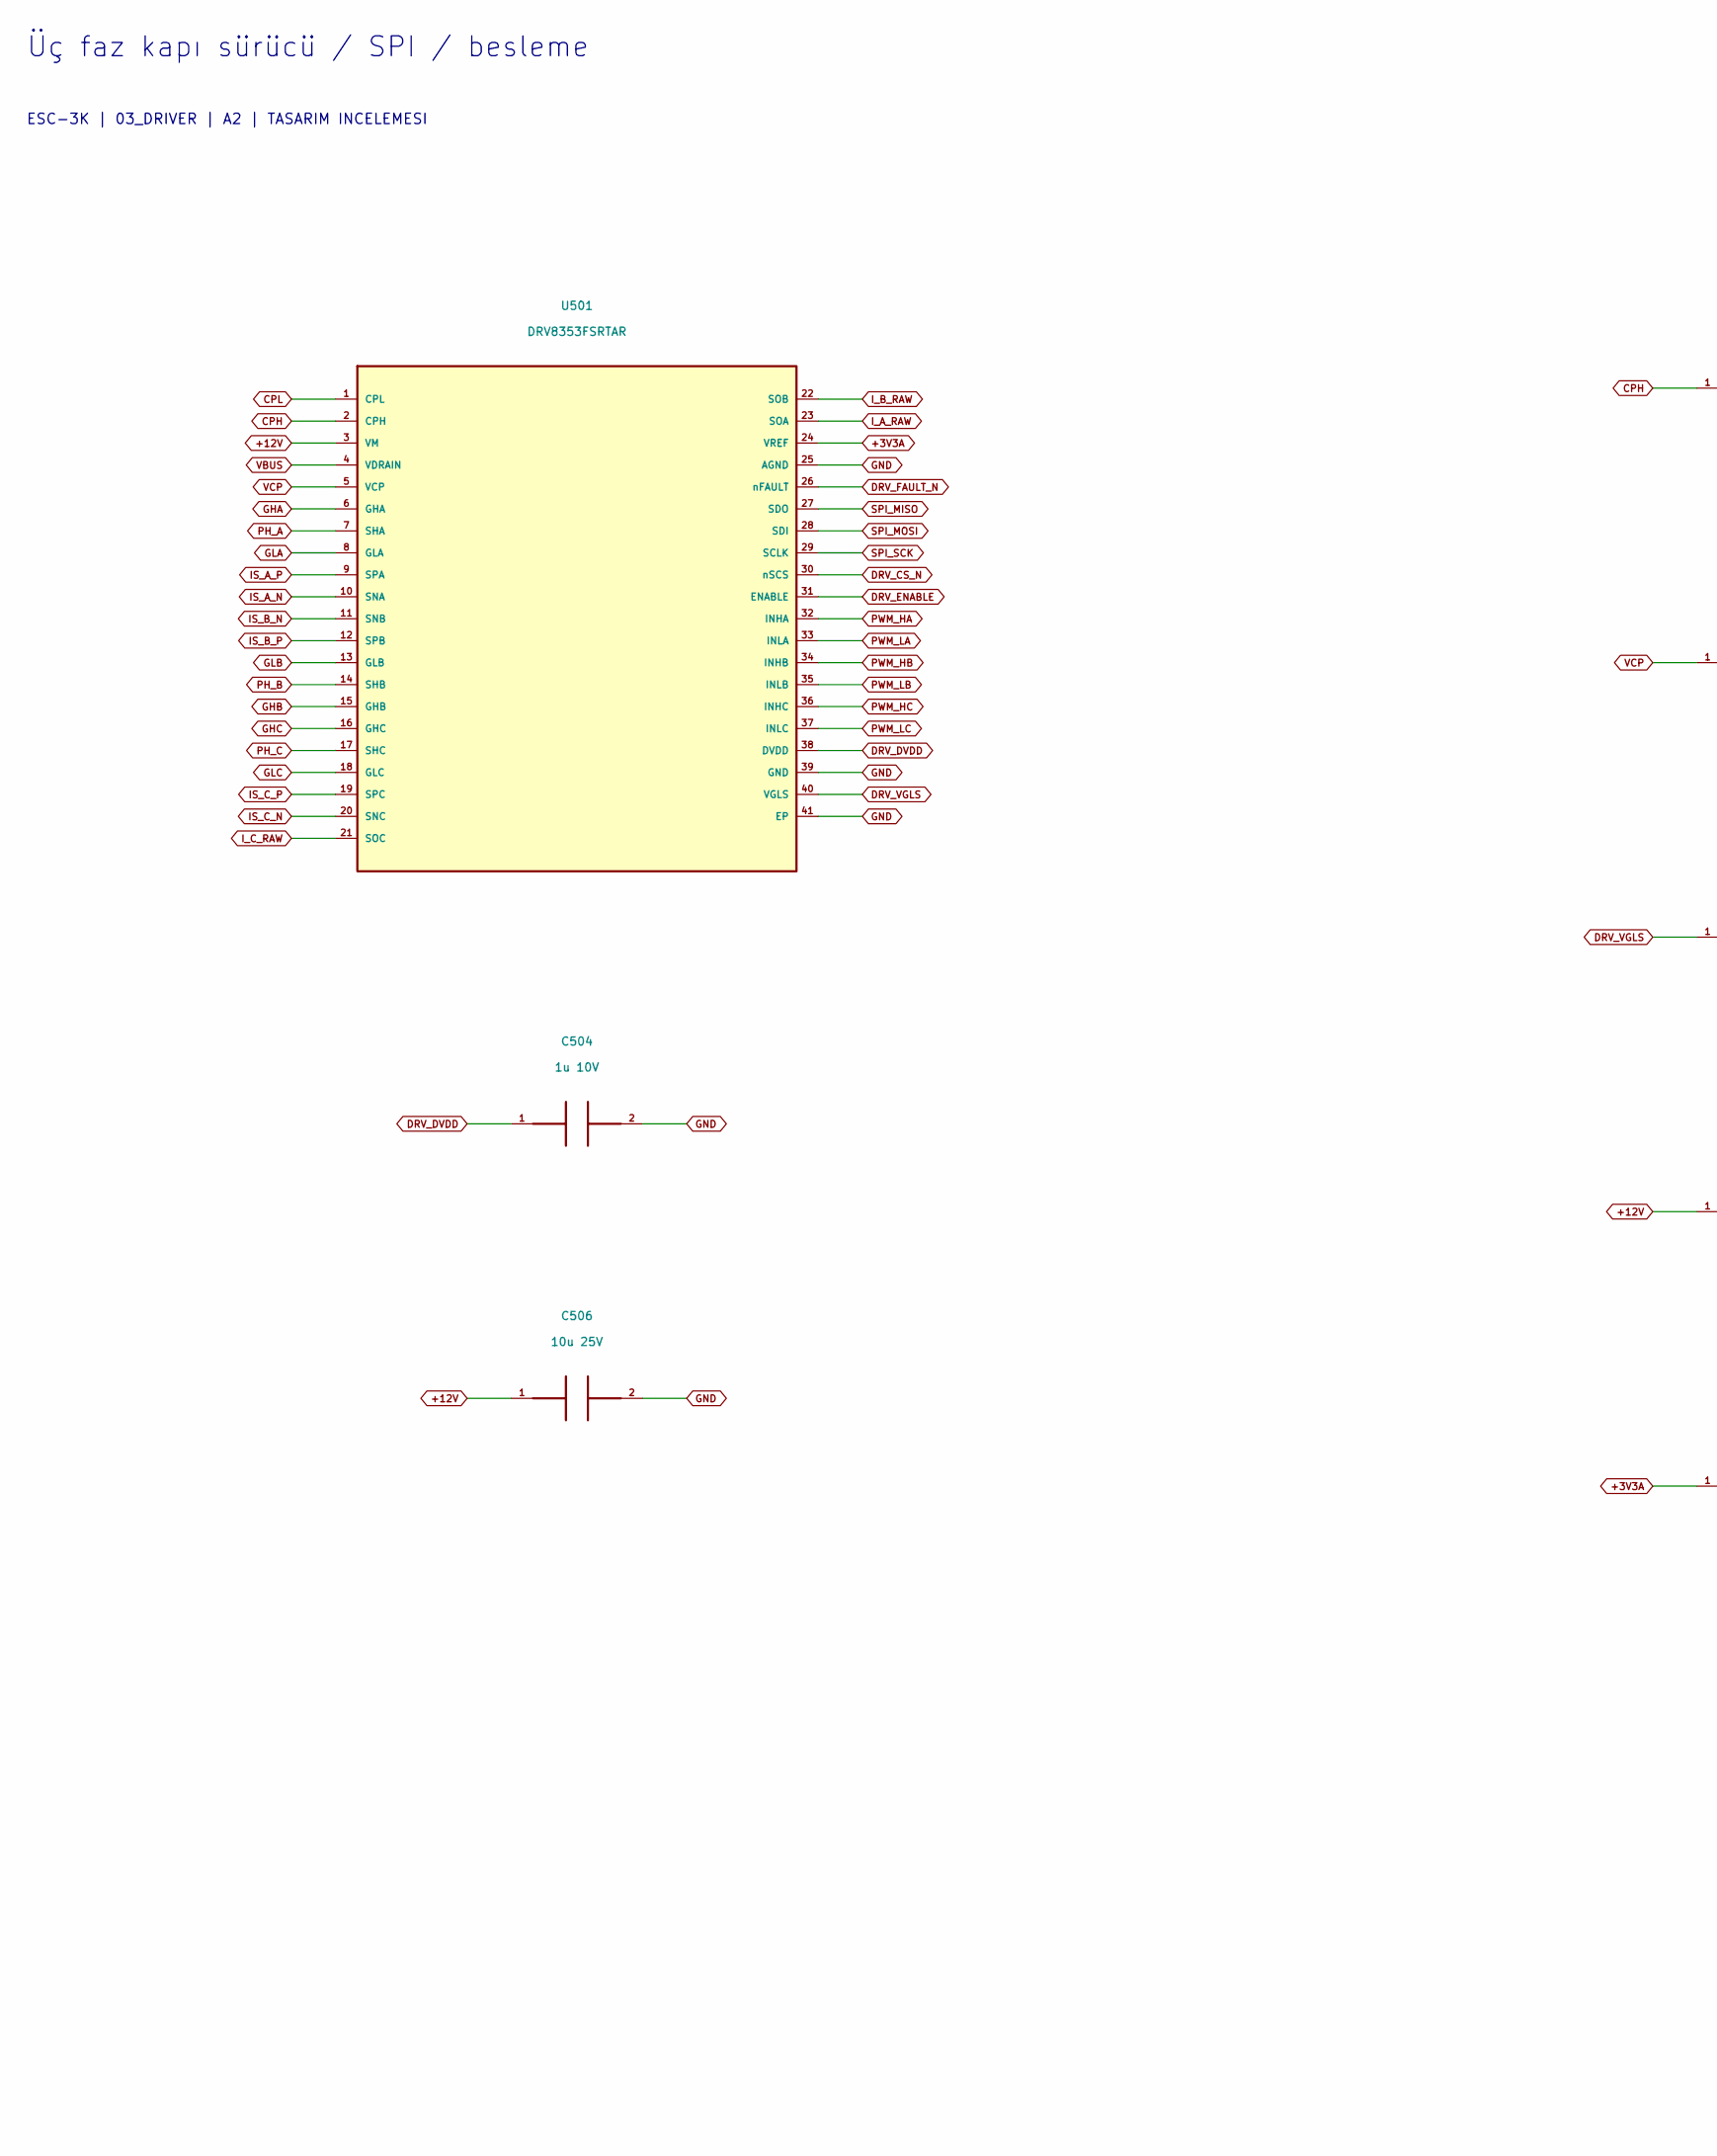
[picture p123: schematic 03_DRIVER.kicad_sch, part in row 1, column 1]

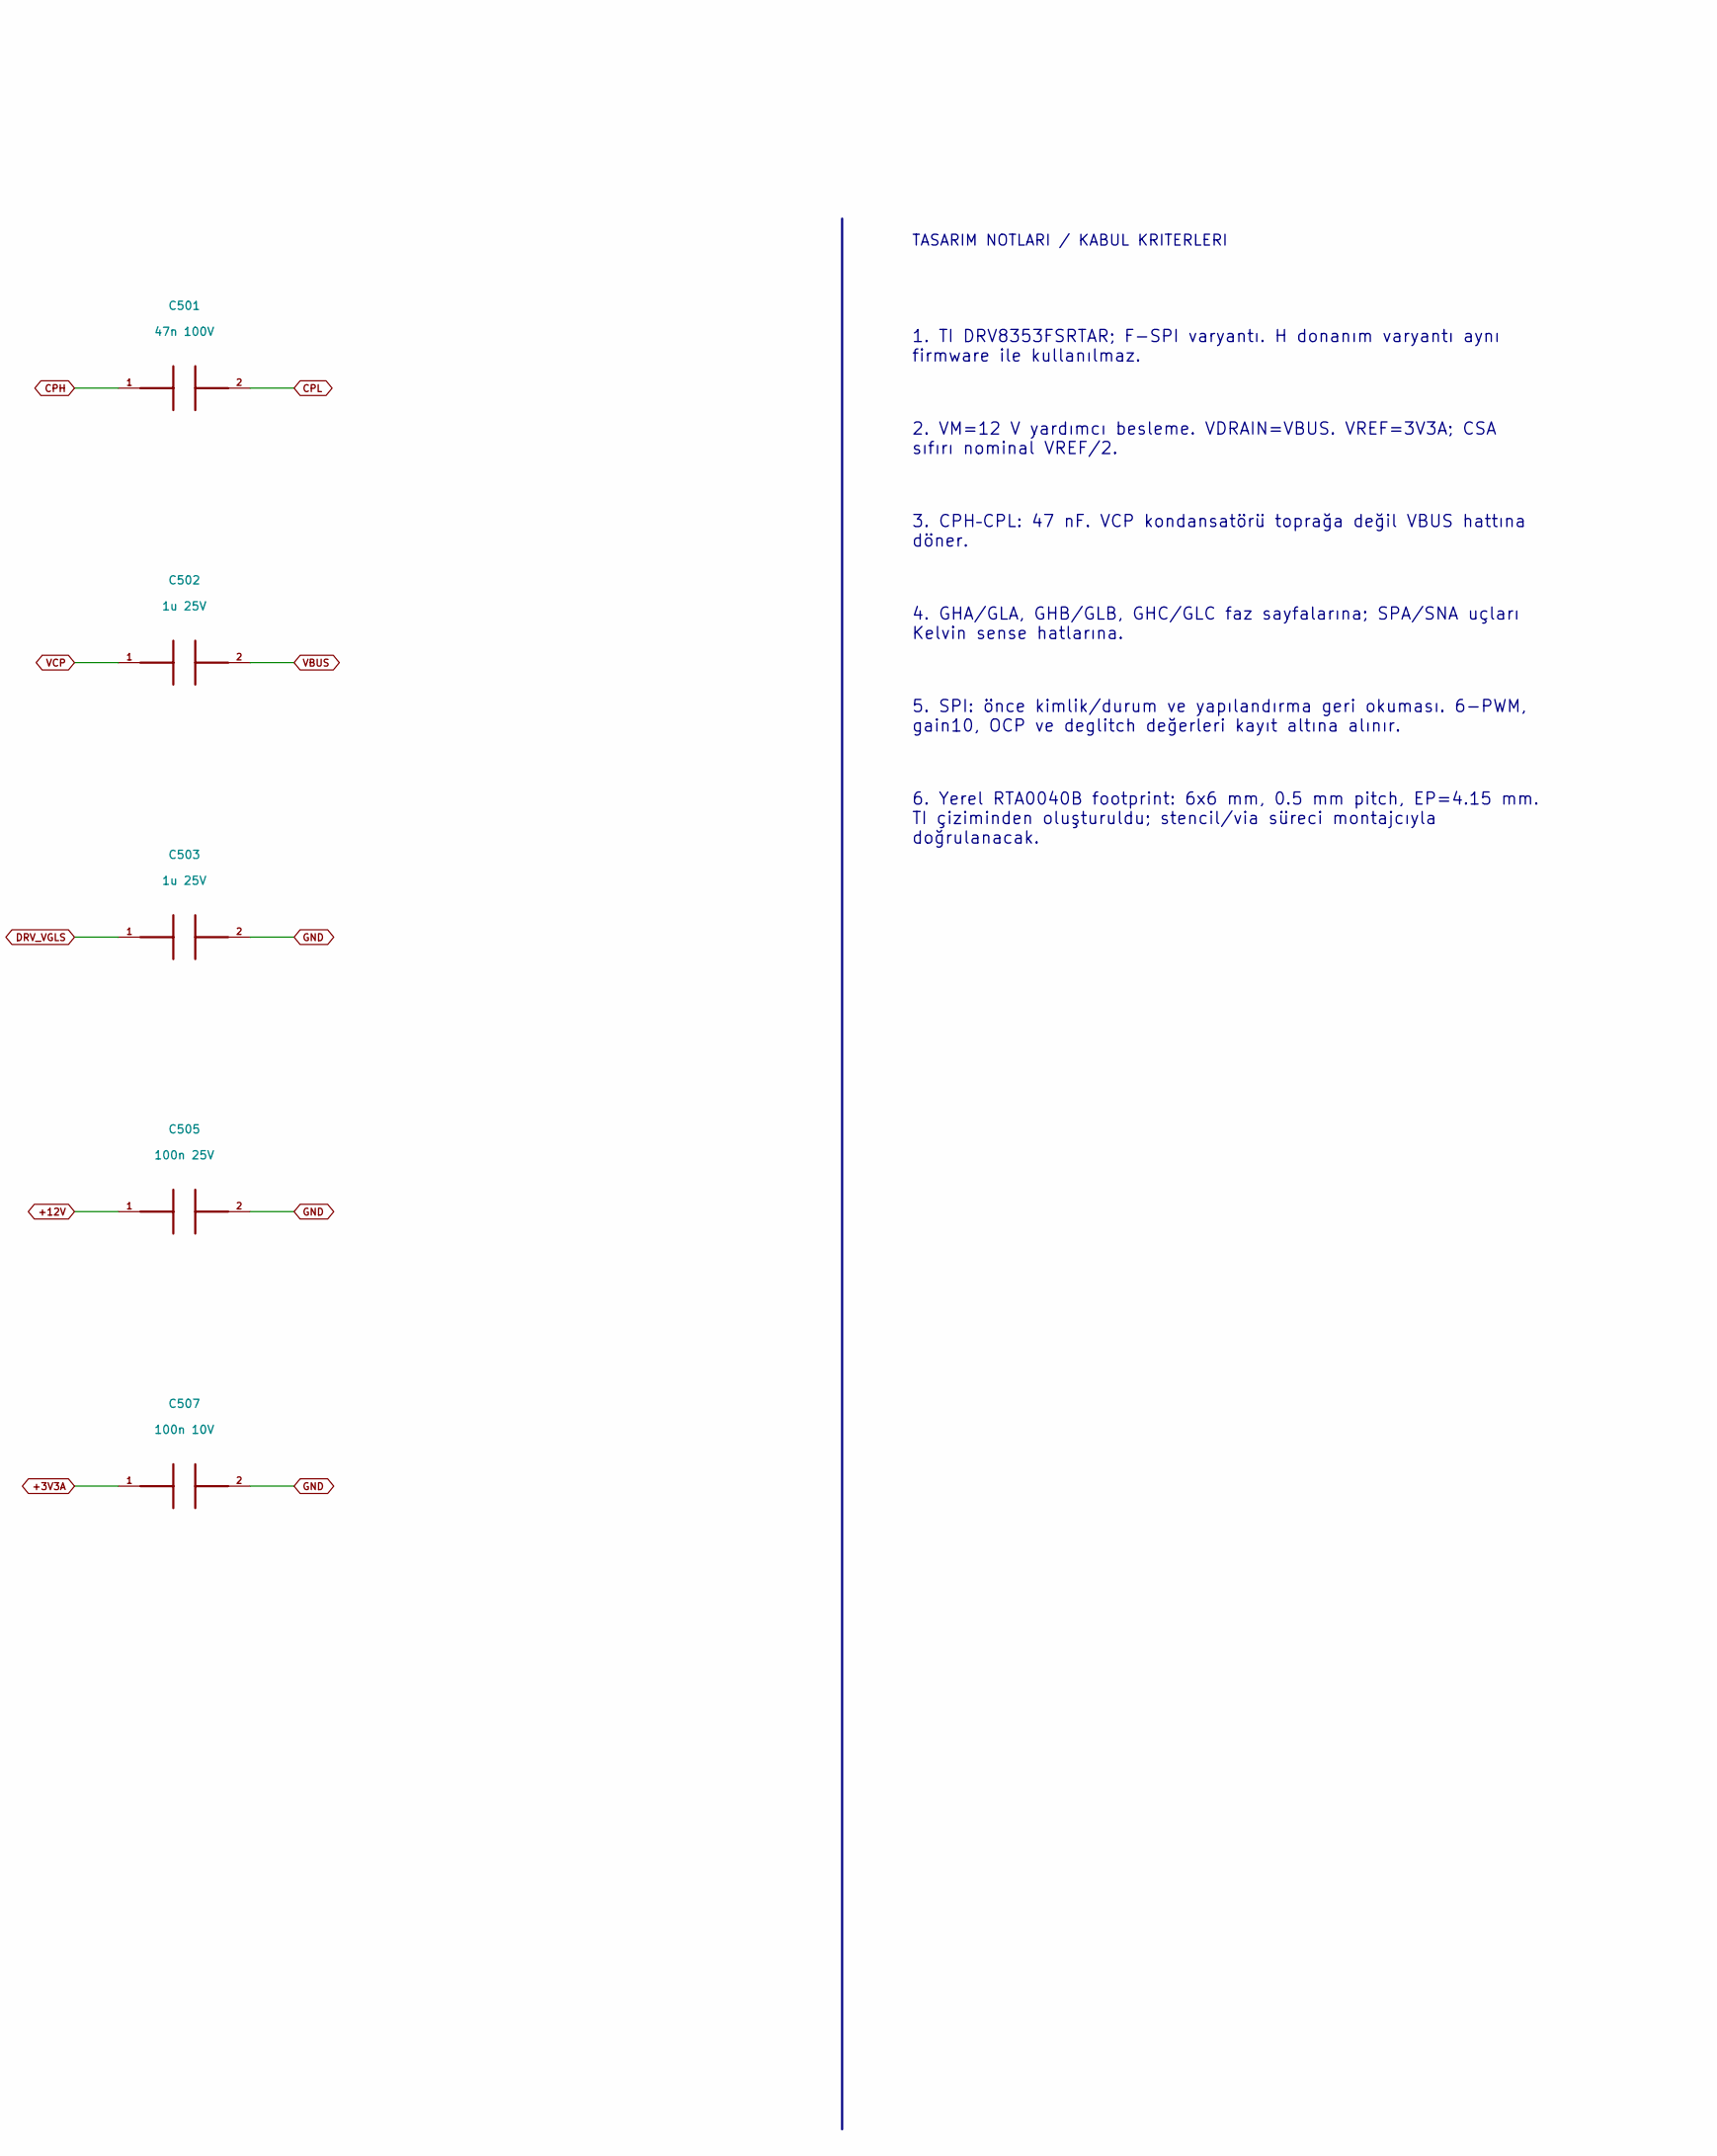
[picture p124: schematic 03_DRIVER.kicad_sch, part in row 1, column 2]

Parts:
C501: 47n 100V
C502, C503: 1u 25V; C_0805_2012Metric
C504: 1u 10V; C_0805_2012Metric
C505: 100n 25V; C_0805_2012Metric; MPN C2012X7R2A104K125AA
C506: 10u 25V
C507: 100n 10V; C_0805_2012Metric; MPN C2012X7R2A104K125AA
U501: DRV8353FSRTAR; TI_RTA0040B_6x6_P0.5_EP4.15; MPN DRV8353FSRTAR

Connections:
+3V3A: C507.1, U501.24 (VREF)
+12V: C505.1, C506.1, U501.3 (VM)
CPH: C501.1, U501.2 (CPH)
CPL: C501.2, U501.1 (CPL)
DRV_CS_N: U501.30 (nSCS)
DRV_DVDD: C504.1, U501.38 (DVDD)
DRV_ENABLE: U501.31 (ENABLE)
DRV_FAULT_N: U501.26 (nFAULT)
DRV_VGLS: C503.1, U501.40 (VGLS)
GHA: U501.6 (GHA)
GHB: U501.15 (GHB)
GHC: U501.16 (GHC)
GLA: U501.8 (GLA)
GLB: U501.13 (GLB)
GLC: U501.18 (GLC)
GND: C503.2, C504.2, C505.2, C506.2, C507.2, U501.25 (AGND), U501.39 (GND), U501.41 (EP)
IS_A_N: U501.10 (SNA)
IS_A_P: U501.9 (SPA)
IS_B_N: U501.11 (SNB)
IS_B_P: U501.12 (SPB)
IS_C_N: U501.20 (SNC)
IS_C_P: U501.19 (SPC)
I_A_RAW: U501.23 (SOA)
I_B_RAW: U501.22 (SOB)
I_C_RAW: U501.21 (SOC)
PH_A: U501.7 (SHA)
PH_B: U501.14 (SHB)
PH_C: U501.17 (SHC)
PWM_HA: U501.32 (INHA)
PWM_HB: U501.34 (INHB)
PWM_HC: U501.36 (INHC)
PWM_LA: U501.33 (INLA)
PWM_LB: U501.35 (INLB)
PWM_LC: U501.37 (INLC)
SPI_MISO: U501.27 (SDO)
SPI_MOSI: U501.28 (SDI)
SPI_SCK: U501.29 (SCLK)
VBUS: C502.2, U501.4 (VDRAIN)
VCP: C502.1, U501.5 (VCP)

Notes on the sheet:
Üç faz kapı sürücü / SPI / besleme
ESC-3K | 03_DRIVER | A2 | TASARIM INCELEMESI
TASARIM NOTLARI / KABUL KRITERLERI
1. TI DRV8353FSRTAR; F-SPI varyantı. H donanım varyantı aynı firmware ile kullanılmaz.
2. VM=12 V yardımcı besleme. VDRAIN=VBUS. VREF=3V3A; CSA sıfırı nominal VREF/2.
3. CPH–CPL: 47 nF. VCP kondansatörü toprağa değil VBUS hattına döner.
4. GHA/GLA, GHB/GLB, GHC/GLC faz sayfalarına; SPA/SNA uçları Kelvin sense hatlarına.
5. SPI: önce kimlik/durum ve yapılandırma geri okuması. 6-PWM, gain10, OCP ve deglitch değerleri kayıt altına alınır.
6. Yerel RTA0040B footprint: 6x6 mm, 0.5 mm pitch, EP=4.15 mm. TI çiziminden oluşturuldu; stencil/via süreci montajcıyla doğrulanacak.
