mekiciepcas/ESC-Ai/ESC_V2/hardware_a2/04_DRIVER_DEFAULTS.kicad_sch

## KiCad design ESC_V2/hardware_a2/04_DRIVER_DEFAULTS.kicad_sch (2026-09-18)

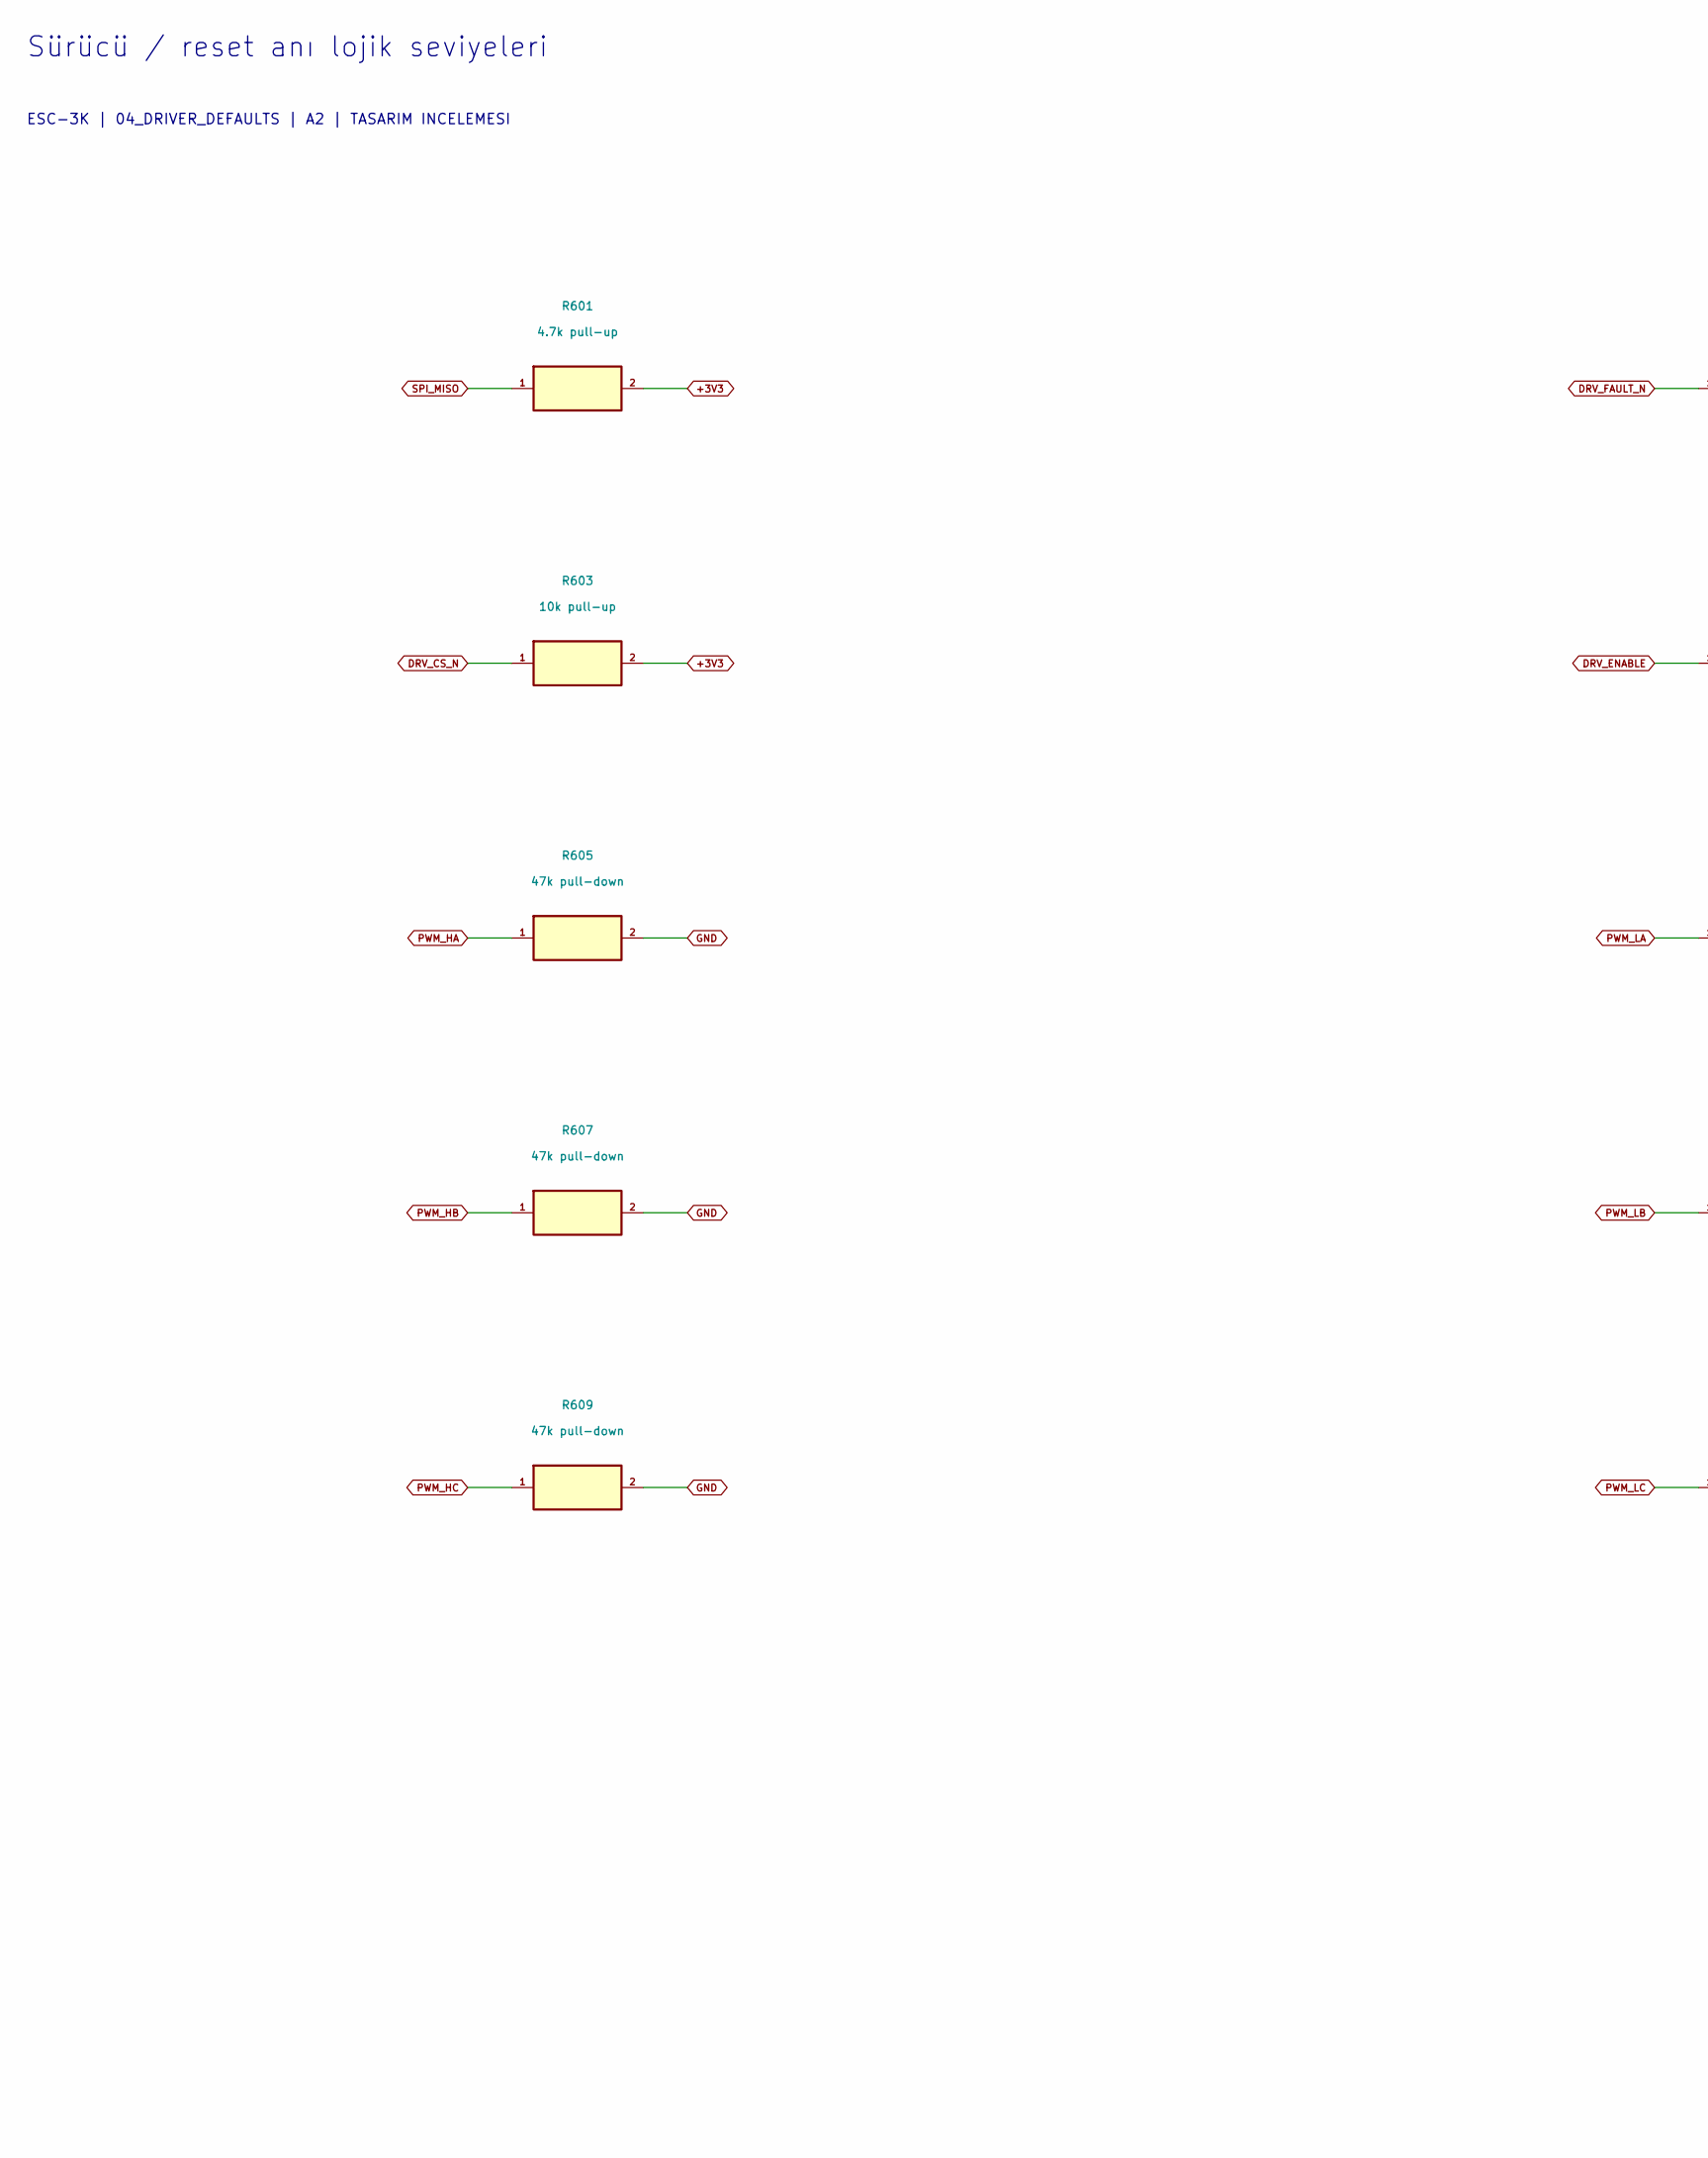
[picture p125: schematic 04_DRIVER_DEFAULTS.kicad_sch, part in row 1, column 1]

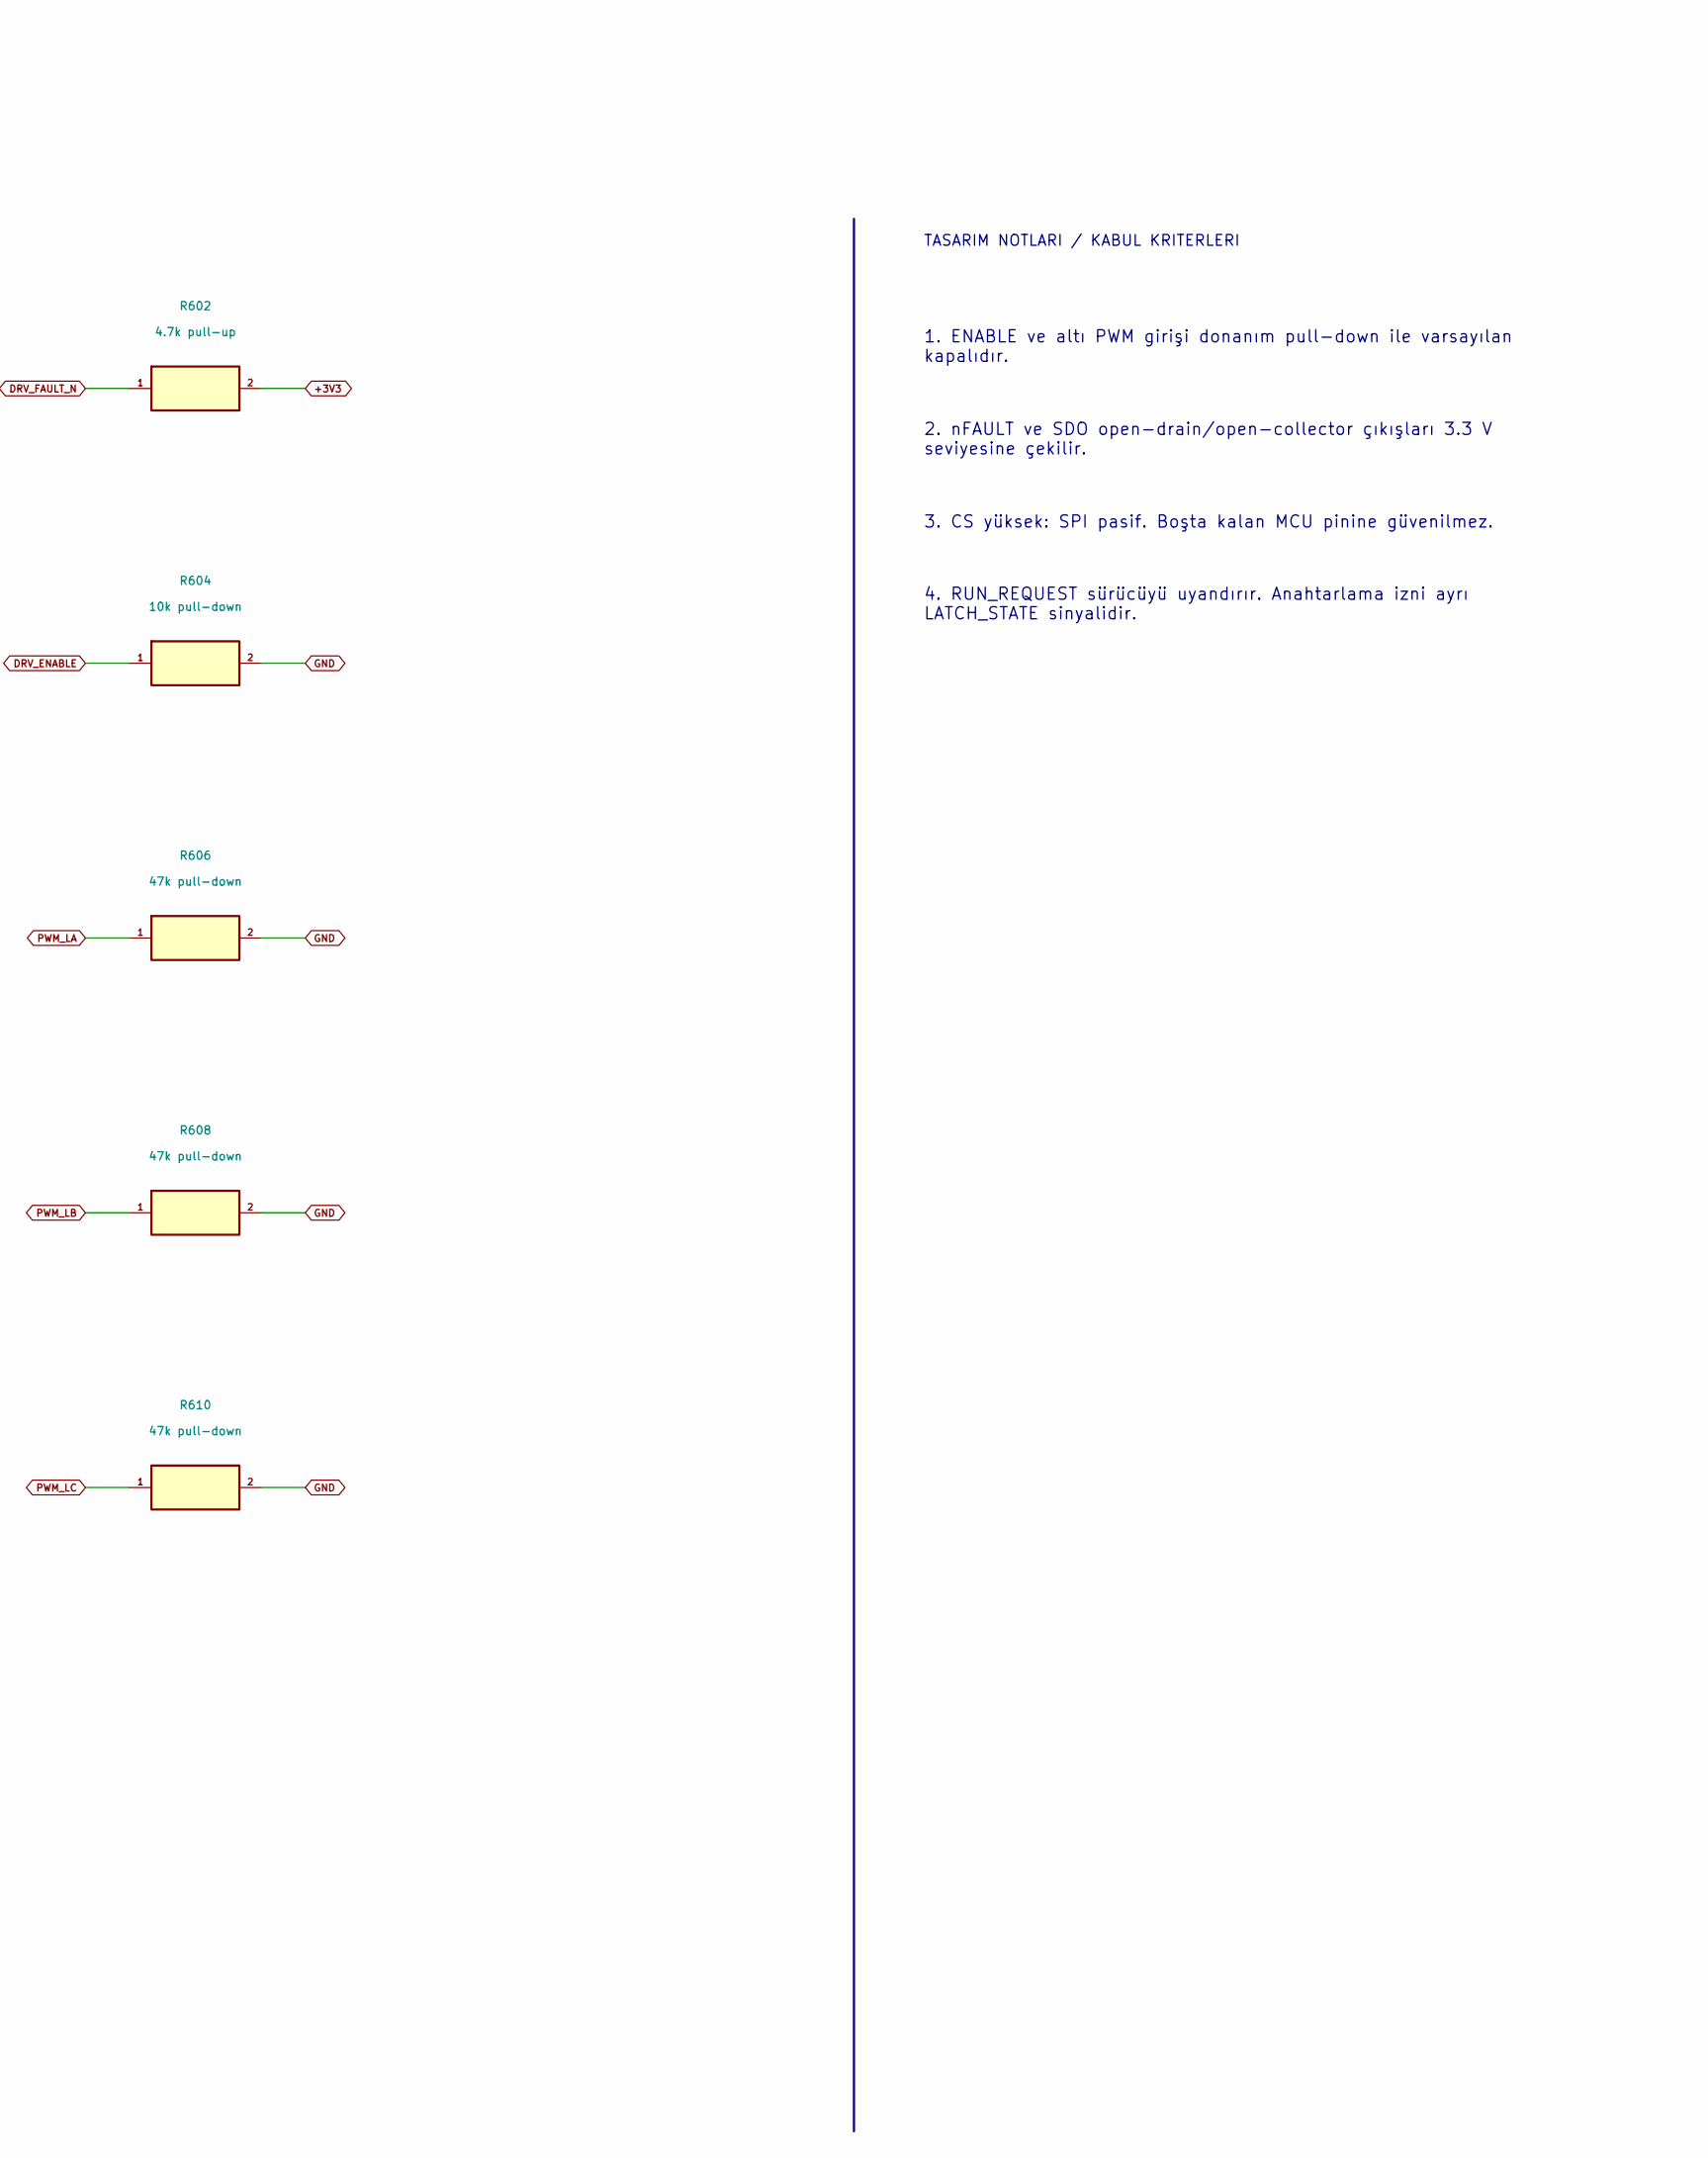
[picture p126: schematic 04_DRIVER_DEFAULTS.kicad_sch, part in row 1, column 2]

Parts:
R601, R602: 4.7k pull-up; R_0805_2012Metric; MPN RC0805FR-074K7L
R603: 10k pull-up; R_0805_2012Metric; MPN RC0805FR-0710KL
R604: 10k pull-down; R_0805_2012Metric; MPN RC0805FR-0710KL
R605, R606, R607, R608, R609, R610: 47k pull-down; R_0805_2012Metric; MPN RC0805FR-0747KL

Connections:
+3V3: R601.2, R602.2, R603.2
DRV_CS_N: R603.1
DRV_ENABLE: R604.1
DRV_FAULT_N: R602.1
GND: R604.2, R605.2, R606.2, R607.2, R608.2, R609.2, R610.2
PWM_HA: R605.1
PWM_HB: R607.1
PWM_HC: R609.1
PWM_LA: R606.1
PWM_LB: R608.1
PWM_LC: R610.1
SPI_MISO: R601.1

Notes on the sheet:
Sürücü / reset anı lojik seviyeleri
ESC-3K | 04_DRIVER_DEFAULTS | A2 | TASARIM INCELEMESI
TASARIM NOTLARI / KABUL KRITERLERI
1. ENABLE ve altı PWM girişi donanım pull-down ile varsayılan kapalıdır.
2. nFAULT ve SDO open-drain/open-collector çıkışları 3.3 V seviyesine çekilir.
3. CS yüksek: SPI pasif. Boşta kalan MCU pinine güvenilmez.
4. RUN_REQUEST sürücüyü uyandırır. Anahtarlama izni ayrı LATCH_STATE sinyalidir.
