mekiciepcas/ESC-Ai/ESC_V2/hardware_a2/05_SENSE_B.kicad_sch

## KiCad design ESC_V2/hardware_a2/05_SENSE_B.kicad_sch (2026-09-18)

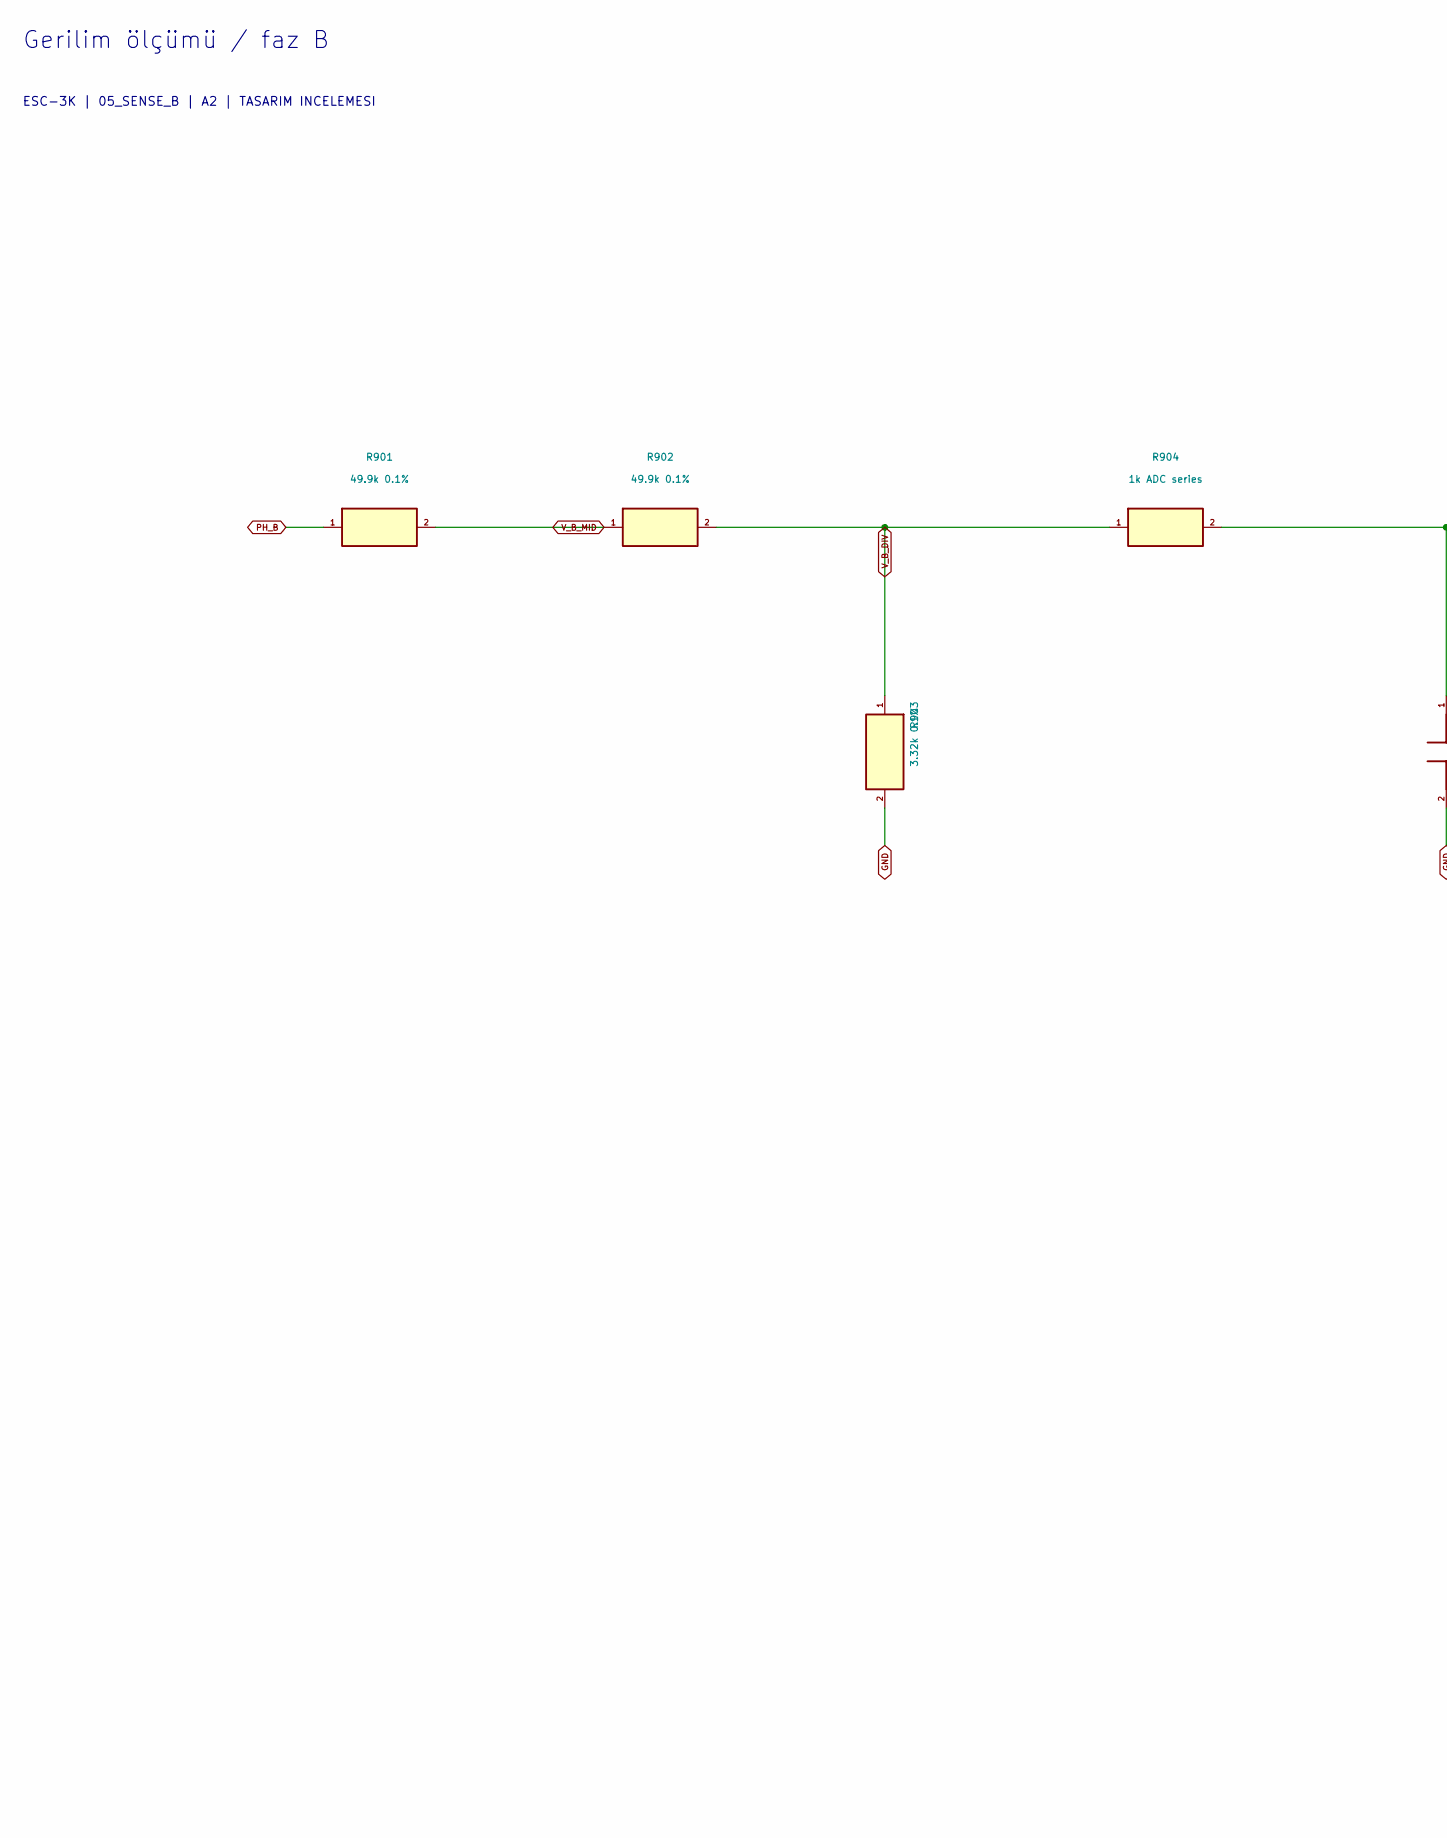
[picture p129: schematic 05_SENSE_B.kicad_sch, part in row 1, column 1]

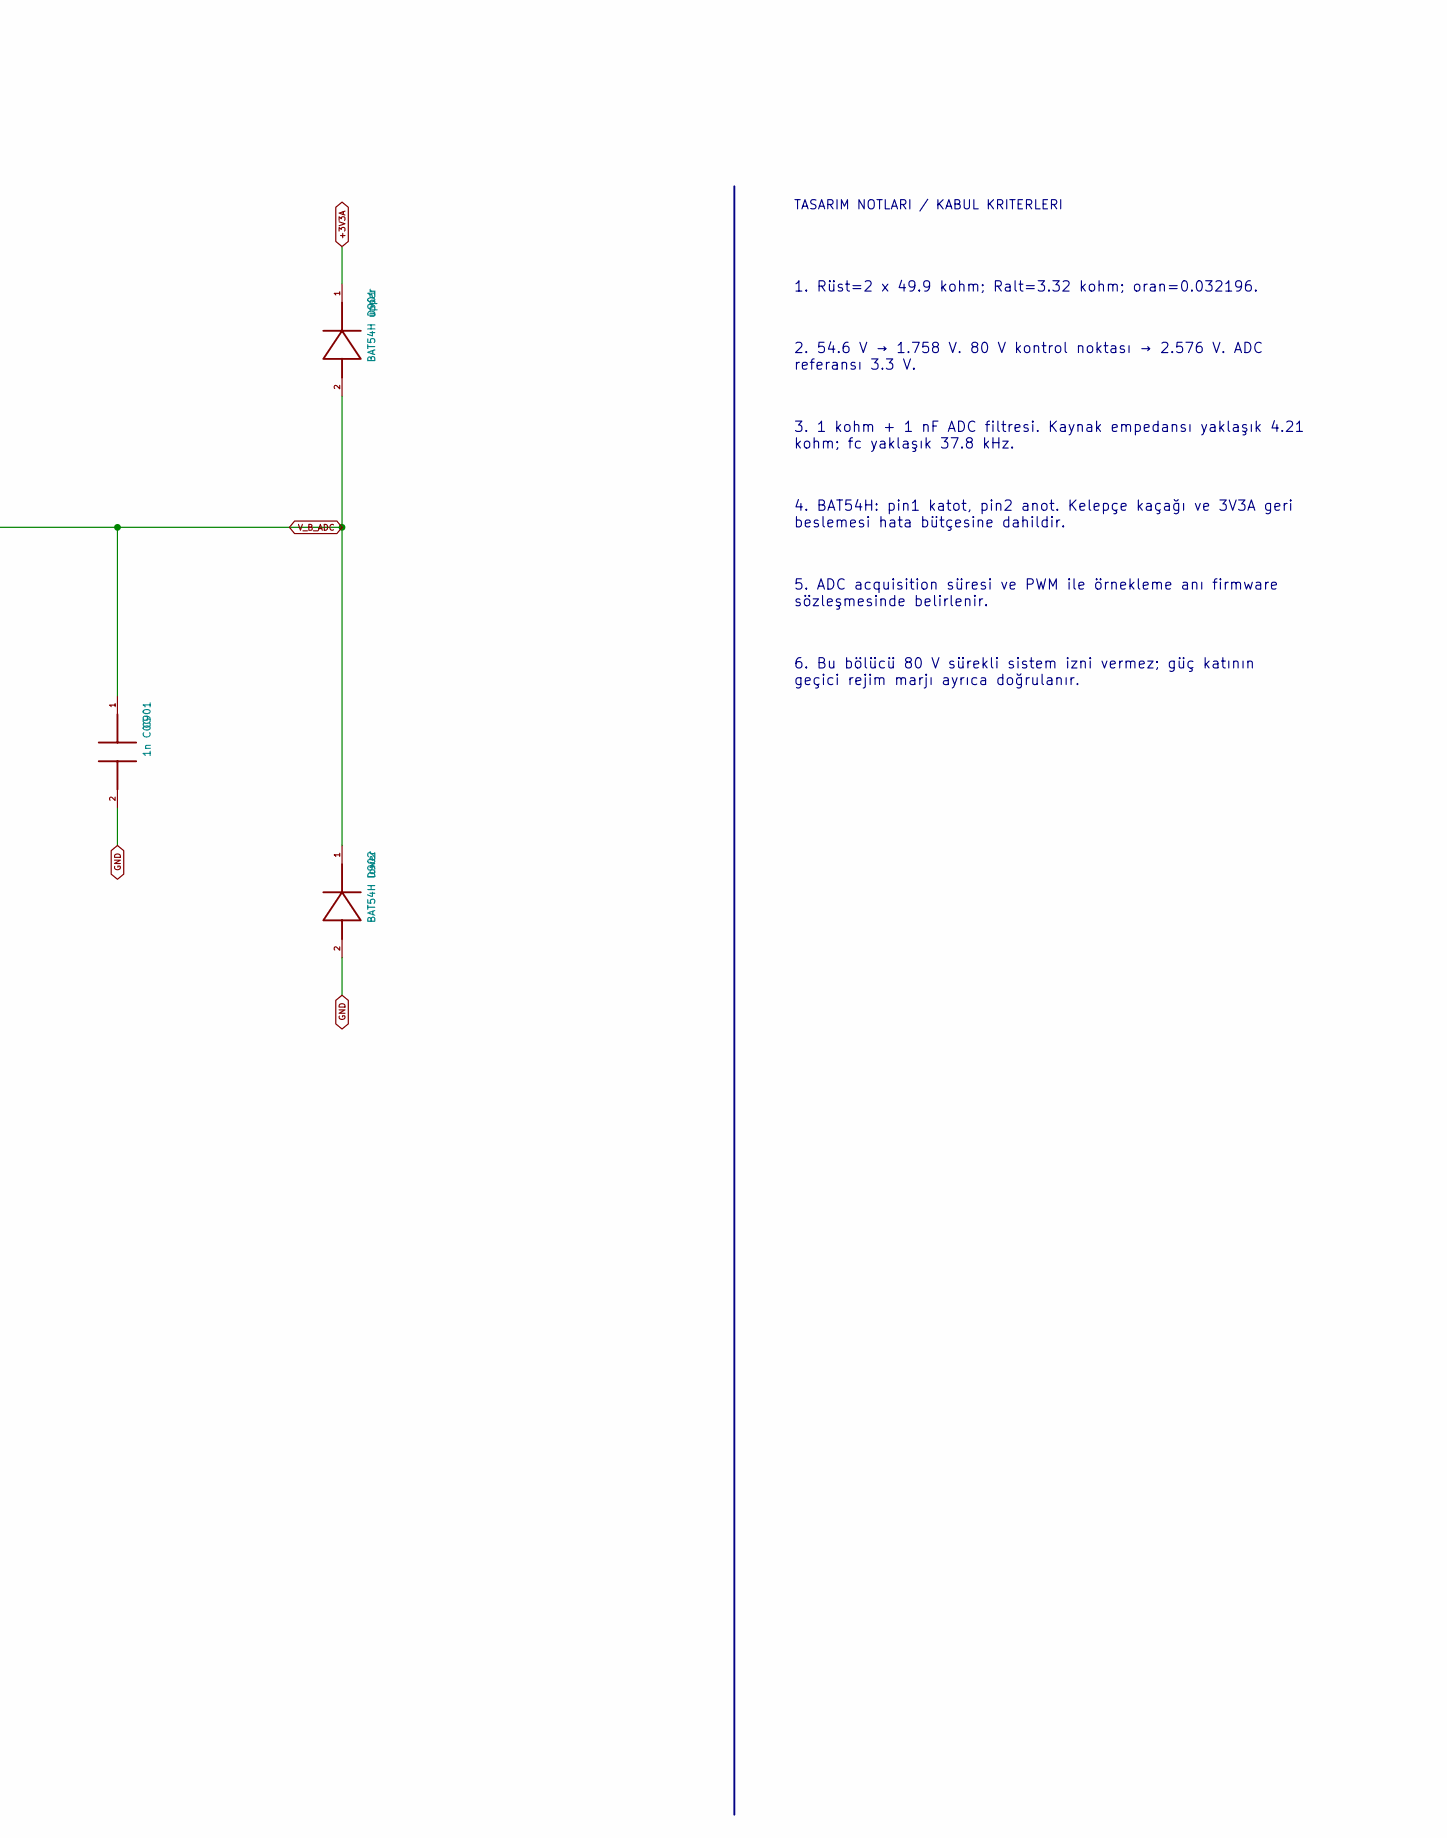
[picture p130: schematic 05_SENSE_B.kicad_sch, part in row 1, column 2]

Parts:
C901: 1n C0G; C_0805_2012Metric
D901: BAT54H upper; D_SOD-123F; MPN BAT54H,115
D902: BAT54H lower; D_SOD-123F; MPN BAT54H,115
R901, R902: 49.9k 0.1%; R_0805_2012Metric; MPN RT0805BRD0749K9L
R903: 3.32k 0.1%; R_0805_2012Metric; MPN RT0805BRD073K32L
R904: 1k ADC series; R_0805_2012Metric; MPN RC0805FR-071KL

Connections:
+3V3A: D901.1 (K)
GND: C901.2, D902.2 (A), R903.2
PH_B: R901.1
V_B_ADC: C901.1, D901.2 (A), D902.1 (K), R904.2
V_B_DIV: R902.2, R903.1, R904.1
V_B_MID: R901.2, R902.1

Notes on the sheet:
Gerilim ölçümü / faz B
ESC-3K | 05_SENSE_B | A2 | TASARIM INCELEMESI
TASARIM NOTLARI / KABUL KRITERLERI
1. Rüst=2 x 49.9 kohm; Ralt=3.32 kohm; oran=0.032196.
2. 54.6 V → 1.758 V. 80 V kontrol noktası → 2.576 V. ADC referansı 3.3 V.
3. 1 kohm + 1 nF ADC filtresi. Kaynak empedansı yaklaşık 4.21 kohm; fc yaklaşık 37.8 kHz.
4. BAT54H: pin1 katot, pin2 anot. Kelepçe kaçağı ve 3V3A geri beslemesi hata bütçesine dahildir.
5. ADC acquisition süresi ve PWM ile örnekleme anı firmware sözleşmesinde belirlenir.
6. Bu bölücü 80 V sürekli sistem izni vermez; güç katının geçici rejim marjı ayrıca doğrulanır.
