mekiciepcas/ESC-Ai/ESC_V2/hardware_a2/05_SENSE_C.kicad_sch

## KiCad design ESC_V2/hardware_a2/05_SENSE_C.kicad_sch (2026-09-18)

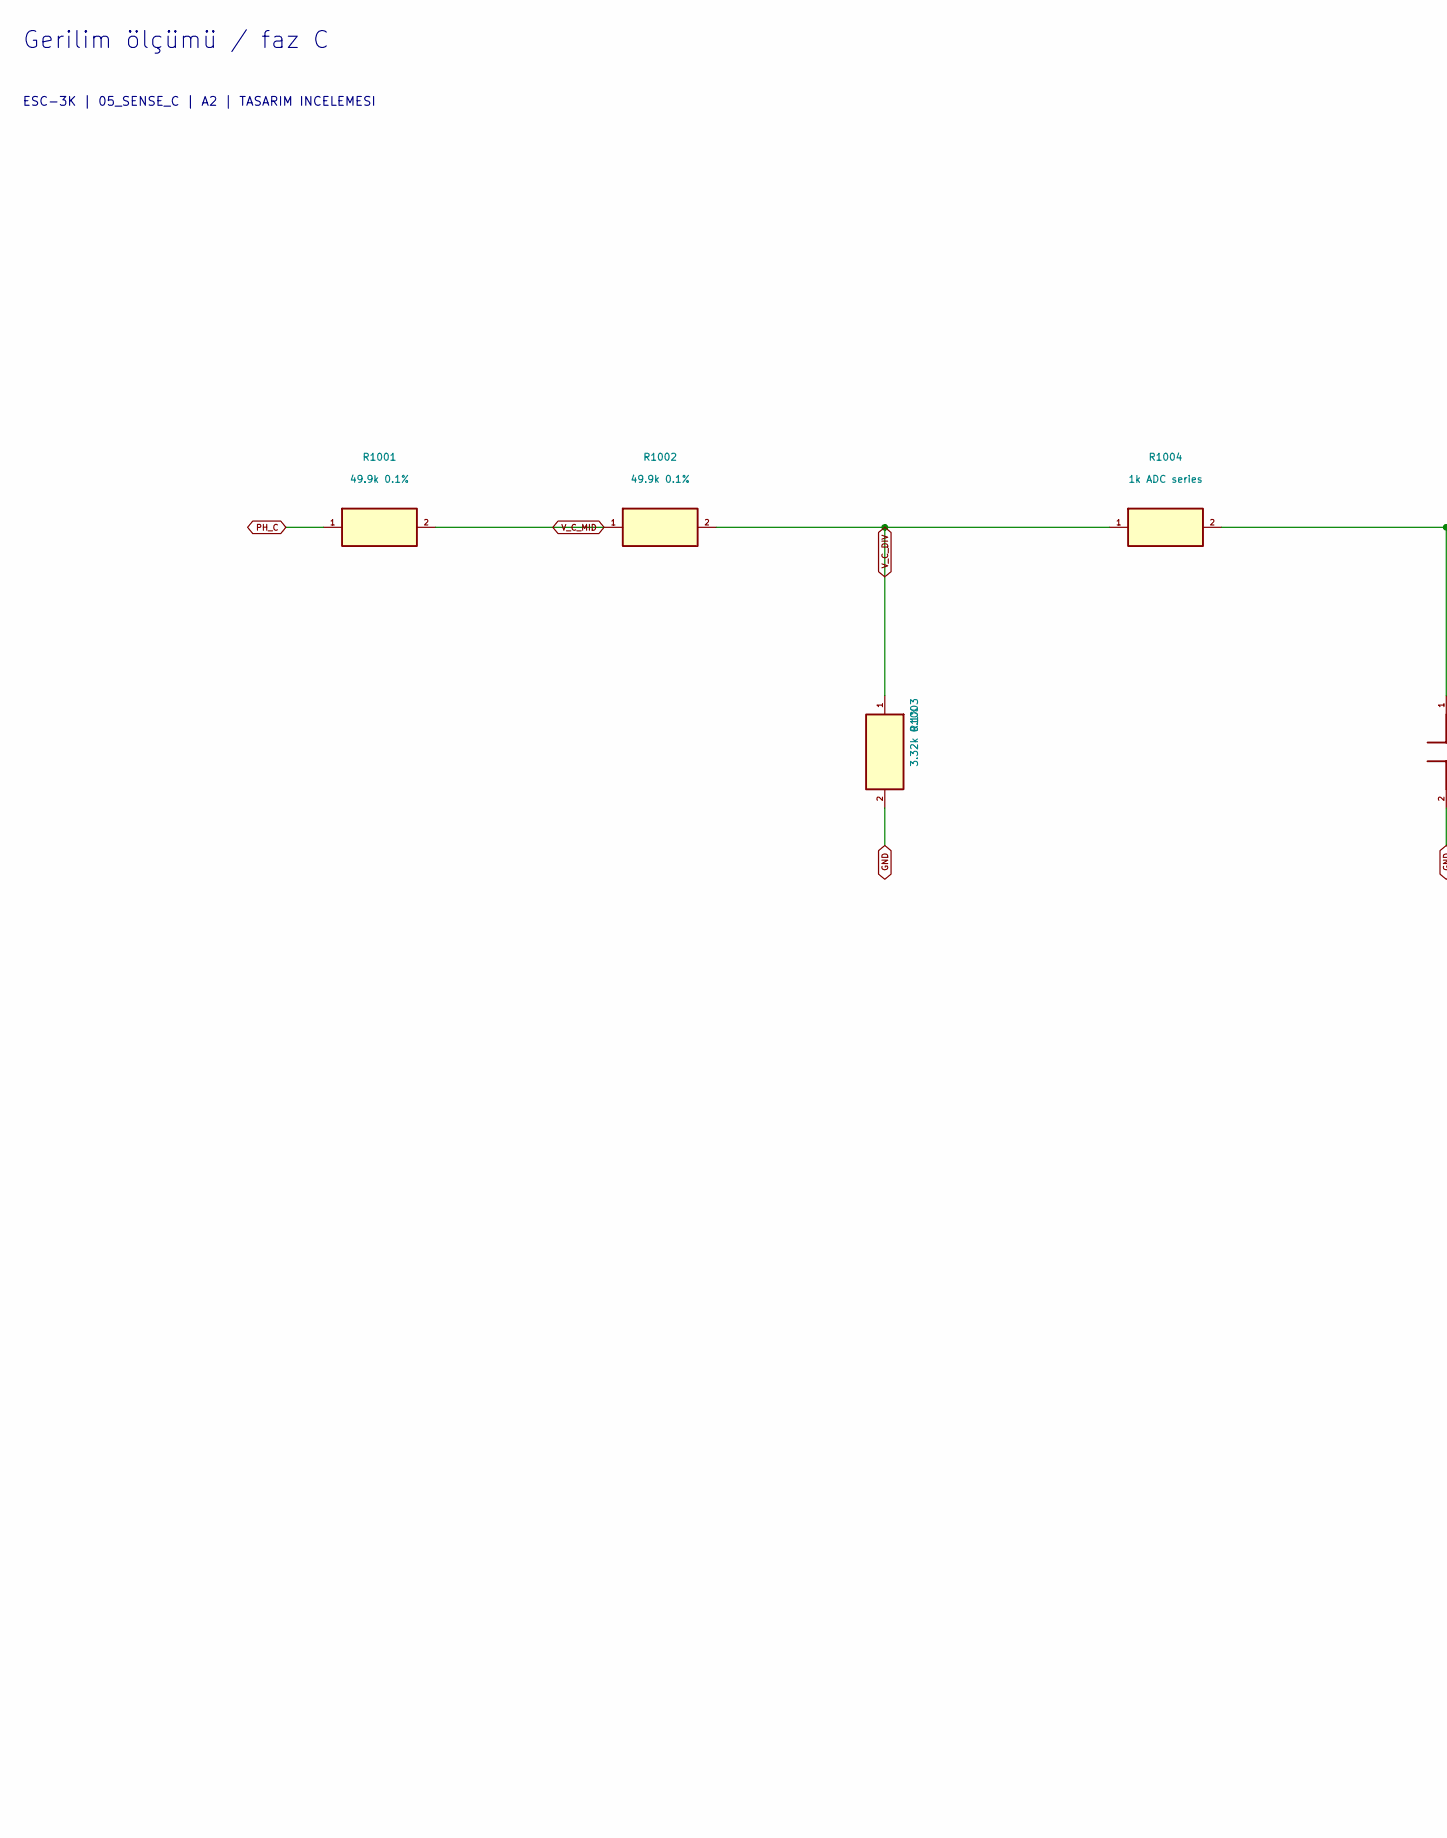
[picture p133: schematic 05_SENSE_C.kicad_sch, part in row 1, column 1]

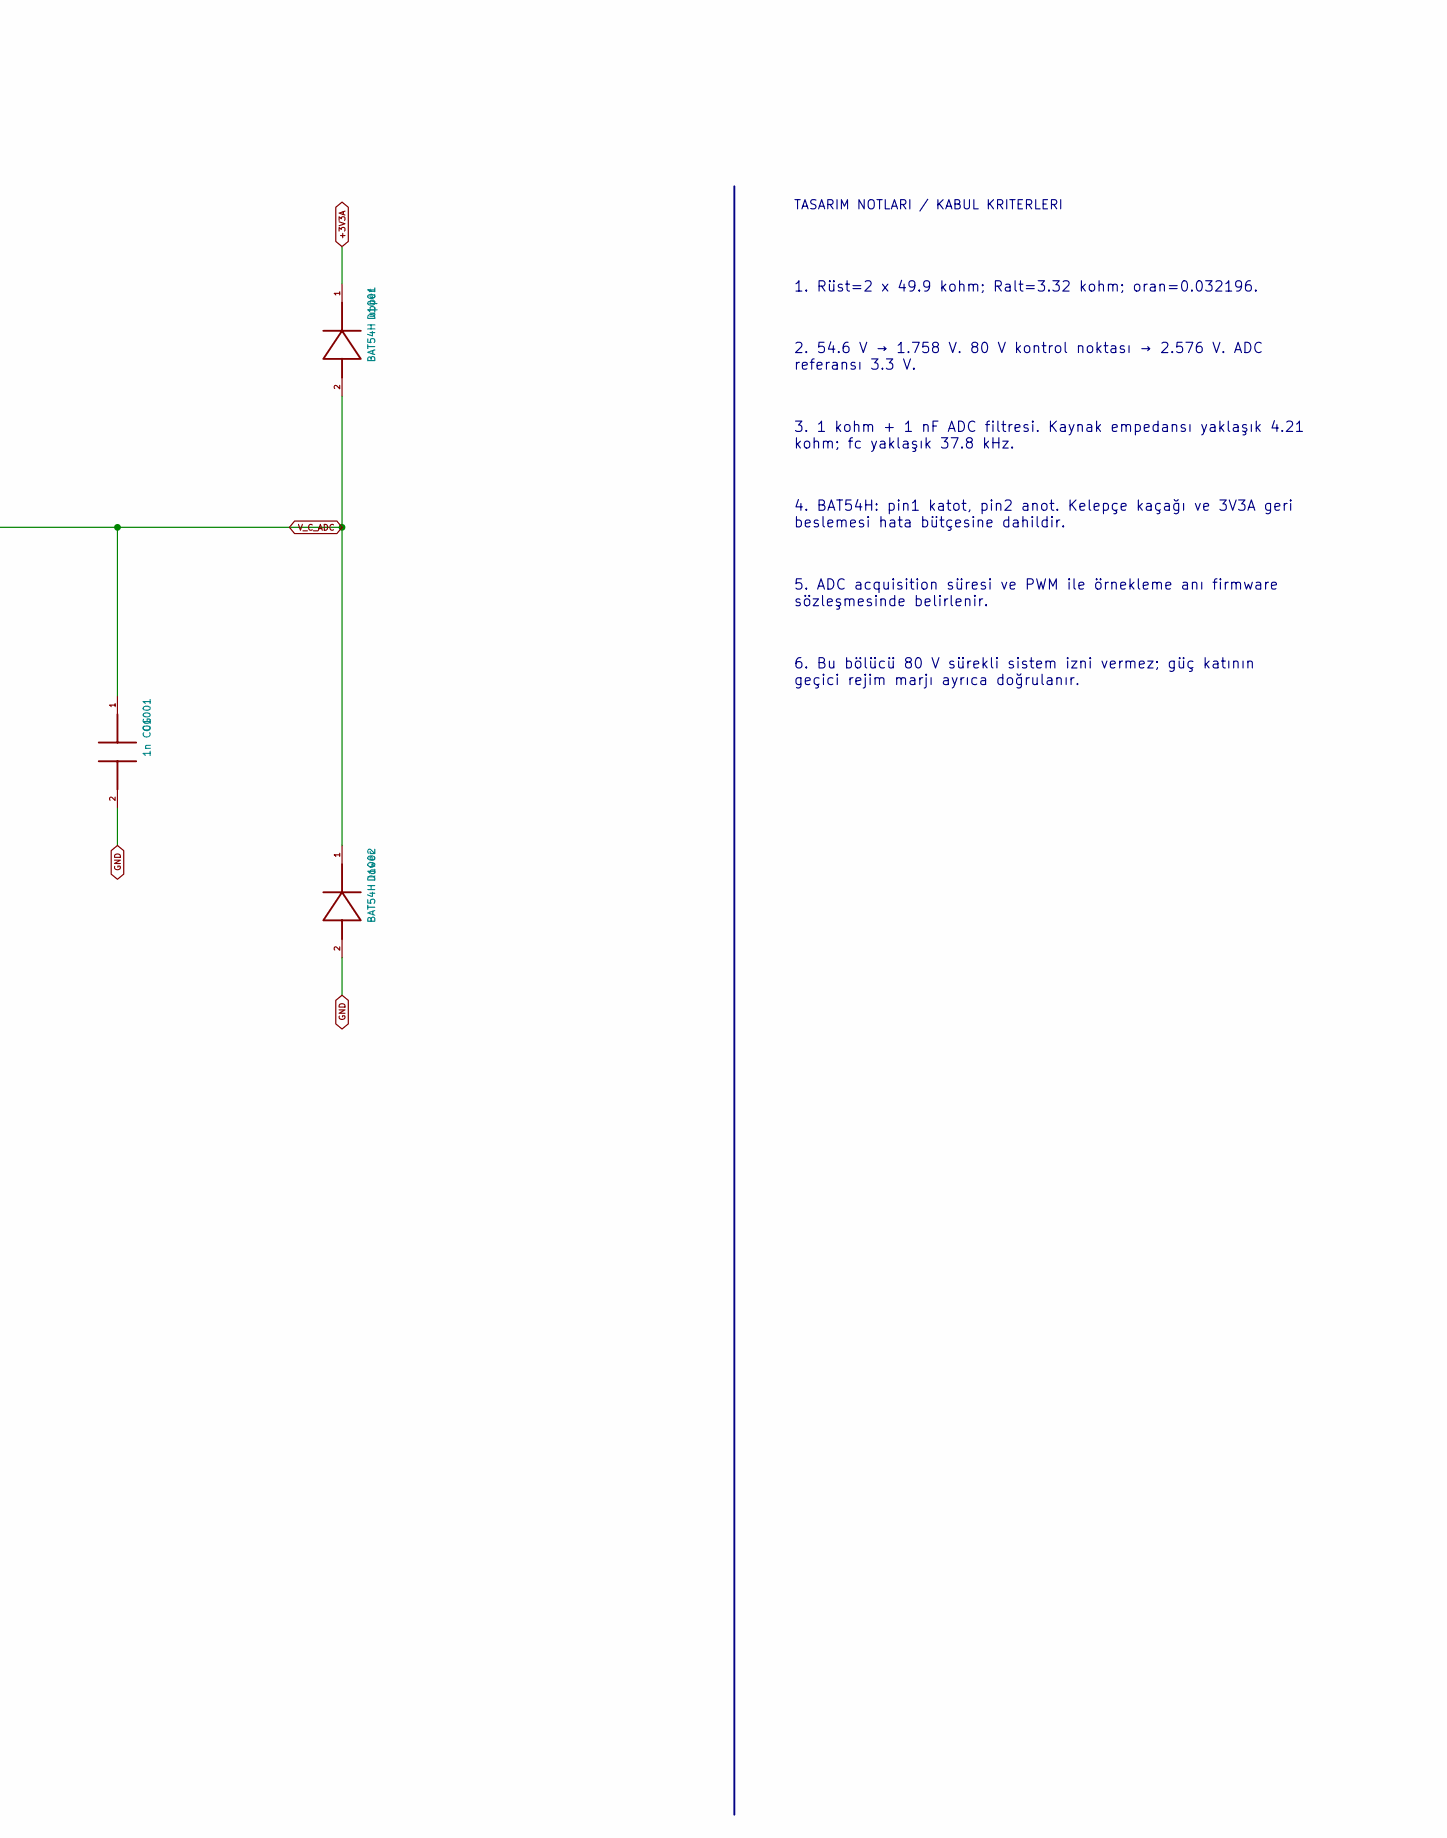
[picture p134: schematic 05_SENSE_C.kicad_sch, part in row 1, column 2]

Parts:
C1001: 1n C0G; C_0805_2012Metric
D1001: BAT54H upper; D_SOD-123F; MPN BAT54H,115
D1002: BAT54H lower; D_SOD-123F; MPN BAT54H,115
R1001, R1002: 49.9k 0.1%; R_0805_2012Metric; MPN RT0805BRD0749K9L
R1003: 3.32k 0.1%; R_0805_2012Metric; MPN RT0805BRD073K32L
R1004: 1k ADC series; R_0805_2012Metric; MPN RC0805FR-071KL

Connections:
+3V3A: D1001.1 (K)
GND: C1001.2, D1002.2 (A), R1003.2
PH_C: R1001.1
V_C_ADC: C1001.1, D1001.2 (A), D1002.1 (K), R1004.2
V_C_DIV: R1002.2, R1003.1, R1004.1
V_C_MID: R1001.2, R1002.1

Notes on the sheet:
Gerilim ölçümü / faz C
ESC-3K | 05_SENSE_C | A2 | TASARIM INCELEMESI
TASARIM NOTLARI / KABUL KRITERLERI
1. Rüst=2 x 49.9 kohm; Ralt=3.32 kohm; oran=0.032196.
2. 54.6 V → 1.758 V. 80 V kontrol noktası → 2.576 V. ADC referansı 3.3 V.
3. 1 kohm + 1 nF ADC filtresi. Kaynak empedansı yaklaşık 4.21 kohm; fc yaklaşık 37.8 kHz.
4. BAT54H: pin1 katot, pin2 anot. Kelepçe kaçağı ve 3V3A geri beslemesi hata bütçesine dahildir.
5. ADC acquisition süresi ve PWM ile örnekleme anı firmware sözleşmesinde belirlenir.
6. Bu bölücü 80 V sürekli sistem izni vermez; güç katının geçici rejim marjı ayrıca doğrulanır.
