mekiciepcas/ESC-Ai/ESC_V2/hardware_a2/06_CURRENT.kicad_sch

## KiCad design ESC_V2/hardware_a2/06_CURRENT.kicad_sch (2026-09-18)

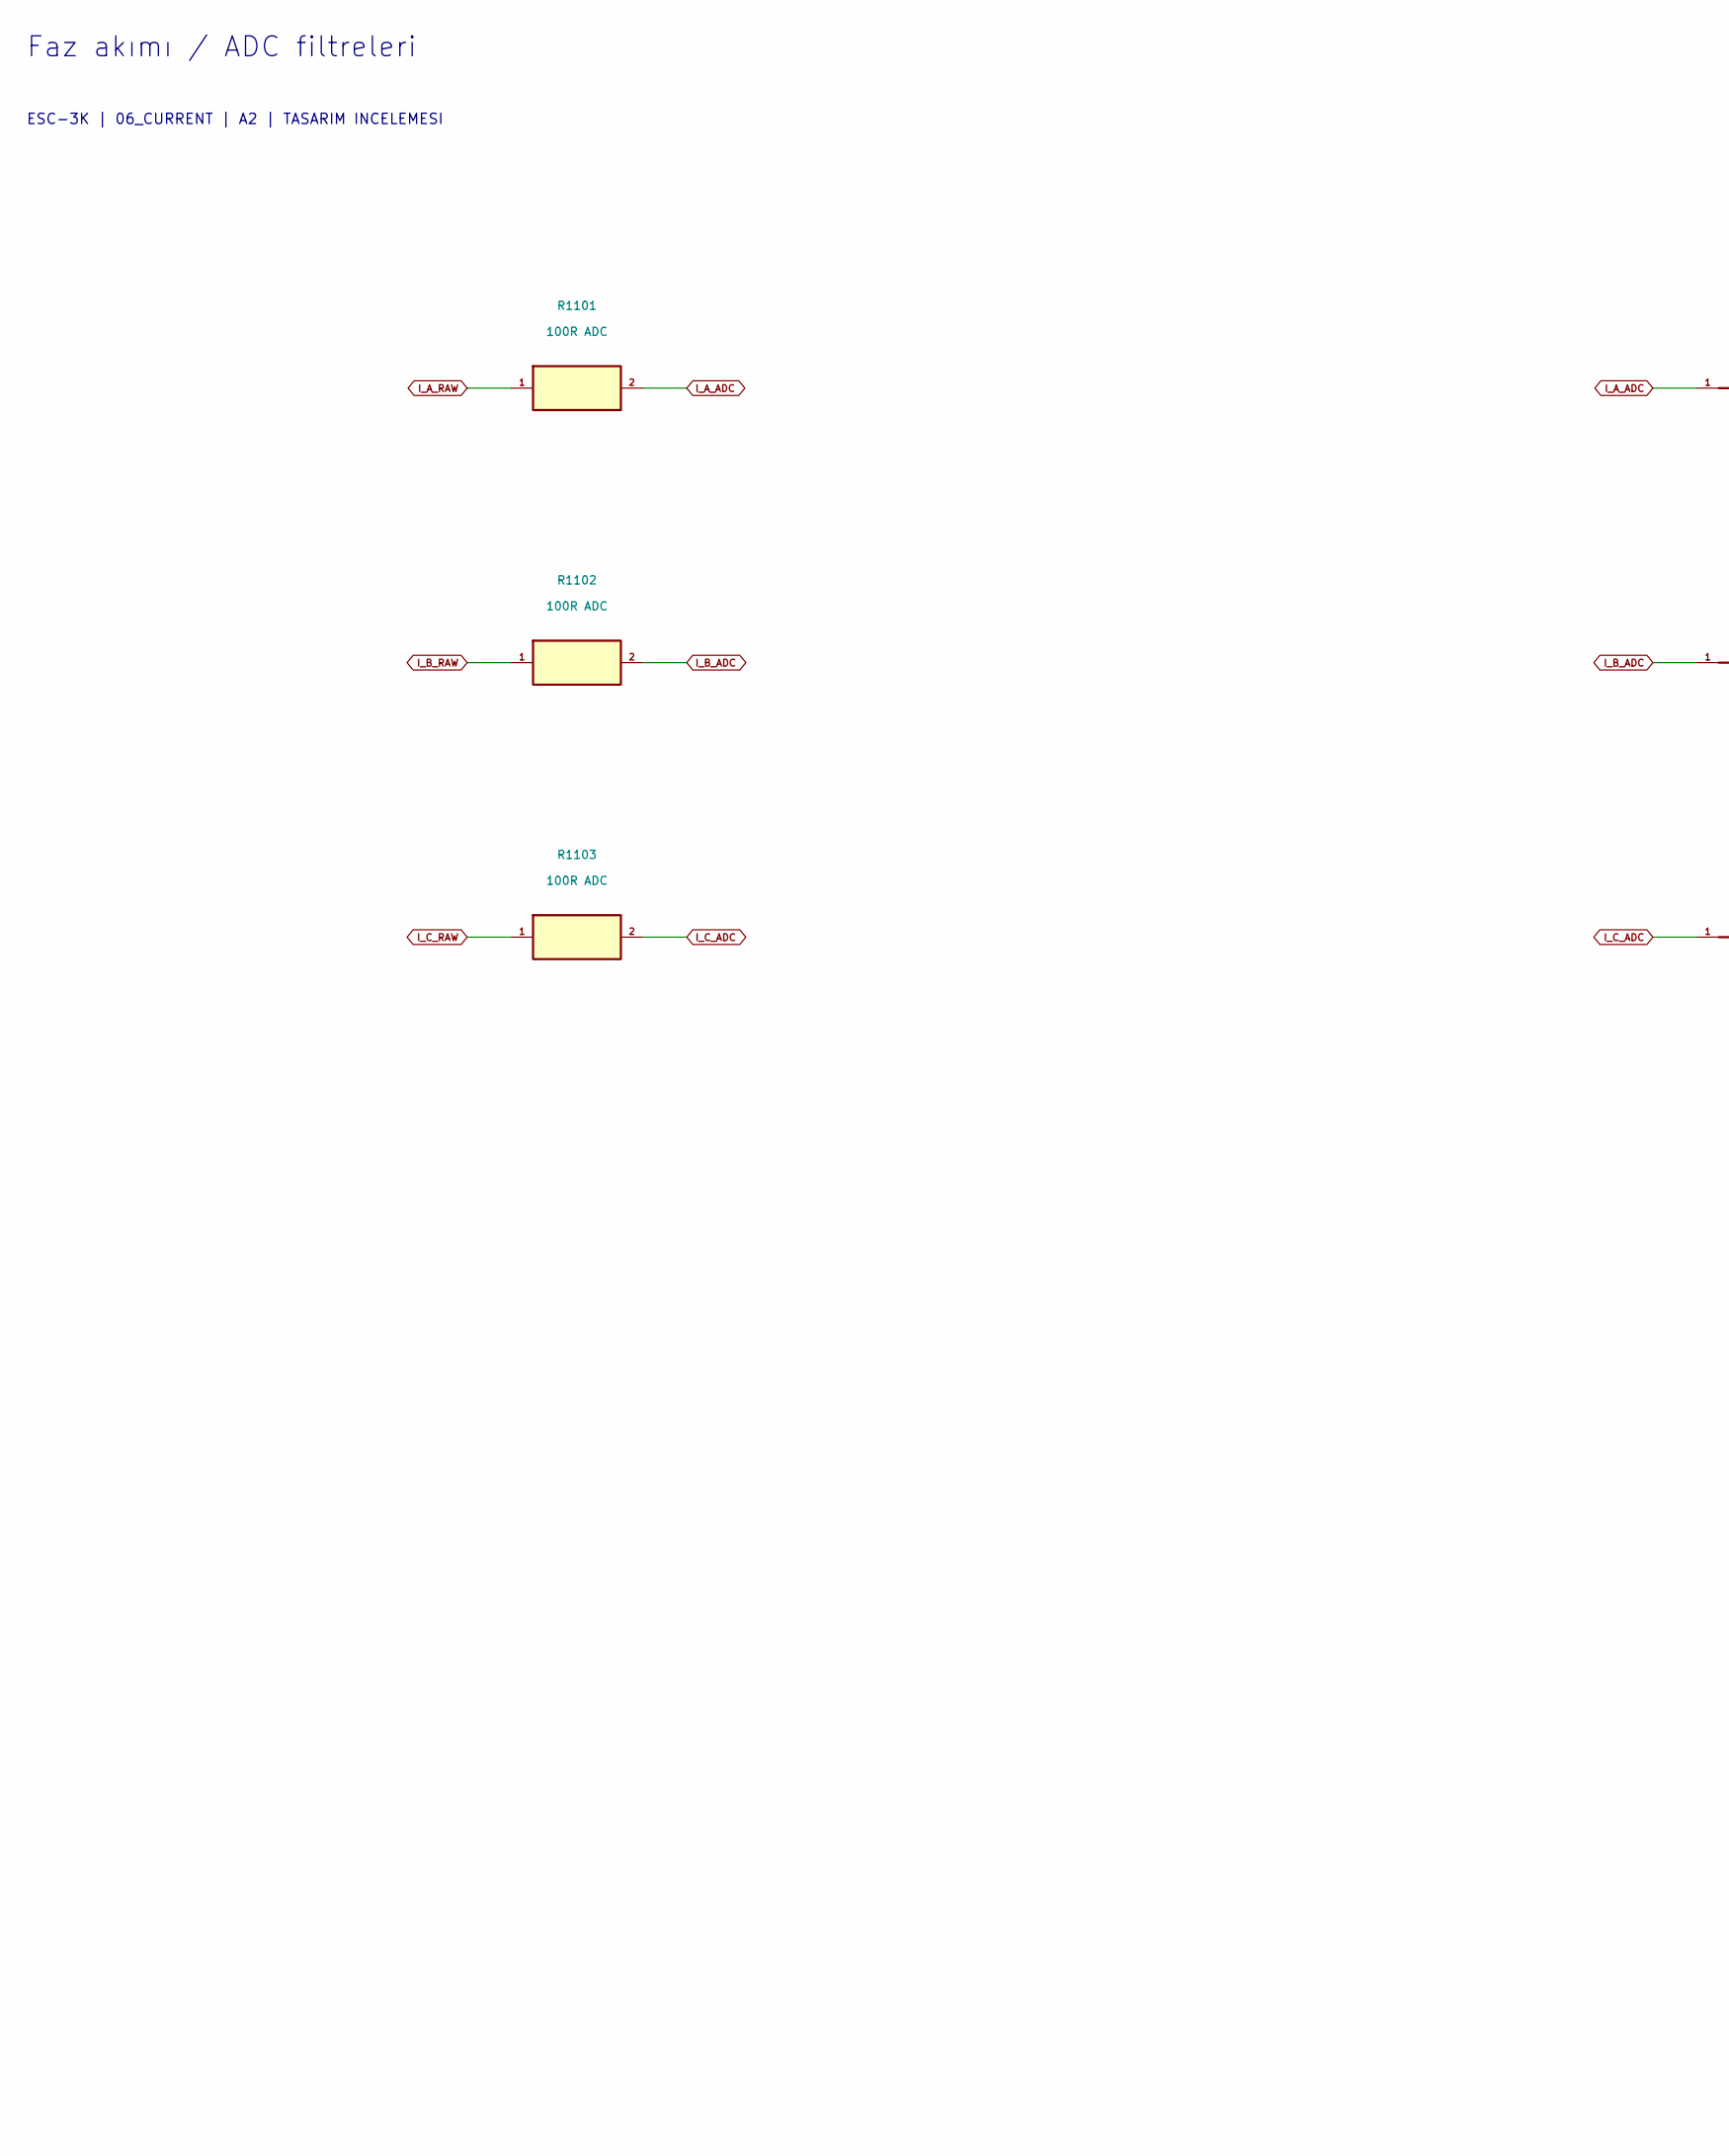
[picture p135: schematic 06_CURRENT.kicad_sch, part in row 1, column 1]

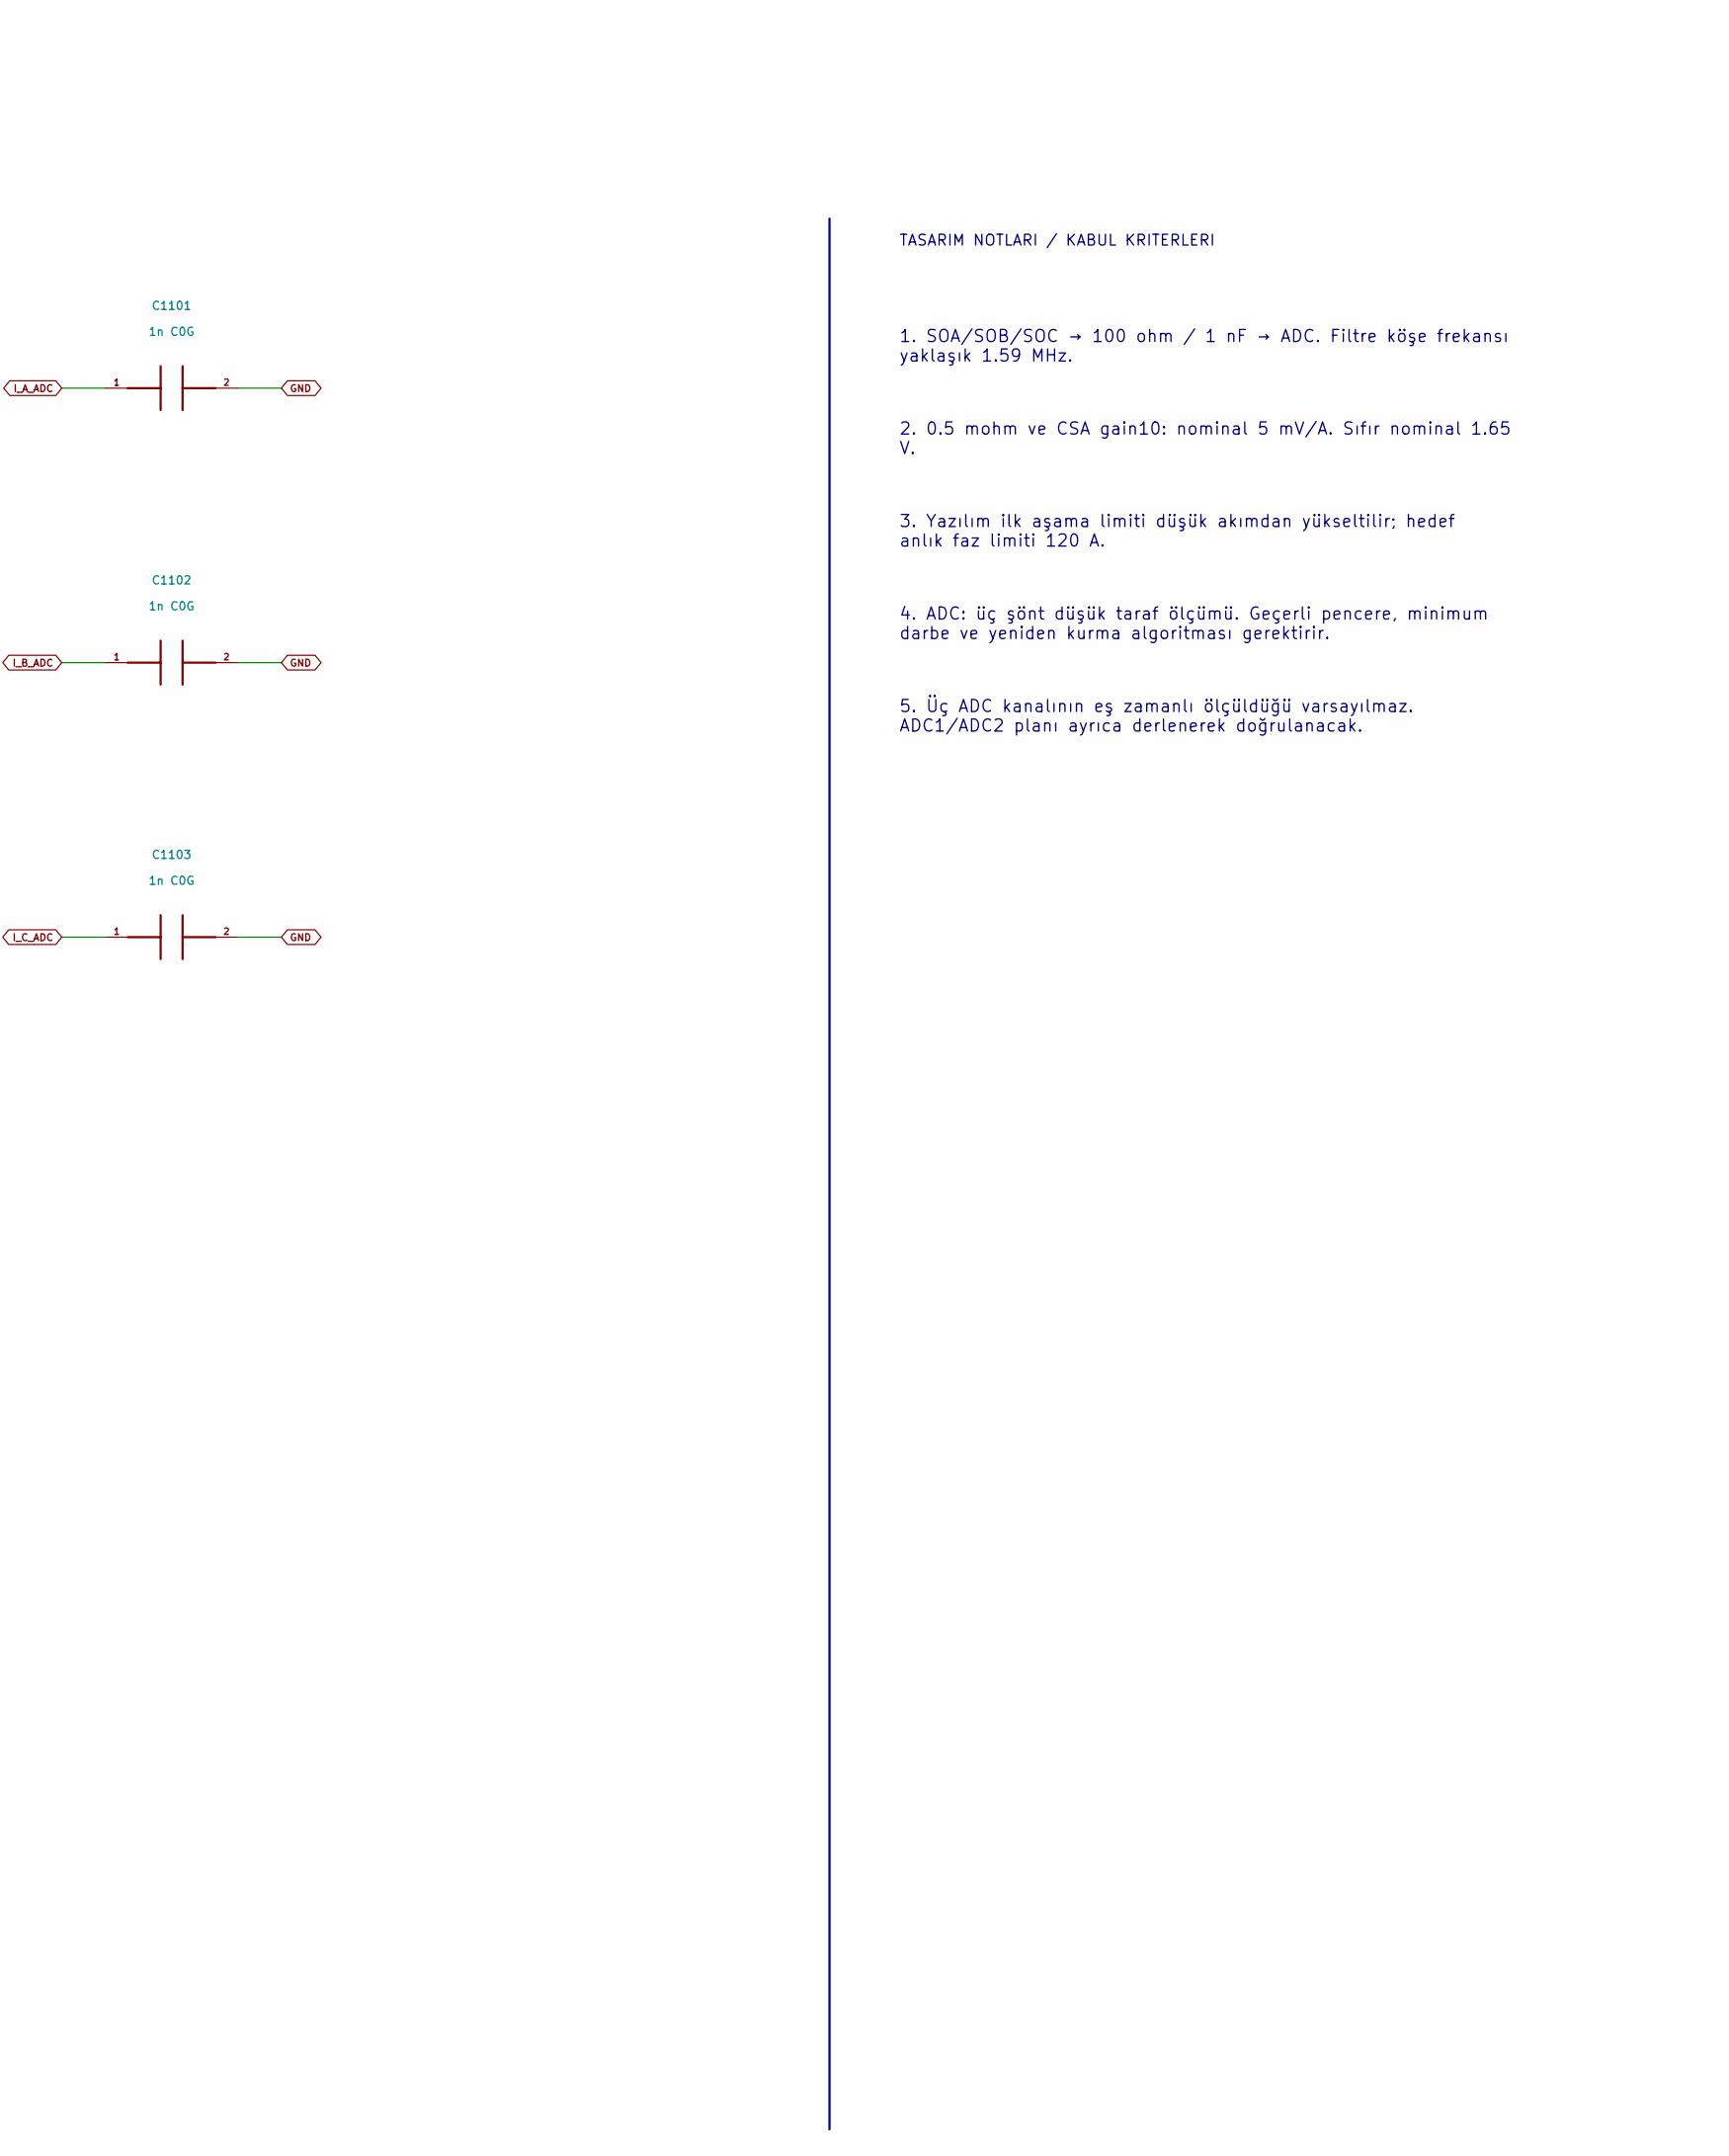
[picture p136: schematic 06_CURRENT.kicad_sch, part in row 1, column 2]

Parts:
C1101, C1102, C1103: 1n C0G; C_0805_2012Metric
R1101, R1102, R1103: 100R ADC; R_0805_2012Metric; MPN RC0805FR-07100RL

Connections:
GND: C1101.2, C1102.2, C1103.2
I_A_ADC: C1101.1, R1101.2
I_A_RAW: R1101.1
I_B_ADC: C1102.1, R1102.2
I_B_RAW: R1102.1
I_C_ADC: C1103.1, R1103.2
I_C_RAW: R1103.1

Notes on the sheet:
Faz akımı / ADC filtreleri
ESC-3K | 06_CURRENT | A2 | TASARIM INCELEMESI
TASARIM NOTLARI / KABUL KRITERLERI
1. SOA/SOB/SOC → 100 ohm / 1 nF → ADC. Filtre köşe frekansı yaklaşık 1.59 MHz.
2. 0.5 mohm ve CSA gain10: nominal 5 mV/A. Sıfır nominal 1.65 V.
3. Yazılım ilk aşama limiti düşük akımdan yükseltilir; hedef anlık faz limiti 120 A.
4. ADC: üç şönt düşük taraf ölçümü. Geçerli pencere, minimum darbe ve yeniden kurma algoritması gerektirir.
5. Üç ADC kanalının eş zamanlı ölçüldüğü varsayılmaz. ADC1/ADC2 planı ayrıca derlenerek doğrulanacak.
