mekiciepcas/ESC-Ai/ESC_V2/hardware_a2/07_TEMPERATURE.kicad_sch

## KiCad design ESC_V2/hardware_a2/07_TEMPERATURE.kicad_sch (2026-09-18)

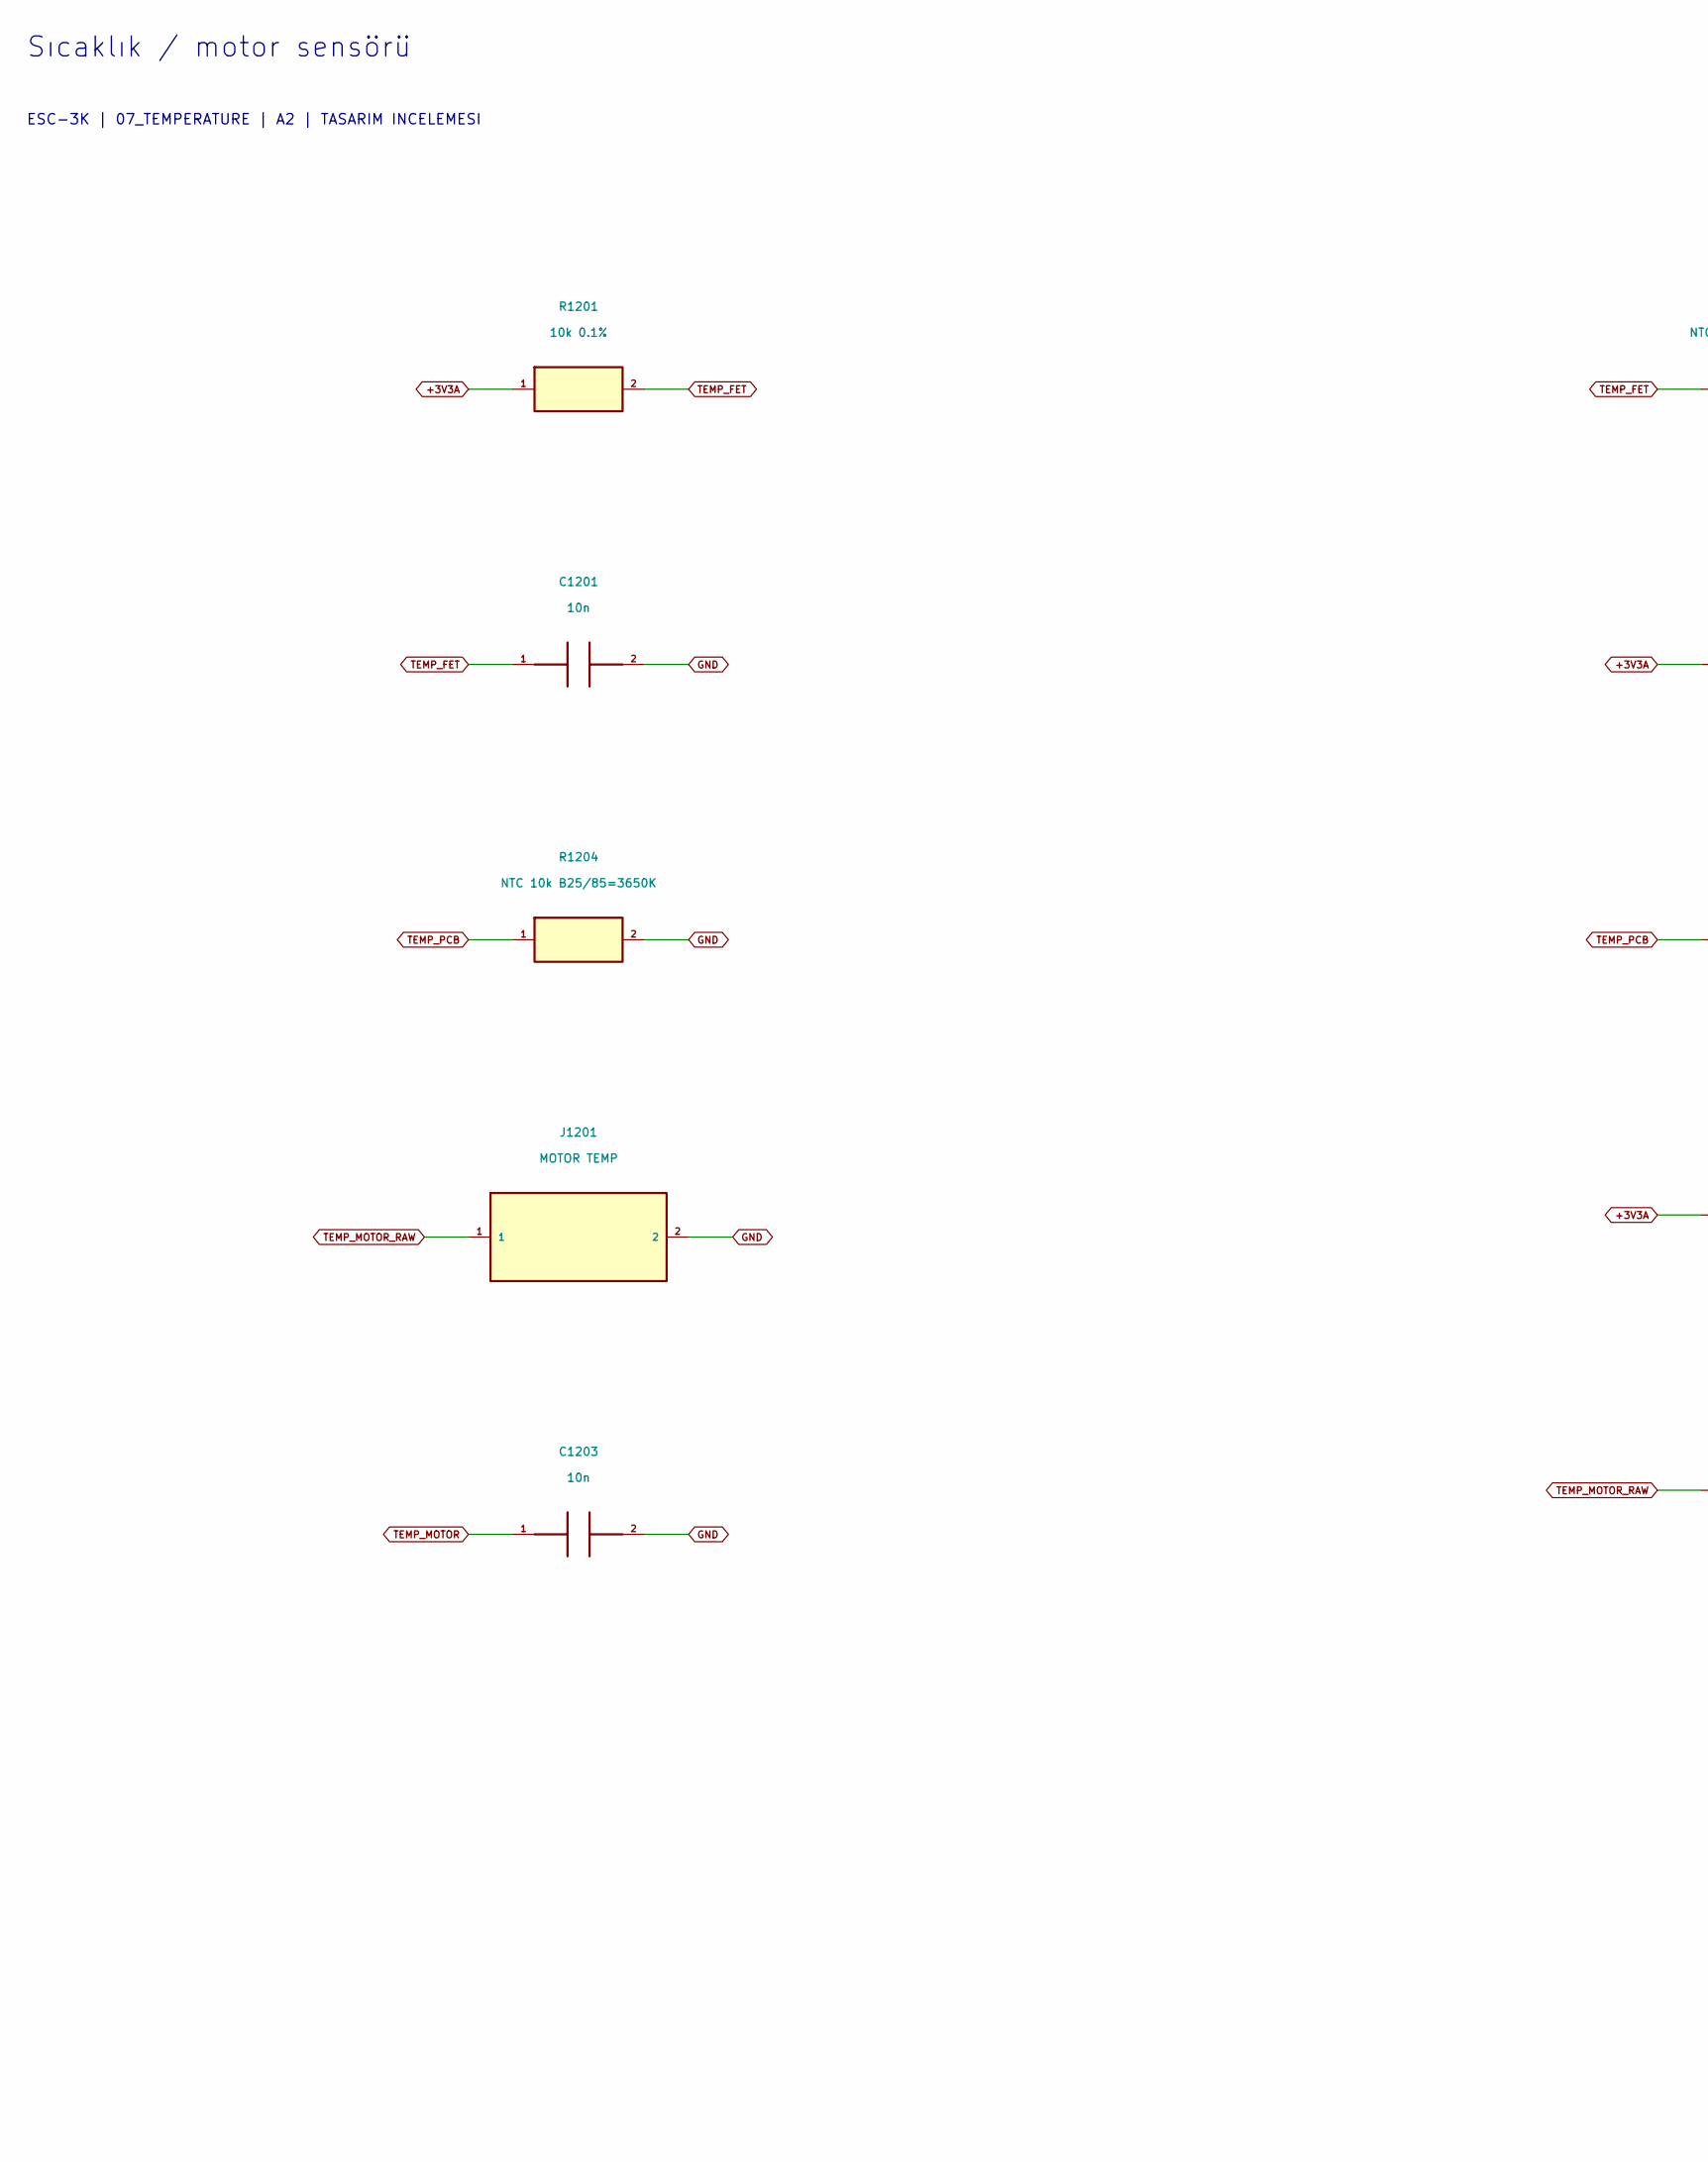
[picture p137: schematic 07_TEMPERATURE.kicad_sch, part in row 1, column 1]

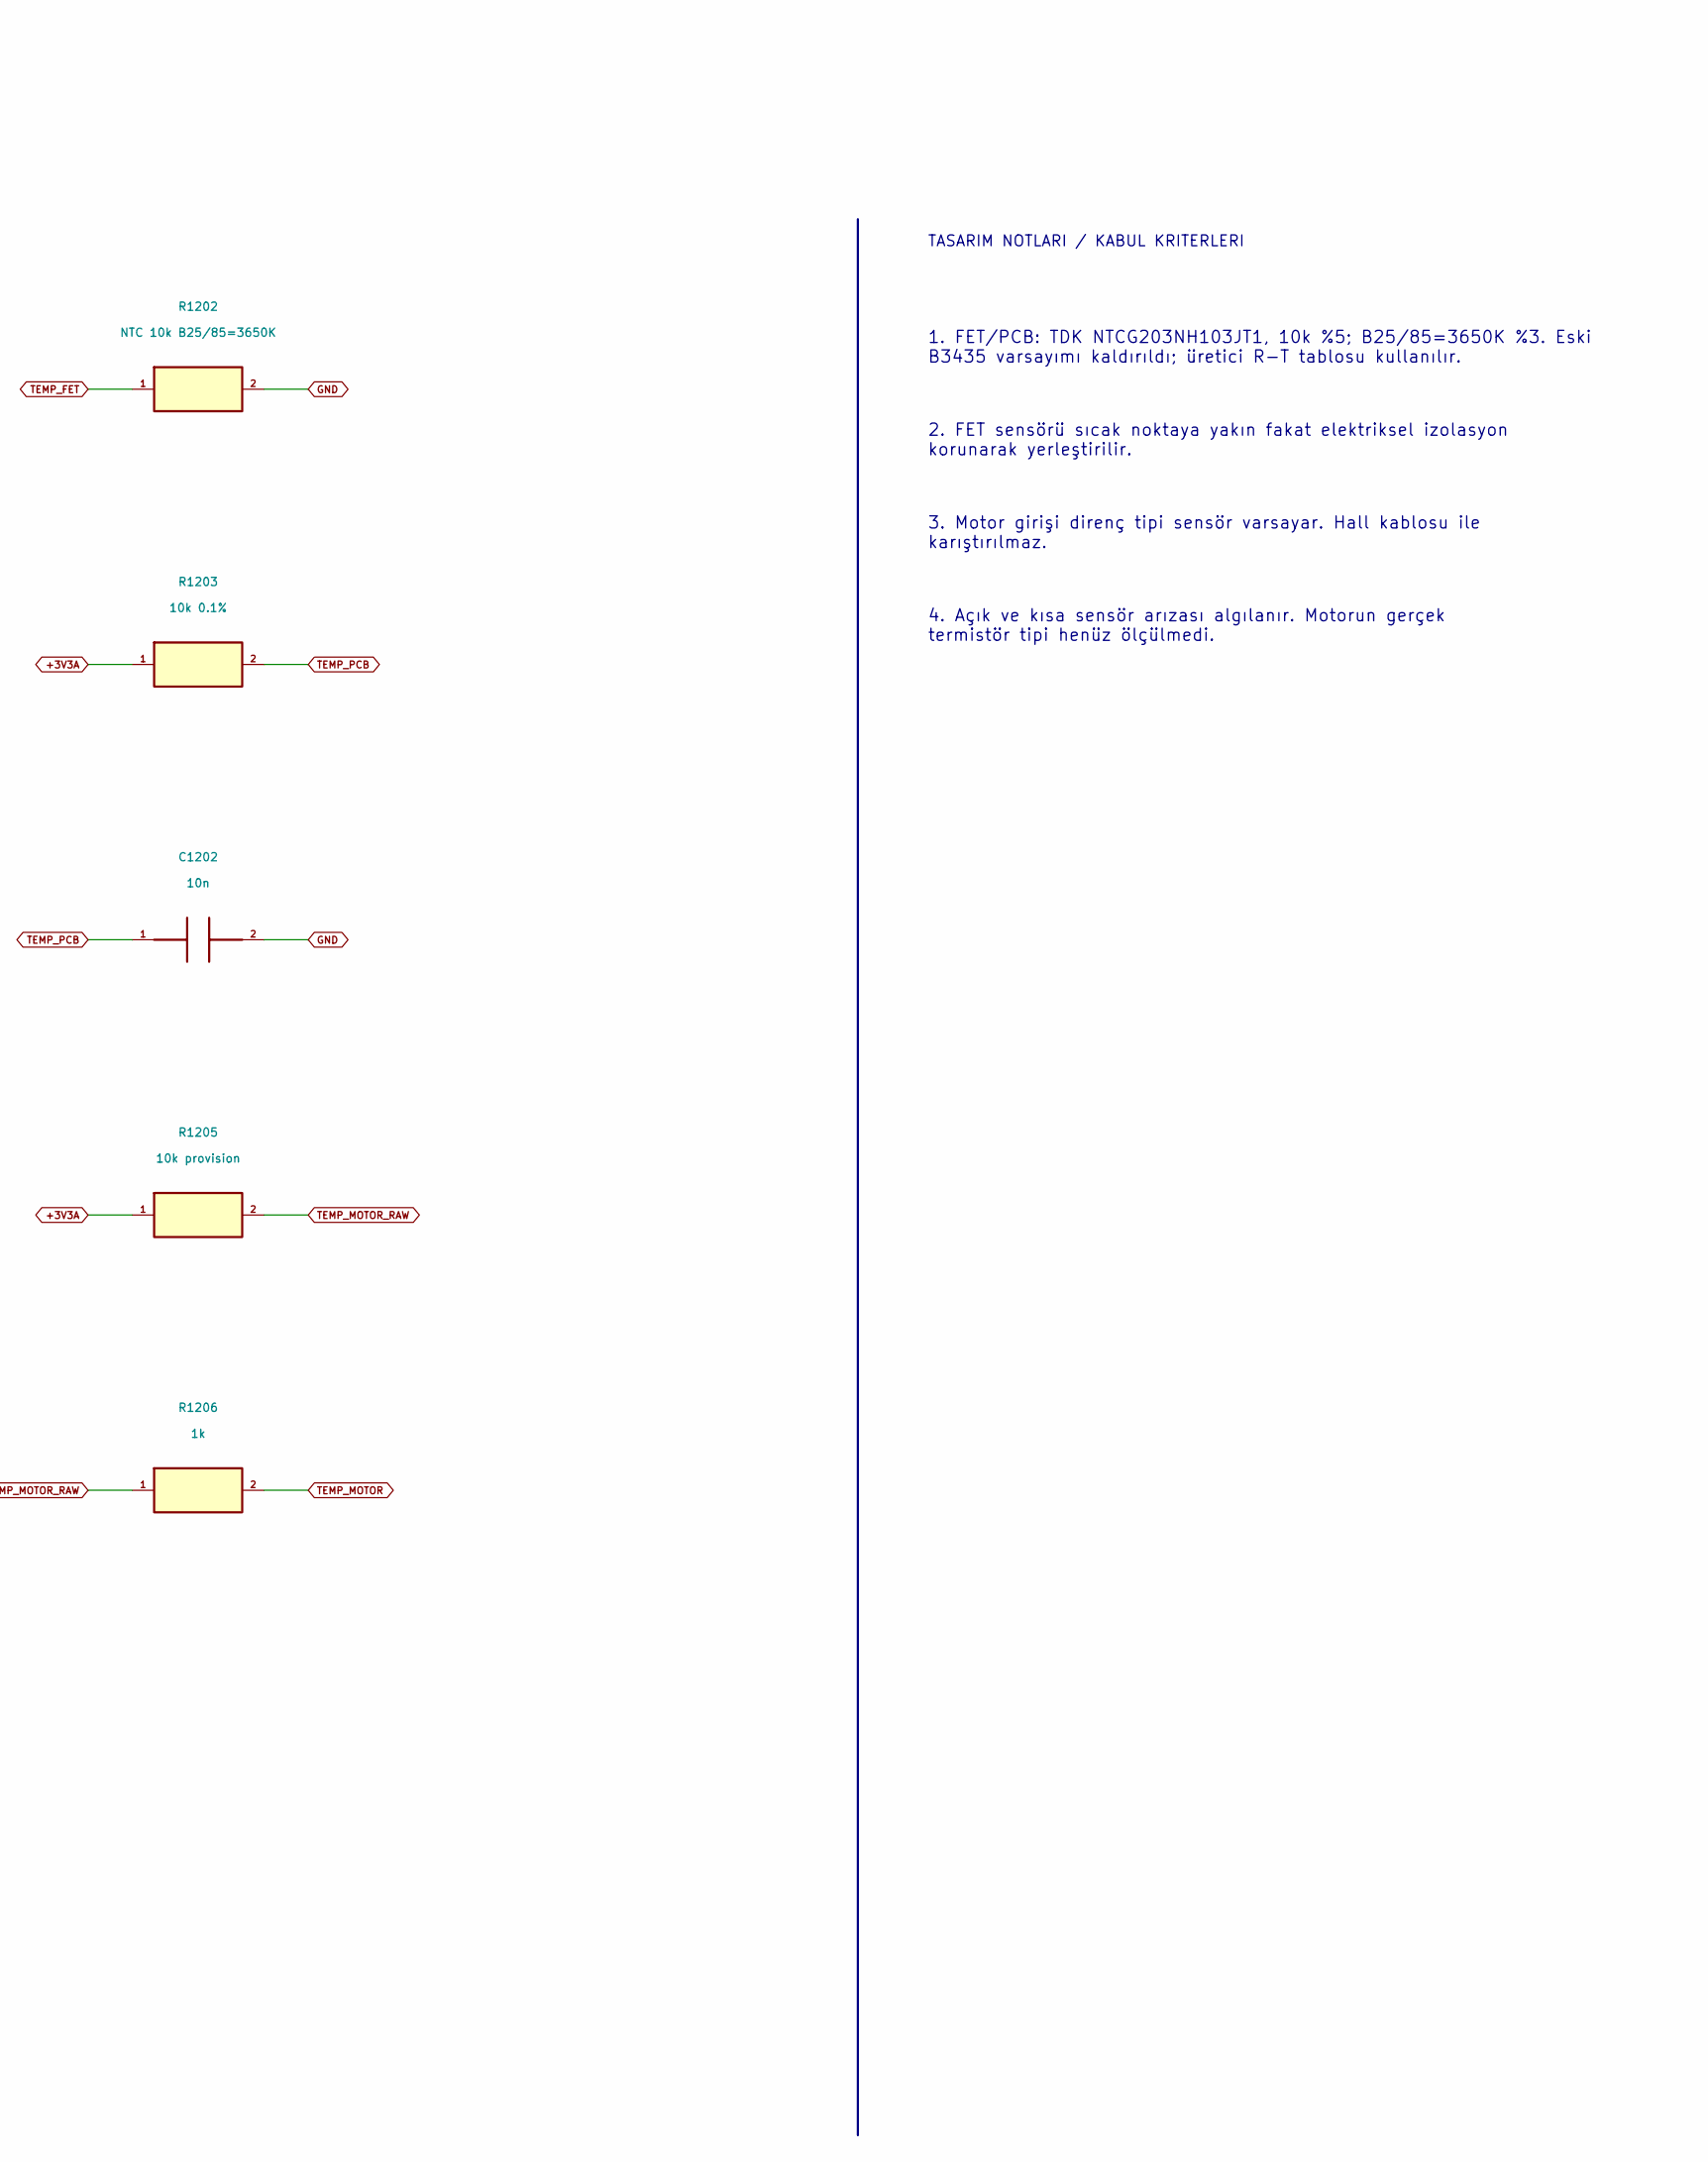
[picture p138: schematic 07_TEMPERATURE.kicad_sch, part in row 1, column 2]

Parts:
C1201, C1202, C1203: 10n; C_0805_2012Metric
J1201: MOTOR TEMP
R1201, R1203: 10k 0.1%; R_0805_2012Metric; MPN RT0805BRD0710KL
R1202, R1204: NTC 10k B25/85=3650K; R_0805_2012Metric; MPN NTCG203NH103JT1
R1205: 10k provision; R_0805_2012Metric; MPN RC0805FR-0710KL
R1206: 1k; R_0805_2012Metric; MPN RC0805FR-071KL

Connections:
+3V3A: R1201.1, R1203.1, R1205.1
GND: C1201.2, C1202.2, C1203.2, J1201.2, R1202.2, R1204.2
TEMP_FET: C1201.1, R1201.2, R1202.1
TEMP_MOTOR: C1203.1, R1206.2
TEMP_MOTOR_RAW: J1201.1, R1205.2, R1206.1
TEMP_PCB: C1202.1, R1203.2, R1204.1

Notes on the sheet:
Sıcaklık / motor sensörü
ESC-3K | 07_TEMPERATURE | A2 | TASARIM INCELEMESI
TASARIM NOTLARI / KABUL KRITERLERI
1. FET/PCB: TDK NTCG203NH103JT1, 10k %5; B25/85=3650K %3. Eski B3435 varsayımı kaldırıldı; üretici R-T tablosu kullanılır.
2. FET sensörü sıcak noktaya yakın fakat elektriksel izolasyon korunarak yerleştirilir.
3. Motor girişi direnç tipi sensör varsayar. Hall kablosu ile karıştırılmaz.
4. Açık ve kısa sensör arızası algılanır. Motorun gerçek termistör tipi henüz ölçülmedi.
