mekiciepcas/ESC-Ai/ESC_V2/hardware_a2/08_AUX_12V.kicad_sch

## KiCad design ESC_V2/hardware_a2/08_AUX_12V.kicad_sch (2026-09-18)

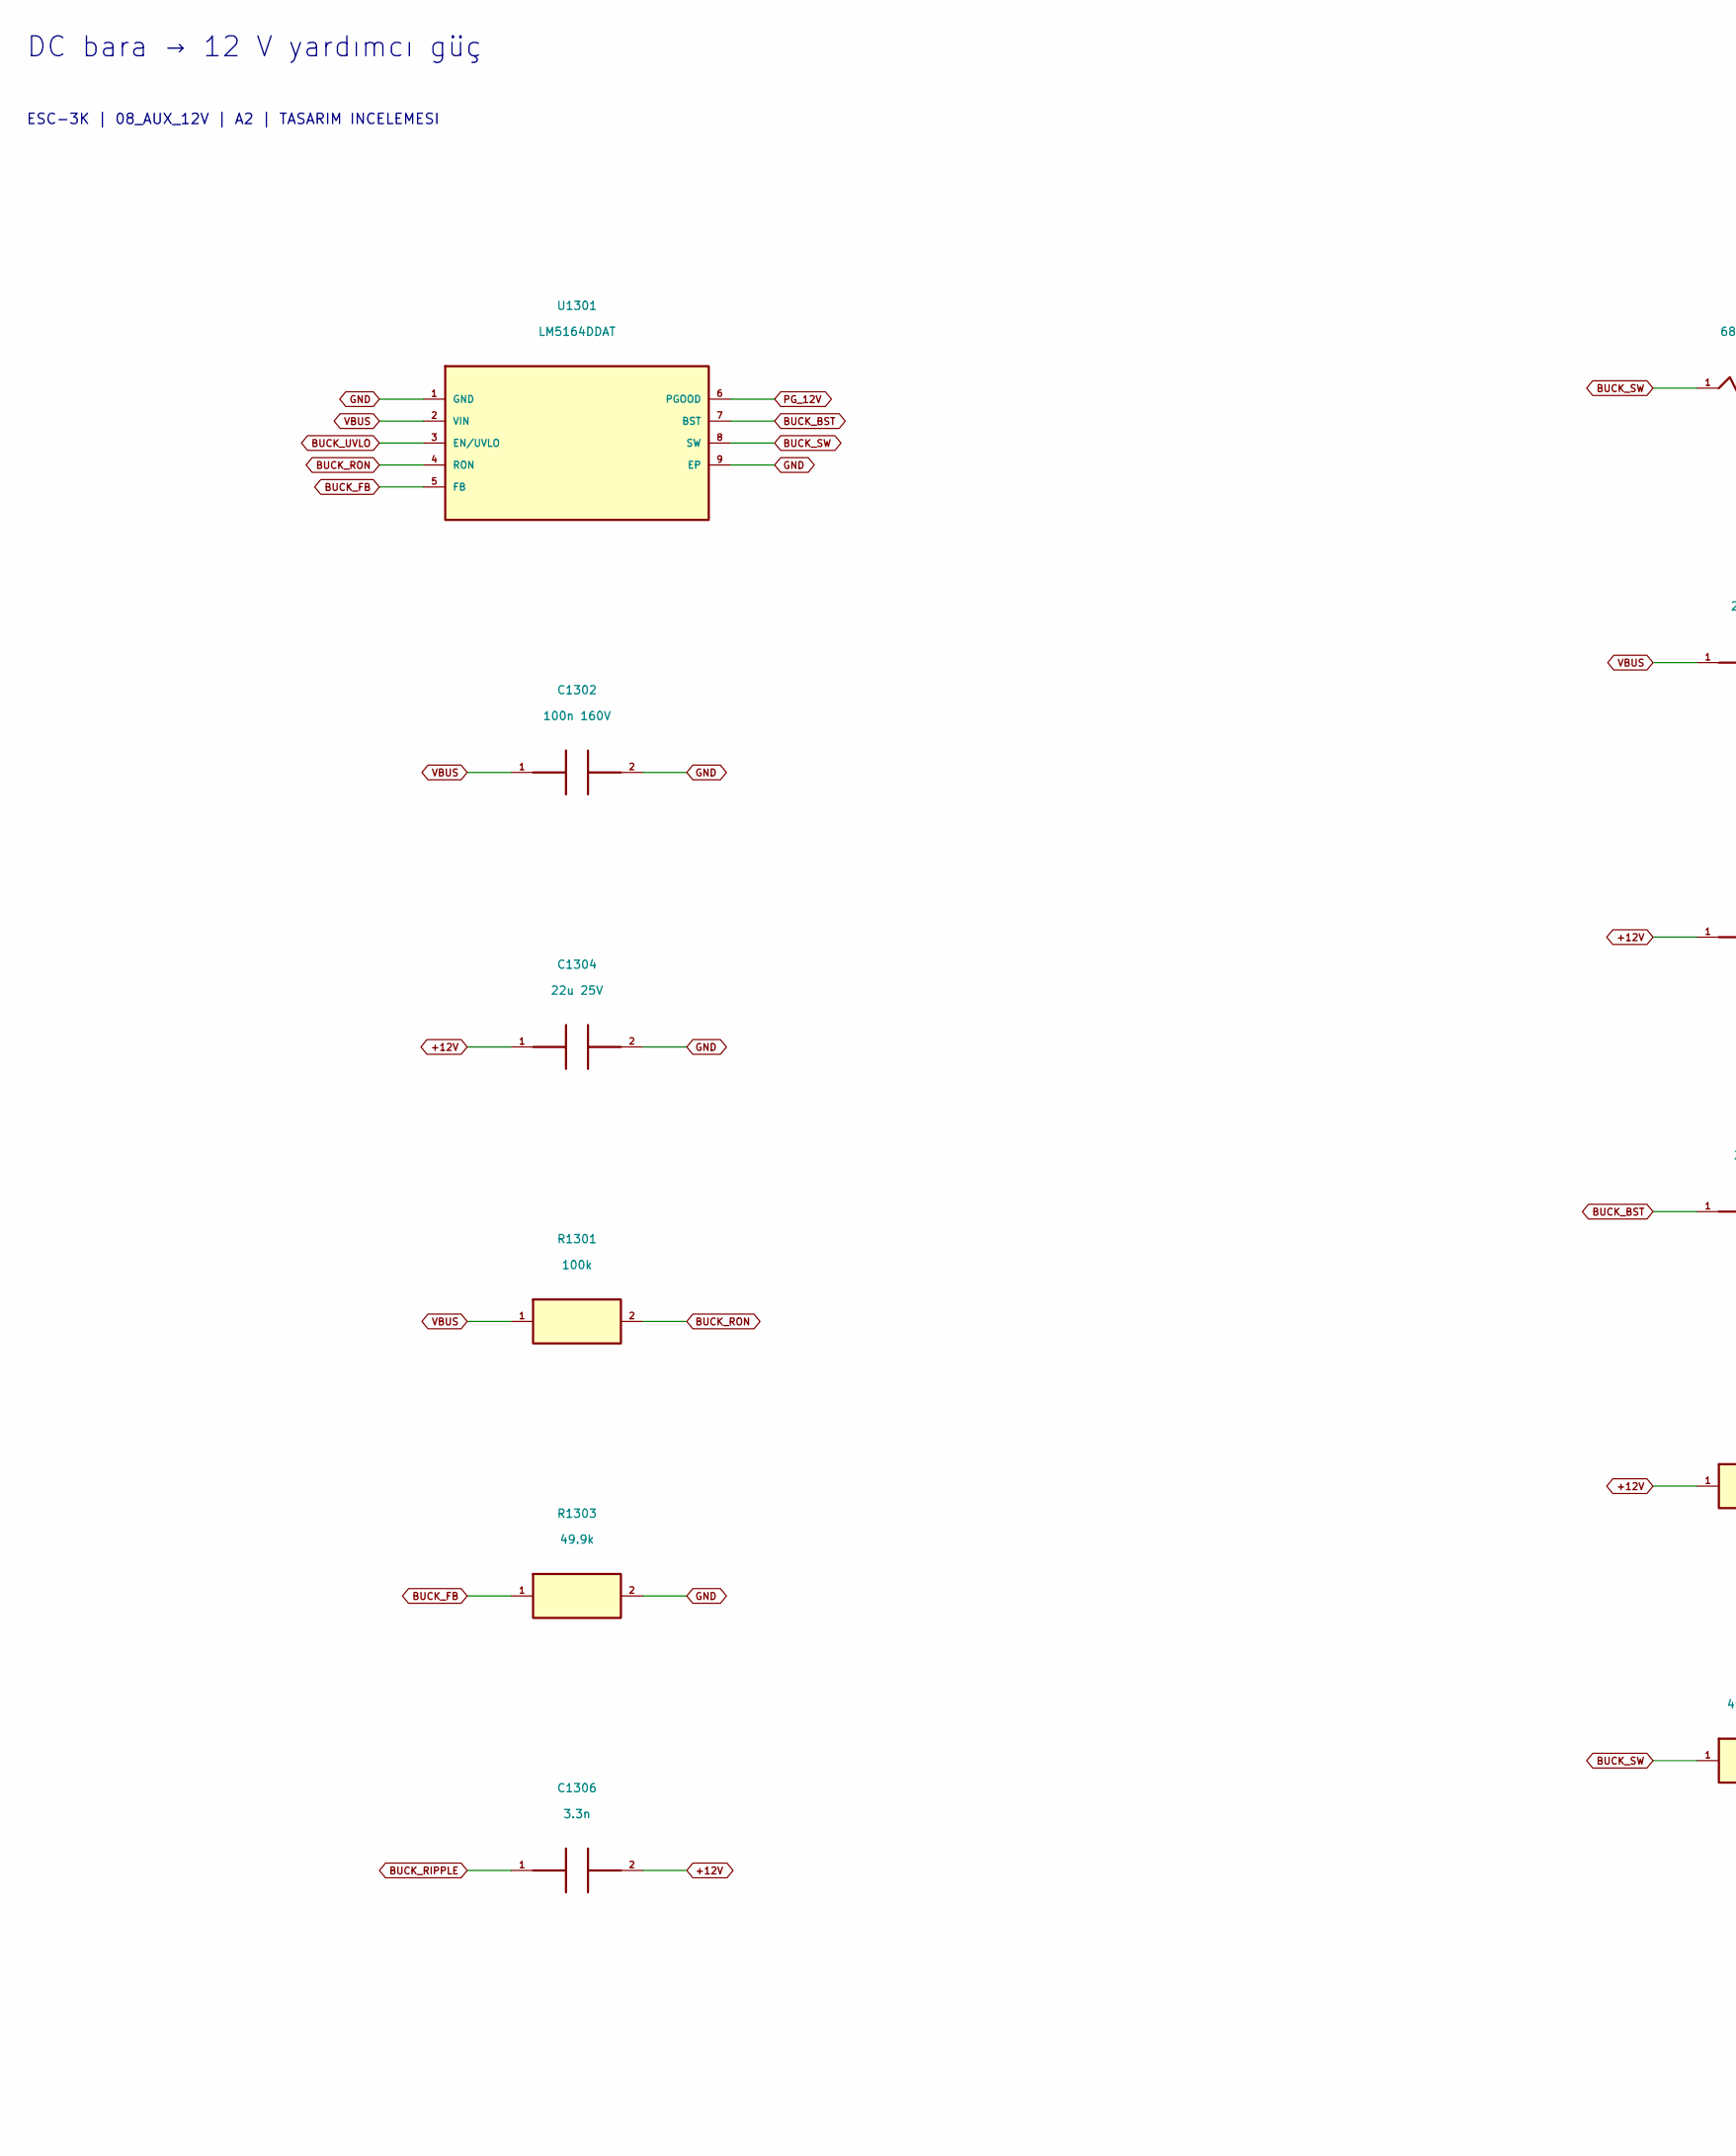
[picture p139: schematic 08_AUX_12V.kicad_sch, part in row 1, column 1]

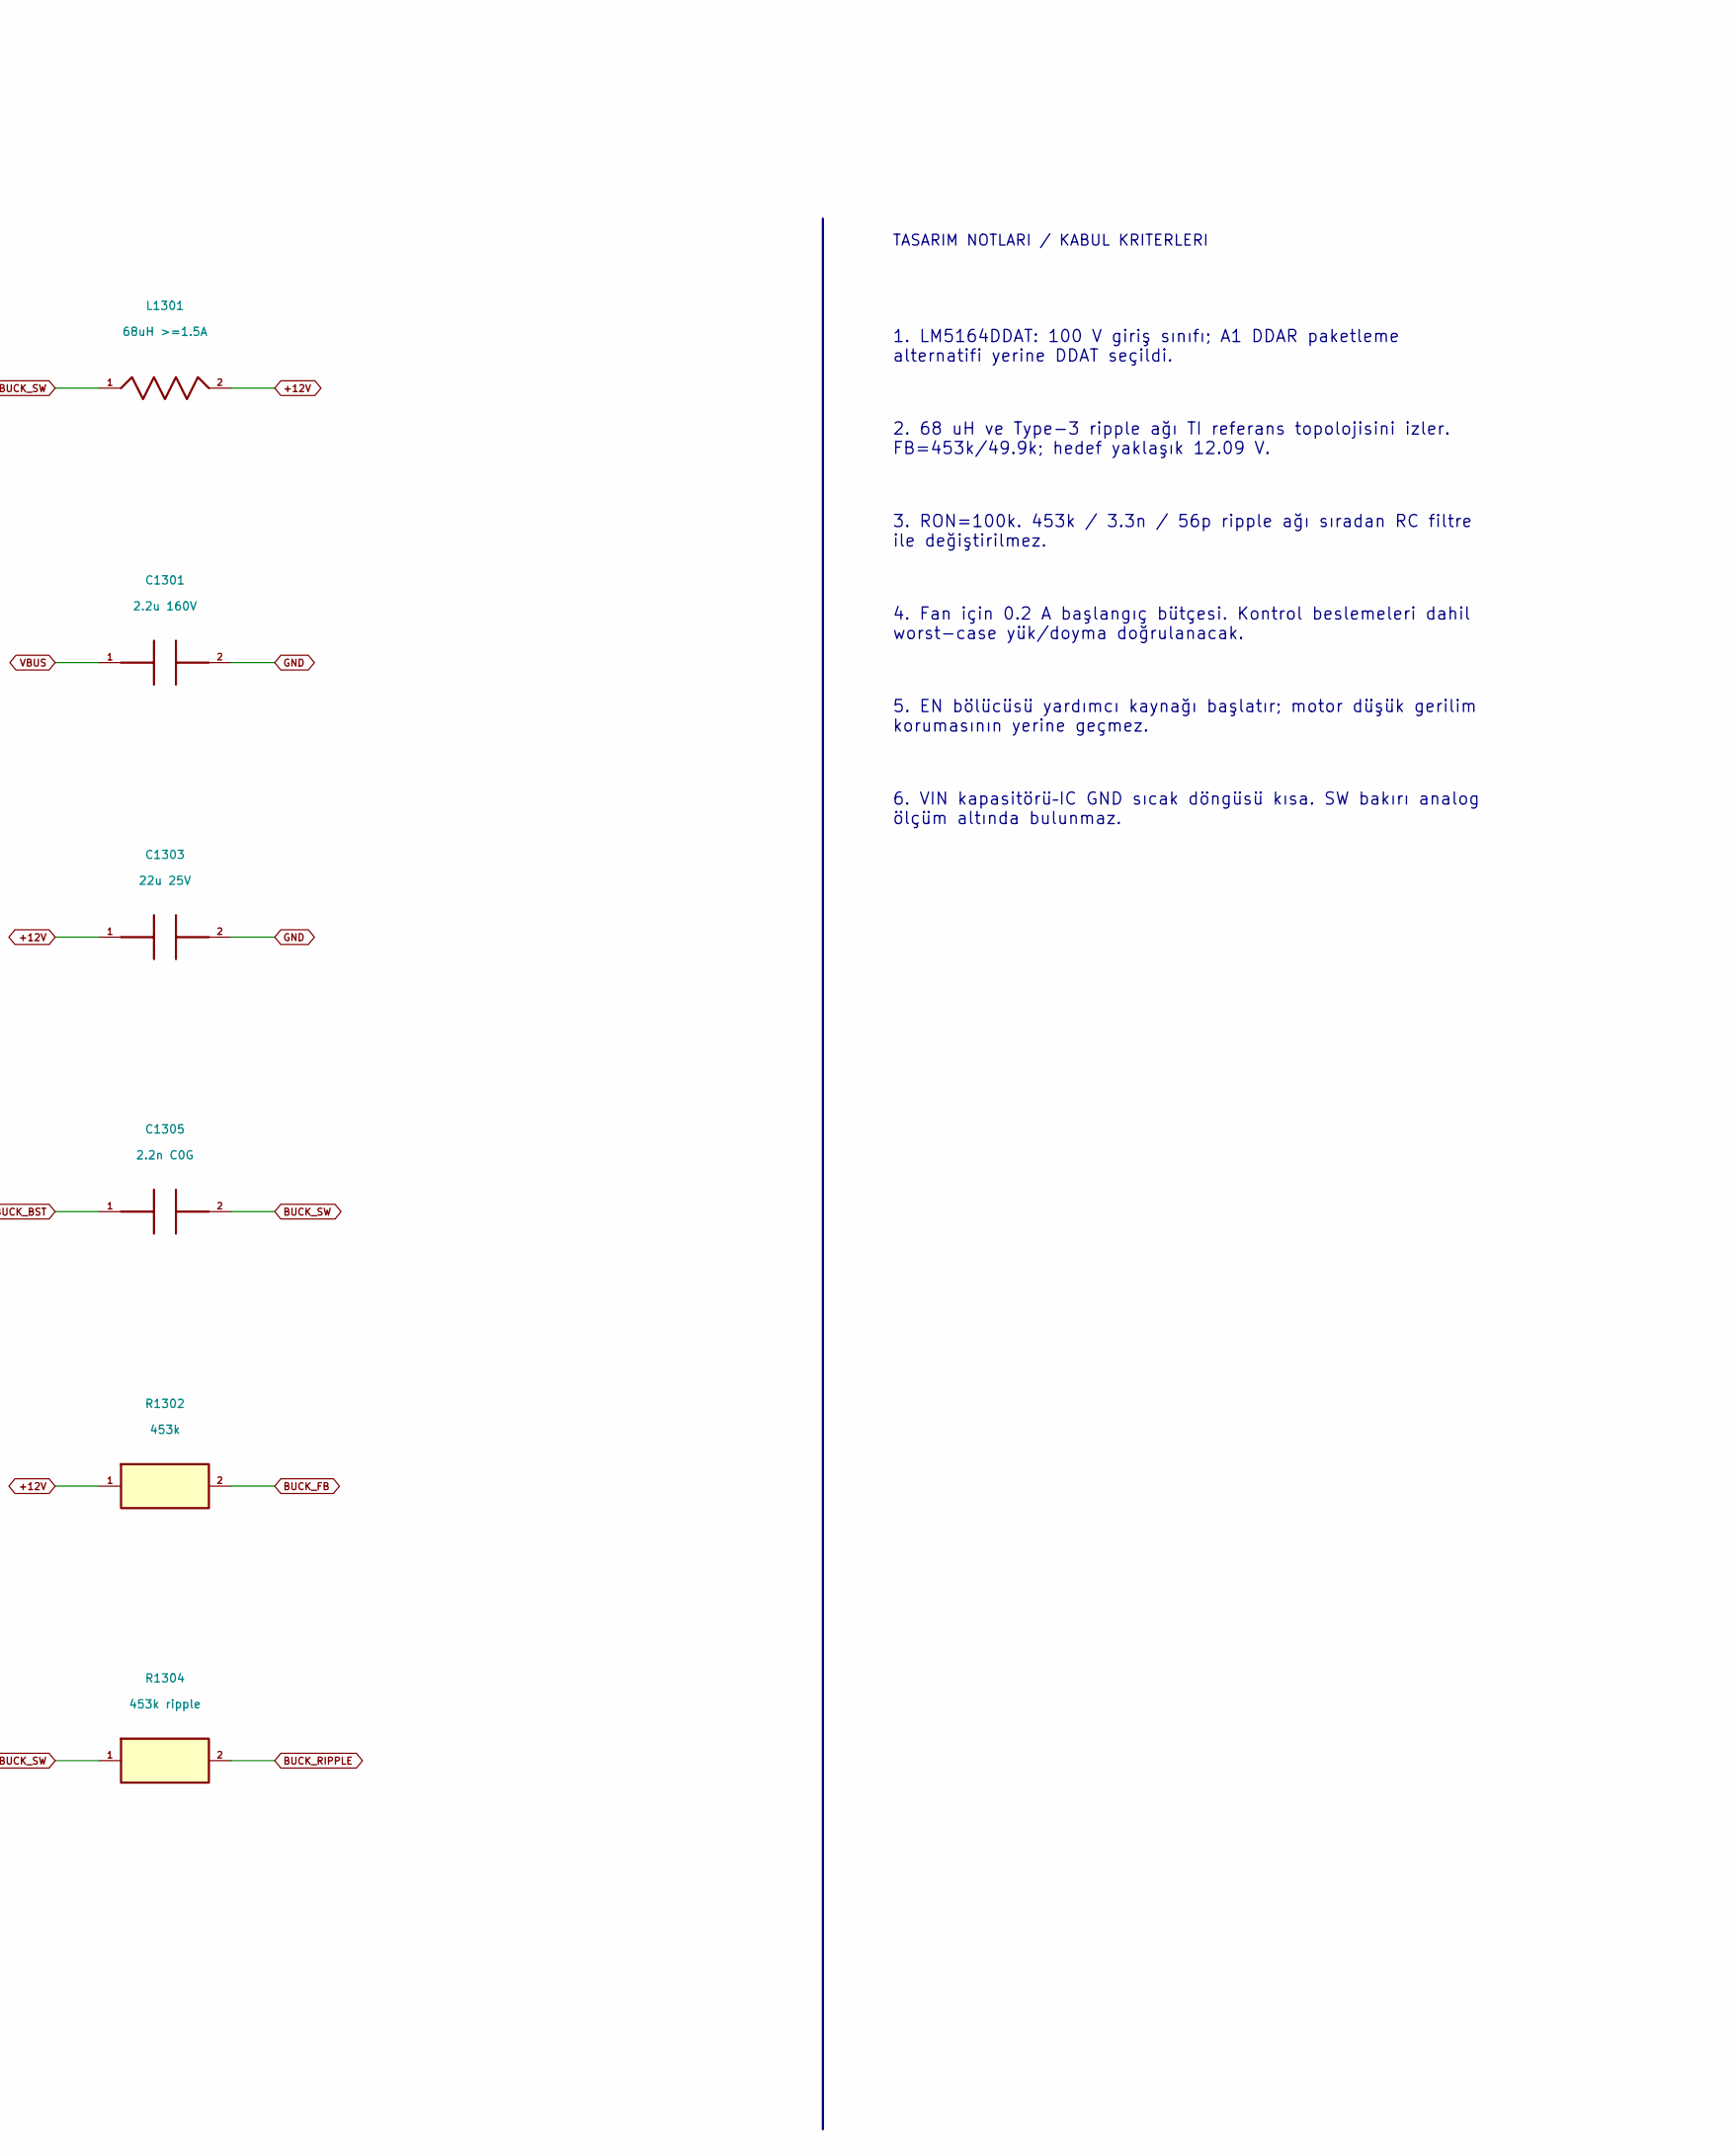
[picture p140: schematic 08_AUX_12V.kicad_sch, part in row 1, column 2]

Parts:
C1301: 2.2u 160V
C1302: 100n 160V
C1303, C1304: 22u 25V
C1305: 2.2n C0G; C_0805_2012Metric
C1306: 3.3n; C_0805_2012Metric
L1301: 68uH >=1.5A
R1301: 100k; R_0805_2012Metric; MPN RC0805FR-07100KL
R1302: 453k; R_0805_2012Metric; MPN RC0805FR-07453KL
R1303: 49.9k; R_0805_2012Metric; MPN RC0805FR-0749K9L
R1304: 453k ripple; R_0805_2012Metric; MPN RC0805FR-07453KL
U1301: LM5164DDAT; HSOP-8-1EP_3.9x4.9mm_P1.27mm_EP2.41x3.1mm_ThermalVias; MPN LM5164DDAT

Connections:
+12V: C1303.1, C1304.1, C1306.2, L1301.2, R1302.1
BUCK_BST: C1305.1, U1301.7 (BST)
BUCK_FB: R1302.2, R1303.1, U1301.5 (FB)
BUCK_RIPPLE: C1306.1, R1304.2
BUCK_RON: R1301.2, U1301.4 (RON)
BUCK_SW: C1305.2, L1301.1, R1304.1, U1301.8 (SW)
BUCK_UVLO: U1301.3 (EN/UVLO)
GND: C1301.2, C1302.2, C1303.2, C1304.2, R1303.2, U1301.1 (GND), U1301.9 (EP)
PG_12V: U1301.6 (PGOOD)
VBUS: C1301.1, C1302.1, R1301.1, U1301.2 (VIN)

Notes on the sheet:
DC bara → 12 V yardımcı güç
ESC-3K | 08_AUX_12V | A2 | TASARIM INCELEMESI
TASARIM NOTLARI / KABUL KRITERLERI
1. LM5164DDAT: 100 V giriş sınıfı; A1 DDAR paketleme alternatifi yerine DDAT seçildi.
2. 68 uH ve Type-3 ripple ağı TI referans topolojisini izler. FB=453k/49.9k; hedef yaklaşık 12.09 V.
3. RON=100k. 453k / 3.3n / 56p ripple ağı sıradan RC filtre ile değiştirilmez.
4. Fan için 0.2 A başlangıç bütçesi. Kontrol beslemeleri dahil worst-case yük/doyma doğrulanacak.
5. EN bölücüsü yardımcı kaynağı başlatır; motor düşük gerilim korumasının yerine geçmez.
6. VIN kapasitörü–IC GND sıcak döngüsü kısa. SW bakırı analog ölçüm altında bulunmaz.
