mekiciepcas/ESC-Ai/ESC_V2/hardware_a2/08_AUX_12V_2.kicad_sch

## KiCad design ESC_V2/hardware_a2/08_AUX_12V_2.kicad_sch (2026-09-18)

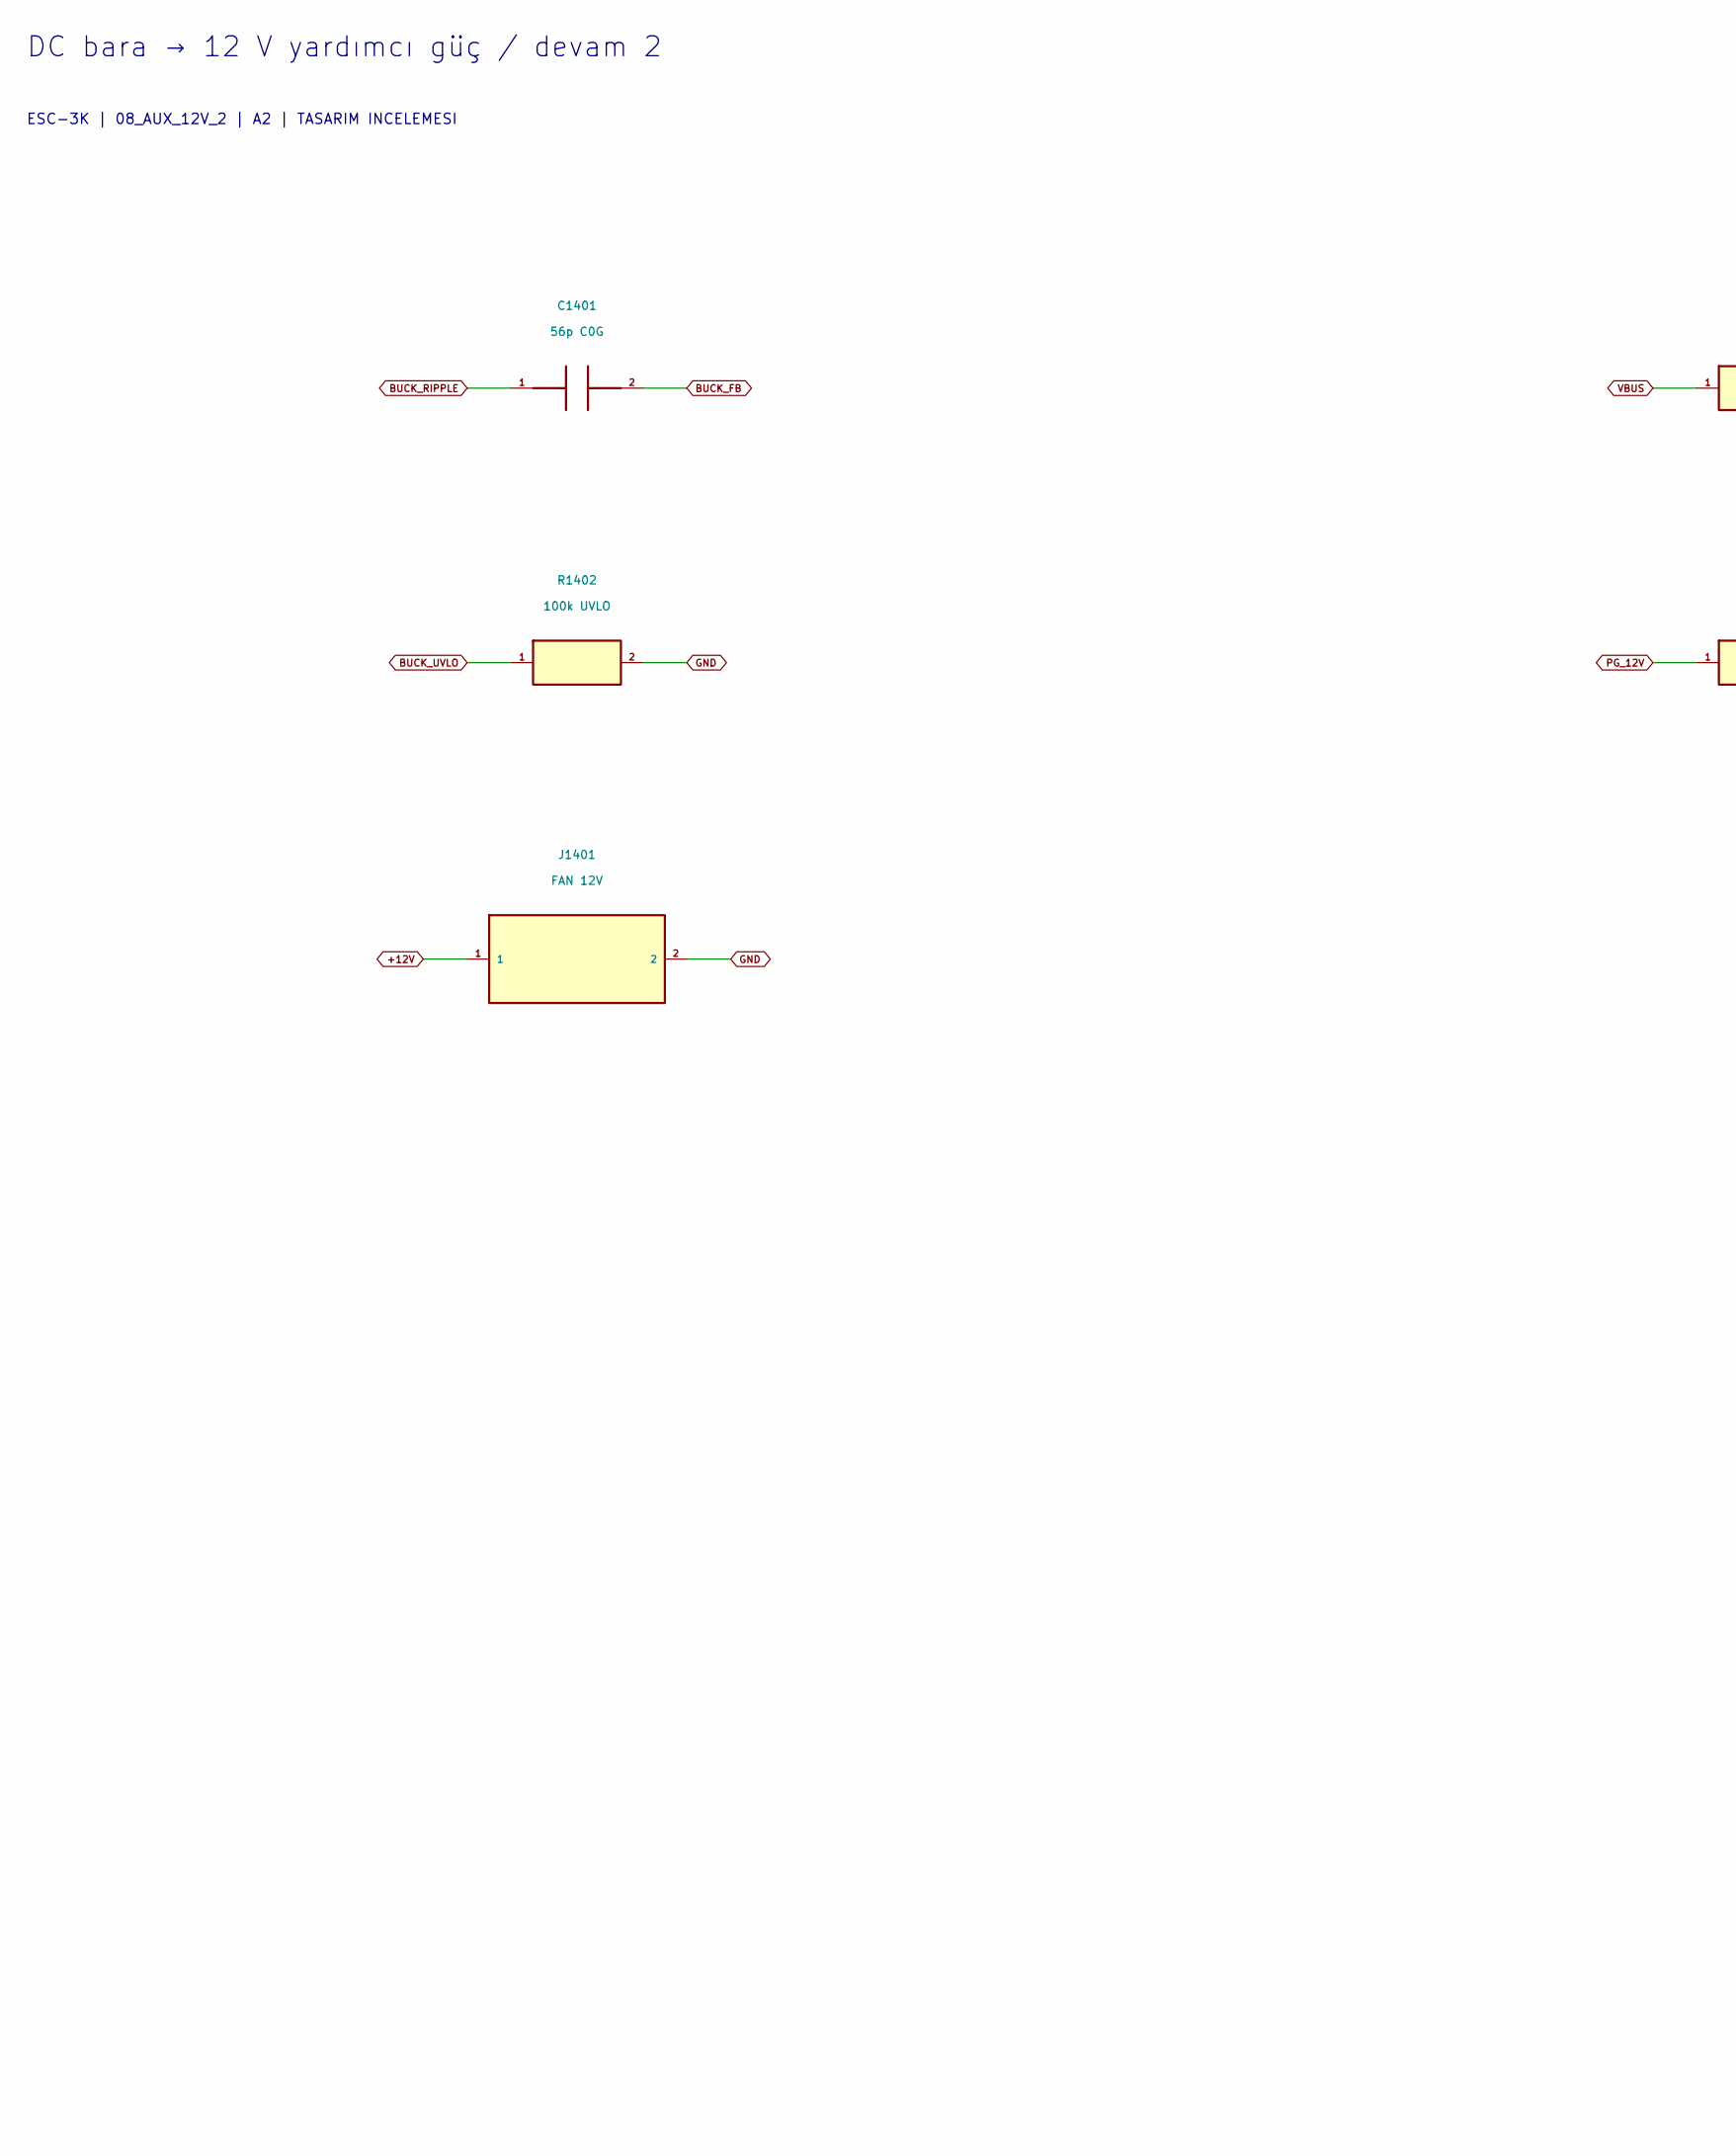
[picture p141: schematic 08_AUX_12V_2.kicad_sch, part in row 1, column 1]

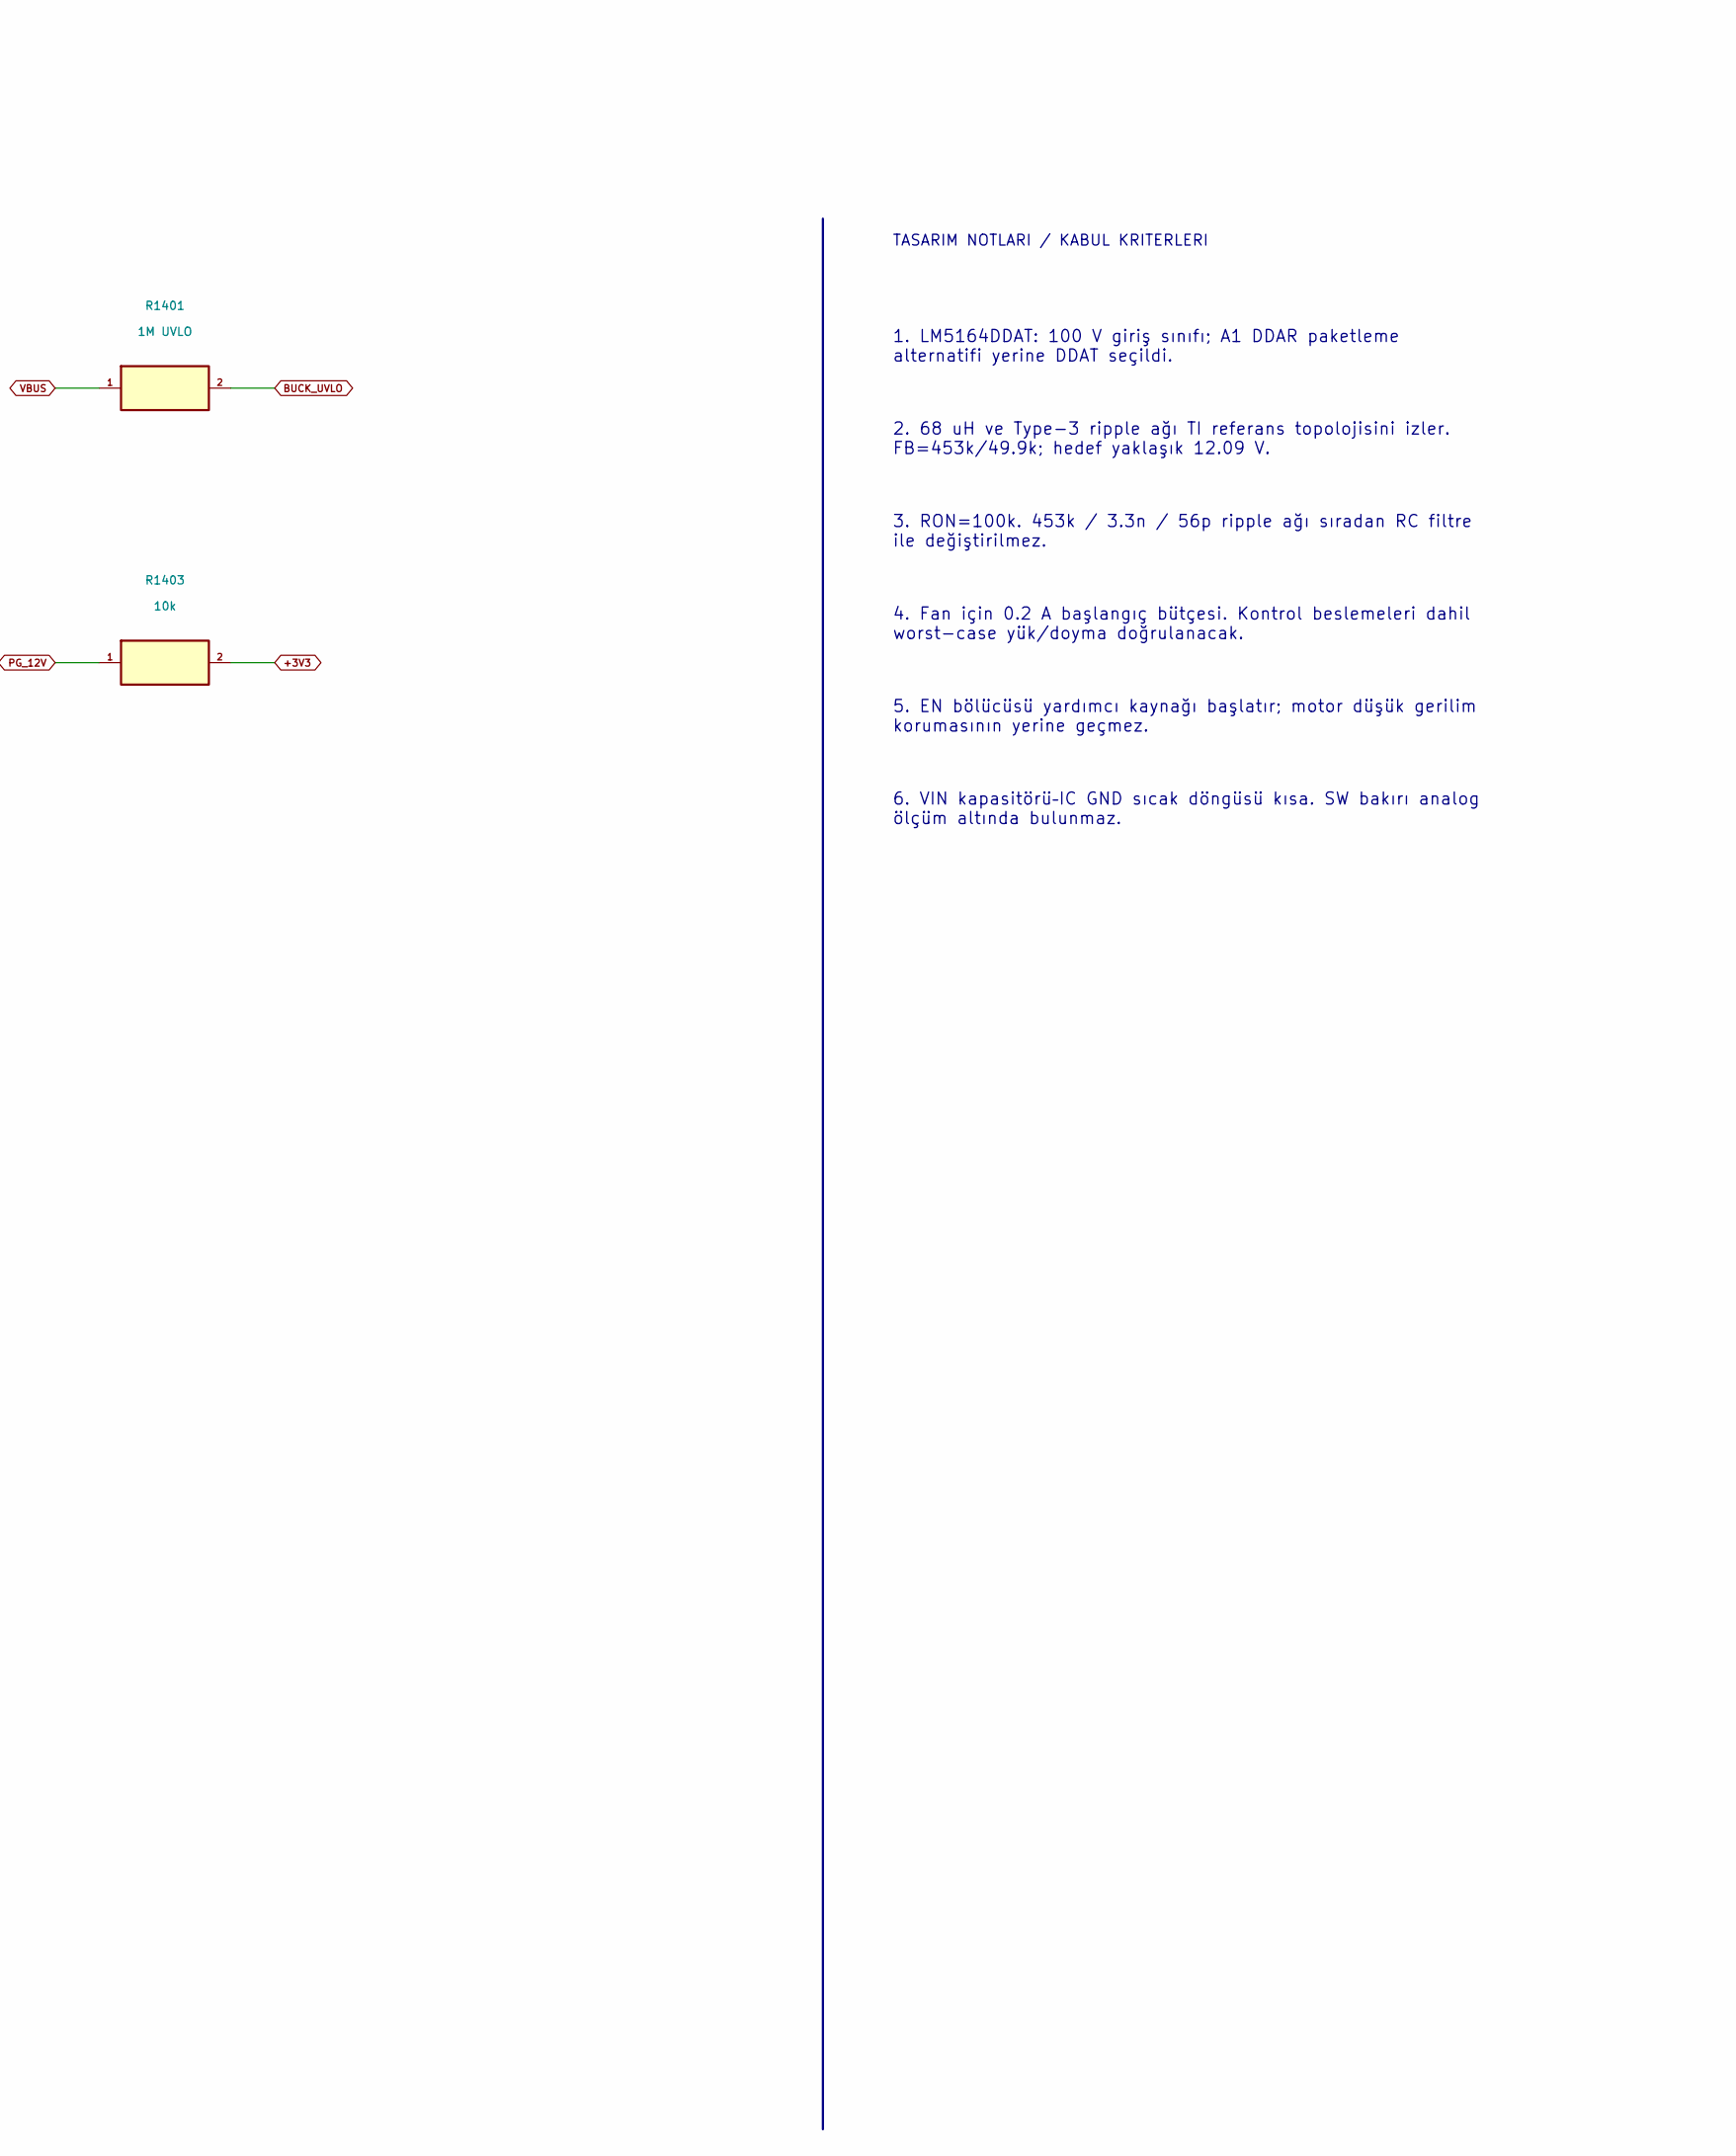
[picture p142: schematic 08_AUX_12V_2.kicad_sch, part in row 1, column 2]

Parts:
C1401: 56p C0G; C_0805_2012Metric
J1401: FAN 12V
R1401: 1M UVLO; R_0805_2012Metric; MPN RC0805FR-071ML
R1402: 100k UVLO; R_0805_2012Metric; MPN RC0805FR-07100KL
R1403: 10k; R_0805_2012Metric; MPN RC0805FR-0710KL

Connections:
+3V3: R1403.2
+12V: J1401.1
BUCK_FB: C1401.2
BUCK_RIPPLE: C1401.1
BUCK_UVLO: R1401.2, R1402.1
GND: J1401.2, R1402.2
PG_12V: R1403.1
VBUS: R1401.1

Notes on the sheet:
DC bara → 12 V yardımcı güç / devam 2
ESC-3K | 08_AUX_12V_2 | A2 | TASARIM INCELEMESI
TASARIM NOTLARI / KABUL KRITERLERI
1. LM5164DDAT: 100 V giriş sınıfı; A1 DDAR paketleme alternatifi yerine DDAT seçildi.
2. 68 uH ve Type-3 ripple ağı TI referans topolojisini izler. FB=453k/49.9k; hedef yaklaşık 12.09 V.
3. RON=100k. 453k / 3.3n / 56p ripple ağı sıradan RC filtre ile değiştirilmez.
4. Fan için 0.2 A başlangıç bütçesi. Kontrol beslemeleri dahil worst-case yük/doyma doğrulanacak.
5. EN bölücüsü yardımcı kaynağı başlatır; motor düşük gerilim korumasının yerine geçmez.
6. VIN kapasitörü–IC GND sıcak döngüsü kısa. SW bakırı analog ölçüm altında bulunmaz.
