mekiciepcas/ESC-Ai/ESC_V2/hardware_a2/09_AUX_LOGIC.kicad_sch

## KiCad design ESC_V2/hardware_a2/09_AUX_LOGIC.kicad_sch (2026-09-18)

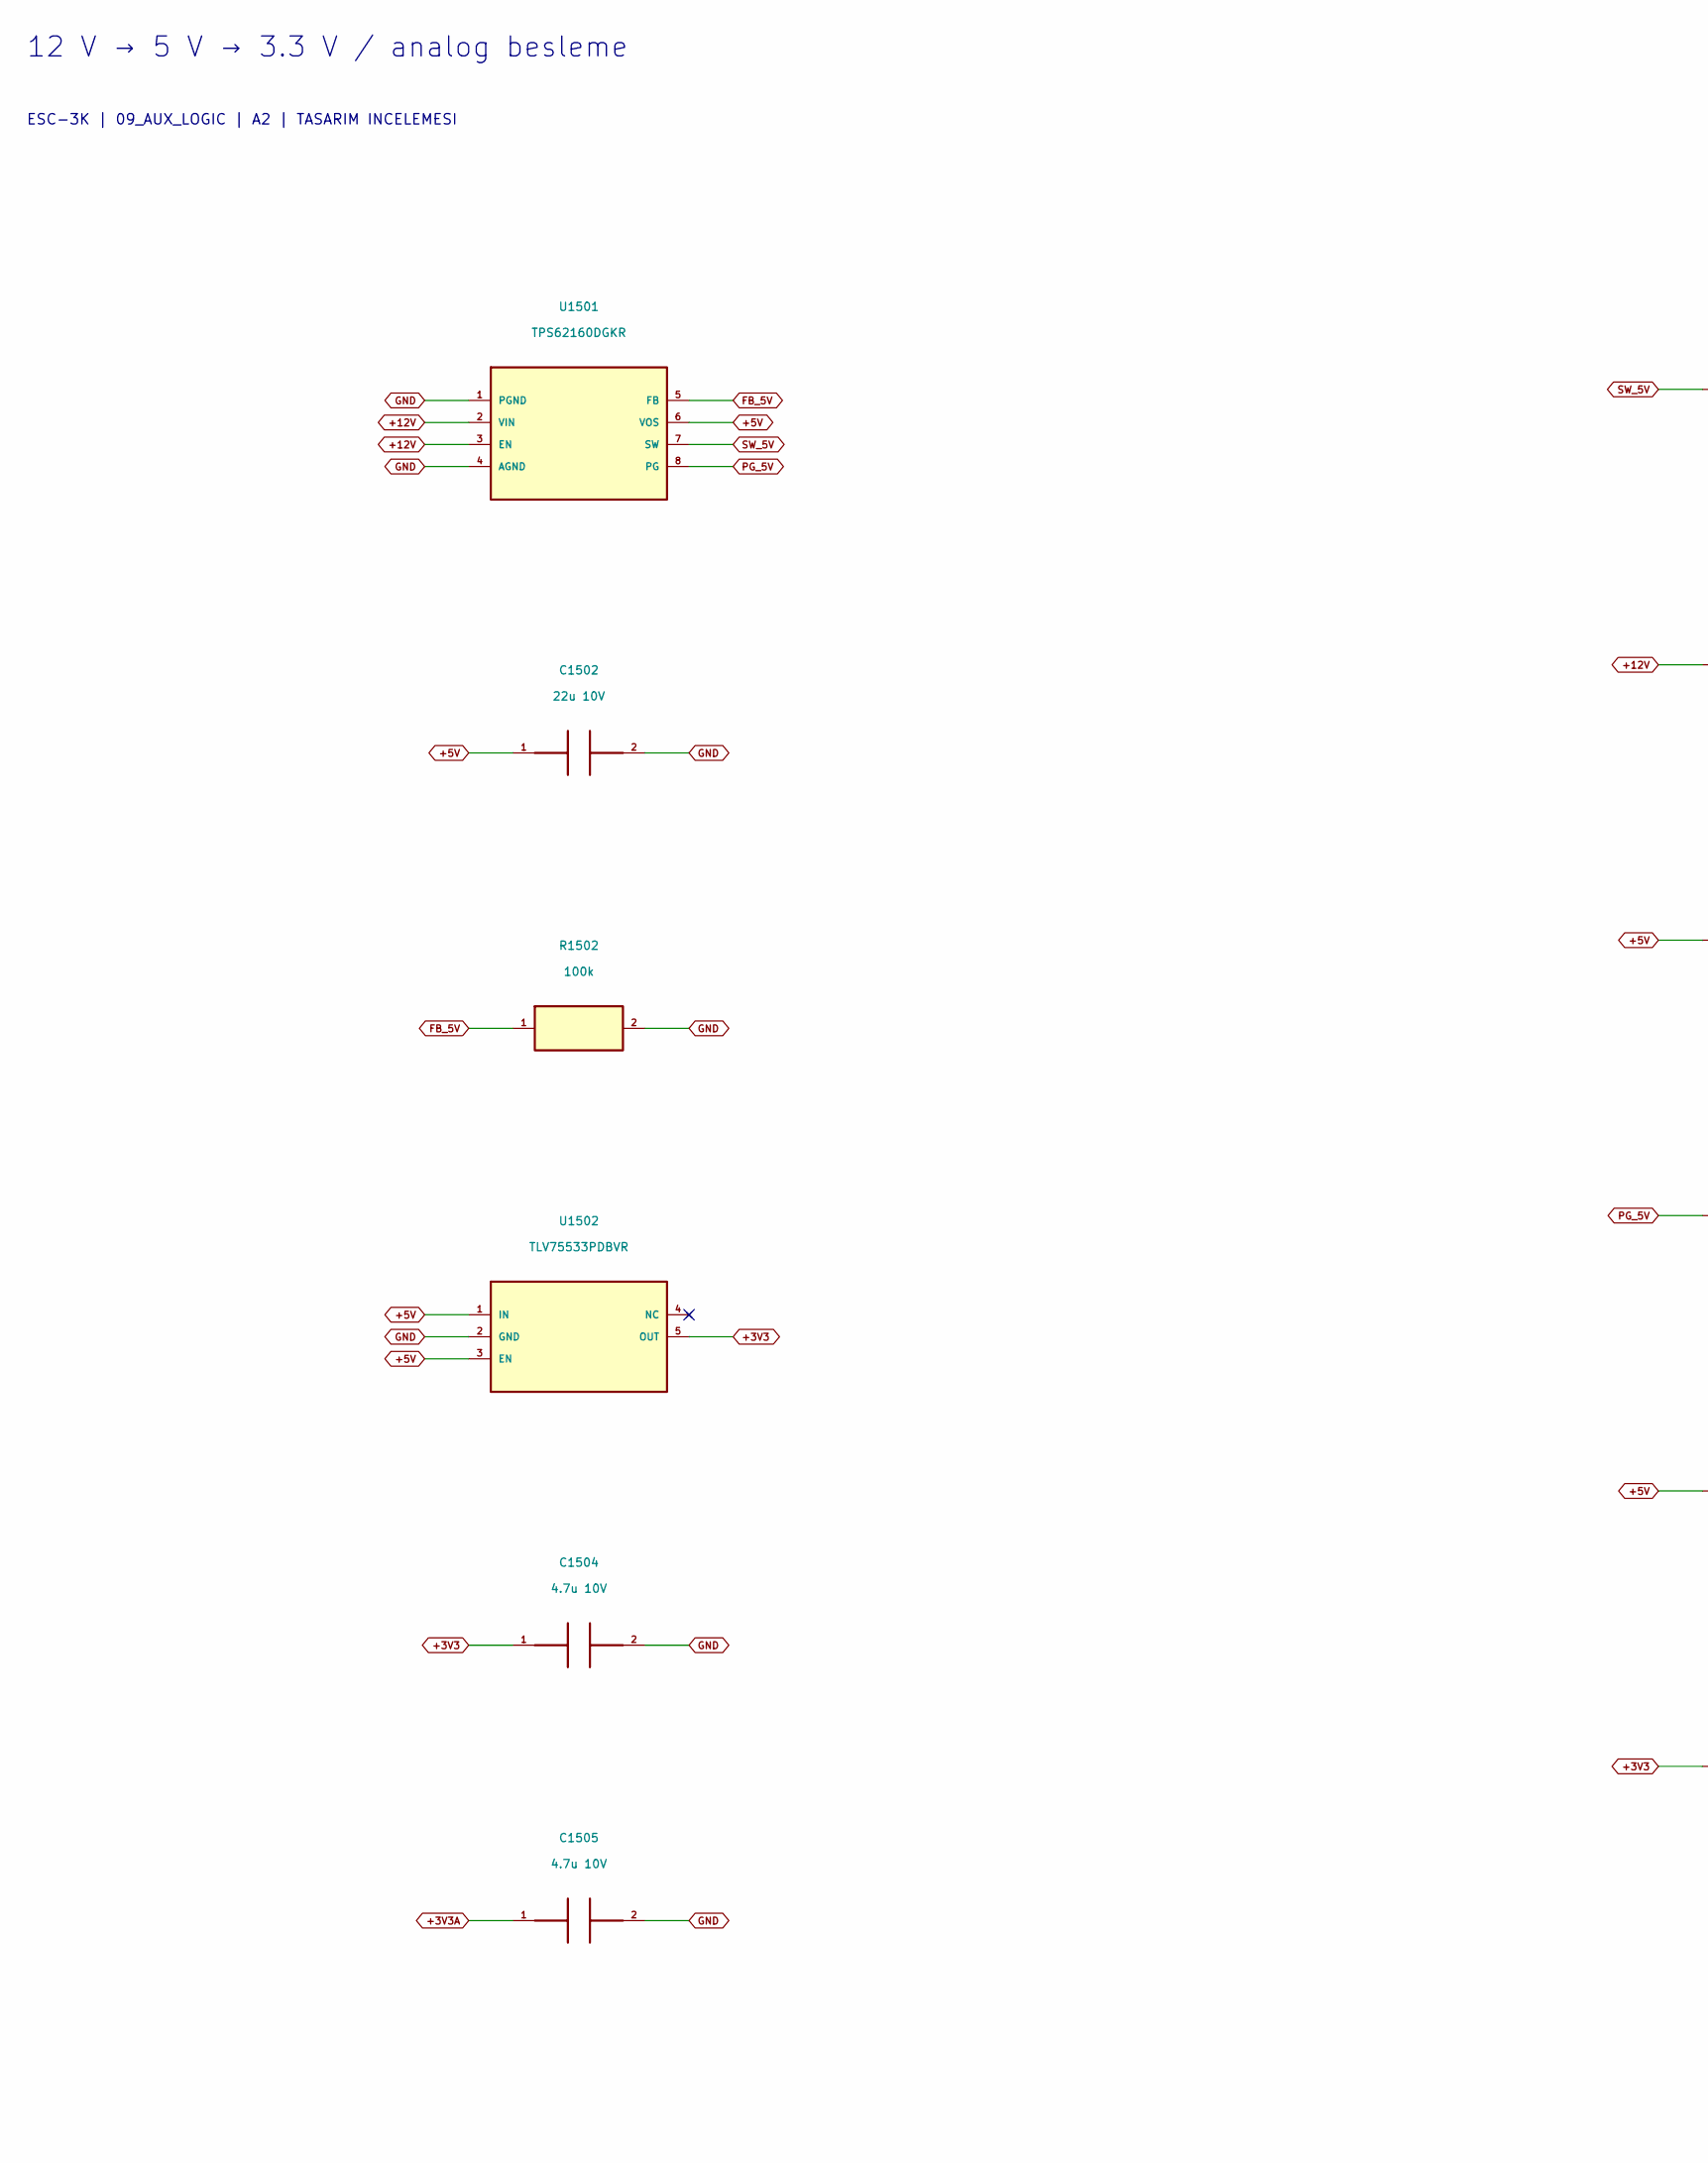
[picture p143: schematic 09_AUX_LOGIC.kicad_sch, part in row 1, column 1]

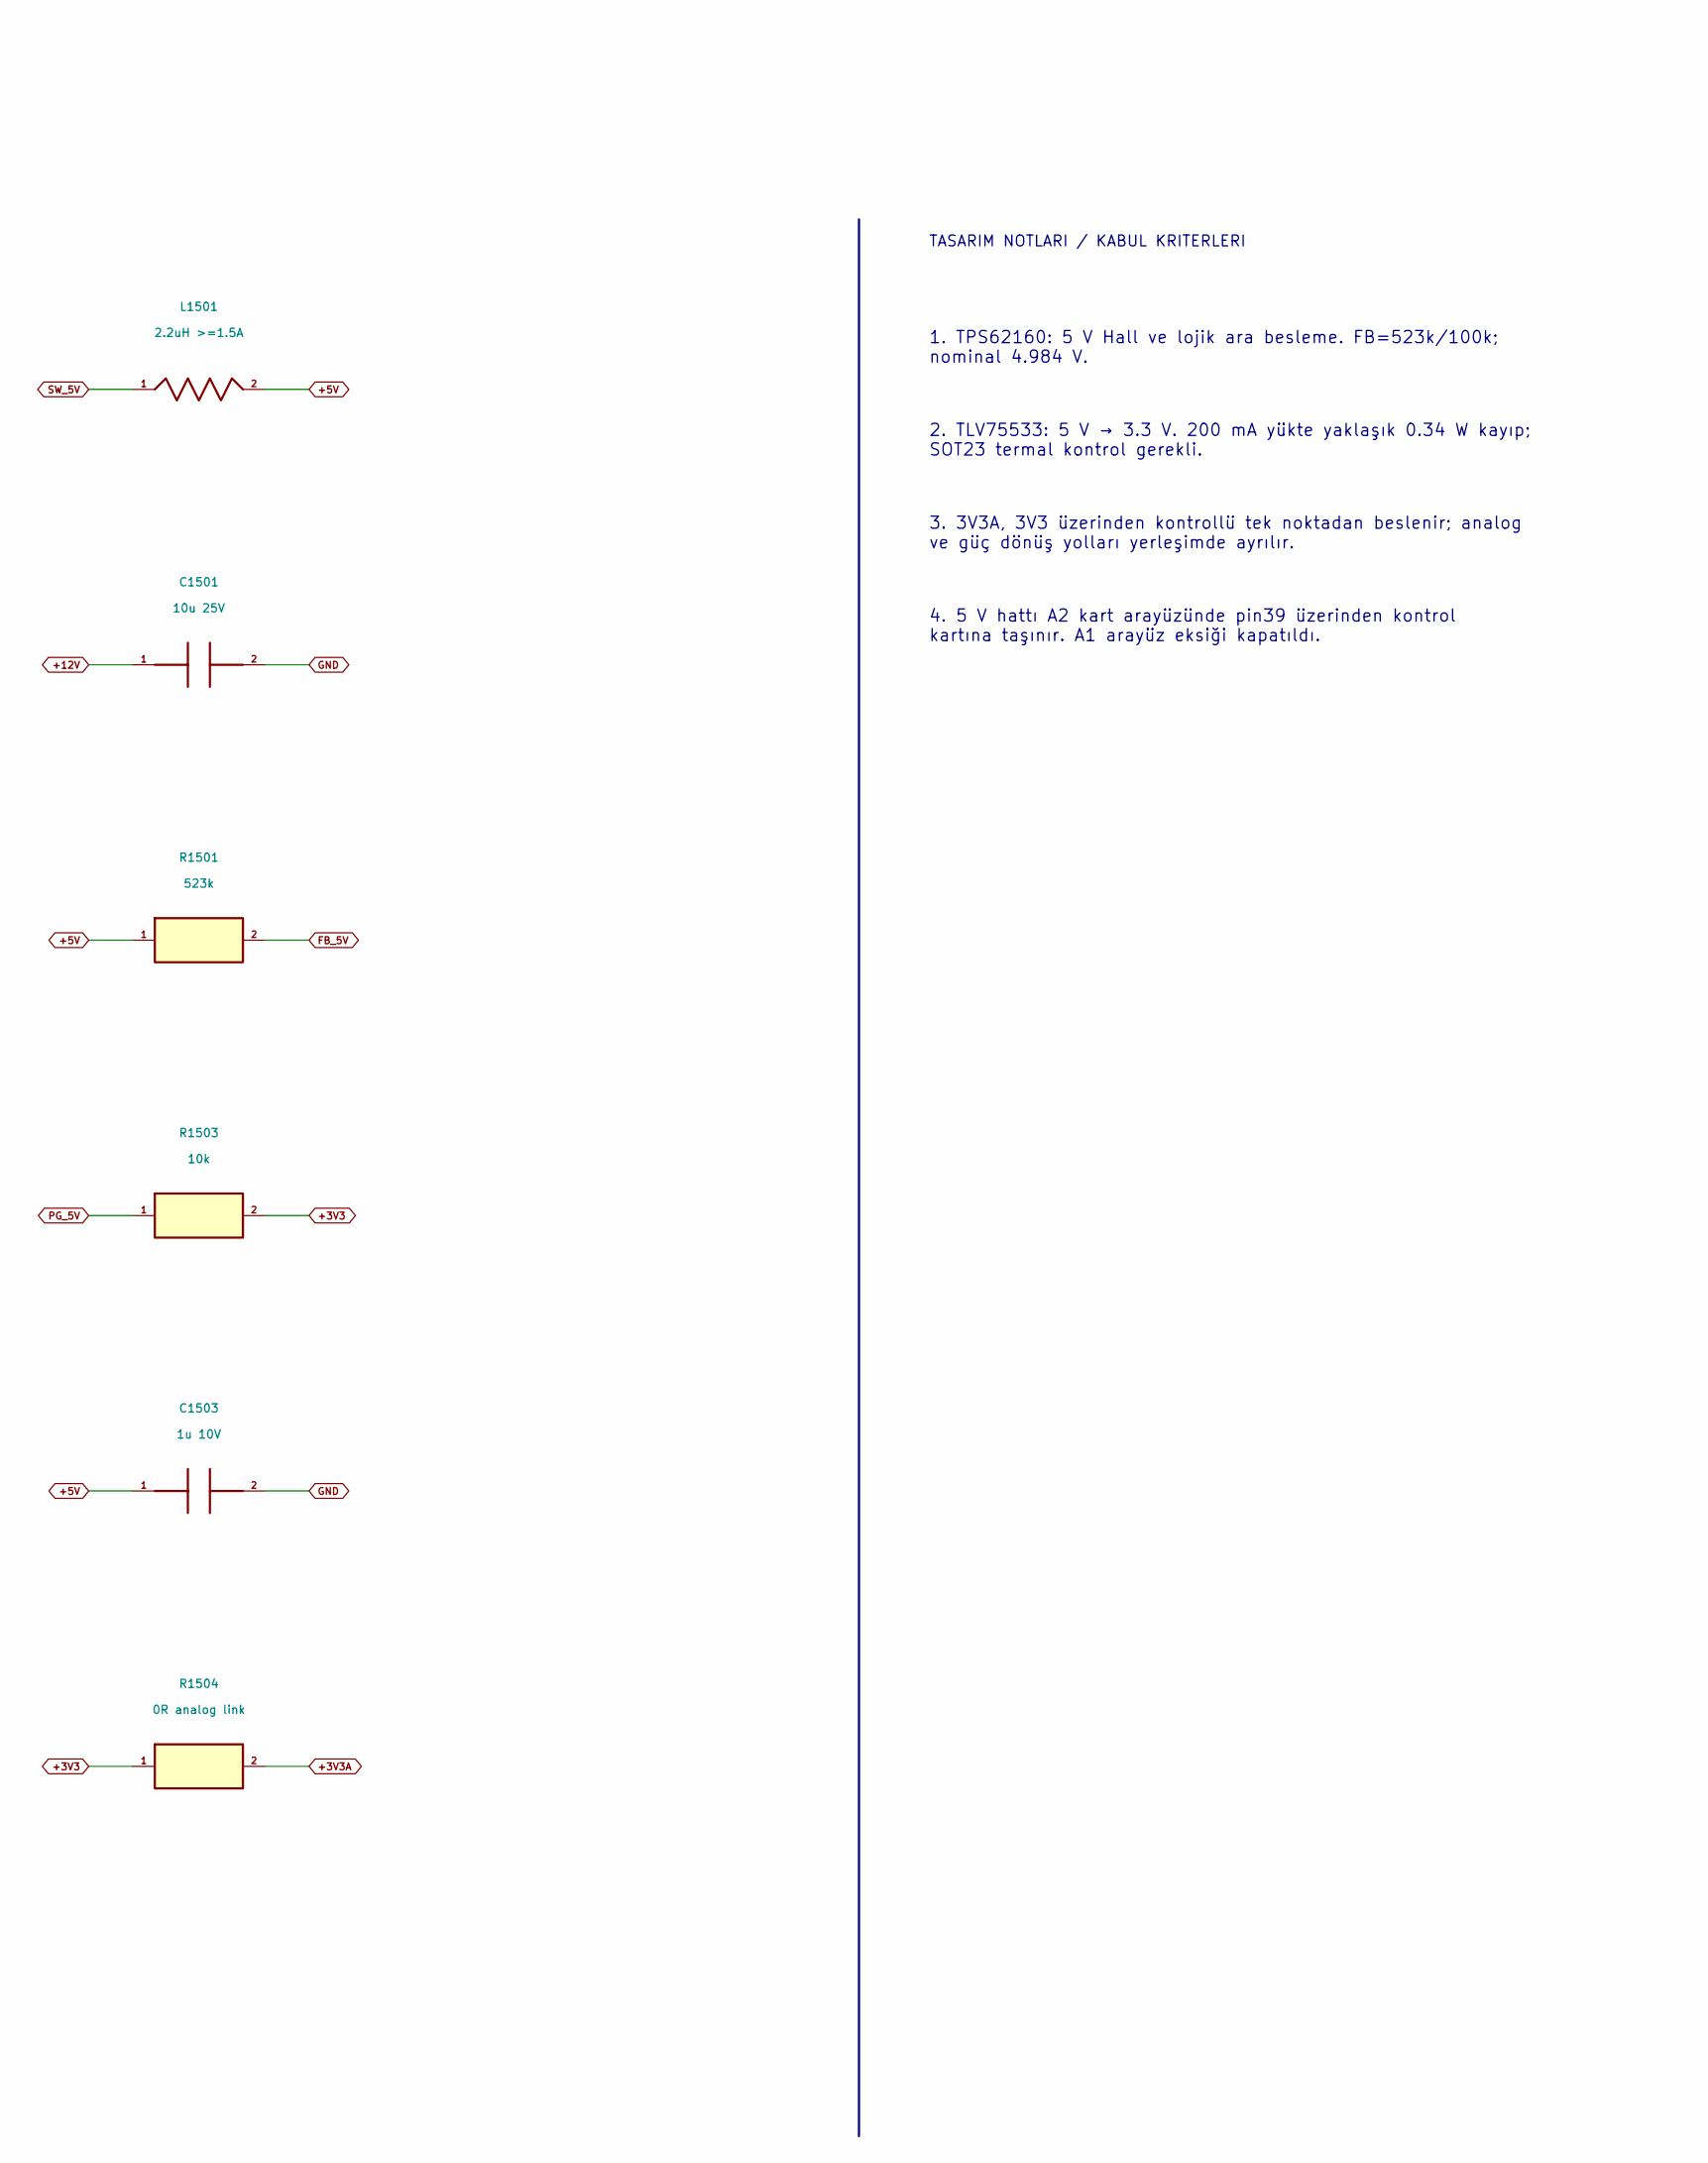
[picture p144: schematic 09_AUX_LOGIC.kicad_sch, part in row 1, column 2]

Parts:
C1501: 10u 25V
C1502: 22u 10V
C1503: 1u 10V; C_0805_2012Metric
C1504, C1505: 4.7u 10V
L1501: 2.2uH >=1.5A
R1501: 523k; R_0805_2012Metric; MPN RC0805FR-07523KL
R1502: 100k; R_0805_2012Metric; MPN RC0805FR-07100KL
R1503: 10k; R_0805_2012Metric; MPN RC0805FR-0710KL
R1504: 0R analog link; R_0805_2012Metric; MPN RC0805JR-070RL
U1501: TPS62160DGKR; VSSOP-8_3x3mm_P0.65mm; MPN TPS62160DGKR
U1502: TLV75533PDBVR; SOT-23-5; MPN TLV75533PDBVR

Connections:
+3V3: C1504.1, R1503.2, R1504.1, U1502.5 (OUT)
+3V3A: C1505.1, R1504.2
+5V: C1502.1, C1503.1, L1501.2, R1501.1, U1501.6 (VOS), U1502.1 (IN), U1502.3 (EN)
+12V: C1501.1, U1501.2 (VIN), U1501.3 (EN)
FB_5V: R1501.2, R1502.1, U1501.5 (FB)
GND: C1501.2, C1502.2, C1503.2, C1504.2, C1505.2, R1502.2, U1501.1 (PGND), U1501.4 (AGND), U1502.2 (GND)
PG_5V: R1503.1, U1501.8 (PG)
SW_5V: L1501.1, U1501.7 (SW)

Notes on the sheet:
12 V → 5 V → 3.3 V / analog besleme
ESC-3K | 09_AUX_LOGIC | A2 | TASARIM INCELEMESI
TASARIM NOTLARI / KABUL KRITERLERI
1. TPS62160: 5 V Hall ve lojik ara besleme. FB=523k/100k; nominal 4.984 V.
2. TLV75533: 5 V → 3.3 V. 200 mA yükte yaklaşık 0.34 W kayıp; SOT23 termal kontrol gerekli.
3. 3V3A, 3V3 üzerinden kontrollü tek noktadan beslenir; analog ve güç dönüş yolları yerleşimde ayrılır.
4. 5 V hattı A2 kart arayüzünde pin39 üzerinden kontrol kartına taşınır. A1 arayüz eksiği kapatıldı.
