mekiciepcas/ESC-Ai/ESC_V2/hardware_a2/11_MCU_SUPPORT.kicad_sch

## KiCad design ESC_V2/hardware_a2/11_MCU_SUPPORT.kicad_sch (2026-09-18)

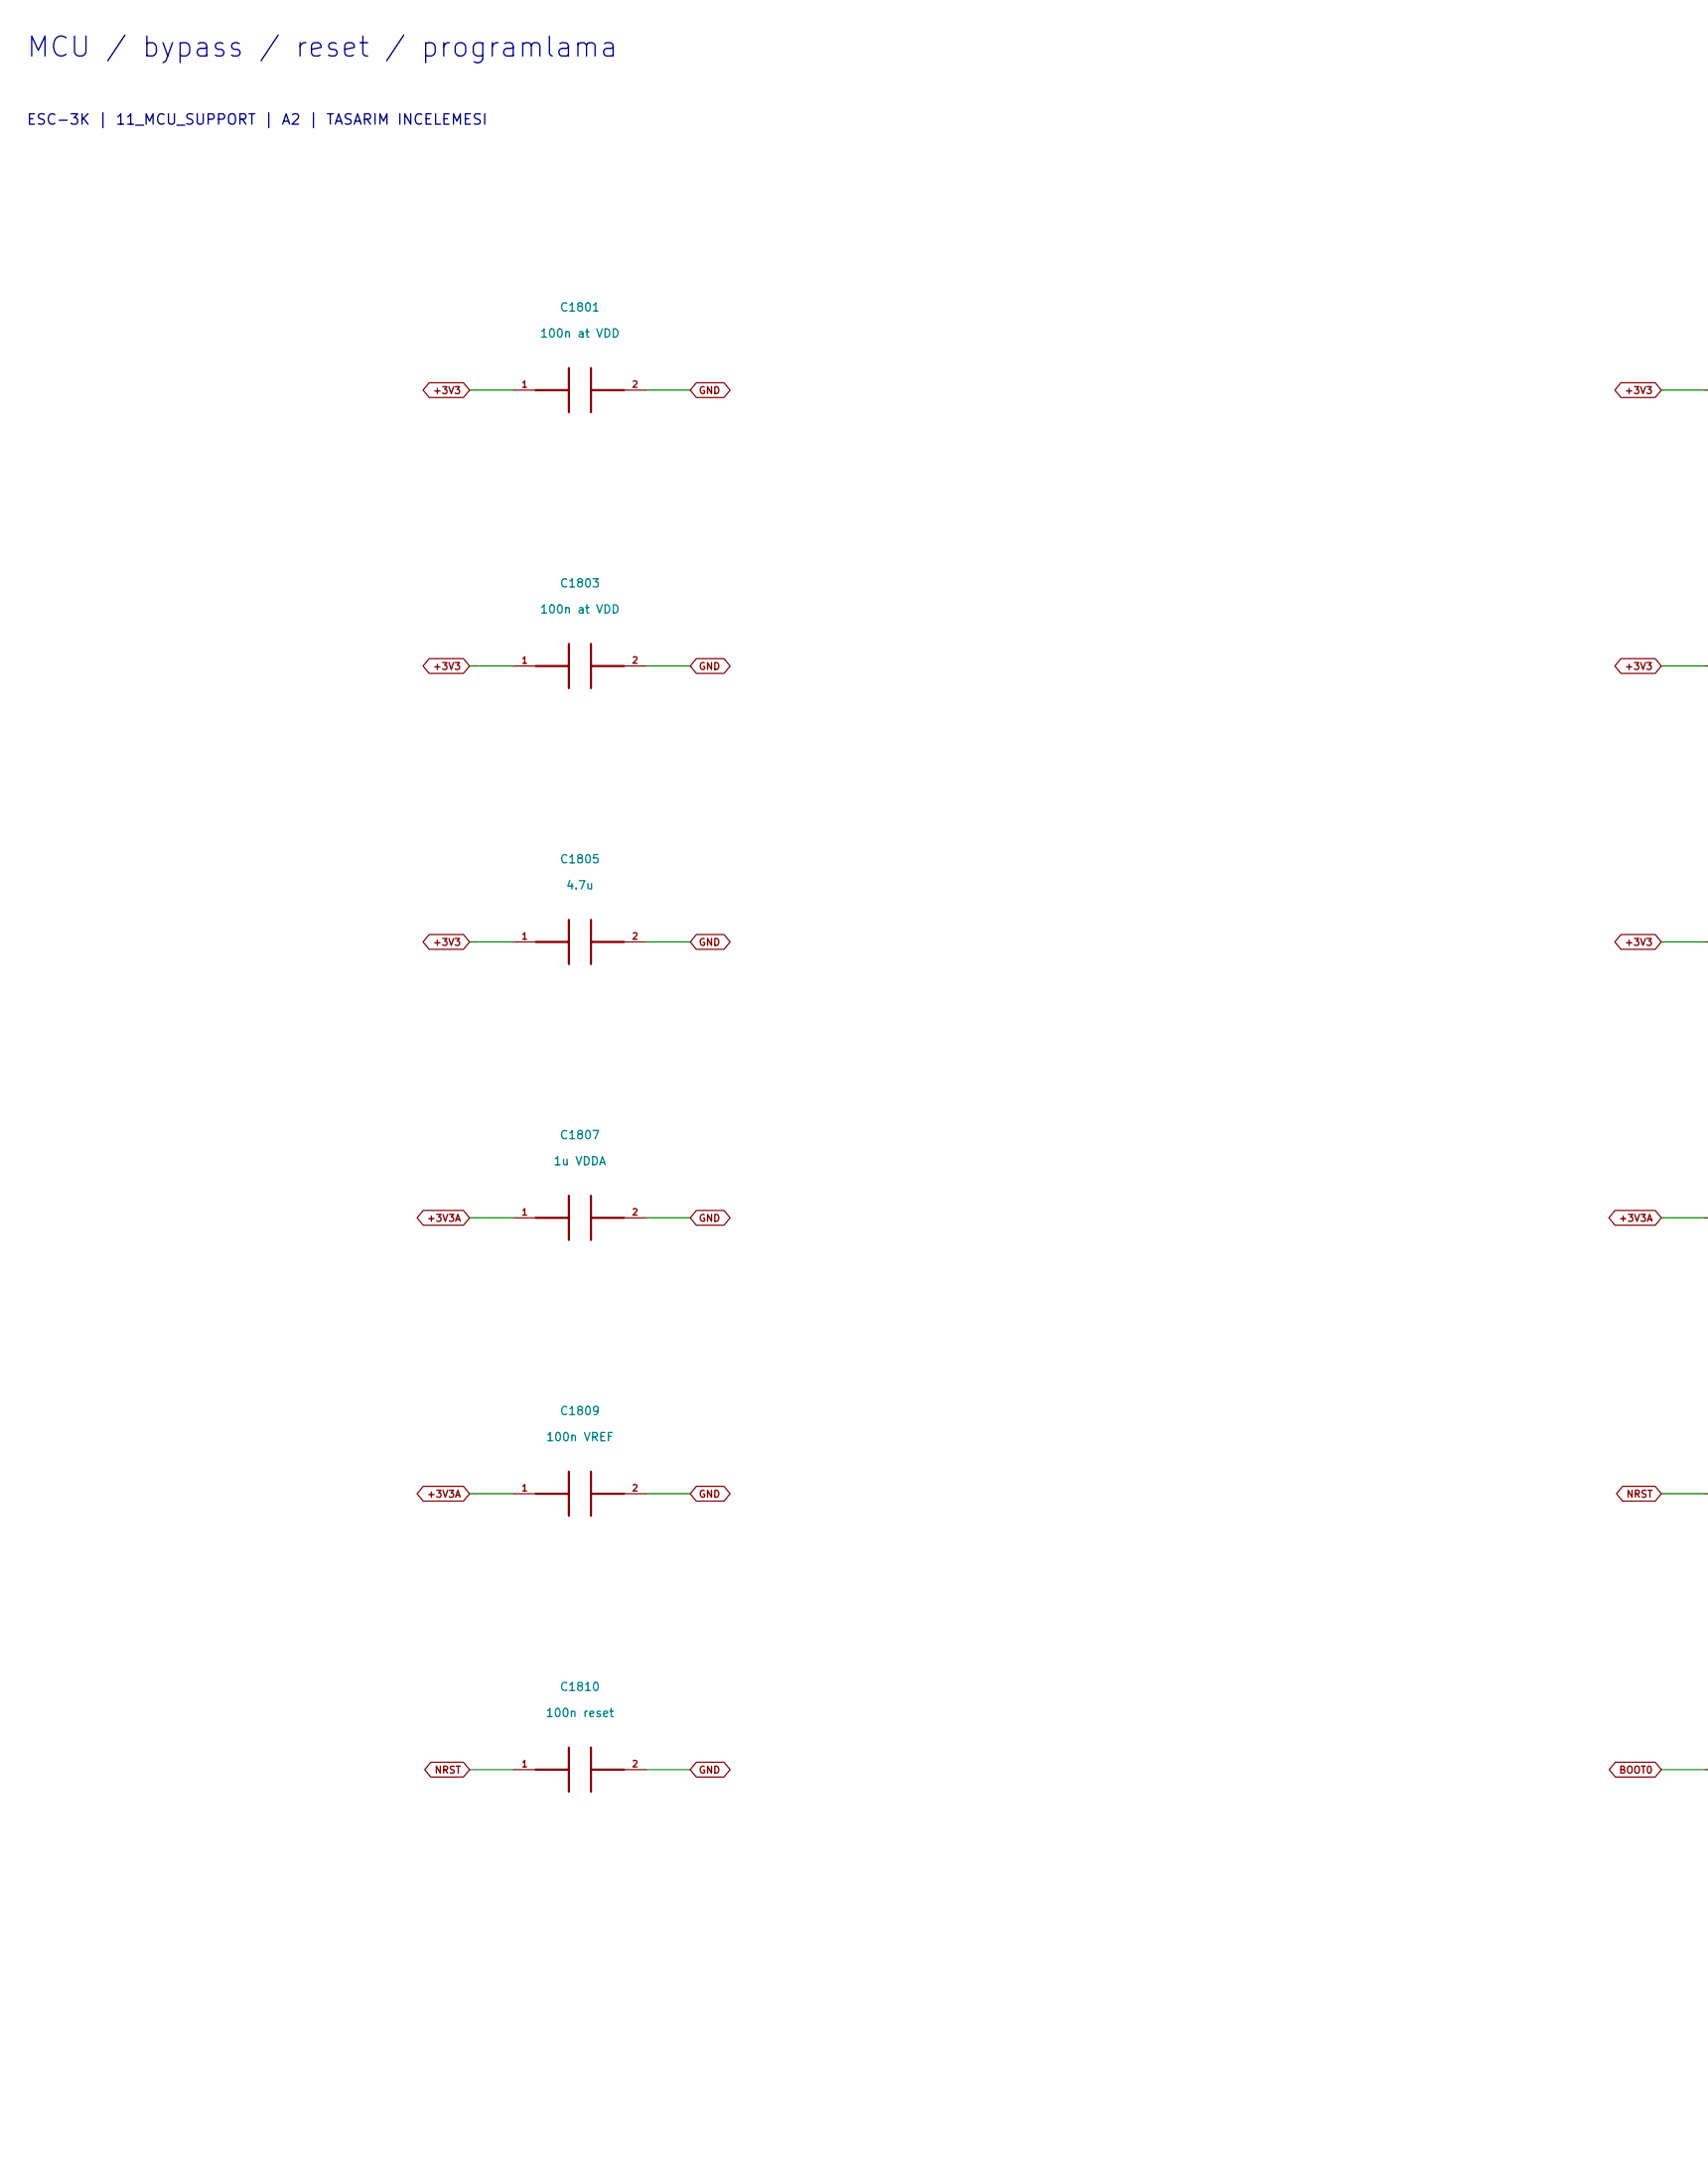
[picture p145: schematic 11_MCU_SUPPORT.kicad_sch, part in row 1, column 1]

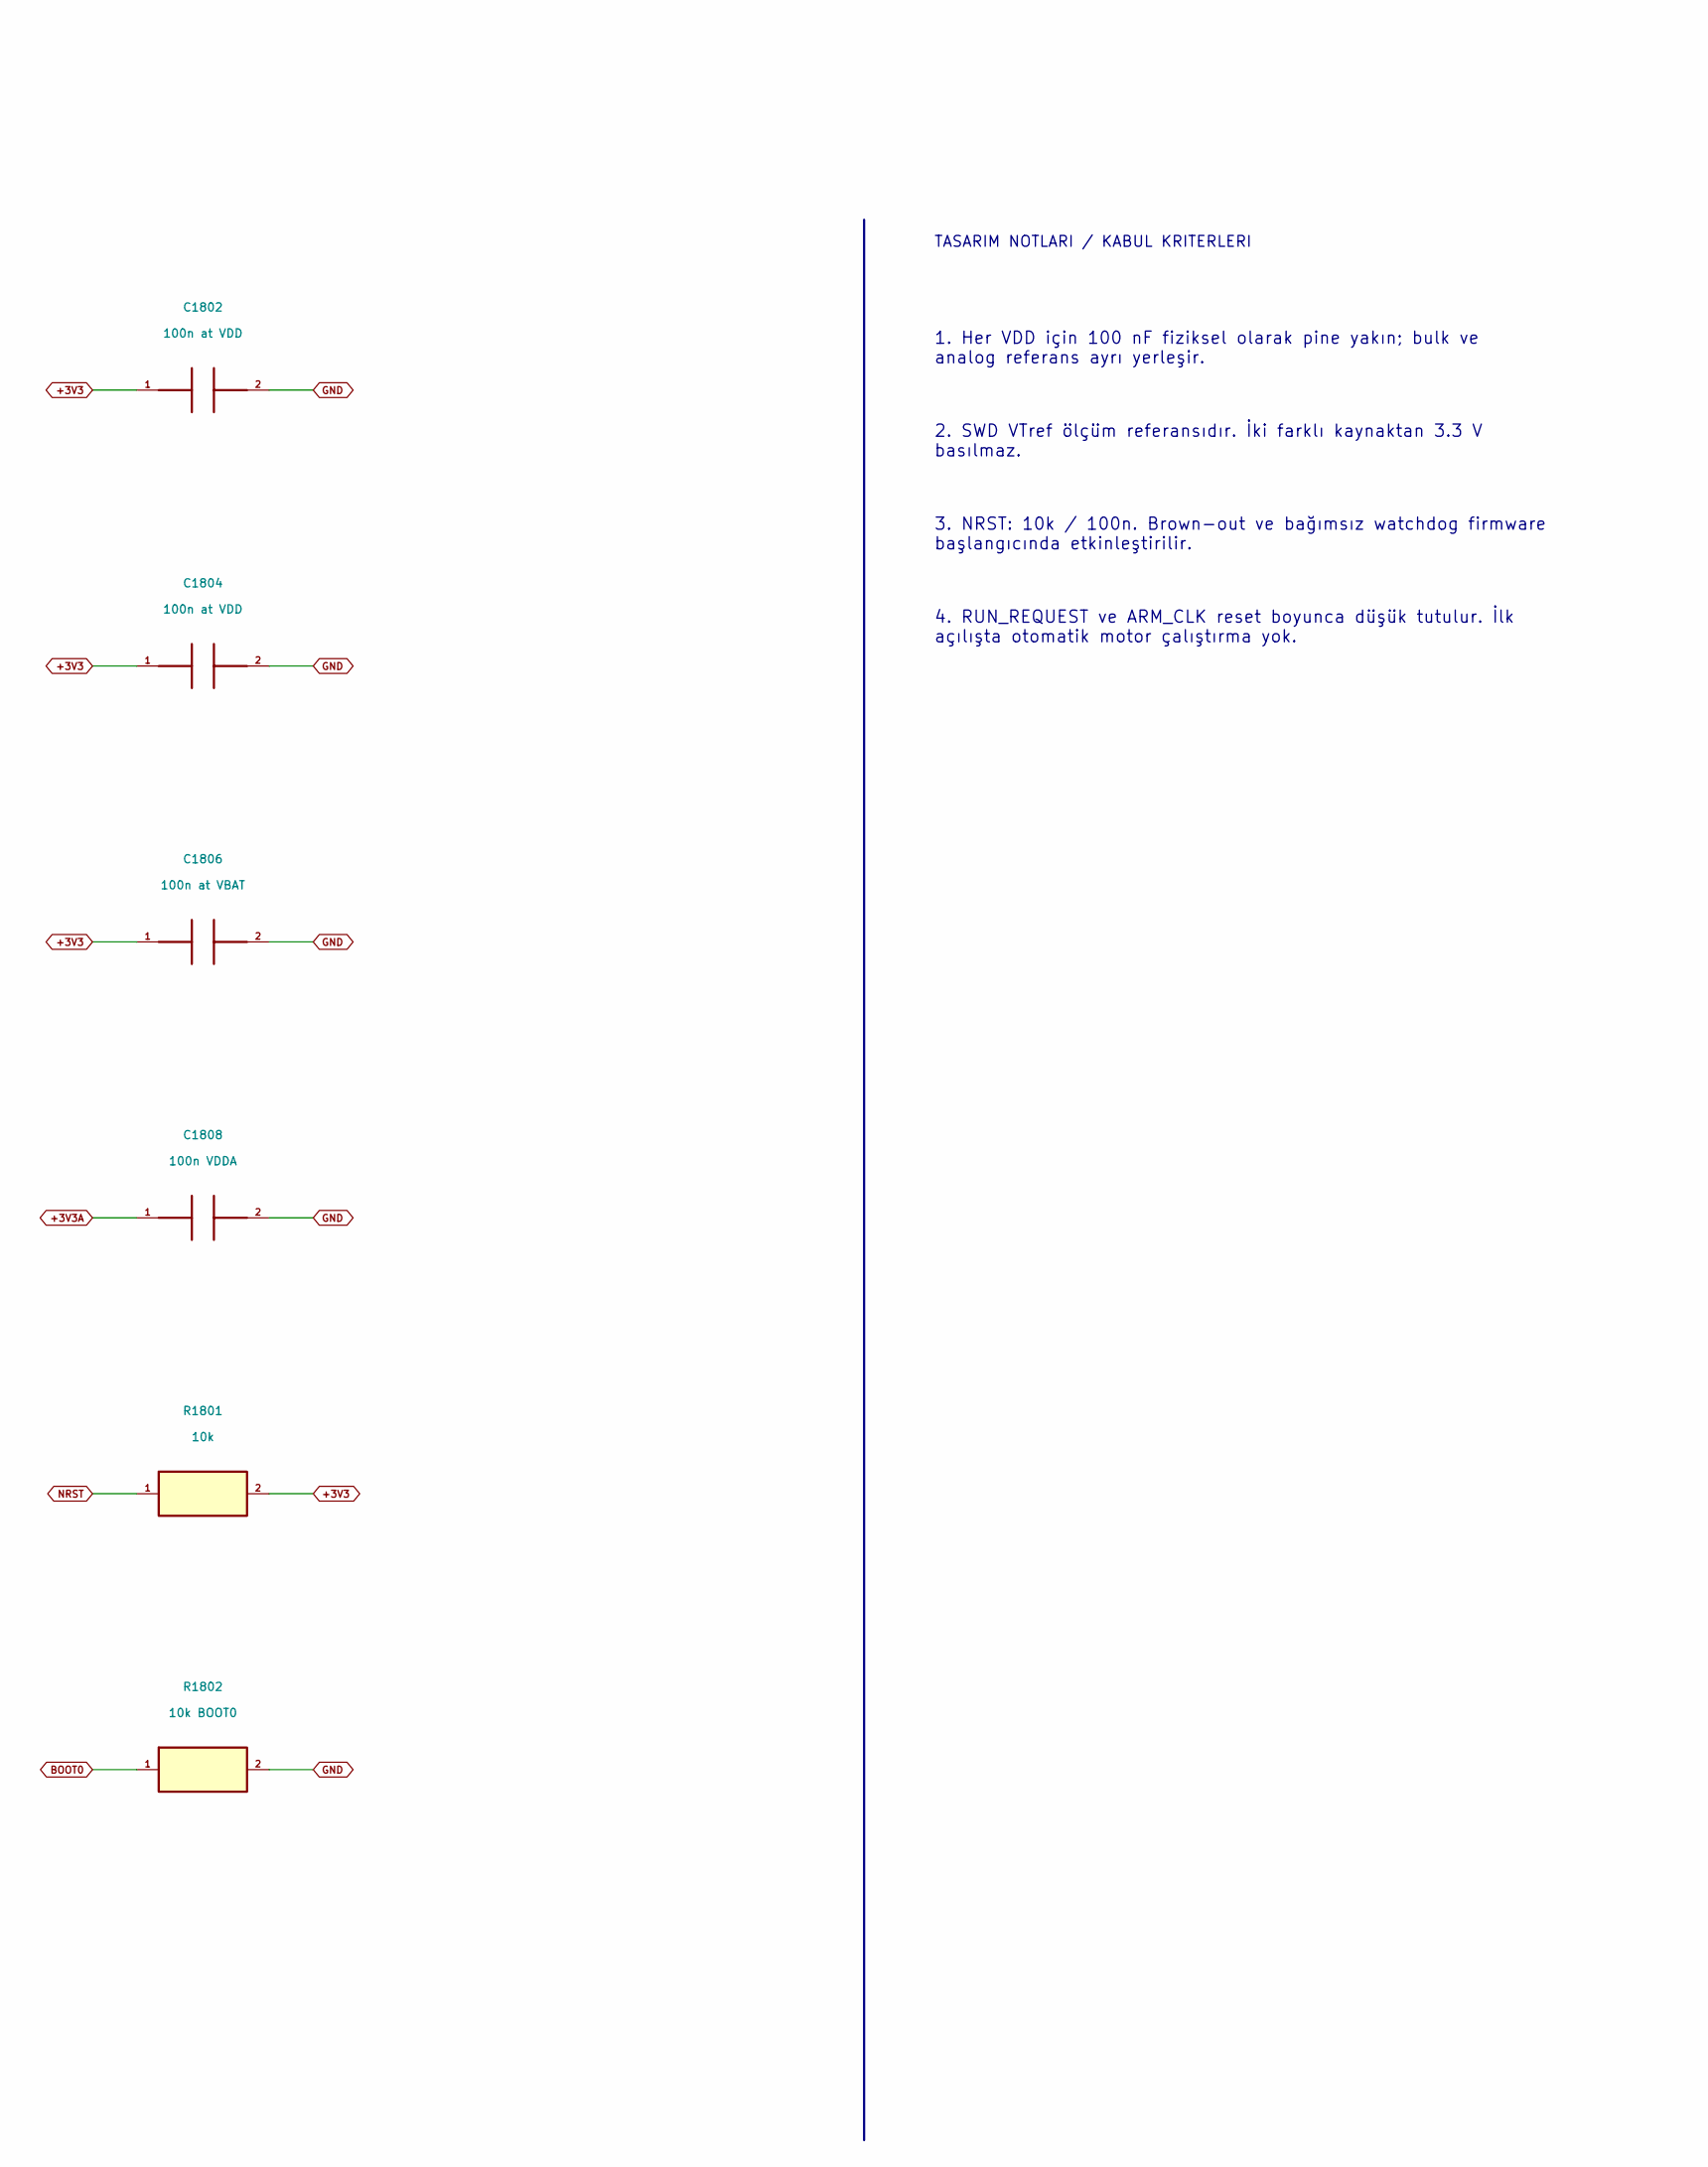
[picture p146: schematic 11_MCU_SUPPORT.kicad_sch, part in row 1, column 2]

Parts:
C1801, C1802, C1803, C1804: 100n at VDD; C_0805_2012Metric; MPN C2012X7R2A104K125AA
C1805: 4.7u
C1806: 100n at VBAT; C_0805_2012Metric; MPN C2012X7R2A104K125AA
C1807: 1u VDDA; C_0805_2012Metric
C1808: 100n VDDA; C_0805_2012Metric; MPN C2012X7R2A104K125AA
C1809: 100n VREF; C_0805_2012Metric; MPN C2012X7R2A104K125AA
C1810: 100n reset; C_0805_2012Metric; MPN C2012X7R2A104K125AA
R1801: 10k; R_0805_2012Metric; MPN RC0805FR-0710KL
R1802: 10k BOOT0; R_0805_2012Metric; MPN RC0805FR-0710KL

Connections:
+3V3: C1801.1, C1802.1, C1803.1, C1804.1, C1805.1, C1806.1, R1801.2
+3V3A: C1807.1, C1808.1, C1809.1
BOOT0: R1802.1
GND: C1801.2, C1802.2, C1803.2, C1804.2, C1805.2, C1806.2, C1807.2, C1808.2, C1809.2, C1810.2, R1802.2
NRST: C1810.1, R1801.1

Notes on the sheet:
MCU / bypass / reset / programlama
ESC-3K | 11_MCU_SUPPORT | A2 | TASARIM INCELEMESI
TASARIM NOTLARI / KABUL KRITERLERI
1. Her VDD için 100 nF fiziksel olarak pine yakın; bulk ve analog referans ayrı yerleşir.
2. SWD VTref ölçüm referansıdır. İki farklı kaynaktan 3.3 V basılmaz.
3. NRST: 10k / 100n. Brown-out ve bağımsız watchdog firmware başlangıcında etkinleştirilir.
4. RUN_REQUEST ve ARM_CLK reset boyunca düşük tutulur. İlk açılışta otomatik motor çalıştırma yok.
