mekiciepcas/ESC-Ai/ESC_V2/hardware_a2/11_MCU_SUPPORT_2.kicad_sch

## KiCad design ESC_V2/hardware_a2/11_MCU_SUPPORT_2.kicad_sch (2026-09-18)

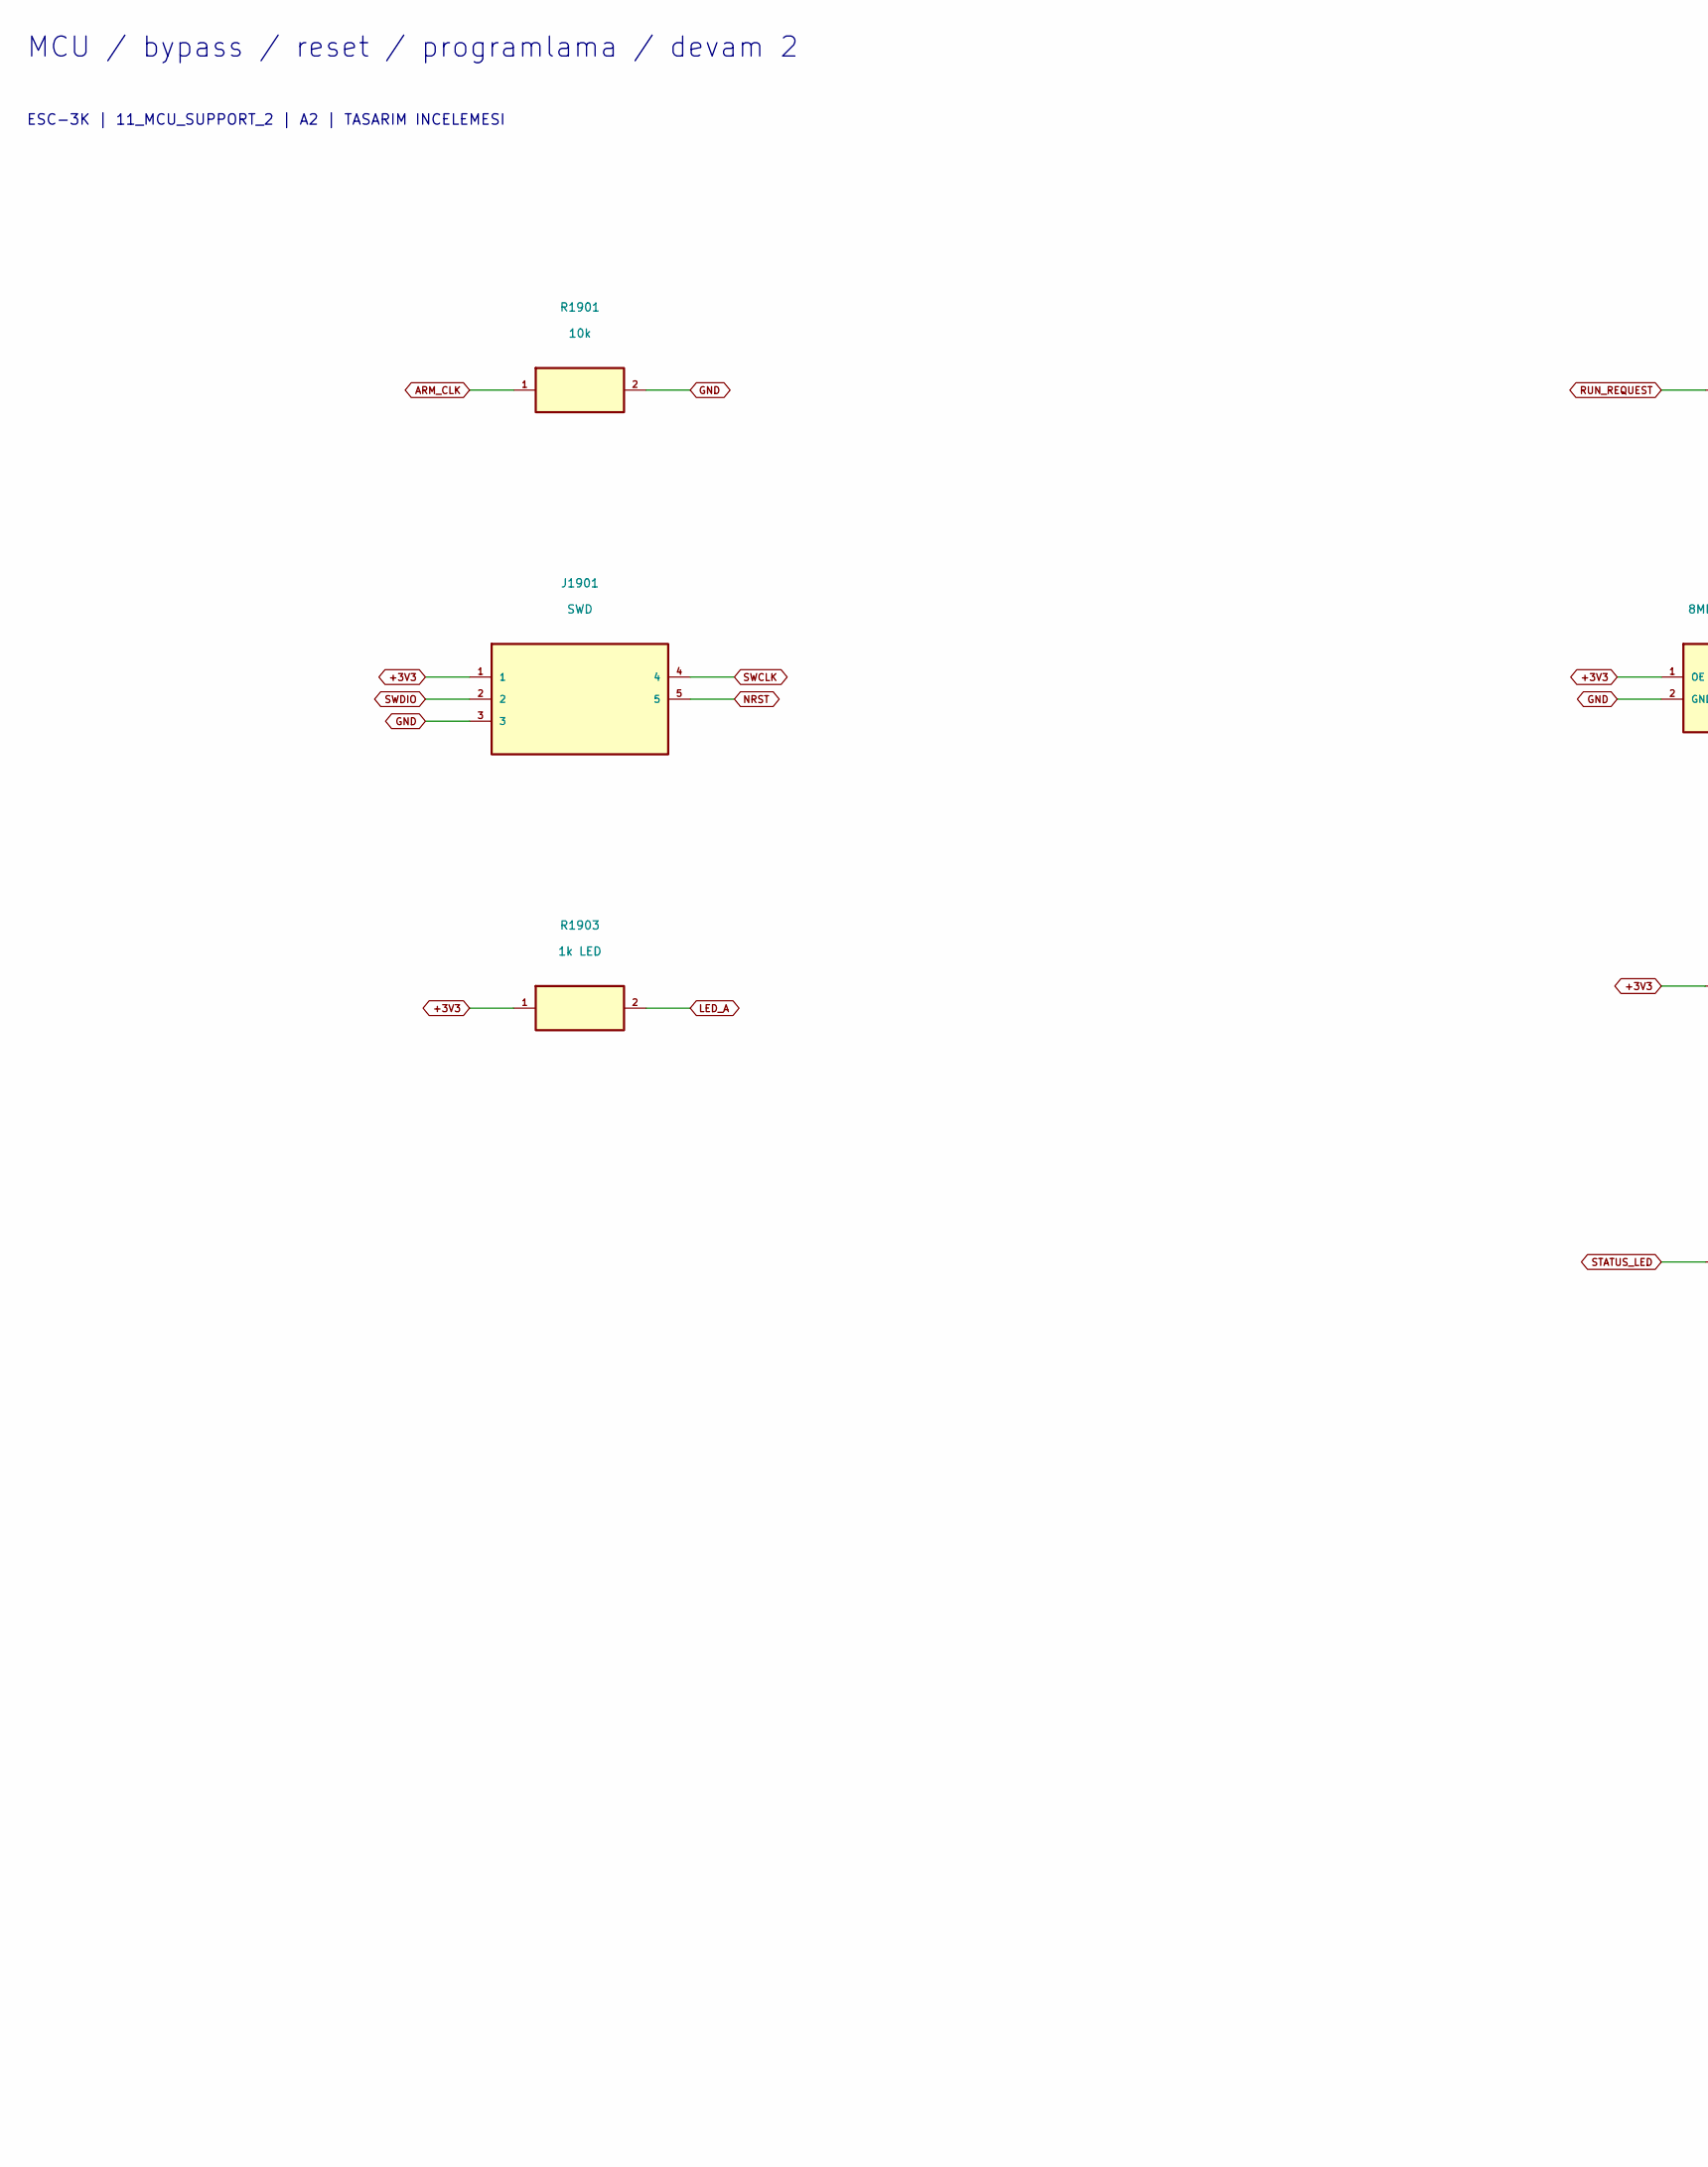
[picture p147: schematic 11_MCU_SUPPORT_2.kicad_sch, part in row 1, column 1]

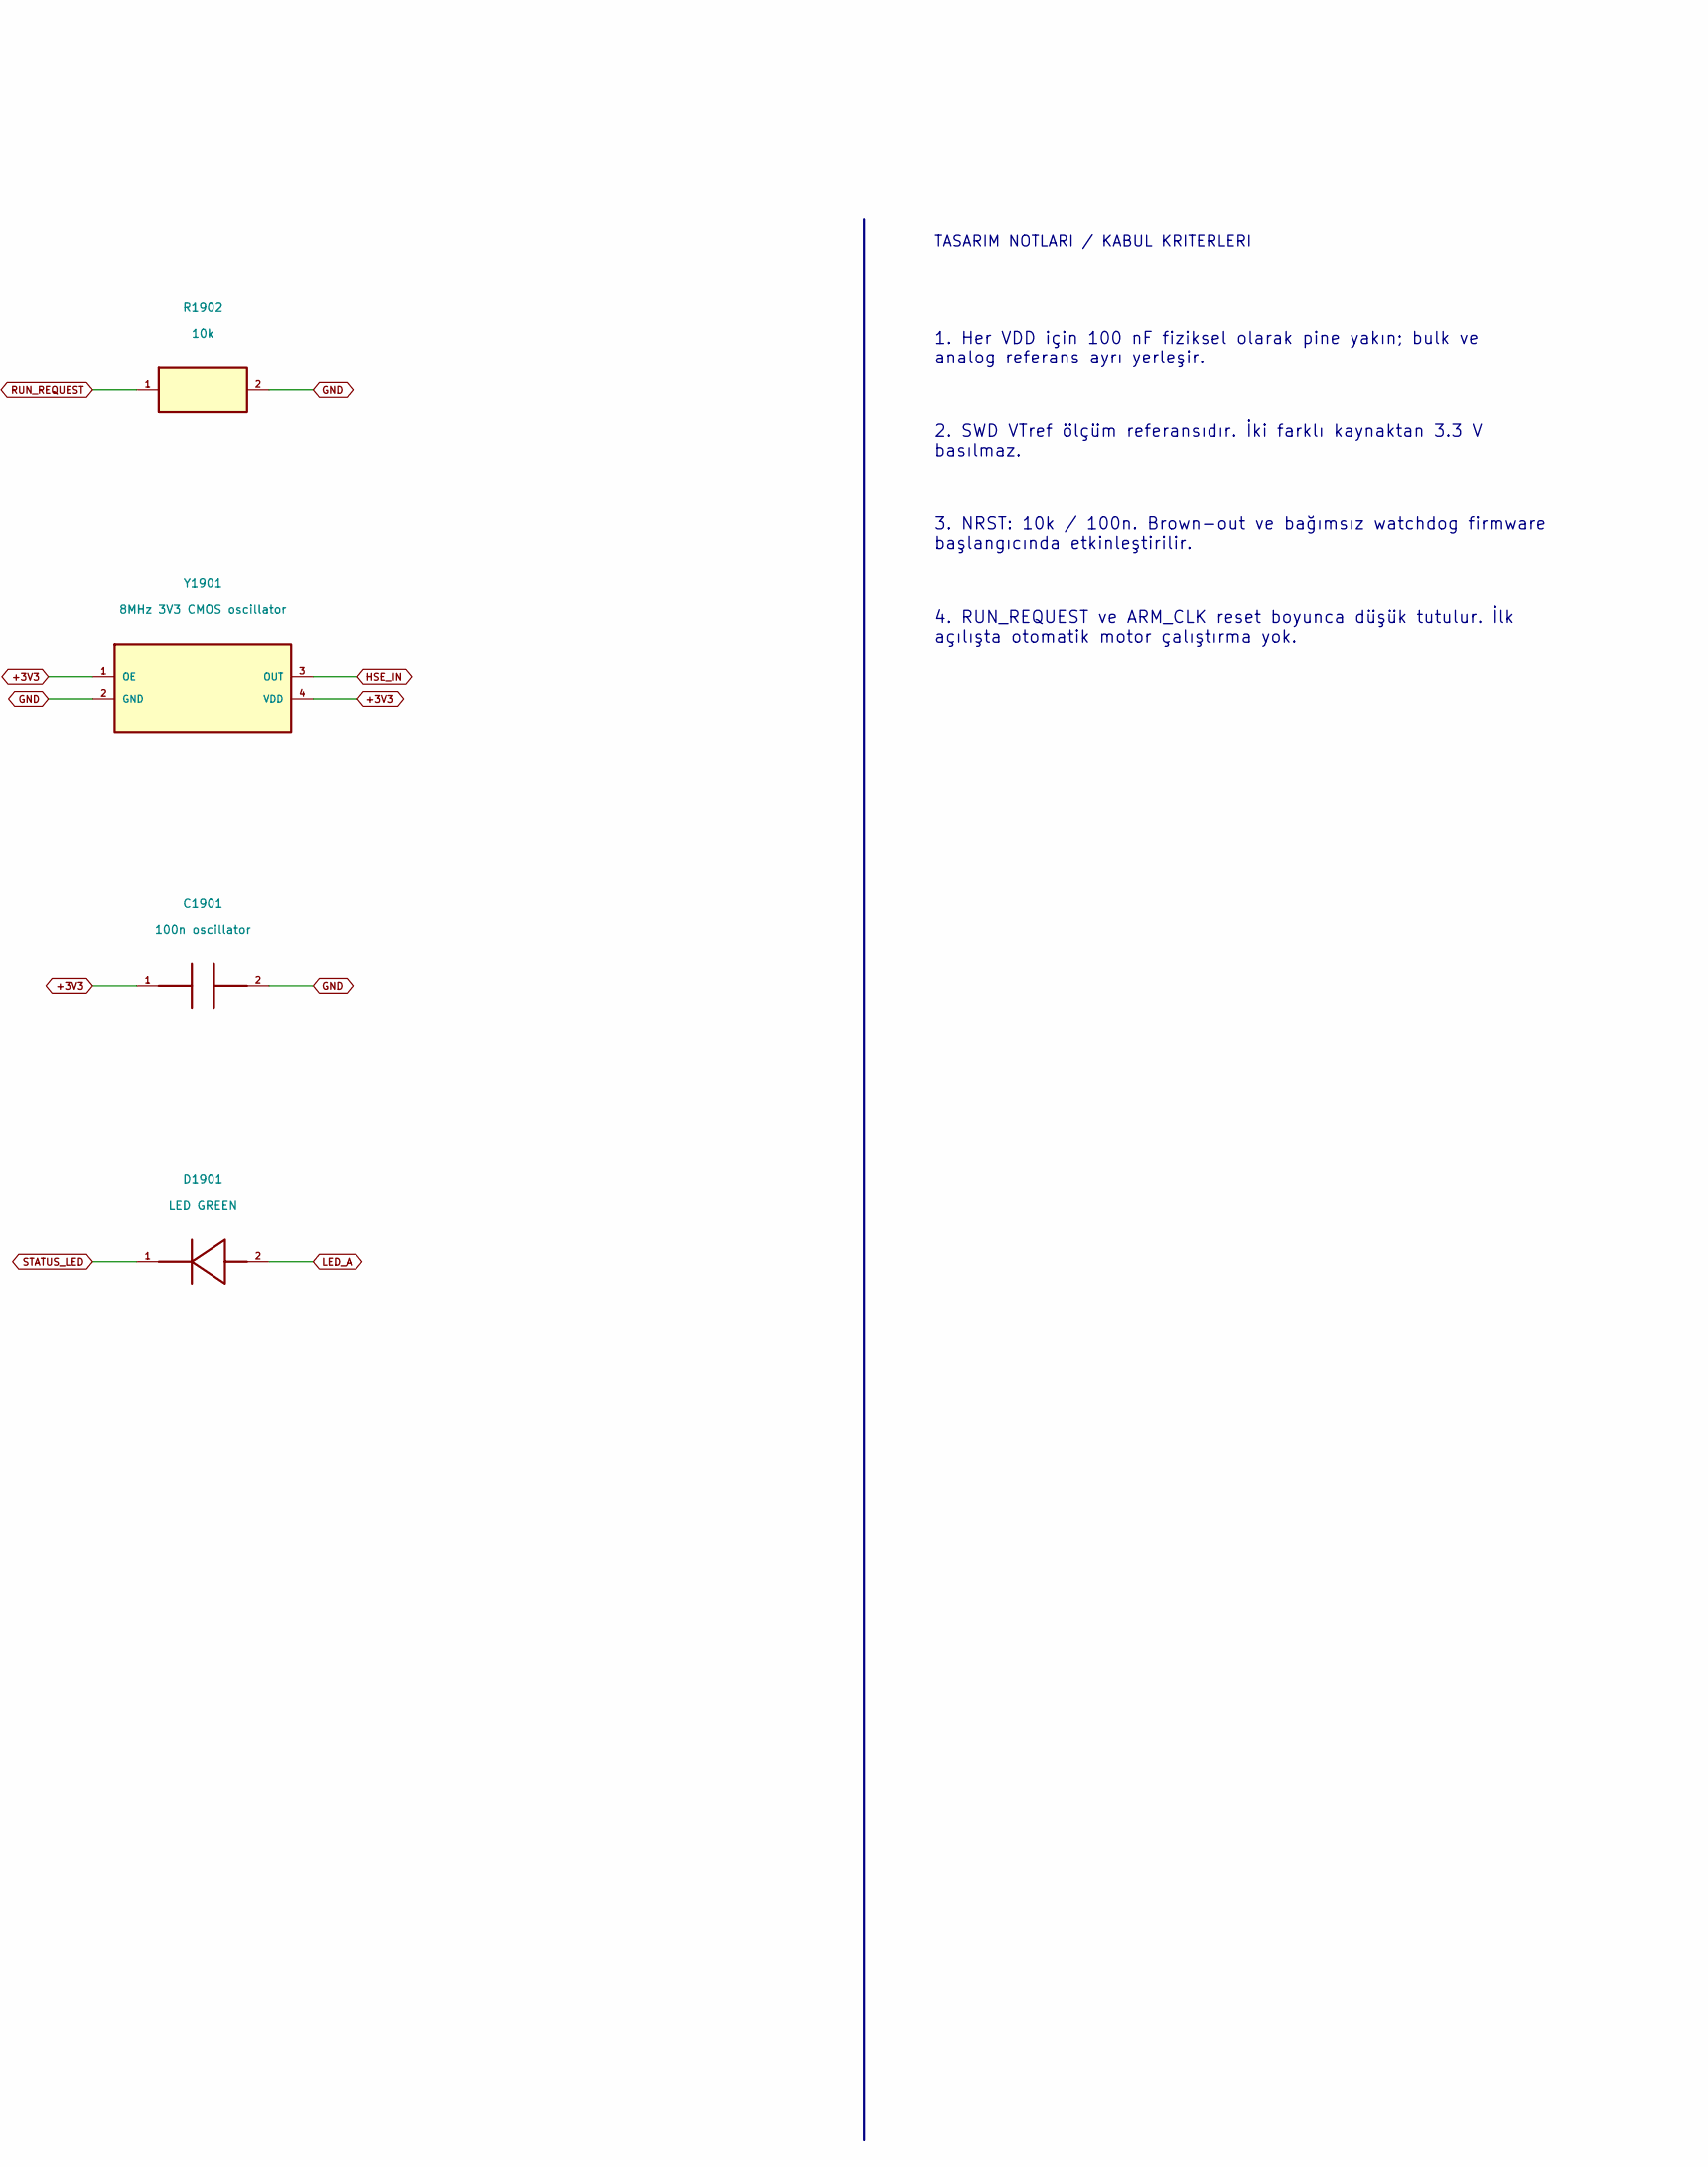
[picture p148: schematic 11_MCU_SUPPORT_2.kicad_sch, part in row 1, column 2]

Parts:
C1901: 100n oscillator; C_0805_2012Metric; MPN C2012X7R2A104K125AA
D1901: LED GREEN
J1901: SWD
R1901, R1902: 10k; R_0805_2012Metric; MPN RC0805FR-0710KL
R1903: 1k LED; R_0805_2012Metric; MPN RC0805FR-071KL
Y1901: 8MHz 3V3 CMOS oscillator

Connections:
+3V3: C1901.1, J1901.1, R1903.1, Y1901.1 (OE), Y1901.4 (VDD)
ARM_CLK: R1901.1
GND: C1901.2, J1901.3, R1901.2, R1902.2, Y1901.2 (GND)
HSE_IN: Y1901.3 (OUT)
LED_A: D1901.2 (A), R1903.2
NRST: J1901.5
RUN_REQUEST: R1902.1
STATUS_LED: D1901.1 (K)
SWCLK: J1901.4
SWDIO: J1901.2

Notes on the sheet:
MCU / bypass / reset / programlama / devam 2
ESC-3K | 11_MCU_SUPPORT_2 | A2 | TASARIM INCELEMESI
TASARIM NOTLARI / KABUL KRITERLERI
1. Her VDD için 100 nF fiziksel olarak pine yakın; bulk ve analog referans ayrı yerleşir.
2. SWD VTref ölçüm referansıdır. İki farklı kaynaktan 3.3 V basılmaz.
3. NRST: 10k / 100n. Brown-out ve bağımsız watchdog firmware başlangıcında etkinleştirilir.
4. RUN_REQUEST ve ARM_CLK reset boyunca düşük tutulur. İlk açılışta otomatik motor çalıştırma yok.
