mekiciepcas/ESC-Ai/ESC_V2/hardware_a2/12_CAN_UART.kicad_sch

## KiCad design ESC_V2/hardware_a2/12_CAN_UART.kicad_sch (2026-09-18)

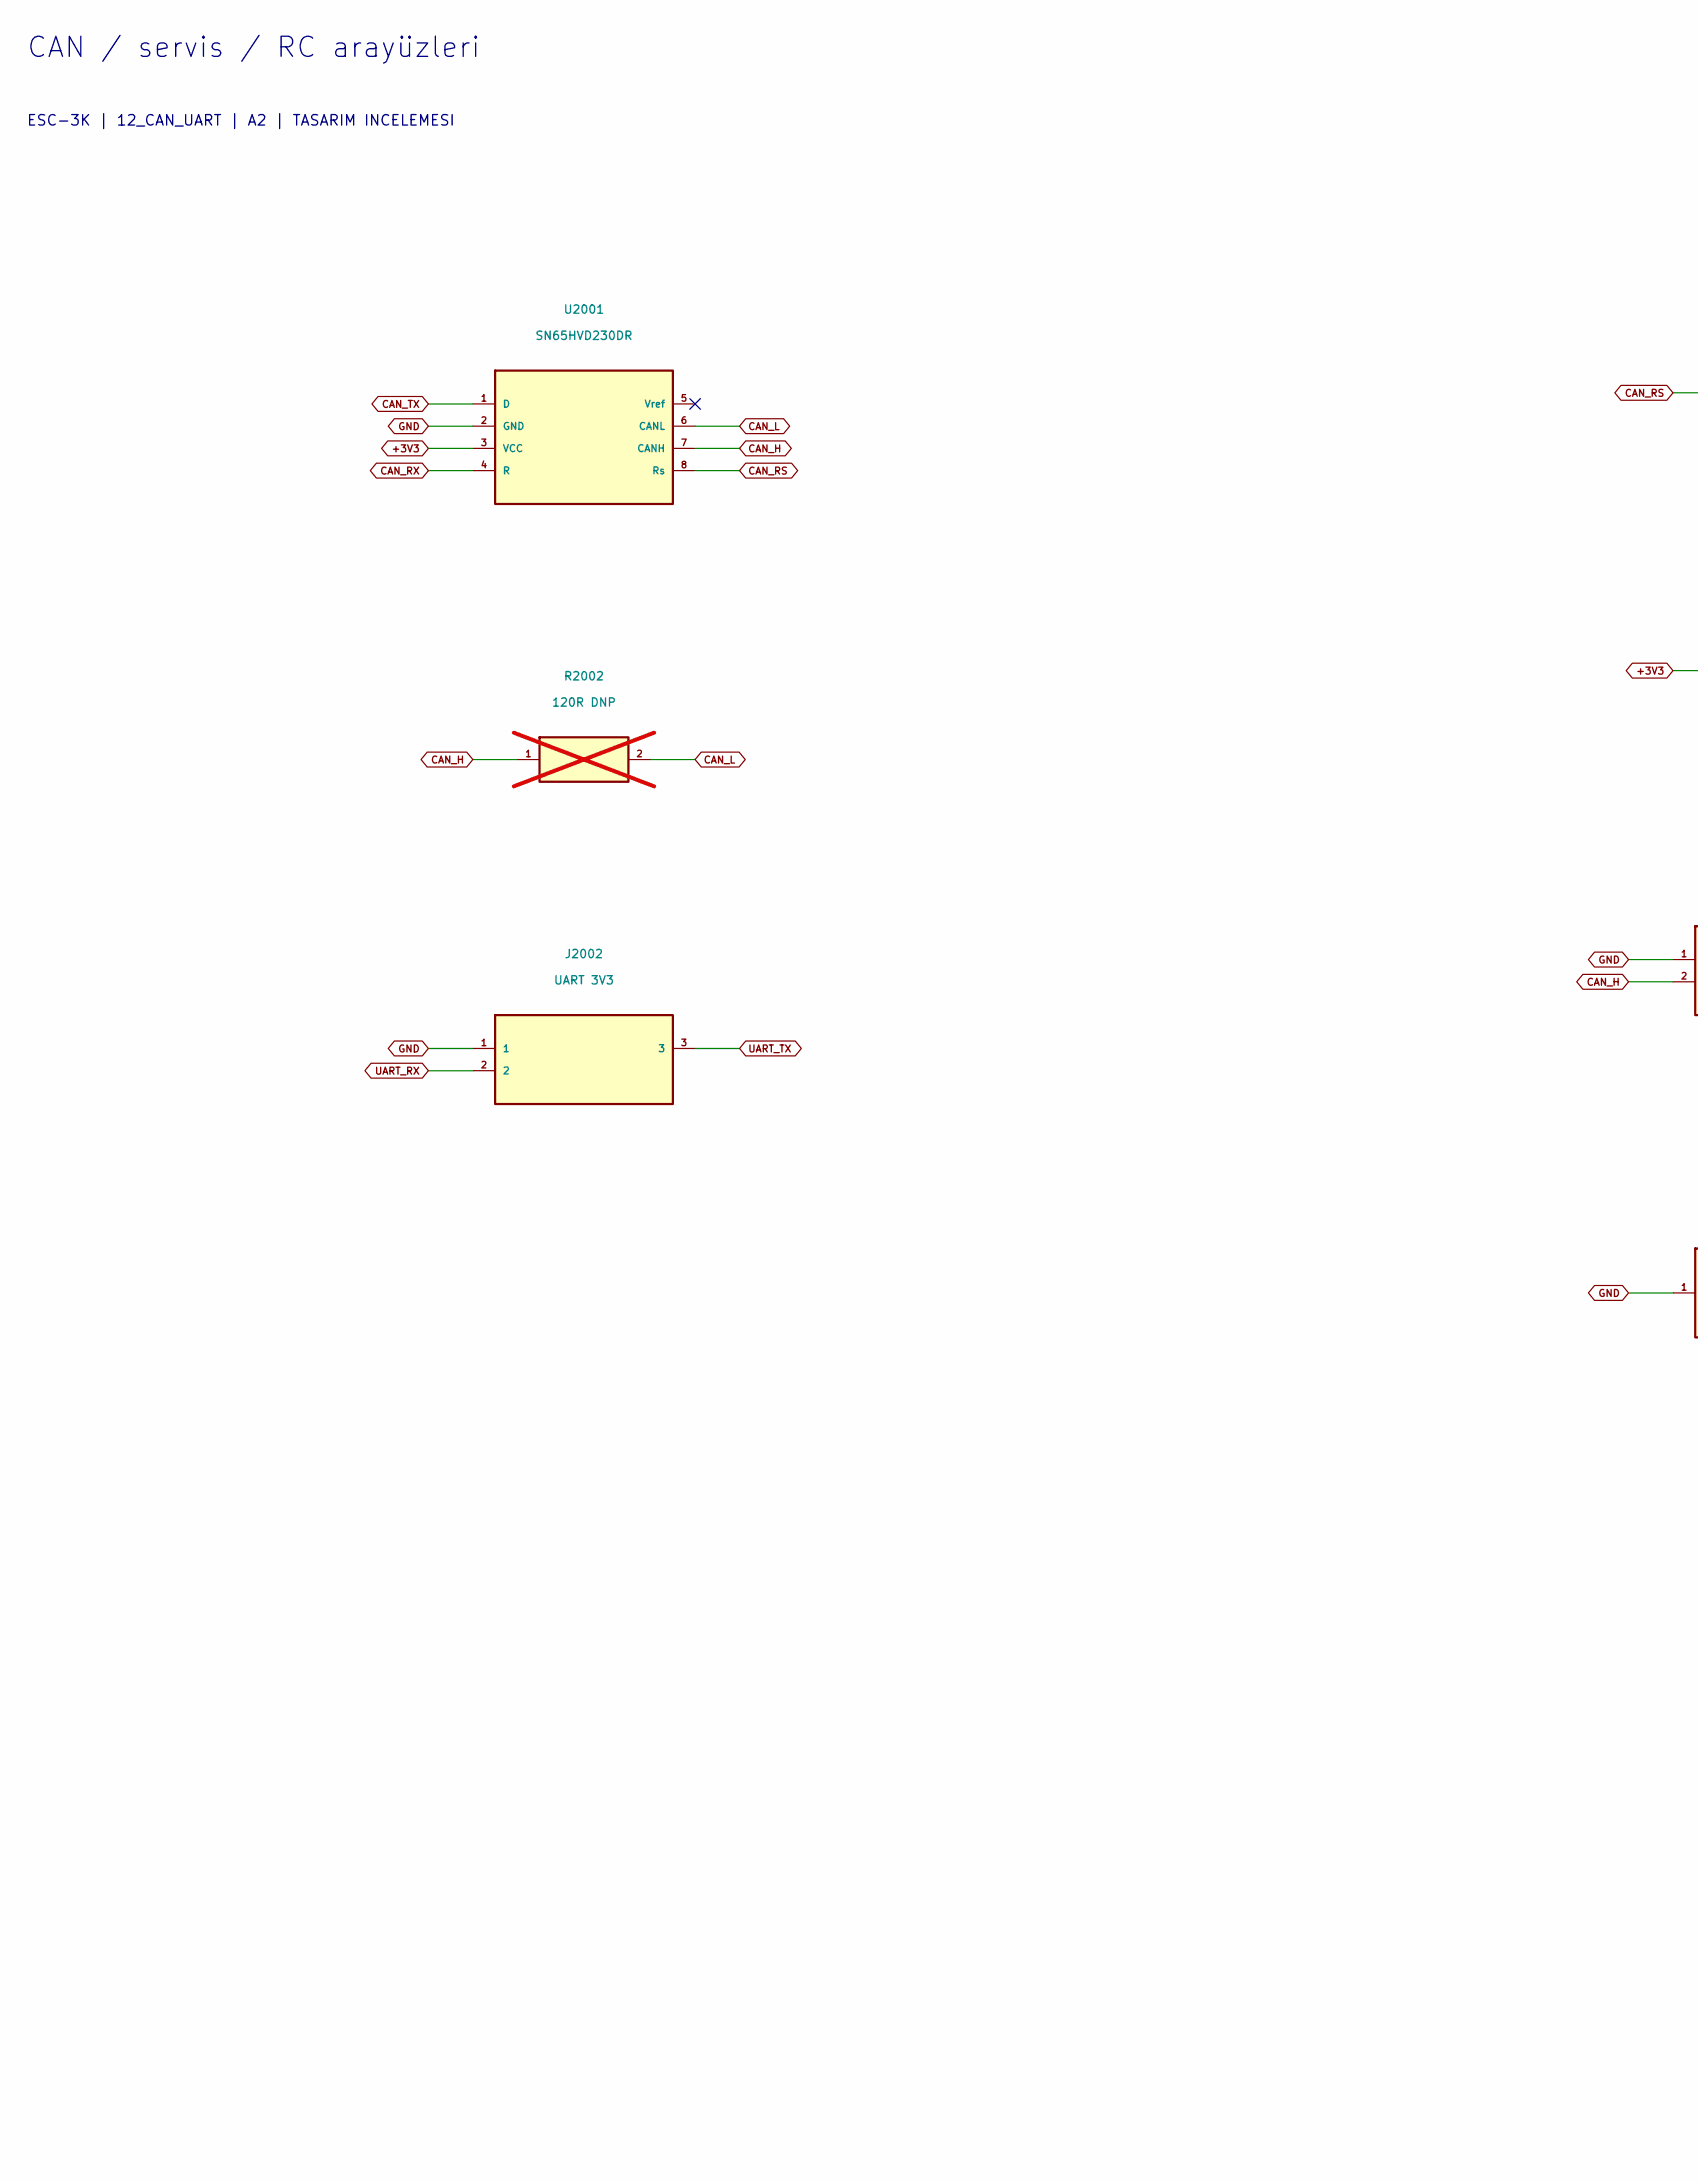
[picture p149: schematic 12_CAN_UART.kicad_sch, part in row 1, column 1]

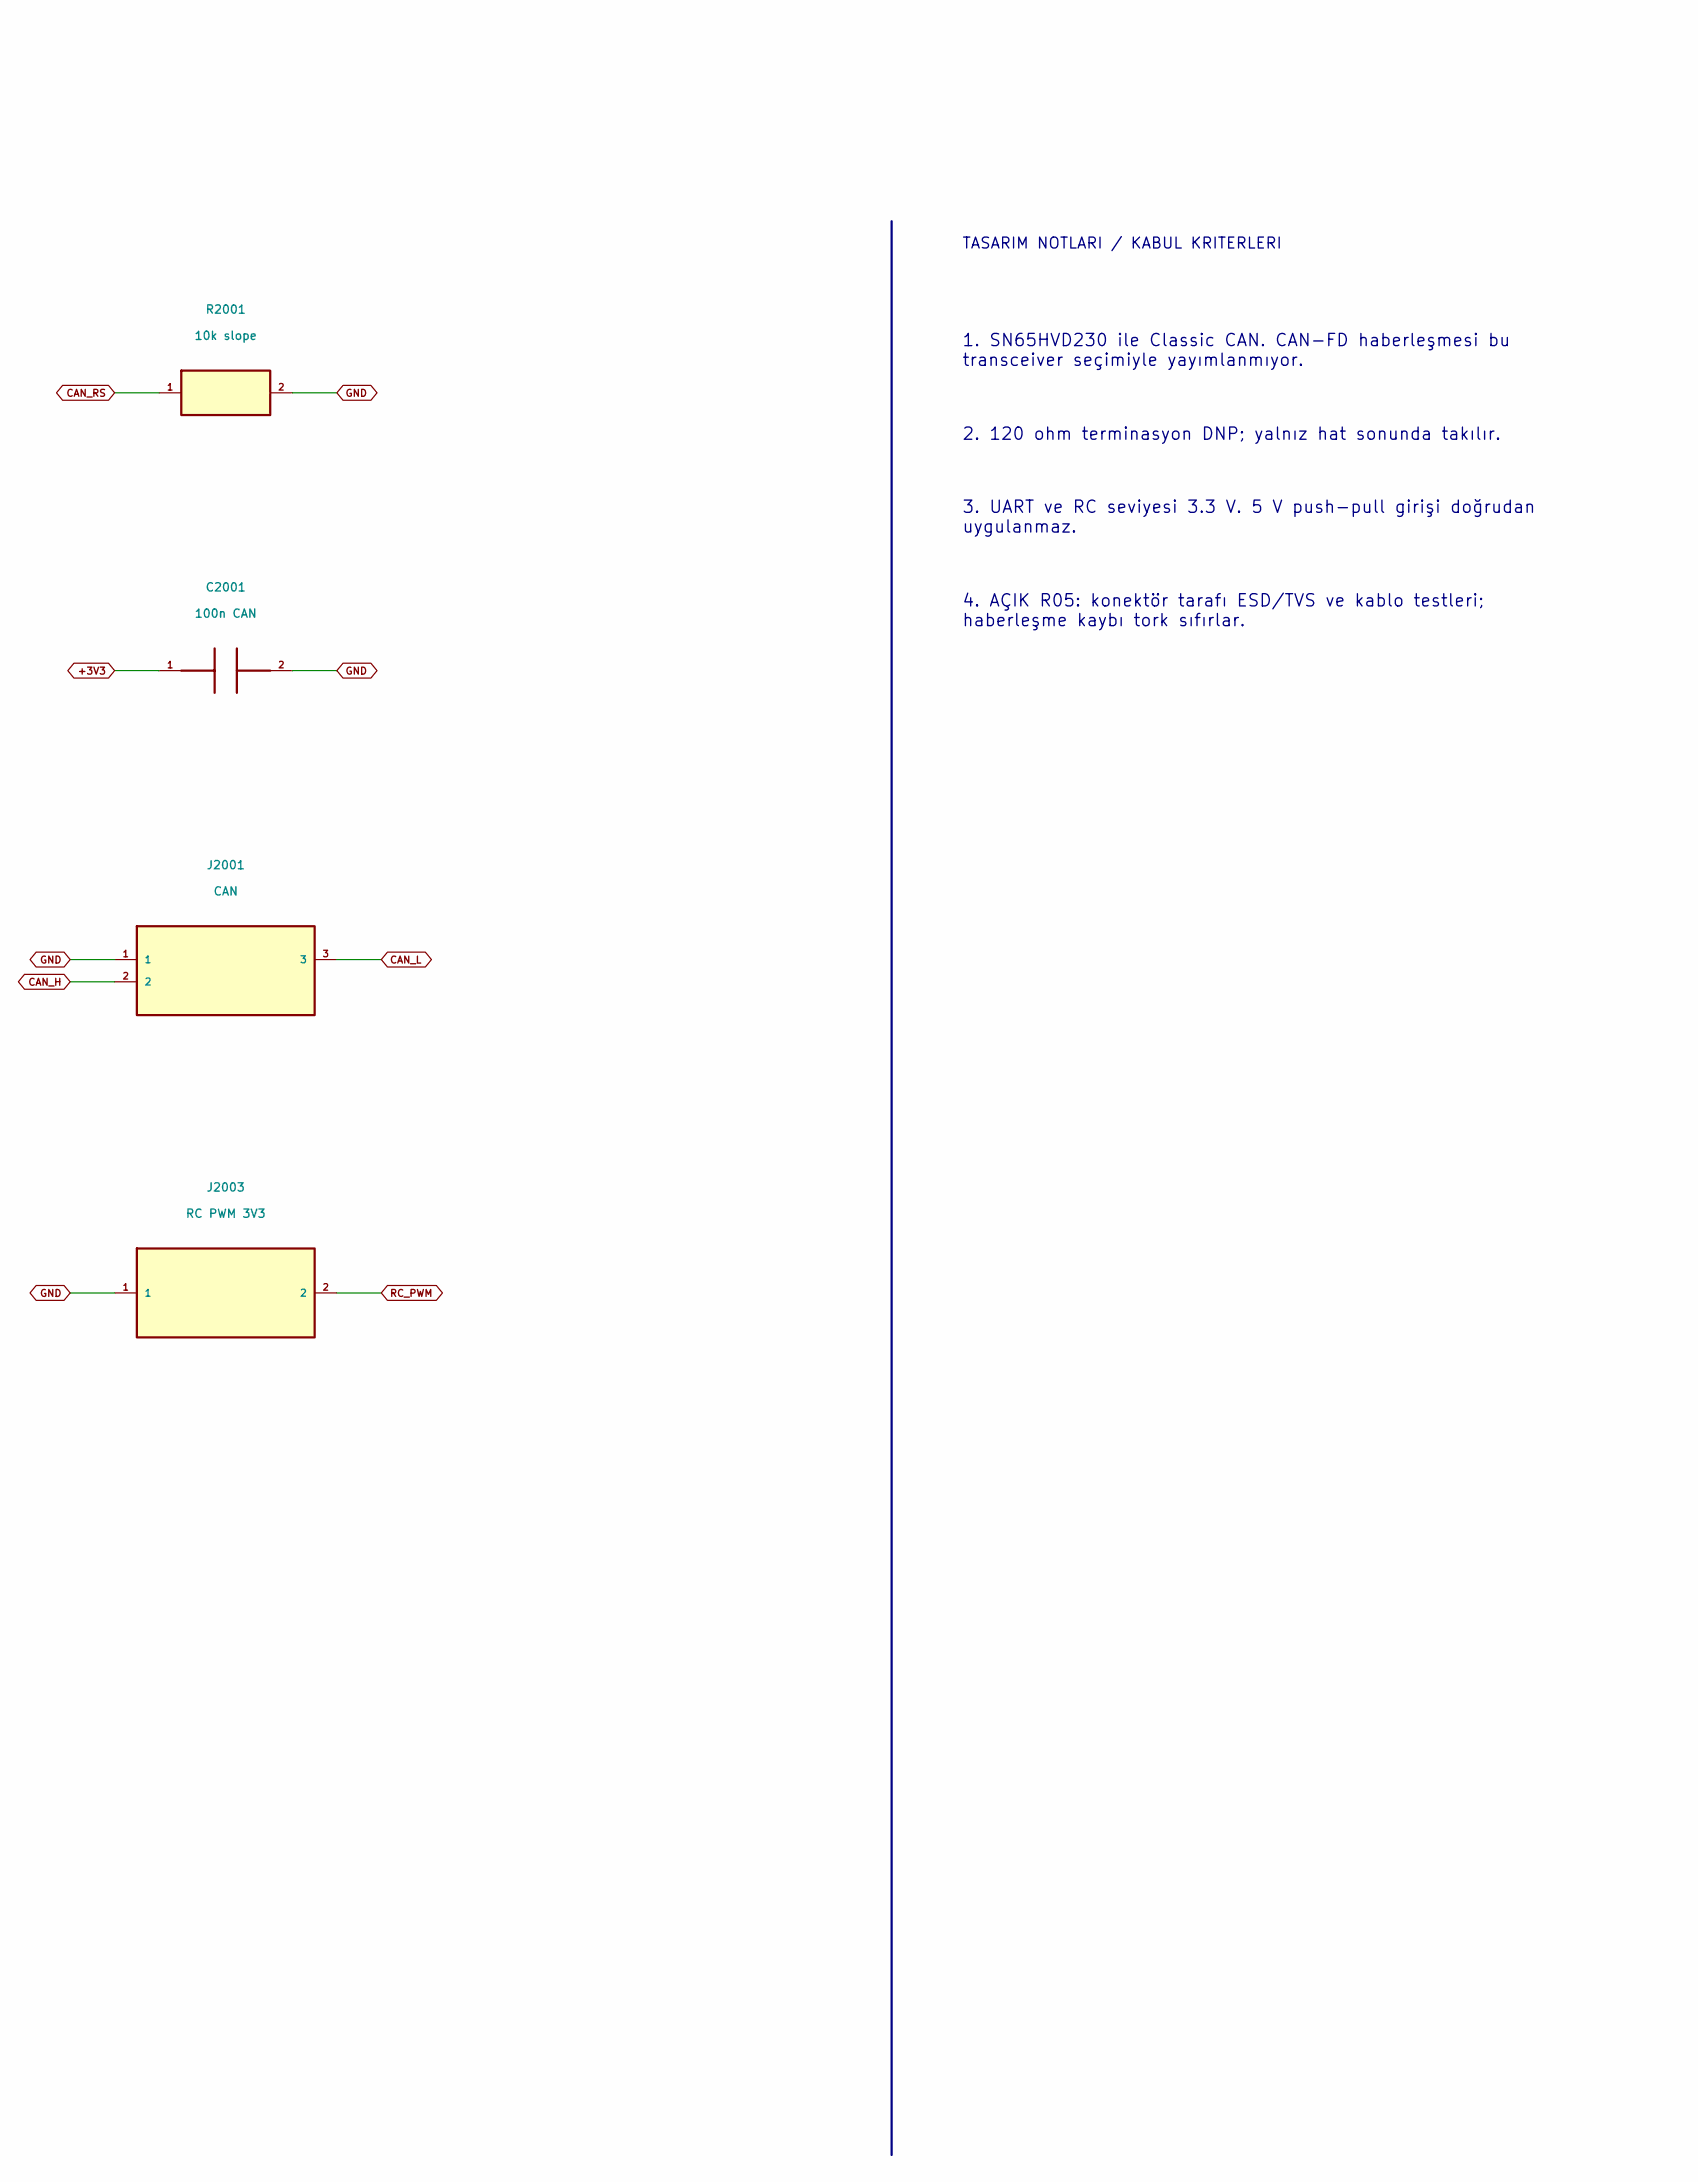
[picture p150: schematic 12_CAN_UART.kicad_sch, part in row 1, column 2]

Parts:
C2001: 100n CAN; C_0805_2012Metric; MPN C2012X7R2A104K125AA
J2001: CAN
J2002: UART 3V3
J2003: RC PWM 3V3
R2001: 10k slope; R_0805_2012Metric; MPN RC0805FR-0710KL
R2002: 120R DNP; R_0805_2012Metric; MPN RC0805FR-07120RL; not fitted
U2001: SN65HVD230DR; SOIC-8_3.9x4.9mm_P1.27mm; MPN SN65HVD230DR

Connections:
+3V3: C2001.1, U2001.3 (VCC)
CAN_H: J2001.2, R2002.1, U2001.7 (CANH)
CAN_L: J2001.3, R2002.2, U2001.6 (CANL)
CAN_RS: R2001.1, U2001.8 (Rs)
CAN_RX: U2001.4 (R)
CAN_TX: U2001.1 (D)
GND: C2001.2, J2001.1, J2002.1, J2003.1, R2001.2, U2001.2 (GND)
RC_PWM: J2003.2
UART_RX: J2002.2
UART_TX: J2002.3

Notes on the sheet:
CAN / servis / RC arayüzleri
ESC-3K | 12_CAN_UART | A2 | TASARIM INCELEMESI
TASARIM NOTLARI / KABUL KRITERLERI
1. SN65HVD230 ile Classic CAN. CAN-FD haberleşmesi bu transceiver seçimiyle yayımlanmıyor.
2. 120 ohm terminasyon DNP; yalnız hat sonunda takılır.
3. UART ve RC seviyesi 3.3 V. 5 V push-pull girişi doğrudan uygulanmaz.
4. AÇIK R05: konektör tarafı ESD/TVS ve kablo testleri; haberleşme kaybı tork sıfırlar.
