mekiciepcas/ESC-Ai/ESC_V2/hardware_a2/13_HALL.kicad_sch

## KiCad design ESC_V2/hardware_a2/13_HALL.kicad_sch (2026-09-18)

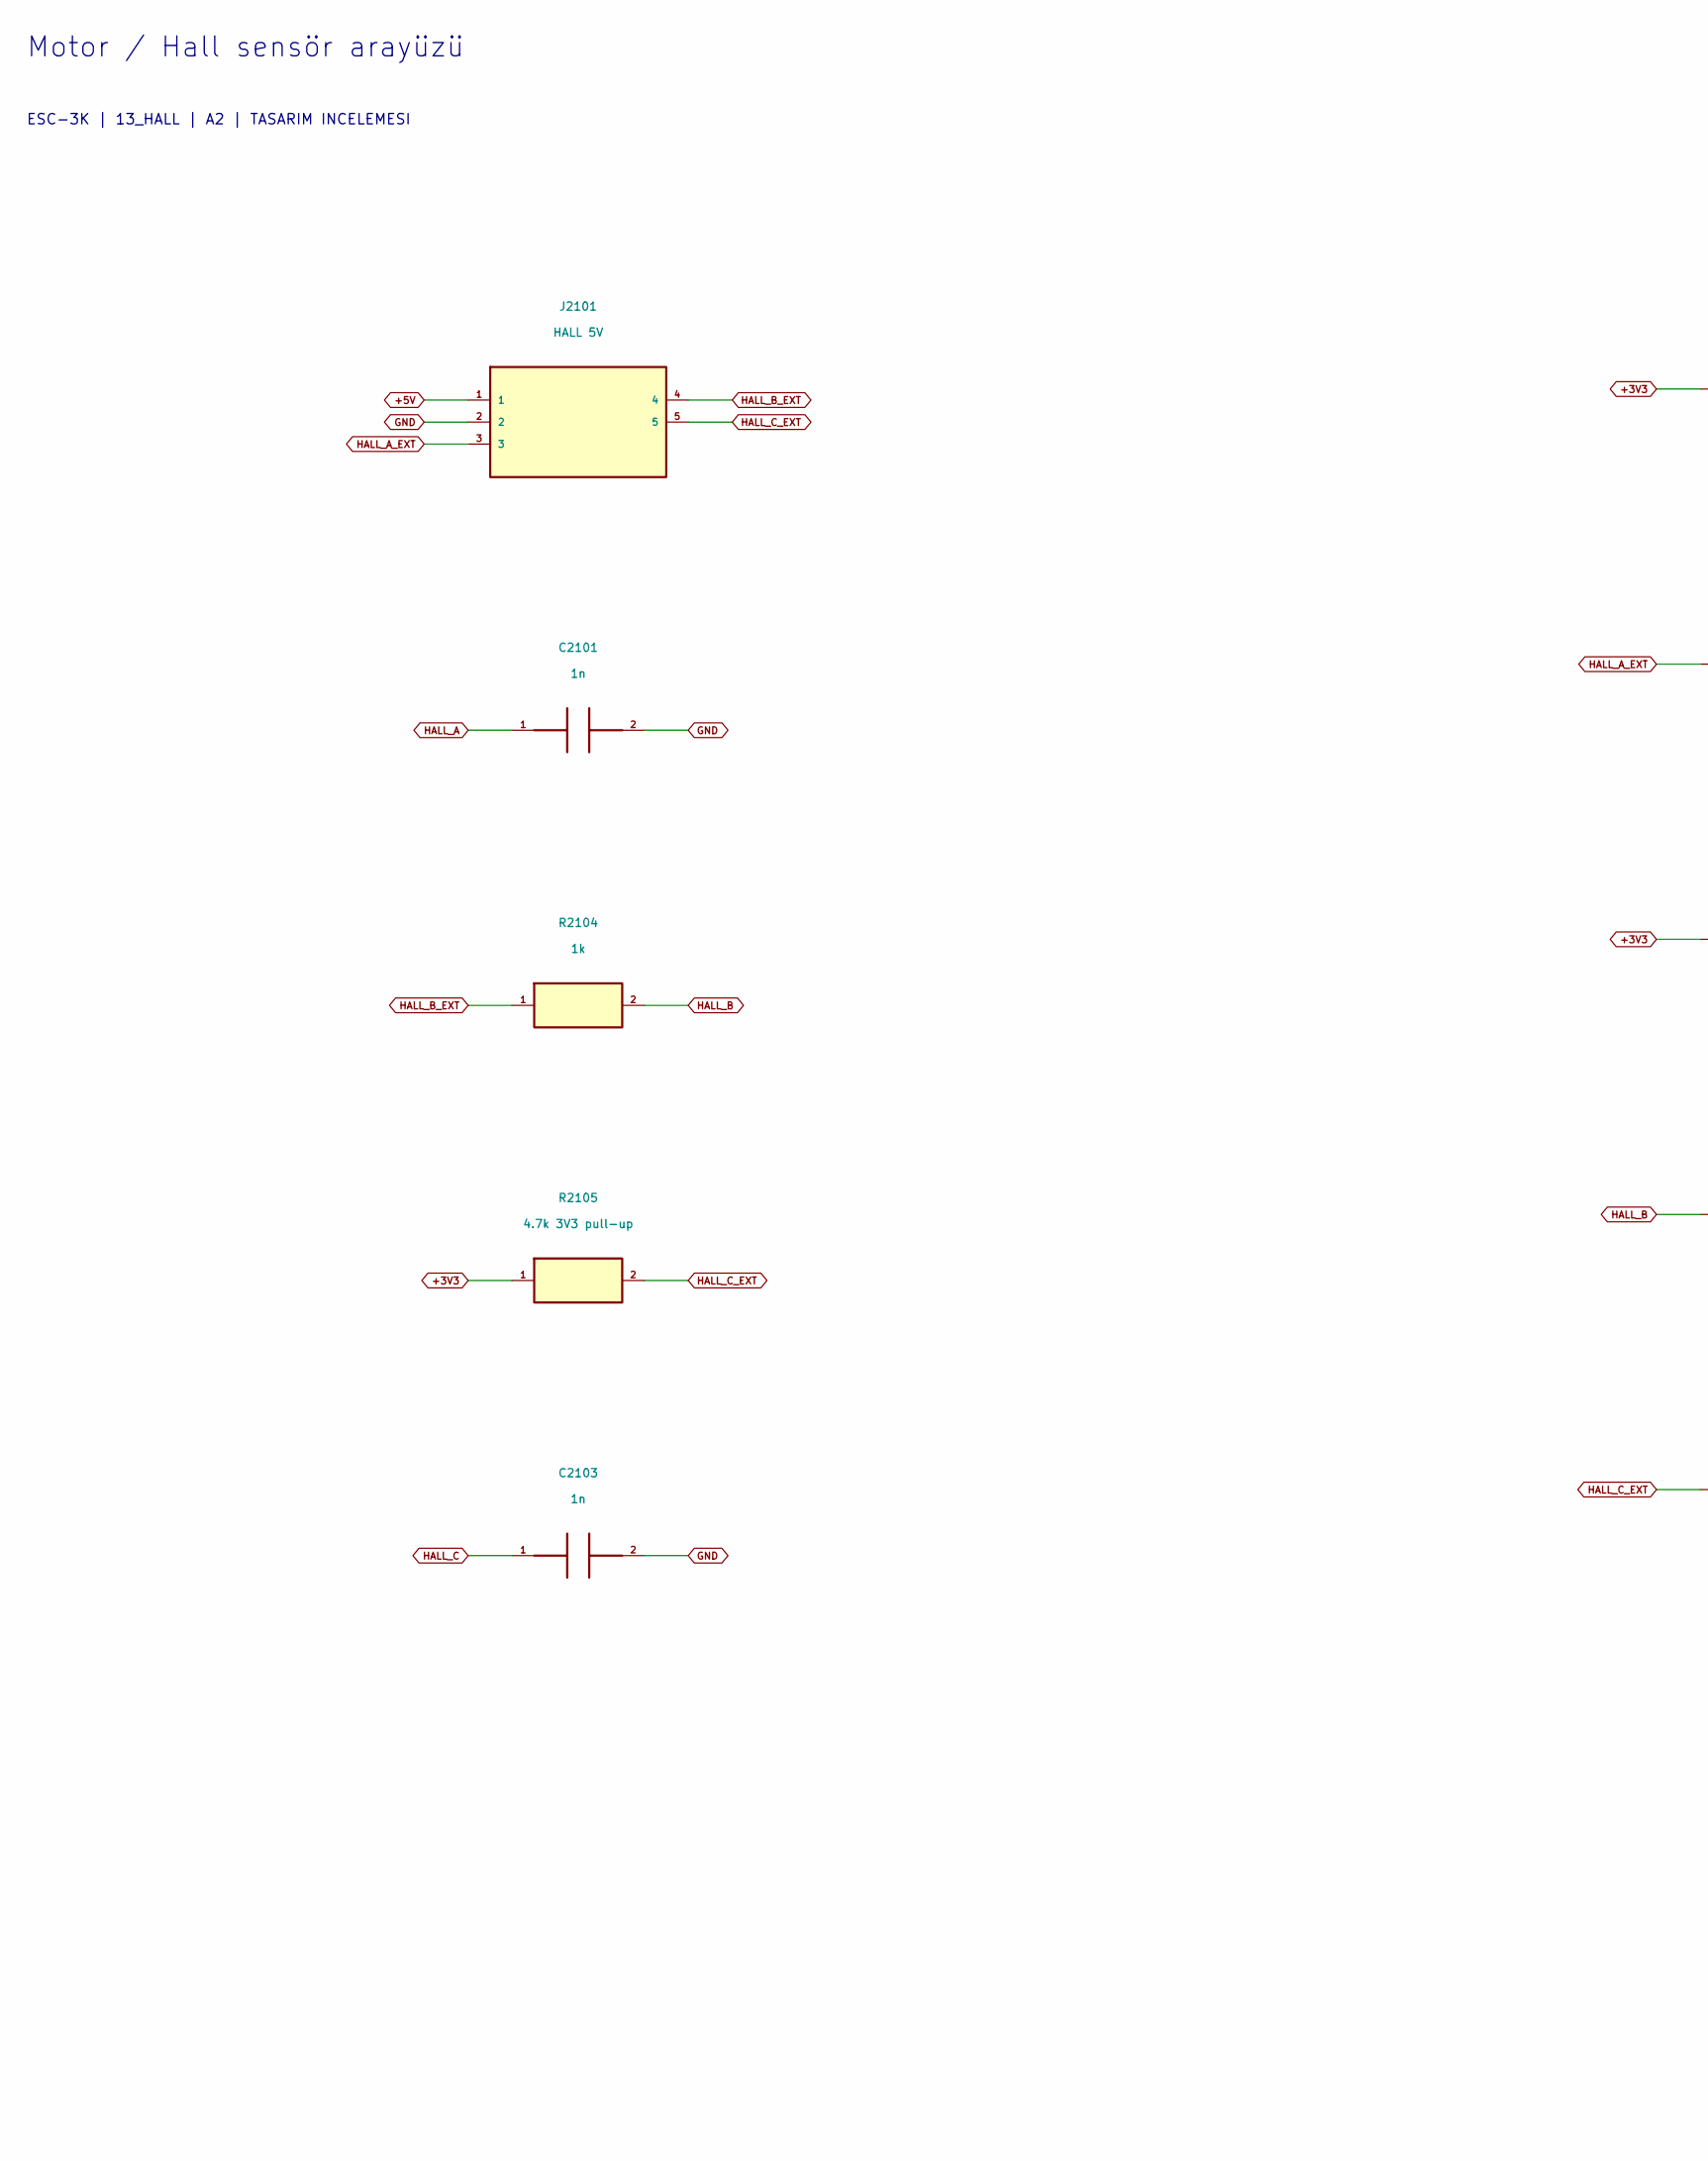
[picture p151: schematic 13_HALL.kicad_sch, part in row 1, column 1]

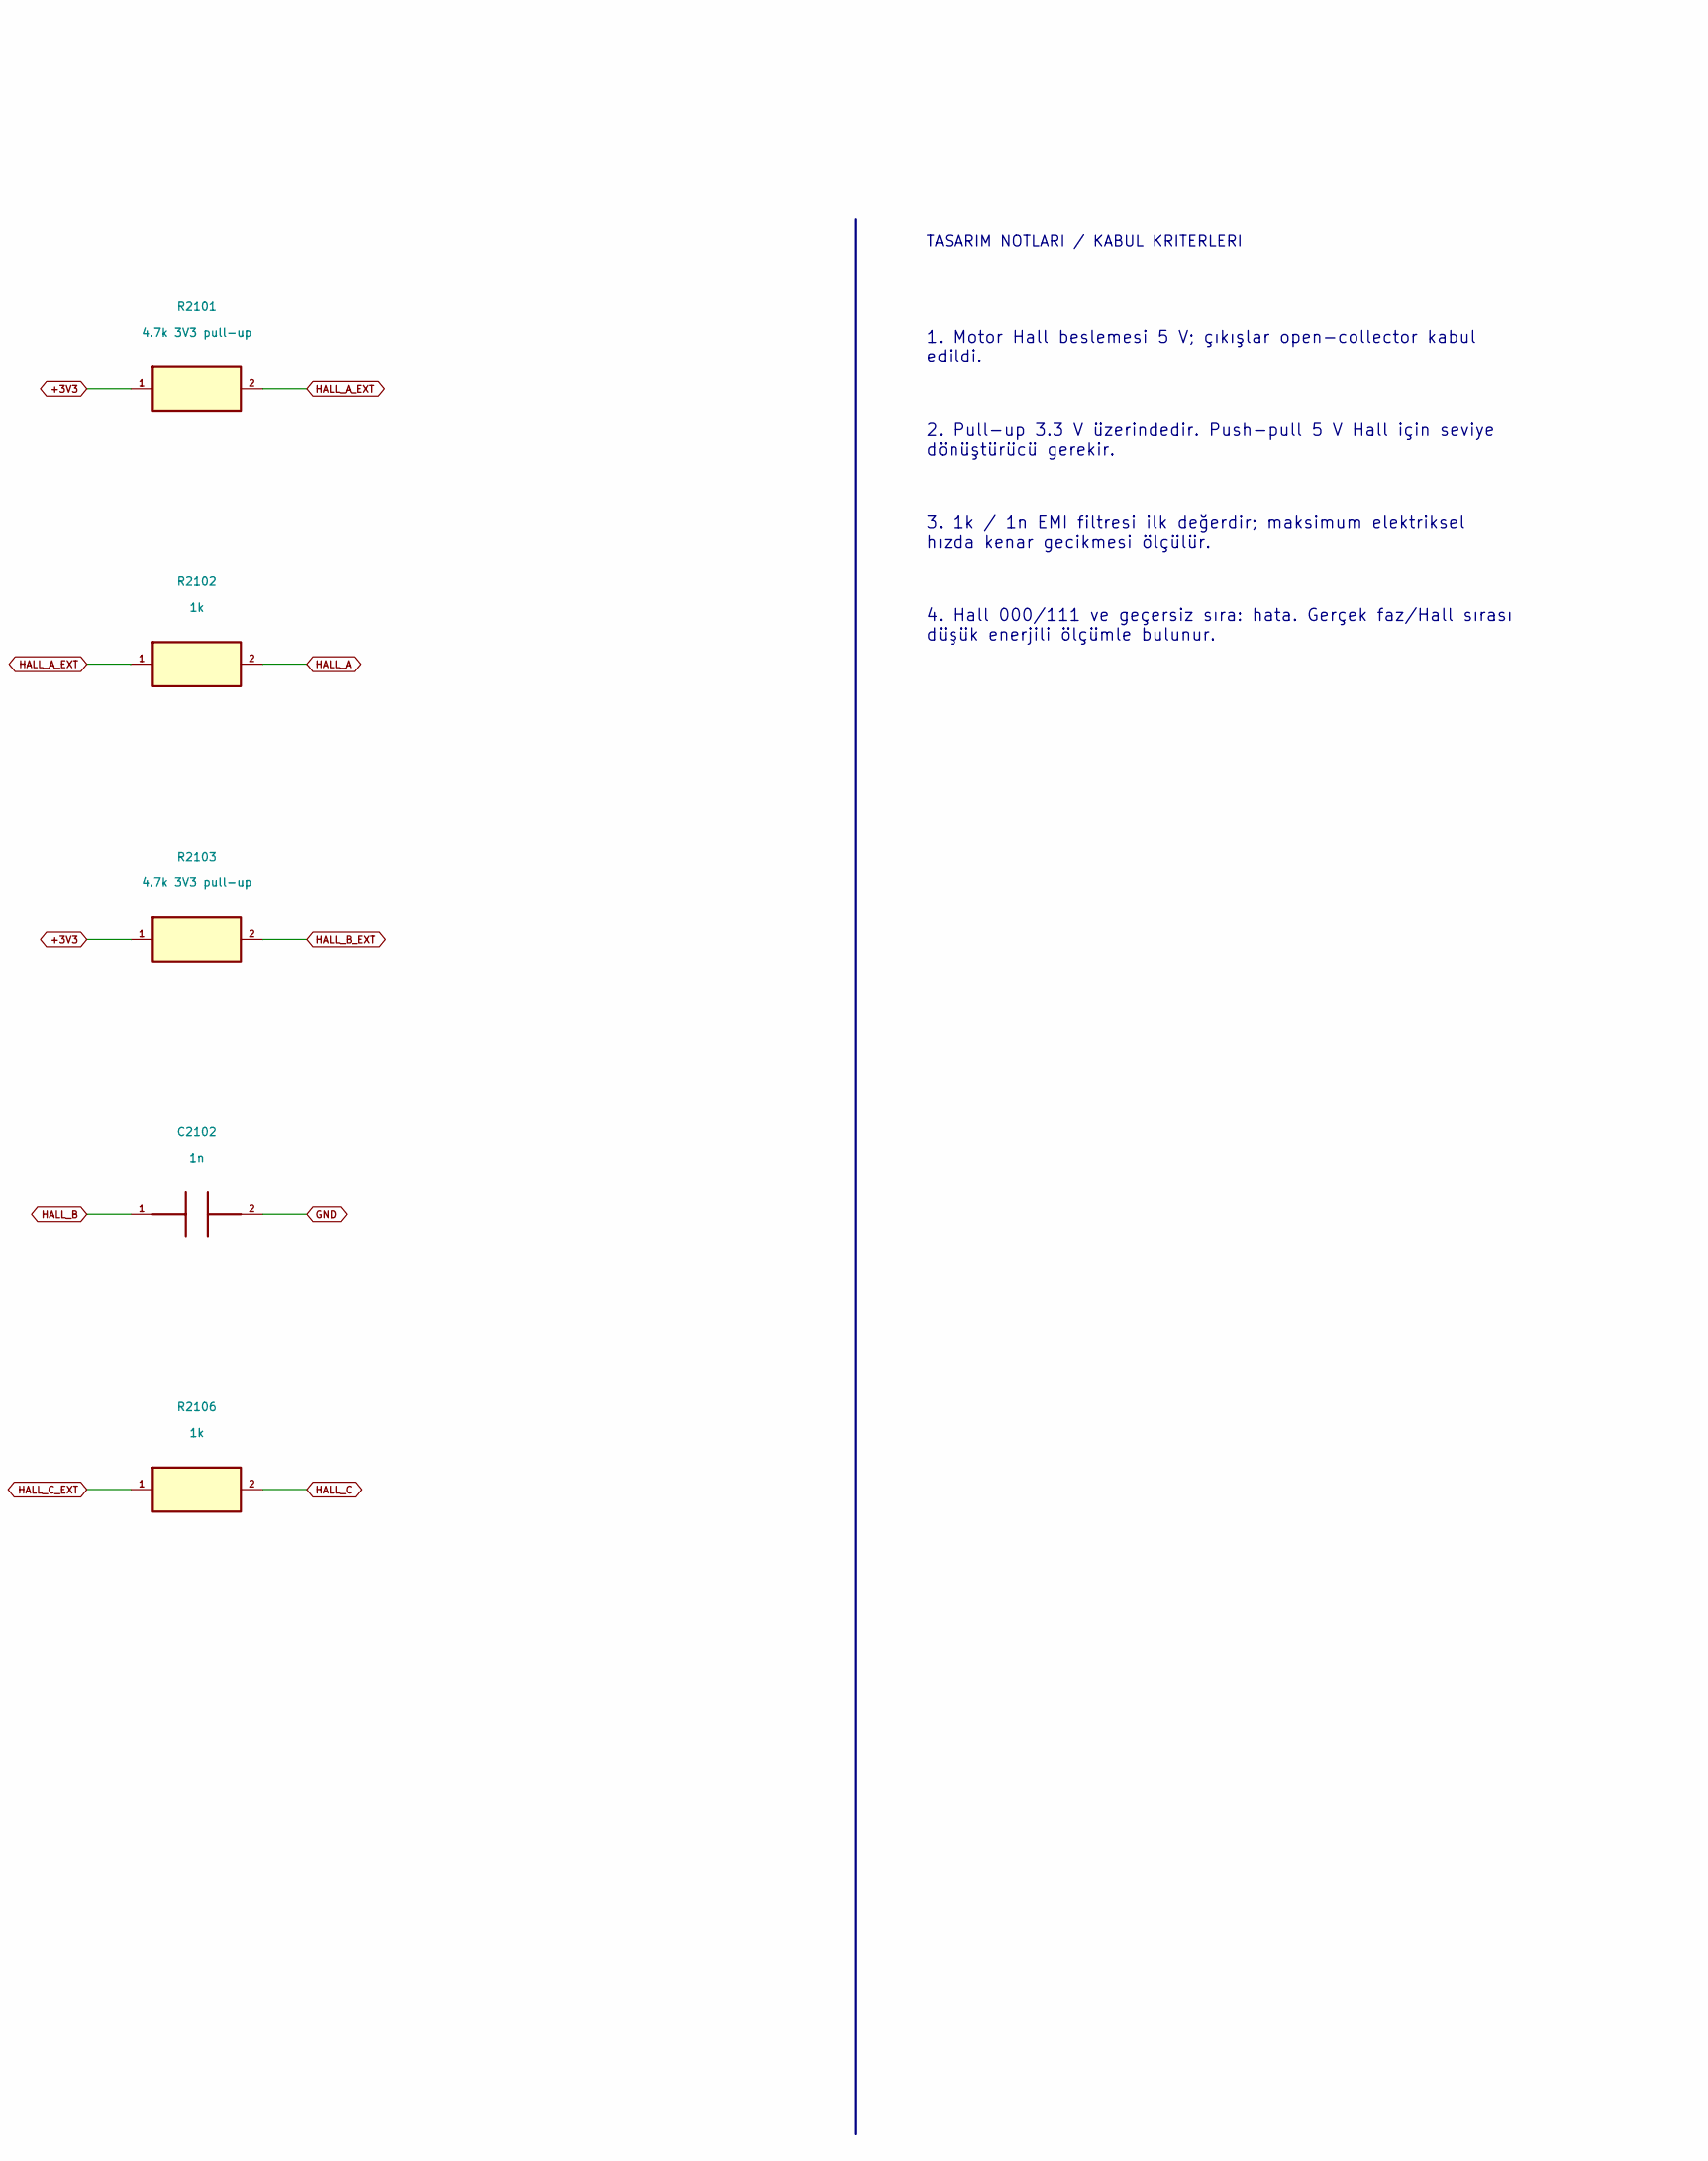
[picture p152: schematic 13_HALL.kicad_sch, part in row 1, column 2]

Parts:
C2101, C2102, C2103: 1n; C_0805_2012Metric
J2101: HALL 5V
R2101, R2103, R2105: 4.7k 3V3 pull-up; R_0805_2012Metric; MPN RC0805FR-074K7L
R2102, R2104, R2106: 1k; R_0805_2012Metric; MPN RC0805FR-071KL

Connections:
+3V3: R2101.1, R2103.1, R2105.1
+5V: J2101.1
GND: C2101.2, C2102.2, C2103.2, J2101.2
HALL_A: C2101.1, R2102.2
HALL_A_EXT: J2101.3, R2101.2, R2102.1
HALL_B: C2102.1, R2104.2
HALL_B_EXT: J2101.4, R2103.2, R2104.1
HALL_C: C2103.1, R2106.2
HALL_C_EXT: J2101.5, R2105.2, R2106.1

Notes on the sheet:
Motor / Hall sensör arayüzü
ESC-3K | 13_HALL | A2 | TASARIM INCELEMESI
TASARIM NOTLARI / KABUL KRITERLERI
1. Motor Hall beslemesi 5 V; çıkışlar open-collector kabul edildi.
2. Pull-up 3.3 V üzerindedir. Push-pull 5 V Hall için seviye dönüştürücü gerekir.
3. 1k / 1n EMI filtresi ilk değerdir; maksimum elektriksel hızda kenar gecikmesi ölçülür.
4. Hall 000/111 ve geçersiz sıra: hata. Gerçek faz/Hall sırası düşük enerjili ölçümle bulunur.
