mekiciepcas/ESC-Ai/ESC_V2/hardware_a2/14_TRIP_COMPARATORS.kicad_sch

## KiCad design ESC_V2/hardware_a2/14_TRIP_COMPARATORS.kicad_sch (2026-09-18)

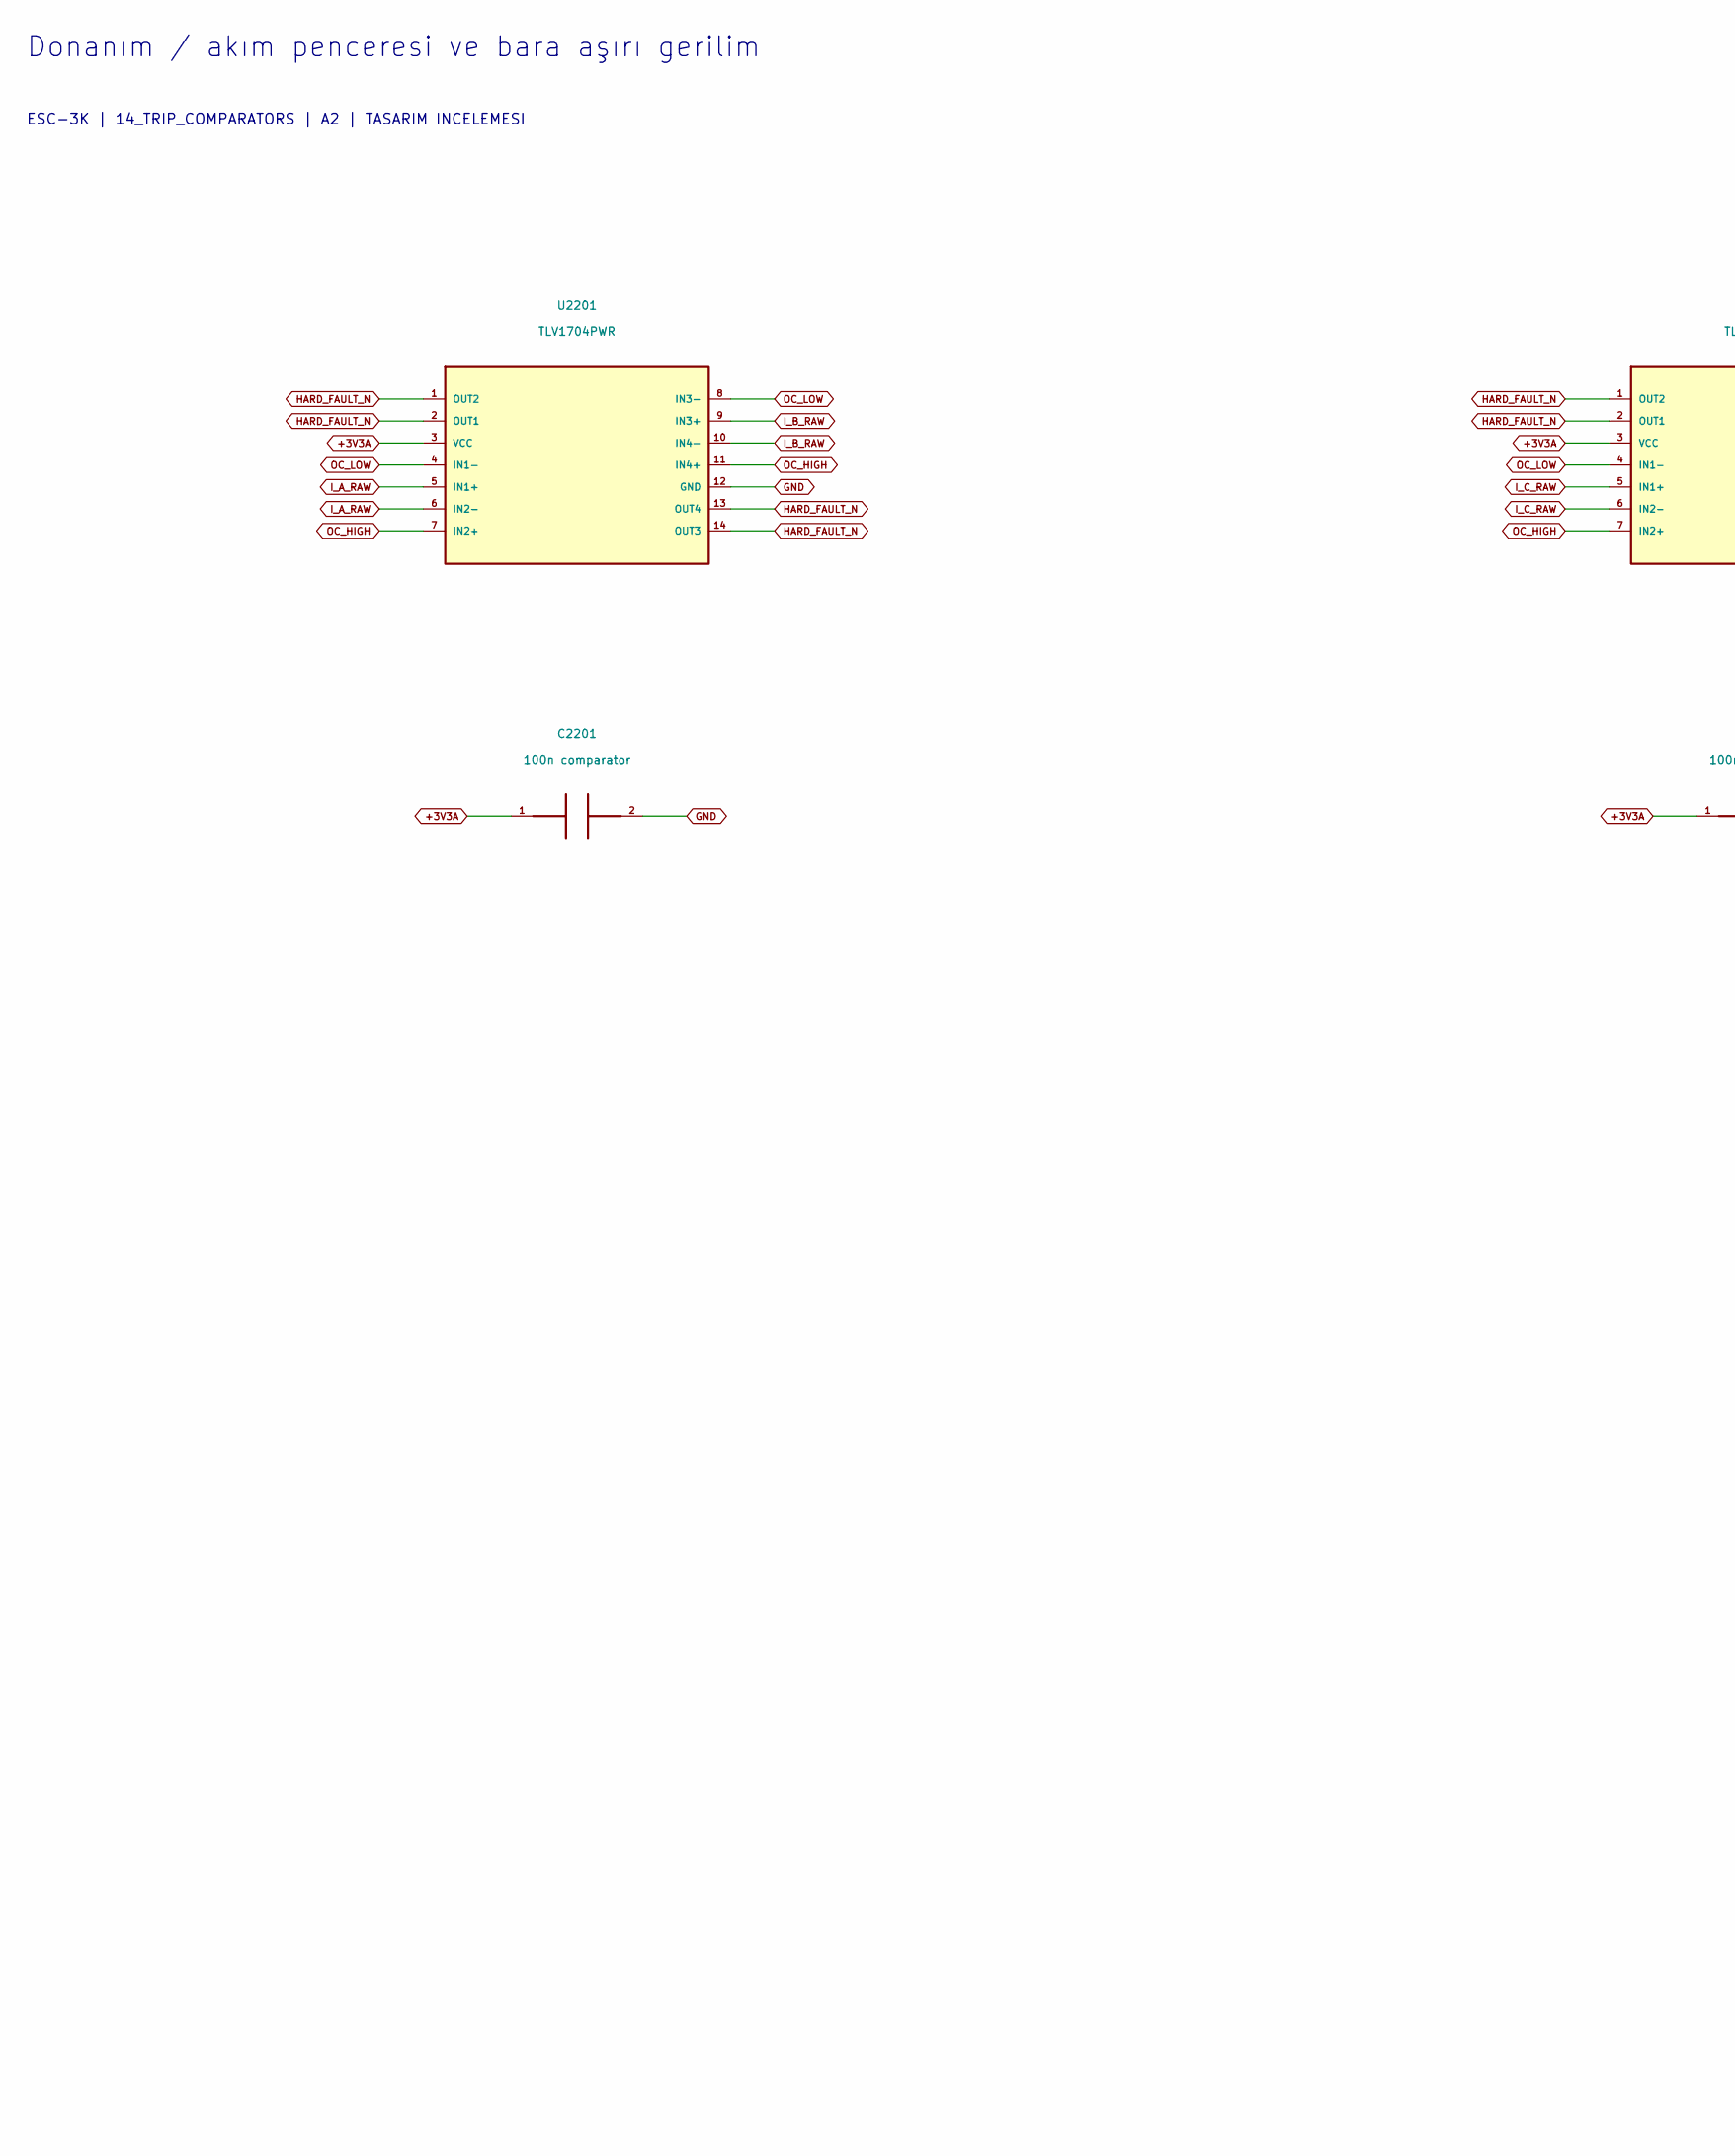
[picture p153: schematic 14_TRIP_COMPARATORS.kicad_sch, part in row 1, column 1]

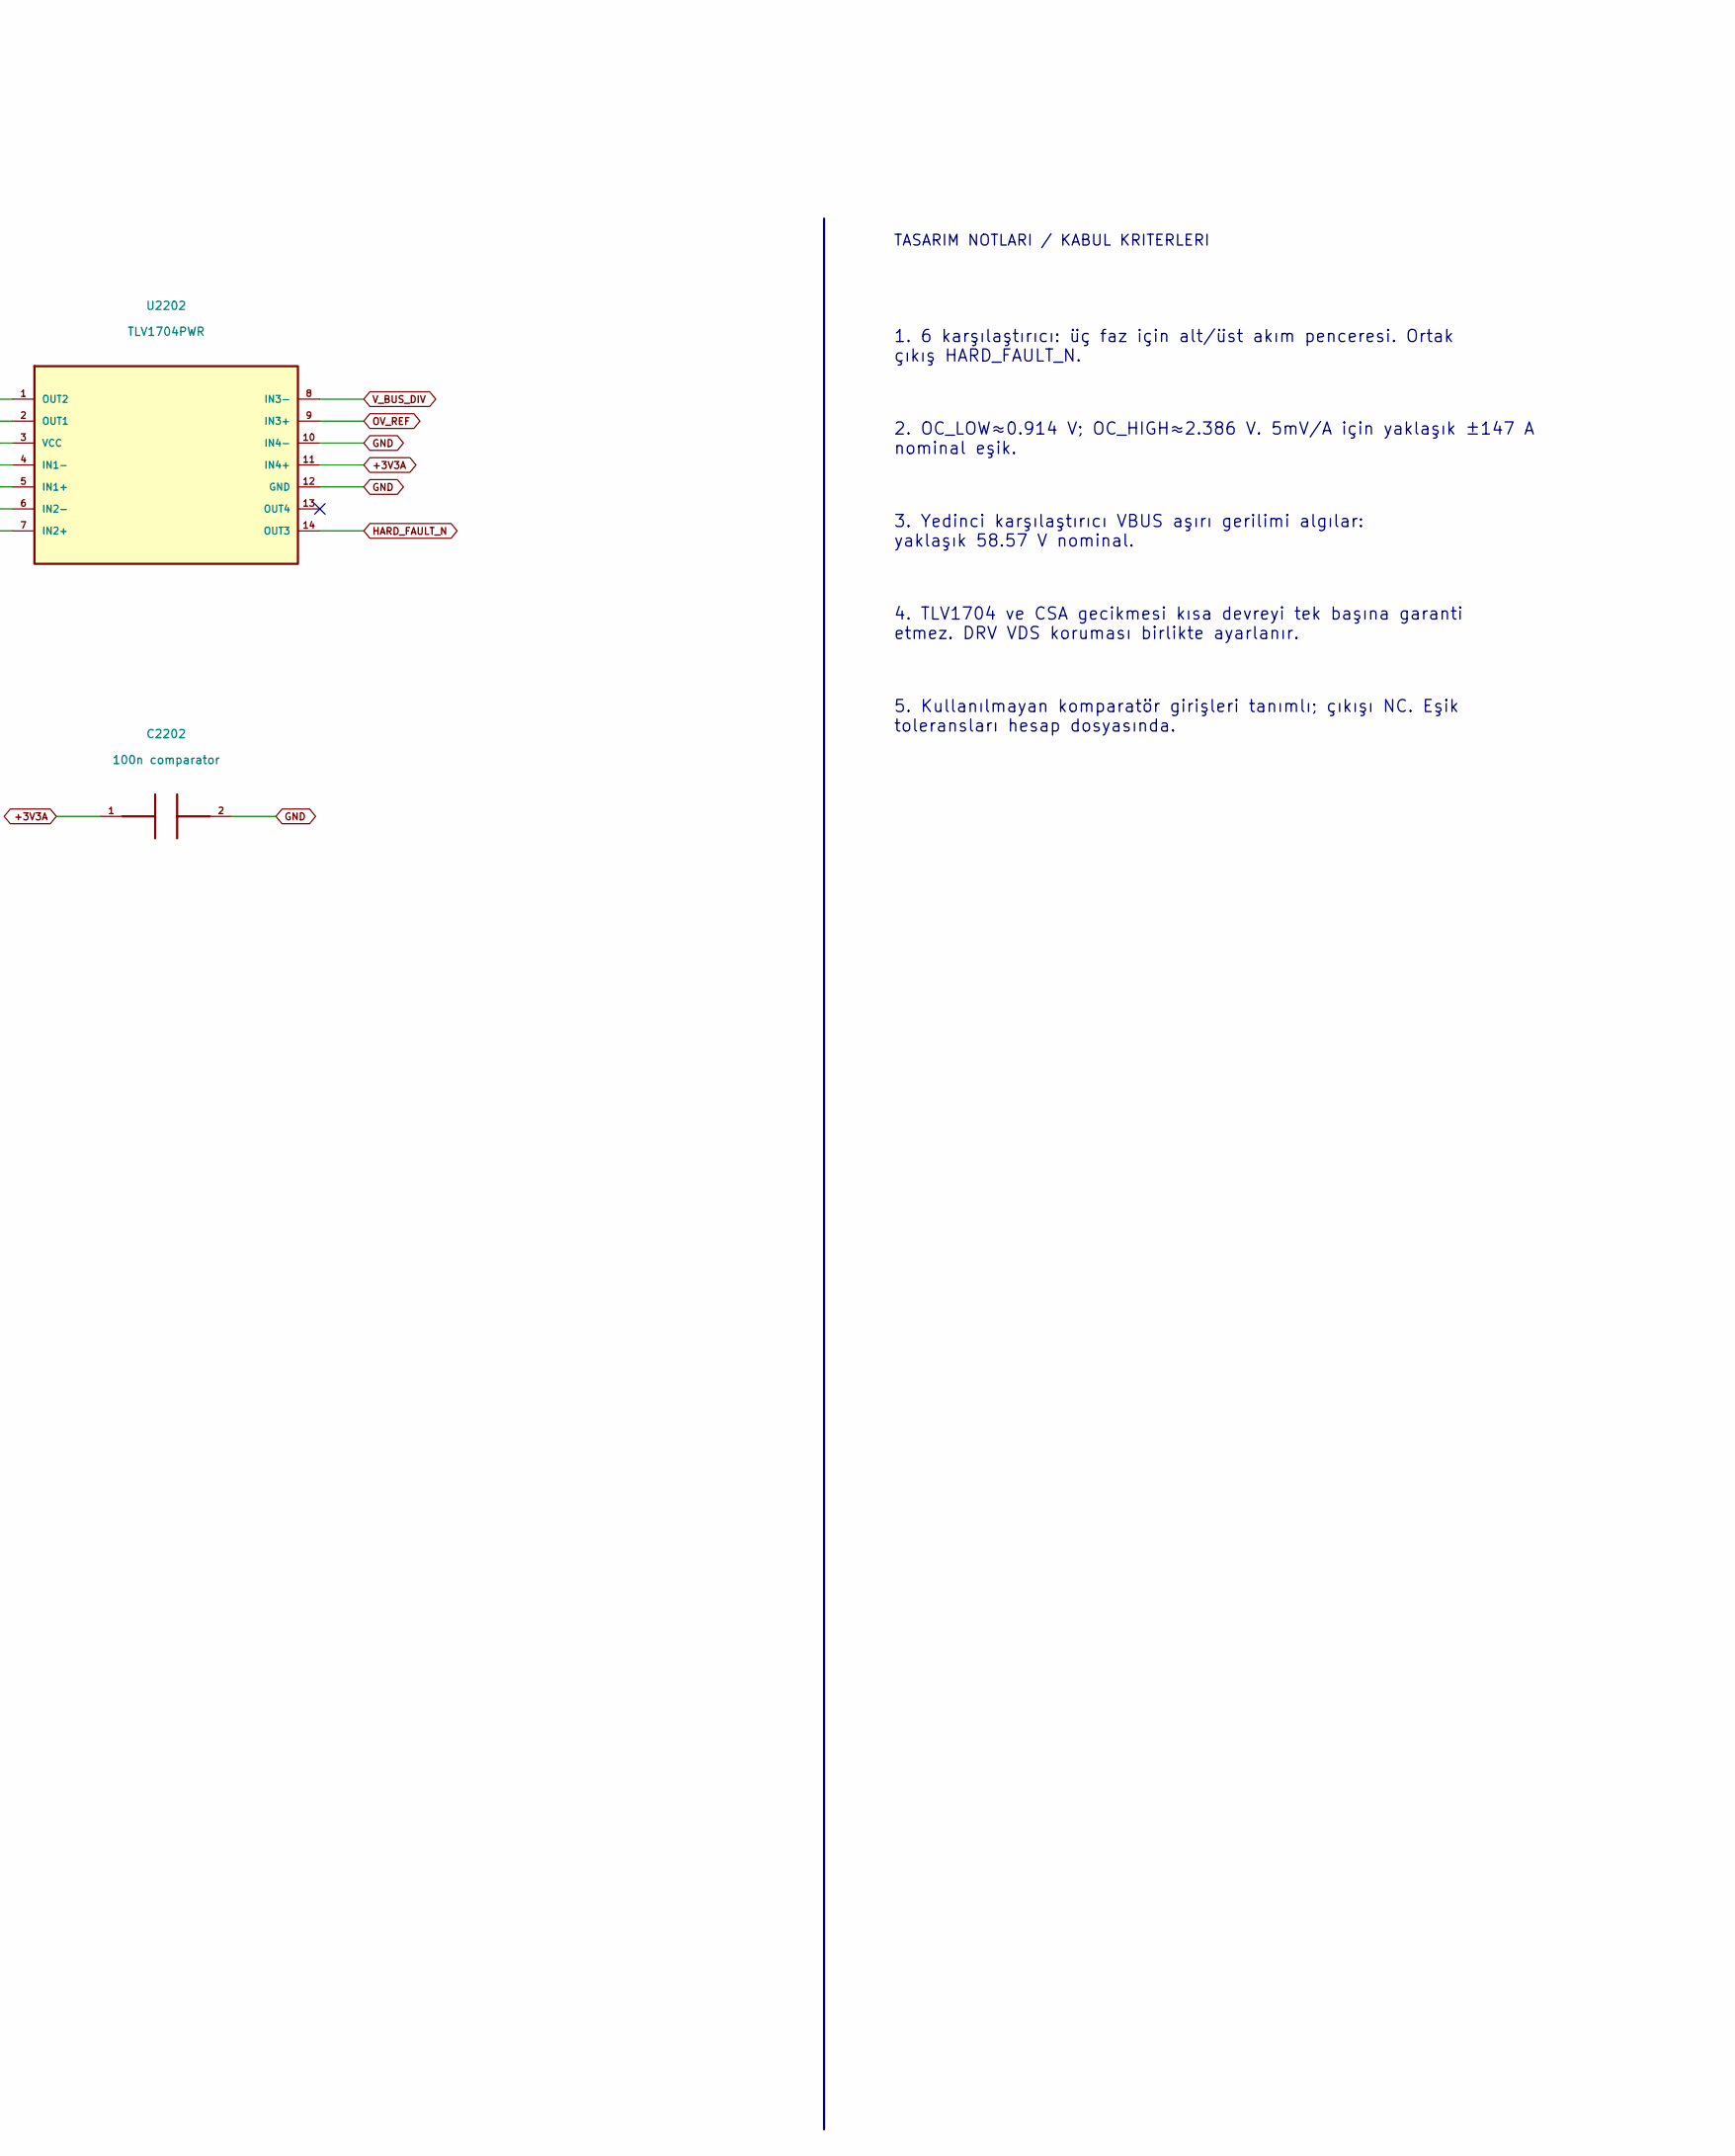
[picture p154: schematic 14_TRIP_COMPARATORS.kicad_sch, part in row 1, column 2]

Parts:
C2201, C2202: 100n comparator; C_0805_2012Metric; MPN C2012X7R2A104K125AA
U2201, U2202: TLV1704PWR; TSSOP-14_4.4x5mm_P0.65mm; MPN TLV1704PWR

Connections:
+3V3A: C2201.1, C2202.1, U2201.3 (VCC), U2202.3 (VCC), U2202.11 (IN4+)
GND: C2201.2, C2202.2, U2201.12 (GND), U2202.10 (IN4-), U2202.12 (GND)
HARD_FAULT_N: U2201.1 (OUT2), U2201.2 (OUT1), U2201.13 (OUT4), U2201.14 (OUT3), U2202.1 (OUT2), U2202.2 (OUT1), U2202.14 (OUT3)
I_A_RAW: U2201.5 (IN1+), U2201.6 (IN2-)
I_B_RAW: U2201.9 (IN3+), U2201.10 (IN4-)
I_C_RAW: U2202.5 (IN1+), U2202.6 (IN2-)
OC_HIGH: U2201.7 (IN2+), U2201.11 (IN4+), U2202.7 (IN2+)
OC_LOW: U2201.4 (IN1-), U2201.8 (IN3-), U2202.4 (IN1-)
OV_REF: U2202.9 (IN3+)
V_BUS_DIV: U2202.8 (IN3-)

Notes on the sheet:
Donanım / akım penceresi ve bara aşırı gerilim
ESC-3K | 14_TRIP_COMPARATORS | A2 | TASARIM INCELEMESI
TASARIM NOTLARI / KABUL KRITERLERI
1. 6 karşılaştırıcı: üç faz için alt/üst akım penceresi. Ortak çıkış HARD_FAULT_N.
2. OC_LOW≈0.914 V; OC_HIGH≈2.386 V. 5mV/A için yaklaşık ±147 A nominal eşik.
3. Yedinci karşılaştırıcı VBUS aşırı gerilimi algılar: yaklaşık 58.57 V nominal.
4. TLV1704 ve CSA gecikmesi kısa devreyi tek başına garanti etmez. DRV VDS koruması birlikte ayarlanır.
5. Kullanılmayan komparatör girişleri tanımlı; çıkışı NC. Eşik toleransları hesap dosyasında.
