mekiciepcas/ESC-Ai/ESC_V2/hardware_a2/15_TRIP_REFERENCES.kicad_sch

## KiCad design ESC_V2/hardware_a2/15_TRIP_REFERENCES.kicad_sch (2026-09-18)

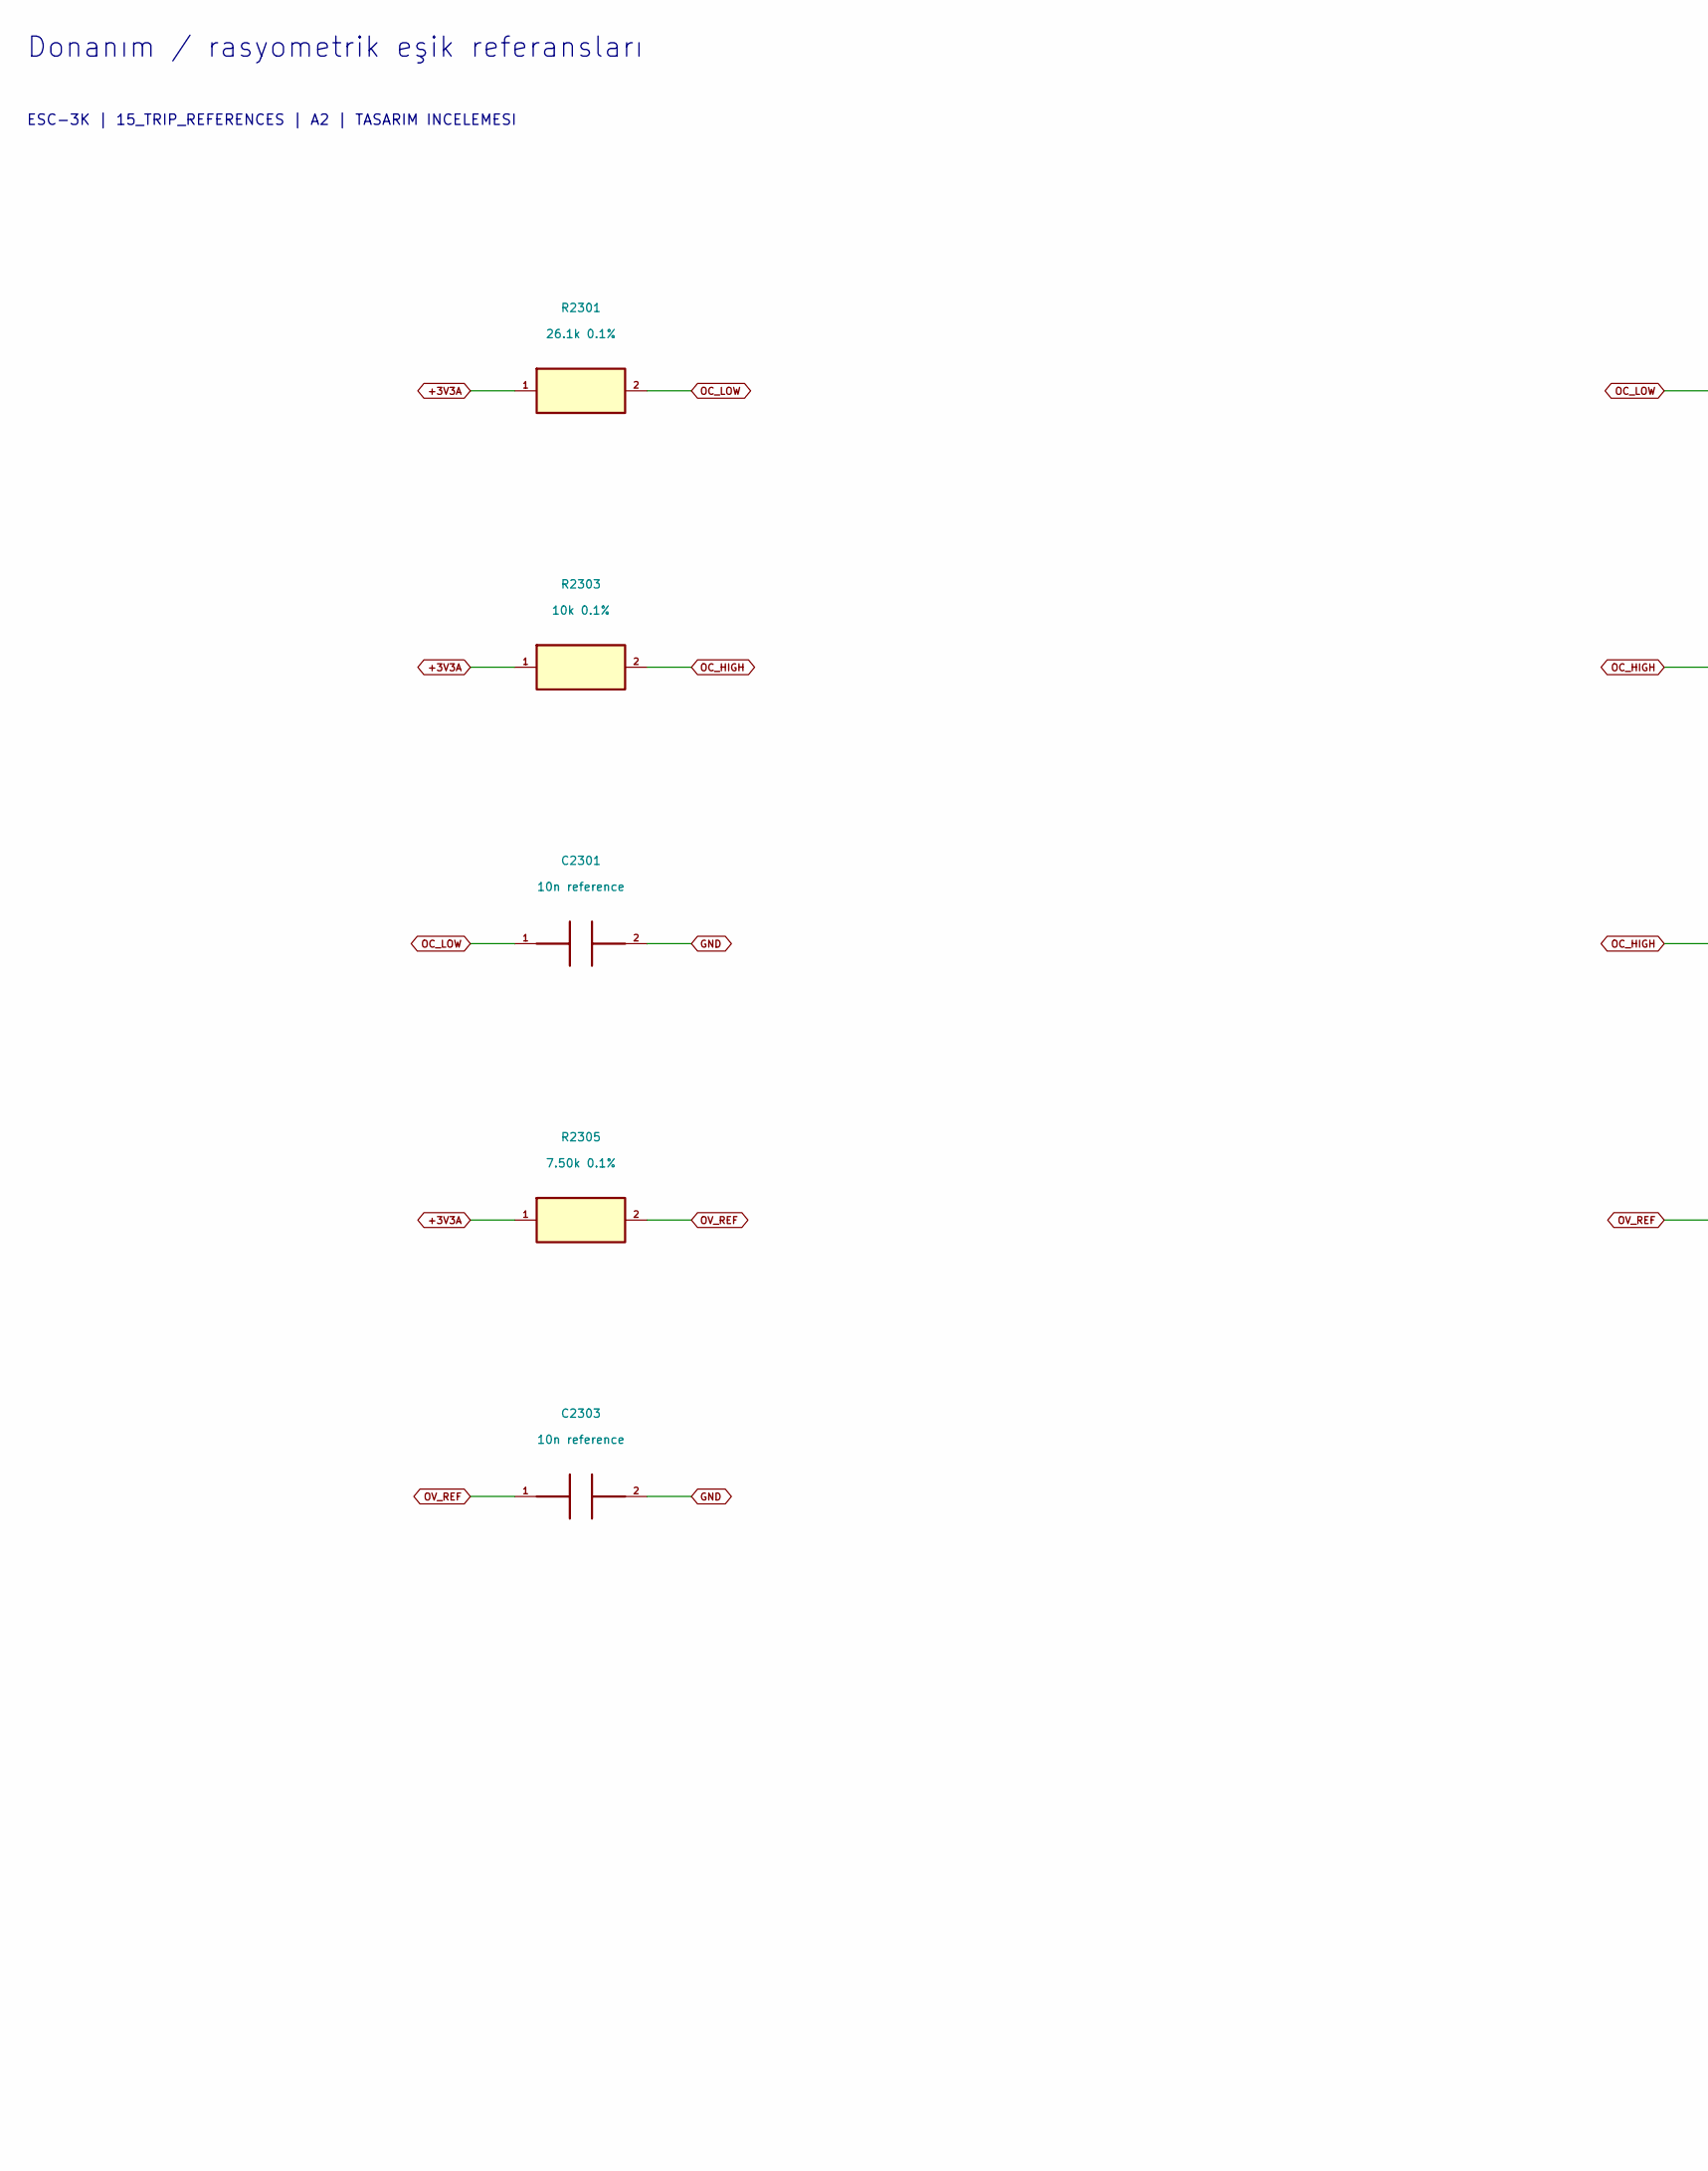
[picture p155: schematic 15_TRIP_REFERENCES.kicad_sch, part in row 1, column 1]

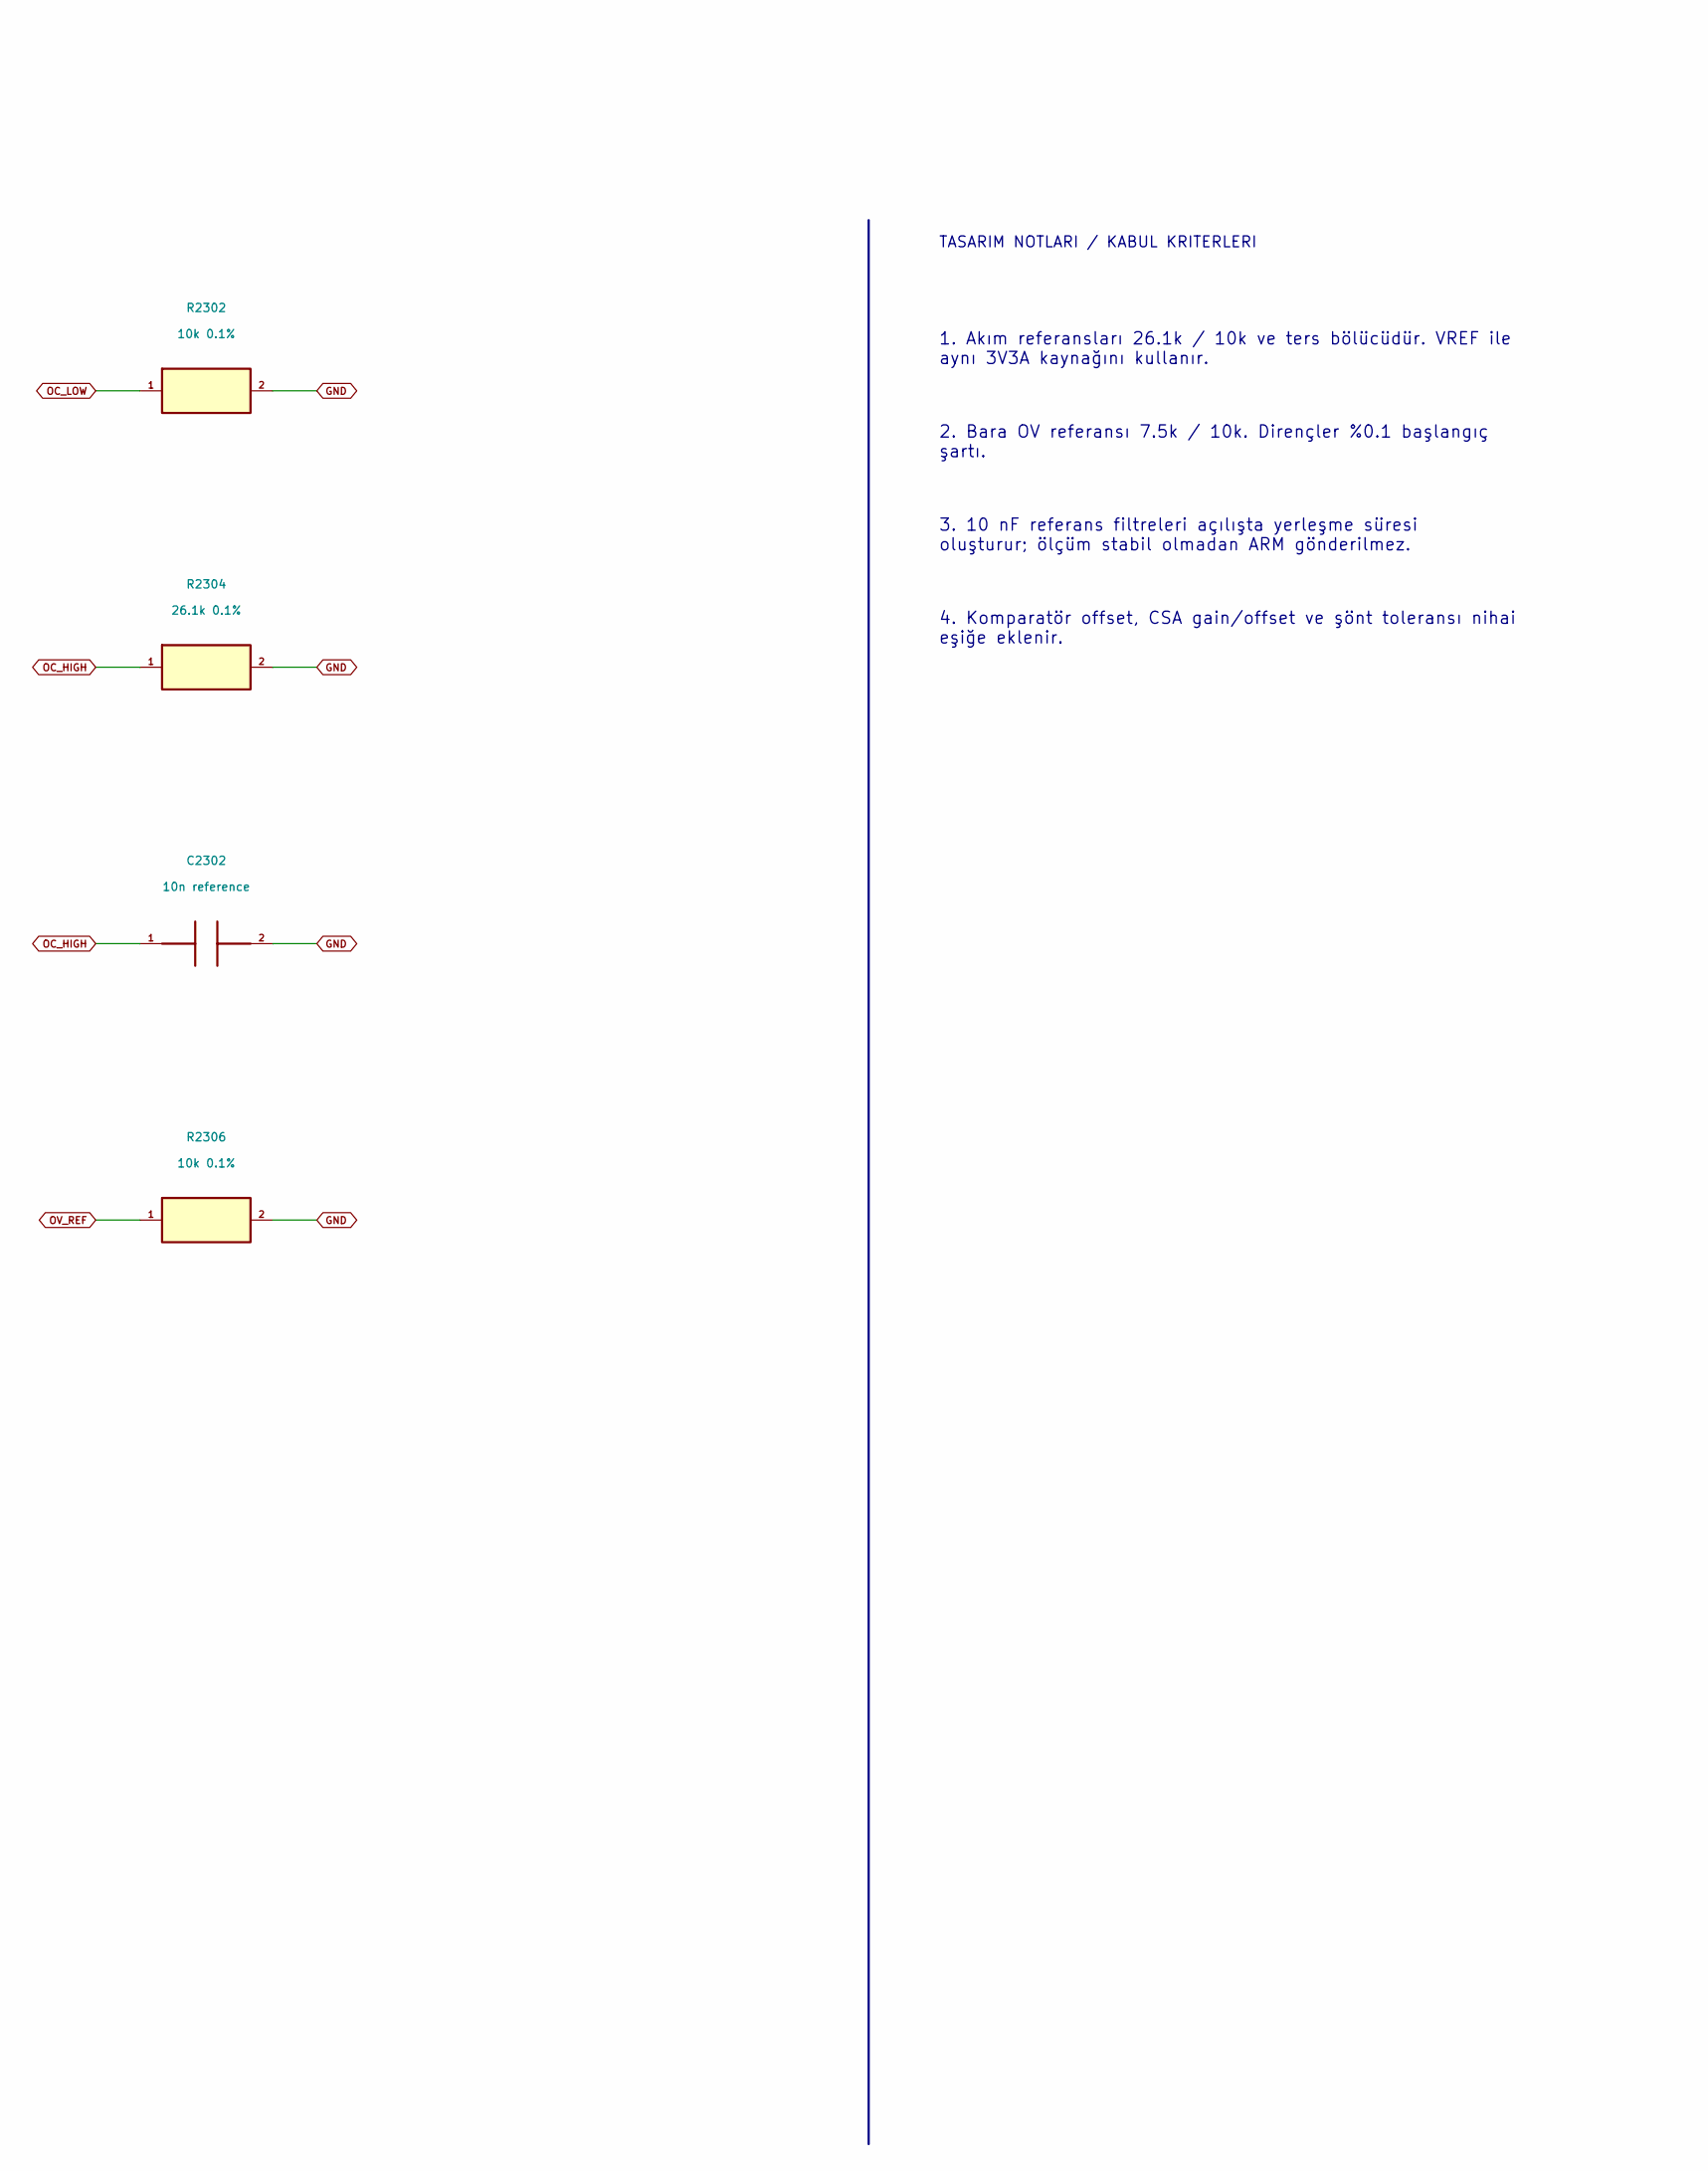
[picture p156: schematic 15_TRIP_REFERENCES.kicad_sch, part in row 1, column 2]

Parts:
C2301, C2302, C2303: 10n reference; C_0805_2012Metric
R2301, R2304: 26.1k 0.1%; R_0805_2012Metric; MPN RT0805BRD0726K1L
R2302, R2303, R2306: 10k 0.1%; R_0805_2012Metric; MPN RT0805BRD0710KL
R2305: 7.50k 0.1%; R_0805_2012Metric; MPN RT0805BRD077K50L

Connections:
+3V3A: R2301.1, R2303.1, R2305.1
GND: C2301.2, C2302.2, C2303.2, R2302.2, R2304.2, R2306.2
OC_HIGH: C2302.1, R2303.2, R2304.1
OC_LOW: C2301.1, R2301.2, R2302.1
OV_REF: C2303.1, R2305.2, R2306.1

Notes on the sheet:
Donanım / rasyometrik eşik referansları
ESC-3K | 15_TRIP_REFERENCES | A2 | TASARIM INCELEMESI
TASARIM NOTLARI / KABUL KRITERLERI
1. Akım referansları 26.1k / 10k ve ters bölücüdür. VREF ile aynı 3V3A kaynağını kullanır.
2. Bara OV referansı 7.5k / 10k. Dirençler %0.1 başlangıç şartı.
3. 10 nF referans filtreleri açılışta yerleşme süresi oluşturur; ölçüm stabil olmadan ARM gönderilmez.
4. Komparatör offset, CSA gain/offset ve şönt toleransı nihai eşiğe eklenir.
