mekiciepcas/ESC-Ai/ESC_V2/hardware_a2/16_FAULT_LATCH.kicad_sch

## KiCad design ESC_V2/hardware_a2/16_FAULT_LATCH.kicad_sch (2026-09-18)

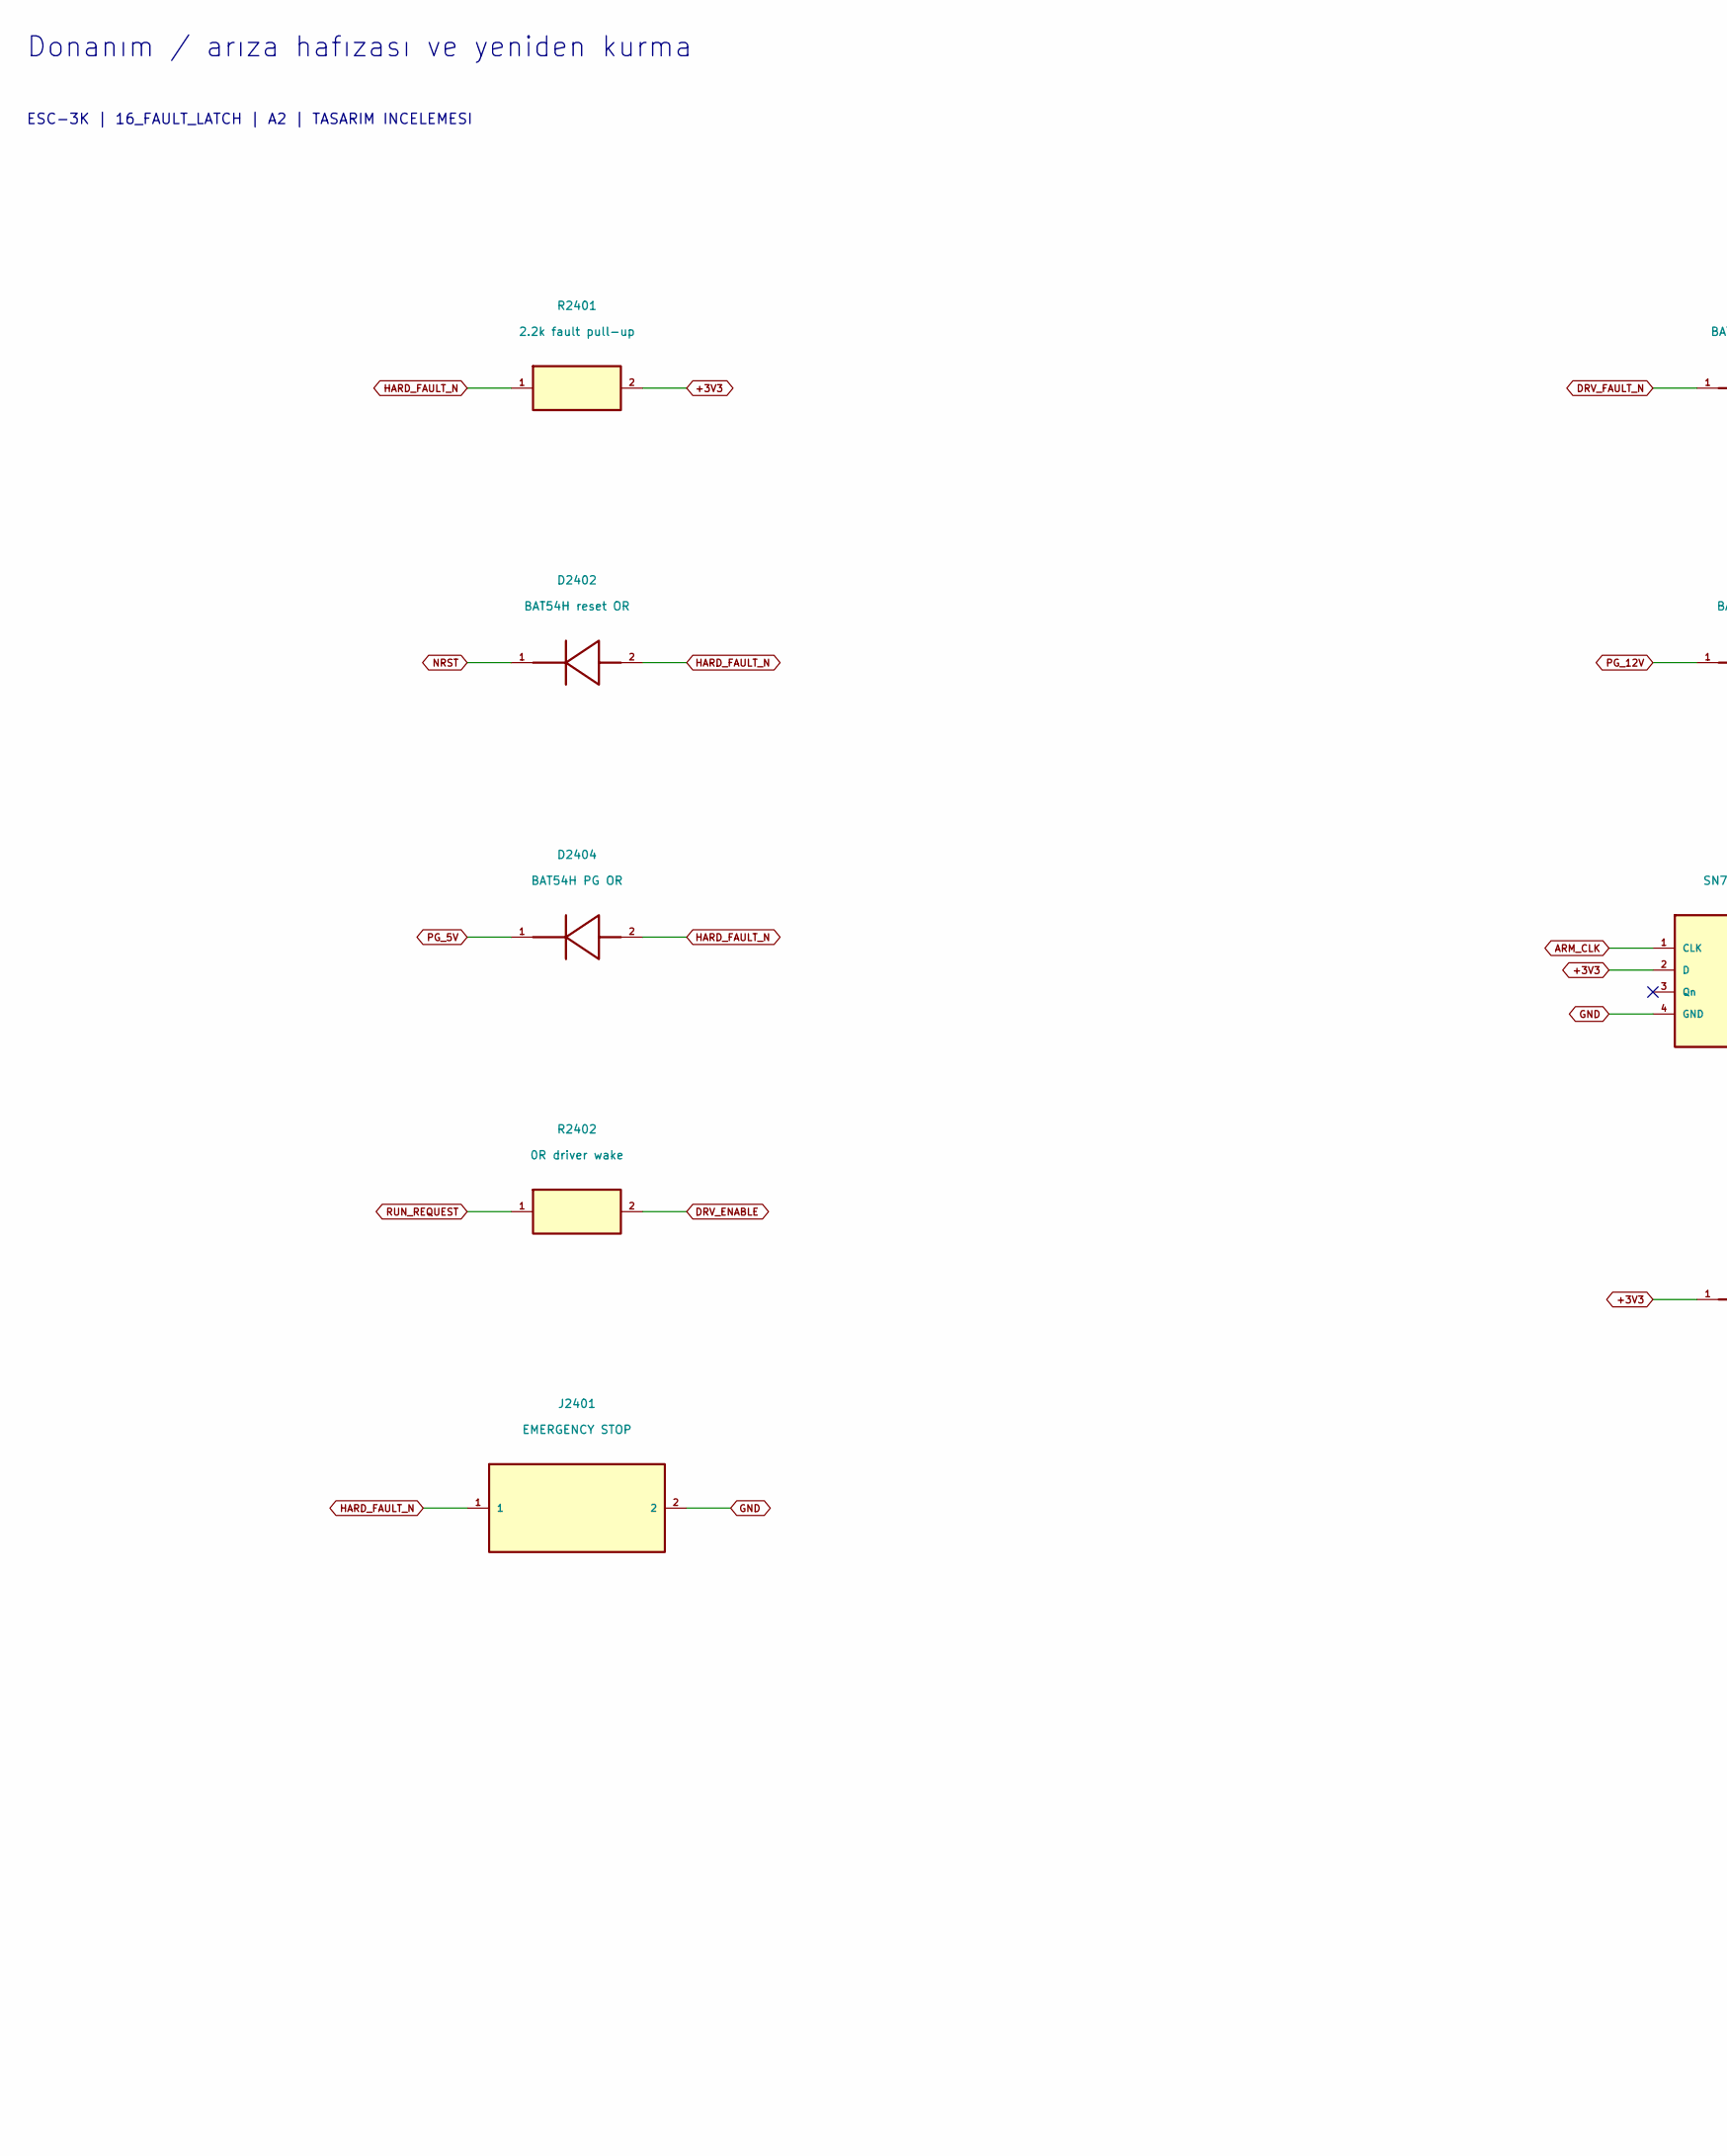
[picture p157: schematic 16_FAULT_LATCH.kicad_sch, part in row 1, column 1]

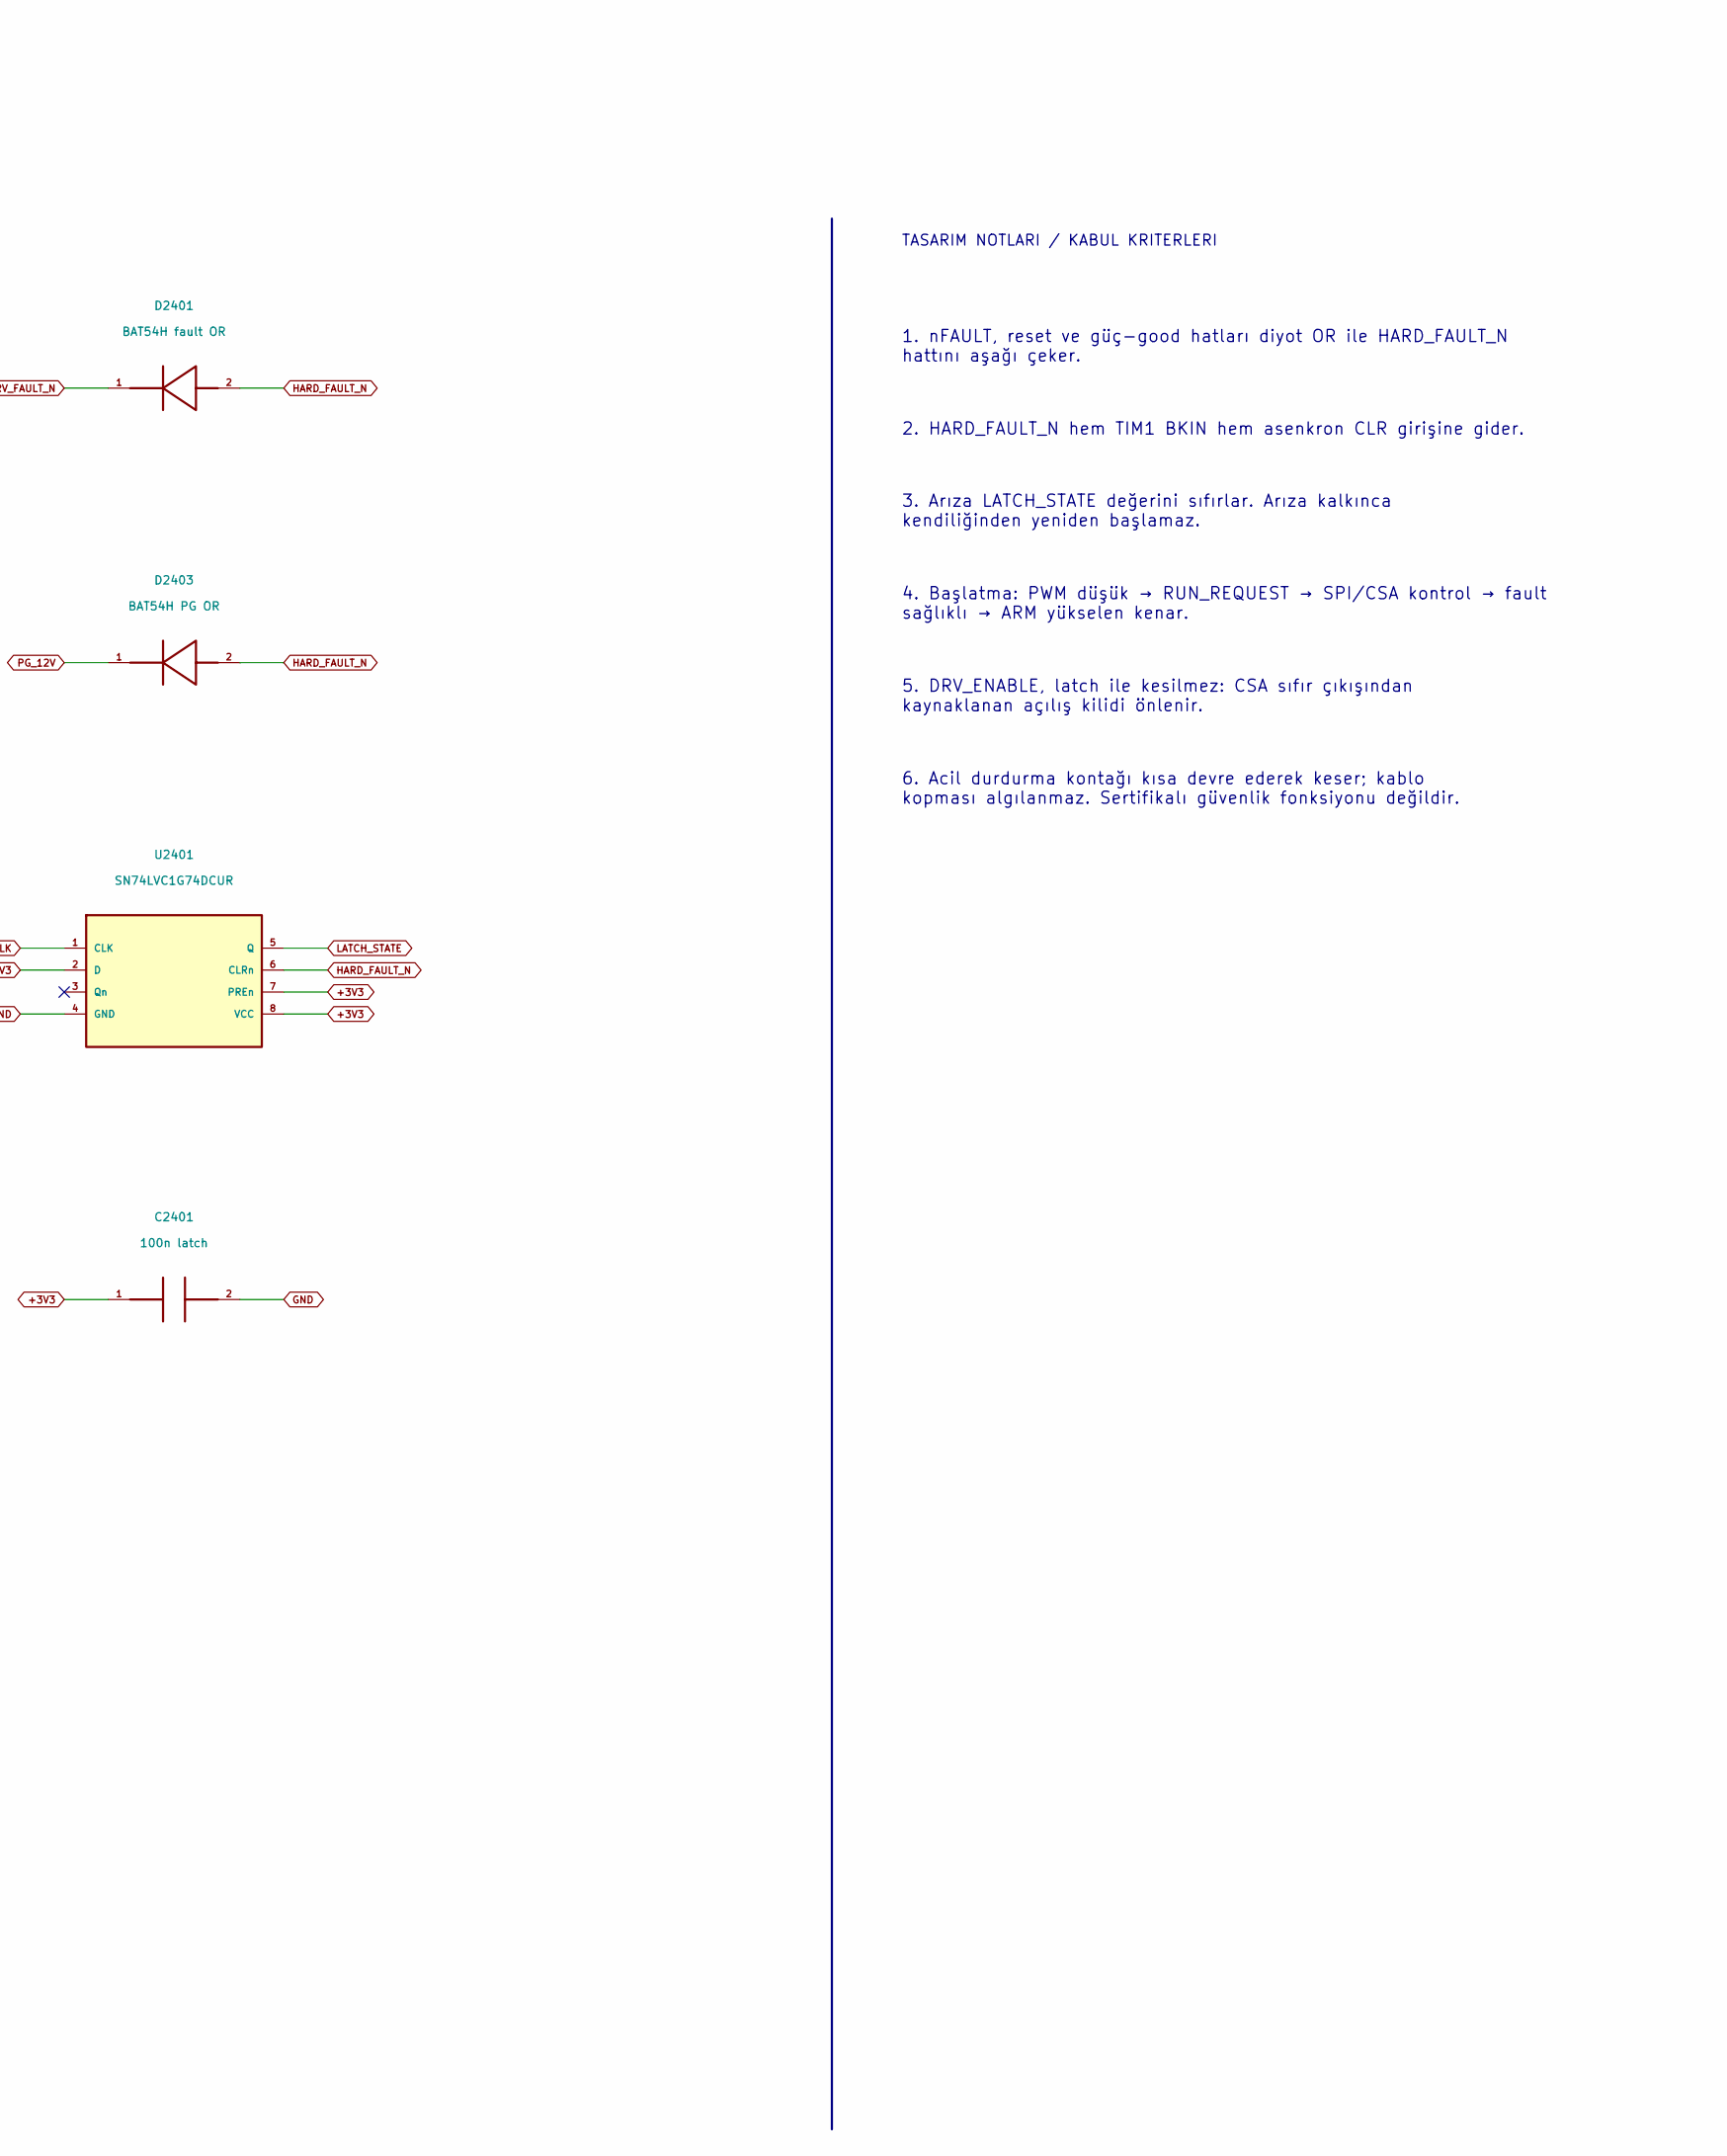
[picture p158: schematic 16_FAULT_LATCH.kicad_sch, part in row 1, column 2]

Parts:
C2401: 100n latch; C_0805_2012Metric; MPN C2012X7R2A104K125AA
D2401: BAT54H fault OR; D_SOD-123F; MPN BAT54H,115
D2402: BAT54H reset OR; D_SOD-123F; MPN BAT54H,115
D2403, D2404: BAT54H PG OR; D_SOD-123F; MPN BAT54H,115
J2401: EMERGENCY STOP
R2401: 2.2k fault pull-up; R_0805_2012Metric; MPN RC0805FR-072K2L
R2402: 0R driver wake; R_0805_2012Metric; MPN RC0805JR-070RL
U2401: SN74LVC1G74DCUR; VSSOP-8_2.3x2mm_P0.5mm; MPN SN74LVC1G74DCUR

Connections:
+3V3: C2401.1, R2401.2, U2401.2 (D), U2401.7 (PREn), U2401.8 (VCC)
ARM_CLK: U2401.1 (CLK)
DRV_ENABLE: R2402.2
DRV_FAULT_N: D2401.1 (K)
GND: C2401.2, J2401.2, U2401.4 (GND)
HARD_FAULT_N: D2401.2 (A), D2402.2 (A), D2403.2 (A), D2404.2 (A), J2401.1, R2401.1, U2401.6 (CLRn)
LATCH_STATE: U2401.5 (Q)
NRST: D2402.1 (K)
PG_5V: D2404.1 (K)
PG_12V: D2403.1 (K)
RUN_REQUEST: R2402.1

Notes on the sheet:
Donanım / arıza hafızası ve yeniden kurma
ESC-3K | 16_FAULT_LATCH | A2 | TASARIM INCELEMESI
TASARIM NOTLARI / KABUL KRITERLERI
1. nFAULT, reset ve güç-good hatları diyot OR ile HARD_FAULT_N hattını aşağı çeker.
2. HARD_FAULT_N hem TIM1 BKIN hem asenkron CLR girişine gider.
3. Arıza LATCH_STATE değerini sıfırlar. Arıza kalkınca kendiliğinden yeniden başlamaz.
4. Başlatma: PWM düşük → RUN_REQUEST → SPI/CSA kontrol → fault sağlıklı → ARM yükselen kenar.
5. DRV_ENABLE, latch ile kesilmez: CSA sıfır çıkışından kaynaklanan açılış kilidi önlenir.
6. Acil durdurma kontağı kısa devre ederek keser; kablo kopması algılanmaz. Sertifikalı güvenlik fonksiyonu değildir.
