mekiciepcas/ESC-Ai/ESC_V2/hardware_a2/17_PWM_INHIBIT.kicad_sch

## KiCad design ESC_V2/hardware_a2/17_PWM_INHIBIT.kicad_sch (2026-09-18)

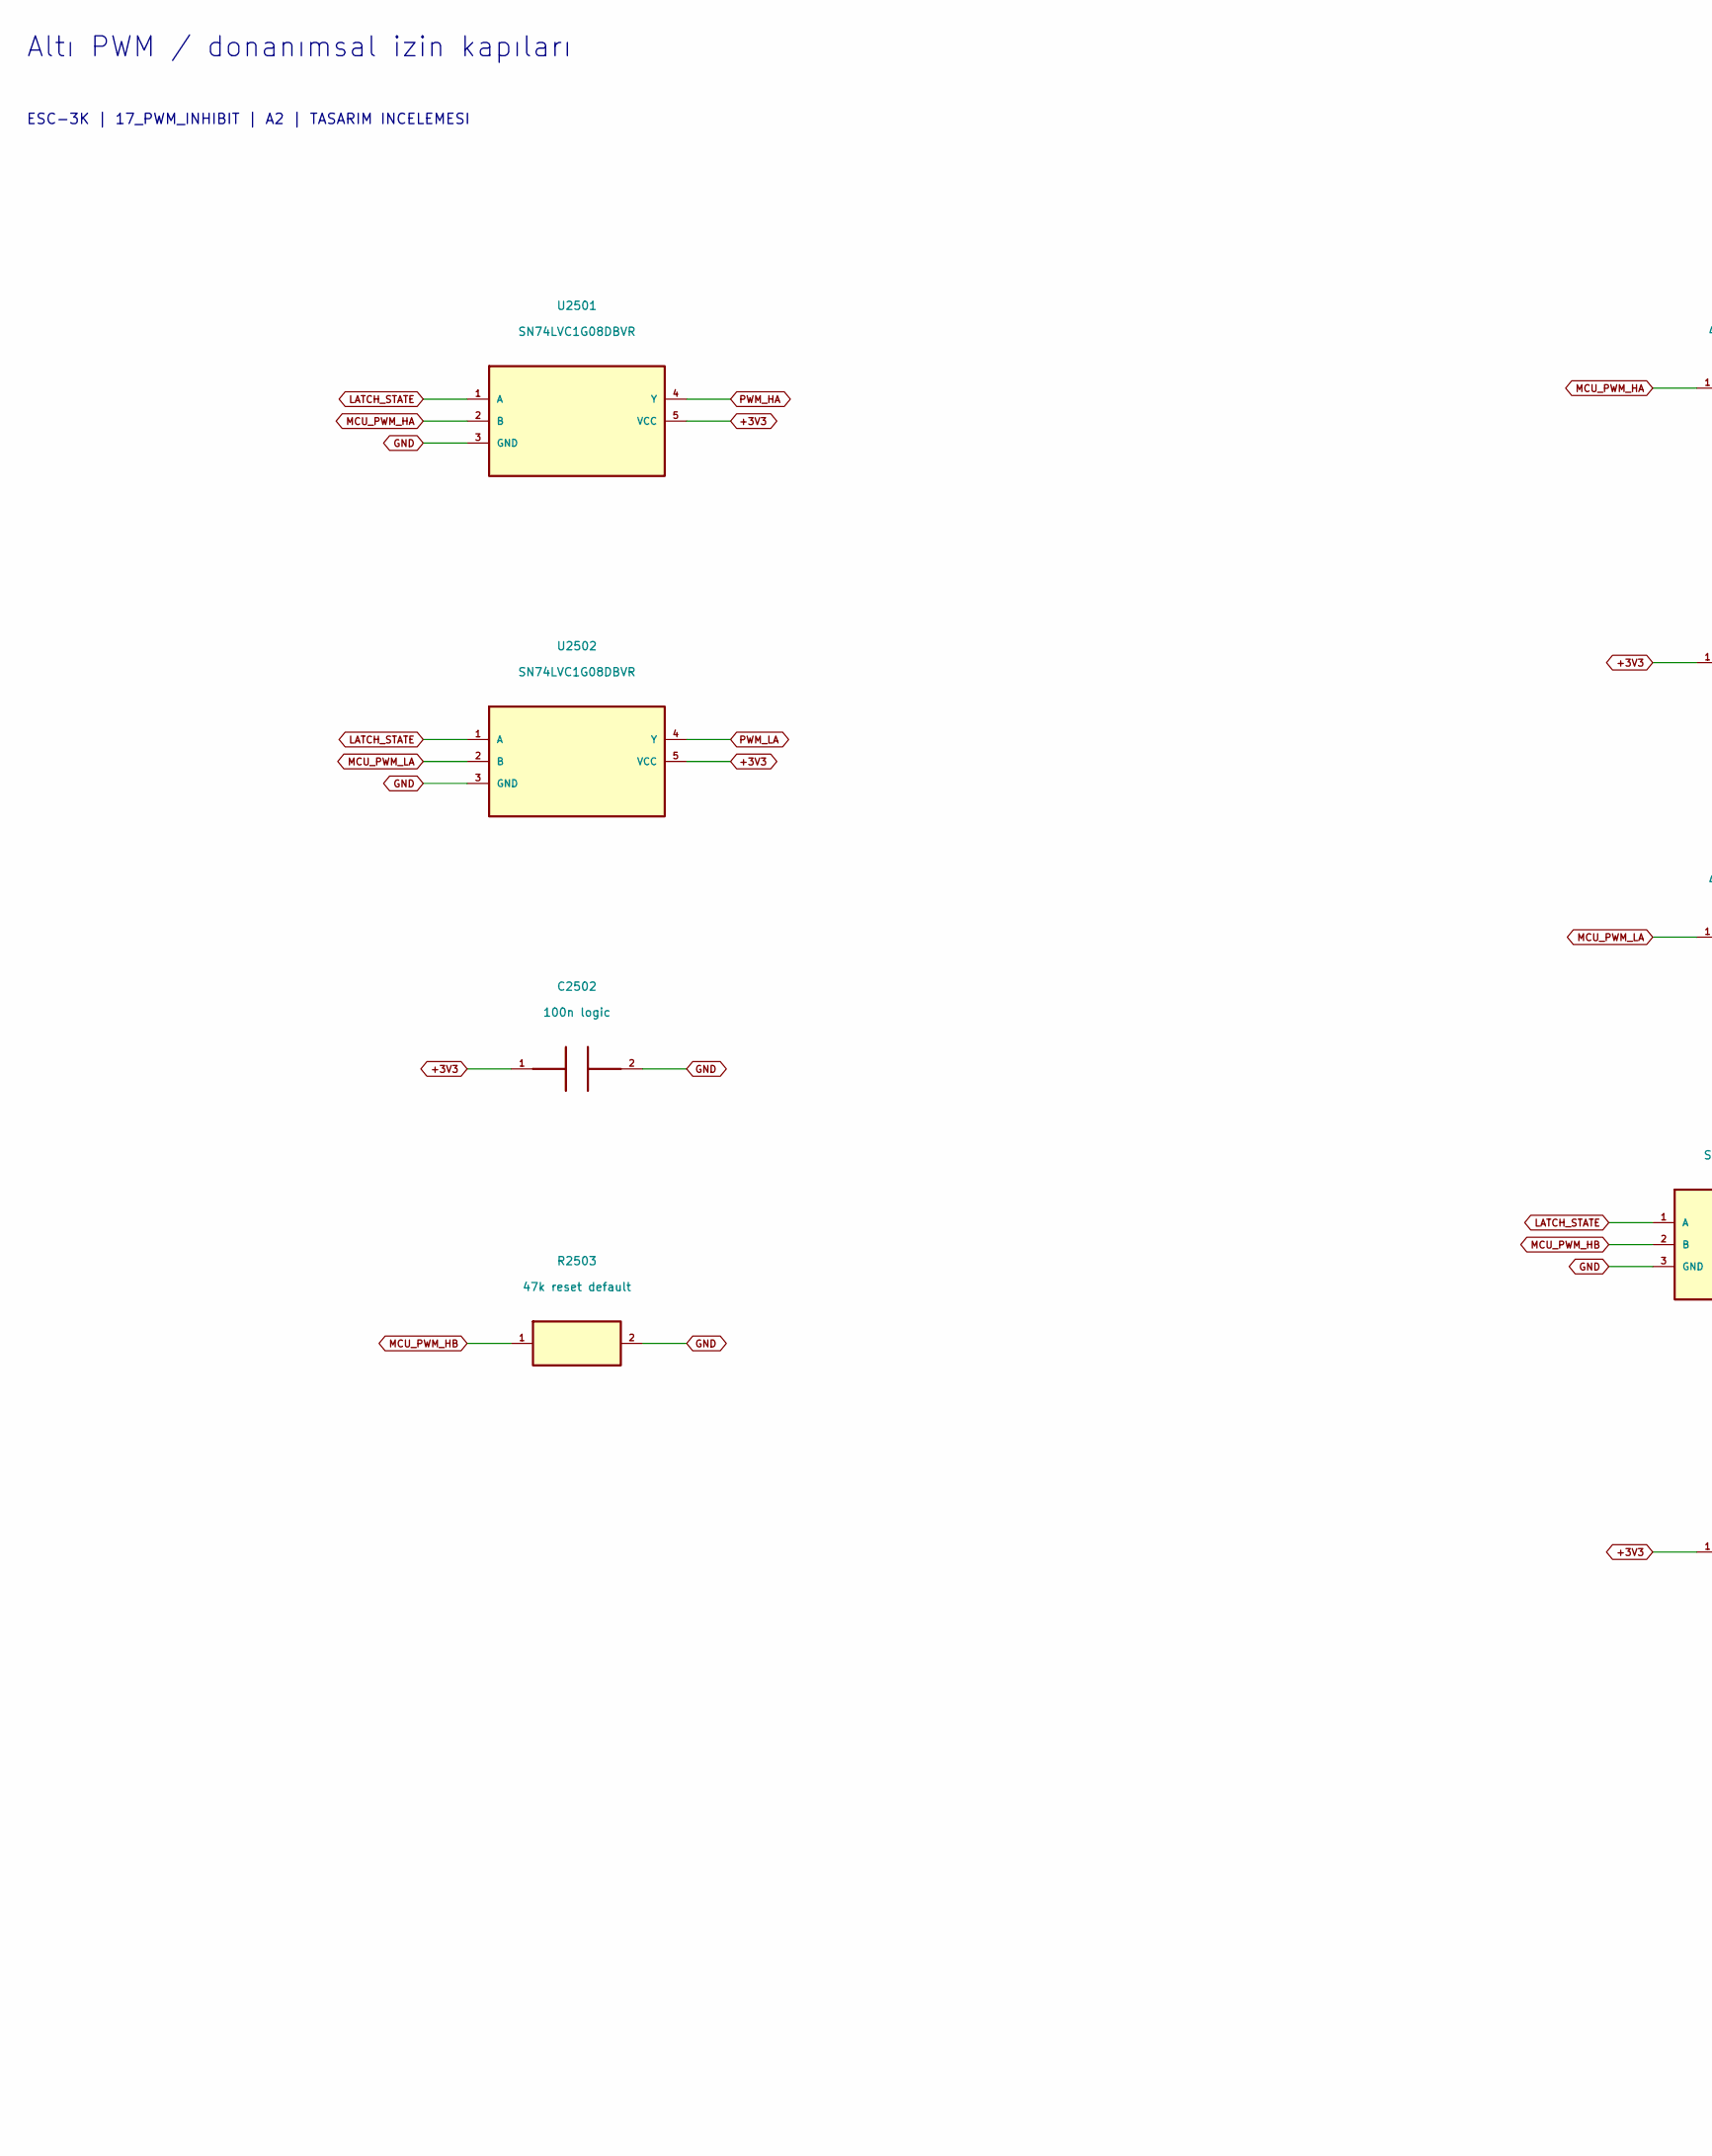
[picture p159: schematic 17_PWM_INHIBIT.kicad_sch, part in row 1, column 1]

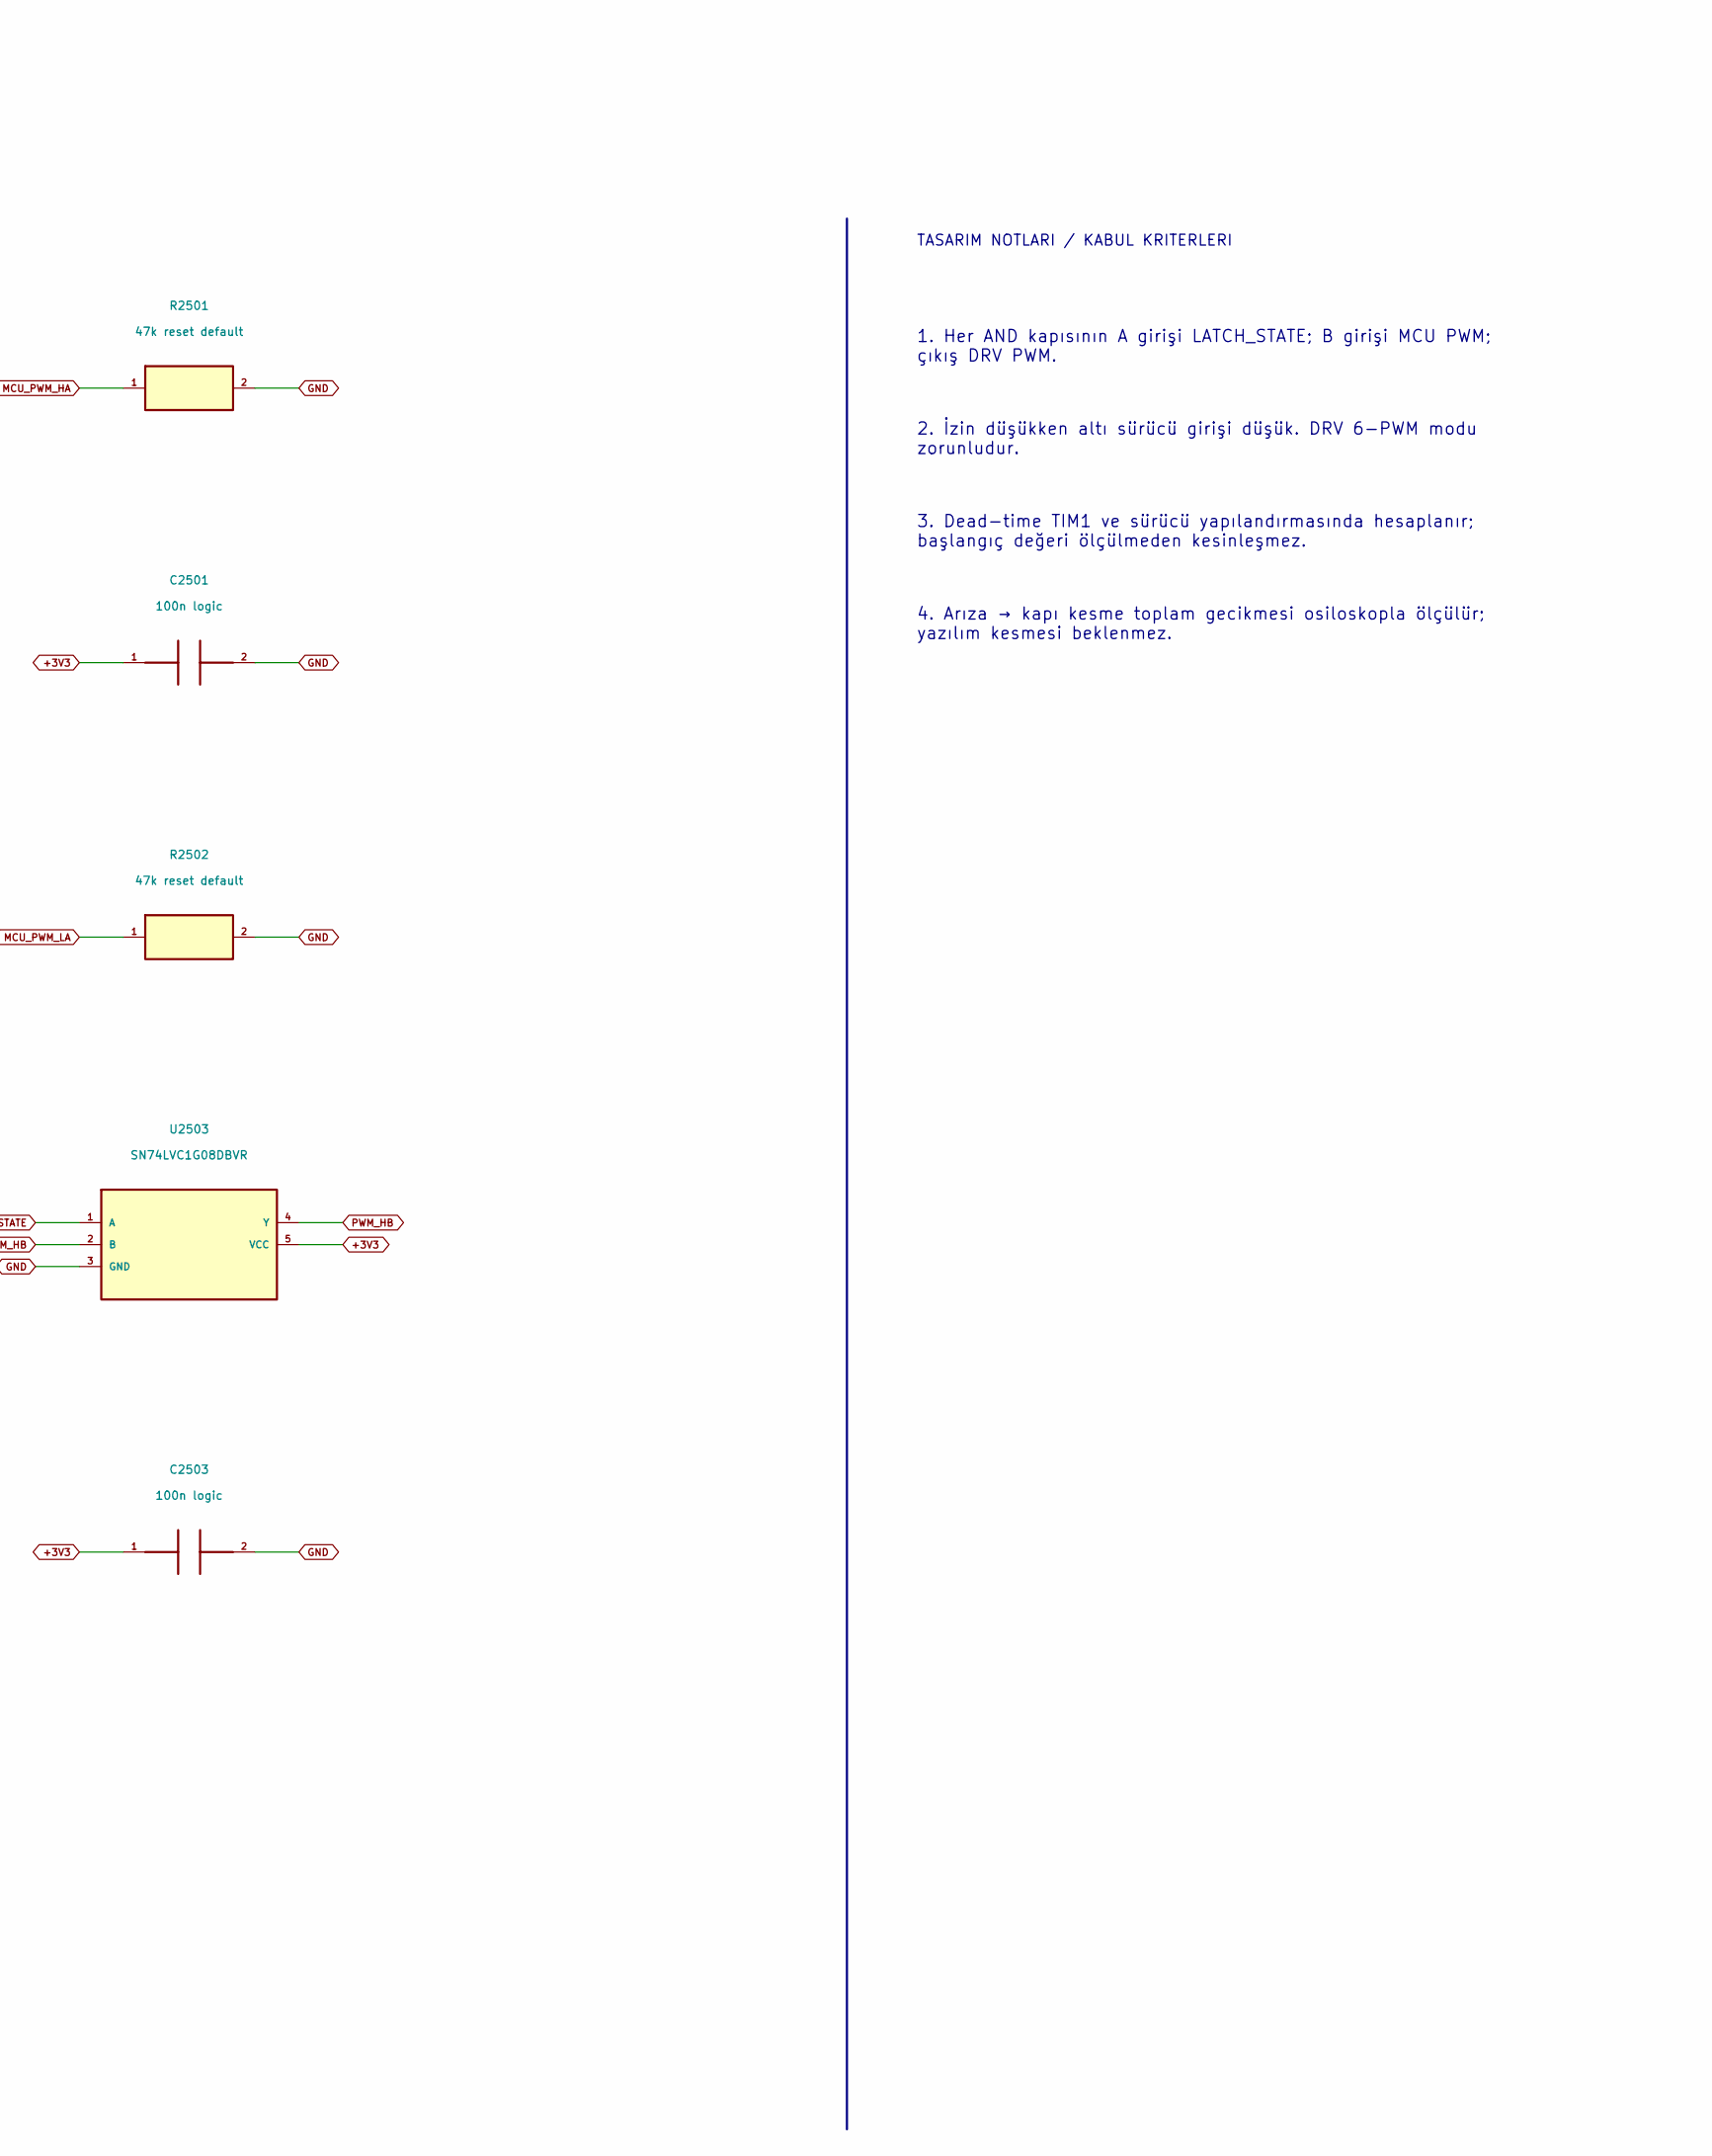
[picture p160: schematic 17_PWM_INHIBIT.kicad_sch, part in row 1, column 2]

Parts:
C2501, C2502, C2503: 100n logic; C_0805_2012Metric; MPN C2012X7R2A104K125AA
R2501, R2502, R2503: 47k reset default; R_0805_2012Metric; MPN RC0805FR-0747KL
U2501, U2502, U2503: SN74LVC1G08DBVR; SOT-23-5; MPN SN74LVC1G08DBVR

Connections:
+3V3: C2501.1, C2502.1, C2503.1, U2501.5 (VCC), U2502.5 (VCC), U2503.5 (VCC)
GND: C2501.2, C2502.2, C2503.2, R2501.2, R2502.2, R2503.2, U2501.3 (GND), U2502.3 (GND), U2503.3 (GND)
LATCH_STATE: U2501.1 (A), U2502.1 (A), U2503.1 (A)
MCU_PWM_HA: R2501.1, U2501.2 (B)
MCU_PWM_HB: R2503.1, U2503.2 (B)
MCU_PWM_LA: R2502.1, U2502.2 (B)
PWM_HA: U2501.4 (Y)
PWM_HB: U2503.4 (Y)
PWM_LA: U2502.4 (Y)

Notes on the sheet:
Altı PWM / donanımsal izin kapıları
ESC-3K | 17_PWM_INHIBIT | A2 | TASARIM INCELEMESI
TASARIM NOTLARI / KABUL KRITERLERI
1. Her AND kapısının A girişi LATCH_STATE; B girişi MCU PWM; çıkış DRV PWM.
2. İzin düşükken altı sürücü girişi düşük. DRV 6-PWM modu zorunludur.
3. Dead-time TIM1 ve sürücü yapılandırmasında hesaplanır; başlangıç değeri ölçülmeden kesinleşmez.
4. Arıza → kapı kesme toplam gecikmesi osiloskopla ölçülür; yazılım kesmesi beklenmez.
