mekiciepcas/ESC-Ai/ESC_V2/hardware_a2/17_PWM_INHIBIT_2.kicad_sch

## KiCad design ESC_V2/hardware_a2/17_PWM_INHIBIT_2.kicad_sch (2026-09-18)

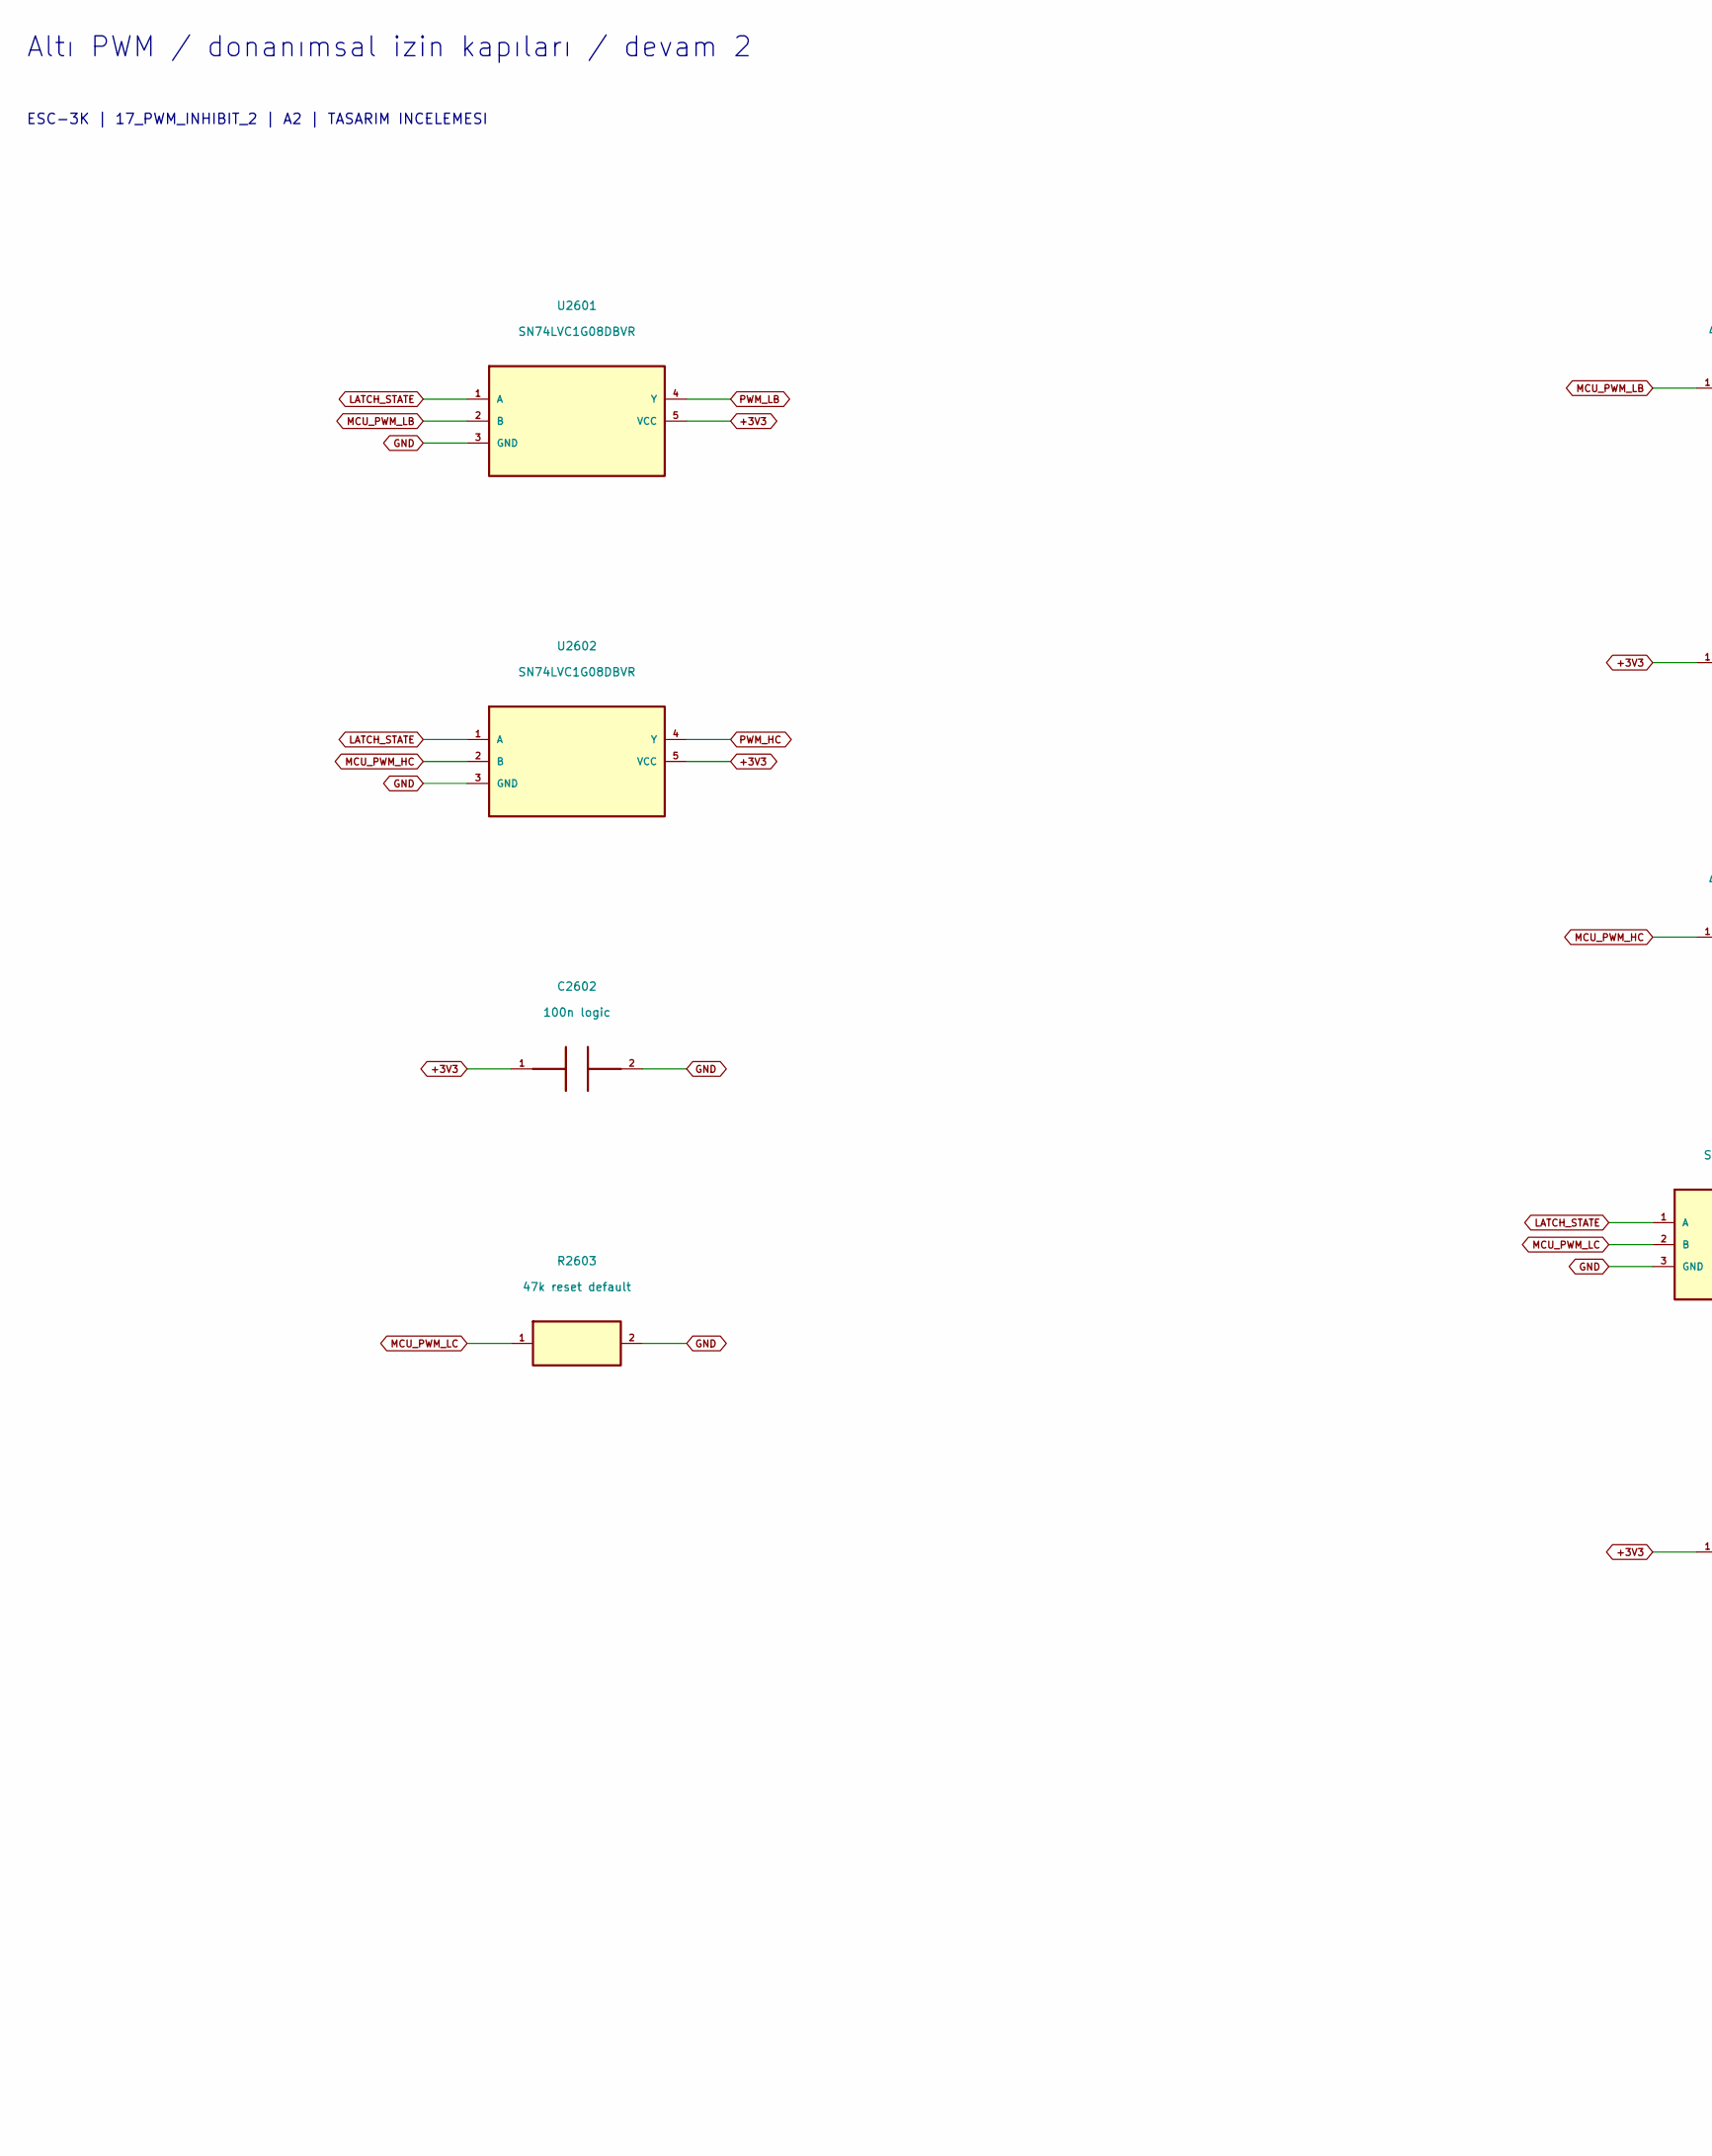
[picture p161: schematic 17_PWM_INHIBIT_2.kicad_sch, part in row 1, column 1]

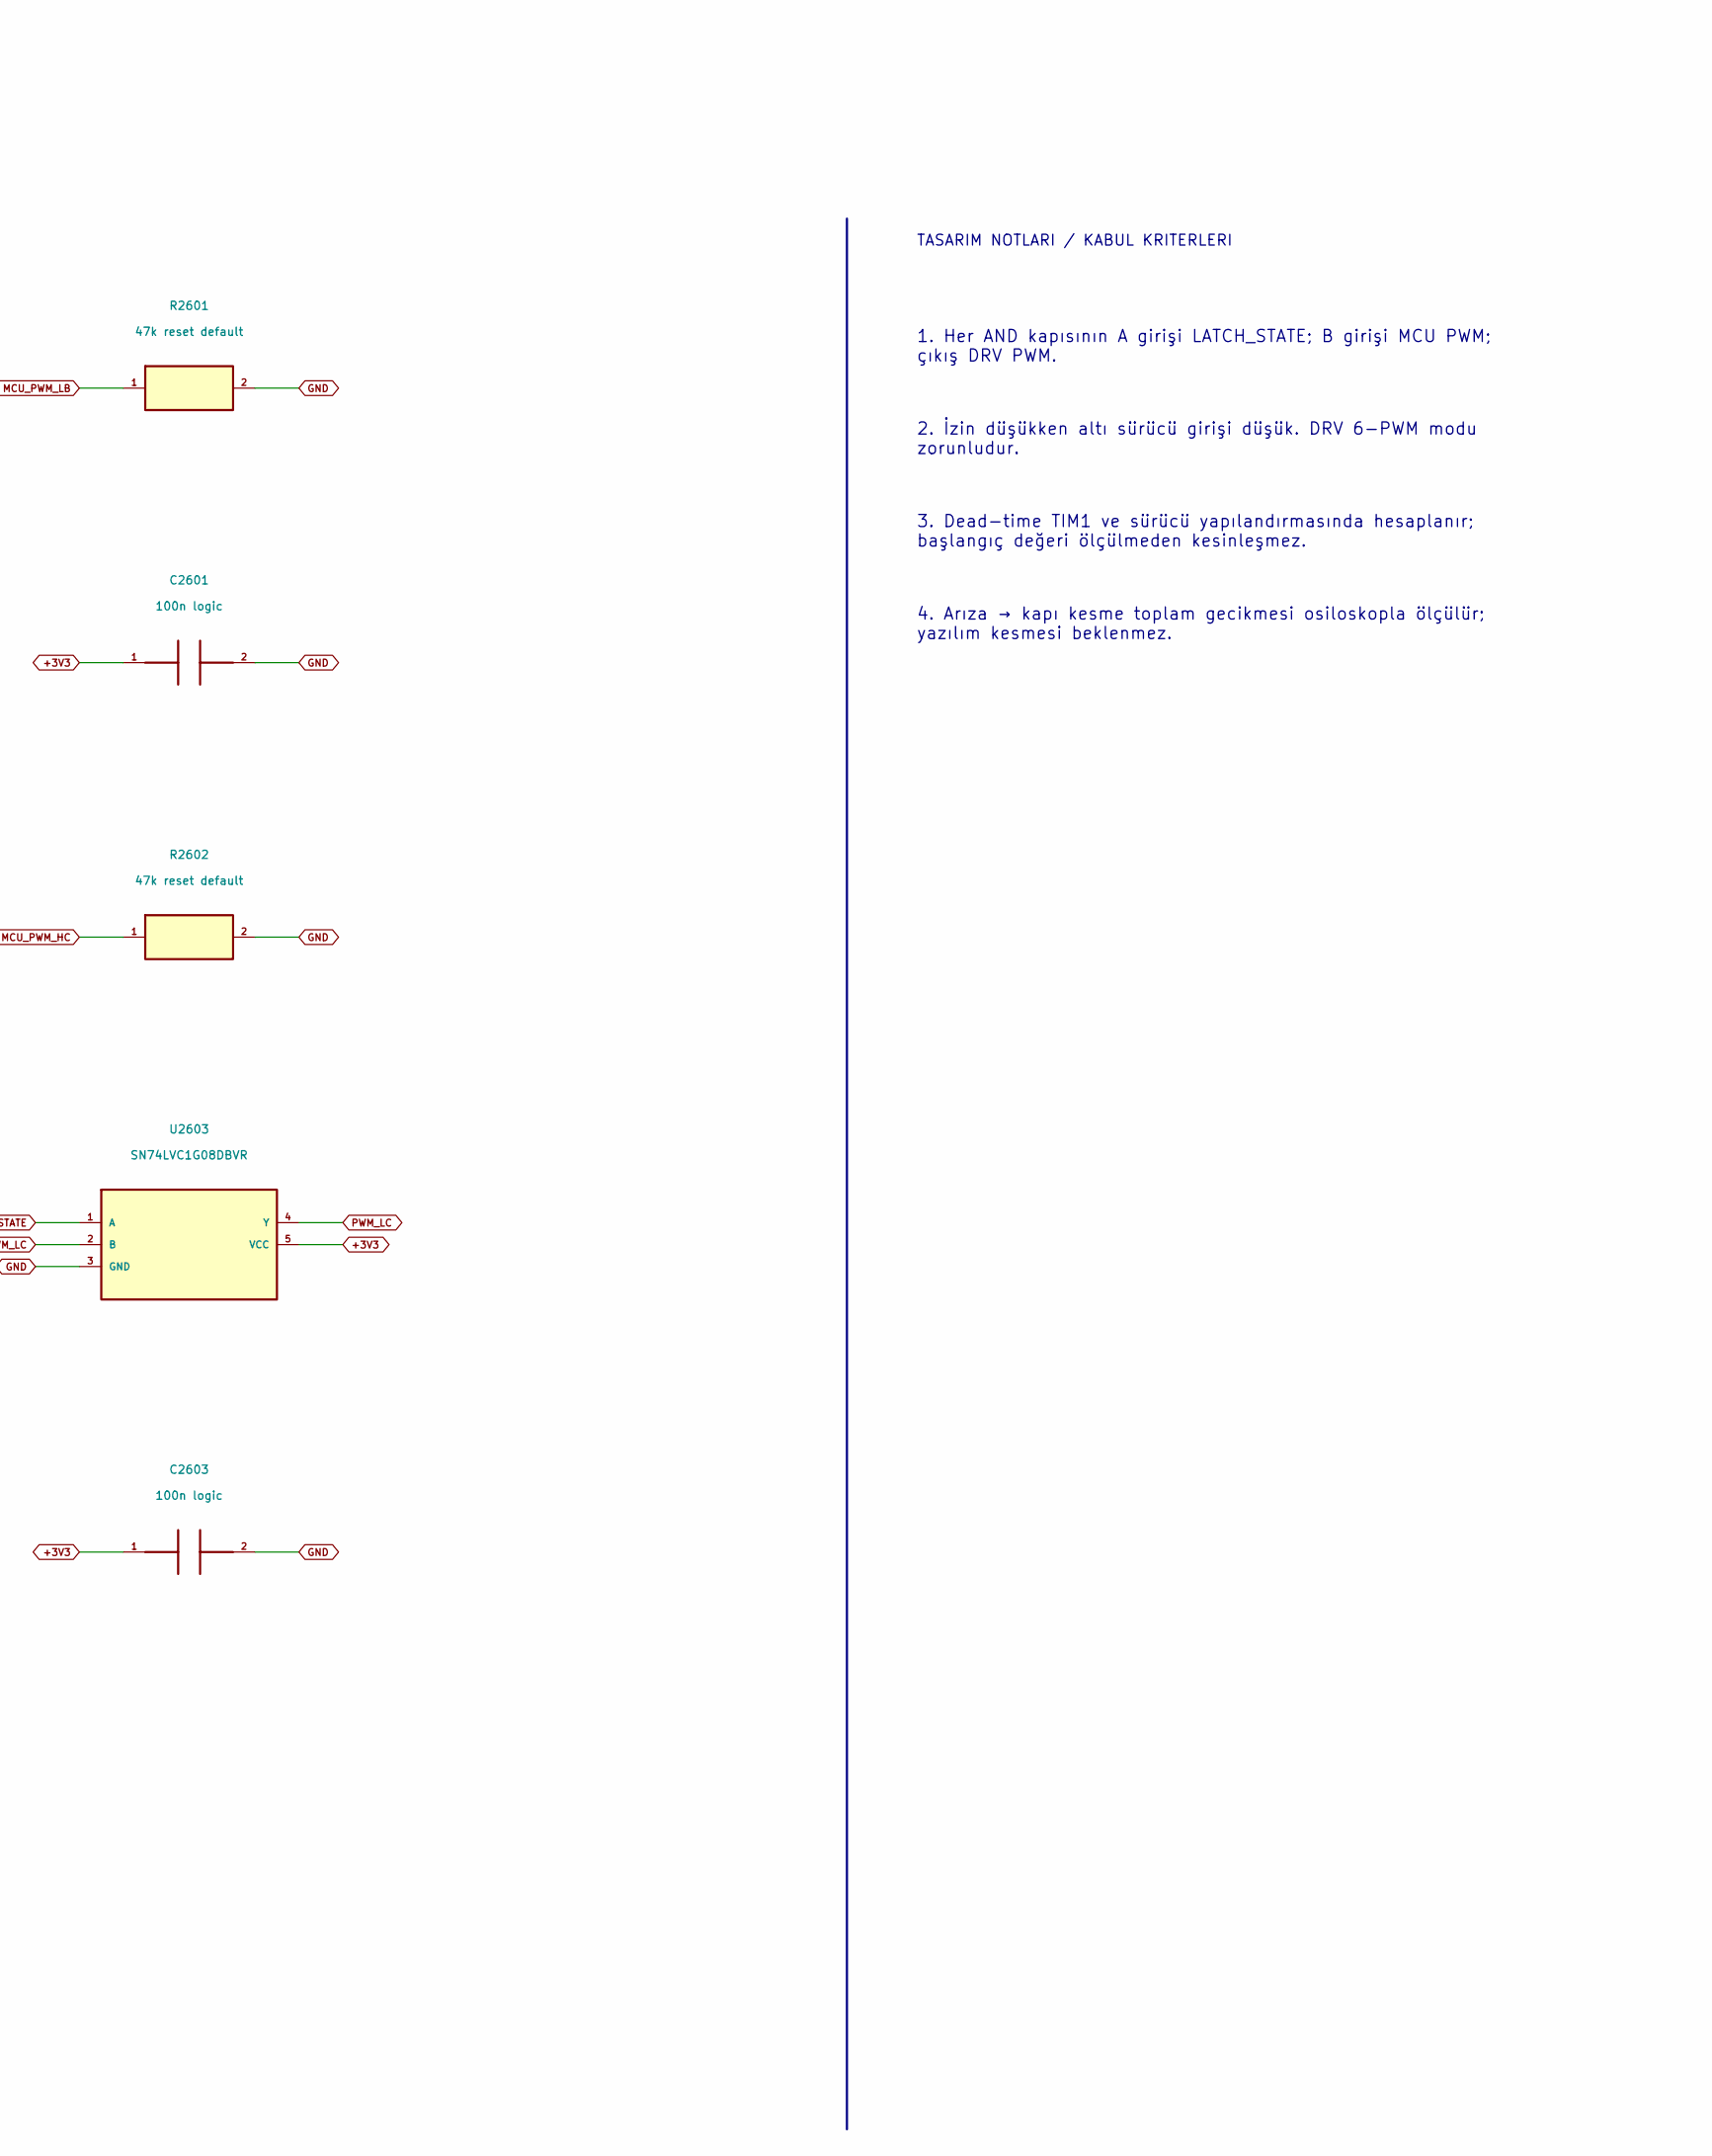
[picture p162: schematic 17_PWM_INHIBIT_2.kicad_sch, part in row 1, column 2]

Parts:
C2601, C2602, C2603: 100n logic; C_0805_2012Metric; MPN C2012X7R2A104K125AA
R2601, R2602, R2603: 47k reset default; R_0805_2012Metric; MPN RC0805FR-0747KL
U2601, U2602, U2603: SN74LVC1G08DBVR; SOT-23-5; MPN SN74LVC1G08DBVR

Connections:
+3V3: C2601.1, C2602.1, C2603.1, U2601.5 (VCC), U2602.5 (VCC), U2603.5 (VCC)
GND: C2601.2, C2602.2, C2603.2, R2601.2, R2602.2, R2603.2, U2601.3 (GND), U2602.3 (GND), U2603.3 (GND)
LATCH_STATE: U2601.1 (A), U2602.1 (A), U2603.1 (A)
MCU_PWM_HC: R2602.1, U2602.2 (B)
MCU_PWM_LB: R2601.1, U2601.2 (B)
MCU_PWM_LC: R2603.1, U2603.2 (B)
PWM_HC: U2602.4 (Y)
PWM_LB: U2601.4 (Y)
PWM_LC: U2603.4 (Y)

Notes on the sheet:
Altı PWM / donanımsal izin kapıları / devam 2
ESC-3K | 17_PWM_INHIBIT_2 | A2 | TASARIM INCELEMESI
TASARIM NOTLARI / KABUL KRITERLERI
1. Her AND kapısının A girişi LATCH_STATE; B girişi MCU PWM; çıkış DRV PWM.
2. İzin düşükken altı sürücü girişi düşük. DRV 6-PWM modu zorunludur.
3. Dead-time TIM1 ve sürücü yapılandırmasında hesaplanır; başlangıç değeri ölçülmeden kesinleşmez.
4. Arıza → kapı kesme toplam gecikmesi osiloskopla ölçülür; yazılım kesmesi beklenmez.
