mekiciepcas/ESC-Ai/ESC_V2/hardware_a2/18_BOARD_INTERFACE.kicad_sch

## KiCad design ESC_V2/hardware_a2/18_BOARD_INTERFACE.kicad_sch (2026-09-18)

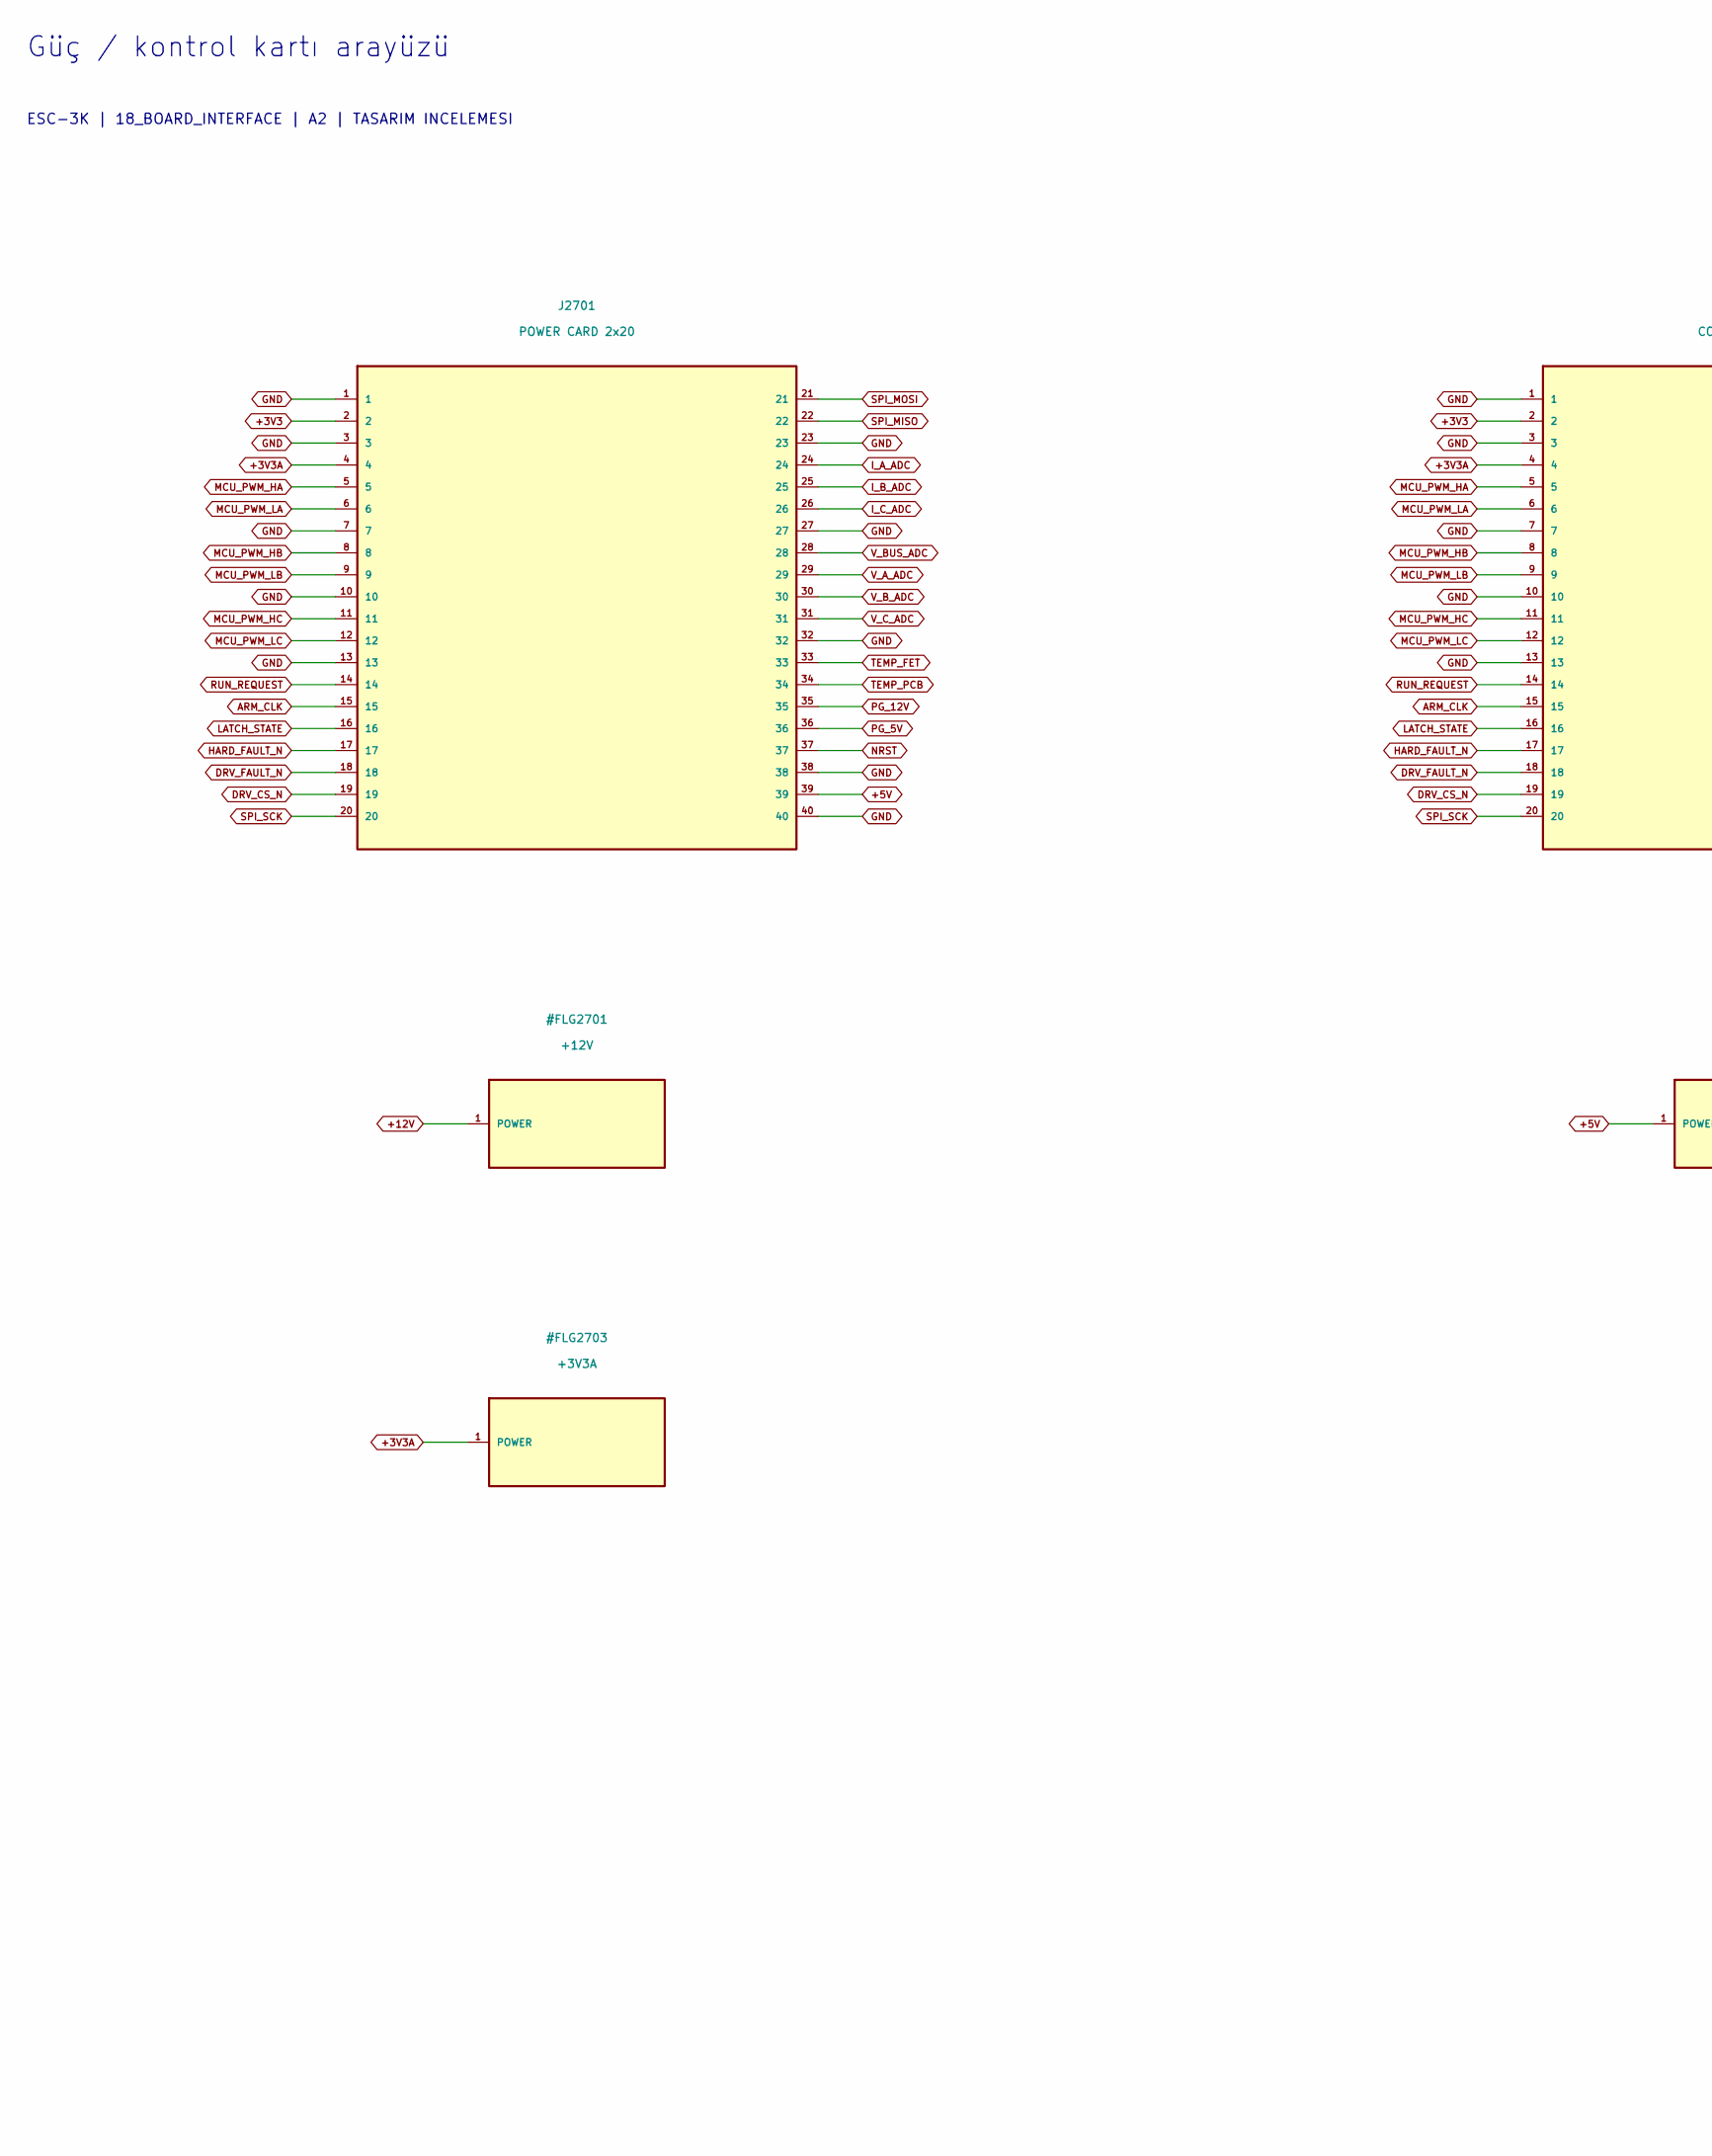
[picture p163: schematic 18_BOARD_INTERFACE.kicad_sch, part in row 1, column 1]

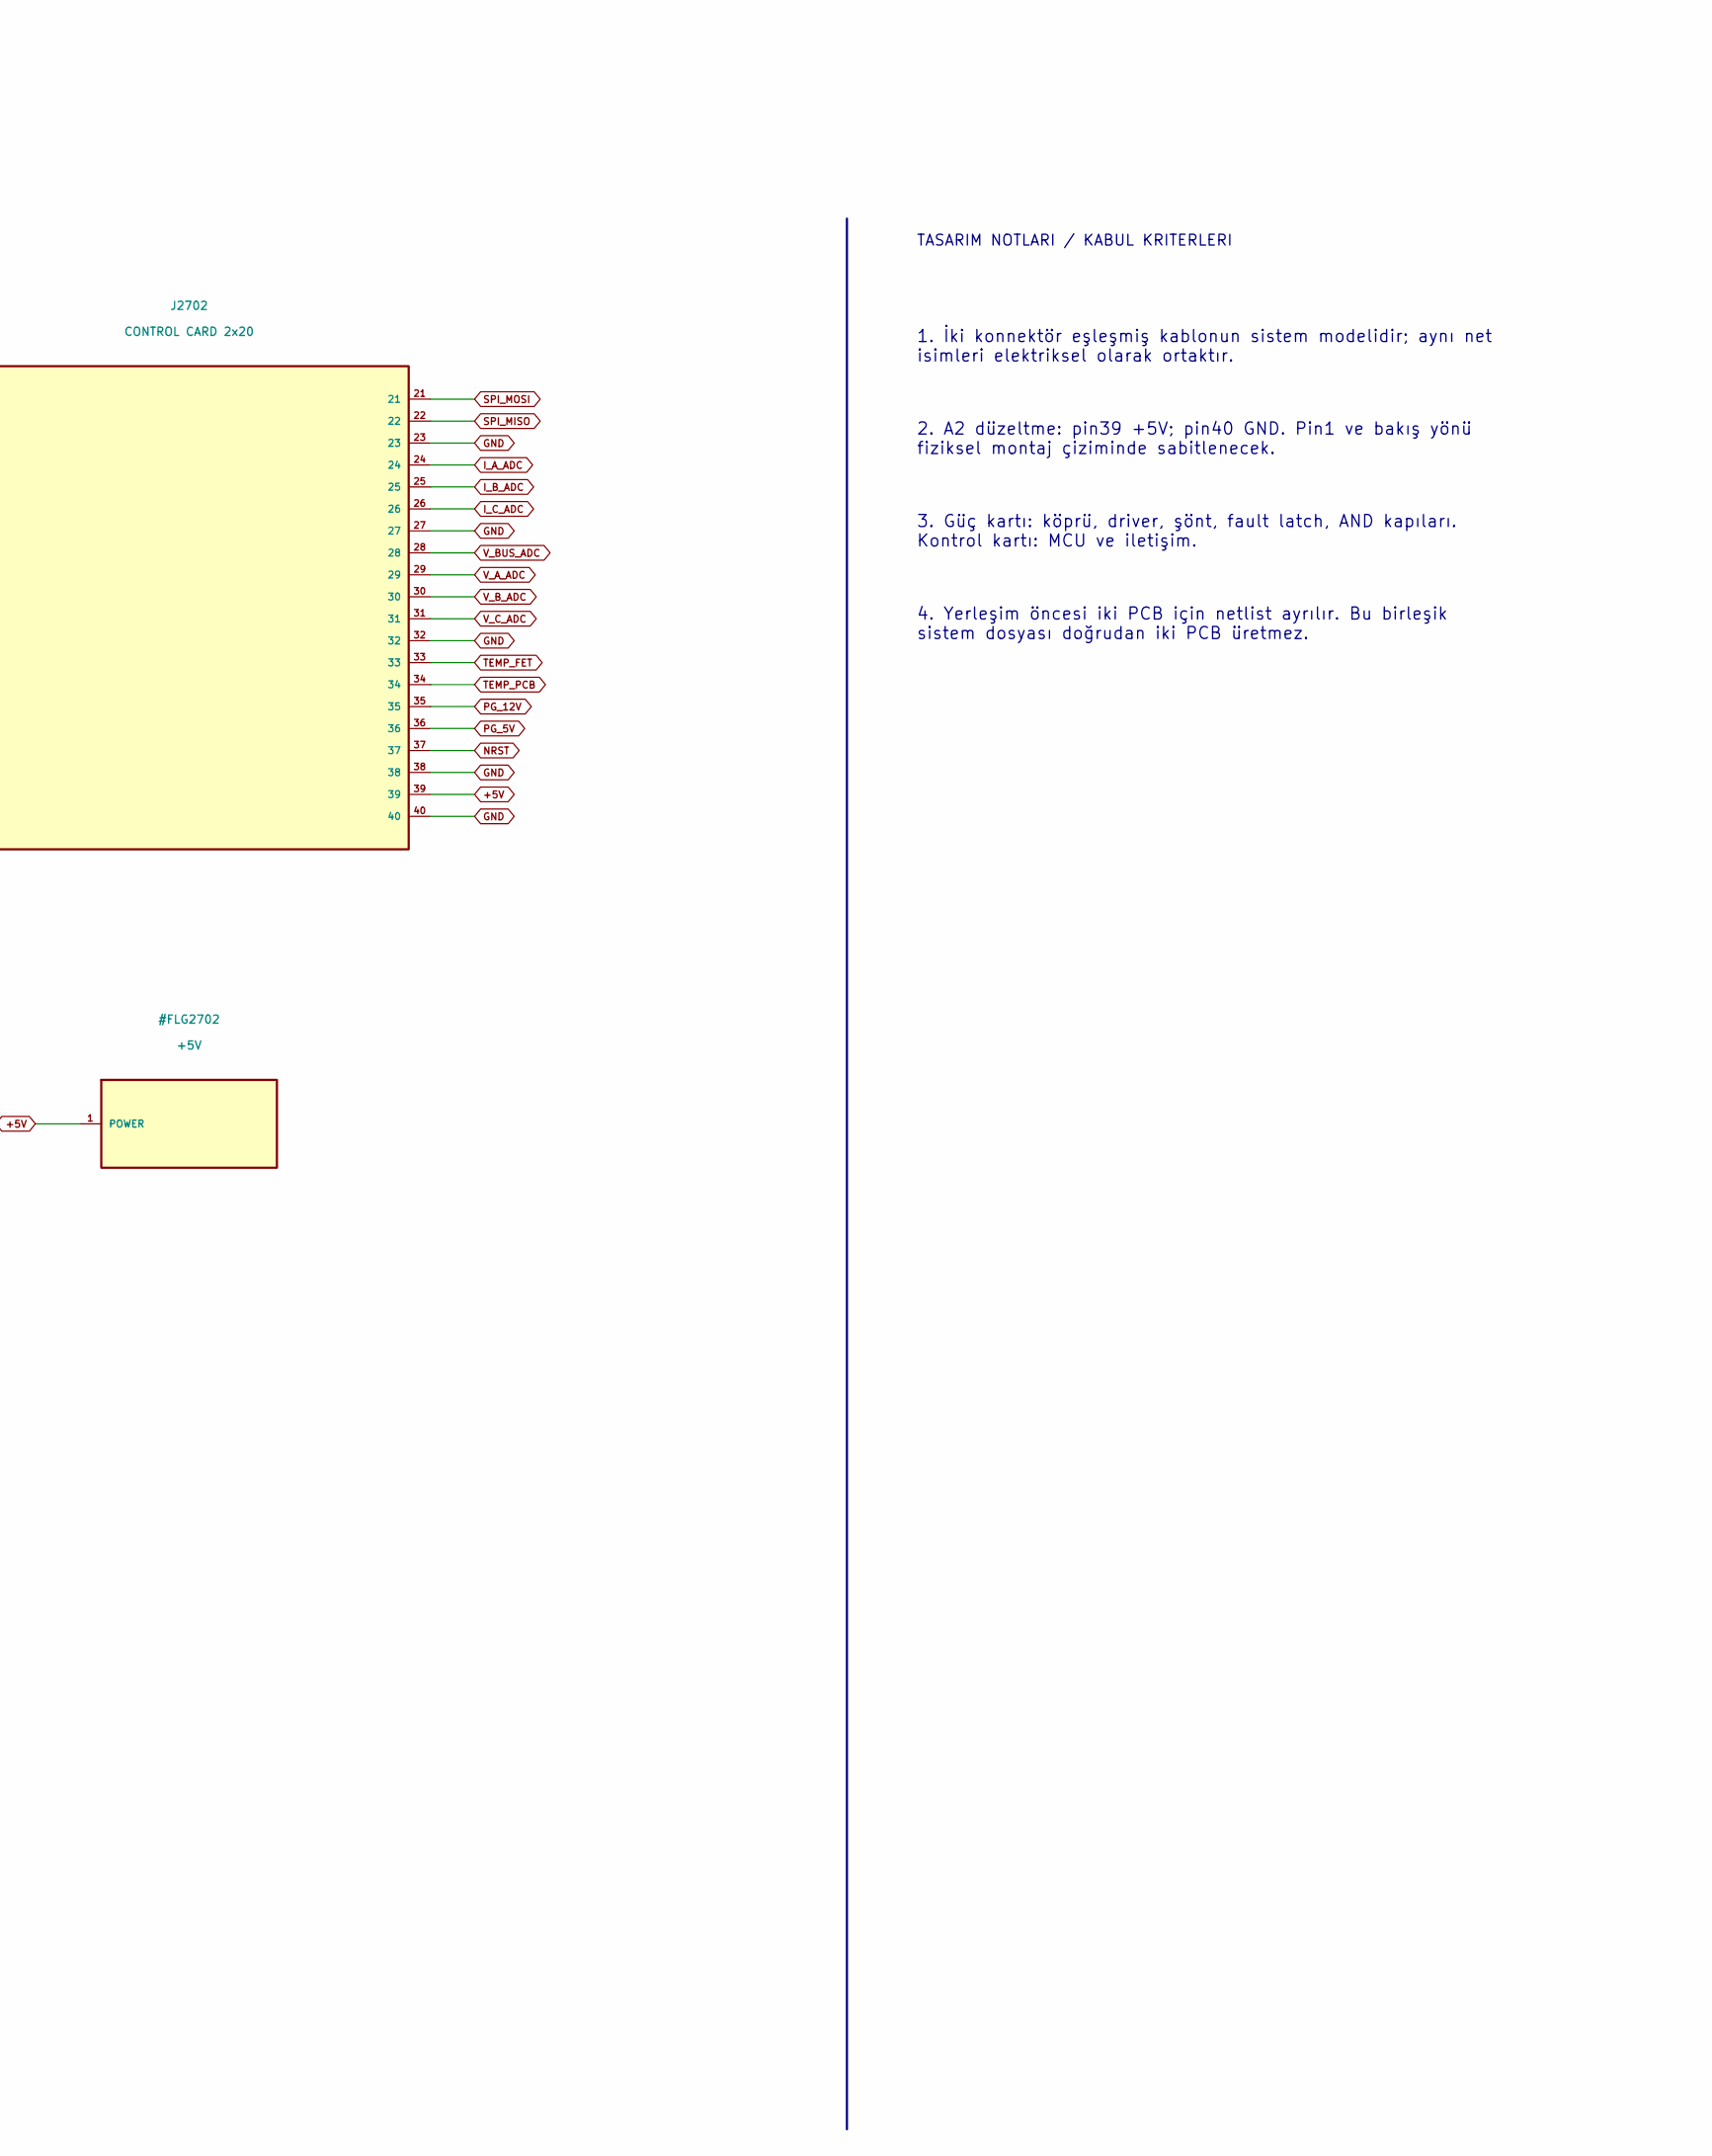
[picture p164: schematic 18_BOARD_INTERFACE.kicad_sch, part in row 1, column 2]

Parts:
J2701: POWER CARD 2x20
J2702: CONTROL CARD 2x20

Connections:
+3V3: J2701.2, J2702.2
+3V3A: J2701.4, J2702.4
+5V: J2701.39, J2702.39
ARM_CLK: J2701.15, J2702.15
DRV_CS_N: J2701.19, J2702.19
DRV_FAULT_N: J2701.18, J2702.18
GND: J2701.1, J2701.3, J2701.7, J2701.10, J2701.13, J2701.23, J2701.27, J2701.32, J2701.38, J2701.40, J2702.1, J2702.3, J2702.7, J2702.10, J2702.13, J2702.23, J2702.27, J2702.32, J2702.38, J2702.40
HARD_FAULT_N: J2701.17, J2702.17
I_A_ADC: J2701.24, J2702.24
I_B_ADC: J2701.25, J2702.25
I_C_ADC: J2701.26, J2702.26
LATCH_STATE: J2701.16, J2702.16
MCU_PWM_HA: J2701.5, J2702.5
MCU_PWM_HB: J2701.8, J2702.8
MCU_PWM_HC: J2701.11, J2702.11
MCU_PWM_LA: J2701.6, J2702.6
MCU_PWM_LB: J2701.9, J2702.9
MCU_PWM_LC: J2701.12, J2702.12
NRST: J2701.37, J2702.37
PG_5V: J2701.36, J2702.36
PG_12V: J2701.35, J2702.35
RUN_REQUEST: J2701.14, J2702.14
SPI_MISO: J2701.22, J2702.22
SPI_MOSI: J2701.21, J2702.21
SPI_SCK: J2701.20, J2702.20
TEMP_FET: J2701.33, J2702.33
TEMP_PCB: J2701.34, J2702.34
V_A_ADC: J2701.29, J2702.29
V_BUS_ADC: J2701.28, J2702.28
V_B_ADC: J2701.30, J2702.30
V_C_ADC: J2701.31, J2702.31

Notes on the sheet:
Güç / kontrol kartı arayüzü
ESC-3K | 18_BOARD_INTERFACE | A2 | TASARIM INCELEMESI
TASARIM NOTLARI / KABUL KRITERLERI
1. İki konnektör eşleşmiş kablonun sistem modelidir; aynı net isimleri elektriksel olarak ortaktır.
2. A2 düzeltme: pin39 +5V; pin40 GND. Pin1 ve bakış yönü fiziksel montaj çiziminde sabitlenecek.
3. Güç kartı: köprü, driver, şönt, fault latch, AND kapıları. Kontrol kartı: MCU ve iletişim.
4. Yerleşim öncesi iki PCB için netlist ayrılır. Bu birleşik sistem dosyası doğrudan iki PCB üretmez.
