mekiciepcas/ESC-Ai/ESC_V2/hardware_a2/19_TEST_POINTS.kicad_sch

## KiCad design ESC_V2/hardware_a2/19_TEST_POINTS.kicad_sch (2026-09-18)

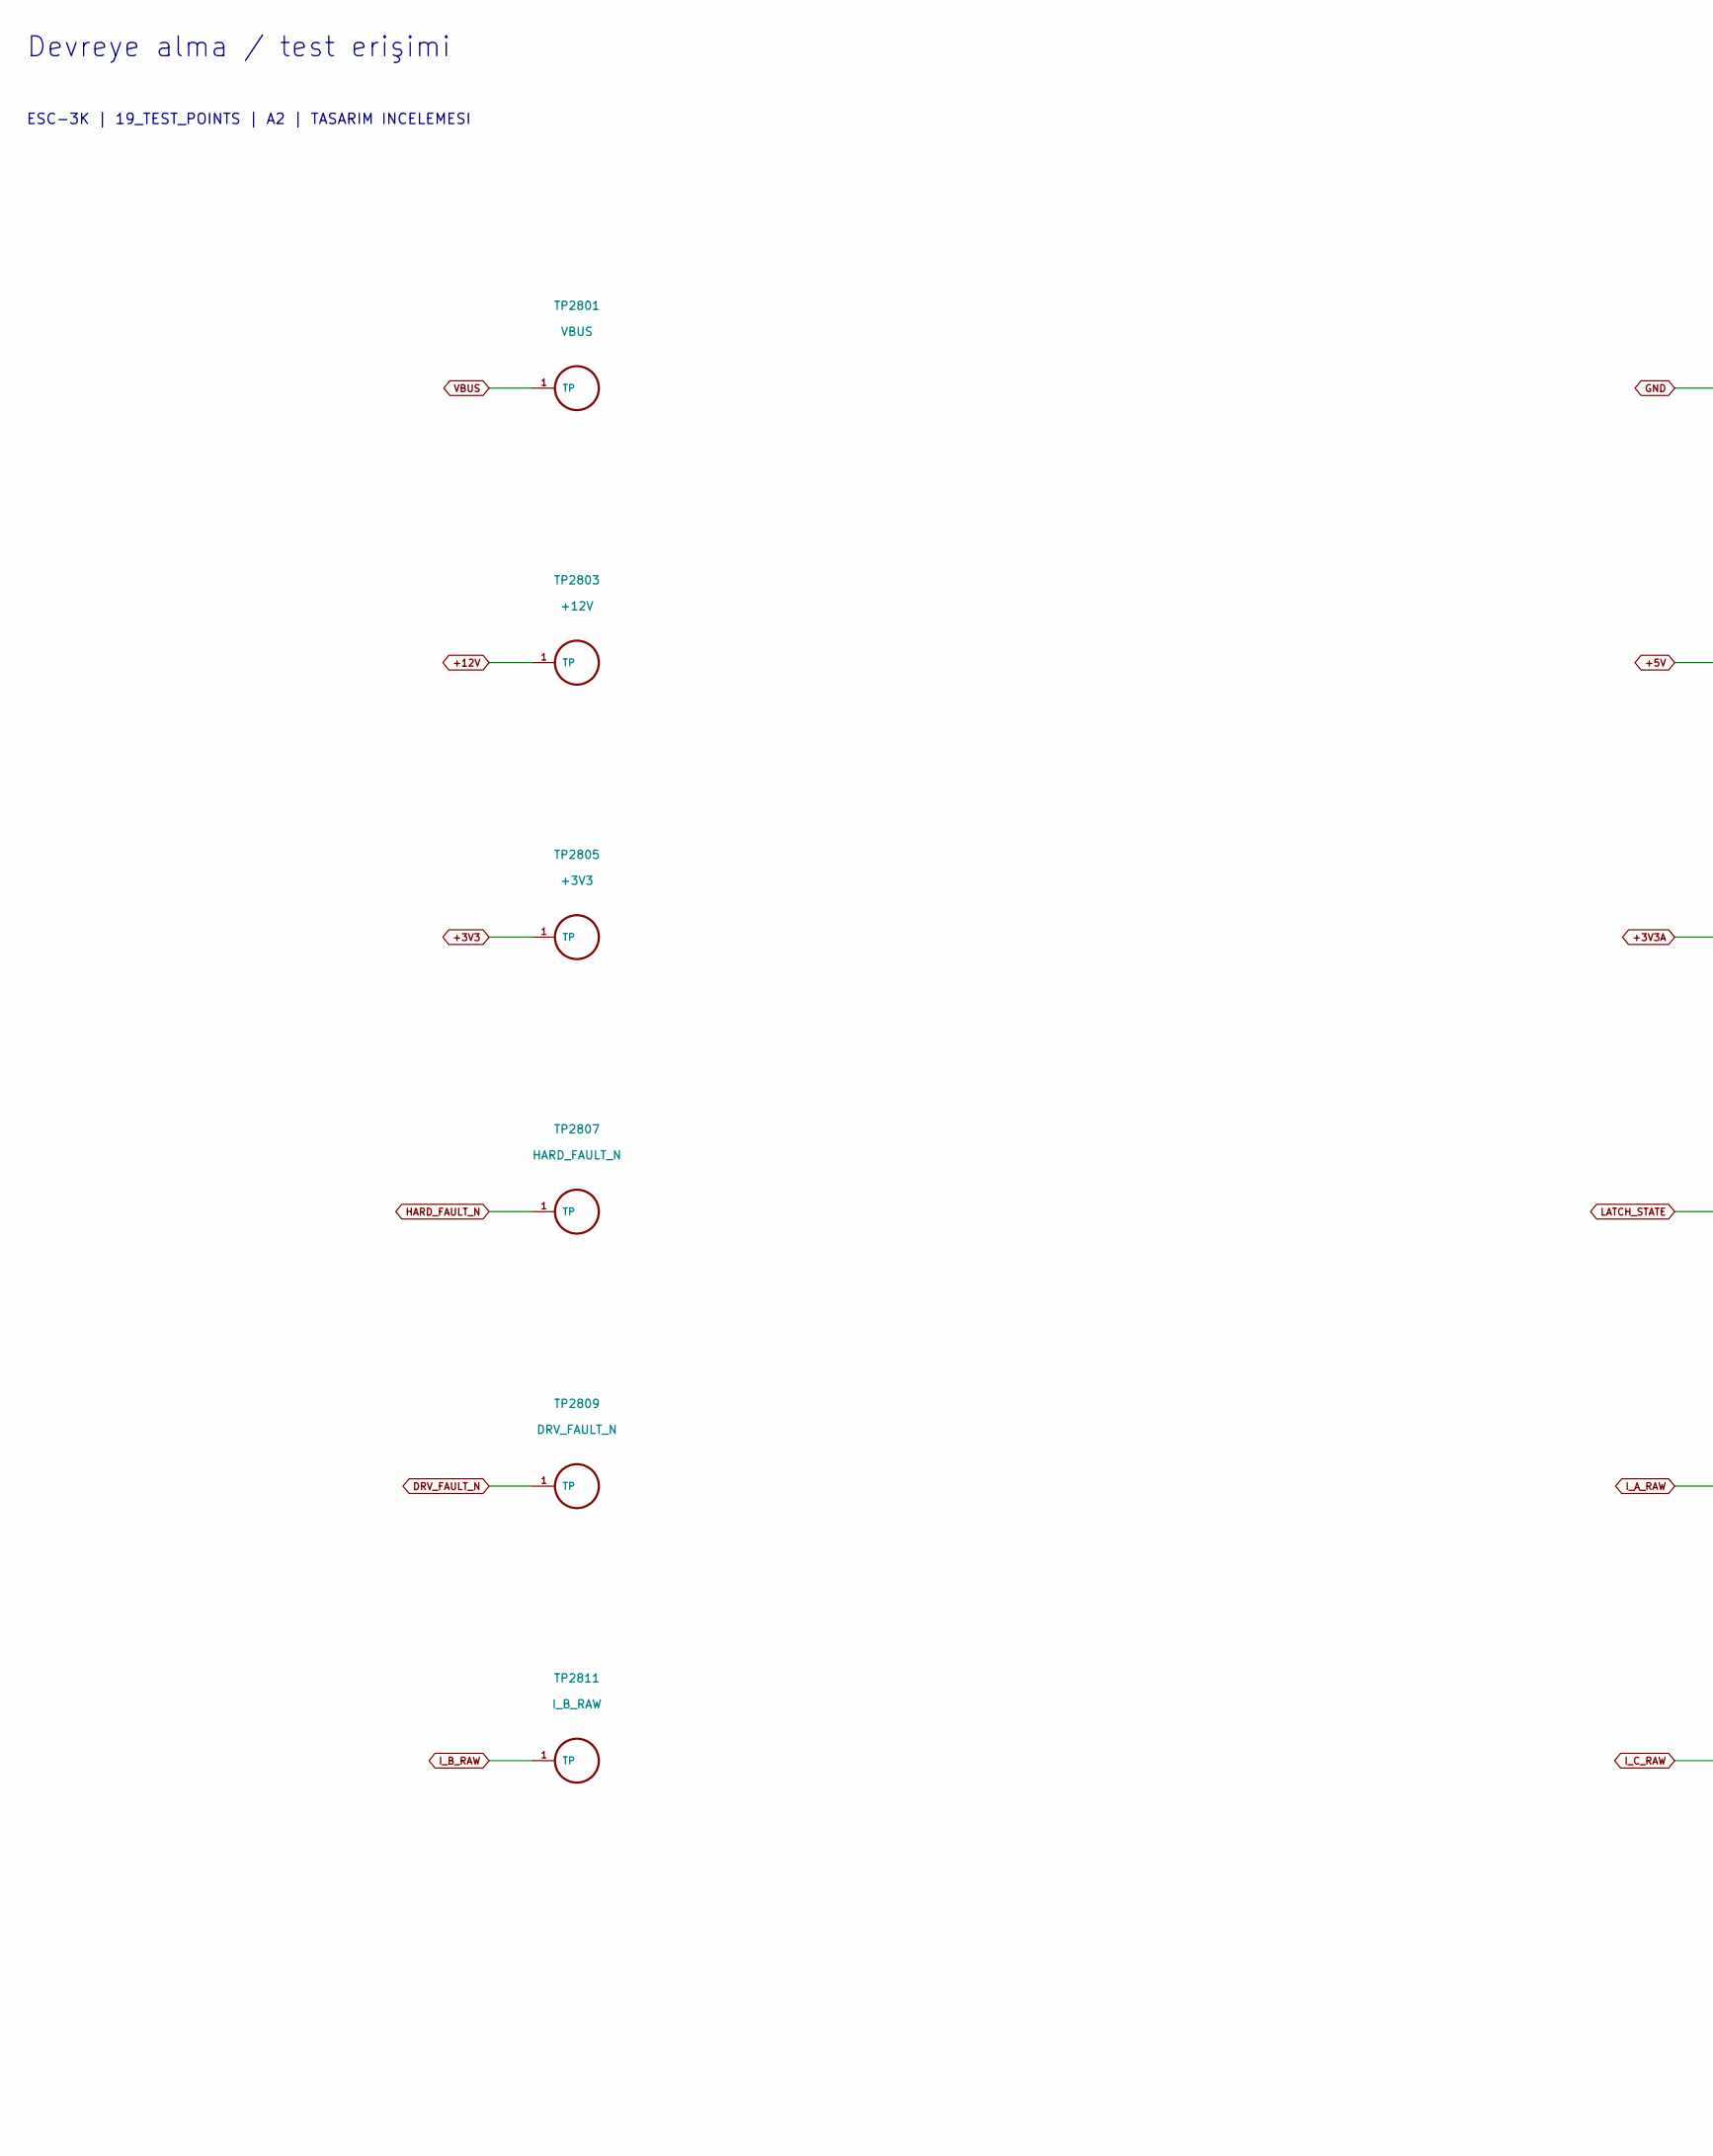
[picture p165: schematic 19_TEST_POINTS.kicad_sch, part in row 1, column 1]

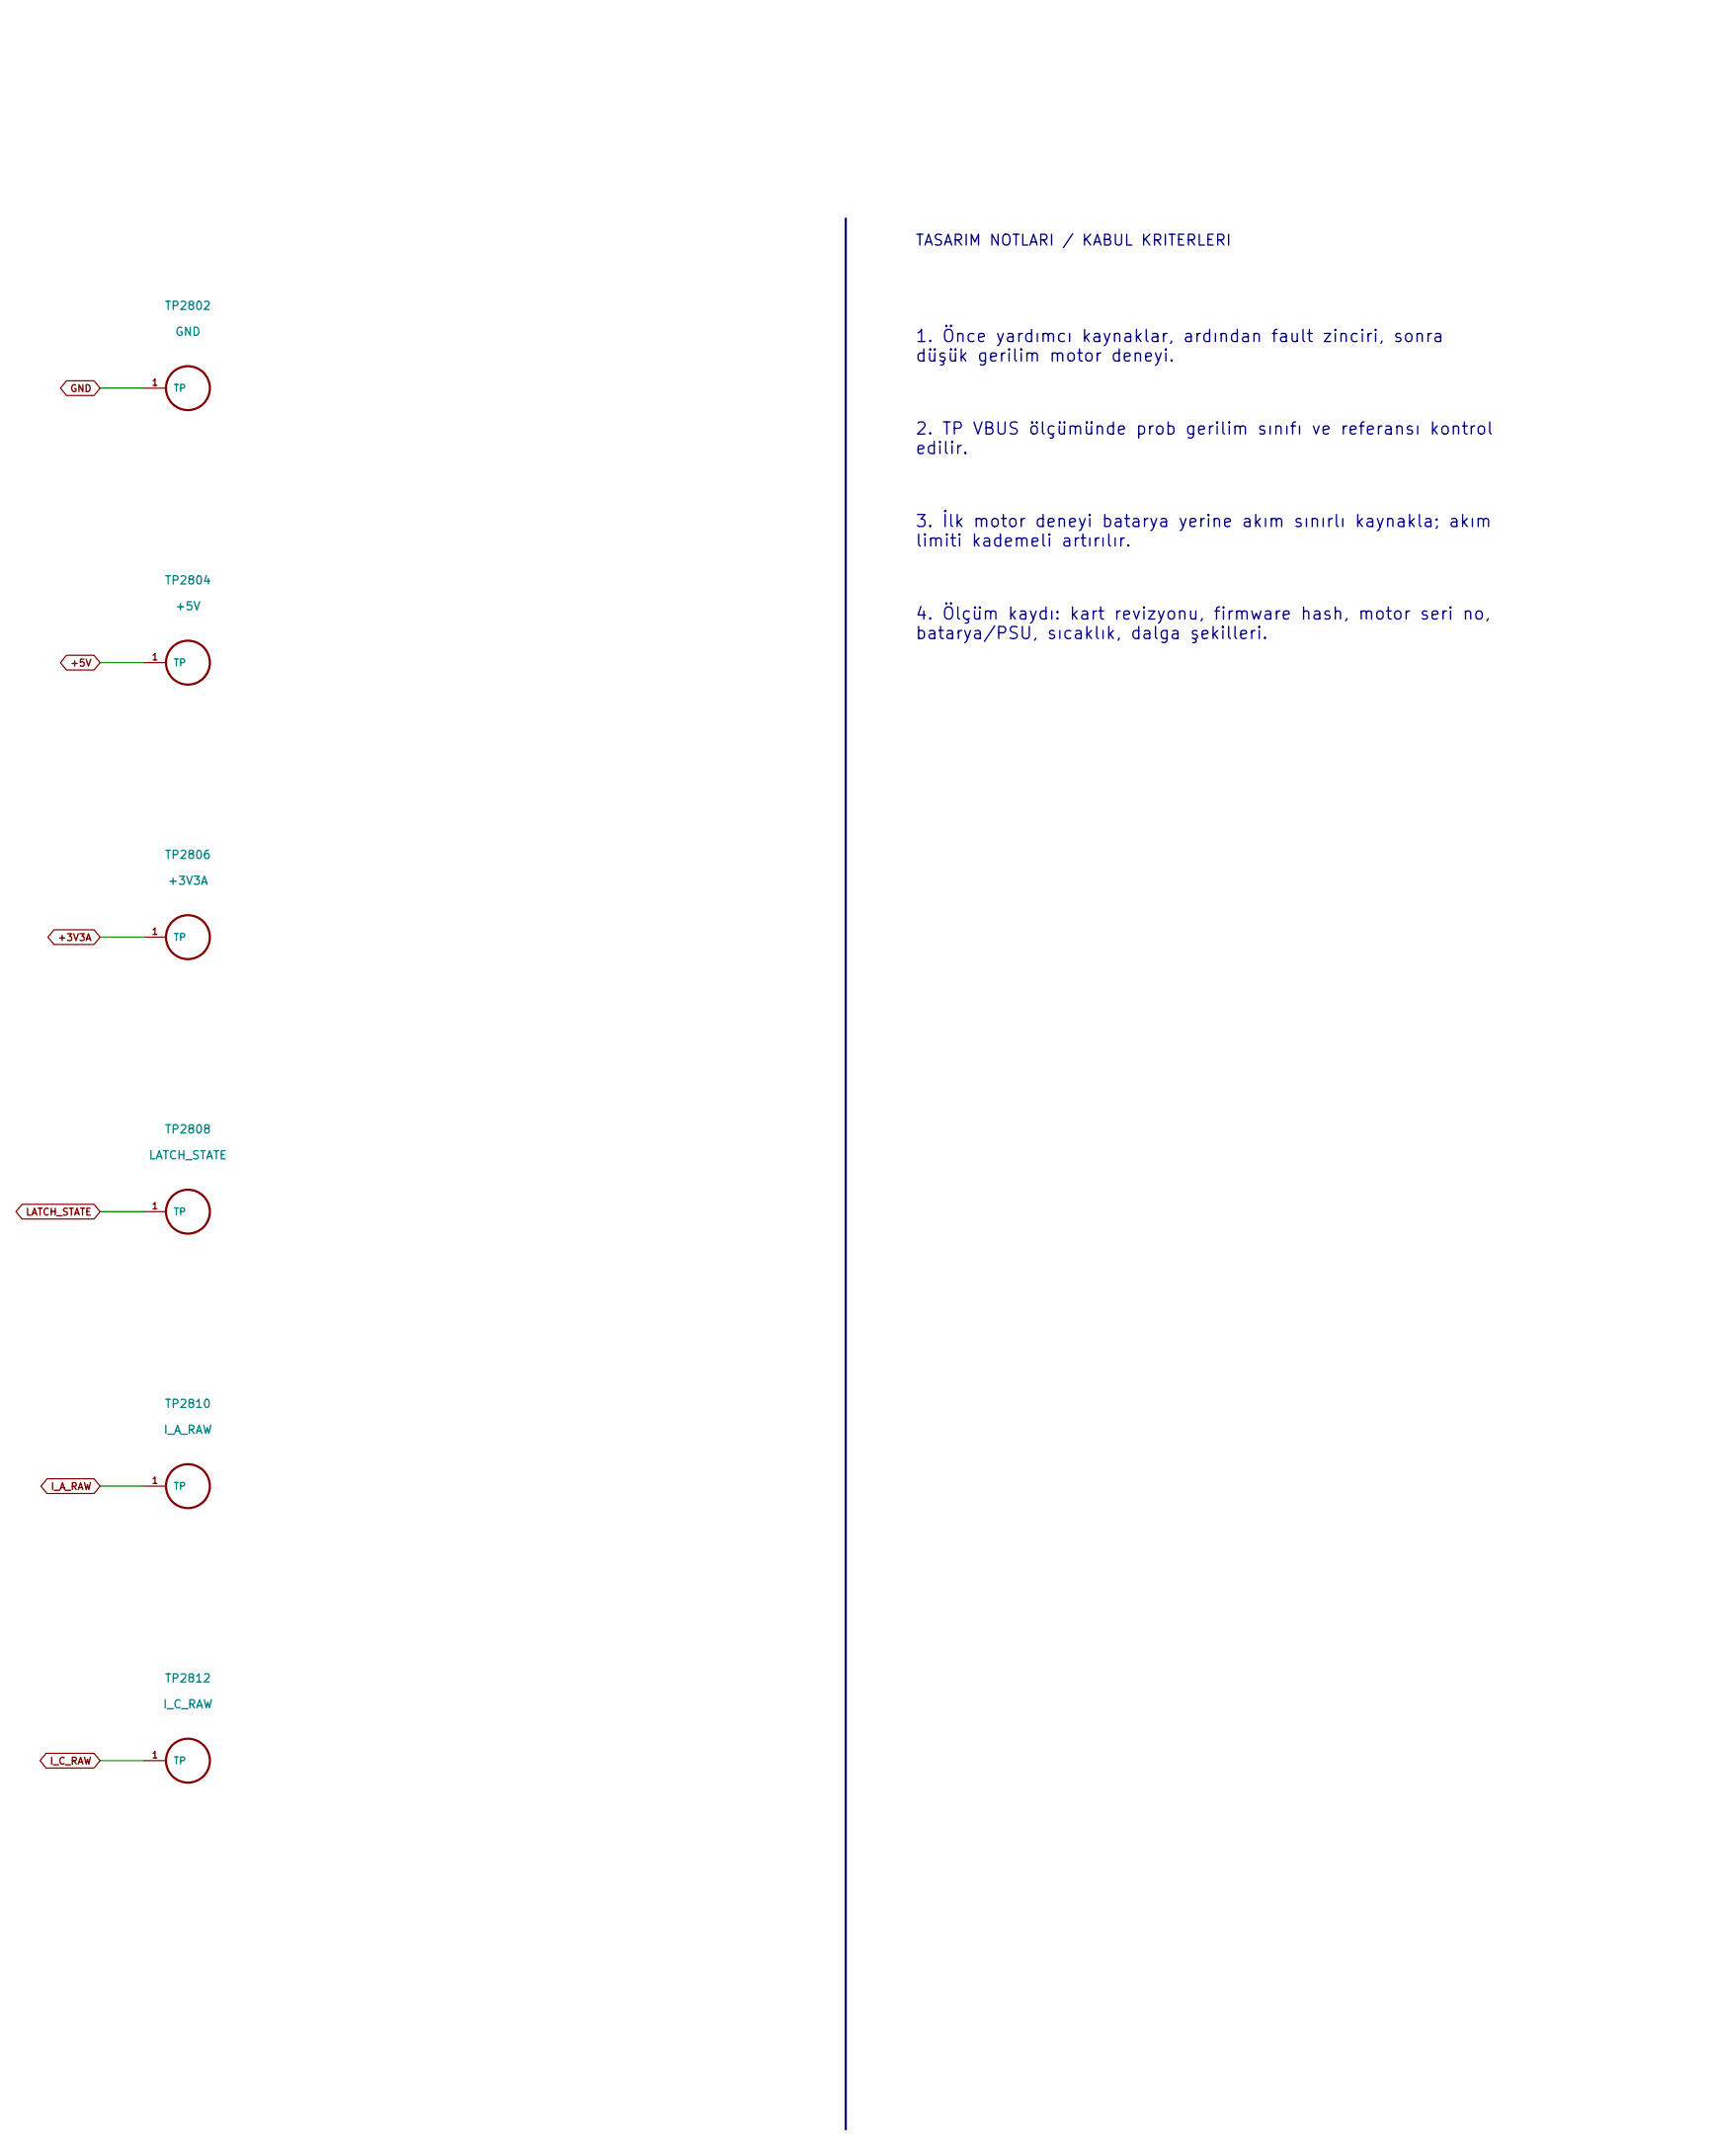
[picture p166: schematic 19_TEST_POINTS.kicad_sch, part in row 1, column 2]

Parts:
TP2801: VBUS; TestPoint_Pad_D1.5mm; MPN PCB TEST PAD
TP2802: GND; TestPoint_Pad_D1.5mm; MPN PCB TEST PAD
TP2803: +12V; TestPoint_Pad_D1.5mm; MPN PCB TEST PAD
TP2804: +5V; TestPoint_Pad_D1.5mm; MPN PCB TEST PAD
TP2805: +3V3; TestPoint_Pad_D1.5mm; MPN PCB TEST PAD
TP2806: +3V3A; TestPoint_Pad_D1.5mm; MPN PCB TEST PAD
TP2807: HARD_FAULT_N; TestPoint_Pad_D1.5mm; MPN PCB TEST PAD
TP2808: LATCH_STATE; TestPoint_Pad_D1.5mm; MPN PCB TEST PAD
TP2809: DRV_FAULT_N; TestPoint_Pad_D1.5mm; MPN PCB TEST PAD
TP2810: I_A_RAW; TestPoint_Pad_D1.5mm; MPN PCB TEST PAD
TP2811: I_B_RAW; TestPoint_Pad_D1.5mm; MPN PCB TEST PAD
TP2812: I_C_RAW; TestPoint_Pad_D1.5mm; MPN PCB TEST PAD

Connections:
+3V3: TP2805.1
+3V3A: TP2806.1
+5V: TP2804.1
+12V: TP2803.1
DRV_FAULT_N: TP2809.1
GND: TP2802.1
HARD_FAULT_N: TP2807.1
I_A_RAW: TP2810.1
I_B_RAW: TP2811.1
I_C_RAW: TP2812.1
LATCH_STATE: TP2808.1
VBUS: TP2801.1

Notes on the sheet:
Devreye alma / test erişimi
ESC-3K | 19_TEST_POINTS | A2 | TASARIM INCELEMESI
TASARIM NOTLARI / KABUL KRITERLERI
1. Önce yardımcı kaynaklar, ardından fault zinciri, sonra düşük gerilim motor deneyi.
2. TP VBUS ölçümünde prob gerilim sınıfı ve referansı kontrol edilir.
3. İlk motor deneyi batarya yerine akım sınırlı kaynakla; akım limiti kademeli artırılır.
4. Ölçüm kaydı: kart revizyonu, firmware hash, motor seri no, batarya/PSU, sıcaklık, dalga şekilleri.
