mekiciepcas/ESC-Ai/ESC_V2/planning/test_pb08_fail_closed_templates.py

#!/usr/bin/env python3
"""Regression harness: PB-08 evidence verifiers must reject unpopulated templates.

Repository-safety test only. It does not validate physical evidence or advance gates.
The harness fails on coverage drift and distinguishes an intentional fail-closed
rejection from an interpreter/runtime crash by requiring each verifier's documented
blank-template rejection exit code and machine-parseable JSON rejection field.
"""
import json
from pathlib import Path
import subprocess
import sys

ROOT = Path(__file__).resolve().parent
# verifier, controlled blank template, expected rejection rc, JSON key, expected value
CASES = [
    ("verify_pb08_axis_structure_mass.py", "PB08_INSTALLED_AXIS_STRUCTURE_MASS_RESULT.template.json", 2, "schema_check", "FAIL"),
    ("verify_pb08_degraded_mode_decision.py", "PB08_DEGRADED_MODE_DECISION_RESULT.template.json", 1, "status", "FAIL"),
    ("verify_pb08_auxiliary_demand.py", "PB08_TRACTION_PACK_AUXILIARY_DEMAND_RESULT.template.json", 1, "result", "FAIL"),
    ("verify_pb08_installed_pack_resistance.py", "PB08_INSTALLED_PACK_RESISTANCE_MEASUREMENT_RESULT.template.json", 2, "status", "FAIL_CLOSED"),
    ("verify_pb08_p50b_ocv_rdc.py", "PB08_P50B_OCV_RDC_MEASUREMENT_RESULT.template.json", 2, "evidence_record_valid", False),
]


def main() -> int:
    failures = []
    mapped_templates = {template for _, template, _, _, _ in CASES}
    discovered_templates = {p.name for p in ROOT.glob("PB08_*RESULT.template.json")}

    unmapped = sorted(discovered_templates - mapped_templates)
    stale = sorted(mapped_templates - discovered_templates)
    if unmapped:
        failures.append("unmapped PB-08 result template(s): " + ", ".join(unmapped))
    if stale:
        failures.append("mapped PB-08 result template(s) missing from repository: " + ", ".join(stale))

    for verifier, template, expected_rc, status_key, expected_value in CASES:
        verifier_path = ROOT / verifier
        template_path = ROOT / template
        if not verifier_path.is_file():
            failures.append(f"mapped verifier missing: {verifier}")
            continue
        if not template_path.is_file():
            continue
        proc = subprocess.run(
            [sys.executable, str(verifier_path), str(template_path)],
            cwd=ROOT,
            text=True,
            stdout=subprocess.PIPE,
            stderr=subprocess.PIPE,
            check=False,
        )
        if proc.returncode != expected_rc:
            failures.append(
                f"{verifier} returned rc={proc.returncode}; expected controlled blank-template rejection rc={expected_rc}"
            )
            continue
        if proc.stderr.strip():
            failures.append(
                f"{verifier} emitted stderr during controlled blank-template rejection; possible crash/warning: {proc.stderr.strip()[:240]}"
            )
            continue
        try:
            payload = json.loads(proc.stdout)
        except (json.JSONDecodeError, TypeError) as exc:
            failures.append(
                f"{verifier} returned expected rc={expected_rc} but stdout was not one JSON object: {exc}"
            )
            continue
        if not isinstance(payload, dict):
            failures.append(f"{verifier} JSON rejection payload must be an object")
            continue
        if payload.get(status_key) != expected_value:
            failures.append(
                f"{verifier} JSON rejection field {status_key!r}={payload.get(status_key)!r}; expected {expected_value!r}"
            )
            continue
        errors = payload.get("errors")
        if not isinstance(errors, list) or not errors:
            failures.append(
                f"{verifier} controlled blank-template rejection must include a non-empty JSON errors list"
            )
            continue
        if any(not isinstance(error, str) or not error.strip() for error in errors):
            failures.append(
                f"{verifier} controlled blank-template rejection errors must all be non-empty strings"
            )
            continue
        print(
            f"PASS fail-closed: {verifier} rejected {template} with controlled rc={expected_rc}, "
            f"{status_key}={expected_value!r}, errors={len(errors)}"
        )

    if failures:
        print("FAIL: PB-08 fail-closed/coverage regression detected", file=sys.stderr)
        for item in failures:
            print(f" - {item}", file=sys.stderr)
        return 1
    print(f"PASS: all {len(CASES)} mapped PB-08 unpopulated evidence templates produced controlled fail-closed rejection")
    print("PASS: every discovered PB08_*RESULT.template.json has an explicit verifier mapping")
    print("NOTE: this proves repository fail-closed/coverage behavior only; it is not physical qualification or gate closure.")
    return 0


if __name__ == "__main__":
    raise SystemExit(main())
