mekiciepcas/ESC-Ai/(commit log)

2026-09-18 Add ESC system project files
    [01_DC_LINK.kicad_sch, 01_DC_link.kicad_sch, 02_PHASE_A.kicad_sch, 02_PHASE_B.kicad_sch, 02_PHASE_C.kicad_sch, 02_phase_A.kicad_sch, 02_phase_B.kicad_sch, 02_phase_C.kicad_sch]
2026-09-18 Rebaseline ESC design for heavy-lift agricultural UAV
2026-09-18 Add executable UAV ESC product development plan
2026-09-18 Add Faz2 Faz3 B1 UAV traceability matrix
2026-09-18 Add gated UAV ESC engineering backlog
2026-09-18 Link UAV product plan and traceability from project entry point
2026-09-18 Add preliminary rotor architecture trade study
2026-09-19 Add source-backed UAV battery voltage pre-trade
2026-09-19 Add parametric ESC envelope model for G1
2026-09-19 Link battery and ESC pre-trade evidence into traceability
2026-09-19 Advance autonomous state after battery and ESC pre-trades
2026-09-19 Add B1 18S voltage compatibility precheck
2026-09-19 Handoff propulsion evidence and B1 18S voltage precheck
2026-09-19 Add source-backed X15 G2 69V operating curve
2026-09-19 Map X15 G2 curve to benchmark rotor scenarios
2026-09-19 Add 18S power-domain voltage class trade
2026-09-19 Advance autonomous state after X15 mapping and voltage trade
2026-09-19 Handoff X15 scenario mapping and 18S driver voltage audit
2026-09-19 uav: rebaseline bus sensing for 18S voltage domain
2026-09-19 planning: add parameterized UAV power-stage loss model
2026-09-19 planning: audit exact B1 VBUS-exposed BOM
2026-09-19 planning: link voltage-domain audit and loss-model evidence
2026-09-19 planning: advance autonomous state after VBUS BOM and loss model
2026-09-19 planning: hand off exact VBUS BOM and loss model progress
2026-09-19 Audit B1 bus divider voltage stress and ADC clamp path
2026-09-19 Add DC link capacitor sizing and qualification framework
2026-09-19 Handoff sensing clamp and DC input architecture progress
2026-09-19 UAV: close B1 bus-sense clamp topology and injection screening
2026-09-19 UAV: advance autonomous state after ADC clamp and precharge analysis
2026-09-19 UAV: hand off ADC clamp and requirements-gate progress
2026-09-19 UAV: audit analog rail back-power path
2026-09-19 UAV: classify voltage-sense back-power risk
2026-09-19 UAV: hand off G1 audit and back-power findings
2026-09-19 UAV: formalize rotor screening with controlled G0 bounds
2026-09-19 UAV: link controlled G0 bounds into traceability
2026-09-19 UAV: record bounded rotor trade progress
2026-09-19 UAV: advance autonomy state after bounded G0 rotor screening
2026-09-19 UAV: handoff controlled G0 bounds and rotor screening progress
2026-09-19 UAV: map X15 curve across governed MTOW rotor trade cases
2026-09-19 planning: add source-backed MOSFET voltage-class candidates
2026-09-19 planning: advance autonomy state after MOSFET source table
2026-09-19 Add source-backed power-off tolerant HV sense candidates
2026-09-19 Extend semiconductor candidates with switching and thermal evidence
2026-09-19 Update sensing and semiconductor traceability evidence
2026-09-19 Add parametric HV sense static error model
    [hv_sense_error_model.py]
2026-09-19 Advance autonomy state after sense and FET evidence work
2026-09-19 Update autonomous handoff after sensing and FET evidence run
2026-09-19 Add normalized power stage loss calculator skeleton
2026-09-19 Update traceability for sensing sequencing and normalized loss tools
2026-09-19 Add preliminary U1 BOM candidate matrix
2026-09-19 Update autonomy state after sequencing models and preliminary BOM matrix
2026-09-19 Update autonomous handoff after sequencing models and BOM matrix
2026-09-19 Add higher voltage gate driver and auxiliary supply trade
2026-09-19 Deepen preliminary U1 BOM with driver and auxiliary candidates
2026-09-19 Update traceability for driver auxiliary trade and preliminary BOM
2026-09-19 Advance autonomy state after high voltage driver and auxiliary trade
2026-09-19 Finalize handoff after driver auxiliary trade
2026-09-19 Add B1 auxiliary load and power-domain inventory
2026-09-19 Add STM32G474 versus TMS320F280041C control platform pretrade
2026-09-19 Map auxiliary power and control pretrade derived requirements
2026-09-19 Add mandatory-input auxiliary power budget model
2026-09-19 Add null-only auxiliary power budget input template
2026-09-19 planning: trace B1 safety and external interface gaps
2026-09-19 planning: link fault-arm verification matrix
2026-09-19 planning: add production connector requirements framework
2026-09-19 planning: define U1 schematic migration contract
2026-09-19 planning: add source-backed CAN candidates to U1 BOM matrix
2026-09-19 planning: link CAN connector and FMEA authorities
2026-09-19 planning: extend traceability for CAN connectors FMEA and U1 migration
2026-09-19 planning: record FMEA and schematic migration prework in backlog
2026-09-19 planning: advance autonomy state after CAN connector FMEA prework
2026-09-19 planning: hand off CAN connector FMEA and KiCad migration prework
2026-09-19 hardware: add concrete U1 KiCad architecture scaffold
    [ESC_U1_SCAFFOLD.kicad_sch]
2026-09-19 hardware: add U1 KiCad page readiness matrix
2026-09-19 hardware: document concrete U1 KiCad scaffold and limits
2026-09-19 verification: record executed U1 KiCad scaffold consistency result
2026-09-19 planning: record concrete U1 KiCad scaffold progress
2026-09-19 planning: hand off concrete U1 KiCad scaffold run
2026-09-19 verification: add CAN bus physical and timing contract
2026-09-19 ci: add reproducible KiCad U1 verification workflow
2026-09-19 planning: add run traceability for G0 CAN and KiCad CI
2026-09-19 planning: update autonomy state after G0 CAN and KiCad CI progress
2026-09-19 planning: hand off G0 CAN and KiCad CI progress
2026-09-19 ci: use official KiCad 10 PPA for U1 verification
2026-09-19 verification: record successful KiCad 10 scaffold CI evidence
2026-09-19 verification: add successful KiCad 10 parser and ERC evidence
2026-09-19 traceability: close KiCad scaffold CI evidence with observed pass
2026-09-19 state: record successful KiCad 10 scaffold verification
2026-09-19 planning: hand off successful KiCad 10 CI verification run
2026-09-19 ci: add non-destructive legacy B1 KiCad baseline audit
2026-09-19 ci: resolve standard footprint libraries for B1 ERC baseline
2026-09-19 verification: record clean legacy B1 KiCad 10 baseline audit
2026-09-19 traceability: add B1 KiCad baseline and support-part evidence
2026-09-19 state: record clean B1 KiCad baseline and support-part evidence
2026-09-19 planning: hand off clean B1 KiCad baseline and support evidence run
2026-09-19 planning: enforce immutable schematic revision workflow
2026-09-19 planning: add schematic revision register
    [SCHEMATIC_REVISION_REGISTER.json]
2026-09-19 state: enforce schematic revision versioning
2026-09-19 planning: hand off mandatory schematic versioning policy
2026-09-19 planning: add schematic revision manifest template
    [SCHEMATIC_REVISION_MANIFEST.template.json]
2026-09-19 ci: add schematic revision policy checker
2026-09-19 ci: enforce immutable schematic revision lineage
2026-09-19 traceability: record schematic revision enforcement and G3 ERC policy
2026-09-19 traceability: add compact G0 user input closure form
2026-09-19 tooling: add dry-run U1 schematic revision planner
2026-09-19 traceability: add guarded U1 revision allocation tooling
2026-09-19 dashboard: show current UAV rebaseline progress simply
2026-09-19 planning: hand off current UAV dashboard integration
2026-09-19 state: switch to mechanical electrical cotrade pretrade
2026-09-19 planning: add source-backed ESC electrical envelope pretrade
2026-09-19 planning: screen 100v 120v 150v power stage classes
2026-09-19 verification: add executable ESC pretrade consistency check
2026-09-19 ci: verify ESC electrical pretrade envelope
2026-09-19 planning: record ESC electrical pretrade traceability
2026-09-19 state: record ESC electrical pretrade verification
2026-09-19 planning: hand off verified ESC electrical pretrade
2026-09-19 docs: add preliminary U1 ESC engineering datasheet PDS-00
2026-09-19 state: record preliminary ESC datasheet PDS-00
2026-09-19 Add normalized 120V vs 150V semiconductor pretrade
2026-09-19 design: freeze PB-01 voltage and architecture baseline
2026-09-19 traceability: record PB-01 product freeze decisions
2026-09-19 planning: freeze X8 mass thrust and propulsion baseline PB-02
2026-09-19 planning: close PB-02 mass thrust battery and DC capability rows
2026-09-19 planning: close rotor architecture task from PB-02
2026-09-19 state: record PB-02 mass thrust and DC capability freeze
2026-09-19 planning: document PB-02 18S voltage rationale
2026-09-19 planning: define U1 rated and future low-voltage variant strategy
2026-09-19 traceability: align PB-02 and active G1 sprint decisions
2026-09-19 engineering: close S1.1 phase-current model
2026-09-19 engineering: add machine-readable S1.1 phase-current evidence
2026-09-19 baseline: freeze S1.1 phase-current envelope in PB-03
2026-09-19 ci: add PB-03 phase-current consistency checker
2026-09-19 ci: verify PB-03 phase-current closure
2026-09-19 requirements: close S1.1 phase-current rows under PB-03
2026-09-19 requirements: add PB-03 phase-current envelope
2026-09-19 requirements: align master to PB-03 phase-current closure
2026-09-19 traceability: record PB-03 phase-current closure
2026-09-19 Add S1.2 PWM timing and loss evidence study
2026-09-19 Update autonomous handoff after S1.2 PWM evidence run
2026-09-19 Advance autonomy state to S1.2 bounded PWM study
2026-09-19 verification: define motor impedance procedure for S1.2
2026-09-19 verification: add null-only motor impedance result template
    [MOTOR_IMPEDANCE_MEASUREMENT_RESULT.template.json]
2026-09-19 engineering: add exact 150V MOSFET G2 prework
2026-09-19 planning: add PB03 hot MOSFET thermal sensitivity
2026-09-19 traceability: record PB03 hot thermal sensitivity
2026-09-19 traceability: restore canonical matrix and append TR047
2026-09-19 planning: correct eRPM bound and narrow PWM analysis window
2026-09-19 traceability: add PB04 mission and eRPM decisions
2026-09-19 battery: add PB05 pack trade study
2026-09-19 baseline: create PB05 battery architecture
2026-09-19 requirements: apply PB05 battery architecture
2026-09-19 traceability: add PB05 battery decisions
2026-09-19 ci: add PB05 battery consistency checker
2026-09-19 ci: verify PB05 battery architecture
2026-09-19 planning: advance active work to S1.3 battery architecture
2026-09-19 state: advance to PB05 S1.3 battery architecture
2026-09-19 ci: make PB02 inheritance checker baseline-chain aware
2026-09-19 planning: add PB05 battery sag verification contract
2026-09-19 planning: trace PB05 sag verification contract
2026-09-19 planning: hand off PB05 battery sag verification work
2026-09-19 planning: derive PB06 whole-pack peak current
2026-09-19 planning: add PB06 pack architecture and mass framework
2026-09-19 planning: create PB06 battery peak-current baseline
2026-09-19 planning: apply PB06 battery peak-current requirement
2026-09-19 planning: add PB06 whole-pack peak current to G1
2026-09-19 planning: add PB06 peak-current traceability
2026-09-19 state: advance S1.3 with PB06 peak-current baseline
2026-09-19 ci: add PB06 battery consistency checker
2026-09-19 ci: verify PB06 battery baseline
2026-09-19 planning: hand off PB06 battery peak-current progress
2026-09-19 S1.3: add PB06 high-current path shortlist
2026-09-19 traceability: add PB06 current-path screening
2026-09-19 autonomy: record PB06 current-path screening
2026-09-19 handoff: record PB06 current-path screening run
2026-09-19 planning: add PB06 current-path resistance budget
2026-09-19 planning: document PB06 current-path thermal budget
2026-09-19 planning: add PB06 current-path budget verifier
2026-09-19 ci: verify PB06 current-path budget
2026-09-19 planning: add PB07 low-power propulsion rebaseline
2026-09-19 planning: establish PB07 low-power product rebaseline
2026-09-19 planning: reset G1 matrix for PB07 low-power rebaseline
2026-09-19 planning: rebaseline backlog around PB07 low-power sprint
2026-09-19 planning: rebaseline design basis to PB07 low-power scope
2026-09-19 planning: trace PB07 low-power rebaseline
2026-09-19 ci: verify PB07 low-power rebaseline
2026-09-19 planning: hand off PB07 low-power rebaseline state
2026-09-19 planning: handoff PB07 low-power rebaseline
2026-09-19 planning: define PB08 common 12S ESC platform
2026-09-19 planning: freeze PB08 common 12S ESC platform
2026-09-19 planning: trace PB08 common electrical platform
2026-09-19 design-basis: apply PB08 common 12S ESC platform
2026-09-19 traceability: record PB08 architecture mass closure criterion
2026-09-19 PB08: trace installed-axis primary evidence
2026-09-19 planning: add PB08 custom-axis mass ledger
2026-09-19 traceability: record PB08 custom-axis mass ledger
2026-09-19 planning: advance autonomous state after custom-axis ledger
2026-09-19 handoff: record PB08 custom-axis mass ledger run
2026-09-20 planning: promote PB08 exact motor prop mass anchor
2026-09-20 traceability: add PB08 exact U8 Lite NS28 pair evidence
2026-09-20 planning: hand off PB08 exact motor prop pair evidence run
2026-09-20 planning: audit B1 voltage domains against PB08 12S baseline
2026-09-20 traceability: add PB08 B1 12S requalification audit
2026-09-20 Trace PB08 U8 Lite eRPM evidence
2026-09-20 planning: trace PB08 P50B 12S4P cell mass-energy bound
2026-09-20 planning: trace PB08 pack geometry evidence
2026-09-20 PB08: derive pack continuous-current lower bound
2026-09-20 PB08: trace pack current lower-bound derivation
2026-09-20 PB08: handoff pack continuous-current lower bound
2026-09-20 PB08: sync autonomy state after current-bound run
2026-09-20 planning: reconcile PB08 traceability continuation through TR-065
2026-09-20 planning: record PB08 traceability continuity reconciliation
2026-09-20 planning: synchronize autonomy state after traceability audit
2026-09-20 planning: hand off traceability continuity reconciliation
2026-09-20 PB08: define pack continuous-current closure contract
2026-09-20 PB08: trace pack-current closure contract
2026-09-20 PB08: sync autonomy state after pack-current contract
2026-09-20 PB08: hand off pack-current closure contract
2026-09-20 planning: restore TR-066/TR-067 canonical trace continuity
2026-09-20 planning: record TR-068 trace continuity repair
2026-09-20 planning: advance autonomy state after trace repair
2026-09-20 planning: hand off trace continuity repair
2026-09-20 planning: add PB08 traction-pack auxiliary load ledger
2026-09-20 planning: trace PB08 auxiliary load ledger
2026-09-20 planning: advance autonomy state for auxiliary ledger
2026-09-20 planning: hand off PB08 auxiliary load ledger progress
2026-09-20 PB08: define continuous-current margin anti-double-counting policy
2026-09-20 trace: add PB08 continuous-current margin policy TR-070
2026-09-20 PB08: add B1 gate-drive auxiliary power screen
2026-09-20 PB08: record gate-drive auxiliary screen trace
2026-09-20 planning: restore TR-071 canonical traceability
2026-09-20 PB08: trace endurance energy margin screen
2026-09-20 PB08: trace cell-only sag screen
2026-09-20 PB08: add conditional non-cell resistance allowance screen
2026-09-20 PB08: trace conditional non-cell resistance screen
2026-09-20 PB08: advance autonomy state after resistance allowance screen
2026-09-20 PB08: update autonomous handoff after resistance budget screen
2026-09-20 PB08: add installed pack current-path resistance closure ledger
2026-09-20 PB08: trace installed pack resistance closure contract
2026-09-20 PB08: advance autonomy state after resistance ledger
2026-09-20 PB08: handoff installed pack resistance ledger run
2026-09-20 planning: trace PB08 P50B envelope evidence contract
2026-09-20 PB08: trace P50B 12S4P cell-mass floor
2026-09-20 PB08: add installed pack resistance measurement evidence template
2026-09-20 PB08: trace installed pack resistance measurement contract
2026-09-20 PB08: advance autonomy state after resistance evidence schema
2026-09-20 PB08: hand off installed pack resistance evidence work
2026-09-20 PB08: add installed pack resistance evidence verifier
2026-09-20 PB08: trace installed pack resistance verifier
2026-09-20 PB08: advance autonomy state after resistance verifier
2026-09-20 PB08: handoff installed pack resistance verifier run
2026-09-20 PB08: add fail-closed P50B OCV/Rdc evidence verifier
    [verify_pb08_p50b_ocv_rdc.py]
2026-09-20 planning: restore TR-081/TR-082 canonical traceability
2026-09-20 planning: record TR-083 canonical traceability repair
2026-09-21 verification: add fail-closed PB08 mass evidence checker
    [verify_pb08_axis_structure_mass.py]
2026-09-21 planning: trace PB08 S1R.2 mass evidence tooling
2026-09-21 planning: add PB08 B1 gate-drive pack-current sensitivity
2026-09-21 planning: record TR-086 gate-drive pack-current sensitivity
2026-09-21 planning: hand off TR-086 auxiliary-current sensitivity run
2026-09-21 PB08: fold TR-086 and auxiliary closure contract into canonical traceability
2026-09-21 PB08: add fail-closed auxiliary demand verifier
    [verify_pb08_auxiliary_demand.py]
2026-09-21 planning: synchronize TR-088/TR-090 auxiliary evidence trace
2026-09-21 planning: record TR-090 traceability synchronization
2026-09-21 planning: trace degraded-mode evidence tooling
2026-09-21 traceability: fold TR-091..TR-093 into canonical matrix
2026-09-21 planning: record 09:22 traceability synchronization run
2026-09-21 test: guard PB08 evidence verifiers fail closed
    [test_pb08_fail_closed_templates.py]
2026-09-21 trace: record PB08 fail-closed regression guard TR-095
2026-09-21 trace(pb08): record fail-closed CI guard TR-096
2026-09-21 trace: record TR-097 PB08 CI coverage repair
2026-09-21 test: close PB08 result-template mapping drift
    [test_pb08_fail_closed_templates.py]
2026-09-21 test: distinguish PB08 rejection from verifier crash
    [test_pb08_fail_closed_templates.py]
2026-09-21 docs: trace dashboard validator schema-drift repair TR-102
2026-09-21 verification: reject empty PB08 error records
    [test_pb08_fail_closed_templates.py]
2026-09-21 traceability: record PB08 error-payload integrity guard
2026-09-21 trace: record TR-104 CI runtime evidence as TR-105
2026-09-21 trace: correct TR-105 history note
