mekiciepcas/ESC-Ai/inceleme/media/image27.png

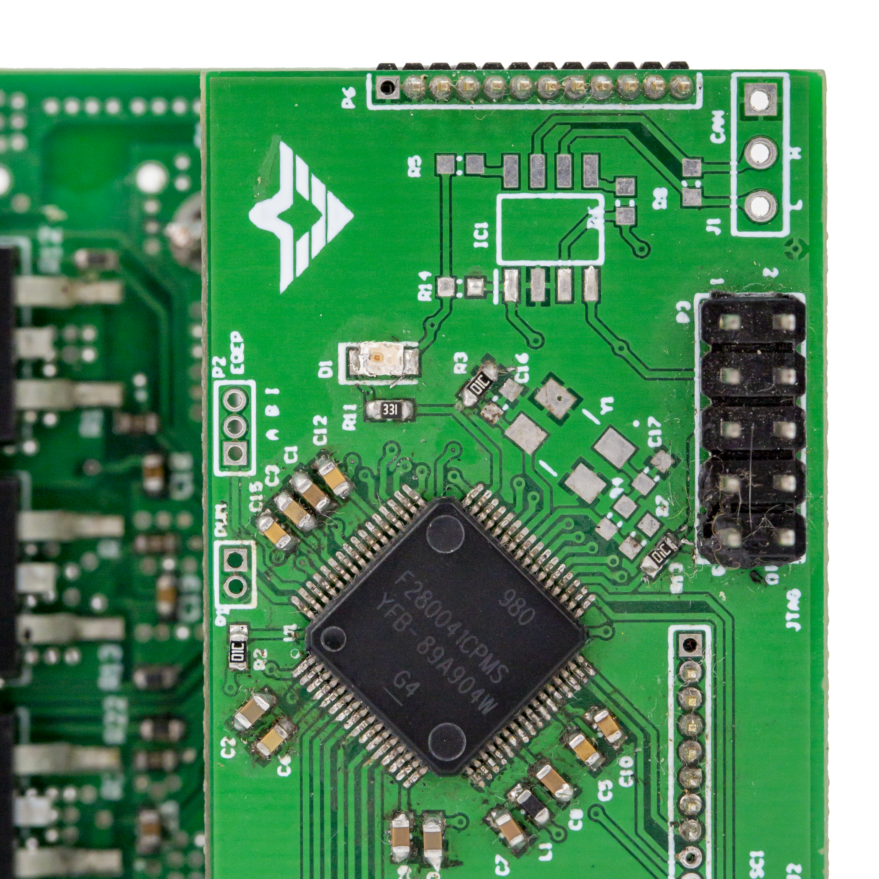
inceleme/media/image27.png
