mekiciepcas/ESC-Ai/inceleme/media/image28.png

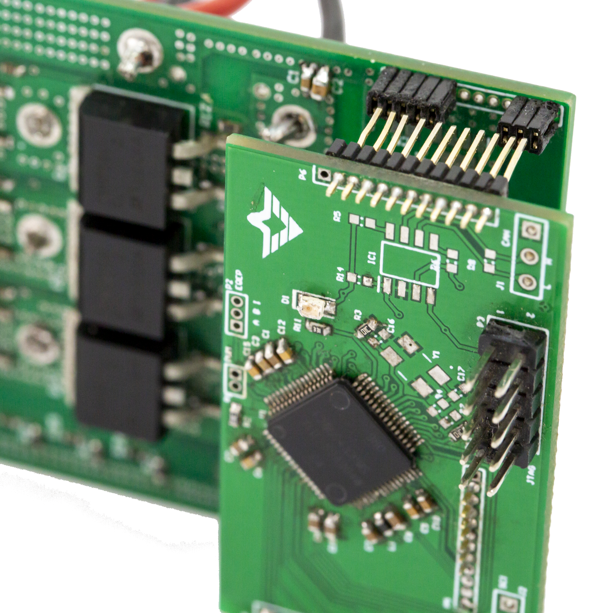
inceleme/media/image28.png
